idolverse/Tulingjiuge_robot_1/README.md

<h1>图灵九歌-机器人</h1>

基于inmoov人形机器人进行修改

<h2>stl文件</h2>

含有机人形器人不同部位的stl文件以及组装教程。

另外，合并文件中含有：头壳、胸前板、胸部装饰、腹部装饰、背部板、背部装饰、左右肩膀、腹部、盆骨的合并件。

示意图如下：



<h2>图灵九歌lab</h2>
