idolverse/Tulingjiuge_robot_1/myrobotlab/src/main/resources/resource/AdafruitMotorShield/DC_Motor_Ports.png

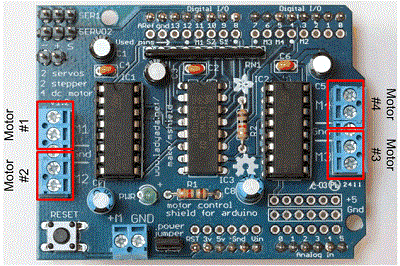
myrobotlab/src/main/resources/resource/AdafruitMotorShield/DC_Motor_Ports.png
