idolverse/Tulingjiuge_robot_1/myrobotlab/src/main/resources/resource/Arduino/esp8266.png

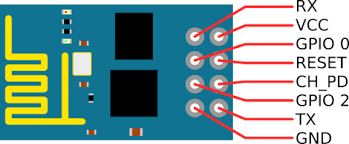
myrobotlab/src/main/resources/resource/Arduino/esp8266.png
