idolverse/Tulingjiuge_robot_1/myrobotlab/src/main/resources/resource/Arduino/mega.atmega2560.png

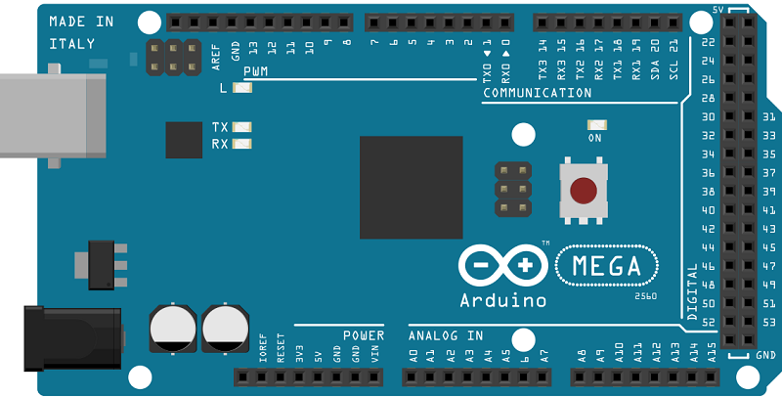
myrobotlab/src/main/resources/resource/Arduino/mega.atmega2560.png
