idolverse/Tulingjiuge_robot_1/myrobotlab/src/main/resources/resource/Arduino/micro.png

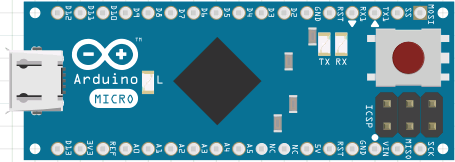
myrobotlab/src/main/resources/resource/Arduino/micro.png
