idolverse/Tulingjiuge_robot_1/myrobotlab/src/main/resources/resource/Arduino/nano.png

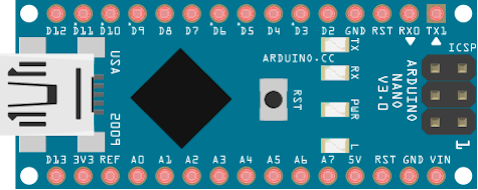
myrobotlab/src/main/resources/resource/Arduino/nano.png
