idolverse/Tulingjiuge_robot_1/myrobotlab/src/main/resources/resource/Emoji/240px-Noto_Emoji_Oreo_1f603.svg.png

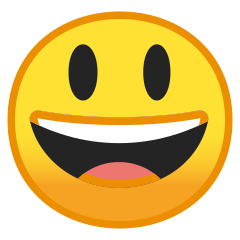
myrobotlab/src/main/resources/resource/Emoji/240px-Noto_Emoji_Oreo_1f603.svg.png
