idolverse/Tulingjiuge_robot_1/myrobotlab/src/main/resources/resource/Emoji/768px-Noto_Emoji_Oreo_1f602.svg.png

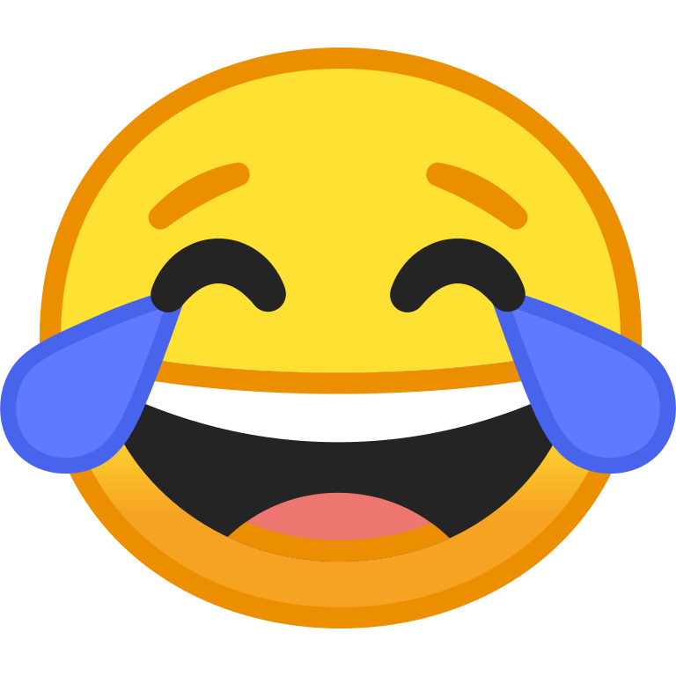
myrobotlab/src/main/resources/resource/Emoji/768px-Noto_Emoji_Oreo_1f602.svg.png
