idolverse/Tulingjiuge_robot_1/myrobotlab/src/main/resources/resource/Esp8266/esp8266-pinout.png

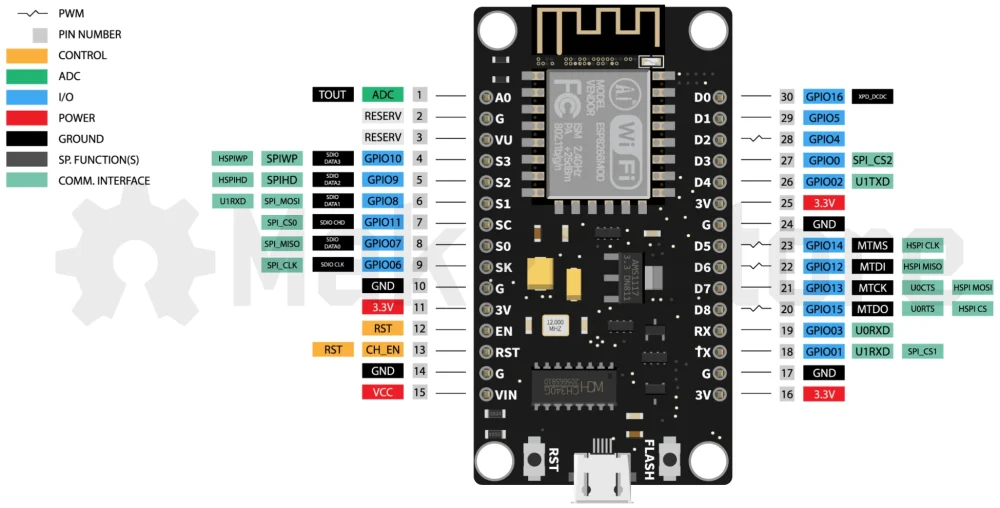
myrobotlab/src/main/resources/resource/Esp8266/esp8266-pinout.png
