idolverse/Tulingjiuge_robot_1/myrobotlab/src/main/resources/resource/facerec/Filter.png

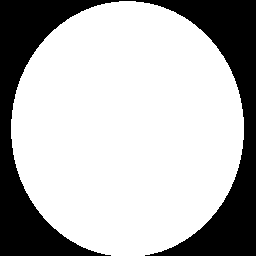
myrobotlab/src/main/resources/resource/facerec/Filter.png
