idolverse/Tulingjiuge_robot_1/myrobotlab/src/main/resources/resource/Intro/img/MRL_background.png

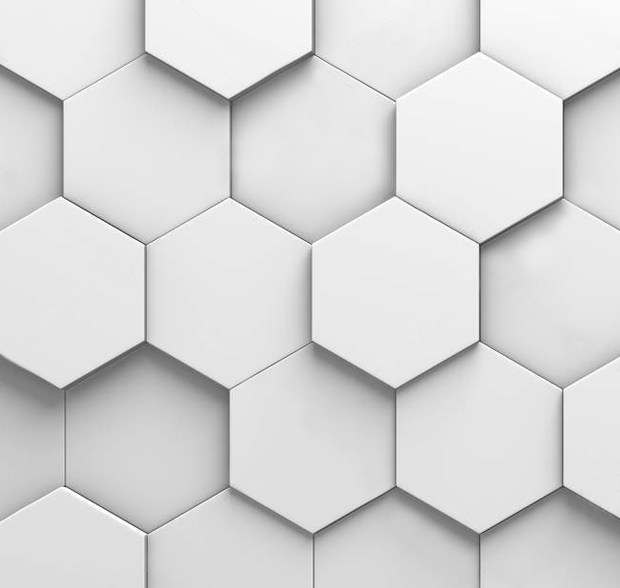
myrobotlab/src/main/resources/resource/Intro/img/MRL_background.png
