idolverse/Tulingjiuge_robot_1/myrobotlab/src/main/resources/resource/Intro/img/MRL_extension.png

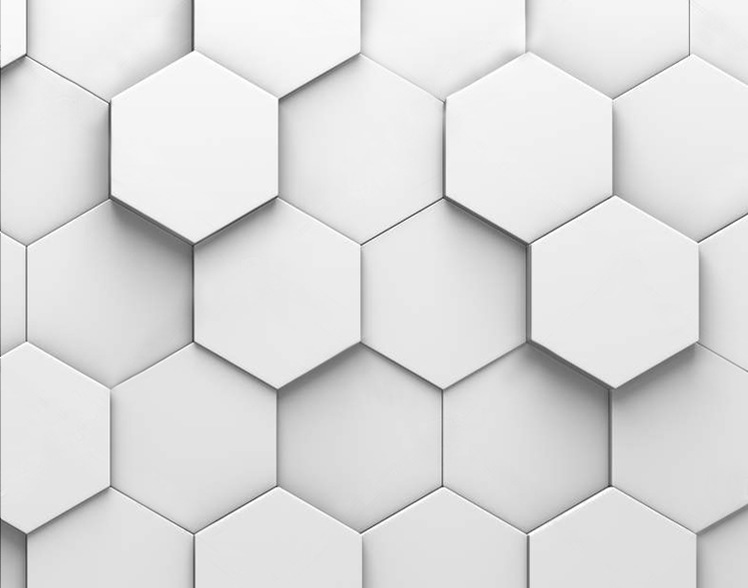
myrobotlab/src/main/resources/resource/Intro/img/MRL_extension.png
