idolverse/Tulingjiuge_robot_1/myrobotlab/src/main/resources/resource/Intro/img/python.png

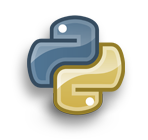
myrobotlab/src/main/resources/resource/Intro/img/python.png
