idolverse/Tulingjiuge_robot_1/myrobotlab/src/main/resources/resource/Intro/img/vision.png

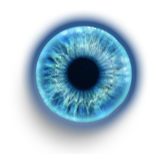
myrobotlab/src/main/resources/resource/Intro/img/vision.png
