idolverse/Tulingjiuge_robot_1/myrobotlab/src/main/resources/resource/OculusRift/images/xneg.png

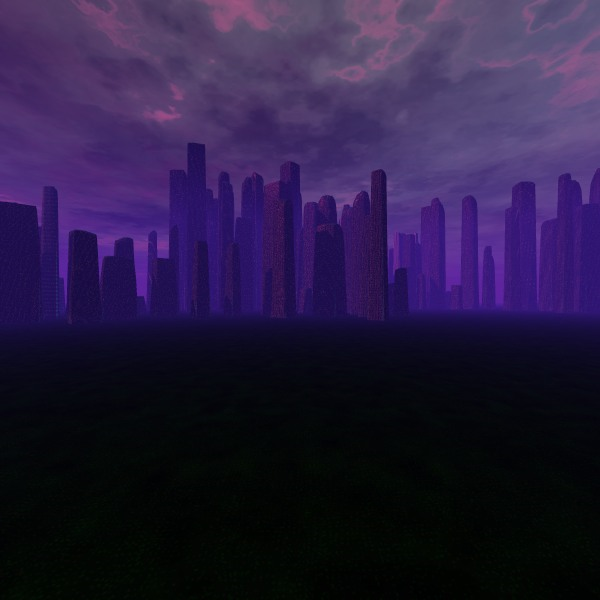
myrobotlab/src/main/resources/resource/OculusRift/images/xneg.png
