idolverse/Tulingjiuge_robot_1/myrobotlab/src/main/resources/resource/OculusRift/images/xpos.png

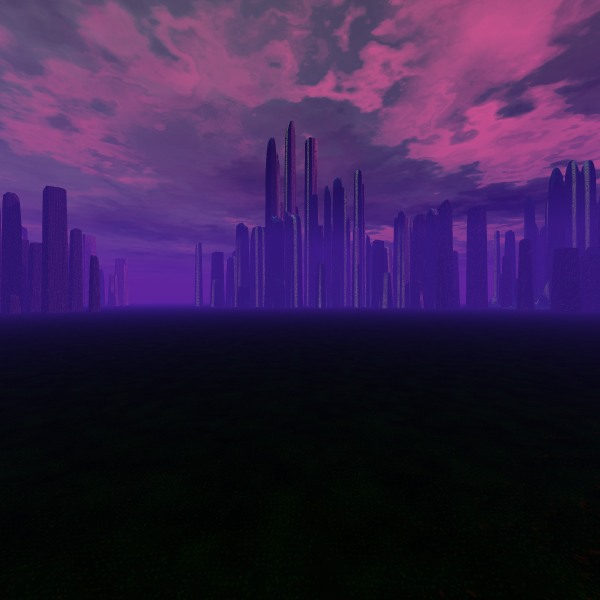
myrobotlab/src/main/resources/resource/OculusRift/images/xpos.png
