idolverse/Tulingjiuge_robot_1/myrobotlab/src/main/resources/resource/OculusRift/images/zneg.png

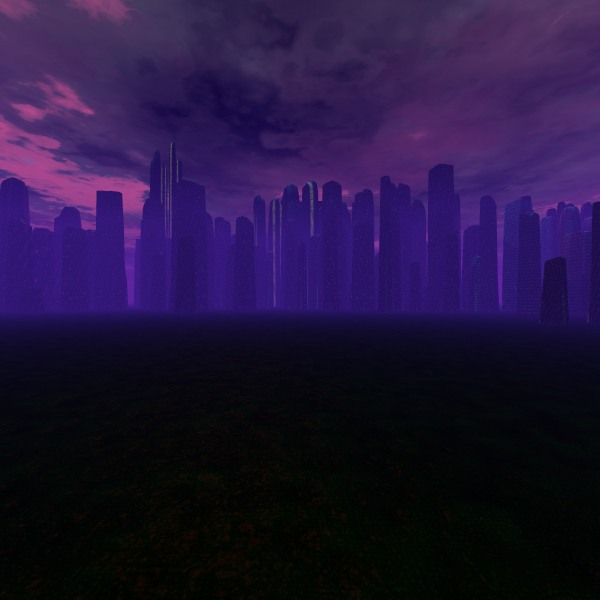
myrobotlab/src/main/resources/resource/OculusRift/images/zneg.png
