idolverse/Tulingjiuge_robot_1/myrobotlab/src/main/resources/resource/OculusRift/images/zpos.png

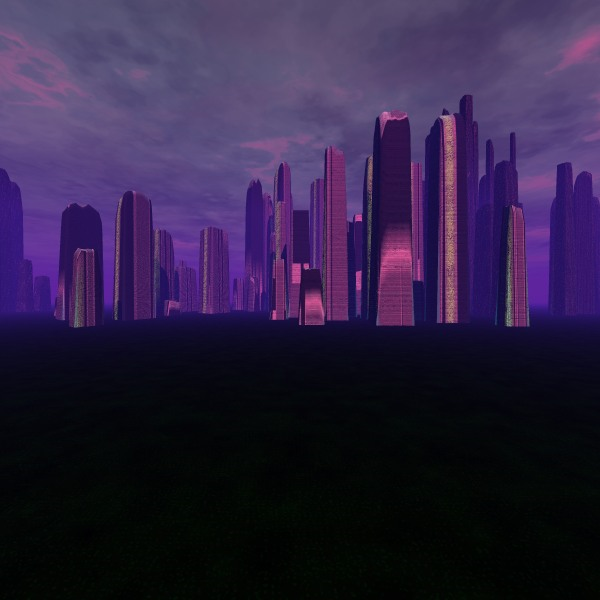
myrobotlab/src/main/resources/resource/OculusRift/images/zpos.png
