idolverse/Tulingjiuge_robot_1/myrobotlab/src/main/resources/resource/OpenCV/mask-640x480.png

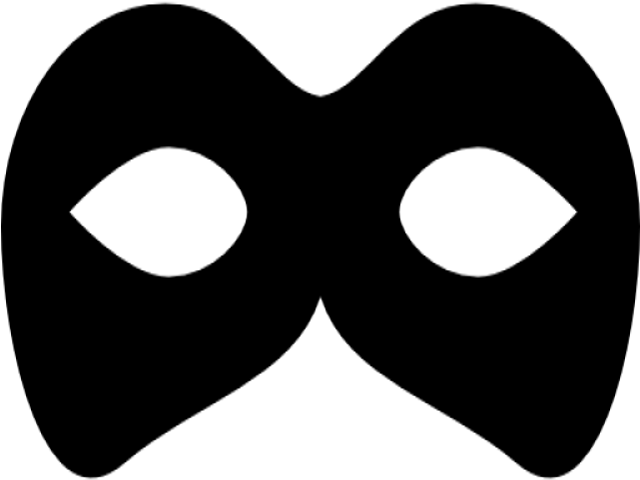
myrobotlab/src/main/resources/resource/OpenCV/mask-640x480.png
