idolverse/Tulingjiuge_robot_1/myrobotlab/src/main/resources/resource/OpenCV/multipleFaces.jpg

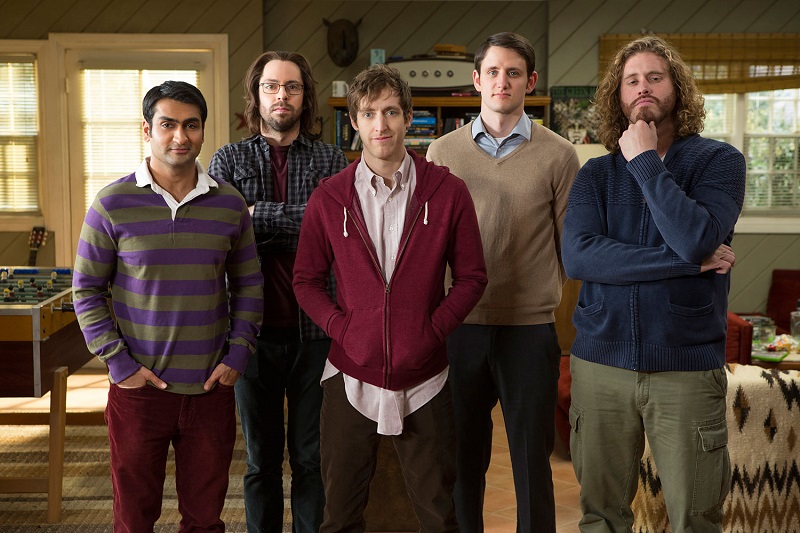
myrobotlab/src/main/resources/resource/OpenCV/multipleFaces.jpg
