idolverse/Tulingjiuge_robot_1/myrobotlab/src/main/resources/resource/OpenCV/transparent-bubble.png

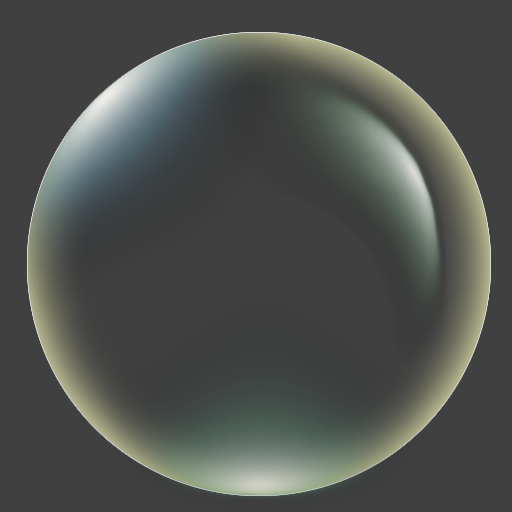
myrobotlab/src/main/resources/resource/OpenCV/transparent-bubble.png
