idolverse/Tulingjiuge_robot_1/myrobotlab/src/main/resources/resource/RasPi/diagram.png

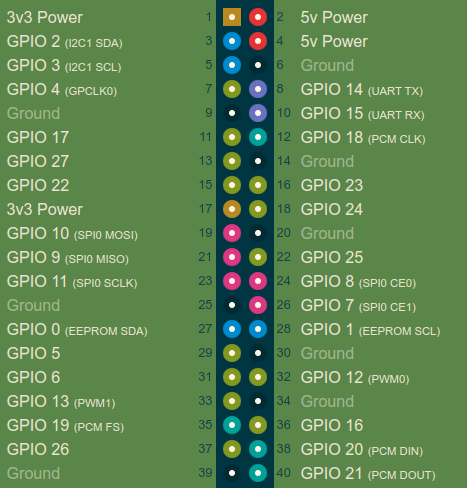
myrobotlab/src/main/resources/resource/RasPi/diagram.png
