idolverse/Tulingjiuge_robot_1/myrobotlab/src/main/resources/resource/RasPi/i2c-scan.png

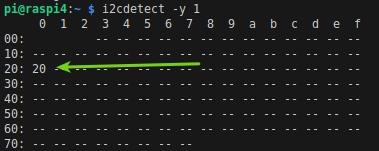
myrobotlab/src/main/resources/resource/RasPi/i2c-scan.png
