idolverse/Tulingjiuge_robot_1/myrobotlab/src/main/resources/resource/RasPi/raspi-2-rev-1.1.png

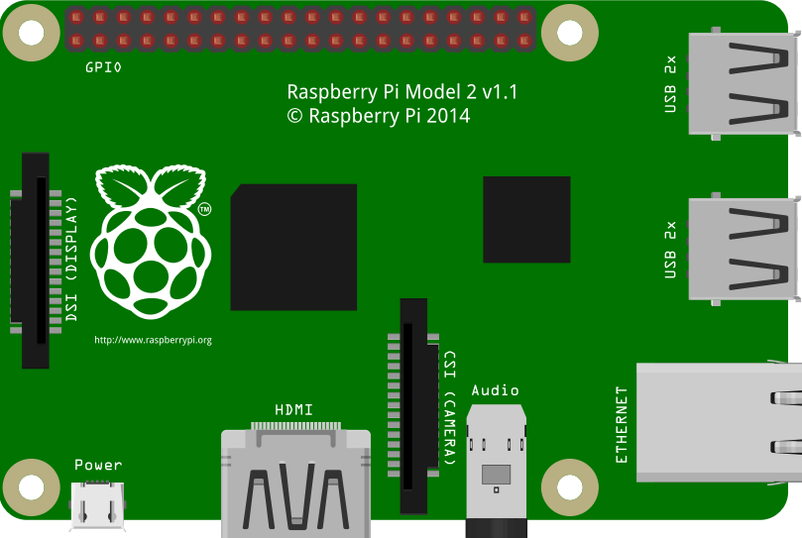
myrobotlab/src/main/resources/resource/RasPi/raspi-2-rev-1.1.png
