idolverse/Tulingjiuge_robot_1/myrobotlab/src/main/resources/resource/RasPi/raspi-3-model-b-rev-1.2.png

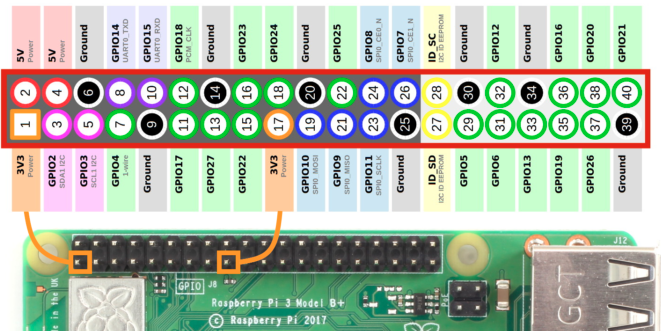
myrobotlab/src/main/resources/resource/RasPi/raspi-3-model-b-rev-1.2.png
