idolverse/Tulingjiuge_robot_1/myrobotlab/src/main/resources/resource/RasPi/raspi-3-pin-out.png

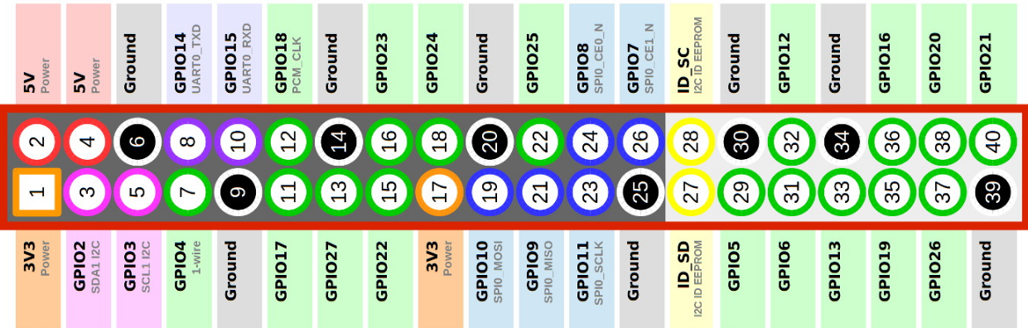
myrobotlab/src/main/resources/resource/RasPi/raspi-3-pin-out.png
