idolverse/Tulingjiuge_robot_1/myrobotlab/src/main/resources/resource/RasPi/raspi-model-a-rev-2.png

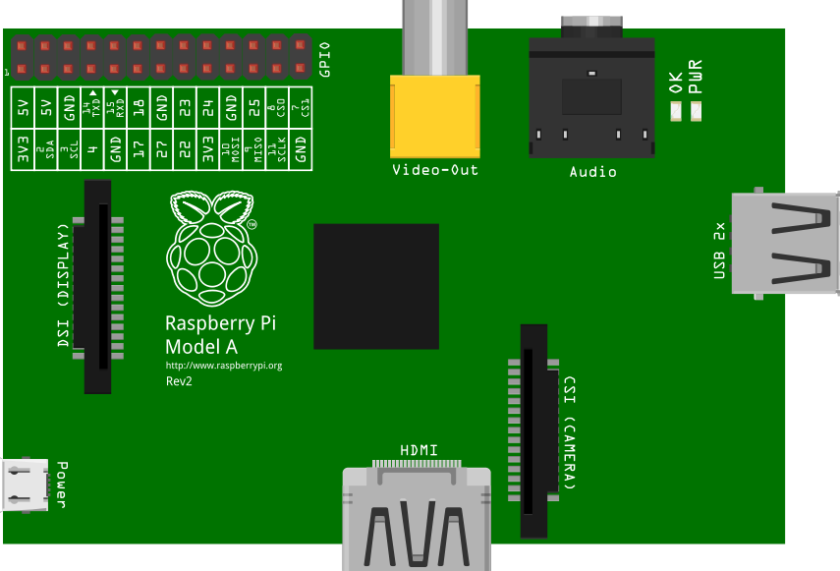
myrobotlab/src/main/resources/resource/RasPi/raspi-model-a-rev-2.png
