idolverse/Tulingjiuge_robot_1/myrobotlab/src/main/resources/resource/RasPi/raspi-model-b-rev-1.png

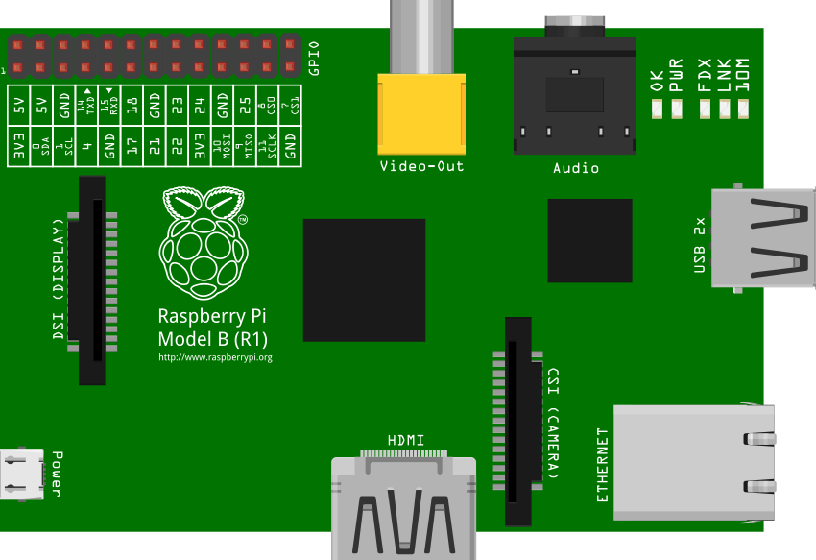
myrobotlab/src/main/resources/resource/RasPi/raspi-model-b-rev-1.png
