idolverse/Tulingjiuge_robot_1/myrobotlab/src/main/resources/resource/RasPi/raspi-zero.png

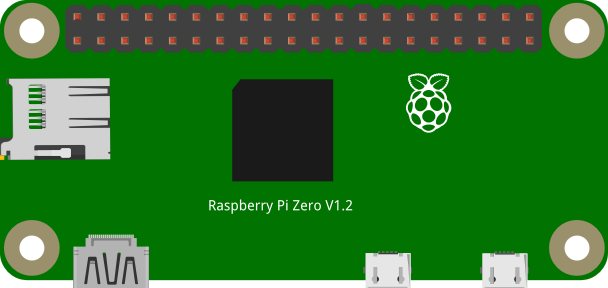
myrobotlab/src/main/resources/resource/RasPi/raspi-zero.png
