idolverse/Tulingjiuge_robot_1/零件组装教程+stl文件/Hardware_Map-BOM-main/default-hardware-map8.png

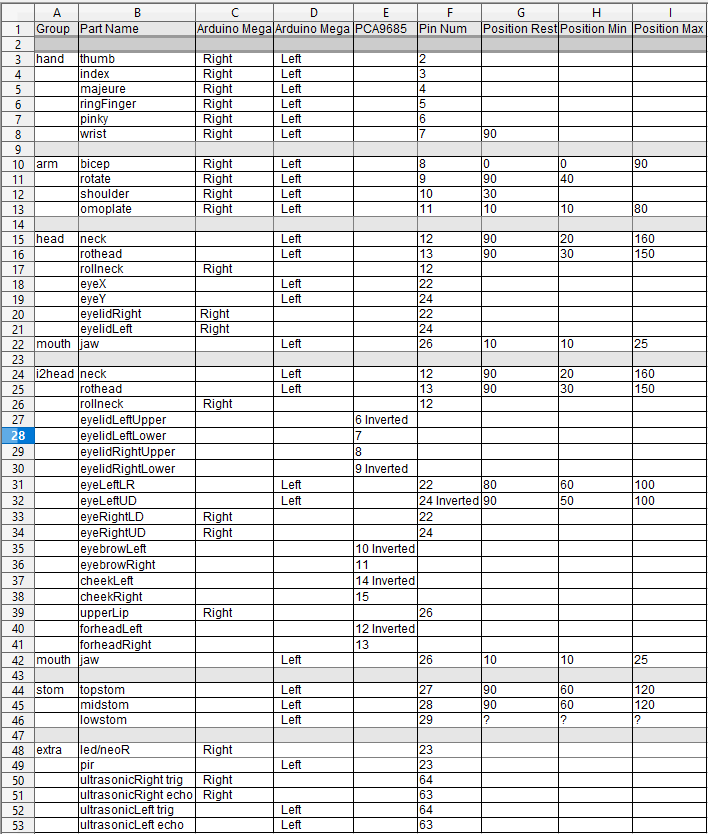
零件组装教程+stl文件/Hardware_Map-BOM-main/default-hardware-map8.png
