idolverse/Tulingjiuge_robot_1/零件组装教程+stl文件/Hardware_Map-BOM-main/README.md

## 默认硬件图+BOM

https://inmoov.fr/wp-content/uploads/2015/06/default-hardware-map8.png





https://inmoov.fr/wp-content/uploads/2013/12/Circuit2Arduinos.jpg



https://inmoov.fr/wp-content/uploads/2013/12/ArduinoPowerSupply1-1024x771.png



https://inmoov.fr/wp-content/uploads/2013/12/Map-ConnectionsV2-scaled.jpg



当然你需要有一台 3D 打印机。
2x arduino Mega=80 欧元 ebay。（默认是 1xUno 和 1x Mega，但腿和腰尚未到来）

CSK-Allen-Bolt

**内六角沉头螺钉：**

M3x20MM 约50个。
M4x20MM 约50个
M8x100MM 约15个

Phillips-Flat-Head-Wood-Screws-300x300

**十字槽平头木螺钉：**

M3x12MM，小型伺服器约100个。
M4x20MM，大型伺服器约 50 个。

还有一些小螺丝，用于固定眼部机构、下颌机构以及小型舵机上的活塞。不过我用的是舵机自带的螺丝。

<h2>手和前臂（左，右）：</h2>

10x 伺服器 HK15298B=180 欧元 Hobbyking
2x 伺服器 MG996r=22 欧元 ebay 用于旋转手腕
0.8 毫米编织线/钓鱼线。200 磅 = 10 欧元 ebay
Miscealenous Bolts= 10 欧元 五金店
1500 克天然 ABS= 70 欧元 orbi-tech 如果您开始打印，则可获得 4 公斤
10x 拉伸弹簧，直径 0.51 毫米，长度 1 厘米（13/64 英寸 x 13/16 英寸）

<h2>手臂和肩膀（左，右）：</h2>

8 Hitec HS805BB=240 欧元 ebay（扭矩更大，速度更快）
Miscealenous Bolts= 10 欧元 五金店
1500克黑色、黄色、天然ABS=56欧元orbi-tech

<h2>头部和躯干：</h2>

2x Hitec HS805BB 头（上/下、右/左）
1x 伺服器 HK15298B 爪形机构
2x 伺服器 HK15298B 颈部倾斜（1 个主伺服器，1 个从伺服器）
2x 伺服 DS929hvCorona 或类似眼部机制
1X 大力神高清相机（已拆卸）
或 1X LifeCam3000 Microsoft
1X OAK-D-Lite（固定焦距）
约4kg天然ABS
0.8mm 编织线/钓鱼线 200LB= 5 欧元 五金店或 eBay
Miscealenous Bolts= 10 欧元 五金店
1500克天然ABS=70欧元orbi-tech
1个6V12AH电池+6V1.5A充电器：35欧元（机器人只需一块电池即可工作，充电器在使用过程中应保持电池充满电。）或者，如果要全天运行，我目前使用6V 60Amps开关电源。这里有一个5V 50Amps的链接，你可以将电压升至6V：https://fr.aliexpress.com/item/4000663608614.html ?gatewayAdapt=glo2fra   https://fr.aliexpress.com/item/32713328144.html?gatewayAdapt=glo2fra   https://www.amazon.com/ALITOVE-Transformer-Converter-Security-Computer/dp/B06XK3X3PW?th=1
2x 迷你电脑扬声器 8Ohm 10W: https://www.aliexpress.com/item/32819139413.html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
迷你功放 6V: https://www.ebay.fr/itm/1161-TDA2030A-Module-Power-Supply-TDA2030-Audio-Amplifier-Board-Module-6-12V-/291993099912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
1xPIR 传感器重新触发
电缆和电线: https://www.ebay.co.uk/itm/Grey-Flat-Ribbon-Cable-1-27mm-10-14-16-20-26-34-40-Way-/263085715366

Speaker_size1

Speaker_size1

InMoov_TDA2030

如果您在互联网上找不到 6V50Amps，您可以购买带有可调开关的 5V50Amps 电源，以将伺服电机的电压增加到 6V。

在下面的例子中，我将 5V 调整为 7.5V 电压。

IMG_0801-rotated

IMG_0799-rotated

<h2>腹部</h2>

高位腹部训练器：2x Hitec HS805BB
中腹：2x Hitec HS805BB 或 HK15338

<h2>带状电缆长度：</h2>

Nervo 板到颈部————————————丝带长度 10cm
神经板到头部（眼睛/下巴）——————丝带长度55厘米
Nervo 板到手臂————————————– 丝带长度 75 厘米
Nervo 板到手————————————-丝带长度 90cm
神经板到手指传感器————————-色带长度120厘米
神经板到腹部——————————丝带长度30厘米

<h2>NUC 的最新配置：</h2>

CPU：第八代英特尔 i7 8550 四核 4,0ghz
SSD：256GB（操作系统 + Myrobotlab）
HDD：500GB（因为我有一个备用硬盘）
内存：32GB
显卡：英特尔 UHD Graphics 620
连接性：HDMI、Mini-DP、千兆 Lan、2*USB3.0、2*USB2.0、
WIFI 和蓝牙：2.4G/5G Wifi B/G/N/AC+蓝牙
尺寸：113mmx108mmx30mm
安装的操作系统：Windows 10 pro 和 Linux Ubuntu
联想平板电脑通过热点连接作为屏幕，以无线方式控制电脑（平板电脑型号 Thinkpad8 2GB RAM、128GB ssd、处理器 1,46Ghz）

<h2>由 MRL 控制的连接设备：</h2>

1个USB3.0集线器8端口
1x OAK D-Lite（固定焦距）尚未完全支持 MRL
2个Arduino Mega
2块Nervo板
1个Arduino Nano
3x NeoPixel
2个HC-SRC04传感器
1个PIR传感器
10个手指压力传感器
2个 Hercules 网络摄像头
1个USB声卡
1 个罗技 H600 无线耳机
2个10瓦扬声器
1 个 6V 60Amps 电源，可用 6V12AH 电池组替换

<h2>旧配置：</h2>

使用联想 Touchpad 8 英寸平板电脑，搭配 8 端口集线器，由10000mAh 5V 移动电源供电。这款平板电脑可在 Windows 8 或 Windows 10 系统上运行，并可配置为 Linux 系统。它是一款真正的迷你电脑。您需要一根适用于这款联想平板电脑的OTG+充电专用线。我费了好大劲才找到，这很奇怪。小心，其他类似品牌的平板电脑线可能不适用。

这是我购买的键盘：
https://www.amazon.com/Keyboard-TOUCHPAD-EXECUTIVE-Bluetooth-Detachable/dp/B017HLXESO
我本来以为这个保护套可以用来旅行，可惜尺寸问题严重。虽然卖家声称出售的是适合8英寸平板电脑的保护套，但实际上根本装不下这台平板电脑。

因此，针对此问题，我们向您提供以下建议……

除此之外，键盘工作正常，有时会失去连接，但它会自动重新连接。

PowerBank + 8 端口 HUB USB3.0通过USB供电：

联想平板电脑
Arduinos
摄像机
声音放大器
Kinect
我买了一个 8 端口 USB3.0 集线器，用来连接额外的端口，它能完美地连接 OTG 数据线和联想平板电脑。如果不使用移动电源，那么给集线器供电时，至少需要一个能够提供 5V4A 电流的电源，因为我们连接了很多 USB 设备，每个都需要 500mAh 的电量。

**可替代平板电脑但未经测试：**

Venue 8 Pro 5000 (5855)（应符合规格尺寸，部分用户反映找不到 OTG 线缆（充电+数据传输））
Jumper EZpad Mini3 Windows 10 8.0 英寸 2GB/32GB（由于有单独的充电和 USB3.0，因此不需要 otg+充电）应该适合机器人的背面。
Insignia™ – 8 英寸 – 平板电脑 – 32GB（一些制造商报告说这款平板电脑是垃圾）
KOCASO 8 英寸 Windows 10 HD 平板电脑（太小，需要打印适配器）
Chuwi Hi8 Pro 8″IPS Windows10（应符合规格尺寸）
NUVISION，全高清 1920X1200 IPS 签名版平板电脑。8 英寸（太小，需要打印适配器）

Kinect 360 电池由 10 节 1.2v 2500mAh AA 充电电池供电。

image_thumb-230

在对 OdroidU3 和 Raspi2 进行多次测试后，我得出结论，Arm 处理器太慢，无法从摄像头获取正确的 FPS 值，这促使我选择另一种选择。

**这已被废弃：**

1x 迷你触摸屏显示器：（显示器/7_17_78_cm_Display_ Set_mit_Touchscreen_LS_7T_ HDMI_DVI_VGA_CVBS）
1x Odroid U3：（ODROID_U3_Einplatinen_Computer_Cortex_A9_QuadCore_2_GB.html ）
在 SD 卡上为 Odroid 安装 Ubuntu： 刷写软件版本的步骤
1x Odroid U3 电池：（ODROID_U3_ ODROID_UPS_USV_LiIon_3_Ah.html）
1x迷你蓝牙键盘：（Mini_Bluetooth_Keyboard_mit_Touchpad_DAYCOM_BTK_260T）
1x emmc 或 mini SD 卡 class10
1x Odroid Batterie 3v Bios 保护程序。
1x 风扇 Odroid 处理器冷却器
1个无线适配器
1个蓝牙适配器
1 根 HDMI 转 mini HDMI 线缆

##############################################################################

<h2>按照我对手的偏好顺序排列的伺服器：</h2>

JX PDI-6221MG（20-36kg扭力，永不烧坏，180度）
JX PDI-6225MG-300（20-36kg扭矩，永不烧坏，300度）适用于i2 Hand
HK15298B（强扭力20kg，无噪音，c，90度）
HK15298（强扭矩15kg，噪音小，永不烧毁，90度）
MG996R（低扭矩10kg，有点吵，有时会烧坏，180度）
MG946R（中扭矩12kg，有点吵，有时会烧坏，180度）
MG995（低扭矩10kg，有点吵，很容易烧坏，180度）

这些是我试过的舵机。还有其他舵机可以满足所需的尺寸规格。所有这些舵机都需要在软件中设置最小值和最大值，因为它们的旋转角度会有所不同。InMoov 手的每个手指都有不同的伸展和收缩长度。

<h2>可能适合的替代伺服器：</h2>

**对于手：**

TGY-5521MDHV（24公斤扭矩，应该适合）
RS-550MGC-HV（扭矩11.2kg，应该适合）
HS-311（3.5kg扭矩，应该适合）
XQ-S4020D（21.5kg扭矩，应该适合）

**对于二头肌、肩部和躯干：**

JX伺服PDI-HV2060MG（60kg扭矩180°配合良好）
Savöx SV-0235MG（35公斤扭矩，适合）
TS-80 Tower Hobbies 巨型秤（24kg 扭矩，与 HS805BB 相同）
CYS 型号 S8218（40 公斤扭矩，不适合，需要调整，发出带有连接/拆卸功能的软件）
HK15338（25kg 扭矩，完美匹配，需要电阻，极性反转）
HS5805MG（27.5kg扭矩，应该适合）
FS6535M（33公斤扭矩，配合良好）
Ds5160 SSG（60 公斤扭矩，应该适合）

**对于眼睛：**

Towerpro SG91
TowerPro SG92R
JX PDI-1109MG

**对于腹部：**

JX伺服PDI-HV2060MG（60kg扭矩180°配合良好）
Savöx SV-0235MG（35 公斤扭矩，不适合需要修改）
TS-80 Tower Hobbies 巨型秤（24kg 扭矩，与 HS805BB 相同）
CYS 型号 S8218（40 公斤扭矩，不适合，需要调整，发出带有连接/拆卸功能的软件）
HK15338（25kg 扭矩，完美匹配，需要电阻，极性反转）
HS5805MG（27.5kg扭矩，应该适合）
Ds5160 SSG（60 公斤扭矩，应该适合）
