idolverse/Tulingjiuge_robot_1/零件组装教程+stl文件/Hardware_Map-BOM-main/Map-ConnectionsV2-scaled.jpg

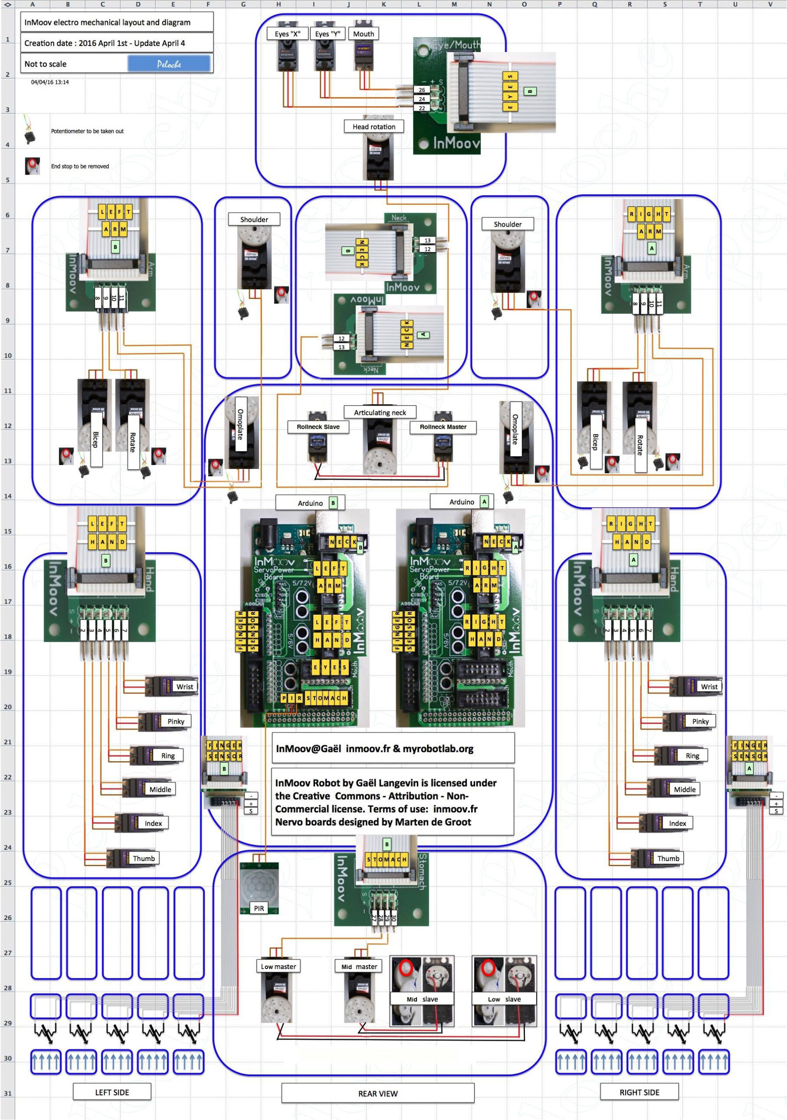
零件组装教程+stl文件/Hardware_Map-BOM-main/Map-ConnectionsV2-scaled.jpg
