idolverse/Tulingjiuge_robot_1/零件组装教程+stl文件/Hardware_Map-BOM-main/屏幕截图 2025-04-24 153914.png

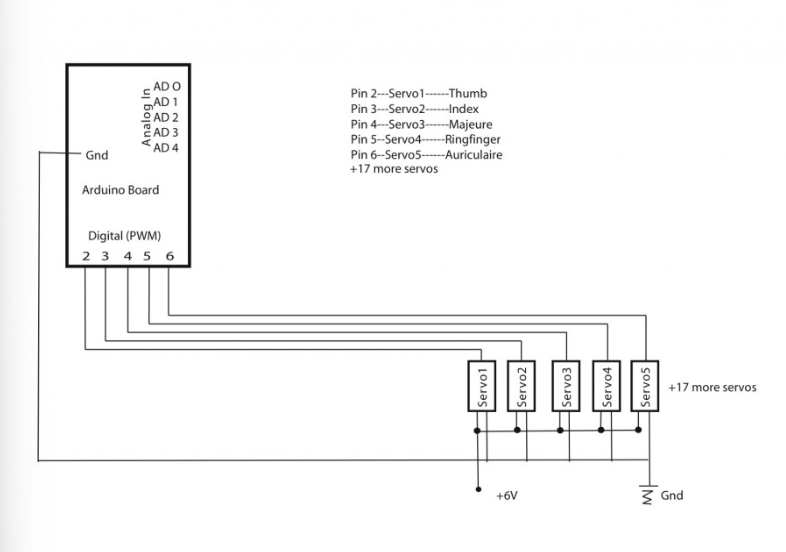
零件组装教程+stl文件/Hardware_Map-BOM-main/屏幕截图 2025-04-24 153914.png
