idolverse/Tulingjiuge_robot_1/零件组装教程+stl文件/Eyes-i2-main/眼罩制作/眼罩STL/2xEyeBallFullV2.stl

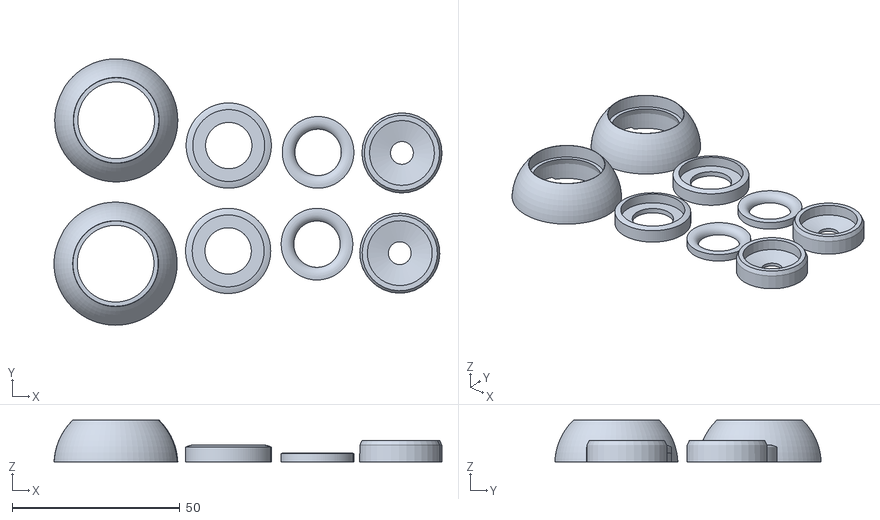
[picture p46: CAD file, 2025-05-29]
零件组装教程+stl文件/Eyes-i2-main/眼罩制作/眼罩STL/2xEyeBallFullV2.stl
115.5 x 79.4 x 12.5
