idolverse/Tulingjiuge_robot_1/零件组装教程+stl文件/Neck_and_jaw-main/颈部和下颌STL/颈部STL/MainGearV2.stl

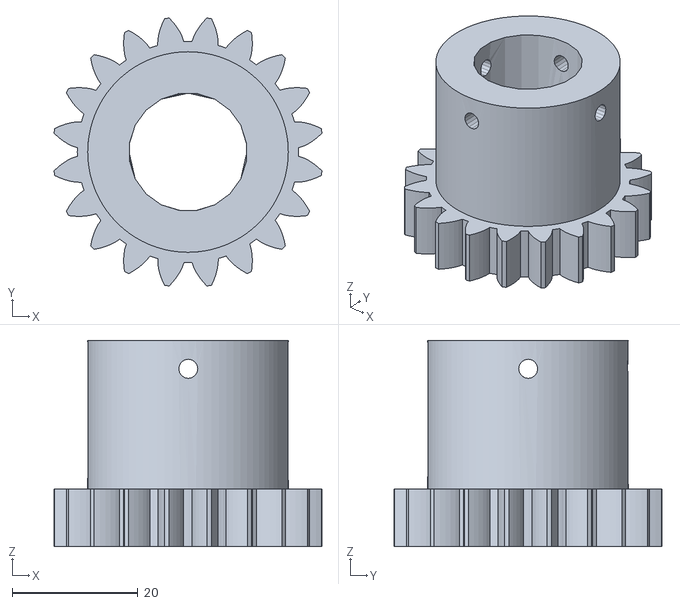
[picture p47: CAD file, 2025-05-29]
零件组装教程+stl文件/Neck_and_jaw-main/颈部和下颌STL/颈部STL/MainGearV2.stl
42.7 x 42.7 x 32.8
