idolverse/Tulingjiuge_robot_1/零件组装教程+stl文件/A合并打印文件/背部装饰2.STL

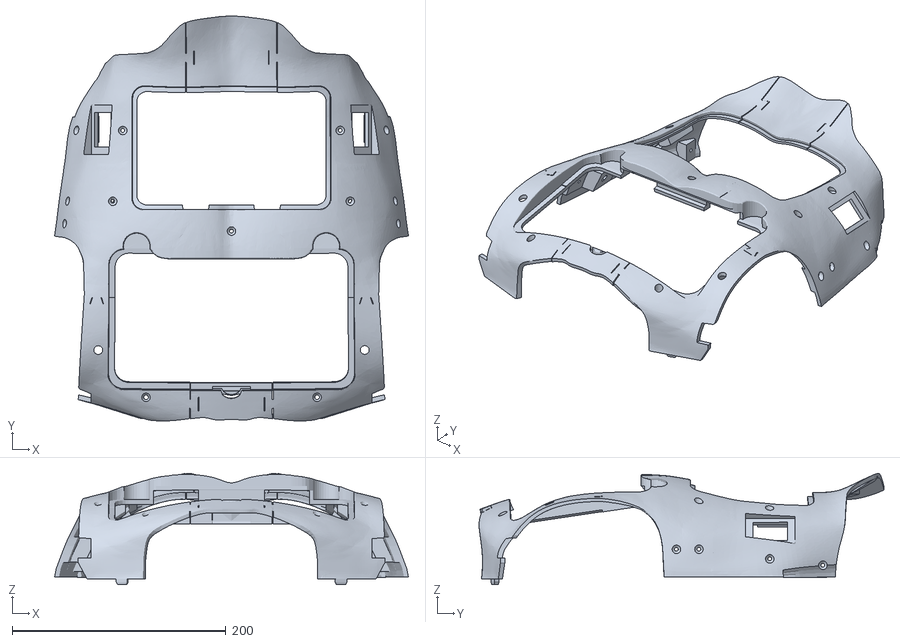
[picture p48: CAD file, 2025-06-15]
零件组装教程+stl文件/A合并打印文件/背部装饰2.STL
331.5 x 379.2 x 104.1
