idolverse/Tulingjiuge_robot_1/零件组装教程+stl文件/Back-main/背部STL/BatteryPusherV1.stl

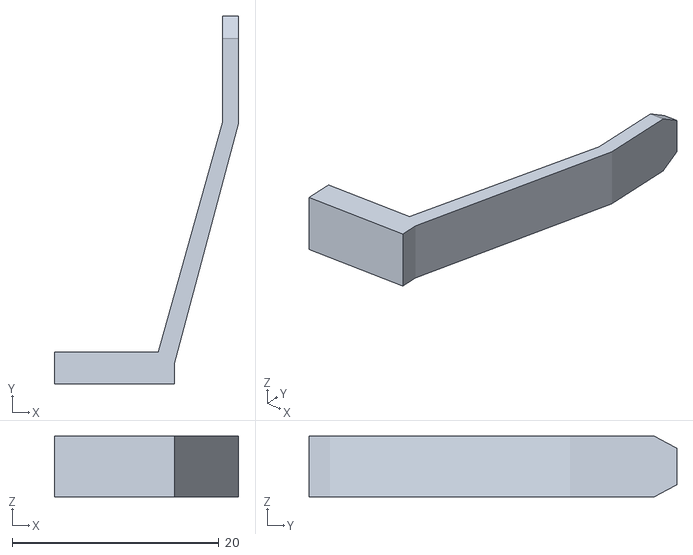
[picture p49: CAD file, 2025-05-29]
零件组装教程+stl文件/Back-main/背部STL/BatteryPusherV1.stl
17.8 x 35.6 x 5.87
