idolverse/Tulingjiuge_robot_1/零件组装教程+stl文件/Bicep-main/二头肌STL/spacerV1.stl

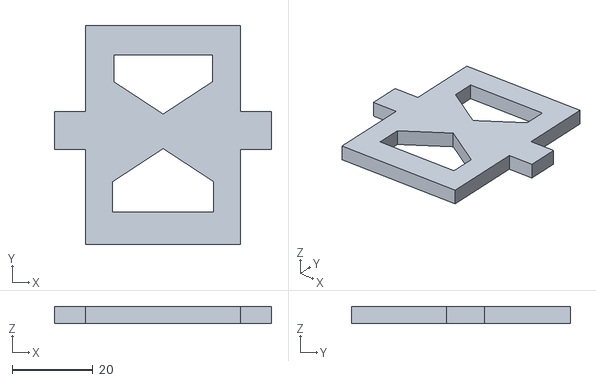
[picture p50: CAD file, 2025-05-29]
零件组装教程+stl文件/Bicep-main/二头肌STL/spacerV1.stl
53.8 x 54.3 x 4.23
