idolverse/Tulingjiuge_robot_1/零件组装教程+stl文件/Eyes-i2-main/眼睛STL/眼睛.3mf

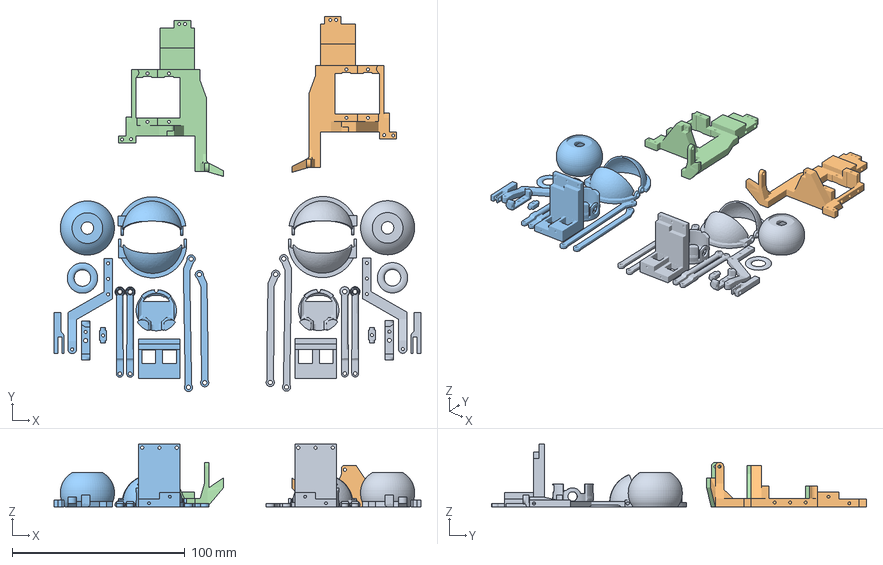
[picture p51: CAD file, 2025-05-29]
零件组装教程+stl文件/Eyes-i2-main/眼睛STL/眼睛.3mf
212.6 x 217.4 x 36.4 mm
Eye-L-AllPartsV2.stl
Eye-L-BaseV5.stl
Eye-R-AllPartsV2.stl
Eye-R-BaseV5.stl
