idolverse/Tulingjiuge_robot_1/零件组装教程+stl文件/Eyes-i2-main/眼罩制作/眼罩STL/EyePlateRightV1.stl

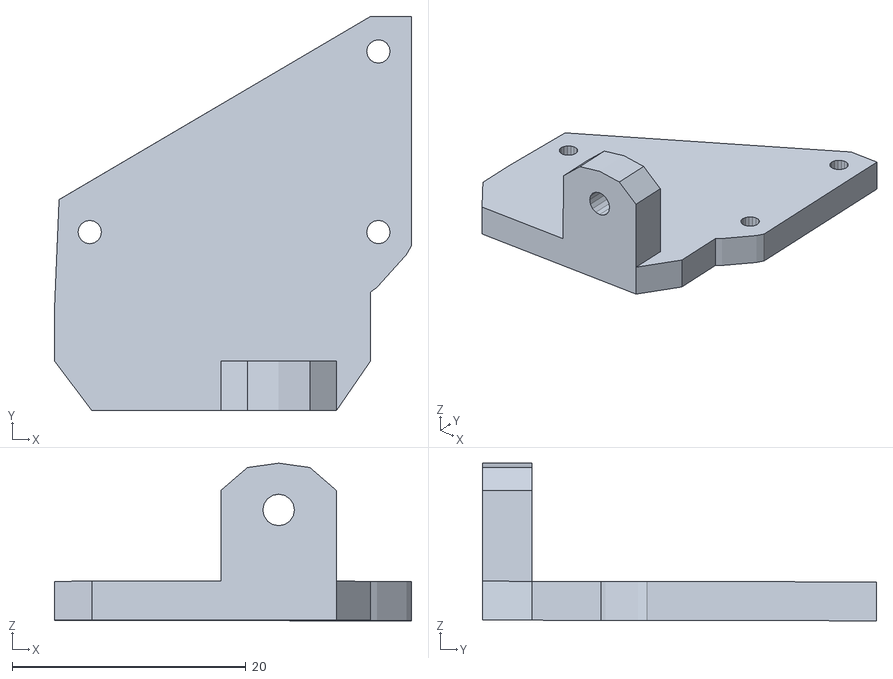
[picture p52: CAD file, 2025-05-29]
零件组装教程+stl文件/Eyes-i2-main/眼罩制作/眼罩STL/EyePlateRightV1.stl
30.5 x 33.7 x 13.5
