idolverse/Tulingjiuge_robot_1/零件组装教程+stl文件/Finger_starter-main/手指STL/FingerTesterV2.stl

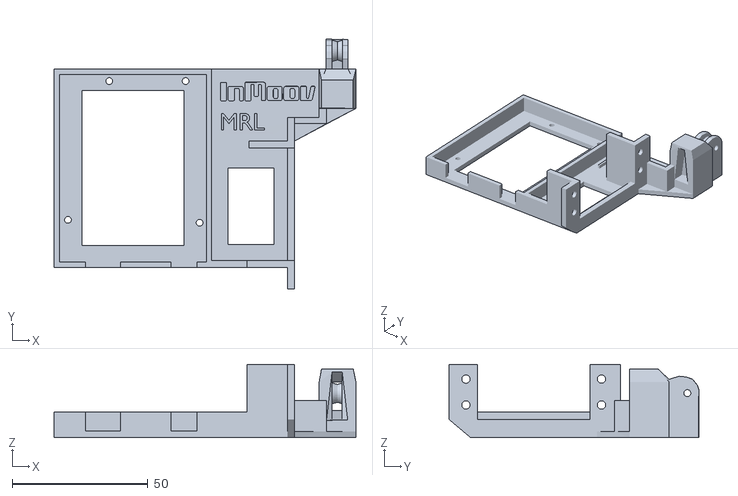
[picture p53: CAD file, 2025-05-29]
零件组装教程+stl文件/Finger_starter-main/手指STL/FingerTesterV2.stl
111.0 x 91.8 x 26.9
