idolverse/Tulingjiuge_robot_1/零件组装教程+stl文件/Hand_i2-main/手部STL/Calibrator.stl

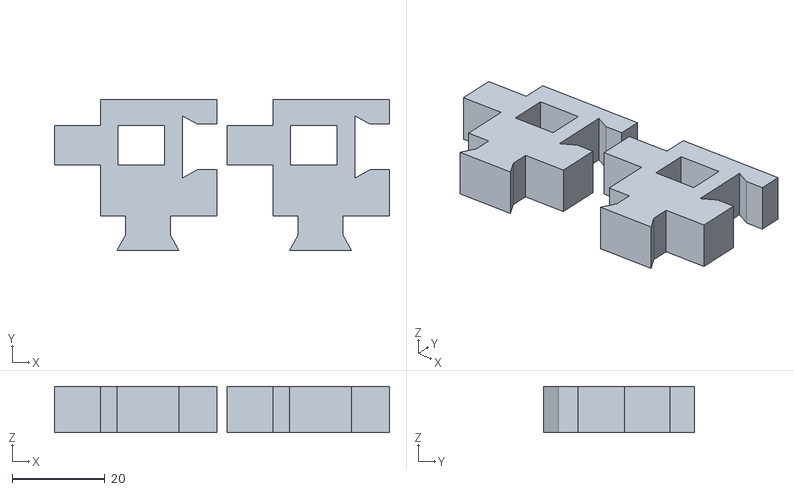
[picture p54: CAD file, 2025-05-29]
零件组装教程+stl文件/Hand_i2-main/手部STL/Calibrator.stl
72.2 x 32.5 x 9.99
