idolverse/Tulingjiuge_robot_1/零件组装教程+stl文件/Hand_i2-main/手部STL/右手/i2_PulleyX5V1.stl

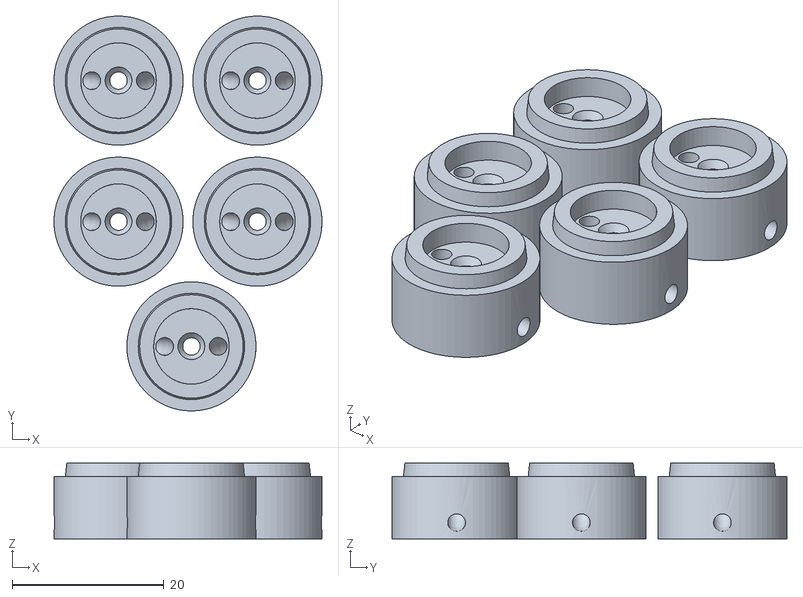
[picture p55: CAD file, 2025-05-29]
零件组装教程+stl文件/Hand_i2-main/手部STL/右手/i2_PulleyX5V1.stl
35.3 x 52.0 x 10.0
