idolverse/Tulingjiuge_robot_1/零件组装教程+stl文件/Hand_i2-main/手部STL/左手/i2_LeftCoverThumbV3.stl

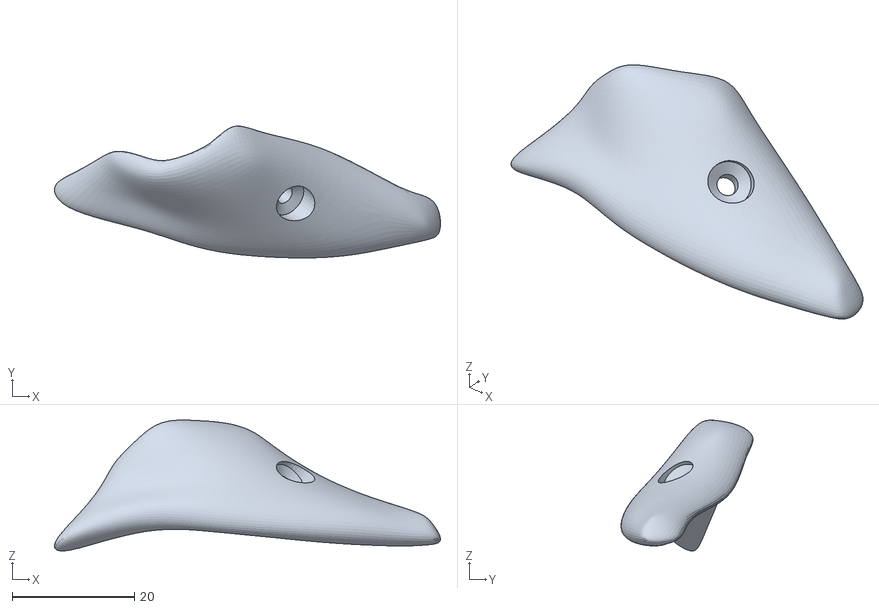
[picture p56: CAD file, 2025-05-29]
零件组装教程+stl文件/Hand_i2-main/手部STL/左手/i2_LeftCoverThumbV3.stl
63.1 x 21.6 x 21.4
