idolverse/Tulingjiuge_robot_1/零件组装教程+stl文件/Head_i2-main/头部STL/TopskullFrontV1.stl

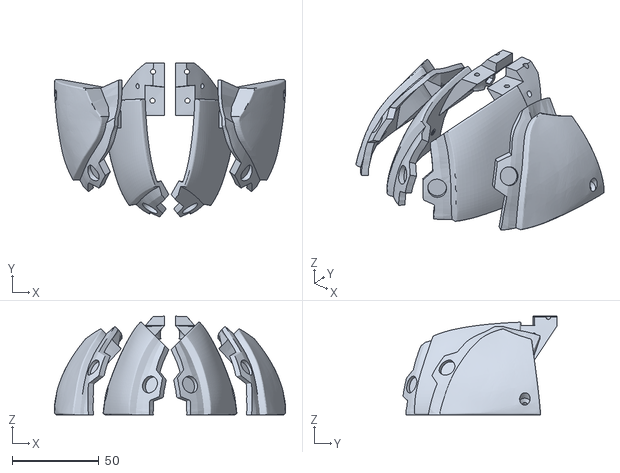
[picture p57: CAD file, 2025-05-29]
零件组装教程+stl文件/Head_i2-main/头部STL/TopskullFrontV1.stl
133.4 x 88.8 x 57.0
