idolverse/Tulingjiuge_robot_1/零件组装教程+stl文件/Leg-main/腿部STL/大腿STL/LegFixerV1.stl

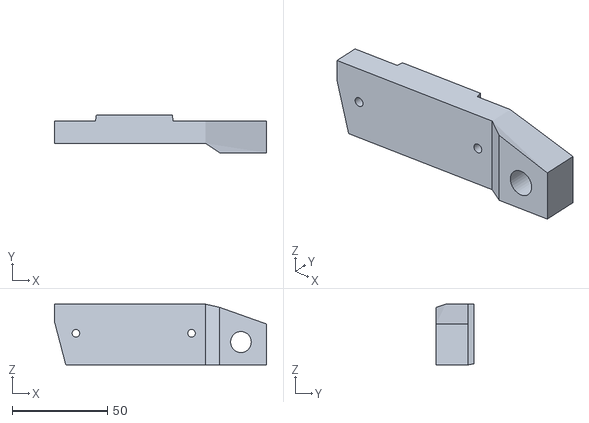
[picture p58: CAD file, 2025-05-29]
零件组装教程+stl文件/Leg-main/腿部STL/大腿STL/LegFixerV1.stl
111.3 x 19.8 x 31.9
