idolverse/Tulingjiuge_robot_1/零件组装教程+stl文件/Leg-main/腿部STL/胫骨STL/TibiaLowS2LeftV1.stl

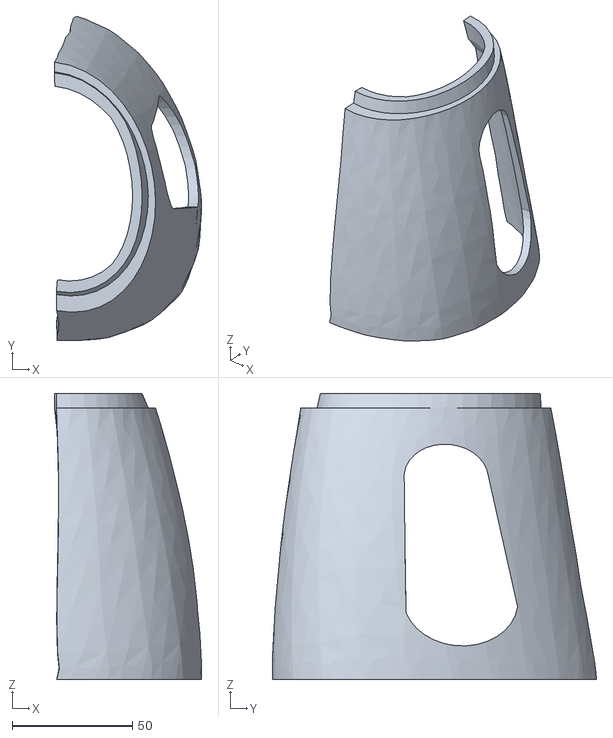
[picture p59: CAD file, 2025-05-29]
零件组装教程+stl文件/Leg-main/腿部STL/胫骨STL/TibiaLowS2LeftV1.stl
61.2 x 134.7 x 118.8
