idolverse/Tulingjiuge_robot_1/零件组装教程+stl文件/Leg-main/腿部STL/脚踝STL/AnkleDownV2.stl

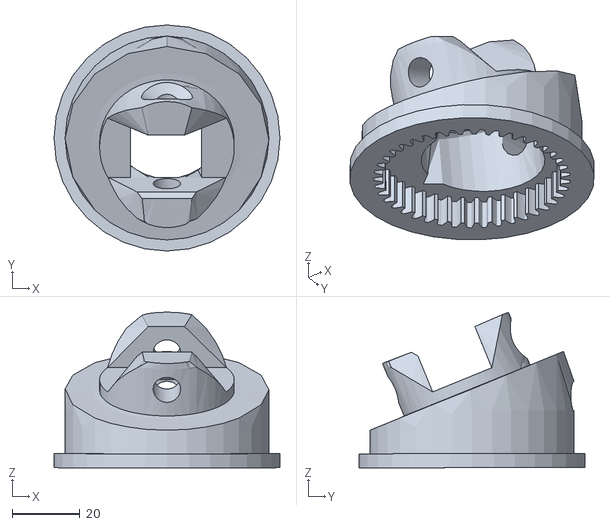
[picture p60: CAD file, 2025-05-29]
零件组装教程+stl文件/Leg-main/腿部STL/脚踝STL/AnkleDownV2.stl
66.7 x 66.7 x 46.0
