idolverse/Tulingjiuge_robot_1/零件组装教程+stl文件/Leg-main/腿部STL/膝盖STL/KneeLowRightV3.stl

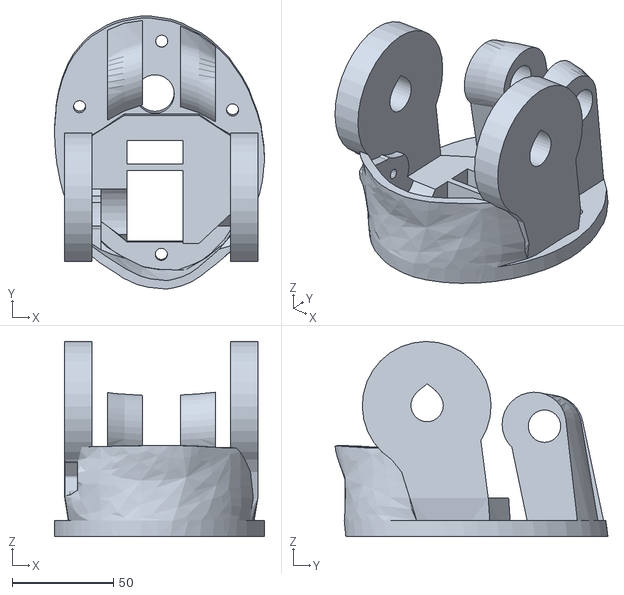
[picture p61: CAD file, 2025-05-29]
零件组装教程+stl文件/Leg-main/腿部STL/膝盖STL/KneeLowRightV3.stl
103.9 x 135.1 x 96.5
