idolverse/Tulingjiuge_robot_1/零件组装教程+stl文件/Low_stomach-main/下腹部STL/下腹部.3mf

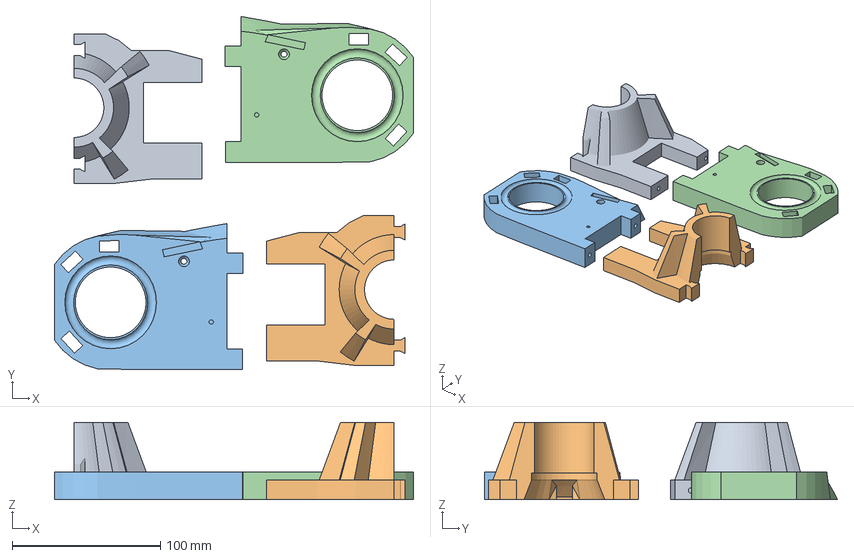
[picture p62: CAD file, 2025-05-29]
零件组装教程+stl文件/Low_stomach-main/下腹部STL/下腹部.3mf
242.4 x 238.0 x 52.2 mm
StomSupportLeftV1.stl
StomSupportRightV1.stl
TStoLowLeftV1.stl
TStoLowRightV1.stl
