idolverse/Tulingjiuge_robot_1/零件组装教程+stl文件/Mid_Stomach-main/中腹部STL/HipCoverRightV1.stl

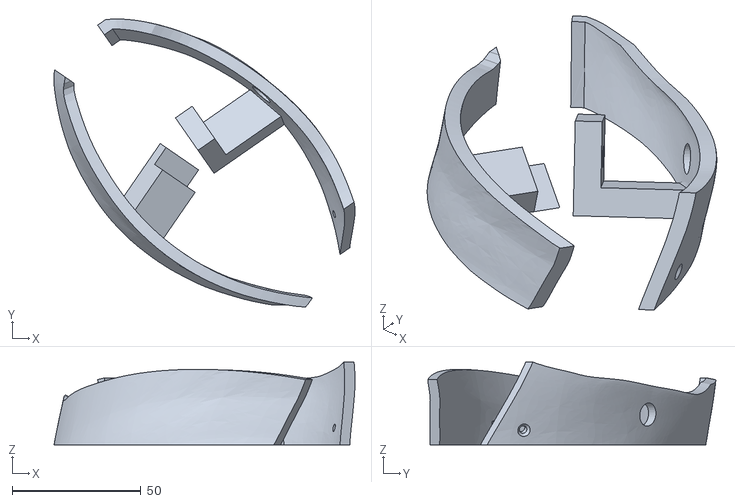
[picture p63: CAD file, 2025-05-29]
零件组装教程+stl文件/Mid_Stomach-main/中腹部STL/HipCoverRightV1.stl
116.8 x 111.7 x 32.1
