idolverse/Tulingjiuge_robot_1/零件组装教程+stl文件/Neck_and_jaw-main/颈部和下颌STL/脸部和下颌STL/EyeglassV4.stl

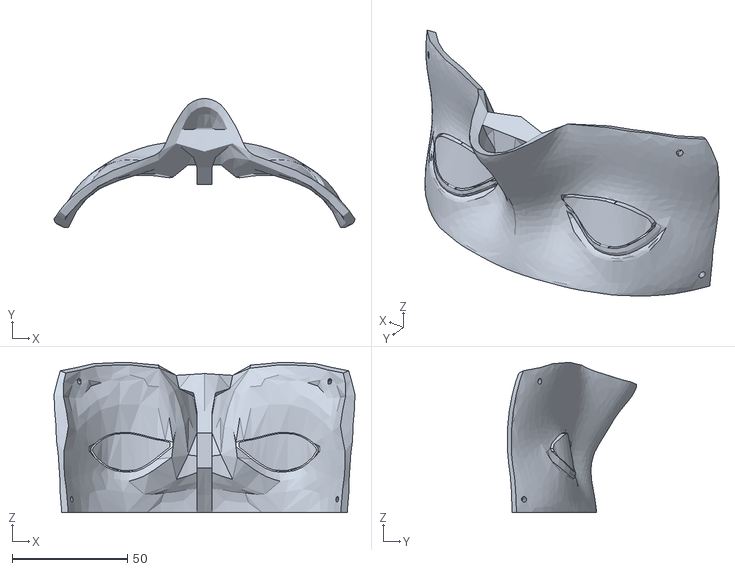
[picture p64: CAD file, 2025-05-29]
零件组装教程+stl文件/Neck_and_jaw-main/颈部和下颌STL/脸部和下颌STL/EyeglassV4.stl
130.6 x 56.1 x 65.2
