idolverse/Tulingjiuge_robot_1/零件组装教程+stl文件/Neck_and_jaw-main/颈部和下颌STL/颈部-.3mf

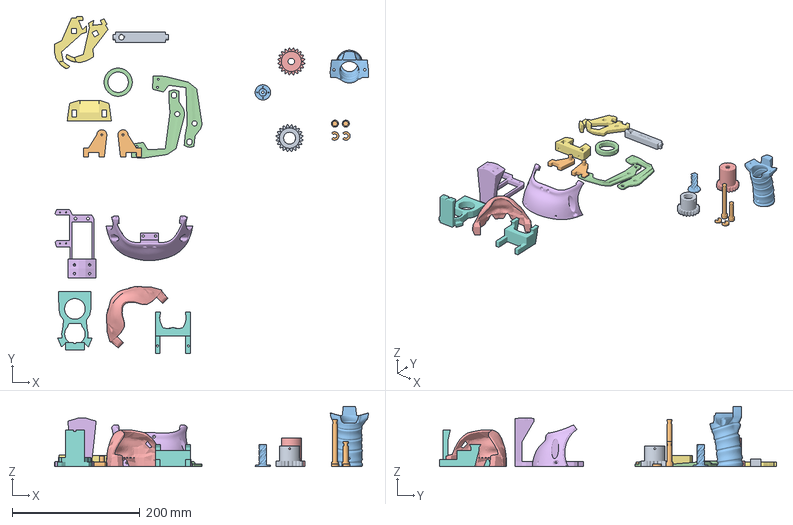
[picture p65: CAD file, 2025-05-29]
零件组装教程+stl文件/Neck_and_jaw-main/颈部和下颌STL/颈部-.3mf
492.9 x 528.6 x 94.9 mm
JawHingeV1.stl
JawHingeV3.stl
JawPistonV1.stl
JawSupportV1.stl
JawV4.stl
LowBackV5.stl
FaceHolderV4.stl
GearHolderV2.stl
MainGearV2.stl
NeckBoltsV2.stl
NeckV3.stl
RingV2.stl
ServoGearV2.stl
SkullServoFixV1.stl
ThroatHolderV2.stl
ThroatHoleV3.stl
