idolverse/Tulingjiuge_robot_1/零件组装教程+stl文件/Neck_and_jaw-main/颈部和下颌STL/颈部STL/NeckPistonV2.stl

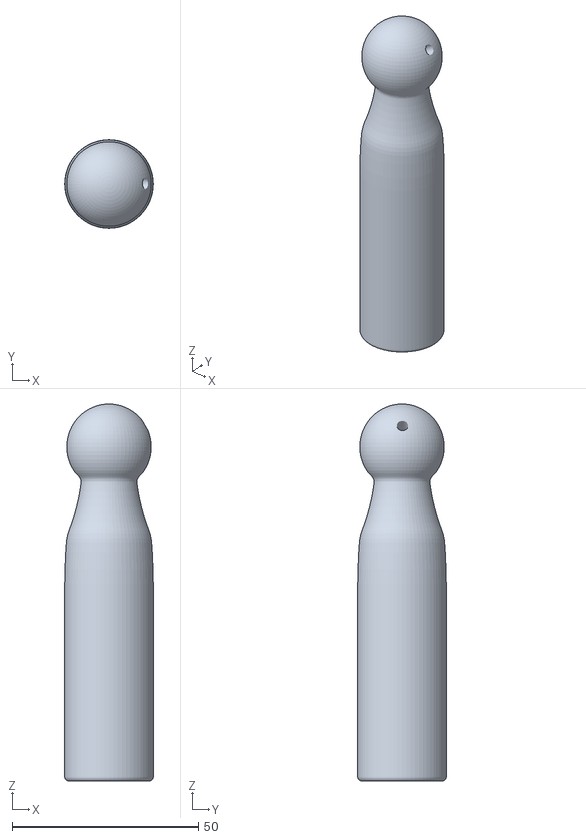
[picture p66: CAD file, 2025-05-29]
零件组装教程+stl文件/Neck_and_jaw-main/颈部和下颌STL/颈部STL/NeckPistonV2.stl
23.8 x 23.8 x 101.3
