idolverse/Tulingjiuge_robot_1/零件组装教程+stl文件/Shoulder_torso-main/肩部和躯干STL/肩部STL/LeftPivTitV3.stl

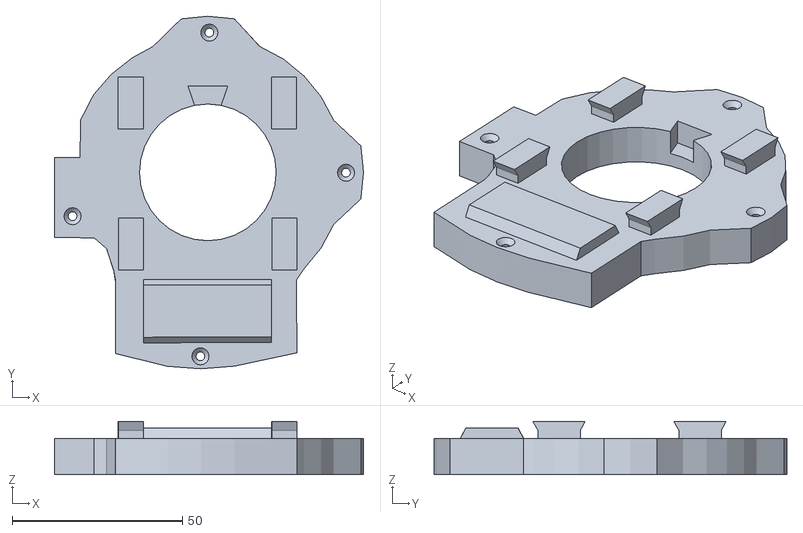
[picture p67: CAD file, 2025-05-29]
零件组装教程+stl文件/Shoulder_torso-main/肩部和躯干STL/肩部STL/LeftPivTitV3.stl
90.7 x 103.5 x 15.6
