idolverse/Tulingjiuge_robot_1/零件组装教程+stl文件/Shoulder_torso-main/肩部和躯干STL/躯干STL/homplatebacklow+V1.stl

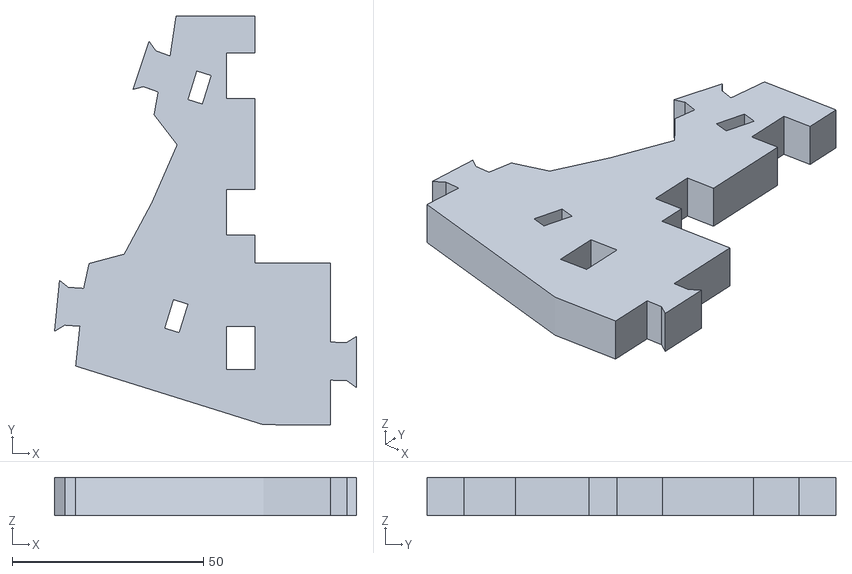
[picture p68: CAD file, 2025-05-29]
零件组装教程+stl文件/Shoulder_torso-main/肩部和躯干STL/躯干STL/homplatebacklow+V1.stl
79.1 x 107.0 x 10.0
