idolverse/Tulingjiuge_robot_1/零件组装教程+stl文件/A合并打印文件/头模.STL

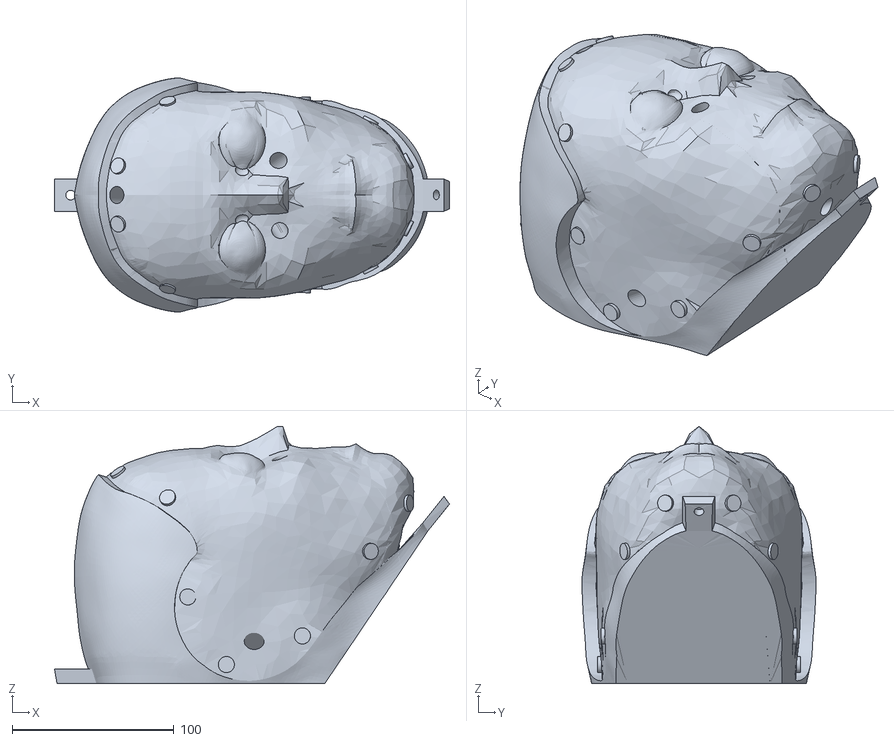
[picture p70: CAD file, 2025-06-13]
零件组装教程+stl文件/A合并打印文件/头模.STL
244.4 x 144.9 x 159.3
