idolverse/Tulingjiuge_robot_1/零件组装教程+stl文件/Back-main/背部STL/BackHolderLowRightV1.stl

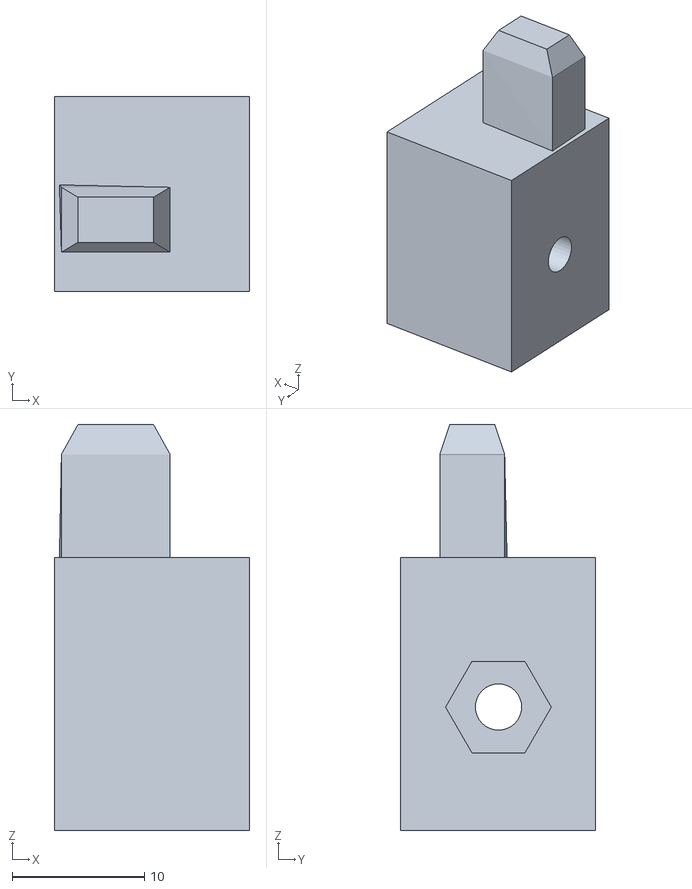
[picture p71: CAD file, 2025-05-29]
零件组装教程+stl文件/Back-main/背部STL/BackHolderLowRightV1.stl
14.7 x 14.8 x 30.7
