idolverse/Tulingjiuge_robot_1/零件组装教程+stl文件/Bicep-main/二头肌STL/servobaseV1.stl

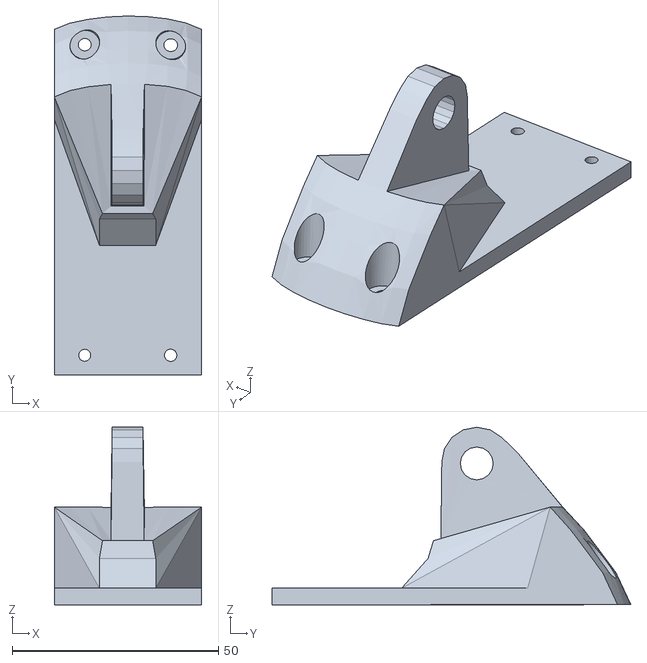
[picture p72: CAD file, 2025-05-29]
零件组装教程+stl文件/Bicep-main/二头肌STL/servobaseV1.stl
35.7 x 87.0 x 43.1
