idolverse/Tulingjiuge_robot_1/零件组装教程+stl文件/Eyes-i2-main/眼睛STL/Eye-R-BaseV5.stl

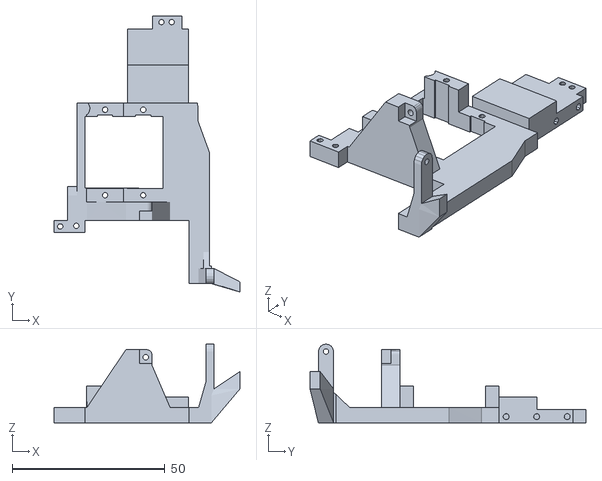
[picture p73: CAD file, 2025-05-29]
零件组装教程+stl文件/Eyes-i2-main/眼睛STL/Eye-R-BaseV5.stl
60.8 x 90.4 x 25.9
