idolverse/Tulingjiuge_robot_1/零件组装教程+stl文件/Finger_starter-main/手指STL/FingerIndexV4.stl

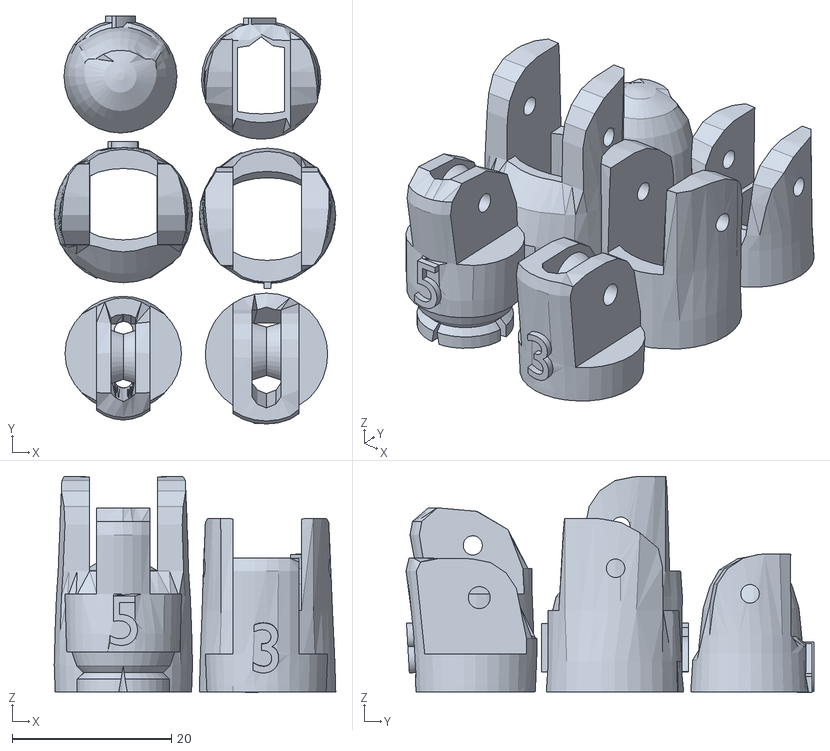
[picture p74: CAD file, 2025-05-29]
零件组装教程+stl文件/Finger_starter-main/手指STL/FingerIndexV4.stl
35.3 x 51.2 x 27.1
