idolverse/Tulingjiuge_robot_1/零件组装教程+stl文件/Hand_i2-main/手部STL/左手/i2_LeftHandCoverV1.stl

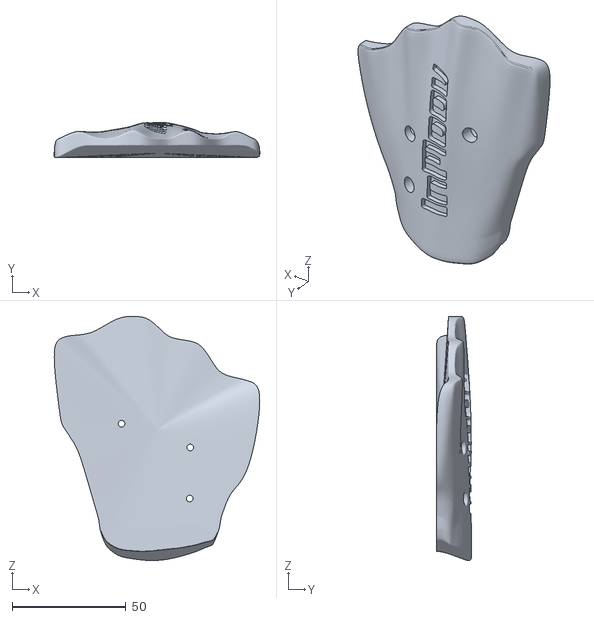
[picture p76: CAD file, 2025-05-29]
零件组装教程+stl文件/Hand_i2-main/手部STL/左手/i2_LeftHandCoverV1.stl
90.2 x 15.6 x 107.1
