idolverse/Tulingjiuge_robot_1/零件组装教程+stl文件/Head_i2-main/头部STL/JawHingeV4.stl

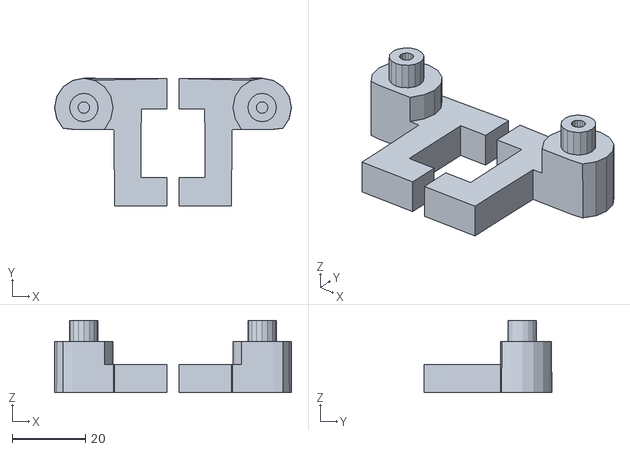
[picture p77: CAD file, 2025-05-29]
零件组装教程+stl文件/Head_i2-main/头部STL/JawHingeV4.stl
64.9 x 34.9 x 19.7
