idolverse/Tulingjiuge_robot_1/零件组装教程+stl文件/Leg-main/腿部STL/大腿STL/ThighHighTempLeftV1.stl

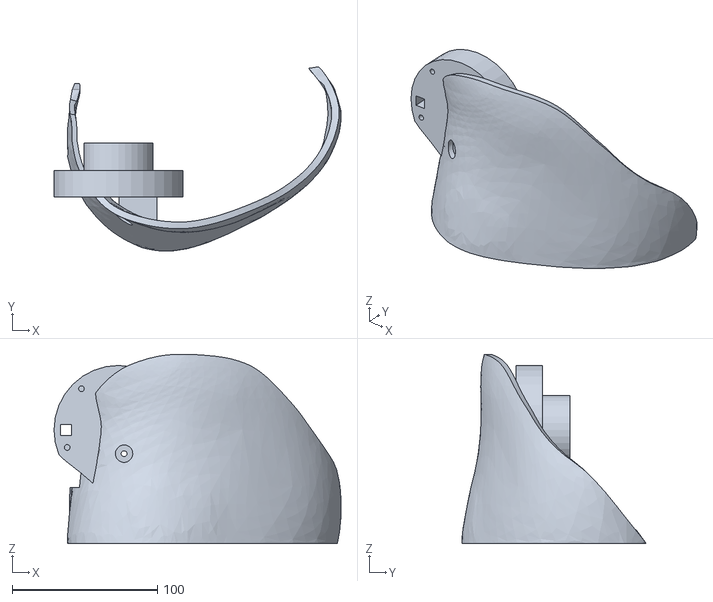
[picture p78: CAD file, 2025-05-29]
零件组装教程+stl文件/Leg-main/腿部STL/大腿STL/ThighHighTempLeftV1.stl
197.7 x 126.9 x 130.4
