idolverse/Tulingjiuge_robot_1/零件组装教程+stl文件/Leg-main/腿部STL/胫骨STL/TibiaLowS1RightV1.stl

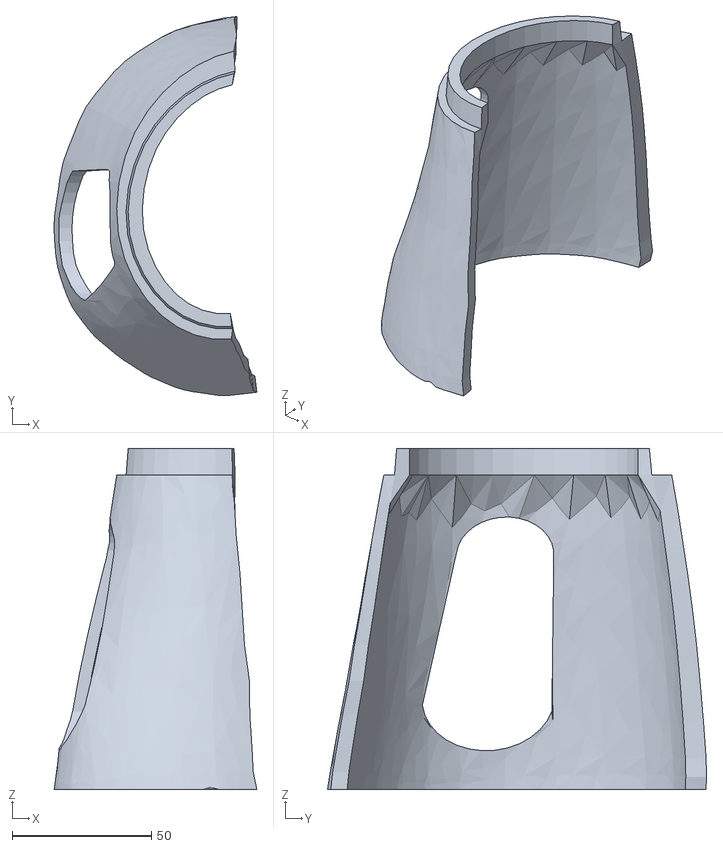
[picture p79: CAD file, 2025-05-29]
零件组装教程+stl文件/Leg-main/腿部STL/胫骨STL/TibiaLowS1RightV1.stl
72.7 x 135.9 x 122.3
