idolverse/Tulingjiuge_robot_1/零件组装教程+stl文件/Leg-main/腿部STL/脚踝STL/LeftAnkBackFootV1.stl

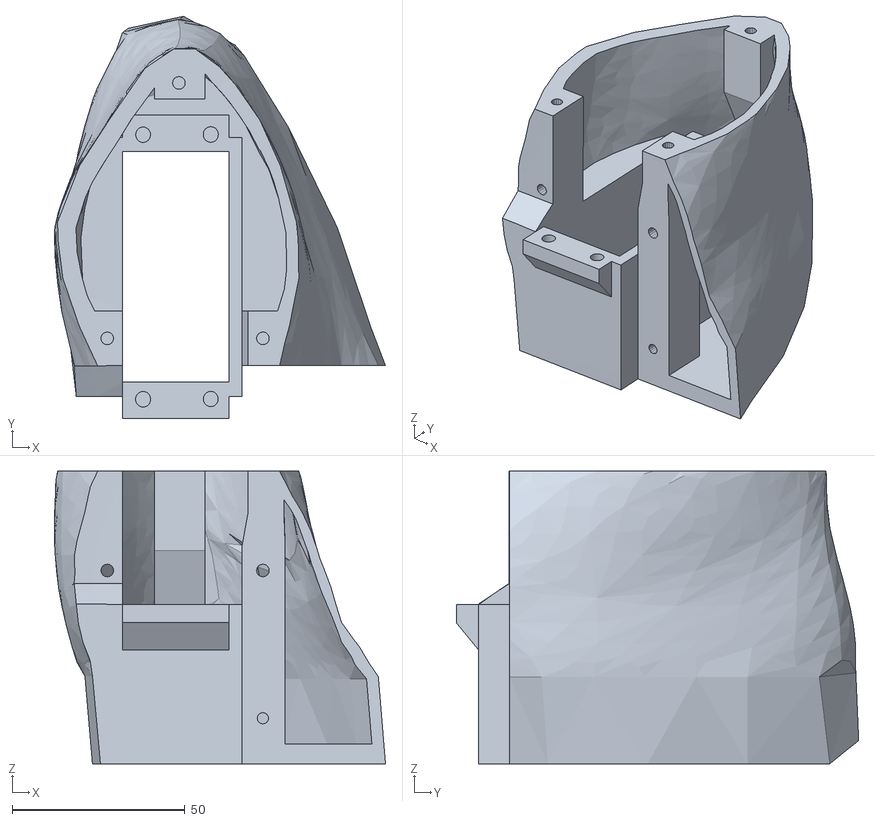
[picture p80: CAD file, 2025-05-29]
零件组装教程+stl文件/Leg-main/腿部STL/脚踝STL/LeftAnkBackFootV1.stl
95.8 x 116.5 x 84.7
