idolverse/Tulingjiuge_robot_1/零件组装教程+stl文件/Low_stomach-main/下腹部STL/TStoLowRightV1.stl

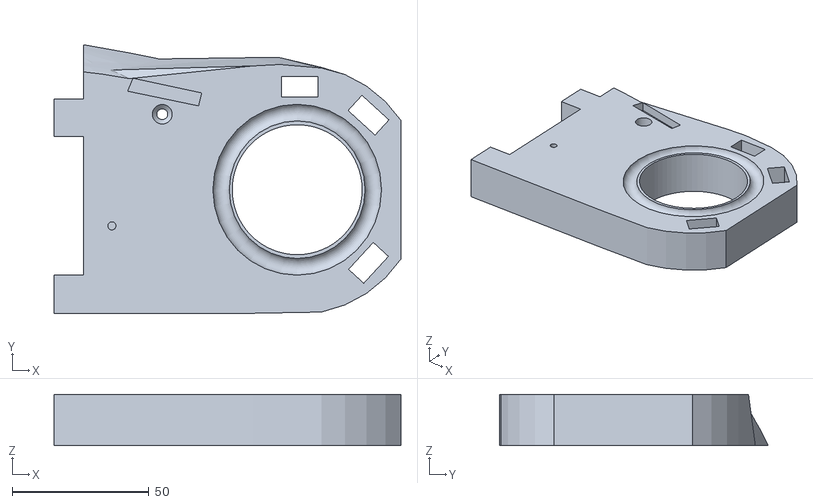
[picture p81: CAD file, 2025-05-29]
零件组装教程+stl文件/Low_stomach-main/下腹部STL/TStoLowRightV1.stl
127.1 x 98.4 x 18.9
