idolverse/Tulingjiuge_robot_1/零件组装教程+stl文件/Mid_Stomach-main/中腹部STL/BotFrontRigtV1.stl

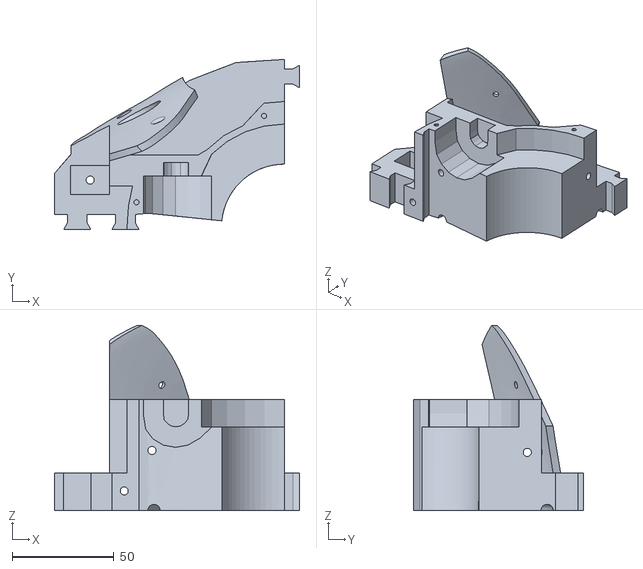
[picture p82: CAD file, 2025-05-29]
零件组装教程+stl文件/Mid_Stomach-main/中腹部STL/BotFrontRigtV1.stl
120.5 x 83.7 x 91.0
