idolverse/Tulingjiuge_robot_1/零件组装教程+stl文件/Neck_and_jaw-main/颈部和下颌STL/脸部和下颌STL/JawSupportV1.stl

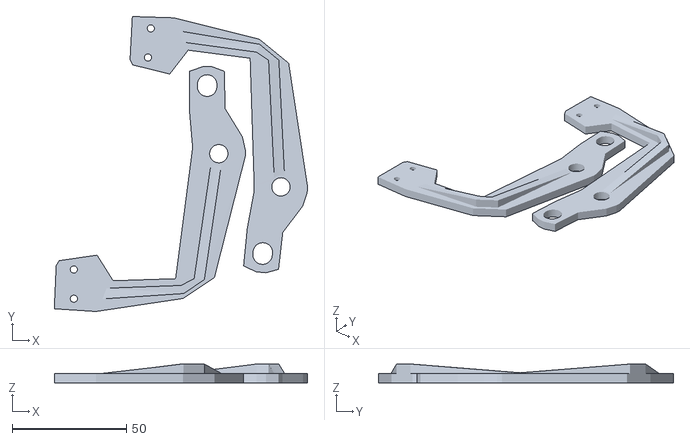
[picture p83: CAD file, 2025-05-29]
零件组装教程+stl文件/Neck_and_jaw-main/颈部和下颌STL/脸部和下颌STL/JawSupportV1.stl
110.8 x 128.9 x 8.26
