idolverse/Tulingjiuge_robot_1/零件组装教程+stl文件/Neck_and_jaw-main/颈部和下颌STL/颈部STL/GearHolderV2.stl

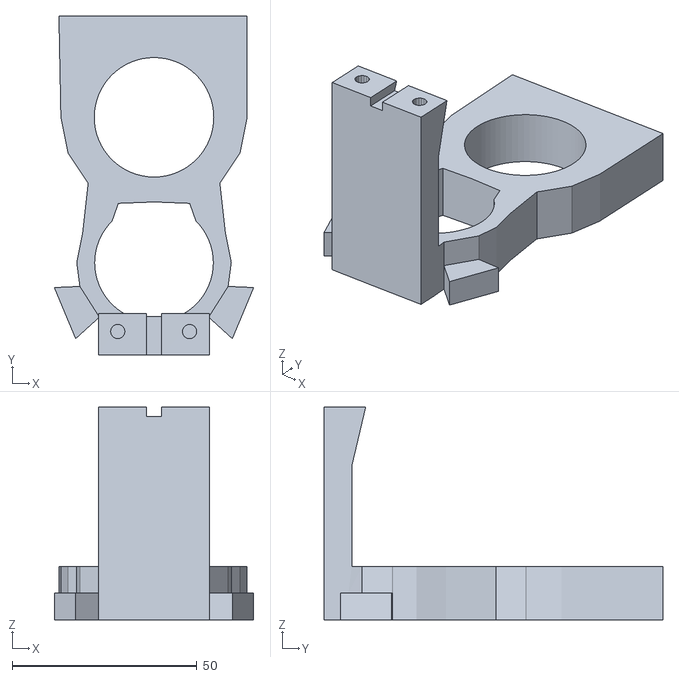
[picture p84: CAD file, 2025-05-29]
零件组装教程+stl文件/Neck_and_jaw-main/颈部和下颌STL/颈部STL/GearHolderV2.stl
53.9 x 91.6 x 57.5
