idolverse/Tulingjiuge_robot_1/零件组装教程+stl文件/Shoulder_torso-main/肩部和躯干STL/肩部STL/servoHolsterV1.stl

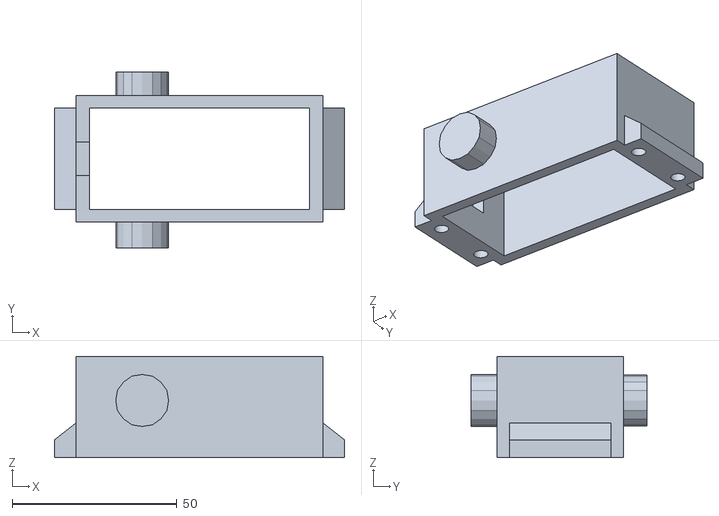
[picture p85: CAD file, 2025-05-29]
零件组装教程+stl文件/Shoulder_torso-main/肩部和躯干STL/肩部STL/servoHolsterV1.stl
87.9 x 53.5 x 30.7
