idolverse/Tulingjiuge_robot_1/零件组装教程+stl文件/Shoulder_torso-main/肩部和躯干STL/躯干STL/arduinosupportmega.stl

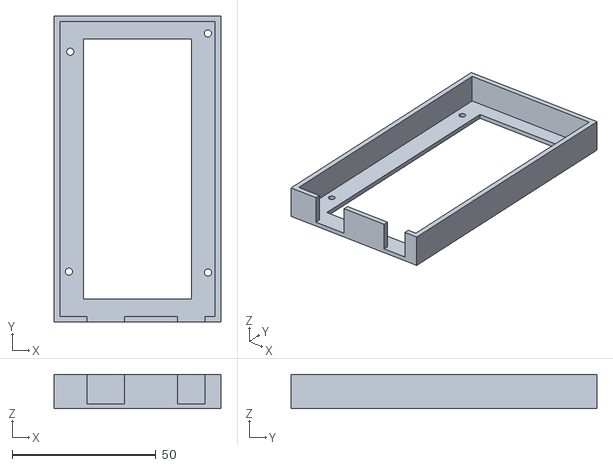
[picture p86: CAD file, 2025-05-29]
零件组装教程+stl文件/Shoulder_torso-main/肩部和躯干STL/躯干STL/arduinosupportmega.stl
58.0 x 106.4 x 11.9
