idolverse/Tulingjiuge_robot_1/零件组装教程+stl文件/Top_Stomach-main/上腹部STL/TStoFrontLeftV1.stl

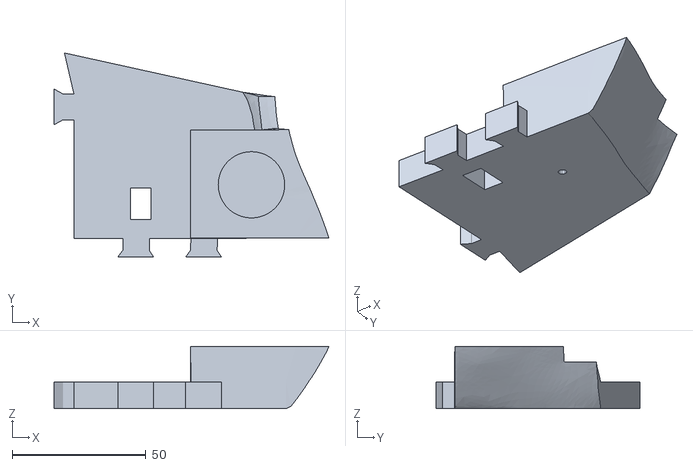
[picture p87: CAD file, 2025-05-29]
零件组装教程+stl文件/Top_Stomach-main/上腹部STL/TStoFrontLeftV1.stl
103.0 x 76.4 x 23.4
