idolverse/Tulingjiuge_robot_1/零件组装教程+stl文件/A合并打印文件/头-前额.STL

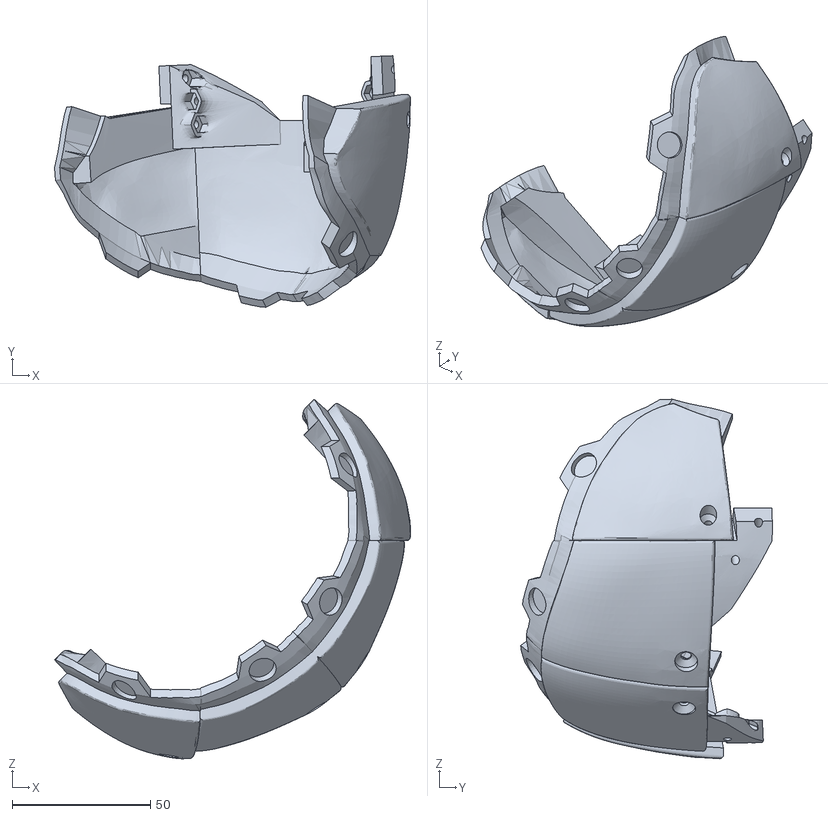
[picture p88: CAD file, 2025-06-13]
零件组装教程+stl文件/A合并打印文件/头-前额.STL
128.6 x 90.9 x 129.9
