idolverse/Tulingjiuge_robot_1/零件组装教程+stl文件/Back-main/背部STL/BackCoverBottomLeftV2.stl

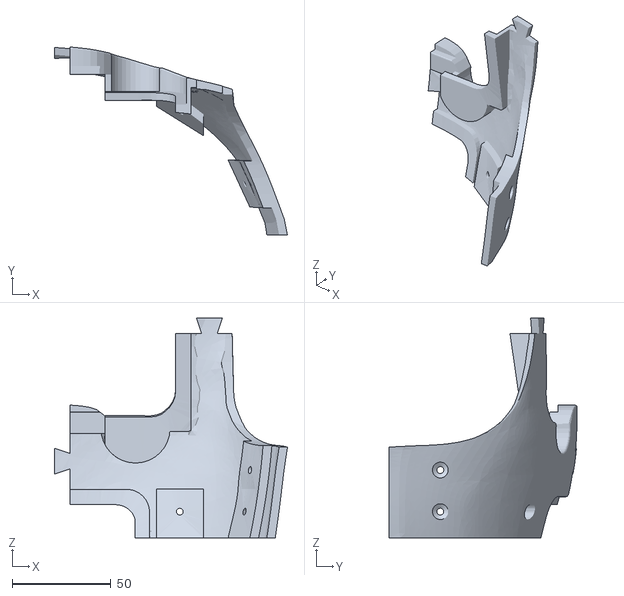
[picture p89: CAD file, 2025-05-29]
零件组装教程+stl文件/Back-main/背部STL/BackCoverBottomLeftV2.stl
118.1 x 95.3 x 111.5
