idolverse/Tulingjiuge_robot_1/零件组装教程+stl文件/Bicep-main/二头肌STL/右二头肌.3mf

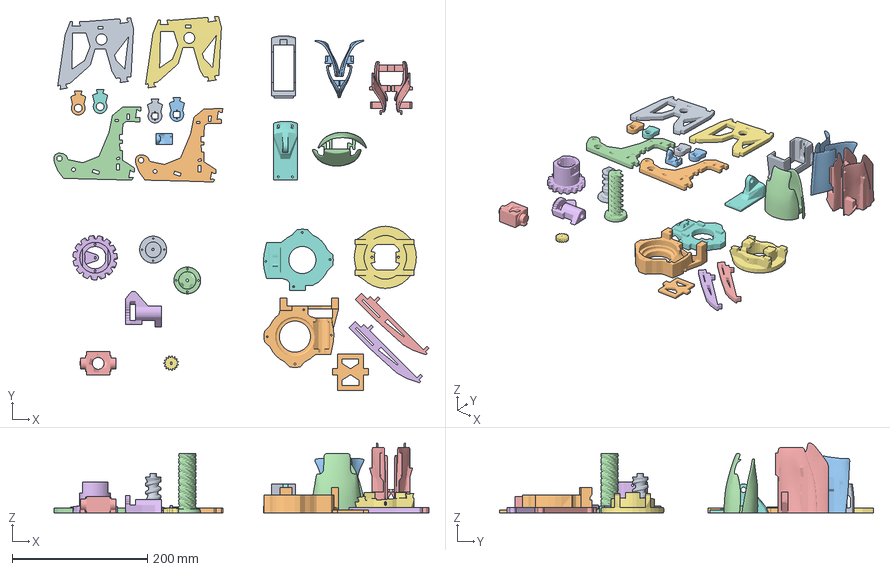
[picture p90: CAD file, 2025-05-29]
零件组装教程+stl文件/Bicep-main/二头肌STL/右二头肌.3mf
554.9 x 554.0 x 103.5 mm
HighArmSideV3.stl x 2
PivPotentioRoundV3.stl x 2
PivPotentioSquareV3.stl x 2
LowArmSideV3.stl x 2
ReinforcerV2.stl x 2
GearHolderV1.stl
PistonanticlockV2.stl
PistonbaseantiV2.stl
RotGearV6.stl
RotMitV3.stl
RotTitV4.stl
RotWormV5.stl
RotcenterV3.stl
armtopcover1.stl
armtopcover2.stl
armtopcover3.stl
elbowshaftgearV1.stl
gearpotentioV1.stl
servobaseV1.stl
servoholderV1.stl
spacerV1.stl
