idolverse/Tulingjiuge_robot_1/零件组装教程+stl文件/Eyes-i2-main/眼睛STL/Eye-L-AllPartsV2.stl

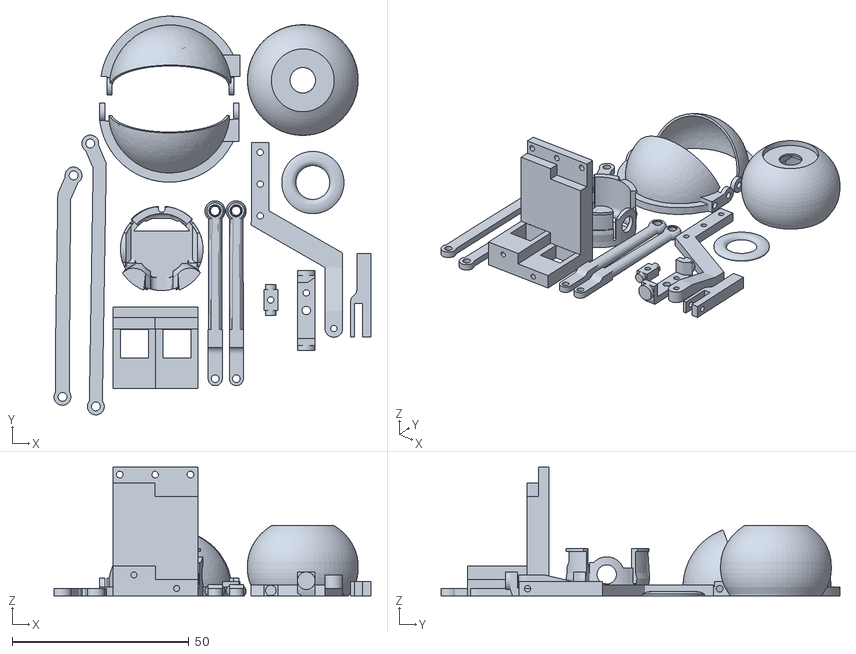
[picture p91: CAD file, 2025-05-29]
零件组装教程+stl文件/Eyes-i2-main/眼睛STL/Eye-L-AllPartsV2.stl
89.7 x 112.9 x 36.4
