idolverse/Tulingjiuge_robot_1/零件组装教程+stl文件/Eyes-i2-main/眼罩制作/眼罩STL/EyeBallSupportLifeCamHDLeftV1.stl

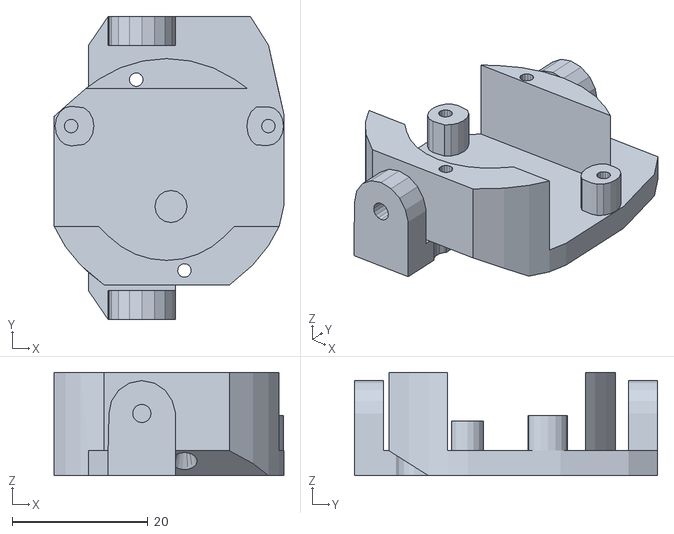
[picture p92: CAD file, 2025-05-29]
零件组装教程+stl文件/Eyes-i2-main/眼罩制作/眼罩STL/EyeBallSupportLifeCamHDLeftV1.stl
33.8 x 44.6 x 15.2
