idolverse/Tulingjiuge_robot_1/零件组装教程+stl文件/Finger_starter-main/手指STL/手指.3mf

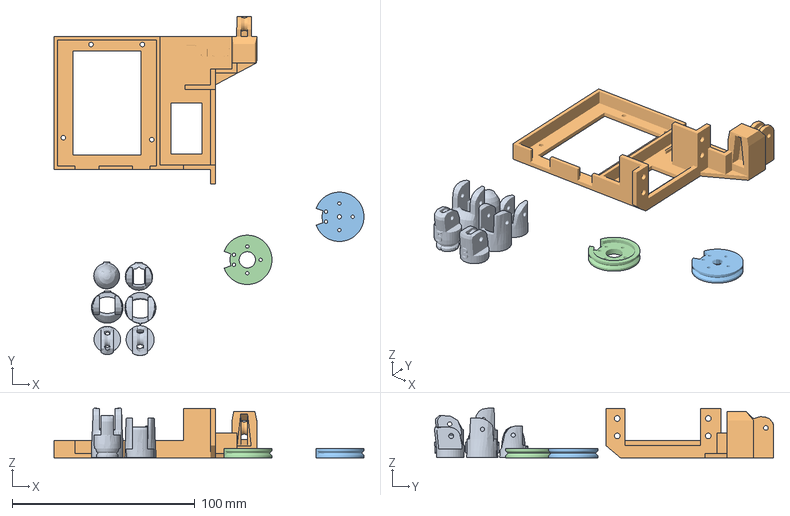
[picture p93: CAD file, 2025-05-29]
零件组装教程+stl文件/Finger_starter-main/手指STL/手指.3mf
169.7 x 185.7 x 27.1 mm
FingerIndexV4.stl
FingerTesterV2.stl
RobRingV2.stl
Servo-PulleyV2.stl
