idolverse/Tulingjiuge_robot_1/零件组装教程+stl文件/Hand_i2-main/手部STL/右手/i2_PalmCoverV2.stl

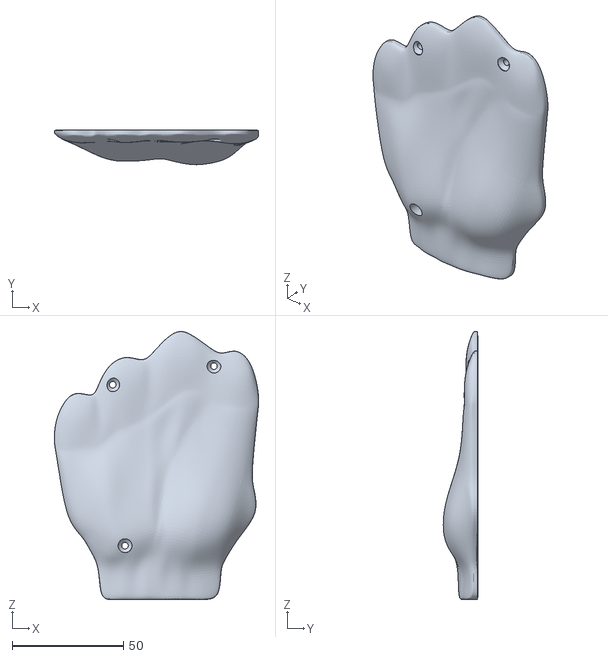
[picture p94: CAD file, 2025-05-29]
零件组装教程+stl文件/Hand_i2-main/手部STL/右手/i2_PalmCoverV2.stl
92.0 x 15.5 x 120.7
