idolverse/Tulingjiuge_robot_1/零件组装教程+stl文件/Hand_i2-main/手部STL/左手/i2_LeftWristGearV1.stl

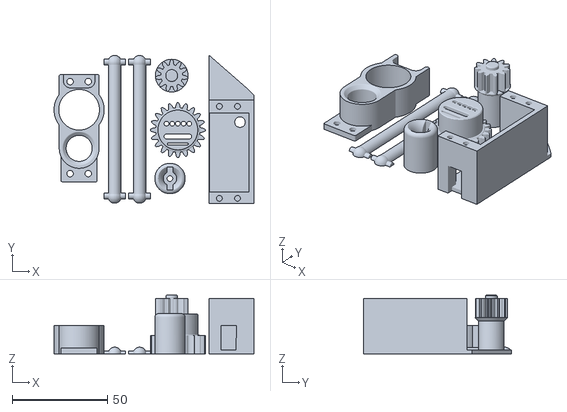
[picture p95: CAD file, 2025-05-29]
零件组装教程+stl文件/Hand_i2-main/手部STL/左手/i2_LeftWristGearV1.stl
105.2 x 78.1 x 30.8
