idolverse/Tulingjiuge_robot_1/零件组装教程+stl文件/Head_i2-main/头部STL/TopTeethV3.stl

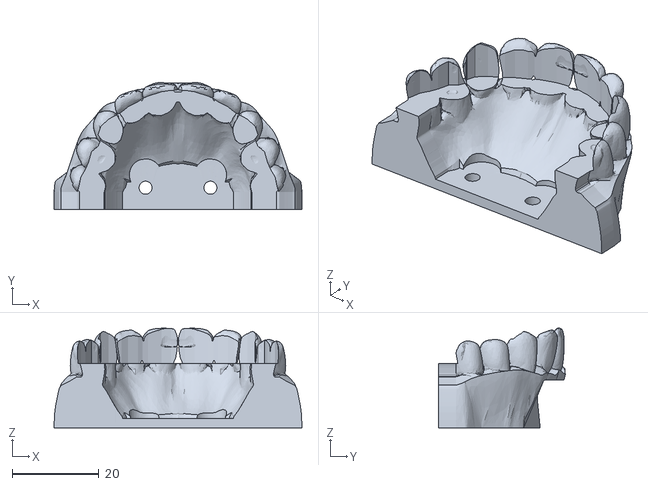
[picture p96: CAD file, 2025-05-29]
零件组装教程+stl文件/Head_i2-main/头部STL/TopTeethV3.stl
57.3 x 29.3 x 23.0
