idolverse/Tulingjiuge_robot_1/零件组装教程+stl文件/Leg-main/腿部STL/大腿STL/ThighHighBlokerRV1.stl

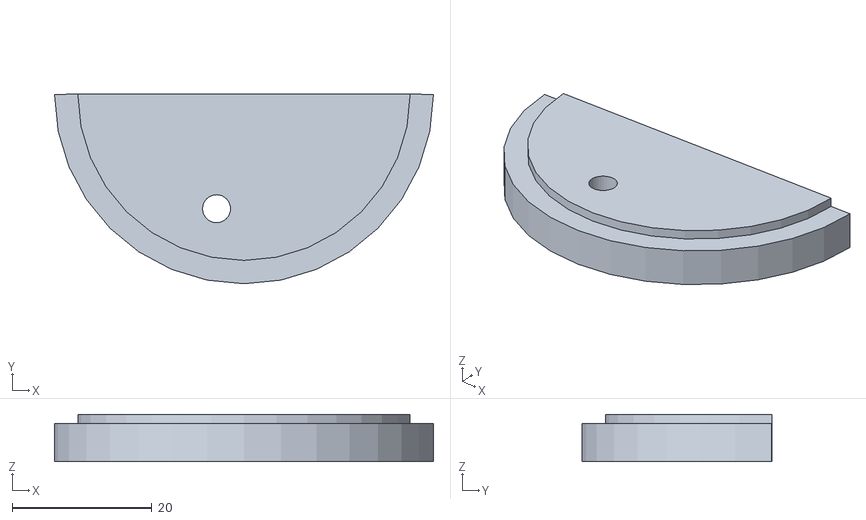
[picture p97: CAD file, 2025-05-29]
零件组装教程+stl文件/Leg-main/腿部STL/大腿STL/ThighHighBlokerRV1.stl
54.2 x 27.1 x 6.78
