idolverse/Tulingjiuge_robot_1/零件组装教程+stl文件/Leg-main/腿部STL/脚踝STL/LeftAnkToesFootV2.stl

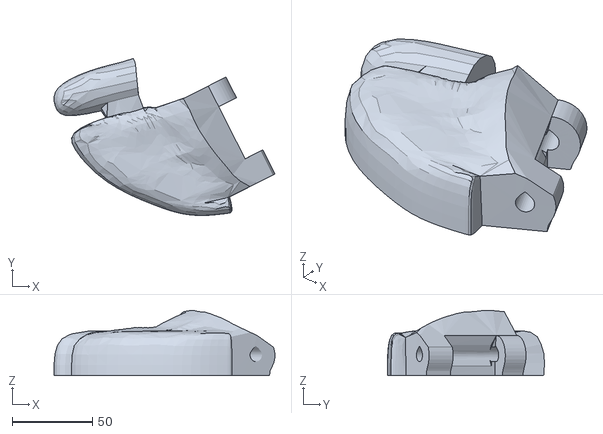
[picture p98: CAD file, 2025-05-29]
零件组装教程+stl文件/Leg-main/腿部STL/脚踝STL/LeftAnkToesFootV2.stl
137.8 x 97.9 x 40.6
