idolverse/Tulingjiuge_robot_1/零件组装教程+stl文件/Low_stomach-main/下腹部STL/StomSupportLeftV1.stl

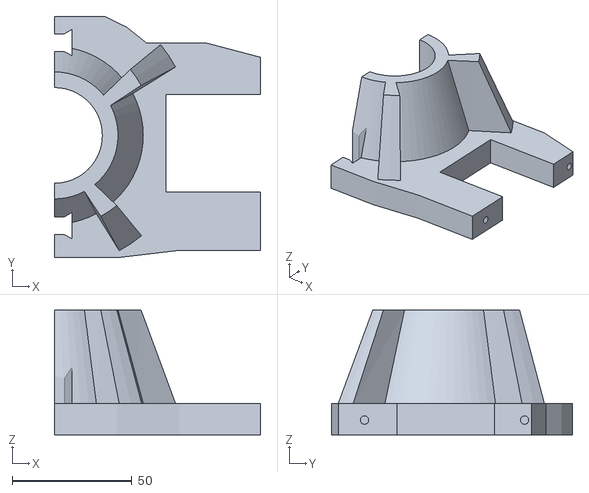
[picture p99: CAD file, 2025-05-29]
零件组装教程+stl文件/Low_stomach-main/下腹部STL/StomSupportLeftV1.stl
86.2 x 101.0 x 52.2
