idolverse/Tulingjiuge_robot_1/零件组装教程+stl文件/Neck_and_jaw-main/颈部和下颌STL/脸部和下颌STL/SideHearV5.stl

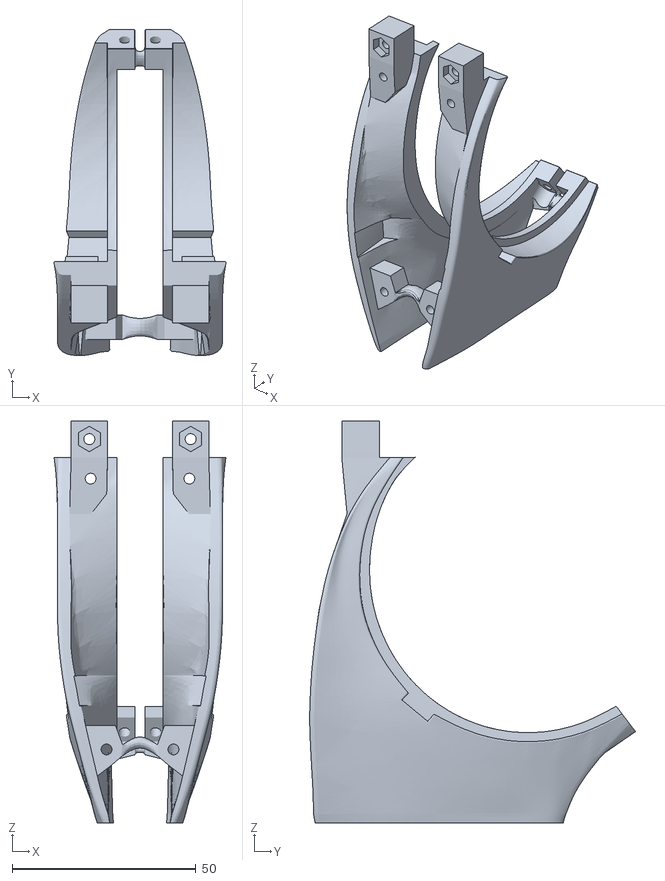
[picture p101: CAD file, 2025-05-29]
零件组装教程+stl文件/Neck_and_jaw-main/颈部和下颌STL/脸部和下颌STL/SideHearV5.stl
46.8 x 88.6 x 109.3
