idolverse/Tulingjiuge_robot_1/零件组装教程+stl文件/Neck_and_jaw-main/颈部和下颌STL/颈部STL/FaceHolderV4.stl

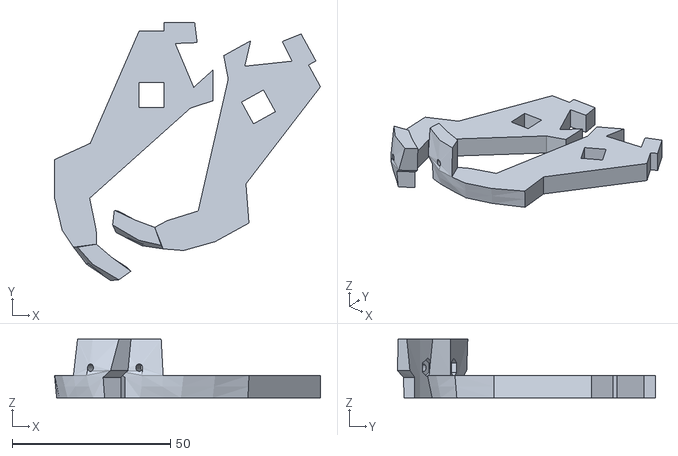
[picture p102: CAD file, 2025-05-29]
零件组装教程+stl文件/Neck_and_jaw-main/颈部和下颌STL/颈部STL/FaceHolderV4.stl
84.1 x 81.6 x 18.6
