idolverse/Tulingjiuge_robot_1/零件组装教程+stl文件/Shoulder_torso-main/肩部和躯干STL/躯干STL/ThroatLowerV1.stl

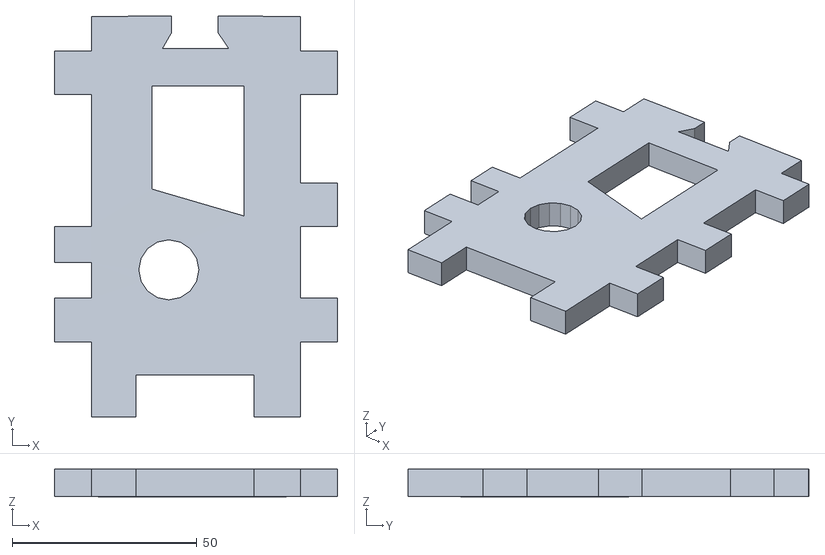
[picture p103: CAD file, 2025-05-29]
零件组装教程+stl文件/Shoulder_torso-main/肩部和躯干STL/躯干STL/ThroatLowerV1.stl
76.6 x 108.6 x 7.56
