idolverse/Tulingjiuge_robot_1/零件组装教程+stl文件/Top_Stomach-main/上腹部STL/TStomRotBackV1.stl

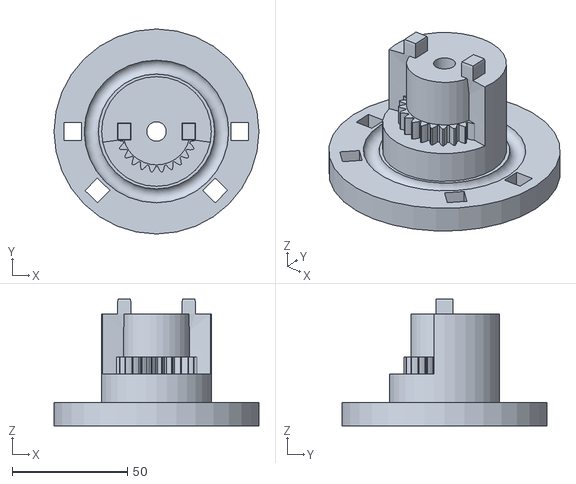
[picture p104: CAD file, 2025-05-29]
零件组装教程+stl文件/Top_Stomach-main/上腹部STL/TStomRotBackV1.stl
88.8 x 88.8 x 54.9
