idolverse/Tulingjiuge_robot_1/零件组装教程+stl文件/A合并打印文件/胸部+腹部.STL

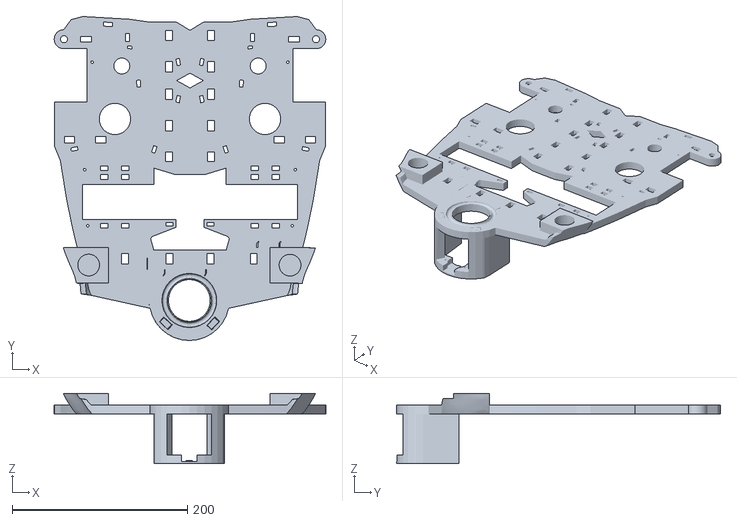
[picture p105: CAD file, 2025-06-10]
零件组装教程+stl文件/A合并打印文件/胸部+腹部.STL
310.0 x 369.8 x 80.1
