idolverse/Tulingjiuge_robot_1/零件组装教程+stl文件/Back-main/背部STL/BackDoorClipV1.stl

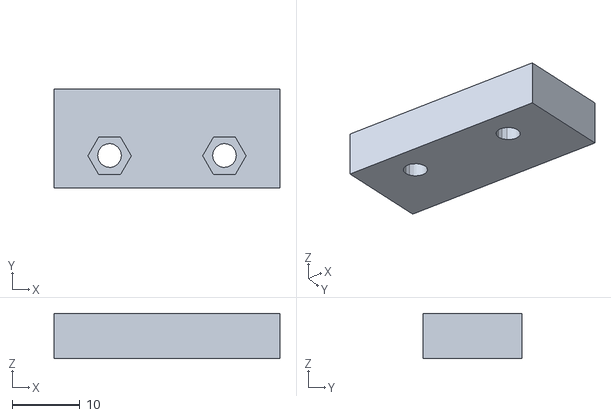
[picture p106: CAD file, 2025-05-29]
零件组装教程+stl文件/Back-main/背部STL/BackDoorClipV1.stl
33.3 x 14.6 x 6.63
