idolverse/Tulingjiuge_robot_1/零件组装教程+stl文件/Bicep-main/二头肌STL/armtopcover2.stl

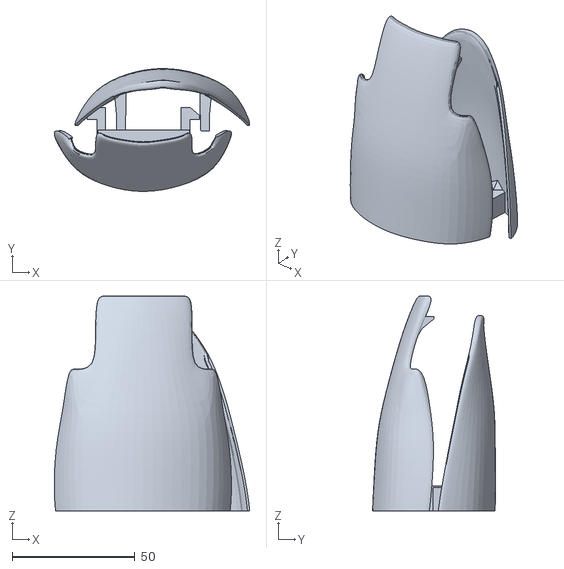
[picture p107: CAD file, 2025-05-29]
零件组装教程+stl文件/Bicep-main/二头肌STL/armtopcover2.stl
79.7 x 50.2 x 87.7
