idolverse/Tulingjiuge_robot_1/零件组装教程+stl文件/Eyes-i2-main/眼罩制作/眼罩STL/EyeBallSupportHerculeRightV2.stl

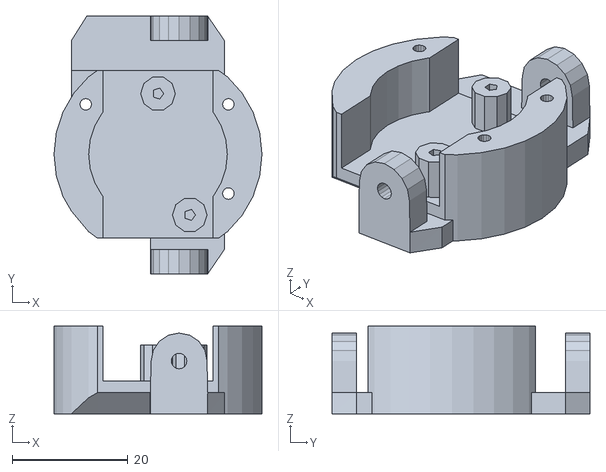
[picture p108: CAD file, 2025-05-29]
零件组装教程+stl文件/Eyes-i2-main/眼罩制作/眼罩STL/EyeBallSupportHerculeRightV2.stl
36.0 x 44.6 x 15.2
