idolverse/Tulingjiuge_robot_1/零件组装教程+stl文件/Hand_i2-main/手部STL/右手/i2_PalmPDI6225V3.stl

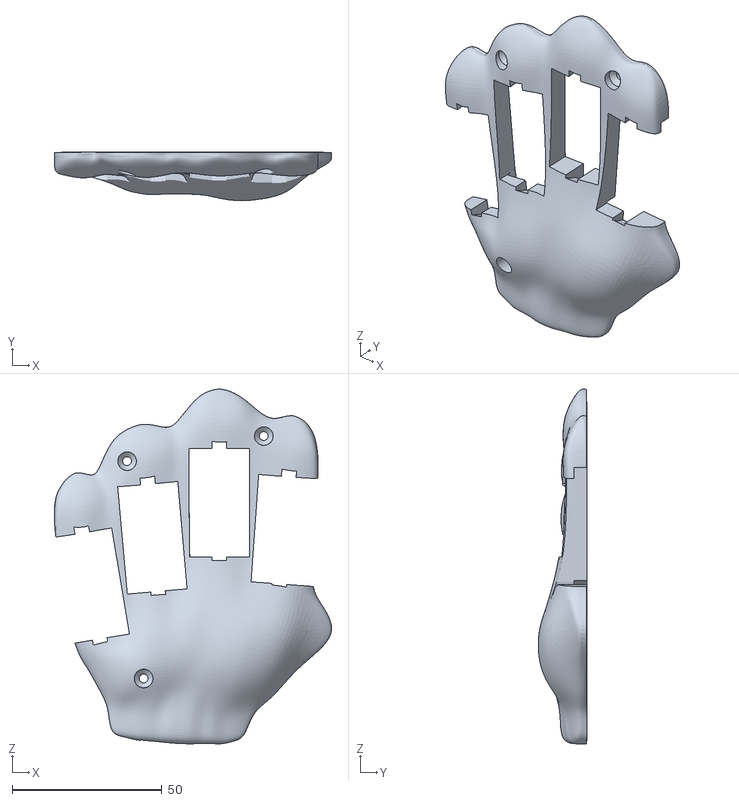
[picture p110: CAD file, 2025-05-29]
零件组装教程+stl文件/Hand_i2-main/手部STL/右手/i2_PalmPDI6225V3.stl
92.4 x 16.2 x 118.4
