idolverse/Tulingjiuge_robot_1/零件组装教程+stl文件/Head_i2-main/头部STL/UpperLipV2.stl

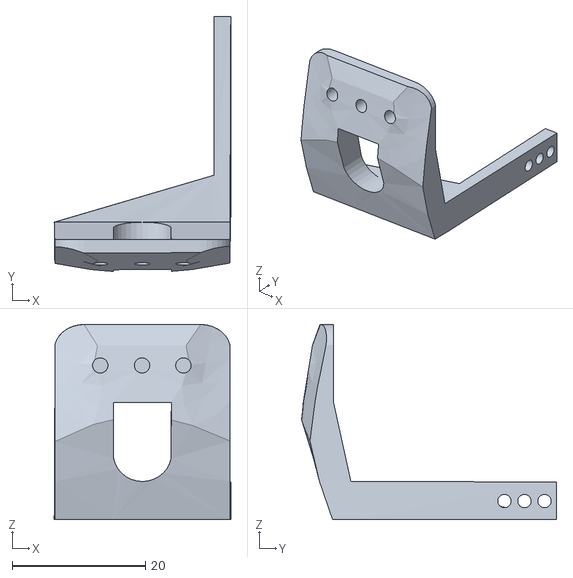
[picture p111: CAD file, 2025-05-29]
零件组装教程+stl文件/Head_i2-main/头部STL/UpperLipV2.stl
26.5 x 38.2 x 29.2
