idolverse/Tulingjiuge_robot_1/零件组装教程+stl文件/Leg-main/腿部STL/大腿STL/ThighSideAccessLeftV1.stl

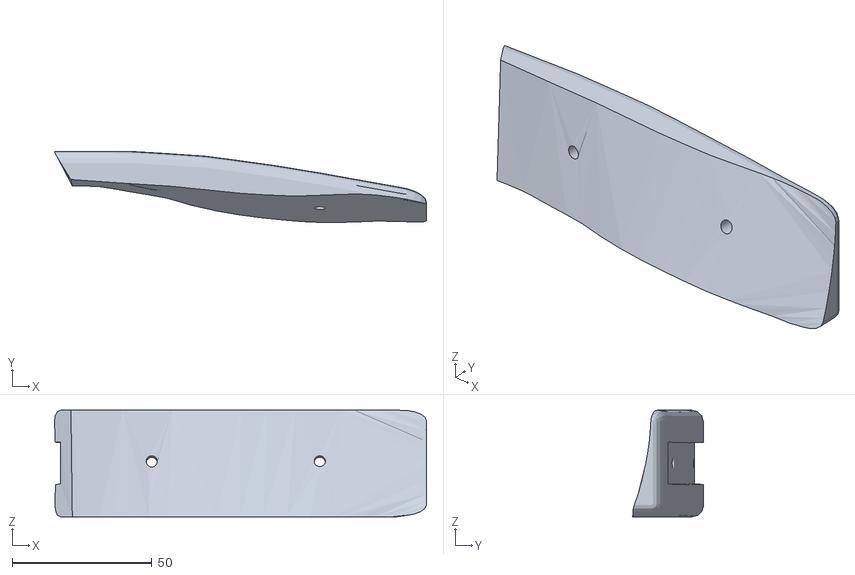
[picture p112: CAD file, 2025-05-29]
零件组装教程+stl文件/Leg-main/腿部STL/大腿STL/ThighSideAccessLeftV1.stl
133.1 x 25.4 x 38.1
