idolverse/Tulingjiuge_robot_1/零件组装教程+stl文件/Leg-main/腿部STL/胫骨STL/TibiaHighRightV1.stl

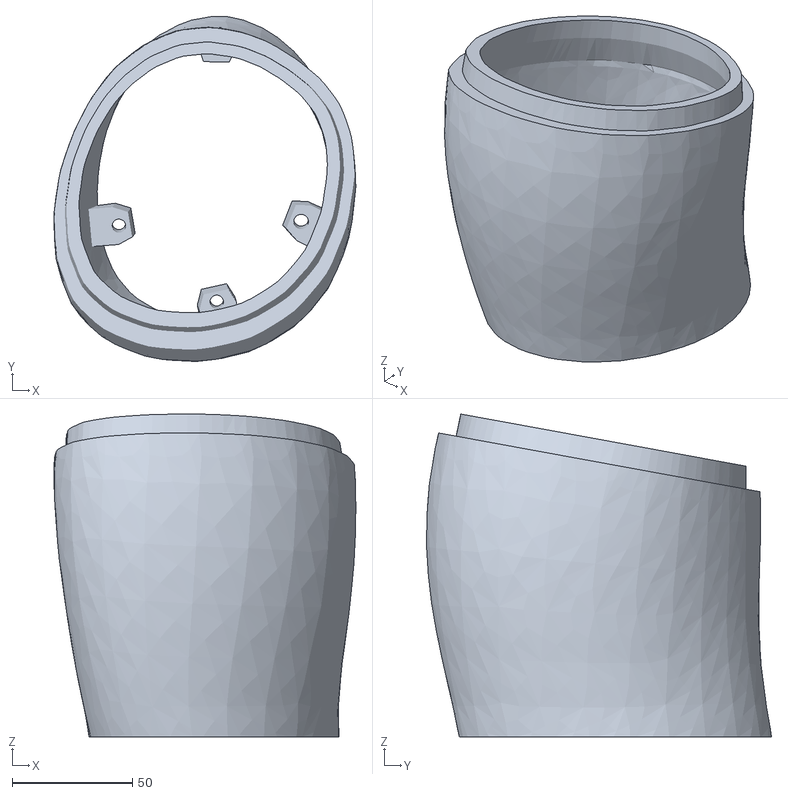
[picture p113: CAD file, 2025-05-29]
零件组装教程+stl文件/Leg-main/腿部STL/胫骨STL/TibiaHighRightV1.stl
125.4 x 143.4 x 134.2
