idolverse/Tulingjiuge_robot_1/零件组装教程+stl文件/Neck_and_jaw-main/颈部和下颌STL/颈部STL/ThroatHolderV2.stl

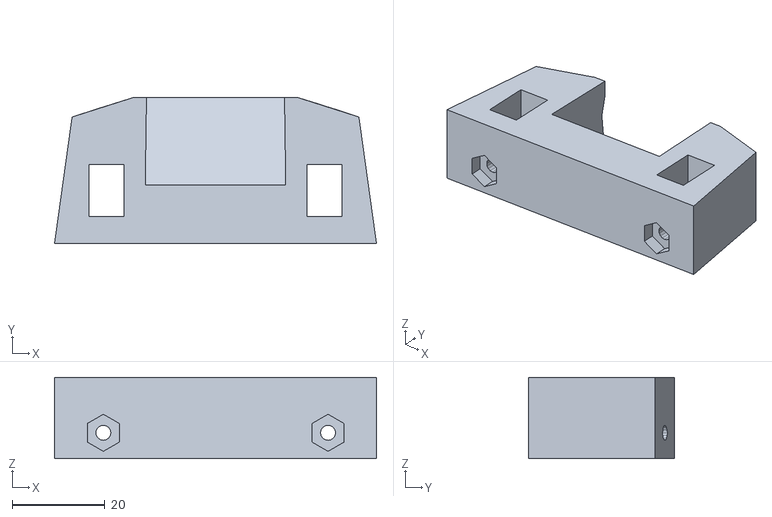
[picture p115: CAD file, 2025-05-29]
零件组装教程+stl文件/Neck_and_jaw-main/颈部和下颌STL/颈部STL/ThroatHolderV2.stl
69.4 x 31.5 x 17.5
