idolverse/Tulingjiuge_robot_1/零件组装教程+stl文件/Shoulder_torso-main/肩部和躯干STL/肩部STL/PivGearV6.stl

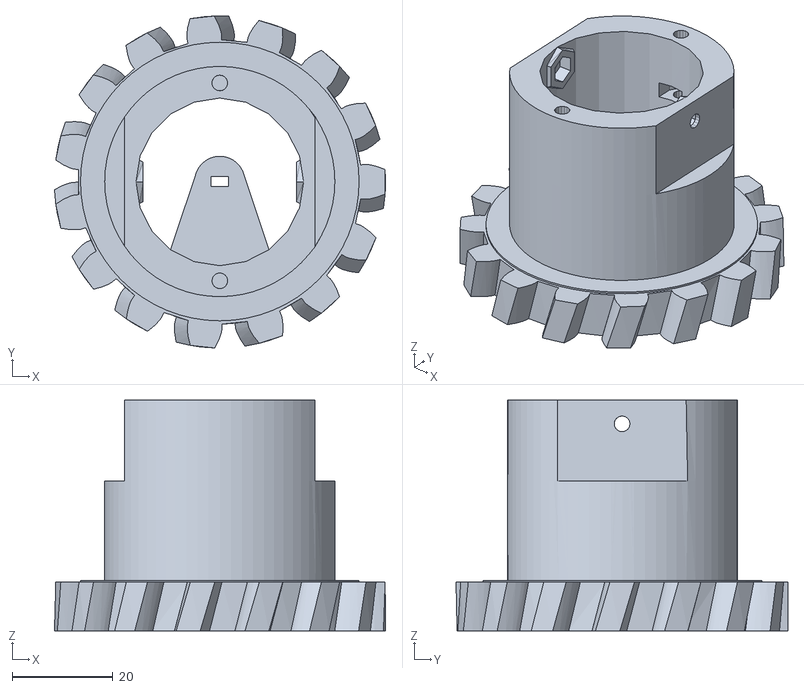
[picture p116: CAD file, 2025-05-29]
零件组装教程+stl文件/Shoulder_torso-main/肩部和躯干STL/肩部STL/PivGearV6.stl
65.6 x 65.7 x 45.7
