idolverse/Tulingjiuge_robot_1/零件组装教程+stl文件/Shoulder_torso-main/肩部和躯干STL/躯干STL/InterKinectSideV1.stl

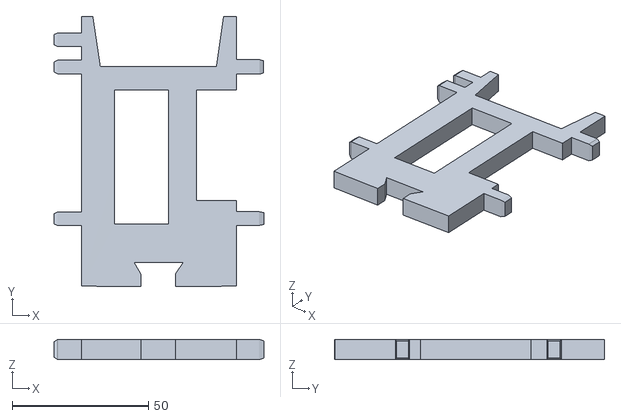
[picture p117: CAD file, 2025-05-29]
零件组装教程+stl文件/Shoulder_torso-main/肩部和躯干STL/躯干STL/InterKinectSideV1.stl
76.9 x 99.0 x 7.49
