idolverse/Tulingjiuge_robot_1/零件组装教程+stl文件/Top_Stomach-main/上腹部STL/TStoPistonRightV2.stl

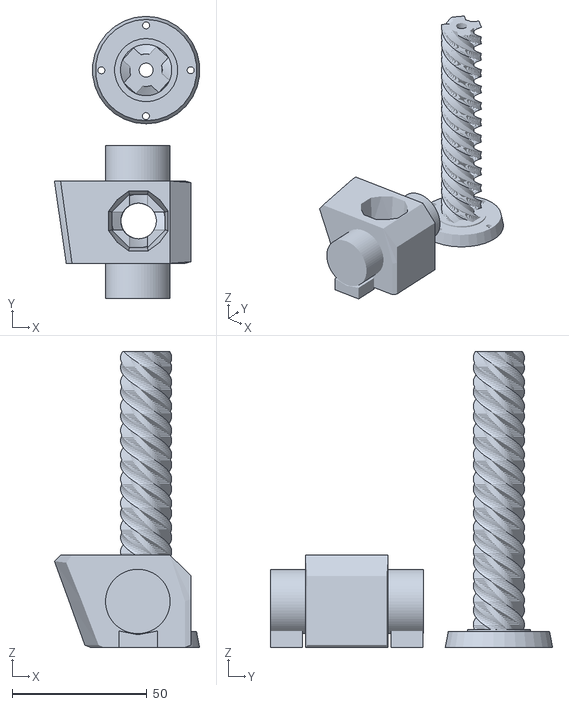
[picture p118: CAD file, 2025-05-29]
零件组装教程+stl文件/Top_Stomach-main/上腹部STL/TStoPistonRightV2.stl
53.8 x 104.6 x 109.7
