idolverse/Tulingjiuge_robot_1/零件组装教程+stl文件/A合并打印文件/头壳-头顶.STL

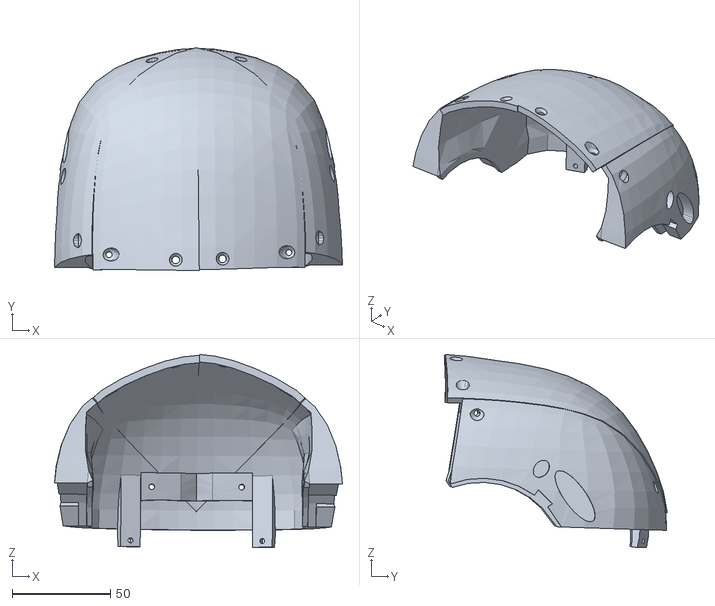
[picture p119: CAD file, 2025-06-10]
零件组装教程+stl文件/A合并打印文件/头壳-头顶.STL
146.4 x 113.2 x 98.2
