idolverse/Tulingjiuge_robot_1/零件组装教程+stl文件/Back-main/背部STL/BackSideHolderLeftV1.stl

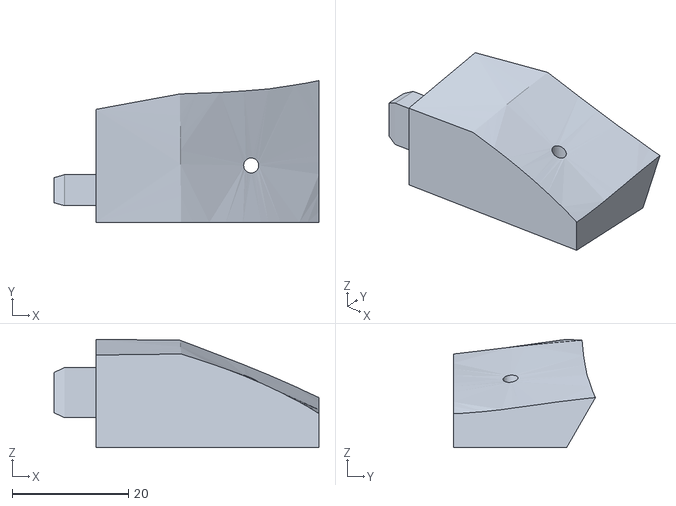
[picture p120: CAD file, 2025-05-29]
零件组装教程+stl文件/Back-main/背部STL/BackSideHolderLeftV1.stl
45.6 x 24.4 x 18.7
