idolverse/Tulingjiuge_robot_1/零件组装教程+stl文件/Bicep-main/二头肌STL/RotWormV5.stl

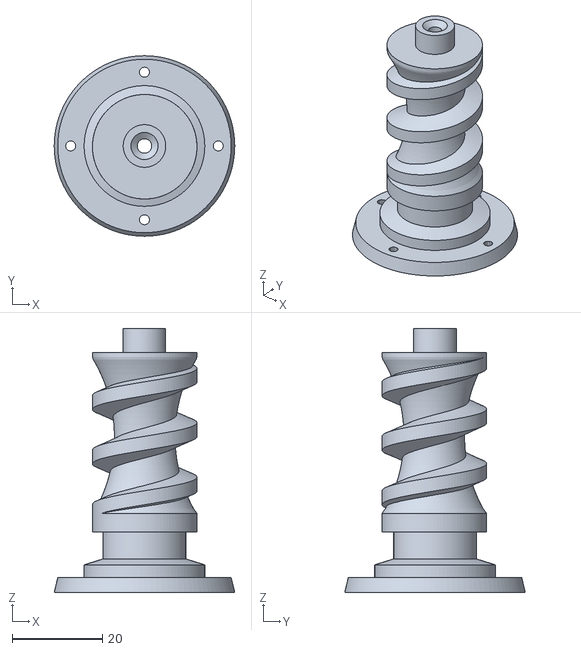
[picture p121: CAD file, 2025-05-29]
零件组装教程+stl文件/Bicep-main/二头肌STL/RotWormV5.stl
40.0 x 39.9 x 58.4
