idolverse/Tulingjiuge_robot_1/零件组装教程+stl文件/Finger_starter-main/手指STL/RobRingV2.stl

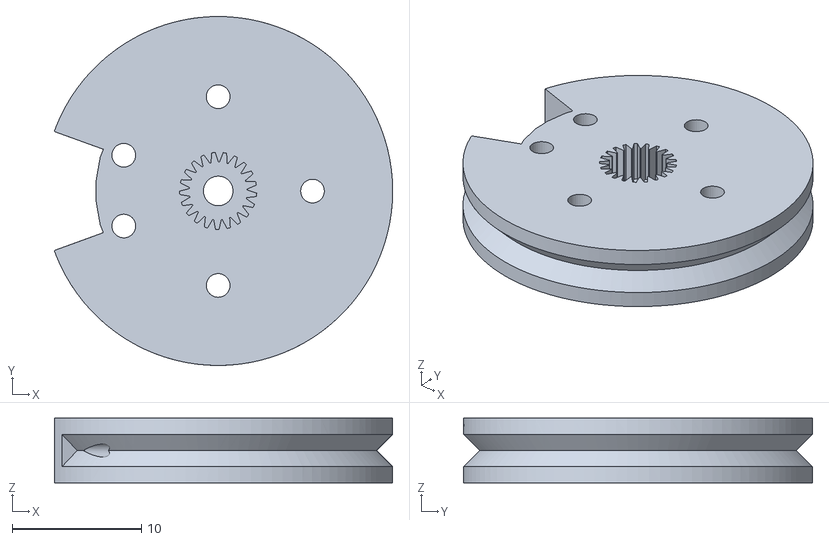
[picture p122: CAD file, 2025-05-29]
零件组装教程+stl文件/Finger_starter-main/手指STL/RobRingV2.stl
26.2 x 27.0 x 5.00
