idolverse/Tulingjiuge_robot_1/零件组装教程+stl文件/Hand_i2-main/手部STL/右手/i2_FingersMoldX5V3.stl

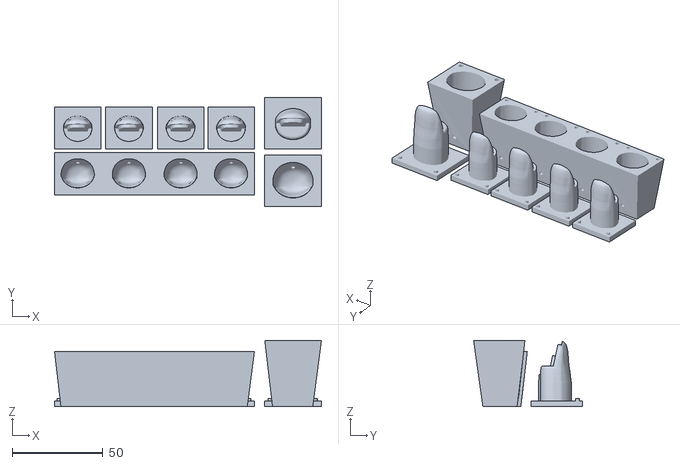
[picture p123: CAD file, 2025-05-29]
零件组装教程+stl文件/Hand_i2-main/手部STL/右手/i2_FingersMoldX5V3.stl
146.8 x 59.8 x 36.5
