idolverse/Tulingjiuge_robot_1/零件组装教程+stl文件/Head_i2-main/头部STL/JawV5.stl

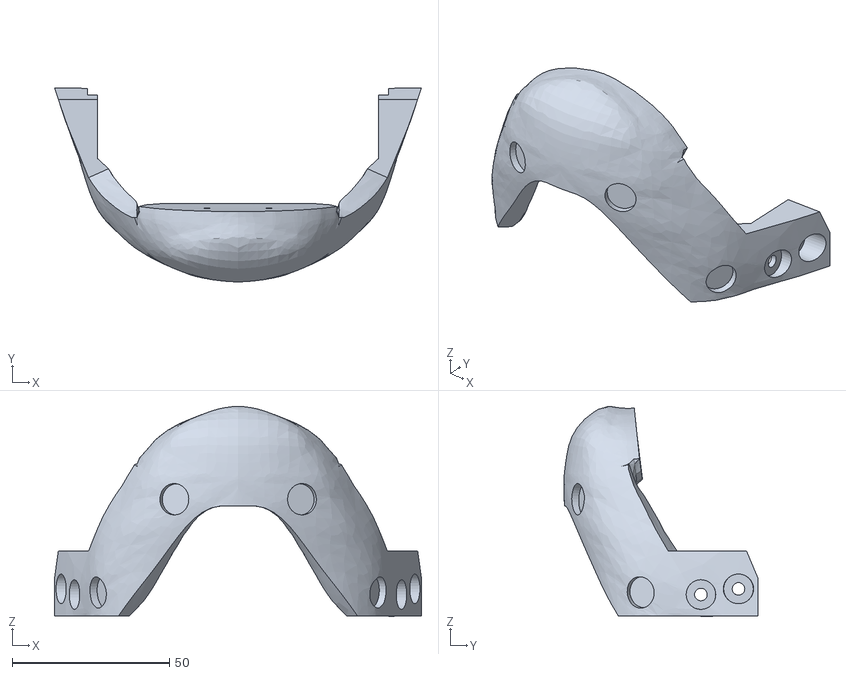
[picture p124: CAD file, 2025-05-29]
零件组装教程+stl文件/Head_i2-main/头部STL/JawV5.stl
116.8 x 61.8 x 66.9
