idolverse/Tulingjiuge_robot_1/零件组装教程+stl文件/Leg-main/腿部STL/胫骨STL/胫骨.3mf

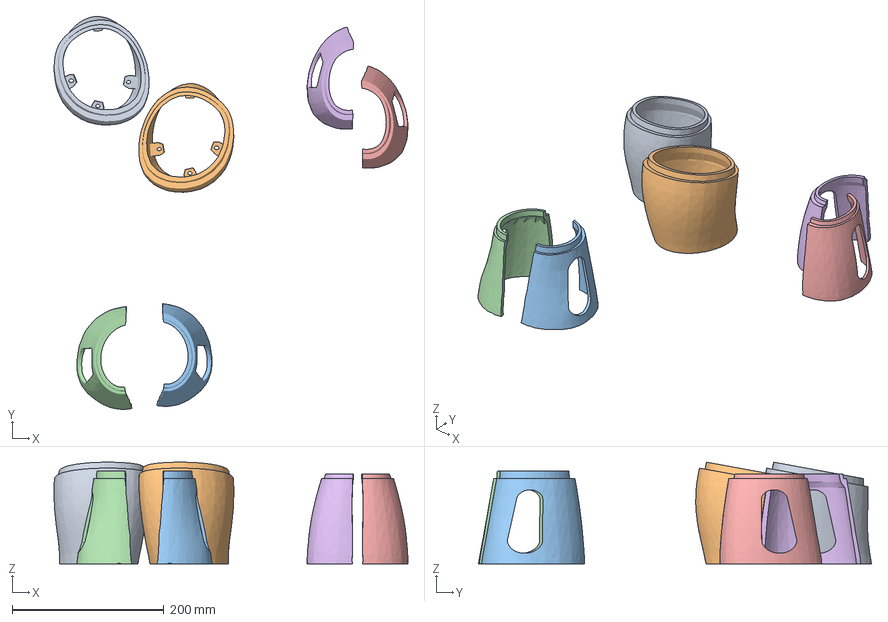
[picture p125: CAD file, 2025-05-29]
零件组装教程+stl文件/Leg-main/腿部STL/胫骨STL/胫骨.3mf
467.3 x 518.8 x 134.2 mm
TibiaHighLeftV1.stl
TibiaHighRightV1.stl
TibiaLowS1LeftV1.stl
TibiaLowS1RightV1.stl
TibiaLowS2LeftV1.stl
TibiaLowS2RightV1.stl
