idolverse/Tulingjiuge_robot_1/零件组装教程+stl文件/Leg-main/腿部STL/膝盖STL/KneeHighLeftV3.stl

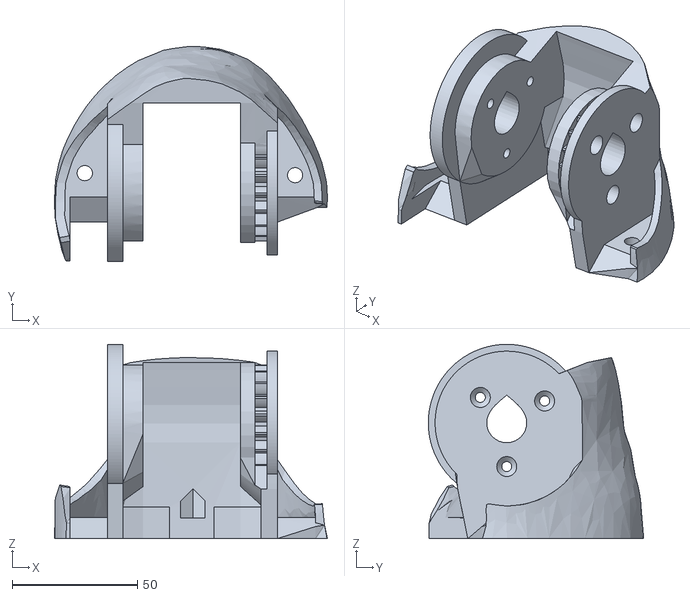
[picture p126: CAD file, 2025-05-29]
零件组装教程+stl文件/Leg-main/腿部STL/膝盖STL/KneeHighLeftV3.stl
109.0 x 86.0 x 77.6
