idolverse/Tulingjiuge_robot_1/零件组装教程+stl文件/Mid_Stomach-main/中腹部STL/MidWormRightV1.stl

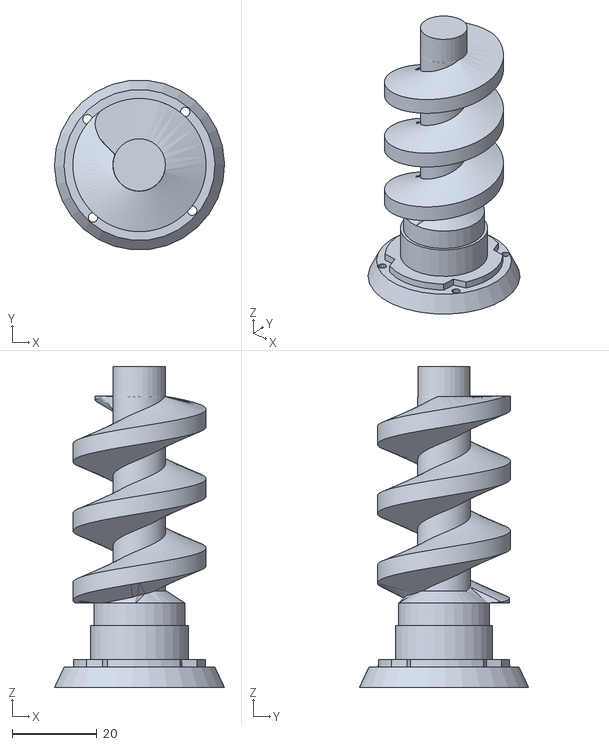
[picture p127: CAD file, 2025-05-29]
零件组装教程+stl文件/Mid_Stomach-main/中腹部STL/MidWormRightV1.stl
40.1 x 39.9 x 75.6
