idolverse/Tulingjiuge_robot_1/零件组装教程+stl文件/Neck_and_jaw-main/颈部和下颌STL/脸部和下颌STL/JawHingeV3.stl

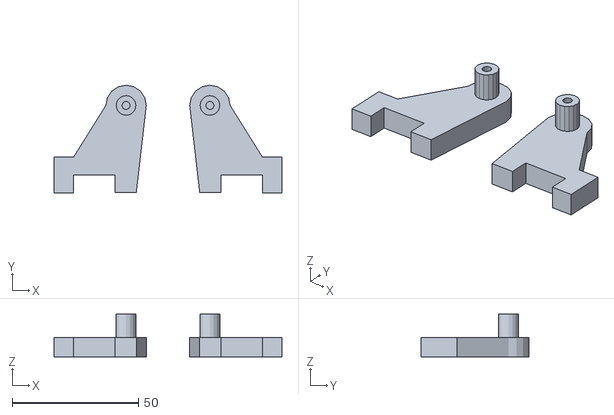
[picture p128: CAD file, 2025-05-29]
零件组装教程+stl文件/Neck_and_jaw-main/颈部和下颌STL/脸部和下颌STL/JawHingeV3.stl
90.5 x 42.7 x 17.0
