idolverse/Tulingjiuge_robot_1/零件组装教程+stl文件/Neck_and_jaw-main/颈部和下颌STL/颈部STL/SpeakerMouthHolderV2.stl

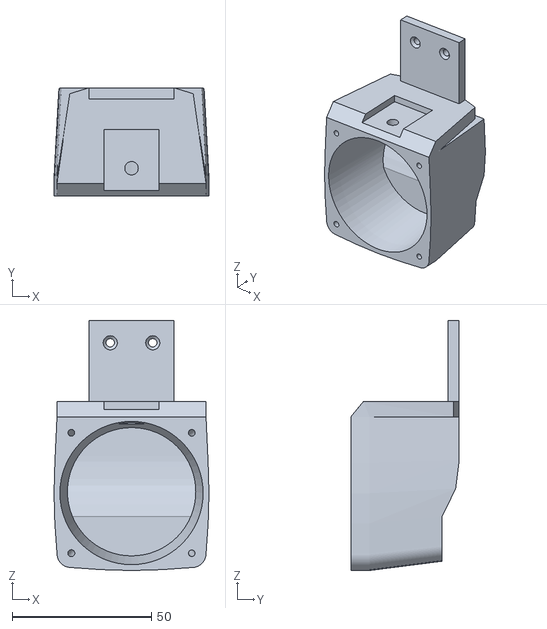
[picture p129: CAD file, 2025-05-29]
零件组装教程+stl文件/Neck_and_jaw-main/颈部和下颌STL/颈部STL/SpeakerMouthHolderV2.stl
55.7 x 38.9 x 89.8
