idolverse/Tulingjiuge_robot_1/零件组装教程+stl文件/Shoulder_torso-main/肩部和躯干STL/肩部STL/PivPotholderSquareV1.stl

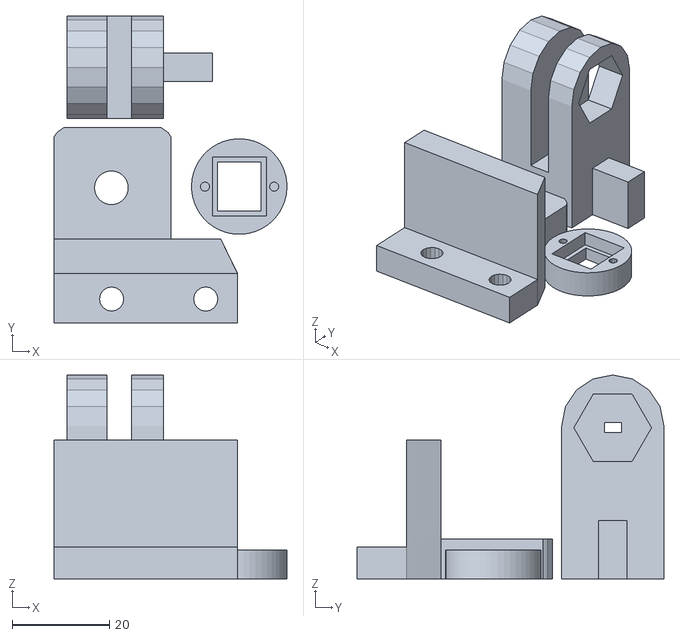
[picture p130: CAD file, 2025-05-29]
零件组装教程+stl文件/Shoulder_torso-main/肩部和躯干STL/肩部STL/PivPotholderSquareV1.stl
47.9 x 63.2 x 42.0
