idolverse/Tulingjiuge_robot_1/零件组装教程+stl文件/Shoulder_torso-main/肩部和躯干STL/躯干STL/躯干.3mf

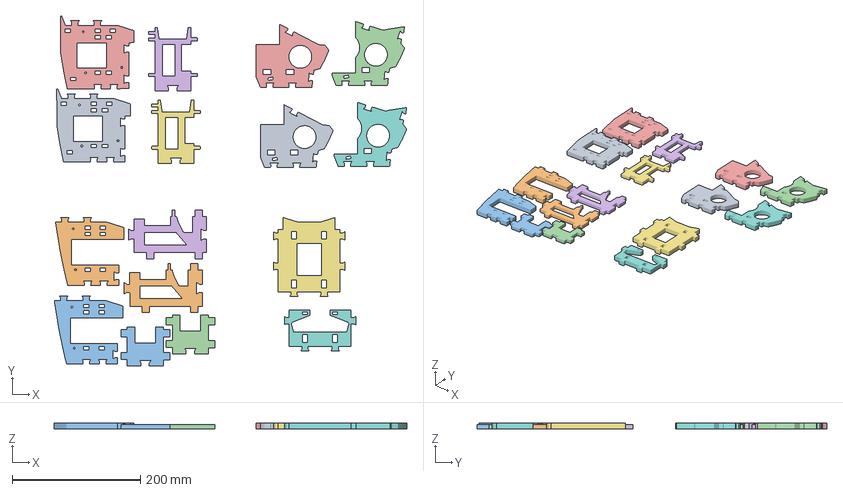
[picture p131: CAD file, 2025-05-29]
零件组装教程+stl文件/Shoulder_torso-main/肩部和躯干STL/躯干STL/躯干.3mf
549.6 x 545.6 x 10.1 mm
KinectSideBackV2.stl x 2
KinectSideHolderV1.stl x 2
ChestLowV1.stl x 2
HomLowBackV3.stl x 2
HomLowFront-V1.stl x 2
InterKinectMidV1.stl x 2
InterKinectSideV1.stl x 2
KinectMidBackV1.stl
KinectMidFrontV1.stl
