idolverse/Tulingjiuge_robot_1/零件组装教程+stl文件/A合并打印文件/头壳-额头.STL

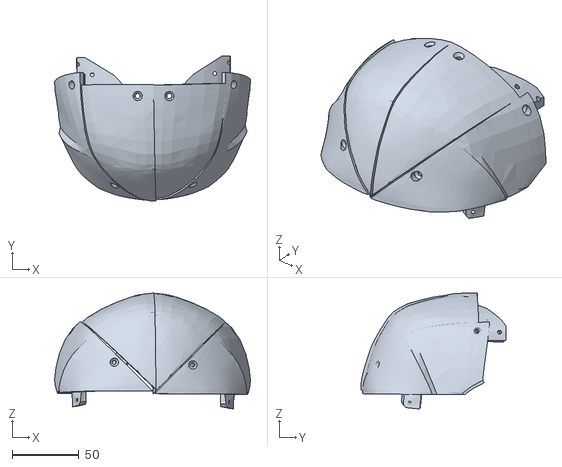
[picture p132: CAD file, 2025-06-10]
零件组装教程+stl文件/A合并打印文件/头壳-额头.STL
146.4 x 108.6 x 86.6
