idolverse/Tulingjiuge_robot_1/零件组装教程+stl文件/Back-main/背部STL/BackDoorLeftV3.stl

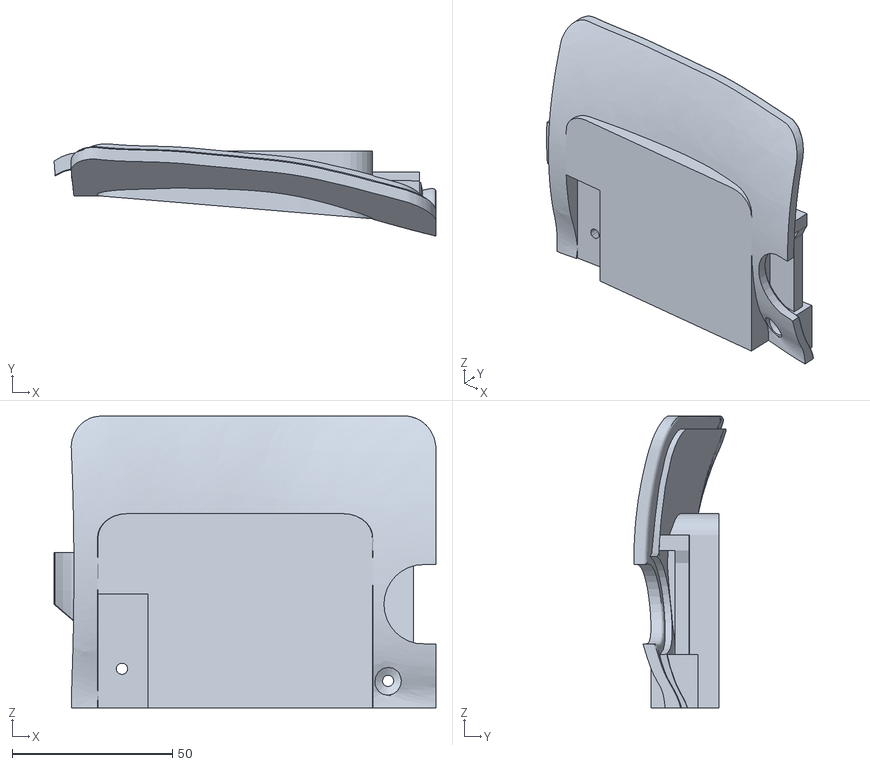
[picture p133: CAD file, 2025-05-29]
零件组装教程+stl文件/Back-main/背部STL/BackDoorLeftV3.stl
119.2 x 28.8 x 91.1
