idolverse/Tulingjiuge_robot_1/零件组装教程+stl文件/Bicep-main/二头肌STL/ReinforcerV2.stl

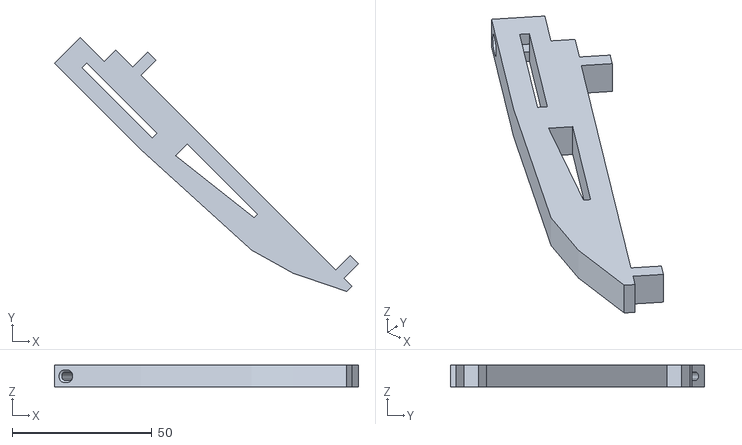
[picture p134: CAD file, 2025-05-29]
零件组装教程+stl文件/Bicep-main/二头肌STL/ReinforcerV2.stl
108.8 x 90.9 x 7.77
