idolverse/Tulingjiuge_robot_1/零件组装教程+stl文件/Eyes-i2-main/眼罩制作/眼罩STL/EyeHingeCurveV1.stl

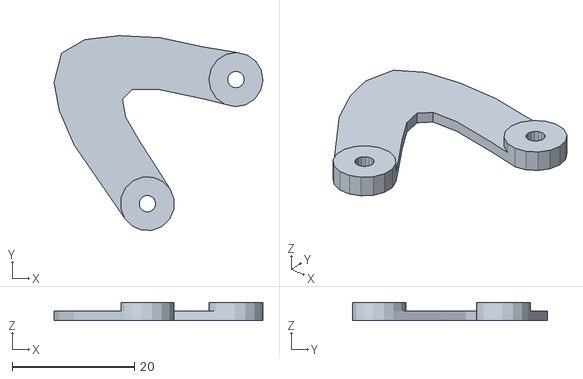
[picture p135: CAD file, 2025-05-29]
零件组装教程+stl文件/Eyes-i2-main/眼罩制作/眼罩STL/EyeHingeCurveV1.stl
34.1 x 31.8 x 2.99
