idolverse/Tulingjiuge_robot_1/零件组装教程+stl文件/Hand_i2-main/手部STL/右手/i2_CoverFingerV3.stl

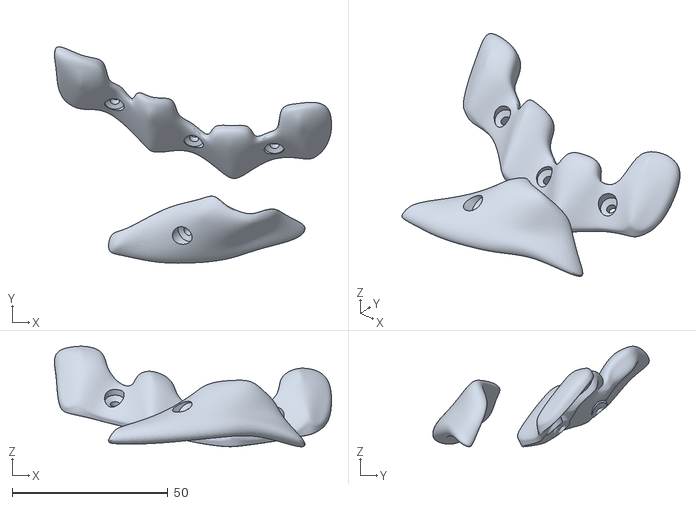
[picture p136: CAD file, 2025-05-29]
零件组装教程+stl文件/Hand_i2-main/手部STL/右手/i2_CoverFingerV3.stl
89.0 x 69.6 x 32.3
