idolverse/Tulingjiuge_robot_1/零件组装教程+stl文件/Head_i2-main/头部STL/FaceHolderLeftV5.stl

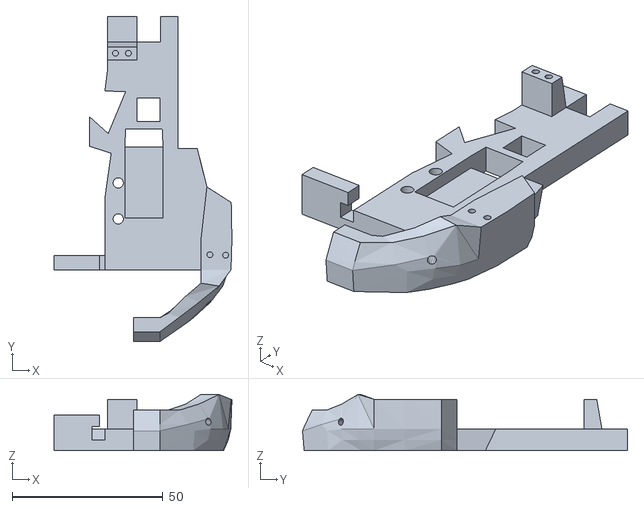
[picture p137: CAD file, 2025-05-29]
零件组装教程+stl文件/Head_i2-main/头部STL/FaceHolderLeftV5.stl
59.0 x 107.8 x 18.6
