idolverse/Tulingjiuge_robot_1/零件组装教程+stl文件/Leg-main/腿部STL/大腿STL/ThighMidLeftV1.stl

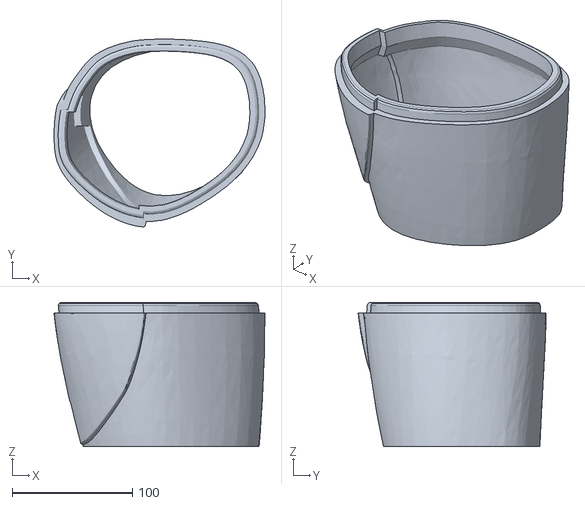
[picture p138: CAD file, 2025-05-29]
零件组装教程+stl文件/Leg-main/腿部STL/大腿STL/ThighMidLeftV1.stl
175.2 x 155.9 x 119.7
