idolverse/Tulingjiuge_robot_1/零件组装教程+stl文件/Leg-main/腿部STL/脚踝STL/LeftAnkHolderV1.stl

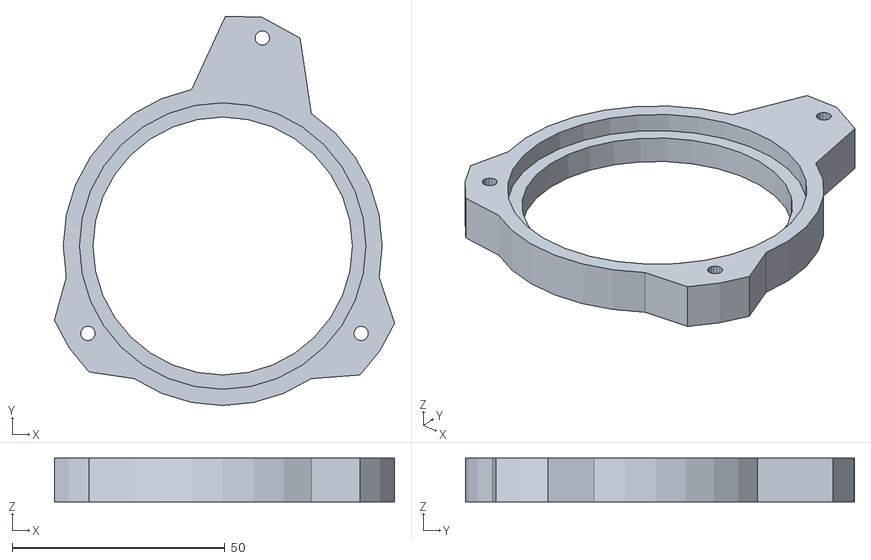
[picture p139: CAD file, 2025-05-29]
零件组装教程+stl文件/Leg-main/腿部STL/脚踝STL/LeftAnkHolderV1.stl
79.9 x 91.3 x 10.3
