idolverse/Tulingjiuge_robot_1/零件组装教程+stl文件/Leg-main/腿部STL/膝盖STL/KneeClampRightV1.stl

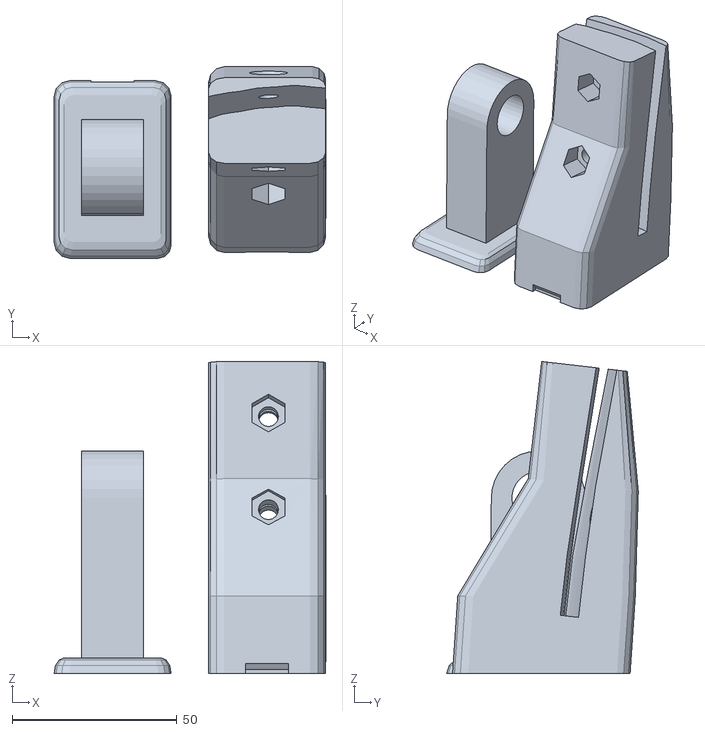
[picture p140: CAD file, 2025-05-29]
零件组装教程+stl文件/Leg-main/腿部STL/膝盖STL/KneeClampRightV1.stl
82.4 x 58.1 x 94.6
