idolverse/Tulingjiuge_robot_1/零件组装教程+stl文件/Mid_Stomach-main/中腹部STL/MidPotHolderV1.stl

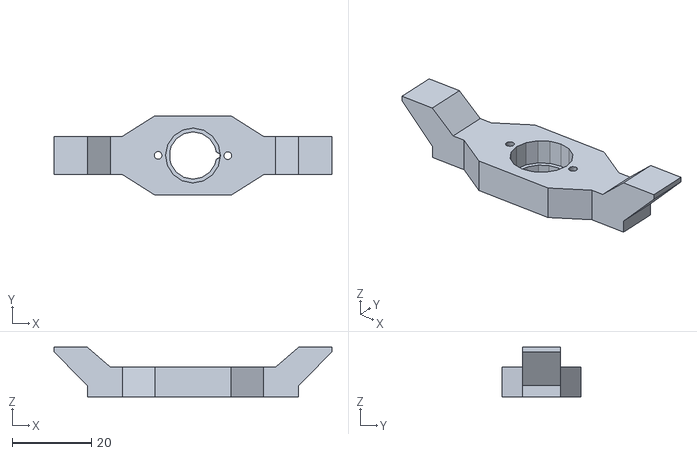
[picture p141: CAD file, 2025-05-29]
零件组装教程+stl文件/Mid_Stomach-main/中腹部STL/MidPotHolderV1.stl
70.3 x 20.1 x 12.5
