idolverse/Tulingjiuge_robot_1/零件组装教程+stl文件/Neck_and_jaw-main/颈部和下颌STL/脸部和下颌STL/JawPistonV1.stl

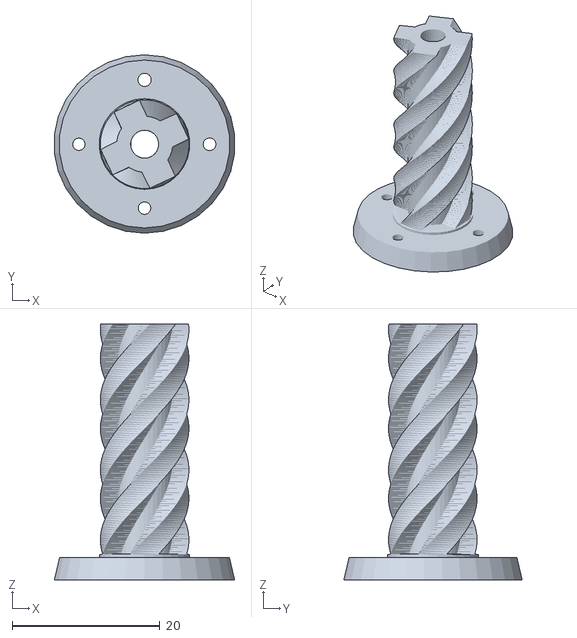
[picture p142: CAD file, 2025-05-29]
零件组装教程+stl文件/Neck_and_jaw-main/颈部和下颌STL/脸部和下颌STL/JawPistonV1.stl
24.4 x 24.1 x 34.6
