idolverse/Tulingjiuge_robot_1/零件组装教程+stl文件/Shoulder_torso-main/肩部和躯干STL/肩部STL/LogoLeftMyrobotlabV2.stl

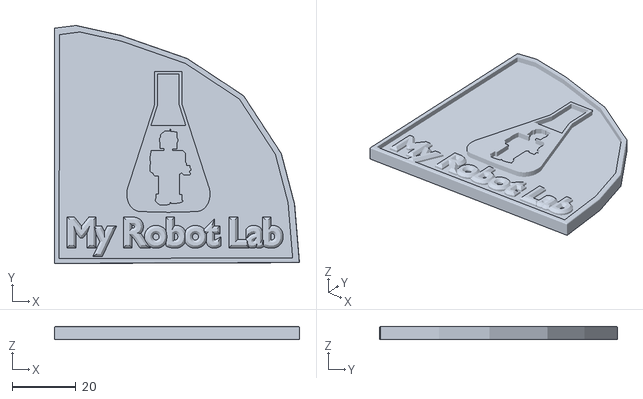
[picture p144: CAD file, 2025-05-29]
零件组装教程+stl文件/Shoulder_torso-main/肩部和躯干STL/肩部STL/LogoLeftMyrobotlabV2.stl
77.1 x 74.9 x 4.11
