idolverse/Tulingjiuge_robot_1/零件组装教程+stl文件/Top_Stomach-main/上腹部STL/DiskExternV2.stl

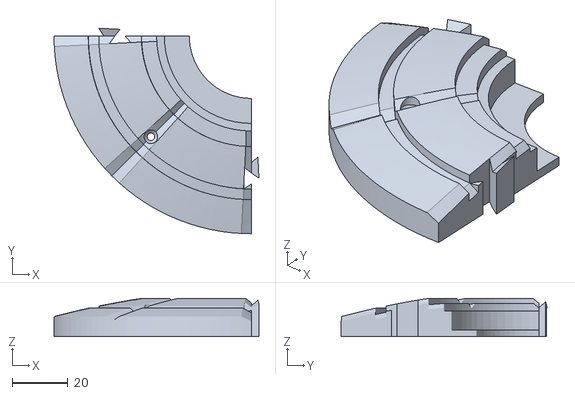
[picture p145: CAD file, 2025-05-29]
零件组装教程+stl文件/Top_Stomach-main/上腹部STL/DiskExternV2.stl
73.5 x 73.7 x 13.7
