idolverse/Tulingjiuge_robot_1/零件组装教程+stl文件/A合并打印文件/背部+腹部.STL

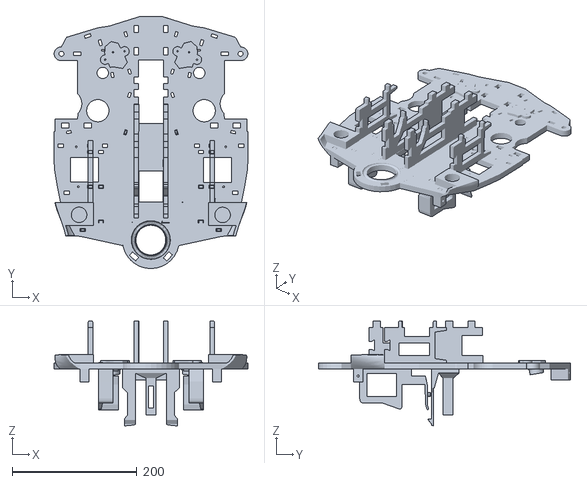
[picture p146: CAD file, 2025-06-10]
零件组装教程+stl文件/A合并打印文件/背部+腹部.STL
310.7 x 403.9 x 167.7
