idolverse/Tulingjiuge_robot_1/零件组装教程+stl文件/Back-main/背部STL/BackHolderCenterV1.stl

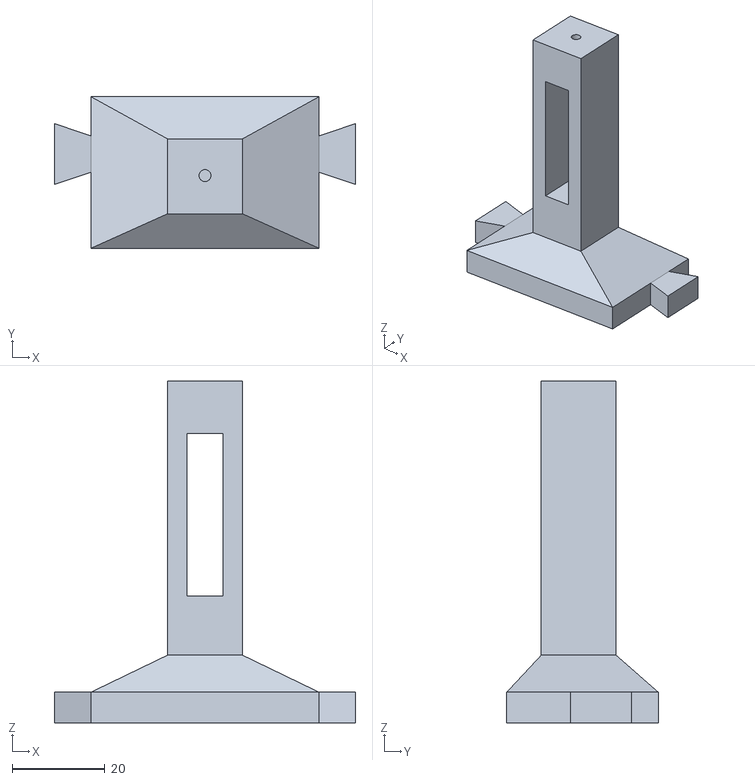
[picture p147: CAD file, 2025-05-29]
零件组装教程+stl文件/Back-main/背部STL/BackHolderCenterV1.stl
65.0 x 32.7 x 73.8
