idolverse/Tulingjiuge_robot_1/零件组装教程+stl文件/Bicep-main/二头肌STL/LeftRotcenterV3.stl

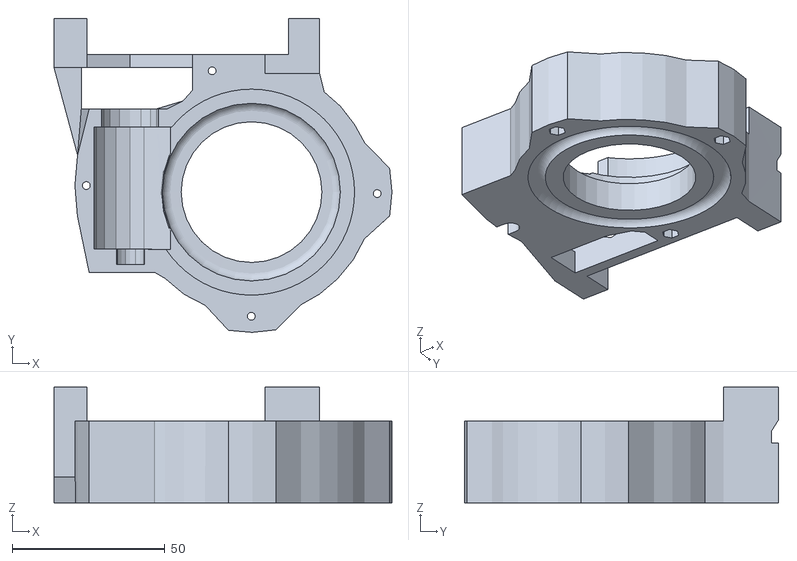
[picture p148: CAD file, 2025-05-29]
零件组装教程+stl文件/Bicep-main/二头肌STL/LeftRotcenterV3.stl
110.5 x 102.6 x 37.8
