idolverse/Tulingjiuge_robot_1/零件组装教程+stl文件/Hand_i2-main/手部STL/右手/i2_WristLargeV2.stl

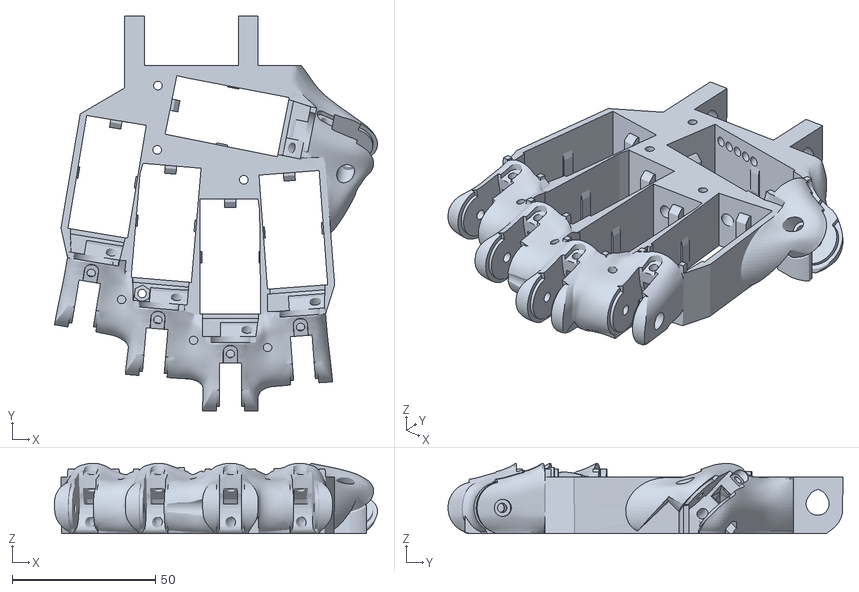
[picture p149: CAD file, 2025-05-29]
零件组装教程+stl文件/Hand_i2-main/手部STL/右手/i2_WristLargeV2.stl
112.6 x 137.7 x 24.5
