idolverse/Tulingjiuge_robot_1/零件组装教程+stl文件/Hand_i2-main/手部STL/左手/左手.3mf

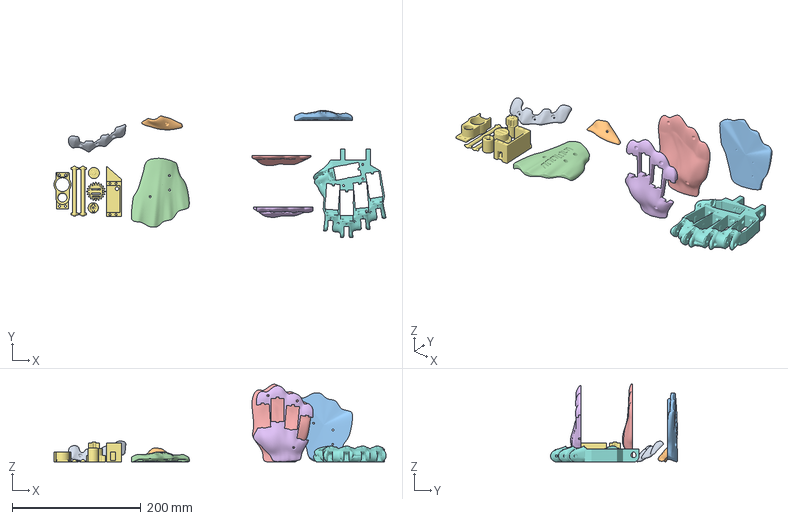
[picture p150: CAD file, 2025-05-29]
零件组装教程+stl文件/Hand_i2-main/手部STL/左手/左手.3mf
515.9 x 197.2 x 120.7 mm
i2_LeftCoverFingerV3.stl
i2_LeftCoverThumbV3.stl
i2_LeftHandCoverV1.stl
i2_LeftHandPDI6225V2.stl
i2_LeftPalmCoverV2.stl
i2_LeftPalmPDI6225V3.stl
i2_LeftWristGearV1.stl
i2_LeftWristLargeV2.stl
