idolverse/Tulingjiuge_robot_1/零件组装教程+stl文件/Head_i2-main/头部STL/EyebrowV3.stl

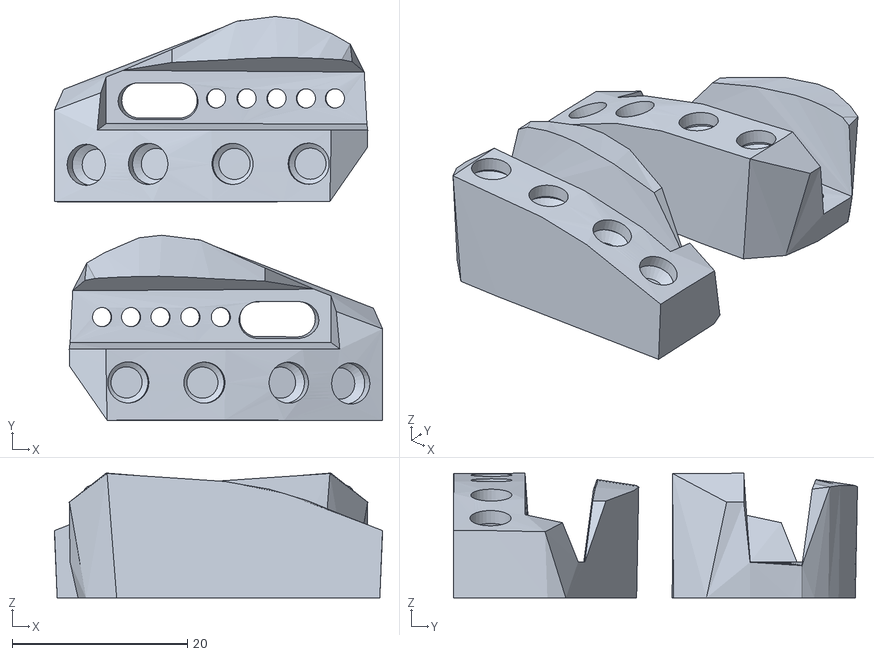
[picture p151: CAD file, 2025-05-29]
零件组装教程+stl文件/Head_i2-main/头部STL/EyebrowV3.stl
37.4 x 46.1 x 14.3
