idolverse/Tulingjiuge_robot_1/零件组装教程+stl文件/Leg-main/腿部STL/大腿STL/ThighHighLeftV1.stl

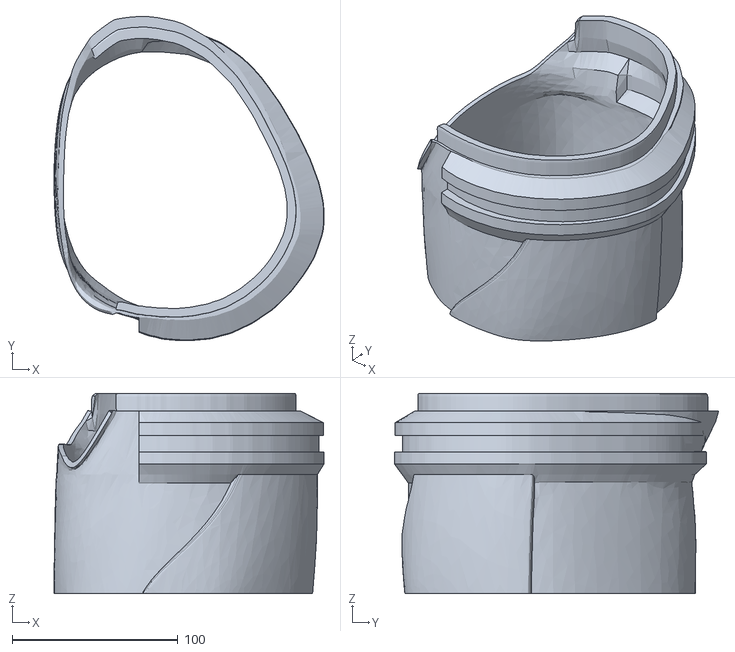
[picture p152: CAD file, 2025-05-29]
零件组装教程+stl文件/Leg-main/腿部STL/大腿STL/ThighHighLeftV1.stl
162.9 x 195.7 x 120.8
