idolverse/Tulingjiuge_robot_1/零件组装教程+stl文件/Leg-main/腿部STL/脚踝STL/AnkpartV1.stl

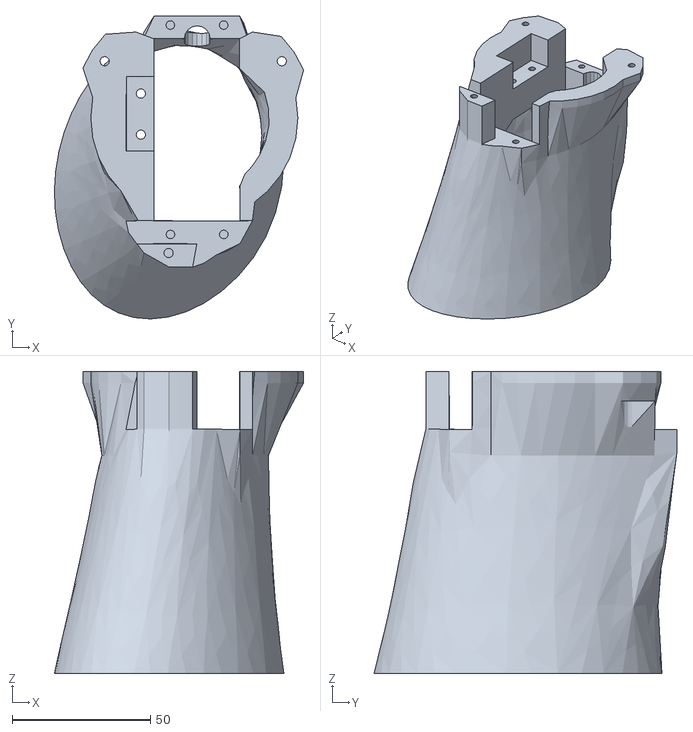
[picture p153: CAD file, 2025-05-29]
零件组装教程+stl文件/Leg-main/腿部STL/脚踝STL/AnkpartV1.stl
90.2 x 109.6 x 109.2
