idolverse/Tulingjiuge_robot_1/零件组装教程+stl文件/Mid_Stomach-main/中腹部STL/BotCapLeftV1.stl

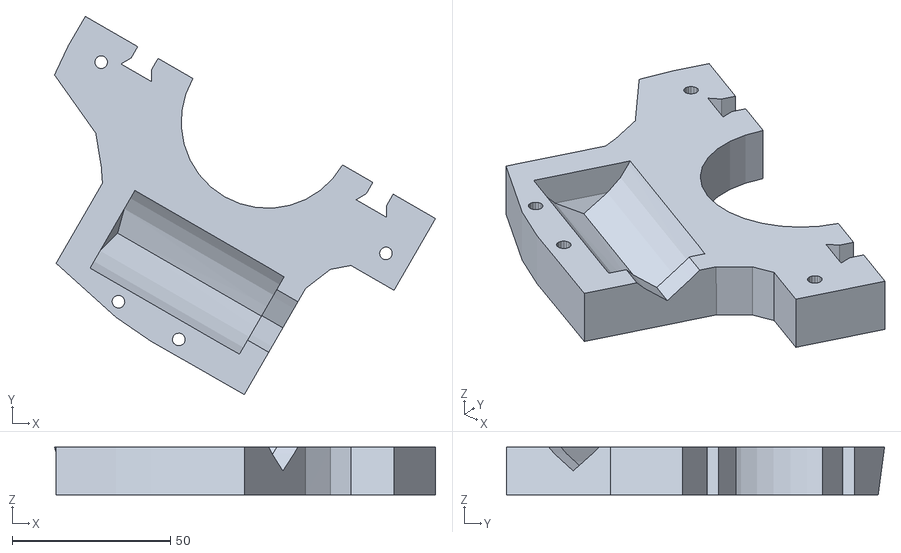
[picture p154: CAD file, 2025-05-29]
零件组装教程+stl文件/Mid_Stomach-main/中腹部STL/BotCapLeftV1.stl
120.3 x 119.4 x 15.1
