idolverse/Tulingjiuge_robot_1/零件组装教程+stl文件/Top_Stomach-main/上腹部STL/RollFrontLeftV1.stl

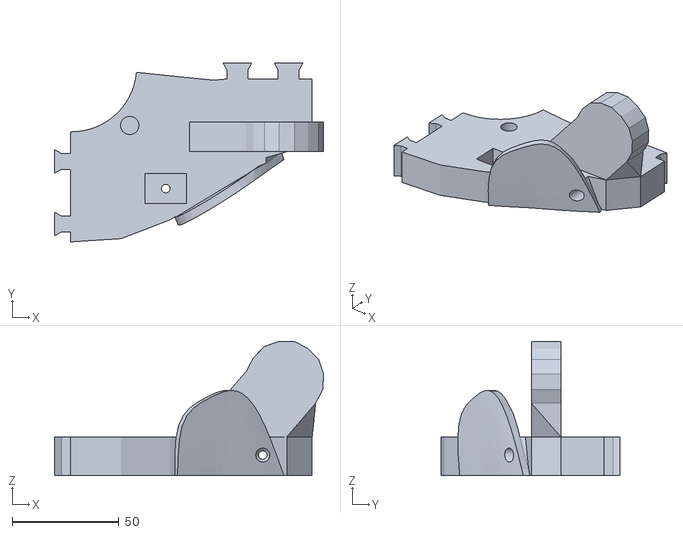
[picture p158: CAD file, 2025-05-29]
零件组装教程+stl文件/Top_Stomach-main/上腹部STL/RollFrontLeftV1.stl
125.9 x 83.7 x 62.9
