idolverse/Tulingjiuge_robot_1/零件组装教程+stl文件/A合并打印文件/背部.stl

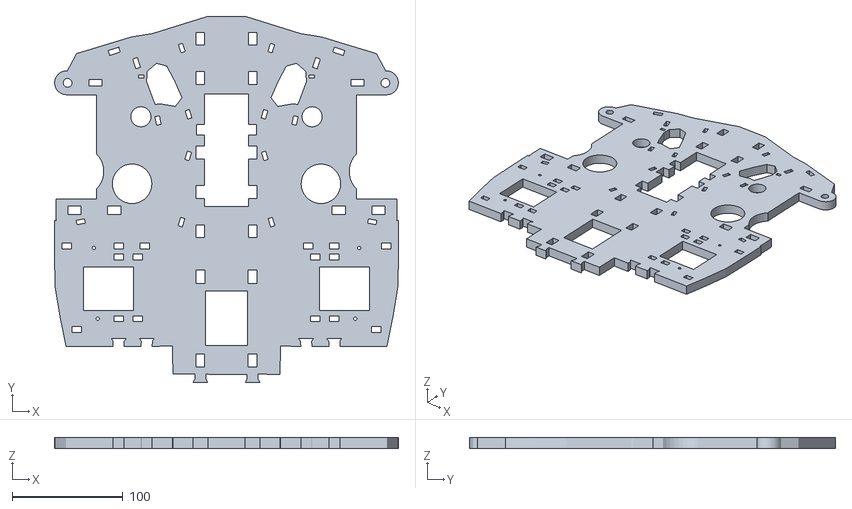
[picture p159: CAD file, 2025-06-08]
零件组装教程+stl文件/A合并打印文件/背部.stl
310.7 x 330.4 x 10.0
