idolverse/Tulingjiuge_robot_1/零件组装教程+stl文件/Back-main/背部STL/USBRotater.stl

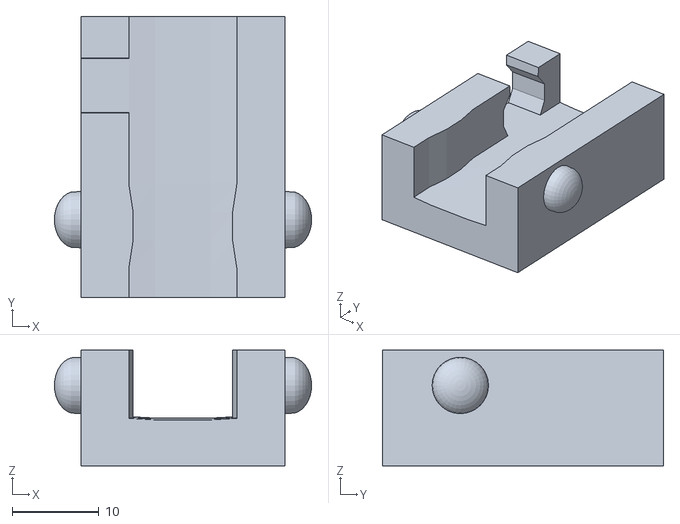
[picture p160: CAD file, 2025-05-29]
零件组装教程+stl文件/Back-main/背部STL/USBRotater.stl
29.7 x 32.4 x 13.4
