idolverse/Tulingjiuge_robot_1/零件组装教程+stl文件/Bicep-main/二头肌STL/RibonPusherV1.stl

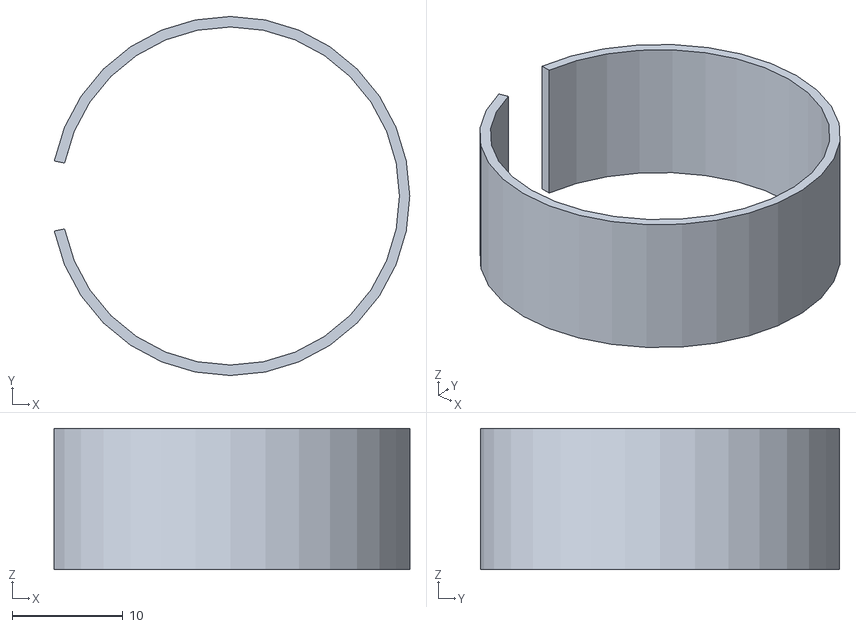
[picture p161: CAD file, 2025-05-29]
零件组装教程+stl文件/Bicep-main/二头肌STL/RibonPusherV1.stl
32.0 x 32.3 x 12.7
