idolverse/Tulingjiuge_robot_1/零件组装教程+stl文件/Eyes-i2-main/眼罩制作/眼罩STL/EyeSupportV5.stl

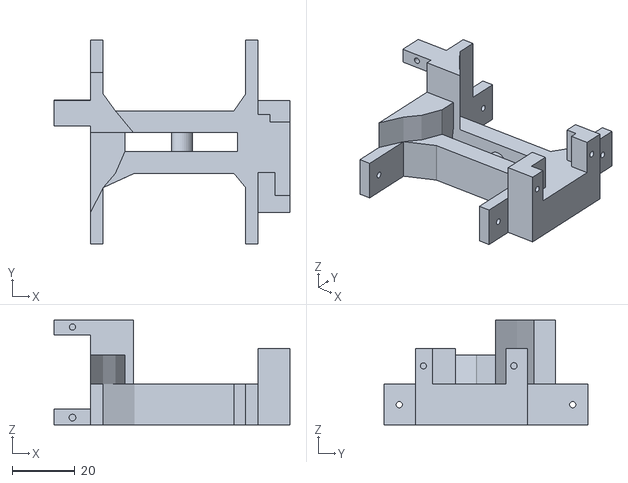
[picture p162: CAD file, 2025-05-29]
零件组装教程+stl文件/Eyes-i2-main/眼罩制作/眼罩STL/EyeSupportV5.stl
75.1 x 65.0 x 33.3
