idolverse/Tulingjiuge_robot_1/零件组装教程+stl文件/Hand_i2-main/手部STL/右手/i2_Adapter1109MG.stl

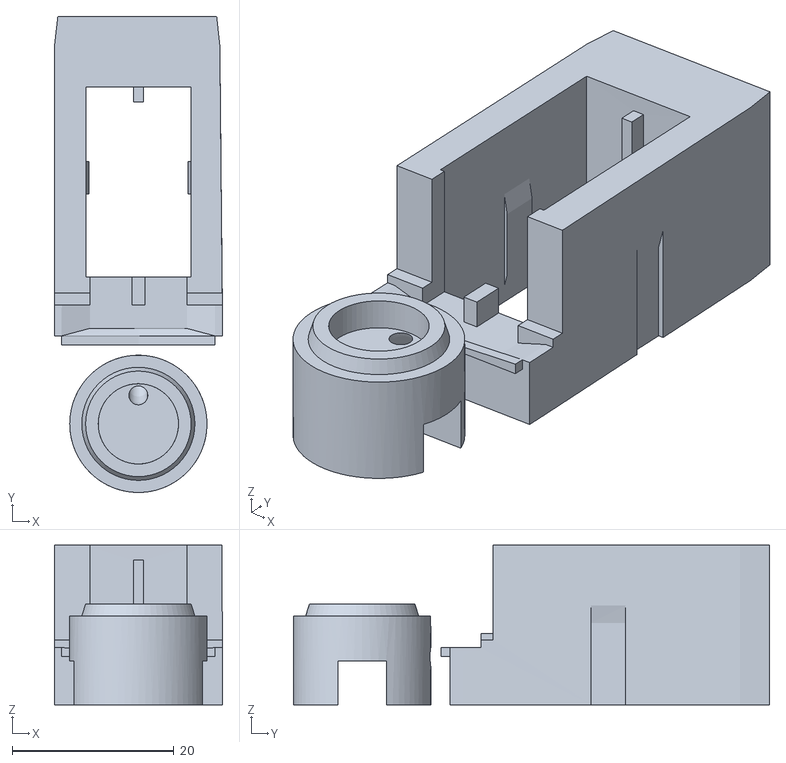
[picture p163: CAD file, 2025-05-29]
零件组装教程+stl文件/Hand_i2-main/手部STL/右手/i2_Adapter1109MG.stl
20.8 x 58.9 x 19.8
