idolverse/Tulingjiuge_robot_1/零件组装教程+stl文件/Head_i2-main/头部STL/EyebrowSupportV3.stl

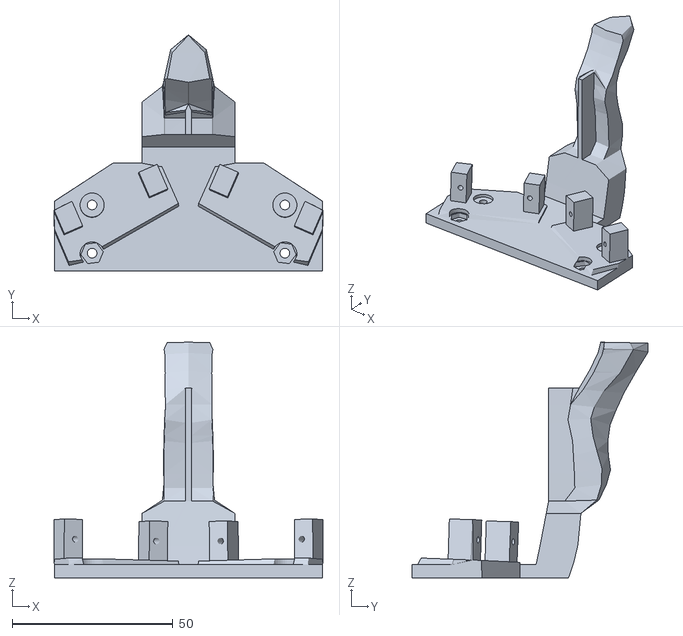
[picture p164: CAD file, 2025-05-29]
零件组装教程+stl文件/Head_i2-main/头部STL/EyebrowSupportV3.stl
83.7 x 73.6 x 73.4
