idolverse/Tulingjiuge_robot_1/零件组装教程+stl文件/Leg-main/腿部STL/大腿STL/LegHolderLeft.stl

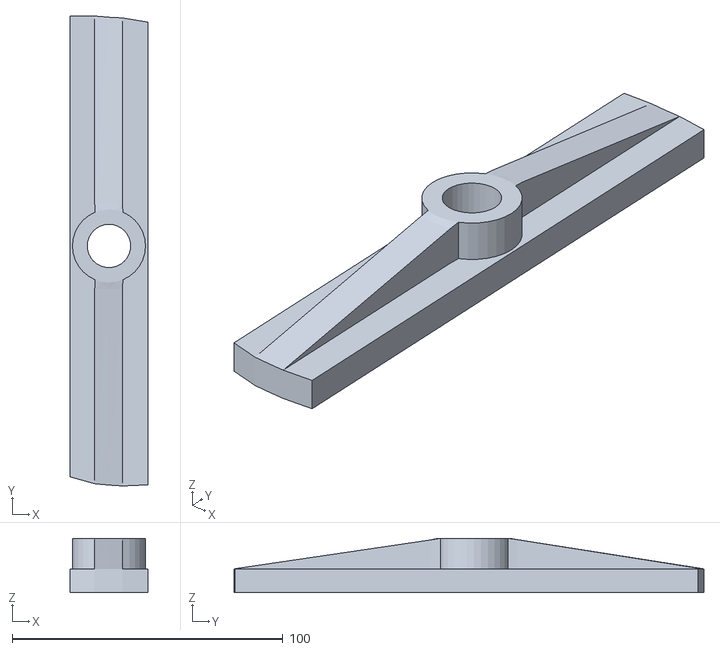
[picture p165: CAD file, 2025-05-29]
零件组装教程+stl文件/Leg-main/腿部STL/大腿STL/LegHolderLeft.stl
29.0 x 173.7 x 20.1
