idolverse/Tulingjiuge_robot_1/零件组装教程+stl文件/Leg-main/腿部STL/膝盖STL/膝盖.3mf

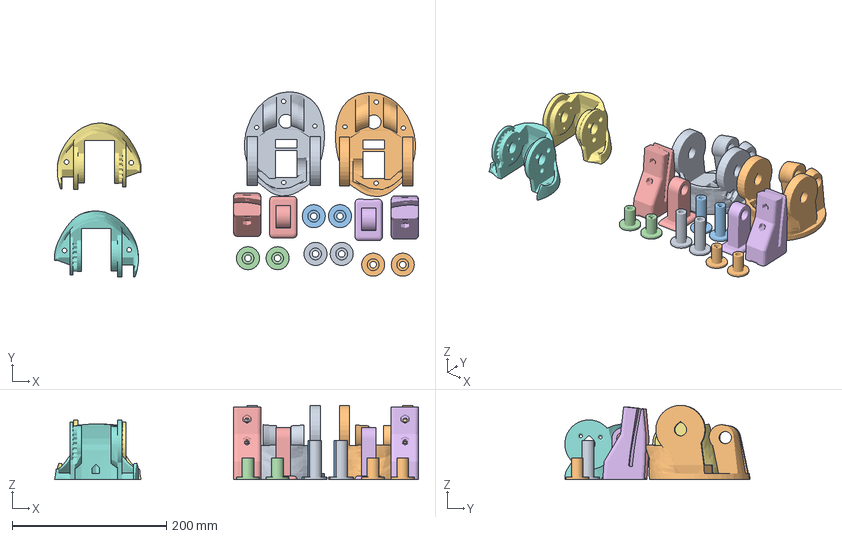
[picture p166: CAD file, 2025-05-29]
零件组装教程+stl文件/Leg-main/腿部STL/膝盖STL/膝盖.3mf
472.5 x 240.5 x 96.5 mm
KneeBoltsV1.stl x 2
KneeSmallBoltsV1.stl x 2
KneeClampLeftV1.stl
KneeClampRightV1.stl
KneeHighLeftV3.stl
KneeHighRightV3.stl
KneeLowLeftV3.stl
KneeLowRightV3.stl
