idolverse/Tulingjiuge_robot_1/零件组装教程+stl文件/Mid_Stomach-main/中腹部STL/BotBackLeftV1.stl

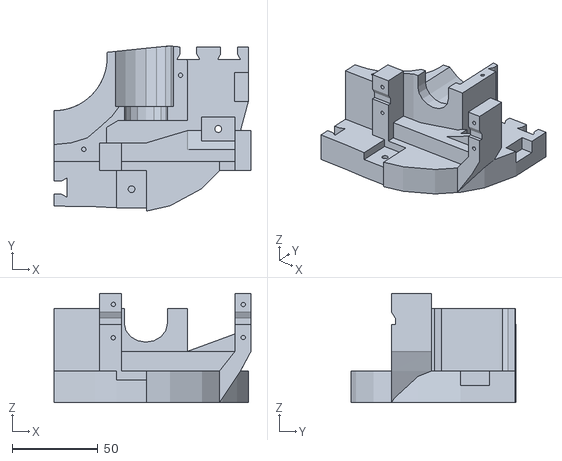
[picture p167: CAD file, 2025-05-29]
零件组装教程+stl文件/Mid_Stomach-main/中腹部STL/BotBackLeftV1.stl
114.6 x 96.1 x 63.5
