idolverse/Tulingjiuge_robot_1/零件组装教程+stl文件/Neck_and_jaw-main/颈部和下颌STL/颈部STL/NeckServoHolderV2.stl

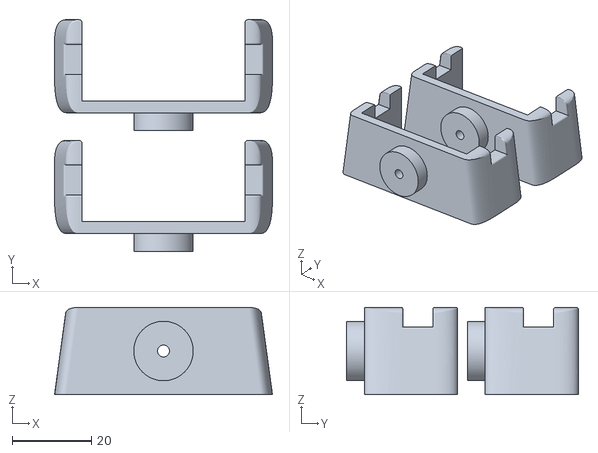
[picture p168: CAD file, 2025-05-29]
零件组装教程+stl文件/Neck_and_jaw-main/颈部和下颌STL/颈部STL/NeckServoHolderV2.stl
55.0 x 58.5 x 22.0
