idolverse/Tulingjiuge_robot_1/零件组装教程+stl文件/Shoulder_torso-main/肩部和躯干STL/躯干STL/KinectMidFrontV1.stl

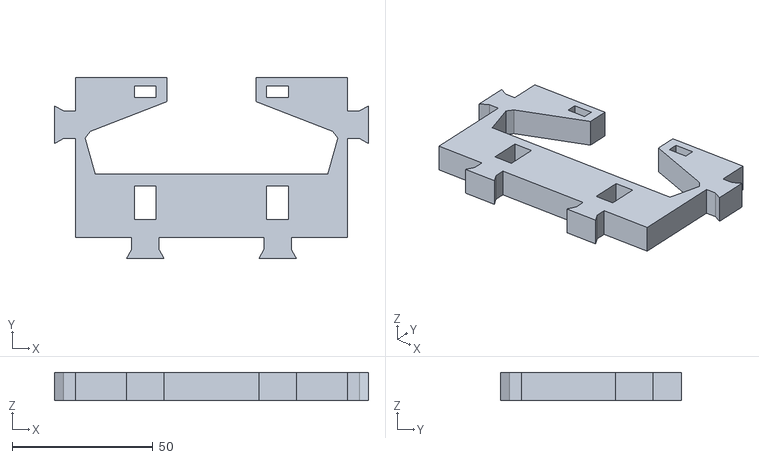
[picture p170: CAD file, 2025-05-29]
零件组装教程+stl文件/Shoulder_torso-main/肩部和躯干STL/躯干STL/KinectMidFrontV1.stl
111.7 x 64.5 x 10.0
