idolverse/Tulingjiuge_robot_1/零件组装教程+stl文件/Top_Stomach-main/上腹部STL/RollBackLeftV1.stl

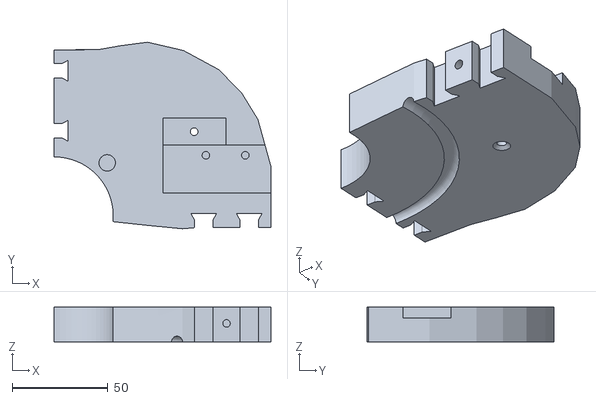
[picture p171: CAD file, 2025-05-29]
零件组装教程+stl文件/Top_Stomach-main/上腹部STL/RollBackLeftV1.stl
113.2 x 97.3 x 18.2
