idolverse/Tulingjiuge_robot_1/零件组装教程+stl文件/A合并打印文件/胸前板.STL

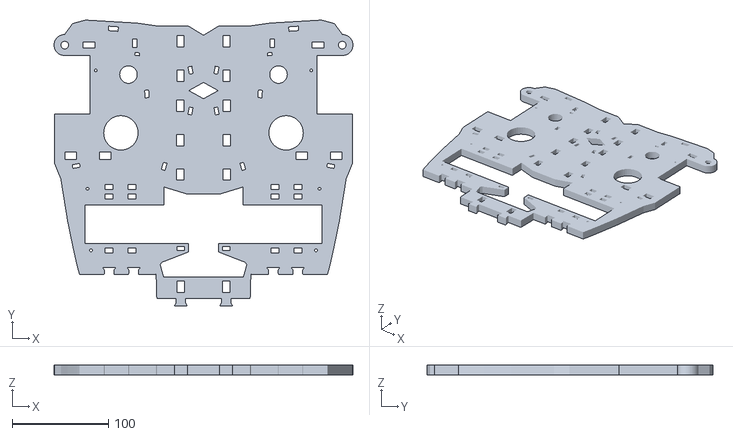
[picture p172: CAD file, 2025-06-05]
零件组装教程+stl文件/A合并打印文件/胸前板.STL
310.0 x 296.4 x 10.0
