idolverse/Tulingjiuge_robot_1/(list of files, cad)

Other CAD files:
零件组装教程+stl文件/Eyes-i2-main/眼罩制作/眼罩STL/EyePlateLeftV1.stl
零件组装教程+stl文件/Leg-main/腿部STL/膝盖STL/KneeLowLeftV3.stl
零件组装教程+stl文件/Leg-main/腿部STL/胫骨STL/TibiaLowS1LeftV1.stl
零件组装教程+stl文件/Shoulder_torso-main/肩部和躯干STL/肩部STL/PivTitV3.stl
零件组装教程+stl文件/Eyes-i2-main/眼睛STL/Eye-L-BaseV5.stl
零件组装教程+stl文件/Hand_i2-main/手部STL/左手/i2_LeftPalmCoverV2.stl
零件组装教程+stl文件/Leg-main/腿部STL/脚踝STL/AnkToesFootV2.stl
零件组装教程+stl文件/Mid_Stomach-main/中腹部STL/HipCoverLeftV1.stl
零件组装教程+stl文件/Eyes-i2-main/眼睛STL/Eye-R-AllPartsV2.stl
零件组装教程+stl文件/Hand_i2-main/手部STL/左手/i2_LeftPalmPDI6225V3.stl
零件组装教程+stl文件/Leg-main/腿部STL/大腿STL/ThighHighBlokerLV1.stl
零件组装教程+stl文件/Low_stomach-main/下腹部STL/TStoLowLeftV1.stl
零件组装教程+stl文件/Top_Stomach-main/上腹部STL/TStoFrontRightV1.stl
零件组装教程+stl文件/Hand_i2-main/手部STL/左手/i2_LeftHandPDI6225V2.stl
零件组装教程+stl文件/Leg-main/腿部STL/胫骨STL/TibiaLowS2RightV1.stl
零件组装教程+stl文件/Eyes-i2-main/眼罩制作/眼罩STL/EyeBallSupportLifeCamHDRightV1.stl
零件组装教程+stl文件/Leg-main/腿部STL/胫骨STL/TibiaHighLeftV1.stl
零件组装教程+stl文件/Leg-main/腿部STL/膝盖STL/KneeHighRightV3.stl
零件组装教程+stl文件/Leg-main/腿部STL/脚踝STL/AnkHolderV1.stl
零件组装教程+stl文件/A合并打印文件/上上腹部1.STL
零件组装教程+stl文件/A合并打印文件/上上腹部2.STL
零件组装教程+stl文件/A合并打印文件/下腹部.STL
零件组装教程+stl文件/A合并打印文件/中腹部.STL
零件组装教程+stl文件/A合并打印文件/右肩膀-修改后.STL
零件组装教程+stl文件/A合并打印文件/头壳.STL
零件组装教程+stl文件/A合并打印文件/左肩膀-修改后.STL
零件组装教程+stl文件/A合并打印文件/胸部装饰.STL
零件组装教程+stl文件/A合并打印文件/腹部装饰.STL
零件组装教程+stl文件/Back-main/背部STL/BackClaviHolderV2.stl
零件组装教程+stl文件/Back-main/背部STL/BackCoverBottomMidV2.stl
零件组装教程+stl文件/Back-main/背部STL/BackCoverBottomRightV2.stl
零件组装教程+stl文件/Back-main/背部STL/BackCoverLowLeftV1.stl
零件组装教程+stl文件/Back-main/背部STL/BackCoverLowRightV1.stl
零件组装教程+stl文件/Back-main/背部STL/BackCoverTopLeftV3.stl
零件组装教程+stl文件/Back-main/背部STL/BackCoverTopMid.V2.stl
零件组装教程+stl文件/Back-main/背部STL/BackCoverTopRightV3.stl
零件组装教程+stl文件/Back-main/背部STL/BackDoorRightV3.stl
零件组装教程+stl文件/Back-main/背部STL/BackHipsLeftV2.stl
零件组装教程+stl文件/Back-main/背部STL/BackHipsMidV2.stl
零件组装教程+stl文件/Back-main/背部STL/BackHipsRightV2.stl
零件组装教程+stl文件/Back-main/背部STL/BackHolderCenterLeftV1.stl
零件组装教程+stl文件/Back-main/背部STL/BackHolderCenterRightV1.stl
零件组装教程+stl文件/Back-main/背部STL/BackHolderLowLeftV1.stl
零件组装教程+stl文件/Back-main/背部STL/BackPowerV1.stl
零件组装教程+stl文件/Back-main/背部STL/BackSideHolderRightV1.stl
零件组装教程+stl文件/Back-main/背部STL/BatteryHolderLeftV5.stl
零件组装教程+stl文件/Back-main/背部STL/BatteryHolderRightV5.stl
零件组装教程+stl文件/Back-main/背部STL/USBCliker.stl
零件组装教程+stl文件/Back-main/背部STL/背部.3mf
零件组装教程+stl文件/Bicep-main/二头肌STL/GearHolderV1.stl
零件组装教程+stl文件/Bicep-main/二头肌STL/HighArmSideV3.stl
零件组装教程+stl文件/Bicep-main/二头肌STL/LeftRotTitV4.stl
零件组装教程+stl文件/Bicep-main/二头肌STL/LowArmSideV3.stl
零件组装教程+stl文件/Bicep-main/二头肌STL/PistonanticlockV2.stl
零件组装教程+stl文件/Bicep-main/二头肌STL/PistonbaseantiV2.stl
零件组装教程+stl文件/Bicep-main/二头肌STL/PivPotentioRoundV3.stl
零件组装教程+stl文件/Bicep-main/二头肌STL/PivPotentioSquareV3.stl
零件组装教程+stl文件/Bicep-main/二头肌STL/RotGearV6.stl
零件组装教程+stl文件/Bicep-main/二头肌STL/RotMitV3.stl
零件组装教程+stl文件/Bicep-main/二头肌STL/RotTitV4.stl
零件组装教程+stl文件/Bicep-main/二头肌STL/RotcenterV3.stl
零件组装教程+stl文件/Bicep-main/二头肌STL/armtopcover1.stl
零件组装教程+stl文件/Bicep-main/二头肌STL/armtopcover3.stl
零件组装教程+stl文件/Bicep-main/二头肌STL/elbowshaftgearV1.stl
零件组装教程+stl文件/Bicep-main/二头肌STL/gearpotentioV1.stl
零件组装教程+stl文件/Bicep-main/二头肌STL/servoholderV1.stl
零件组装教程+stl文件/Bicep-main/二头肌STL/左二头肌.3mf
零件组装教程+stl文件/Eyes-i2-main/眼罩制作/眼罩STL/EyeHingeV2.stl
零件组装教程+stl文件/Eyes-i2-main/眼罩制作/眼罩STL/EyeHolderV1.stl
零件组装教程+stl文件/Eyes-i2-main/眼罩制作/眼罩STL/EyeTo NoseV5.stl
零件组装教程+stl文件/Hand_i2-main/手部STL/右手/i2_FingersTipX5V2.stl
零件组装教程+stl文件/Hand_i2-main/手部STL/右手/i2_FingersX5V2.stl
零件组装教程+stl文件/Hand_i2-main/手部STL/右手/i2_HandCoverV1.stl
零件组装教程+stl文件/Hand_i2-main/手部STL/右手/i2_WristGearV1.stl
零件组装教程+stl文件/Hand_i2-main/手部STL/左手/i2_LeftCoverFingerV3.stl
零件组装教程+stl文件/Hand_i2-main/手部STL/左手/i2_LeftWristLargeV2.stl
零件组装教程+stl文件/Head_i2-main/头部STL/CheekPullerV3.stl
零件组装教程+stl文件/Head_i2-main/头部STL/EarLockV1.stl
零件组装教程+stl文件/Head_i2-main/头部STL/FaceHolderRightV5.stl
零件组装教程+stl文件/Head_i2-main/头部STL/ForHeadSupportV2.stl
零件组装教程+stl文件/Head_i2-main/头部STL/ForHeadsV4.stl
零件组装教程+stl文件/Head_i2-main/头部STL/GearHolderV3.stl
零件组装教程+stl文件/Head_i2-main/头部STL/InnerMiddleMoldV1.stl
零件组装教程+stl文件/Head_i2-main/头部STL/InnerSidesMoldV1.stl
零件组装教程+stl文件/Head_i2-main/头部STL/JawPistonV1NoSupport.stl
零件组装教程+stl文件/Head_i2-main/头部STL/JawSupportV2.stl
零件组装教程+stl文件/Head_i2-main/头部STL/OuterTopMoldFemaleV1.stl
零件组装教程+stl文件/Head_i2-main/头部STL/OuterTopMoldMaleV1.stl
零件组装教程+stl文件/Head_i2-main/头部STL/PCA9685ConnectV2.stl
零件组装教程+stl文件/Head_i2-main/头部STL/PCA9685supportV1.stl
零件组装教程+stl文件/Head_i2-main/头部STL/RingV2.stl
零件组装教程+stl文件/Head_i2-main/头部STL/ServoGearV2.stl
零件组装教程+stl文件/Head_i2-main/头部STL/SkullServoFixV5.stl
零件组装教程+stl文件/Head_i2-main/头部STL/TeethTopHolderV3.stl
零件组装教程+stl文件/Head_i2-main/头部STL/TopskullV5.stl
零件组装教程+stl文件/Head_i2-main/头部STL/servoAdapterV1.stl
零件组装教程+stl文件/Head_i2-main/头部STL/servoHornAdapterV1.stl
零件组装教程+stl文件/Leg-main/腿部STL/大腿STL/LegFixerLeftV1.stl
零件组装教程+stl文件/Leg-main/腿部STL/大腿STL/LegHolderRight.stl
零件组装教程+stl文件/Leg-main/腿部STL/大腿STL/ThighBoltBlokerLV1.stl
零件组装教程+stl文件/Leg-main/腿部STL/大腿STL/ThighBoltBlokerRV1.stl
零件组装教程+stl文件/Leg-main/腿部STL/大腿STL/ThighHighRightV1.stl
零件组装教程+stl文件/Leg-main/腿部STL/大腿STL/ThighHighTempV1.stl
零件组装教程+stl文件/Leg-main/腿部STL/大腿STL/ThighLowLeftV3.stl
零件组装教程+stl文件/Leg-main/腿部STL/大腿STL/ThighLowRightV3.stl
零件组装教程+stl文件/Leg-main/腿部STL/大腿STL/ThighMidRightV1.stl
零件组装教程+stl文件/Leg-main/腿部STL/大腿STL/ThighSideAccessRightV1.stl
零件组装教程+stl文件/Leg-main/腿部STL/大腿STL/大腿.3mf
零件组装教程+stl文件/Leg-main/腿部STL/脚踝STL/AnkBackFootV1.stl
零件组装教程+stl文件/Leg-main/腿部STL/脚踝STL/AnkMidleFootV1.stl
零件组装教程+stl文件/Leg-main/腿部STL/脚踝STL/AnkToesBoltV1.stl
零件组装教程+stl文件/Leg-main/腿部STL/脚踝STL/AnkleBaseV1.stl
零件组装教程+stl文件/Leg-main/腿部STL/脚踝STL/FootBoltHolder.stl
零件组装教程+stl文件/Leg-main/腿部STL/脚踝STL/LeftAnkMidleFootV1.stl
零件组装教程+stl文件/Leg-main/腿部STL/脚踝STL/LeftAnkpartV1.stl
零件组装教程+stl文件/Leg-main/腿部STL/脚踝STL/leftAnkleBaseV1.stl
零件组装教程+stl文件/Leg-main/腿部STL/脚踝STL/脚踝.3mf
零件组装教程+stl文件/Leg-main/腿部STL/膝盖STL/KneeBoltsV1.stl
零件组装教程+stl文件/Leg-main/腿部STL/膝盖STL/KneeClampLeftV1.stl
零件组装教程+stl文件/Leg-main/腿部STL/膝盖STL/KneeSmallBoltsV1.stl
零件组装教程+stl文件/Mid_Stomach-main/中腹部STL/BotBackRigtV1.stl
零件组装教程+stl文件/Mid_Stomach-main/中腹部STL/BotFrontLeftV1.stl
零件组装教程+stl文件/Mid_Stomach-main/中腹部STL/HipCoverFrontV1.stl
零件组装教程+stl文件/Mid_Stomach-main/中腹部STL/MidPotHolderSquareV1.stl
零件组装教程+stl文件/Mid_Stomach-main/中腹部STL/中腹部.3mf
零件组装教程+stl文件/Neck_and_jaw-main/颈部和下颌STL/脸部和下颌STL/JawHingeV1.stl
零件组装教程+stl文件/Neck_and_jaw-main/颈部和下颌STL/颈部STL/NeckBoltsV2.stl
零件组装教程+stl文件/Neck_and_jaw-main/颈部和下颌STL/颈部STL/NeckJointLowerV5.stl
零件组装教程+stl文件/Neck_and_jaw-main/颈部和下颌STL/颈部STL/NeckPistonBaseFrontV1.stl
零件组装教程+stl文件/Neck_and_jaw-main/颈部和下颌STL/颈部STL/NeckPistonFrontV2.stl
零件组装教程+stl文件/Neck_and_jaw-main/颈部和下颌STL/颈部STL/NeckPistonSideV1.stl
零件组装教程+stl文件/Neck_and_jaw-main/颈部和下颌STL/颈部STL/NeckPlateHighV2.stl
零件组装教程+stl文件/Neck_and_jaw-main/颈部和下颌STL/颈部STL/NeckServoPivotV2.stl
零件组装教程+stl文件/Neck_and_jaw-main/颈部和下颌STL/颈部STL/PistonBaseSideV2.stl
零件组装教程+stl文件/Neck_and_jaw-main/颈部和下颌STL/颈部STL/RingV2.stl
零件组装教程+stl文件/Neck_and_jaw-main/颈部和下颌STL/颈部STL/ServoGearV2.stl
零件组装教程+stl文件/Neck_and_jaw-main/颈部和下颌STL/颈部STL/SkullServoFixV1.stl
零件组装教程+stl文件/Neck_and_jaw-main/颈部和下颌STL/颈部STL/ThroatHoleV3.stl
零件组装教程+stl文件/Shoulder_torso-main/肩部和躯干STL/肩部STL/ClaviBackV2.stl
零件组装教程+stl文件/Shoulder_torso-main/肩部和躯干STL/肩部STL/ClaviFrontV2.stl
零件组装教程+stl文件/Shoulder_torso-main/肩部和躯干STL/肩部STL/LeftPivMitV2.stl
零件组装教程+stl文件/Shoulder_torso-main/肩部和躯干STL/肩部STL/LeftPivPotholderSquareV1.stl
零件组装教程+stl文件/Shoulder_torso-main/肩部和躯干STL/肩部STL/LeftPivPotholderV3.stl
零件组装教程+stl文件/Shoulder_torso-main/肩部和躯干STL/肩部STL/LeftPivcenterV3.stl
零件组装教程+stl文件/Shoulder_torso-main/肩部和躯干STL/肩部STL/LogoRightMyrobotlabV2.stl
零件组装教程+stl文件/Shoulder_torso-main/肩部和躯干STL/肩部STL/PistonClaviV3.stl
零件组装教程+stl文件/Shoulder_torso-main/肩部和躯干STL/肩部STL/PistonbaseV6.stl
零件组装教程+stl文件/Shoulder_torso-main/肩部和躯干STL/肩部STL/PivConnectorV1.stl
零件组装教程+stl文件/Shoulder_torso-main/肩部和躯干STL/肩部STL/PivMitV2.stl
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
