idolverse/Tulingjiuge_robot_1/零件组装教程+stl文件/Leg-main/Readme.md

<h1>腿部组装教程</h1>

在本教程中，我将向您展示如何组装非电动版本的腿部部件。如果您的打印件打印正确且没有翘曲，组装起来会相当容易。否则，您将很难将所有部件组装在一起。

请注意，其中一些部件非常大，超过了标准 12x12x12 厘米。

非电动腿包含两个非常大的部件，尺寸如下：

-ThighHighRightV1：长16.5 X 宽19.6 X 高12cm

-ThighHighTempV1：长19.7 X 宽12.7 X 高13cm

其中一些部件在 3D 打印期间需要支撑，因此请查看下面的列表。

从图库下载 STL

在打印所有部件之前，您应该打印一份校准器 (CALIBRATOR)，以检查部件是否能够拼合。如果您在拼合这些部件时遇到困难，可以调整切片软件的水平扩展设置来解决这个问题。此设置可能因切片机和打印机而异，但用户报告称，将其设置为 -0.15 是一个不错的起点。

填充率为 30%，壁厚为 2.5 毫米，最好无筏，无支撑（除非另有说明），使用边缘以避免翘曲。

以下是腿部所需的零件清单和打印数量：

**脚踝**

1x AnkBackFoot

1x AnkHolder

1x AnkMidleFoot (添加支撑)

2x AnkToesBolt

1x AnkToesFoot

1x AnkleBase

1x AnkleDown (添加支撑)

1x AnkpartV1

2x FootBoltHolder

1x LeftAnkBackFoot

1x LeftAnkHolder

1x LeftAnkMidleFoot (添加支撑)

1x LeftAnkToesFoot

1x LeftAnkleDown (添加支撑)

1x LeftAnkpart

1x leftAnkleBase

**胫骨：**

1x TibiaHighLeft

1x TibiaHighRight

1x TibiaLowS1Left

1x TibiaLowS1Right

1x TibiaLowS2Left

1x TibiaLowS2Right

**膝盖：**

2x KneeBolts

2x KneeSmallBolts

1x KneeClampLeft

1x KneeClampRight

1x KneeHighLeft

1x KneeHighRight

1x KneeLowLeft

1x KneeLowRight

**大腿：**

1x LegFixerLeft

1x LegFixer

1x LegHolderLeft

1x LegHolderRight

1x ThighBoltBlokerL

1x ThighBoltBlokerR

1x ThighHighBlokerL

1x ThighHighBlokerR

1x ThighHighLeft

1x ThighHighRight

1x ThighHighTempLeft

1x ThighHighTemp

1x ThighLowLeft

1x ThighLowRight

1x ThighMidLeft

1x ThighMidRight

1x ThighSideAccessLeft

1x ThighSideAccessRight

<h2>步骤：</h2>

非电动腿主要用于展示。它们可以让机器人依靠自己的腿站立。机器人将用螺栓固定在一个60x60厘米的大板上，以确保其稳定性。

一根 10 毫米的杆将从底板延伸到腿的顶部。

IMG_2331-1024x768

Leg_3

Leg_2

Leg_1

Leg_4

Leg3-e1611248496918

Leg2-e1611248912844
