idolverse/Tulingjiuge_robot_1/零件组装教程+stl文件/Neck_and_jaw-main/README.md

<h1>颈部和下颌的组装</h1>

好的，我想你的躯干应该已经组装好了，或者差不多了。颈部的组装应该不会太难。用到的伺服器都不需要改装，可以直接设置。太棒了。

从图库下载 STL(已下载)

在打印所有部件之前，您应该打印一份校准器 (CALIBRATOR)，以检查部件是否能够拼合。如果您在拼合这些部件时遇到困难，可以调整切片软件的水平扩展设置来解决这个问题。此设置可能因切片机和打印机而异，但用户报告称，将其设置为 -0.15 是一个不错的起点。

填充率为 30%，壁厚为 2.5 毫米，最好无筏，无支撑（除非另有说明），大部件使用边缘以避免翘曲。

注意：我设计了一种新的颈部机制，可以在图库中下载，但未在下面的教程中显示。（见newNeck.mp4）

以下是颈部和下颌所需的零件清单和打印数量：

1x JawHinge

1x JawHinge

1x JawPiston

1x JawSupport

1x Jaw

1x LowBack

1x FaceHolder

1x GearHolder

1x MainGear

1x NeckBolts

1x NeckHinge

1x Neck

1x Ring

1x ServoGear

1x SkullServoFix

1x ThroatHolder

1x ThroatHole

1x ThroatPistonBase

1x ThroatPiston



将“MainGear”用胶水或螺丝固定到“NeckHinge”上



使用“GearHolder”并将“ServoGear”安装到其中。将随 HS-805BB 舵机一起提供的执行器轮拧到“ServoGear”上。



使用您的 Arduino 板并将您的 HS-805BB 伺服设置为 90°。
将其推入转盘。



这有点棘手，但可以用螺丝刀上的磁铁来实现。使用舵机附带的螺丝，将转盘拧到“ServoGear”内的舵机上。保持舵机呈90°。



将此组件安装到“MainGear”和“NeckHinge”组件上，并使用一些润滑脂以减轻旋转。“GearHolder”应与“NeckHinge”对齐，并且伺服器应保持90°。



将“LowBackRight”和“LowBackLeft”或“Temporary”固定到“GearHolder”。这将是头骨的后部。



将“Ring”拧到“MainGear”上。尽量避免零件之间松弛。



使用您最喜欢的钳子来安装“FaceHolder”。
您可以安装它们两个。



现在我们来制作下巴。取“JawPiston”并将其旋转到“JawHinge”内部，直到它们之间偏移1cm。



将此螺丝安装到 HK15298 或类似舵机的转盘上。使用 Arduino 开发板将舵机设置为 0°。保持 1cm 的偏移，“JawHinge” 应与舵机成 90° 角安装。



将螺丝“SkullServoFix”安装在 HS-805BB 伺服器上。



把4个螺丝全部拧上。别介意我照片上的电线，它们来自相机。



用丙酮将两个“JawHolders”粘在整个组件的两侧。它与“FaceHolders”贴合。



现在取出您的 HK15298 组件并将其滑过。



拧上所有 4 颗螺丝，固定您的 HK15298 伺服器。



移除“Jaw”的预支撑。图片上显示的“Jaw”只是一半。这是我之前做的测试打印。你的“Jaw”是一体式打印。



将“Jawsupport”拧到“Jaw”上。确保“Jawsupport”的平面朝内。



修复“ThroatHole”的问题。我的看起来和你的不一样。抱歉，图片显示“ThroatPiston”和“ThroatPistonBase”应该还没有安装，后续步骤会安装。



将“Neck”拧到“ThroatHole”上。



用 8 毫米螺栓将“NeckHinge”固定到“Neck”上（或从手上打印一个）
假设您已将 HS-805BB 舵机固定在躯干组件中。使用 Arduino 开发板将舵机旋转 90°。稍微旋转“ThroatPiston”和“ThroatPistonBase”，使“NeckHinge”平直。



将“ThroatPiston”拧到转盘上，使伺服器保持 90°。



用 8 毫米螺栓将“ThroatPistonBase”固定到“NeckHinge”（或从手上打印一个）
现在，当伺服电机从 0 度旋转到 180 度时，整个头部应该能够上下移动。用 arduino 进行测试。请仔细运行此测试。



将头部抬起，将下颌组件滑入头部。



将“JawSupports”穿过并安装到“JawHinges”和“JawHolders”上



使用垫圈，固定螺丝。

使用 Arduino 对钳口机构进行测试。

注意：钳口伺服器只能旋转 0 到 20°（我估计），如果旋转超过 20° 可能会损坏零件。请自行测试。（目前我记不清我的伺服器具体能旋转到多少度了。等我重新插上电源后再解决这个问题。）

您可以在“Neck”中运行伺服器的电缆。

现在您应该可以通过 Arduino 移动头部和下巴了。

将 MyRobotLab 与InMoov.minimalHead.py结合使用：https://github.com/MyRobotLab/pyrobotlab/blob/develop/service/InMoovHead.py

检查InMoov 服务 Myrobotlab的引脚连接以将其添加到您的机器人。
