idolverse/Tulingjiuge_robot_1/零件组装教程+stl文件/Shoulder_torso-main/README.md

## 塑造肩部和躯干

好吧，让我们看看接下来怎么做。在这个教程里，我们将同时制作肩部和躯干。我本来想分开做，但我的照片已经是用这种方式拍的，而且我不会为了拍新照片而把机器人拆开。

从图库、肩部和躯干下载 STL 文件（已下载保存）

在打印所有部件之前，您应该打印一份校准器 (CALIBRATOR)，以检查部件是否能够拼合。如果您在拼合这些部件时遇到困难，可以调整切片软件的水平扩展设置来解决这个问题。此设置可能因切片机和打印机而异，但用户报告称，将其设置为 -0.15 是一个不错的起点。

填充率为 30%，壁厚为 2.5 毫米，最好无筏，无支撑（除非另有说明），大部件使用边缘以避免翘曲。

以下是躯干所需的零件清单和打印数量：

2x: KinectSideHolder

2x: KinectSideBack

1x: KinectMidFront

1x: KinectMidBack

2x: InterKinectSide

2x: InterKinectMid

2x: HomLowFront

2x: HomLowBack

2x: ChestLow

以下是1 个右肩所需的零件清单和打印数量：

1x ClaviBack

1x ClaviFront

1x PistonClavi (如果您在将此部件与活塞底座配合时遇到问题，您可以在打印前将 X 和 Y 尺寸减小 0.1 或 0.2 毫米)

1x Pistonbase

2x PivConnector

1x PivGear

1x PivMit (添加支撑)

2x PivPotentioRound or PivPotentioSquare

1x PivPotholder

1x PivTit (添加支撑)

1x PivWorm

1x Pivcenter

1x servoHolster (添加支撑)

1x servoholder

1x shoulderconnect

<h2>步骤1：</h2>

按照“构建 InMoov 的二头肌”中的步骤 1来提取伺服器的电位器。

如果您无法按照我的方式打开伺服器，这里有一个由 InMoov 建造者 (Wayne Kinne) 发布的另一个解决方案，当然，如果您有一个焊锡泵，那就更容易了：

https://youtu.be/4ia6zoRKujI

或者您也可以观看 InMoov 建造者 (Kaibab) 发布的这些视频：

http://youtu.be/EwebQTuTAcw

http://youtu.be/5usFR3W61SA

http://youtu.be/5-nxuoqT8Ho

http://youtu.be/J8Q-bUT-IJ0

http://youtu.be/t1LBbmfRvOQ

这是另一组视频（由 Yann Huguenin 制作），其中涉及的技术是去除三个电机连接上的焊料，将电机留在原位而不是将其移除：

视频教程-Pot-Servo.rar(已下载保存)

或者这个视频：

https://youtu.be/BM4oDbYcKwo

用于提取 JX-PDI2060MG 伺服器上的电位器的 PDF：

HowTo-JX-Servo.pdf（已下载保存）

重要提示：在将电缆重新焊接到电位器的最后一部分会有所不同，这取决于您构建的是右肩还是左肩。



如果你要制作右肩，请按照这种方式焊接电缆。图中蓝色线替换了绿色或黑色线，具体取决于你的舵机。



如果您要制作左肩，请按此方式焊接电缆。图中蓝色线替换了绿色或黑色线，具体取决于您的舵机。

这将使你的舵机反向旋转，使初始的0度位置变成180度位置。而初始的180度位置又变成0度位置。希望你明白我的意思。这将在每个肩部使用的两个舵机上进行。现在开始组装。

<h2>步骤2：</h2>

如果您计划锻炼双肩，则应针对身体的另一侧重复下面解释的大部分步骤。



删除“PistonBase”下的预建支撑

确保“PistonClavi”在里面能自由转动。如果打印件太紧，可以用润滑脂来缓解。为了找到合适的设置，我不得不对打印机的这些部件进行微调。



与您最喜欢的钳子“PistoBase”、“ClaviBack”和“HomPlatback+”一起组装。

如果您使用 PLA 进行建造，则可以使用热风枪对零件进行加热，以使它们更容易安装，从而避免损坏零件。
确保“PistoBase”可以顺利旋转。



将“HomPlatback-”添加到“HomPlatback+”
在这里您可以看到我最喜欢的钳子的实际使用情况。



将“ThroatHole”添加到“HomPlatback-”或“HomPlatback+”
自此图片以来，“ThroatHole”已被修改。



是时候组装前部了。将“Sternum”和“ClaviFront”安装在一起。
抱歉，这张图片显示的是我制作的第一个版本，但它非常接近，请查看下一张图片。



这是您使用最后一个版本和后面的最后一个“ThroatHole”将获得的形状。



将“ThroatLower”和“ServoHolster”两个安装在一起。
该伺服器位于躯干中部，用于上下移动头部，如果您愿意，可以稍后添加，但皮套应已安装到位。



将此组件安装到后部组件上。查看图片上的示意图和伺服器的位置。前夹和后夹是不同的。



将前部组件添加到其余部分。



你可以自己用夹子夹住。应该可以很好地固定。你可以用丙酮把各个部件粘在一起，但我还没用过，而且经过几周的测试，它已经粘好了。

<h2>步骤3：</h2>



在本教程的这一部分，您将看到 6 毫米的黄色 BBgun 球。
谨慎选择使用的润滑脂类型。有些润滑脂会弄脏打印件，甚至会溶解BBG枪弹珠。你在这张图片上看到的白色润滑脂对塑料BBG枪弹珠的腐蚀性很差，我不得不把所有弹珠都换成钢珠。
当然，这些也可以用钢球代替。另外，在本教程的这一部分，我使用的是 HS805bb 以外的其他舵机。这些舵机看起来很不错，而且价格也很合理。（参考 PDI-HV2060MG）



将 3 毫米螺母插入每个螺母壳中，然后用钳子将其推入。



用熔化的 ABS 或环氧胶固定螺母。



重新钻孔并确保 3 毫米螺钉正确啮合到螺母中。



确保电位器轴完全嵌入孔内。如有必要，可使用小锉刀。



还要确保电位器的主体与 PivPotentioRound 完美契合（您可能需要根据您的电位器使用方形版本）



将 PivTit 和 ServoHolder 组装并粘合在一起。ServoHolster 需要插入，但无需粘合，以便自由旋转。



将 PivPotentioRound 压入 PivTit 中。通常无需粘合。



在 PivCenter 背面打上 4 个孔或插入 4 个 3 毫米的螺母。



在 PivMit 上用 3.5 毫米孔重新钻孔。



将 PivWorm 拧到伺服喇叭轮上（伺服器自带的部件）。确保 PivWorm 牢固地固定在 PivCenter 上，并且可以手动旋转。另外，螺丝不要碰到我用左手食指指向的边缘。



添加油脂。小心选择油脂类型。有些油脂会弄脏打印部件，甚至会溶解BBG枪弹珠。你在这张图片上看到的白色油脂对塑料BBG枪弹珠非常有害，我不得不把所有弹珠都换成钢珠。



添加球。这里你总共需要27个球。



插入 PivGear。



在齿上各处涂抹更多油脂。查看我图片上 PivGear 的位置，确保稍后添加电位器时将其转向这个方向。



装上PivTit。



用 3 毫米螺丝将 PivTit 固定到 PivCenter 上。我使用 35 毫米长的六角螺丝来固定 PivCenter 另一侧的螺母。



为了让 8 毫米轴自由旋转，此螺钉需要更短（最多 20 毫米）。（此图中的镀铬轴）



将伺服器连接到伺服喇叭轮上。确保它完全啮合，有些喇叭比较难安装，手动压入比较困难。所以不要损坏任何东西。正如你在本教程中看到的，我使用的是 HS805BB 以外的其他型号的伺服器，压入起来非常困难。



准备一个塑料拉链，套在伺服电机上，注意拉链连接器的位置和方式，这对于后续组装至关重要。不要完全拉紧拉链，我们稍后会穿过丝带和电缆。



现在你可以安装 4 颗螺丝来固定伺服电机了。我使用的是 3.5 x 16 毫米的标准飞利浦木螺丝，但你也可以安装其他尺寸的螺丝。



如图所示插入另一个塑料拉链。



穿过电位器出来的两根电缆。（伺服和电位器延长线）
你可以拉紧塑料拉链，注意其位置，如图所示。剪掉多余的拉链长度。



现在我们来准备并剪断手臂和手部的带状线缆。线缆上标注了所需的长度。先不要固定接头！



将两条丝带折叠约 30 厘米，然后穿过黑色塑料拉链。请注意图片中丝带红色内衬 (Vcc+) 的设置方式。



再次折叠丝带，并将其穿过第二个白色拉链。再次折叠丝带，然后按照图示将其拉下。



现在将两个色带和伺服电缆穿过 PivGear，如图所示。



你可以看到，我手里拿着的是电位器的线，它不需要穿过 PivGear。（提示：准备取出电位器时，我加了一条 35 厘米长的延长线，正如你所见，这已经足够了。）



从另一侧看应该是这样的。



获取 PivMit 部分。



在球窝接头处的 PivMit 上添加油脂。



加31個球。



按照图示将 PivGear 插入 PivMit。注意不要将其倒置。



无需拧紧，只需添加一个直径 3 毫米、长度 30 毫米的螺丝即可到达螺母。该螺丝用于调节滚珠轴承上的压力。



现在我们可以安装并焊接电缆到电位器上了。注意我的电位器位置略微旋转了一下，你的电位器位置应该大致相同。稍后你可能需要重新调整它的位置。DSC07338我们准备好 RotCenter 和润滑脂，以及 27 个滚珠。我们也准备好 RotWorm，用螺丝固定在伺服喇叭轮上。



让我们添加 RotGear 和油脂。注意 RotGear 在我的图片上的位置。



按照图示将 RotTit 安装到 PivMit 上。请勿将调节螺丝拧得太紧，它仅用于调节滚珠轴承的压力。将 PivPotentioRound 压入 RotTit 中。



安装 PivConnector，用钳子压入。如果安装起来很困难，可以用热风枪轻轻地软化部件。（使用校准良好的打印机，部件可以完美贴合）



安装第二个 PivConnector。用丙酮将四个部分粘合在一起，并做好粘合，这需要很大的压力。



按照图示将 RotCenter 安装到整个组件上。确保 RotGear 仍处于图示的正确位置。



通过 RotCenter 的底部添加一个 3 毫米、长度 30 毫米的螺丝，以到达另一侧的螺母。



如图所示，在顶部添加另外三个直径 3 毫米、长度 30 毫米的螺丝。



是时候安装第二个伺服电机了。



添加并拧紧四个 3.5 毫米 x 16 毫米的标准木螺钉。



用黑色拉链将伺服电机的两根线缆拉紧，如图所示。剪掉多余的部分。



再套上一个白色拉链，固定住线缆，然后按照图示穿过 PivConnector。剪掉多余的拉链长度。



添加并焊接电位器。确保它像我的一样安装。稍后你可能需要调整它的旋转。



用 ServoHolster 上的刀片修剪边缘，这将有助于插入伺服电机。根据伺服电机的型号，将其推入可能会有点困难。



添加并拧紧四个 3.5 毫米 x 16 毫米的标准木螺钉。



将舵机喇叭轮安装到舵机电机上，并用舵机自带的3毫米螺丝固定。一定要拧紧，因为这个螺丝会随着时间的推移而松动。



将 PistonClavi 安装到伺服喇叭轮上。我使用了四个 3 毫米、长度 12 毫米的六角螺钉，但您也可以使用一些小木螺钉。



将伺服电缆插入 PivGear。



如果一切正常，现在三个伺服电缆连接器应该位于同一位置。



将第三根电位器电缆穿过拉链（白色），如图所示。



继续将第三根电位器电缆穿过第二根拉链（黑色），如图所示。



按照图示放置 PotHolder，然后以与图片类似的角度安装并焊接第三个电位器。（稍后，为了固定 PotHolder，我们需要卸下固定伺服电机的两颗螺丝。）



另外，当所有电位器都校准好后，最好用热胶枪（热胶枪）保护电位器焊点。但只有在确保一切正常的情况下才能这样做。
供参考：如果您想去除热胶，最好的技巧就是在上面刷一些酒精，这样就很容易去除了。



将 Arm 分线板用螺丝固定到 ShoulderConnect 上。并将三根伺服线缆的连接器分别连接到相应的引脚上（参见硬件页面和 BOM.pdf(待搬运)）。

-Omoplate 引脚 11
-肩销 10
-旋转销钉 9
-二头肌引脚 8（如果你已经拥有二头肌）



按照图示组装接头（NervoBoard 组件：https://inmoov.fr/product/nervo-board-components/），顶部带有红色标记的带子。



小心地将色带牢固地固定在接口中，否则可能会引起短路。（图中接口短路，烧坏了色带。）



将接头插入 Arm 分线板。



如果一切顺利的话，你现在应该得到类似这样的东西。



加上两颗3毫米、20毫米长的侧螺丝。不要拧得太紧，否则可能会损坏部件。



让我们准备好 RotMit 部分。



注意 RotMit 上写着“FRONT”（正面）。这告诉你如何将它组装到 RotGear 上。



添加油脂和 31 个球。



集合至 RotGear。



添加两个3毫米直径、30毫米长度的调节螺钉。不要拧得太紧。这些螺钉仅用于调节滚珠轴承的压力。



添加并拧紧两个3毫米、长度20毫米的侧螺钉。确保它们不要太长。这一点很重要，否则可能会损坏二头肌的活塞。



插入 RibbonPusher。



如您所见，这只是为了固定带状电缆，以避免与二头肌的活塞发生摩擦。



用一颗直径 8 毫米、长度 90 毫米的螺丝将肩部组装到 Clavi 部件上。（别介意带状电缆，这是一张旧版本的图片）



如果已准备好，请将二头肌部件连接到肩部部件上。



在肩膀后面将“PivPotHolder”的第一部分夹到“ClaviBack”上。



您的 PivPotHolder 有一个 8 毫米螺母壳。（上图是老款）



卸下固定伺服器的两个螺丝，并将“PivPotHolder”的第二部分放到位。



使用更长的螺丝穿过伺服孔。

 

将两条带子分别连接到手臂和手上的 NervoBoards。
现在，您可以开始进行首次测试了。需要注意的是，伺服驱动“PistonClavi”应保持在0到80的位置之间，如果超过这个位置，它肯定会损坏。如果您使用Myrobotlab的InMoov服务，则已实施此措施以避免损坏。请记住，请在较大的空间内进行测试，并检查电线，以免它们被扯断。
测试技巧：我个人会在启动整个肩部之前逐个测试伺服器的每个位置。为此，我只需拔掉那些我不想给 Arm 迷你分线板供电的伺服器线缆即可。

<h2>步骤4：</h2>

将肩部设置到默认位置。

脚本用于了解如何将 MyRobotLab 与手臂和肩膀一起使用：InMoovArm.py

将“omoplate”伺服器和电位器设置为默认“静止”位置 10，范围从 0 到 180

为了达到这个值，您可能需要稍微旋转支架中的电位器。



当肩胛骨板处于默认 10 位置时，这两个部分之间没有间隙



观看肩胛骨运动的视频：

https://inmoov.fr/wp-content/uploads/2015/10/MOV05330.mpg：已保存至MOV05330.mpg

################################################################################

将“肩部”伺服器和电位器设置为 0 到 180 范围内的第 33 号位置。这不是“休息”的默认位置，但这样，我们可以对齐从 InMoov 背面看到的两个伺服器。

为了达到这个值，您可能需要稍微旋转支架中的电位器。



观看视频了解肩部运动：

https://inmoov.fr/wp-content/uploads/2015/10/MOV05329.mpg：已保存至MOV05329.mpg

################################################################################

将“旋转”伺服器和电位器设置为默认“静止”位置 90，范围为 0 到 180。

按照图片所示对齐各部分。

为了达到这个值，您可能需要稍微旋转支架中的电位器。



观看“旋转”伺服运动的视频：

https://inmoov.fr/wp-content/uploads/2015/10/MOV05328.mpg：已保存至MOV05328.mpg
