idolverse/Tulingjiuge_robot_1/零件组装教程+stl文件/Finger_starter-main/README.md

<h1>手指启动器</h1>



“Finger Starter” 的组装视频：https://youtu.be/0t2uhAyf2-c

从 Gallery 下载 STL 文件。

在打印所有部件之前，您应该打印 CALIBRATOR，以检查您的部件是否适合在一起。如果您很难将这些部分放在一起，调整切片器软件的水平扩展设置可以解决这个问题，此设置可能会因您的切片器和打印机而异，但用户报告将其设置为 -0.15 是一个很好的起点。

以下是 1 个 Finger Starter 所需的部件列表和打印件数量：

1x FingerIndex

1x FingerTester

1x RobRing

1x Servo-Pulley

这将会很有趣！！
我们将把一根手指组装到一个小型伺服器上，以便用 Arduino 开发板对其进行测试。我在图片上使用的伺服器是数字 HK15298，但您也可以使用便宜的模拟 MG995，如果您能找到更便宜的伺服器并且尺寸规格相同，甚至可以使用更便宜的伺服器。
这里使用的 Arduino 开发板是 Arduino Uno。最好添加外部电源，因为即使这些伺服器很小，它们也会消耗太多电流，这可能会导致开发板重启。
在本教程的最后，还有一张图片，说明如何简单地将伺服器连接到开发板。
请记住：此连接设置只能为低安培的单个伺服器供电，如果您的开发板自行重置，或者伺服器抖动，则意味着您的伺服器的功耗对于电源引脚来说太高。您将需要一个外部电源。

有关连接和电源，请参见此处：https://inmoov.blogspot.com/2012/12/power-supply-robot-head-printed.html
这些连接图主要针对整个手，但对于一个伺服器/手指或五个伺服器/手指来说都是相同的。

我在这个教程中使用的拉竿是尼龙钓鱼竿，但效果不太好，因为它容易随着时间的推移而拉伸。我推荐使用 InMoov 的 200 磅钓鱼线。不过，在这个测试中，你可以使用任何手边现有的线，只要它能拉动，并且足够细，可以让手指弯曲。

现在让我们看看我们打印了什么以及我们将如何做。





使用 3 毫米钻头重新钻侧面的铰链孔。



应使用 3.5 毫米钻头重新钻内部铰链孔。



因此，手指的内部铰链也应该用 3.5 毫米的钻头来完成。



请注意，手指各部分都印有数字，以便于组装。



根据您用于打印的材料，有不同的方法将各个部分粘合在一起。

如果您有 PLA 打印件，双组分环氧胶非常适合，但您也可以使用 Zap-A-Gap 胶。

如果您使用 ABS 进行打印，那么效果最好的是丙酮，但您也可以使用环氧树脂、Zap-A-Gap 胶水。



滴几滴丙酮就能把各个部件溶解粘合在一起，就像打印成一体一样。所以，把第1部分和第2部分取出，然后把它们粘在一起。



将第 3 部分和第 4 部分粘合在一起。



先不要粘合第 5 和第 6 部分



取一段 3 毫米的灯丝，如果没有，则需要从五金店买一些 3 毫米的螺丝。



用切刀将其修剪。



将其推入孔中，将 1/2 至 3/4 部分组装在一起。



一旦到达另一边，



用钳子剪断灯丝。



对第 3/4 至 5 部分使用同样的技巧



现在我们的手指可以自由移动了。



用同样的技术将手指组装到主体部分。



你应该有类似这样的东西。它应该可以自由折叠到这个角度。



现在让我们看看伺服器。我们要在伺服器上找到一个任意零点。用手将执行器旋转到最左侧，并记录它到达的位置。向左旋转执行器，并记录它到达的位置。这两个点是伺服器的极限位置，任意零点位于这两个点的中间。如果你知道如何操作，你可以用你的Arduino开发板找到它，但目前这是一个简单的解决方案，尽管它并不精确。



安装，将“RobRing”拧到伺服器上，两个小孔应该位于极端点上。



取一根约50厘米长的鱼竿，将其穿过一个孔。



像这样，在距离鱼竿约 25 厘米处打两个结，并将它们打紧。



在距离第一组结约 1 厘米处添加另一组结。



我的照片上只打了两个这样的结，但它们可能会穿过“RobRing”的孔，这是不应该发生的。多打几个结可以避免这种情况。



现在将杆的另一端穿过第二个孔。



你应该有类似的东西，甚至比我的结还多。



是时候将伺服器固定到基座上了。



将底部杆穿过如下图所示的部件。



只要确保不要倒置你的钓竿，它应该始终位于手指背面。



现在将第二根杆放在手指内侧。



你应该以这样的结局结束。



检查你的伺服器是否处于其零任意点。



将手指稍微卷曲，并在两根电线之间打几个结。



用手转动“RobRing”时，手指应该能够处于这个位置。手指完全伸展。



现在切割杆。



将第 6 部分粘到第 5 部分。如果仔细观察第 6 部分，就会发现它有一个钉子侧面，出于美观原因，我没有在钉子上写上数字。



尝试通过旋转“RobRing”来移动手指，它应该可以自由移动而不会锁定。



插入 Arduino 开发板并进行如下接线。橙色或黄色线连接 PWM 的 3 号引脚。红色线连接 +5V。黑色或棕色线连接 Gnd（地线）。

请记住：此连接设置只能为单个低安培的舵机供电。如果您的开发板自动复位，或者舵机抖动，则意味着舵机的功耗对于电源引脚来说过高。您需要外部电源。（请参阅本教程开头）

现在，您可以将FingerStarter 代码（已保存至FingerStarter 代码.txt）上传到您的 Arduino 来查看它的运行情况。如果您以前从未使用过 Arduino，请点击此链接：https://www.arduino.cc/en/Guide/。或使用 Arduino简介 PDF 文件。

您还可以访问 MyRobotLab，学习如何使用滑块驱动手指。按照教程（如何启动 MyRobotLab）开始使用 Myrobotlab。自从我撰写本文以来，情况发生了一些变化，但它有助于理解基础知识。

以下是使用 MyRobotLab 对 FingerStarter 进行语音控制的脚本：

对于 Manticore–>带语音控制的 InMoovFingerStarter：https://github.com/MyRobotLab/myrobotlab/blob/master/src/resource/InMoov/InMoov.minimalFingerStarter.py

对于 Nixie–>带语音控制的 InMoovFingerStarter（已保存至InMoov.minimalFingerStarter.py）：https://inmoov.fr/fingerstarter-with-voice-control/

如果您有一些肌肉传感器或超声波传感器，您可以尝试用它们控制手指启动器。

– inmoov_fingerstarter_muscle_sensor
– inmoov_fingerstarter_ultrasound
