idolverse/Tulingjiuge_robot_1/零件组装教程+stl文件/Bicep-main/README.md

<h1>打造 InMoov 的二头肌</h1>

我已尽量简化，希望您能在这里找到问题的答案。打印完零件后，就可以开始制作了。图中我组装的是**左臂**，如果您要组装右臂，请考虑到这一点。

从图库下载 STL

在打印所有部件之前，您应该打印一份校准器 (CALIBRATOR)，以检查部件是否能够拼合。如果您在拼合这些部件时遇到困难，可以调整切片软件的水平扩展设置来解决这个问题。此设置可能因切片机和打印机而异，但用户报告称，将其设置为 -0.15 是一个不错的起点。

填充率为 30%，壁厚为 2.5 毫米，最好没有筏，没有支撑，大部件使用边缘以避免翘曲。

以下是制作一个 右二头肌所需的零件清单和打印数量：

  1x GearHolder
  
  2x HighArmSide
  
  1x Pistonanticlock
  
  1x Pistonbaseanti
  
  1x RotGear
  
  1x RotMit
  
  2x PivPotentio (圆形或方形)
  
  1x RotTit
  
  1x RotWorm
  
  1x Rotcenter
  
  1x armtopcover1
  
  1x armtopcover2
  
  1x armtopcover3
  
  1x elbowshaftgear
  
  1x gearpotentio
  
  2x lowarmside
  
  2x reinforcer
  
  1x servobase
  
  1x servoholder
  
  1x spacer

以下是制作左二头肌所需的零件清单和打印数量：

  1x GearHolder
  
  2x HighArmSide
  
  1x Pistonanticlock
  
  1x Pistonbaseanti
  
  1x RotGear
  
  1x RotMit
  
  2x PivPotentio (圆形或方形)
  
  1x LeftRotTit
  
  1x RotWorm
  
  1x LeftRotcenter
  
  1x armtopcover1
  
  1x armtopcover2
  
  1x armtopcover3
  
  1x elbowshaftgear
  
  1x gearpotentio
  
  2x lowarmside
  
  2x reinforcer
  
  1x servobase
  
  1x servoholder
  
  1x spacer

二头肌教程视频：https://youtu.be/aHVBU02EtxY

<h2>步骤1：</h2>

在第一个教程中，我们要做的是提取两个伺服器的电位器，并通过焊接增加额外的电缆长度：



我们首先要打开 Hitec HS-805BB 伺服器，拧下底部所有螺丝。它分为三个部分。务必在干净的地方进行操作，以免丢失任何东西，损坏里面的润滑脂。拆下顶部后，请记录或拍下每个齿轮的位置，仔细检查一下，有两个齿轮看起来几乎一样（如图所示）。



拆下轴承及其环（注意顺序）。拆下来可能有点困难，我用了一把放在轴承下面的小螺丝刀。



现在我们要移除 PCB 卡和它的电机，在某些伺服器上这很容易，但是电机周围有一点胶水，所以你可以通过按下螺丝刀尖端的小金属齿轮来将电机向下推。

这是 InMoov 构建者发布的另一个解决方案，如果您无法按照我的方式打开伺服器，当然如果您有一个焊料泵，那就更容易了：

https://youtu.be/4ia6zoRKujI

或者这个视频：

https://youtu.be/BM4oDbYcKwo

或者您也可以观看 InMoov 建造者发布的这些视频：

http://youtu.be/EwebQTuTAcw

http://youtu.be/5usFR3W61SA

http://youtu.be/5-nxuoqT8Ho

http://youtu.be/J8Q-bUT-IJ0

http://youtu.be/t1LBbmfRvOQ

这是另一组视频，其中涉及的技术是去除三个电机连接上的焊料，将电机留在原位而不是将其移除：

视频教程-Pot-Servo.rar

用于提取 JX-PDI2060MG 伺服器上的电位器的 PDF：

HowTo-JX-Servo.pdf



它出来了，拧开电位器，要将其释放出来，请参见下一张图片。



再次使用放在大齿轮下方的小螺丝刀来帮助自己。



取出塑料垫圈（我们不再需要它了，但保留它你永远不知道......）



这有点困难，用刀或钳子切开“塞子”，但不要损坏齿轮。



将所有齿轮重新安装回原位。用小刀切出一个更大的开口，以便穿过额外的电缆。从电路板和电位器上拆下电缆时，注意颜色。（我的第一个伺服电机没有焊好，接了十分钟电话，回去焊接时却记不住颜色了……这导致伺服电机永久损坏，30欧元被扔进了垃圾桶，啊啊啊）



在焊接二头肌下部的电位器之前，请将电缆放入“servoholderV1”的间隙中。

重要提示：请勿将电位器导线从伺服电机的PCB上拆焊，只需剪断并焊接所需长度即可。一些安装人员报告称，将电位器导线直接焊接到PCB控制器上后，伺服电机无法正常工作。某些组件可能对温度非常敏感。

对于二头肌下部舵机，线缆的焊接顺序应与打开舵机时的颜色顺序一致。线缆长度约为 25/30 厘米。现在我们开始组装零件。

如果您无法按照我的方式打开伺服器，这里还有另一个解决方案（由 Wayne Kinne 提供），当然，如果您有焊锡泵，那就更容易了：

https://youtu.be/4ia6zoRKujI
您还可以观看由 InMoov 构建者 (byKaibab) 发布的这些视频：

http://youtu.be/EwebQTuTAcw
http://youtu.be/5usFR3W61SA
http://youtu.be/5-nxuoqT8Ho
http://youtu.be/J8Q-bUT-IJ0
http://youtu.be/t1LBbmfRvOQ

这是另一组视频（由 Yann Huguenin 制作），其中涉及的技术是去除三个电机连接上的焊料，将电机留在原位而不是将其移除：

视频教程-Pot-Servo.rar

<h2>步骤2：</h2>



这张图片是为了展示“rotgearV1”和“rotmitV1”的角度位置。检查那个小矩形孔。



保持相同的旋转角度，将“rotmitV1”安装到“rotgearV1”上。（不要参考这张图片来判断角度，你下载的零件已经不一样了）



我使用了夹子，以确保三个部件在拧紧过程中不会相互卡住。确保螺丝不会脱出来，否则需要重新切割。（不要参考这张图片的角度，你下载的部件已经不一样了）



将一个伺服器连接到“rotcenterV1”。操作方法：安装白色执行器轮，但不要太紧。



一旦伺服器连接好，就可以拧紧螺丝。



用 4 颗小螺丝将“rotwormV4”安装到执行器上，确保它们不会从执行器后面脱落，否则就得把它们剪掉。将“rotgearV2”安装到“rotcenterV2”上，它应该可以轻松转动，不会出现间隙。我把伺服器插到 Arduino 上，让它转动了几圈。然后，我清理了零件产生的灰尘。在用“rotTitV1”盖上盒子之前，在齿轮的每个地方都涂上足量的润滑脂。



如果您正在构建左旋转臂，则电缆的焊接顺序应与打开伺服器时的颜色顺序相同。



如果您正在构建正确的旋转臂，则电缆应按照与打开伺服器时相反的颜色顺序进行焊接。



将电位器安装到“rotpotentioV2”上，但务必将电位器上的小金属片放入“rotpotentioV2”设计的间隙中。可以使用小型舵机上的一些备用螺丝。



附言：“rotmitV2 不应该站在上面三张图片的左侧，因为你已经骑上它了……



将“pistonanticlockV1”缓入“pistonbaseV1”。我用一根金属棒加固了“pistonanticlockV1”的内部。不过你可以像这样使用它，它应该能撑住。我在测试过程中弄坏了几个，很高兴它们坏了而不是别的。



将“higharmV1”和“rotmitV1”组装起来，用钳子，ABS材质的它完美契合，感觉就像在玩乐高积木一样。确保它们的位置与图片上的位置一致。



添加“pistonbaseV1”和“spacerV1”。连接电位器，再次确保将电位器上的小金属板放置在设计的间隙中。



组装“higharmV1”和“lowarmV1”的剩余部分。测试完成后，你需要将这些部件粘合起来。



将伺服器安装在“servoholderV1”中。



按图示铺设电缆。



按照图中所示，将电缆沿着框架向下折叠，我用了铝箔胶带，这样可以避免在操作过程中夹住电缆。对电位器导线的另一侧也进行同样的操作。

DSC05166bis-1024x776

将“servobaseV1”和“pistonanticlockV1”连接到执行器。



将“pistonanticlockV1”归还给“pistonbaseV1”。加点润滑油是个好主意。

所以我假设你已经把“ elbowshaftgearV1 ”粘贴到“robcap3V1”上了。这样你也把前臂和二头肌连接起来了。很好。



接下来是我最难解释的部分。现在把“伺服底座”向下倾斜，并将其安装到前臂上。



你应该在它的底部留出一个空隙，这将是你的0°位置。把整条手臂固定或标记在这个位置，在接下来的步骤中不要弄丢它。

servogun-600x450

卸下舵机枪。将舵机插入Arduino开发板，运行程序获取舵机的0°位置，舵机将持续旋转。现在用手转动电位器，直到舵机停止转动。这就是0°位置。



将“potentiogearV1”安装在电位器上，确保臂和电位器不会移动。



将“gearholderV1”卡入。两个齿轮之间不应有间隙。保持伺服枪未安装，并像之前一样使用Arduino进行0°测试。您可以用手缓慢地将手臂移动到关闭位置和打开位置，以检查一切正常。重新安装伺服枪。



关键时刻到了。重新运行测试，直到0°。机械臂应该打开，并保持之前在底部看到的间隙。否则，“pistonanticlockV1”会断裂。



再进行一次从0°到60°的测试。检查“pistonanticlockV1”和“pistonbaseV1”之间剩余的空间。我的手臂可以旋转到90°，但要注意，这取决于你设置的间隙。所以，尝试10°乘以10°。记住，在绘制草图时，不要超出你得到的最佳结果。
现在，你可以将连接到“rotcenterV1”的舵机旋转到90°进行测试，这将是手臂在连接到下一个肩部时的“静止”位置。

在二头肌上添加盖子以加强结构。

这些部件上没有支撑结构需要移除。但你需要切割部件之间的微小连接点才能将它们分开。切割刀片适用于 ABS 材料，如果使用 PLA 材料打印，则可能需要使用带齿的刀。

Bicep3

将盖子粘在一起以匹配二头肌，如下图所示：

Bicep2

通常情况下你应该已经设置好了。
