idolverse/Tulingjiuge_robot_1/零件组装教程+stl文件/Back-main/README.md

## 后背教程和上传更新日期

<h1>后背</h1>

在本教程中，我将向您展示如何组装后盖。如果您的打印件打印正确且没有翘曲，组装起来会相当容易；否则，您将很难将所有部件组装在一起。

其中一些部件在 3D 打印期间需要支撑，因此请查看下面的列表。

从图库下载 STL

在打印所有部件之前，您应该打印一份校准器 (CALIBRATOR)，以检查部件是否能够拼合。如果您在拼合这些部件时遇到困难，可以调整切片软件的水平扩展设置来解决这个问题。此设置可能因切片机和打印机而异，但用户报告称，将其设置为 -0.15 是一个不错的起点。

填充率为 30%，壁厚为 2.5 毫米，最好无筏，无支撑（除非另有说明），大部件使用边缘以避免翘曲。

以下是背面所需的零件清单和打印数量：

1x BackClaviHolder (添加支撑)

1x BackCoverBottomLeft (添加支撑)

1x BackCoverBottomRight (添加支撑)

1x BackCoverBottomMid (添加支撑)

1x BackCoverTopLeft (添加支撑)

1x BackCoverTopRight (添加支撑)

1x BackCoverTopMid (添加支撑)

1x BackCoverLowLeft (添加支撑)

1x BackCoverLowRight (添加支撑)

1x BackHipsLeft (添加支撑)

1x BackHipsRight (添加支撑)

1x BackHipsMid (添加支撑)

1x BackHolderCenterLeft

1x BackHolderCenterRight

1x BackHolderCenter

1x BackHolderLowLeft

1x BackHolderLowRight

1x BackSideHolderLeft

1x BackSideHolderRight

1x BatteryHolderLeft

1x BatteryHolderRight

2xBatteryPusher

1x BackDoorRight

1x BackDoorLeft

1x BackDoorClip

1x BackPower

<h2>步骤1：</h2>

修剪掉印刷品上的所有支撑物，并使其全部干净！

如果您计划为颈部使用额外的伺服器（Bob Houston 升级：https://www.thingiverse.com/thing:2605676），您将需要将您的 Arduino 和 Nervo 板倒置旋转，主要是因为 USB 电缆的位置不太好。



如果您不打算使用伺服升级，您可以先将所有支架添加并粘合到躯干板上。

您可能想检查3D 草图（见背部3D草图）来查看哪个部分放在哪里！

 IMG_1990-600x450

InMoov，后支架顶部

这些小部件应该用胶水粘好。注意：你打印出来的文件看起来会有所不同，因为我更新了它们，以便安装额外的颈部伺服器。

IMG_1992-600x800

InMoov 后支架 Mid

中间部分也需要粘合。如果你的部件是用ABS打印的，可以使用丙酮。

photo10-600x450

InMoov 低支架

对于低支架也一样，使用胶水或丙酮

IMG_1986-600x450

InMoov 后支架中心

你需要用螺丝固定中心支架。但也可以用胶水粘住。

<h2>步骤2</h2>



最好在现场直接组装零件，以免干燥后变形。使用夹具将零件粘合固定，这将有助于确保安装到位。



添加螺钉和螺栓以将所有部件固定在一起。



继续添加更多部件，这些部件不应该被粘合，因为如果您想修改开关后面的东西，它可以让您保持访问权限。

image12-600x450

您可以选择在机器人两侧各安装两个开关，用于各种用途。我使用一个开关作为主电源关闭，另一个开关用于启动迷你放大器，第三个开关用于启动轮式移动底座，第四个开关目前处于闲置状态。这些开关在大多数电器商店和互联网上都可以买到。



如果您已经打印了之前版本的电池座，您可以锯开它们，或者重新打印我的新版本。新版电池座允许您在电池滑动的顶部添加一块铜片。因此，当您将电池推入后部时，它可以自动供电，而无需每次更换电池时都连接电线。





我把 USB 集线器固定在了 InMoov 的背面底部。你可以看到它是一个8 端口 USB3.0 集线器。有人巧妙地将 USB 集线器固定在了 InMoov 的背面。

右侧（蓝色）是我的 USB 声卡。左上角（红色）悬挂着一个音频插孔，连接迷你功放和 USB 声卡。

 

现在你可以添加椅背的底部了。同样，我建议现场粘合这些部件，以免变形。



将电池推杆粘在后门内。

IMG_1997-600x800

将迷你 USB OTG 电缆连接到您的 Thinkpad Lenovo 8 英寸平板电脑（请参阅 BOM 了解零件清单），然后将其放置在 InMoov 背面并按压安装。

你可能会注意到音频输出接口没有空隙，这是因为我用的是 3.0 版 USB 声卡，它能把音频发送到迷你功放。USB 声卡还带麦克风输入，这在某些环境下很方便。所以所有声音都通过 USB 处理。

检查图库中的上传和更新页面。

玩得开心并善待你的 InMoov！！



<h1>STL上传和更新列表</h1>

此列表旨在让建筑商知道我最近是否修改了某些部件。

由于此列表于 2016 年 5 月 16 日开始，因此我五年来所做的许多更新均未显示在这里。

<h2>2016年：</h2>

2016 年 5 月 16 日在 STL 画廊中添加了一个文件夹，其中包含我对 InMoov 的各种 STL 支持。

2016年5月16日 修改了RobServoBedV5至V6，扩大了直通电缆。LeftRobServoBedV5至V6也进行了同样的修改。

2016 年 5 月 25 日修改了所有前臂盖 V3 至 V4，使其具有光滑的表面，包括腕盖。

2016 年 5 月 25 日将 Rotawrist3V2 修改为 3V3，内部圆圈平滑。

2016 年 5 月 27 日将 PivTitV1 和 RotTit 修改为 V2，以允许在肩部内穿过电缆带。

2016 年 5 月 27 日将 PivGearV3 修改为 V5，以允许在肩部内穿过电缆带。

2016 年 5 月 27 日将 RotGearV4 修改为 V5，以允许电缆带穿过肩部。

2016 年 5 月 27 日创建了新的Potentiometer holder(电位器支架) V2 至 V3，以允许电缆带穿过肩部并使用方形电位器。
 
2016 年 5 月 6 日上传了后背盖的所有部分。

2016 年 5 月 6 日修改了眼球，使其具有各种环以创造更多的人眼，还允许使用鱼眼镜头。

2016 年 5 月 6 日修改了眼球支撑，使眼睛更靠近脸部孔洞，我还创建并添加了使用水平网络摄像头（例如 Microsoft 的 HD LifeCam 3000 或 5000）的支持。

2016 年 5 月 6 日修改 EyeSupportV4 至 V5 以允许使用 SG90 和 HXT900 伺服器。

2016 年 5 月 6 日修改了Eye Glasses的后部以适合新的眼球。

2016 年 5 月 6 日制作了一个扬声器外壳和支架，以适合安装在 Jaw 后面。
 
2016年6月21日，将Wristmall和LeftWristmall V3升级至V4。其中一个零件偏离了Z轴高度。

2016 年 6 月 28 日将 RotaWrist1V3 修改为 V4，以获得光滑的表面。

2016 年 6 月 28 日将 RotaWrist2V2 修改为 V3，以获得光滑的表面。

2016 年 6 月 28 日将 WristGears3V4 修改为 V5，以获得光滑的表面。
 
2016年4月8日，在“如何启动 MyRobotLab”中上传了两个 zip 文件，其中包含 MyRobotLab 1.0.1412 版本，包含 ProgramAB 的所有手势和音频文件。此外，还包含一个批处理文件，用于启动 MRL，自动抓取您指定的脚本并清除所有 Java 僵尸程序。
 
2016年4月9日 将NeckHingeV1修改为V2。这样可以避免旋转时撞到头骨部件的螺栓。

2016年9月17日 添加了BackDoor的相关文件。我还制作了一个PowerBank支架，可用于其他各种用途。

2016 年 9 月 22 日在 Mid Stomack 库中添加了用于方形电位器的 MidPotHolderSquareV1。

2016年10月17日，在“如何启动MyRobotLab”中上传了两个zip文件，其中包含MyRobotLab的1.0.1723 KRAKEN工作版本，包含ProgramAB的所有手势和音频文件。此外，还包含一个批处理文件，用于启动MRL，自动抓取您指定的脚本并清除所有Java僵尸程序。此外，还添加了电池电量检查、人脸识别和多语言翻译功能（翻译需要身份证件和密钥）。

<h2>2017年：</h2>

2017年1月18日 将BatteryHolders升级至V5版本，方便连接电池。并添加了一个BatteryPusher。

2017年5月31日，将 GearHolderV1 修改为 V2，使表面旋转更平滑。同时将 ServoGearV1 和 MainGearV1 修改为 V2，使表面旋转更平滑。

2017年5月31日，在Back库中添加了USBCliker和USBRotater。这两个部件用于为联想8英寸平板电脑创建一个旋转底座。需要粘贴。

2017 年 10 月 20 日添加了所有不带机动装置的腿部文件，包括脚。

2017年10月25日，修改了ThighHighRight和Left，使其在零点处保持平坦。修改了LegHolderRight和Left，使其在零点处保持平坦。修改了KneeClampLeft，使其与KneeClampRight镜像。
 
2017 年 6 月 11 日修改了肩部和二头肌的许多部分，以 3D 打印滚珠轴承和调节螺丝，我还完全重新做了与这些部分相关的教程，新部件与旧部件反向兼容（而不是相反）：

<h3>二头肌：</h3>

HighArmSideV2 到 HighArmSideV3

LeftRotTitV3 至 LeftRotTitV4

RotGearV5 到 RotGearV6

RotMitV2 到 RotMitV3

RotTitV3 到 RotTitV4

RotWormV4 到 RotWormV5

RotcenterV2 到 RotcenterV3

leftRotcenterV2 到 leftRotcenterV3

reinforcerV1到reinforcerV2

<h3>肩膀：</h3>

LeftPivPotholderV2 至 LeftPivPotholderV3

PivGearV5 到 PivGearV6

PivMitV1 到 PivMitV2

PivPotholderV2 至 PivPotholderV3

PivWormV2 到 PivWormV5

PivcenterV1 到 PivcenterV3

leftPivMitV1 到 leftPivMitV2

leftPivcenterV1 到 leftPivcenterV3

2017 年 6 月 11 日添加了 RibonPusherV1 以避免与二头肌活塞产生摩擦。
 
2017年12月11日 将ThighLowRightV1修改为ThighLowRightV3，将ThighLowLeftV1修改为ThighLowLeftV3。修复了与KneeHigh部件不对齐的孔位置。并添加了KneeHigh部件的附件。

<h2>2018年：</h2>

17/02/18 将 Manticore 1.0.2693 更新至 1.0.2693.1 修复说话时下巴延迟的错误。

2018 年 7 月 3 日在 Galery/STL/Other-usefull-parts 中添加了 4 个部件，用于将 LowStomach 挂在战车上以运载机器人（图片）

Leg2-e1510780138725

HookLV1

HookRV1

LowStoHookLV1

LowStoHookRV1

2018年5月15日，基于鲍勃·休斯顿颈部的三轴原理，创建了一种新的颈部机械装置。它更加坚固，动作也更加流畅。它还能轻松拆卸头部。在画廊STL文件中创建了与新版本不完全兼容的旧版本文件夹。

NeckPistonBaseFrontV1

NeckPistonFrontV1

NeckPistonSideV1

NeckPistonV2

NeckPlateHighV2

NeckPlateV2

PistonBaseSideV2

NeckJointLowerV4

NeckServo HolderV2

NeckServoPivotV2

NeckV2

2018年5月16日，更新了几乎所有头部部件，使其表面更加光滑，并添加了更多螺丝固定器，以便更好地组装头骨。在图库STL中创建了与新版本不完全兼容的旧版本文件夹。

LowBackV4 到 LowBackV5

SideHearV3 到 SideHearV4

TopMouthV3 到 TopMouthV4

TopBackSkullV3 至 TopBackSullV4

TopSkullLeftV3 至 TopSkullLeftV4

TopSkullRightV3 至 TopSkullRightV4

为肩部添加了一些方形电位器支架。

2018年9月18日 修复了 Manticore 2693.5 中的 captureGesture 函数。修改了有关 captureGesture 的教程。

2018年7月10日 新增 BottomChestSonicV1。这使得机器人胸部两侧各可以安装一个 UltraSonic sr5。

<h2>2019年：</h2>

2019年12月2日 修复了德语 AIML 错误，并将 inmoov_Chatbot.aiml 和 inmoov_Gestures.aiml 翻译为德语。目前版本为 Manticore 2693.8。

2019 年 5 月 29 日将 lowarmsideV1 修改为 LowArmSideV2，以便同时提供圆形和方形电位器的选项。

2019年8月31日 修改了start_inmoov.sh，现在应该已经修复了Mac版本，现在是Manticore 2693.11。我还在custom.py和gesture.aiml中添加了一些示例脚本，用于通过语音控制点亮一些LED灯。

2019年2月9日 将新版本的 HomLowBack-V1 上传至 HomLowBackV2

2019 年 2 月 9 日 Manticore 2693.12 新版本，包括手指传感器的配置文件和 sensor.py 文件

05/09/19 Manticore 2693.13 的新版本，修复了我创建jukebox aiml 时的一个错误。

2019/07/09 Manticore 2693.14 新版本，

修复了法语 AIML 中的一些答案，并添加了法语版中缺少的 learnf.aiml，以便机器人学习新事物。

2019 年 9 月 16 日 Manticore 2693.15 的新版本，

修复了 start-inmoov.sh 以在安装期间使用 InMoov.patch 文件夹。

2019年10月11日 Manticore 2693.16 新版本发布，对手指传感器的配置文件和 sensor.py 文件进行了大量修改。添加了手指传感器的计时器。修改了手势 shakehand()、takeball() 和 studyball() 函数，使其能够使用手指传感器。添加了第二个超声波传感器的选项。更新了手指传感器的教程，并制作了超声波传感器的教程。
