idolverse/Tulingjiuge_robot_1/零件组装教程+stl文件/Eyes-i2-main/README.md

<h1>Eyes-i2</h1>

从图库下载 STL 文件。（已保存至眼睛STL文件）

在打印所有部件之前，您应该打印一份校准器 (CALIBRATOR)，以检查部件是否能够拼合。如果您在拼合这些部件时遇到困难，可以调整切片软件的水平扩展设置来解决这个问题。此设置可能因切片机和打印机而异，但用户报告称，将其设置为 -0.15 是一个不错的起点。

4 个伺服器 JX PDI 1109MG（避免使用廉价的 SG90，它们不会持续很长时间）
一只透明眼罩/保护套。请参阅旧眼罩教程，了解如何制作自己的眼罩。
1 张虹膜纸打印下载文件
微型相机（选择带自动对焦的type2）https://fr.aliexpress.com/item/1005004200917640.html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
3 x 十字槽头螺钉 2 x 6mm 自攻沉头螺钉
11 x 十字槽头螺钉 2 x 6mm 自攻螺钉
8 x 十字槽头螺钉 3 x 10mm 自攻螺钉
4 x 十字槽 1.5 x 7mm 自攻螺钉

i2Eyes为 1 个右眼打印的部件：

以下是头部所需的零件清单和打印数量：

1x Eye-R-AllPartsV2.stl
1x Eye-R-BaseV5.stl

打印填充率为 30%，壁厚为 2 毫米，如果您的打印机校准良好，则无需支撑。

i2Eyes教程





将主轴与底座组装在一起。



用胶水或2 x 6mm 自攻螺钉将主轴固定到底座上。



按下底座，两个伺服器并确保它们在软件中预设为 90°。（静止位置）。



使用 4 个3 x 10mm自攻 螺钉将伺服器固定到底座上。



安装第一个号角。



使用伺服器附带的 3 毫米螺丝固定喇叭。



安装第二个号角。



使用伺服器附带的 3 毫米螺丝固定第二个喇叭。



将侧臂添加到底座。



用胶水或 3 个2 x 6mm自攻螺钉将侧臂固定到底座上。



在侧基座上安装两个舵机。确保它们在软件中预设为 90°（静止位置）。然后安装两个舵角。



将侧底座组装到主底座上。



使用 3 个2 x 6mm自攻沉头螺钉 将侧底座与主底座固定在一起。确保它们完全位于沉头孔中，否则一旦安装在头部，它们可能会给您带来麻烦。



使用伺服器附带的 3 毫米螺丝固定两个喇叭。



使用4 个 3 x 10mm 自攻螺钉将伺服器固定到侧基座上。



将铰链安装到轴上。注意孔的设置，如图所示。



使用2 x 6mm 自攻 螺钉将部件固定在一起。铰链应能够自由旋转。



得到一个伺服轴。



使用2 x 6mm 自攻螺钉。不要将螺钉拧得太紧，轴的移动应该能够带动铰链旋转。



取出第二个伺服轴，用2 x 6mm 自攻螺钉组装小铰链。不要拧得太紧！



这就是我们要设置带有微型铰链的轴的位置。



这有点精细。你要把眼窝夹上去。眼窝很脆弱，所以要小心。组装完成后，它应该可以自由移动，左右上下。



现在用2 个 6 毫米自攻螺钉固定两个轴。



现在该添加摄像头了。摄像头的黑色丝带必须穿过眼窝底部的孔。



如果这样更方便的话，您可以在将眼球夹在眼窝上之前将相机压入眼球。


剪切并添加打印的虹膜到眼球间隙中。



如果您已经制作了透明护目镜，请小心地添加并粘贴。您可以在旧眼睛教程中看到如何创建自己的护目镜。



添加下眼睑。



使用1.5 x 7mm自攻螺丝。确保螺丝不要太长或太紧，以免眼球自由旋转。



添加上眼睑。



使用1.5 x 7mm 自攻螺钉。



添加两个伺服侧轴。



使用2个6毫米自攻螺钉。不要拧得太紧。



使用1.5 x 7mm 自攻螺钉将轴固定到眼睑上，不要拧得太紧。



连接摄像头驱动板，右眼就制作完成了！现在，您可以按照相同的顺序继续构建左眼。



i2Eyes 与 Myrobotlab 中的原有眼睛同步。这确保了当机器人向上看时，两只眼睛都会向上看；当机器人向下看、向右看或向左看时，两只眼睛也会向上看。

为此，您需要编辑位于 data/config/yourConfig/i01.head.eyeX.yml 中的配置，并添加如下所示的同步部分：



对 data/config/yourConfig/i01.head.eyeY.yml 执行相同操作：



<h1>眼罩制作教程</h1>

眼睛机制
眼部机构组装
这个新机制的灵感来自Mats Onnerby和Bob Houston。它取代了我之前的眼睛机制，你仍然可以在完成以下教程后找到它。

从图库下载 STL

在打印所有部件之前，您应该打印一份校准器 (CALIBRATOR)，以检查部件是否能够拼合。如果您在拼合这些部件时遇到困难，可以调整切片软件的水平扩展设置来解决这个问题。此设置可能因切片机和打印机而异，但用户报告称，将其设置为 -0.15 是一个不错的起点。

填充率为 30%，壁厚为 2 毫米，最好无筏，无支撑（除非另有说明），大部件使用边缘以避免翘曲。

您需要以良好的分辨率打印所有这些部分：

1x2xEyeBallFullV2
1xEyeHingeCurve
2xEyeHinge
1xEyeHolder
1xEyePlateLeft
1xEyePlateRight
1x EyeSupport (print with support)
1xEyeTo Nose

根据您选择的相机，打印：

EyeBallSupportHerculeLeft
EyeBallSupportHerculeRight
EyeBallSupportLifeCamHDLeft
EyeBallSupportLifeCamHDRight

我使用了 2 个 Hobbyking 的 DS929HV 伺服器，因为它们更强大，但您也可以使用一些 DS928HV 甚至一些便宜的 SG92R 或 HXT900。

您可以使用两种网络摄像头：

Hercules Twist 高清网络摄像头
LifeCam 3000 HD Microsoft（如果 PCB 相同，也可能是 5000）
拆解LifeCam 3000 HD：https ://astrophotovideo.wordpress.com/adapting-a-webcam-to-a-telescope/



提供法语视频教程，您可以通过 YouTube 设置获取英语字幕：
https://youtu.be/ibZgKFSIYjg

步骤1：



使用 2.5 毫米钻头重新钻 EyeToNose 上的所有孔。




用直径为 3 毫米的凸片盖住所有孔。





胶水，如果您有 ABS 打印件，则使用丙酮；如果您有 PLA，则使用环氧树脂，将 EyeToNose 和 EyeGlass 粘合在一起。



用 3 毫米突出部重新钻好 EyeSupport 的 4 个大孔之后的突出部。



用 3 毫米钻头重新钻 EyeHolder 的两个孔。



插入并安装四颗3毫米螺丝。您可以按照图示添加螺栓来固定它们。



用 3 毫米钻头重新钻好两个 EyeBallSupport 的孔后，按图示安装它们。此时，您还可以将 Hercules 摄像头添加到 EyeBallSupport 上。我的照片没有显示 HerculesHD 摄像头的安装，因为我当时正在尝试另一种摄像头。



这里我用的是微软的 LifeCamHD 3000。画质似乎不如 Hercules Twist HD。需要注意的是，由于摄像头的 PCB 是水平放置的，所以 EyeBallSupport 有所不同。

步骤2：


使用螺丝安装 Hobbyking 的一个 DS929HV 伺服器。





将伺服器设置为 0 度，并将喇叭设置如图所示。



安装第二个伺服器 DS929HV。



将伺服器设置为 0 度，并将喇叭安装在类似于 45 度角的位置。



添加带有两个直径为 3 毫米的螺丝的 EyeHolder。



并将该机构固定到 EyetoNose 上。安装完成后，它应该能够绕轴自由旋转。



将 EyeHingeCurve 安装并拧紧在伺服喇叭和 EyeToNose 之间。这样，该机构应该能够在其轴上自由旋转。





在 EyeBallSupport 的背面添加 EyePlates。你可以用胶水粘住它们，也可以用螺丝拧紧。





安装并拧紧顶部伺服器和眼板之间的两个眼铰链。

步骤3：
现在我们将通过几个简单的步骤创建一些逼真的眼睛。



拧下 EyeToNose 的两个螺丝，卸下机械装置，以便接触眼睛的前部。



这是一套完整的 EyeBall 套装。

以下是戒指订单安排：



现在让您的创造力尽情发挥吧！！



喷漆或用你喜欢的彩色马克笔在瞳孔环上画一个底色。我用的是哑光蓝色喷漆。你也可以打印IrisEye 文件并剪下来。



用另一支细细的黑色马克笔，从中心向外画几条细线。正如我图片所示，画得并不完美。但如果你足够优秀，并且富有创意，你真的可以画出非常逼真的作品。



在这个外圈上也用细记号笔添加一些小线条。



用黑色喷漆完成虹膜环。



现在将所有环组装在一起。



你也可以用智能手机的鱼眼镜头替换外圈、瞳孔和虹膜。但看起来不太真实。



为了让眼睛更加逼真，让我们发挥创意吧！现在我们要制作眼睛的透明盖。



您将需要一把热风枪，一个直径约 3 厘米的玻璃球（我用了我妻子的“Dior, J'adore”香水瓶盖，太漂亮了！！您还需要一块热成型塑料（水晶透明更好，否则会改变相机视觉效果）我个人使用了一块灯泡泡罩。但是任何水晶泡罩都可以完成这项工作。



清洁所有表面，以确保在热成型过程中不会因灰尘或划痕而改变透明塑料。



将热风吹在塑料上，当它开始变软时，将其涂抹并拉伸到玻璃球上。等待冷却。



使用瞳孔环标记圆圈，然后用剪刀剪出扁针。



在周边添加一点胶水，小心清洁并避免在内表面留下手指痕迹。



将扁豆粘在瞳孔环上。让它干燥。

对第二只眼睛做同样的事情。



将机械装置重新安装到 EyeGlass 上。好了，你有一个令人印象深刻的 InMoov！



现在您可以将整个面部和眼部机械装置安装到头部了。请参阅硬件图来检查默认的伺服位置。确保没有线缆阻碍眼部机械装置在 X 和 Y 方向上旋转。
