idolverse/Tulingjiuge_robot_1/零件组装教程+stl文件/Hand_i2-main/README.md

## 手i2

从图库下载 STL 文件：i2RightHand i2LeftHand。

在打印所有部件之前，您应该打印一份校准器 (CALIBRATOR)，以检查部件是否能够拼合。如果您在拼合这些部件时遇到困难，可以调整切片软件的水平扩展设置来解决这个问题。此设置可能因切片机和打印机而异，但用户报告称，将其设置为 -0.15 是一个不错的起点。

以下是一只右手所需的零件清单和打印数量：

1个i2_CoverFingerV3

1x i2_FingersMoldX5V3

1个 i2_FingersTipX5V2

1个i2_FingersX5V1

1x i2_HandCoverV1

1个i2_PalmCoverV2

1x i2_PulleyX5V1

1x i2_WristGearV1

1个 i2_WristLargeV2

打印腕部大件、手指模具、手指、腕带、滑轮，最大分辨率 0.25，填充率为 30%，壁厚为 2 毫米，无支撑，无筏。

打印 CoverFinger、FingersTip、HandCover、PalmCover，最大分辨率 0.25，填充率为 30%，壁厚为 2 毫米，需要支撑，如果打印机需要，则需要筏。

物料清单：

25个沉头螺钉M3 x 16mm

5 个 M3 x 4mm 沉头螺钉

1 个 M3 x 12mm 沉头螺钉

5 个平头螺钉 M1.5 x 4mm

5个膨胀弹簧3/16英寸x1-3/4或4.8毫米x44.5毫米

6x舵机 JX-6225MG 300度

1x 带状线 16 根 3 米

1 条编织鱼线 0.8 毫米 200 磅，3 米

5个霍尔传感器AH3503

5x 圆盘磁铁直径 2.5mmx1mm

1x 特氟龙管 ID1.5MM X OD2.5MM，3米

<h2>步骤1</h2>



将腕部伺服支架粘到 RobCableFront 上



用 4 个螺钉安装伺服电机



如果需要，用 M3 钻头重新钻孔



重新钻孔，以便 M3 PTFE 管穿过它们



使用 M3 钻头重新钻孔



将两个轴打印部件粘合在一起



检查以确保轴正确安装在两个印刷齿轮中



将 RobCableFront 和伺服支架安装到伺服床上



此视图向您展示了 WristGear 的组装以及各个部件如何组合在一起



将舵机角度设置为大约 90 度（HK15298B）或 150 度（JX-6225MG）。（即舵机总角度的中间值）。您可以使用此脚本(见脚本.txt)进行设置。用 3 毫米螺钉将组件末端安装到舵机轴上。



用 4 颗螺丝将组件拧到手腕上



按图示组装主齿轮



注意小齿轮的头部必须适合 RotaWrist2 的预留孔



使用 M3 螺丝刀将主齿轮与 RotaWrist3 对齐，然后添加 M3 x 12 毫米螺钉将它们固定在一起



删除那块打印的预支撑，你不再需要它了



用锋利的刀片，必要时清理边缘





使用 M8 钻头重新钻孔 WristLarge



使用 M3 丝锥，在将要固定手盖的地方准备一些 M3 x 16 毫米螺丝孔



使用 M3 丝锥，为安装弹簧的 M3 x 16 毫米螺钉准备孔



使用 M3 钻头，清理连接每个手指的所有孔



用M3钻头，将所有手指每3节的孔全部清理干净



用锋利的刀片清理霍尔传感器的出口



使用 M1.5 钻头，清理弹簧末端连接的孔



用填充物时，确保每个手指的三个部分都贴合，并且移动起来非常顺畅。这对于手指的良好功能至关重要。





使用 M5.5 钻头清理手指部分，让弹簧正常穿过



使用 M5.5 钻头清理手指部分，让弹簧正常穿过



这是为了向您展示如何将弹簧和三根传感器线安装在每个手指部分



确保针头可以穿过每个手指部分，如图所示，否则清理孔



使用 M3 x 16 毫米螺钉和螺栓将手指部分添加并安装在一起



确保编织鱼线的入口也清理干净



准备 5 条长度为 50 厘米的编织鱼线（0.8 毫米 200 磅）如果您在谷歌搜索中输入这些关键词，就可以找到该产品：编织鱼线 0.8 毫米 200 磅



准备一条40厘米长的带状电缆。你可以在谷歌搜索关键词：带状电缆 16 针（尽量选择最柔软、最细的）。



将丝带分成两部分，一部分长 40 厘米，有 6 根电线，另一部分长 10 根电线



从10根电线中完全移除1根电线。将9根电线分成三段，每段3根电线，长度均为15厘米。



用红色记号笔，给每个部分的一根电线涂上颜色。我们假设这些是正极 (+) 线



在丝带的两端都涂上这些颜色，这对于避免在进行最后的焊接时混合电线非常有用。



穿过腕部大号每 5 个丝带部分



将丝带穿过每个手指，注意不要倒着穿。另外要注意，每个手指的形状都差不多，只有拇指的形状不同。



现在把编织好的鱼线穿过每个手指。为了让鱼线末端更硬，可以加一些强力胶。



在 1 厘米长的编织钓鱼线上涂上强力胶。



等到它完全干燥后，从中间切开粘合部分，这样可以确保尖端坚固而纤薄。



通过将钓鱼线拉入指尖的 V 形凹槽，即可将其固定



现在将鱼线的另一端插入手腕大孔中



这是给你展示一下它应该是什么样子。我的照片上还没做拇指，不过你可以做。五个手指可以同时做。



如果你还没有这样做，请清理 3 毫米螺栓外壳，以便进行下一步



现在是时候添加 M3 x 16 毫米螺钉及其相应的螺栓，将手指组装到大腕上。从大拇指开始，然后是食指、无名指、小指，最后是拇指。



使用合适的 M8 印刷螺栓将 WristLarge 安装到 RotaWrist3



将微型夹具设置在打印螺栓的凹槽上



穿过主齿轮的最大丝带



然后穿过主齿轮第二条丝带



放置掌上盖并用 3 颗 M3 x 16 毫米螺钉固定



拧紧掌上盖时，确保将丝带整齐地放入凹槽中，并真正避免夹住它们



现在将 M2.5 PTFE 管穿过主齿轮特氟隆管 ID1.5MM X OD2.5MM PTFE 管的长度如下：拇指 335mm 食指 300mm 中间 300mm 无名指 300mm 小指 360mm

特氟隆管 ID1.5MM X OD2.5MM：https://fr.aliexpress.com/item/32730855848.html?spm=a2g0s.9042311.0.0.3b966c37jungcW



将管子穿过伺服底座孔。管子距离伺服轴约 1.5 厘米。



将鱼线穿过管子





并将管子的末端放入预留的孔中，直到无法再插入为止



对每根手指重复操作



现在获得 5 个弹簧弹簧 3/16″x1-3/4

弹簧 3/16″x1-3/4：https://www.ebay.com/p/19011685359



将一根鱼线穿过弹簧的一侧。鱼线总长度约为30厘米



将鱼线穿过主指部分的弹簧孔



将弹簧穿过第二个手指部分



取 5 个小螺丝，我用了一些安装在眼部机构中的伺服器上的螺丝，这些螺丝的直径约为 2 毫米





用钳子将螺丝剪至最大总长度为 4 毫米



将弹簧固定到位



装上那个小螺丝，把弹簧固定到位。确保螺丝没有刺穿三根带状电线



获取或切割五颗 3 毫米、最大长度为 4 毫米的螺钉



拉动鱼线，将弹簧头固定到位，然后安装螺丝。注意，我在螺丝刀上放了一块黑色磁铁，这样可以方便安装螺丝。



拧紧螺丝之前，先将鱼线拉出来



完成拧紧。确保没有刺穿三根带状电线



拿两根针



将手指的最后一部分最大限度地折叠起来，并将第一根针穿过手指和弹簧，直到它从另一侧出来。



折叠手指的第二节，并将第二根针穿过手指和弹簧，直至完全穿过。这样可以为每个手指节设置合适的张力。



用小钳子剪断针头



滴一滴强力胶，确保针头不会再出来



是时候用拇指做同样的事情了，只有两个手指部分，所以弹簧的张力较小，不需要针



拇指的另一个不同之处在于，我们将螺丝拧入盖子中，从而将弹簧固定到位。确保不要刺穿电线。虽然我的图片显示已经装好了拇指盖，但先不要装上，你仍然需要接触到内部。



让我们把霍尔传感器焊接到电线上。开始焊接中间的电线。注意传感器在图片上的位置，因为一侧是正极，另一侧是负极。霍尔传感器 AH3503

霍尔传感器 AH3503：https://fr.aliexpress.com/item/32899671134.html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





用一小块胶带保护焊锡。我用的是Kapton胶带。这部分操作比较精细。



焊接第二根和第三根电线并用胶带包裹起来



缠绕胶带时，胶带的厚度不应超过丝带本身的厚度，否则下一步将其推下去会很困难。



小心地将其推回指尖



这是指尖应该伸出的长度



你可以拉动手掌中的电线，帮助自己将霍尔传感器推回到尖端



将钓鱼线缠绕在凹槽周围，然后小心地将手指末端拧到传感器上。



注意，手指末端印有小螺纹，可以顺时针旋转至指尖。请勿用力过猛，否则螺纹会损坏。



完成每个手指的操作。



你可以用一些 16x3mm 的螺丝安装手指盖。虽然我的图片显示手指盖已经装好了，但先不要装，你仍然需要打开内部。



是时候把每根线焊接到 NervoBoard 的传感器板上了。拇指放在“0”上，食指放在“1”上，大拇指放在“2”上，无名指放在“3”上，小指放在“4”上。



您可以在此页面上查看有关传感器连接的更多信息：https://inmoov.fr/test-your-finger-sensor/



这里你可以看到我放置迷你模拟板的位置。你还可以在滑轮上看到，带小垫圈的螺丝是如何将鱼线用一个结固定住的。要做到这一点，你需要在你想要剪断鱼线的地方涂上一些胶水。



要做到这一点，你需要在你想要剪断的编织线上涂点胶水，让接触胶固化。胶水可以让剪断更容易。



然后，用锋利的剪刀剪掉涂有胶水的地方。



按照我在图中的方式拉动你的钓鱼线，它应该会形成一个大结。



拧紧结，将螺钉和垫圈放在结上，并在拧紧螺钉时保持结被拉住。



模具中有一个孔，用于插入直径为2毫米的部件，以便在模制硅胶中形成一个复位，以便磁铁复位。圆盘磁铁直径为2.5毫米x1毫米。

圆盘磁铁直径为2.5毫米x1毫米：https://www.supermagnete.fr/eng/disc-magnets-neodymium/disc-magnet-2.5mm-1mm_S-2.5-01-N52N



让它穿过2毫米。我使用了双组分透明RTV硅胶Ecoflex™ 00-10



用硅胶套件将每个指尖上的模制部件粘合起来



用指南针确定磁铁的南极。



将磁铁的南极朝向霍尔传感器，插入硅胶模制尖端的复位孔中。请使用木质牙签，因为任何金属工具都会粘在磁铁上。这项工作很精细，必须操作到位才能获得正确的结果。用一滴硅胶套装固定磁铁位置，并等待其干燥。使用此页面https://inmoov.fr/test-your-finger-sensor/测试您的传感器。

## 如何使用手指传感器

手指传感器可以用于各种功能。抓取鸡蛋或瓶子需要不同的压力。握手也需要检测施加的压力。触摸传感器有很多种实现方法，我做过两个版本，成本都非常低。带霍尔传感器的版本比原来的泡沫版本精确得多。

概括：

电子版（2 个版本）
设置
利用率

**带霍尔传感器的电子装置**

-此版本采用霍尔传感器和磁铁完成。

-当磁铁靠近霍尔传感器时，传感器会测量该值。

-该值被发送到模拟 Arduino 引脚。

-手部教程中解释了手指上传感器的组装。







**电子泡沫传感器**

- 手指传感器的原始版本是用 2 块铜板连接到一块防静电泡沫制成的。

-当泡沫被压缩时，两块铜板之间的电流流动更强。

-模拟 Arduino 引脚检测变化。

-手部教程中解释了手指上传感器的组装。





**设置**

打开 InMoov/config/ service_J_SensorFinger.config并进行如下设置。

[MAIN]

rightHandSensorActivated=True
rightHandSensorArduino=right

right_thumb_Psi_min=544当传感器未按下时，请在此处输入最大值。
right_thumb_Psi_low=545一般情况下，取最小值，如果使用 AH3503 霍尔传感器，则加 1。
right_thumb_Psi_mid=547一般情况下，取最小值，加 4。
right_thumb_Psi_max=550一般情况下，取最小值，加 7。

right_index_Psi_min=538
right_index_Psi_low=539
right_index_Psi_mid=542
right_index_Psi_max=545

添加每个手指传感器的值……

要检查手指传感器是否工作正常并查看其值，您可以在 Python 窗口中输入并执行：

sensorTimerStart()

并在 python 选项卡中查看结果。

您可以使用以下方法关闭传感器定时器：

sensorTimerStop()

**利用率**

<h2>我们有三个选择：</h2>

1-如果您已经设置了传感器配置文件，某些手势将自动使用传感器。

2-直接在 Arduino 上使用代码进行测试。

3-使用 MyRobotLab 中的 Python 代码进行测试。（如果您没有运行 START_INMOOV）

<h3>第一个选项：</h3>

shakehands()当手闭合时，手势将自动使用传感器。

您可以将手势所需的压力调整为 0 到 3 之间的值。当传感器达到所需压力时，手指伺服器将停止其位置并禁用。

if rightHandSensorActivated:
    rightHandSensorON()
    sleep(1.5)
    rightThumbPressure=1 # Pressure range between 0-3
    rightIndexPressure=1
    rightMajeurePressure=1
    rightRingFingerPressure=1
    rightPinkyPressure=1
    i01.rightHand.moveTo(79,170,180,180,180,180)
    sleep(2)
    rightHandSensorOFF()
else:
  i01.rightHand.moveTo(79,90,140,130,122,180)

<h3>第二种选择：</h3>

-将此代码上传到您的 Arduino 板：

// A small script to test one servo and one sensor.

// Connect one sensor cable to the PIN A0, and the other cable
// to the 5V of your Arduino.
// The servo will be connected to your power supply (Gnd,Vcc)
// and to the PIN 2 of your Arduino.
// Set the serial of your Arduino at 57600 in device manager
// More detail on connection here https://inmoov.fr/test-your-finger-sensor
    
#include <Servo.h>

const int servoPin = 2;
const int sensorPin = A0;
int sensorReading;

int position;

Servo myservo;

void setup(){
  Serial.begin(57600);
  myservo.write(30);  // Closed claw.
  position = 30;
  myservo.attach(servoPin );
}

void loop(){
  sensorReading = analogRead(sensorPin);
    Serial.print("Analog reading = ");
    Serial.print(sensorReading); // the raw analog reading
    // We'll have a few threshholds, qualitatively determined
    if (sensorReading < 25) {
    Serial.println(" - No pressure");
    } else if (sensorReading < 30) {
    Serial.println(" - Light touch");
    } else if (sensorReading < 50) {
    Serial.println(" - Light squeeze");
    } else if (sensorReading < 110) {
    Serial.println(" - Medium squeeze");
    } else if (sensorReading < 200) {
    Serial.println(" - Big squeeze");
    }
    delay(1000);
  openClaw();
  delay(3000);
  closeClaw();
  delay(3000);
}

void openClaw() {
  for (; position < 130;  position++) {
    myservo.write(position);
    if(analogRead(sensorPin) > 30)
      break;
  }
}

void closeClaw() {
  myservo.write(30);  // Go to open position
  position = 30;
}

- 连接传感器（以 FSR 传感器为例）和伺服电机。有些伺服电机需要的电流过大，无法直接由 Arduino 供电。如果您的伺服电机抖动或运动不稳定，请为伺服电机连接一个额外的电源，并确保将 Arduino 连接到该额外的电源，如下所示：



-当通电时，手指会自动缓慢闭合，如果传感器检测到压力，则会在 Arduino.exe 监视器中显示信息。

-您可能需要更改代码中的传感器值以达到更好的调整。

为此，请检查监视器上的结果并根据需要直接在代码中更改这些值：

(sensorReading < 25)
(sensorReading < 30)
(sensorReading < 50)
(sensorReading < 110)
(sensorReading < 200)

<h3>第三种选择：</h3>

这里我们假设您已经安装了 MyRobotLab 并且知道如何使用它，如果没有，请先转到此页面。

-双击 MRL 目录中的“myrobotlab.jar”启动 MyRobotLab。

-按照第一个选项教程中的图像，在 Arduino 和伺服电机之间建立相同的连接。

-将此 python 脚本复制并粘贴到 MyRobotLab 中的 python 选项卡。

#这个简单的传感器 InMoov 脚本在 MyRobotLab 版本 1.0.2693 上进行了测试
#可以通过 Oscope 和手指动作看到结果。
#将一根传感器电缆连接到 PIN A0，将另一根电缆连接到 Arduino 的 5V。
#Servo 将连接到 Arduino 的引脚 2。
#根据您的Arduino板更改代码中的COM端口。

leftPort = "COM10"

Voice="US-English_Matthew"
mouth = Runtime.createAndStart("i01.mouth", "NaturalReaderSpeech")
#mouth.installComponentsAcceptLicense(Voice)
mouth.setVoice(Voice)
mouth.setRate(-10)

i01 = Runtime.createAndStart("i01", "InMoov")
i01.startMouth()
leftHand = Runtime.create("i01.leftHand","InMoovHand")
i01.startLeftHand(leftPort)
i01.leftHand.index.map(0,180,25,165)

left=Runtime.create("i01.left", "Arduino")
left.setBoard("atmega2560")
left = Runtime.start("i01.left", "Arduino")
left.connect("COM10")

def publishPin(pins): 
    for pin in range(0, len(pins)):
        print pins[pin].address, pins[pin].value
        if pins[pin].value<=540:
          print "No pressure"
        if pins[pin].value>=541 and pins[pin].value<=542:
          print "Low pressure"
        if pins[pin].value>=543 and pins[pin].value<=544:
          print "Soft pressure"
          FingerGoesBack()
        if pins[pin].value>=545:
          print "High pressure"
          FingerGoesBack()
          i01.mouth.speak(u"OUCH, that hurts") 
 
left.addListener("publishPinArray","python","publishPin")
sleep(5)
left.enablePin(54,1) # 54 is pin A0, Number 1 is how many polls/second

i01.leftHand.setAutoDisable(True)

def moveFingerSlowly():
    i01.leftHand.index.enable()
    i01.leftHand.index.setVelocity(25)
    sleep(2)
    i01.leftHand.index.moveTo(180)

def FingerGoesBack():
    i01.leftHand.index.enable()
    i01.leftHand.index.setVelocity(-1)
    i01.leftHand.index.moveTo(0)
 
#此简单的 InMoov 传感器脚本已在 MyRobotLab 1.1.812 版本上测试。
#结果可在 Oscope 中通过手指动作查看。
#将一根传感器线缆连接到 Arduino 的 A0 引脚，另一根线缆连接到 Arduino 的 5V 接口。
#伺服器将连接到 Arduino 的 2 引脚。
#根据您的 Arduino 开发板更改代码中的 COM 端口。

Voice="Mark" 
i01_mouth = Runtime.start("i01.mouth", "MarySpeech") 
#i01_mouth.installComponentsAcceptLicense(Voice) 
i01_mouth.setVoice(Voice) 

i01_left=Runtime.create("i01.left", "Arduino") 
i01_left.setBoard("atmega2560") 
i01_left = Runtime.start("i01.left", "Arduino") 
i01_left.connect("COM3") 

i01 = Runtime.start("i01", "InMoov2") 
i01.startMouth() 
i01_leftHand = Runtime.start("i01.leftHand","InMoov2Hand") 
i01_leftHand_index.map(0.0,180.0,0.0,180.0) 
i01_left.attach("i01.leftHand") 

def publishPin(pins):
    对于范围内的引脚（0，len（pins））：
        打印 pins[pin].address，pins[pin].value
        如果 pins[pin].value<=540：
          打印“无压力”
        如果 pins[pin].value>=541 且 pins[pin].value<=542：
          打印“低压”
        如果 pins[pin].value>=543 且 pins[pin].value<=544：
          打印“轻压” 
          FingerGoesBack()
        如果 pins[pin].value>=545：
          打印“高压” 
          FingerGoesBack() 
          i01.mouth.speak(u“哎哟，好疼”）
 
i01_left.addListener("publishPinArray","python","publishPin") 
sleep(5) 
i01_left.enablePin(54,1) # 54 是引脚 A0，数字 1 是每秒轮询次数

i01_leftHand.setAutoDisable(True) 

def moveFingerSlowly（）：
    i01_leftHand_index.enable（）
    i01_leftHand_index.setSpeed（25）
    睡眠（2）
    i01_leftHand_index.moveTo（180）

def FingerGoesBack（）：
    i01_leftHand_index.enable（）
    i01_leftHand_index.setSpeedy（250）
    i01_leftHand_index.moveTo（0）

-当通电时，手指会自动缓慢闭合，如果传感器检测到压力，它会在 Python 监视器中显示信息，并停止闭合并说出与他感受到的压力相关的内容。

-您可能需要更改代码中的传感器值以达到更好的调整。

为此，请检查监视器上的结果并根据需要直接在代码中更改这些值：

value<=540
value>=541
value<=542
value>=543
value<=544
value>=545
