idolverse/Tulingjiuge_robot_1/零件组装教程+stl文件/Back-main/后背3D打印草图/Back assembly 3D views - InMoov.html

# Back assembly 3D views

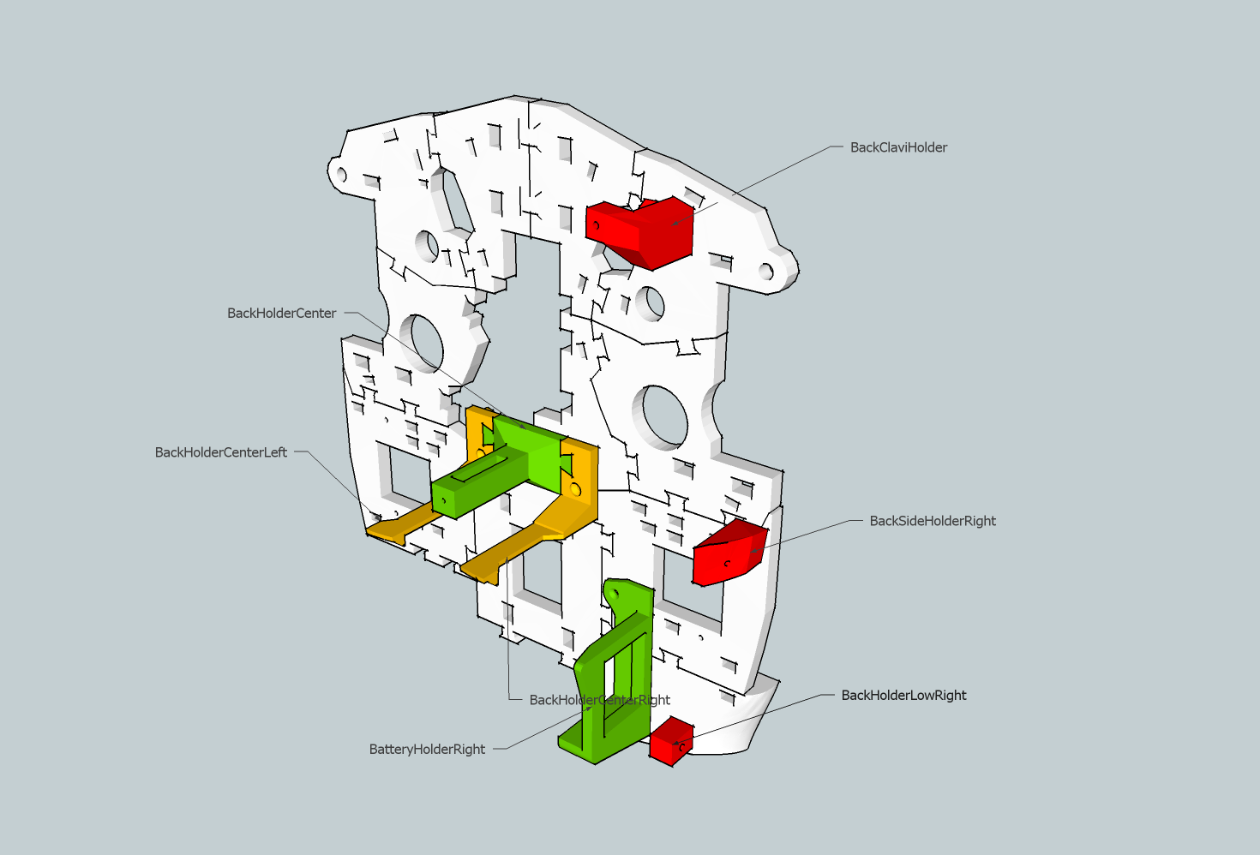
[picture p173: 零件组装教程+stl文件/Back-main/后背3D打印草图/Back assembly 3D views - InMoov_files/BackView1.png]
BackView1
 (https://inmoov.fr/back-assembly-3d-views/backview1/#main)Back side assembly view (1) by Gael

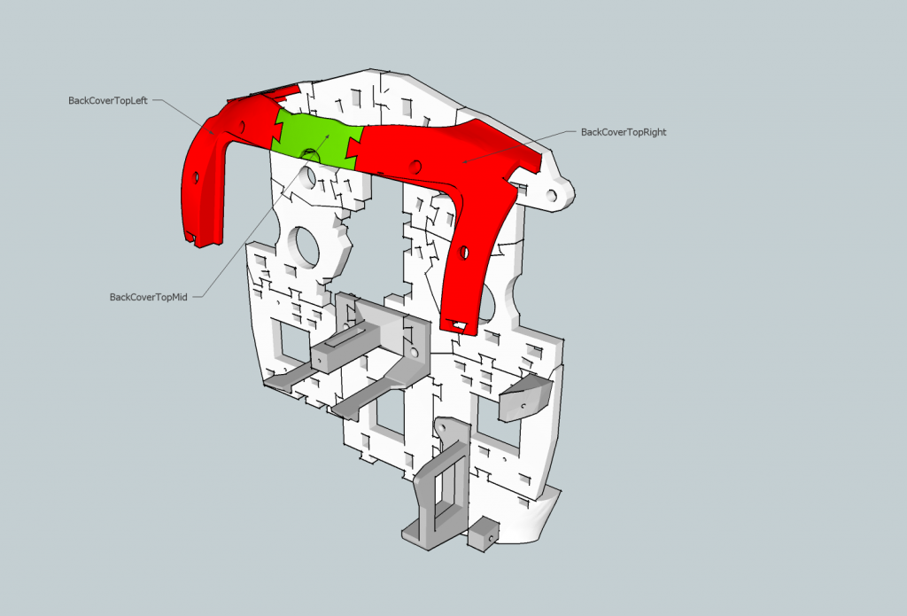
[picture p174: 零件组装教程+stl文件/Back-main/后背3D打印草图/Back assembly 3D views - InMoov_files/BackView2-1024x695.png]
BackView2
 (https://inmoov.fr/back-assembly-3d-views/backview2/#main)Back side assembly view (2) by Gael

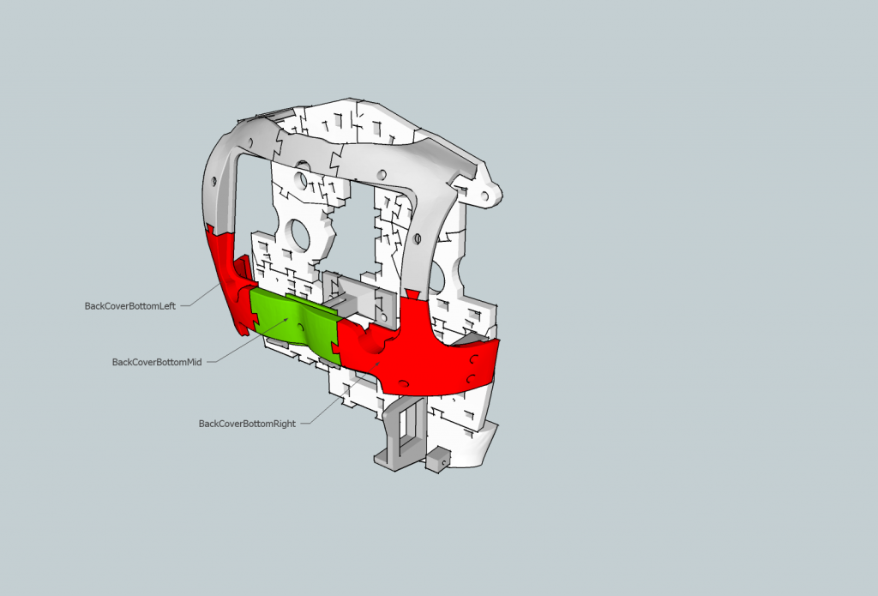
[picture p175: 零件组装教程+stl文件/Back-main/后背3D打印草图/Back assembly 3D views - InMoov_files/BackView3-1024x695.png]
BackView3
 (https://inmoov.fr/back-assembly-3d-views/backview3/#main)Back side assembly view (3) by Gael

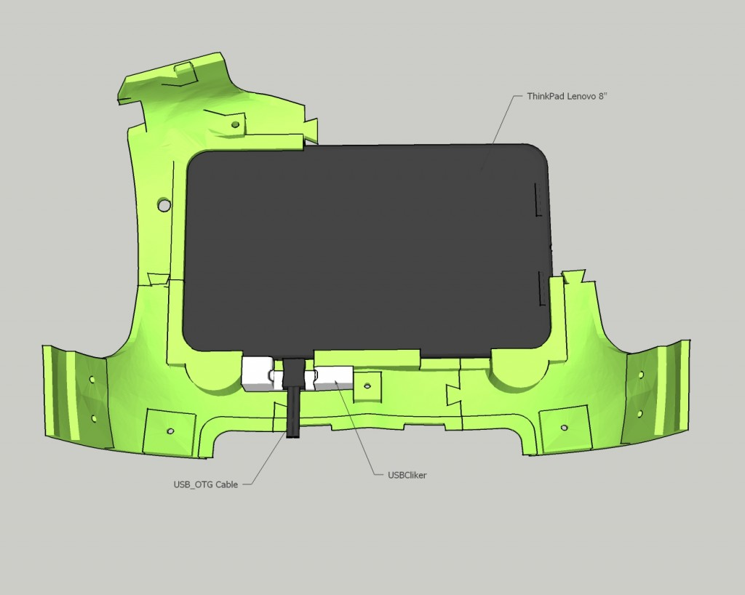
[picture p176: 零件组装教程+stl文件/Back-main/后背3D打印草图/Back assembly 3D views - InMoov_files/USBClikerView1-1024x818.jpg]
USBClikerView1
 (https://inmoov.fr/back-assembly-3d-views/usbclikerview1/#main)

Docking for USB OTG Cable Cliker to be glued

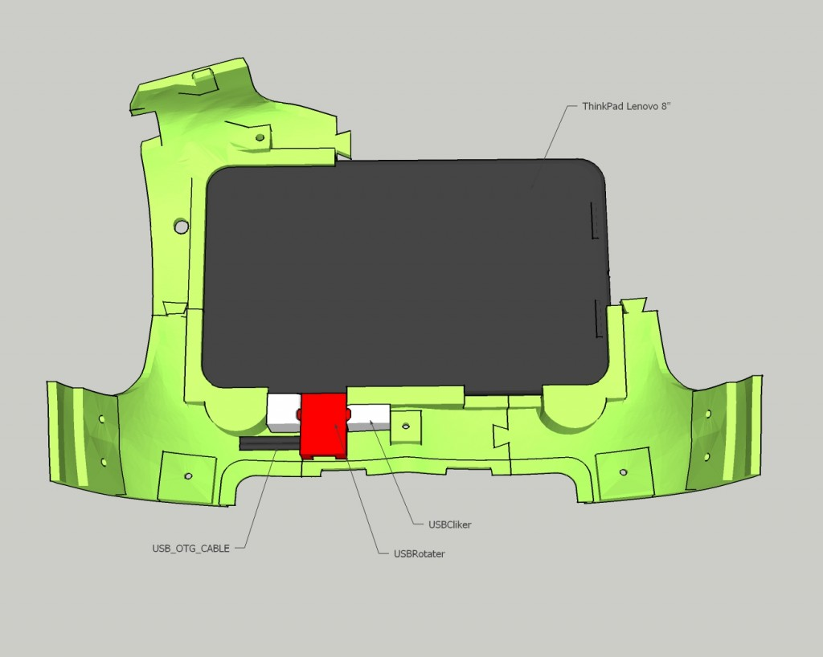
[picture p177: 零件组装教程+stl文件/Back-main/后背3D打印草图/Back assembly 3D views - InMoov_files/USBRotaterView1-1024x818.jpg]
USBRotaterView1
 (https://inmoov.fr/back-assembly-3d-views/usbrotaterview1/#main)Docking for USB OTG Cable Rotater to be clipped

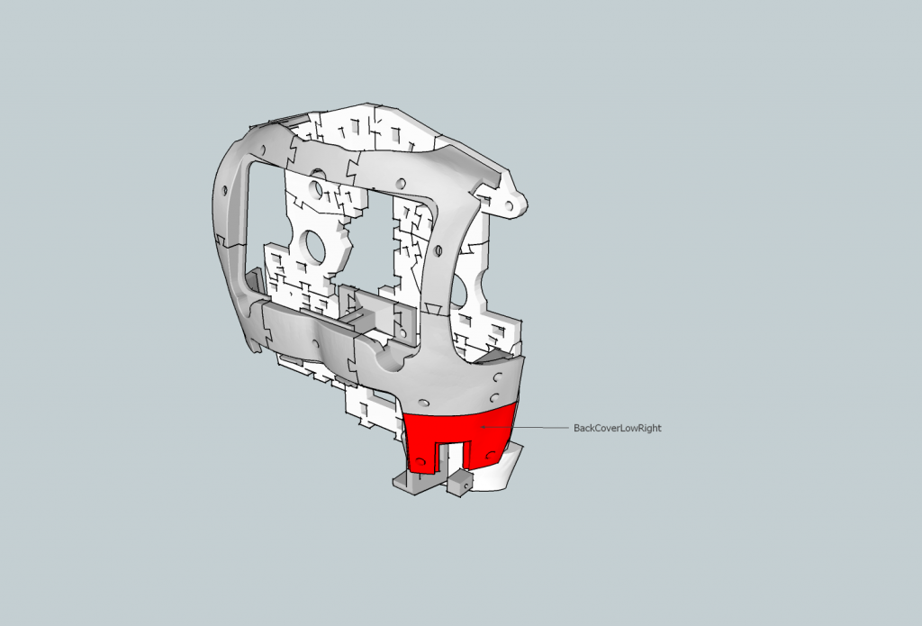
[picture p178: 零件组装教程+stl文件/Back-main/后背3D打印草图/Back assembly 3D views - InMoov_files/BackView4-1024x695.png]
BackView4
 (https://inmoov.fr/back-assembly-3d-views/backview4/#main)Back side assembly view (4) by Gael

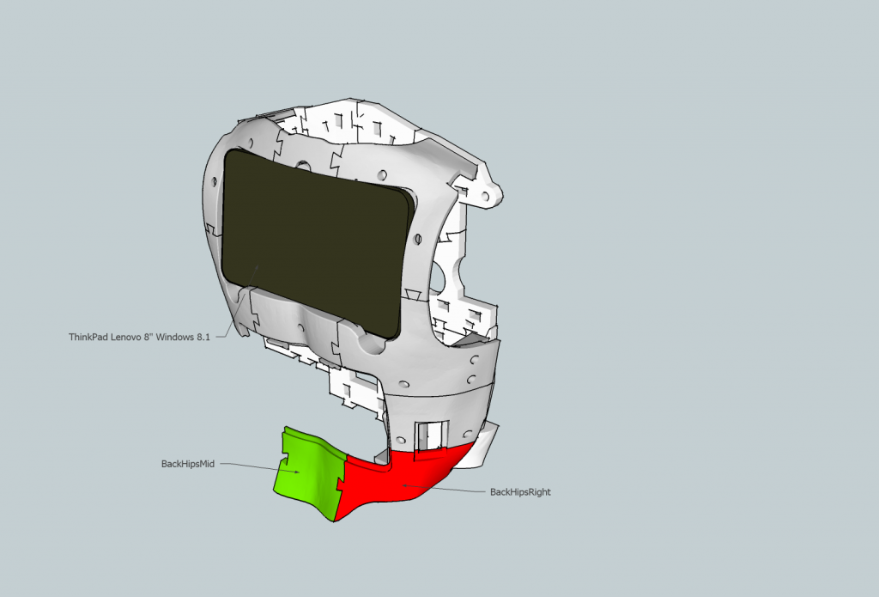
[picture p179: 零件组装教程+stl文件/Back-main/后背3D打印草图/Back assembly 3D views - InMoov_files/BackView5-1024x695.png]
BackView5
 (https://inmoov.fr/back-assembly-3d-views/backview5/#main)Back side assembly view (5) by Gael

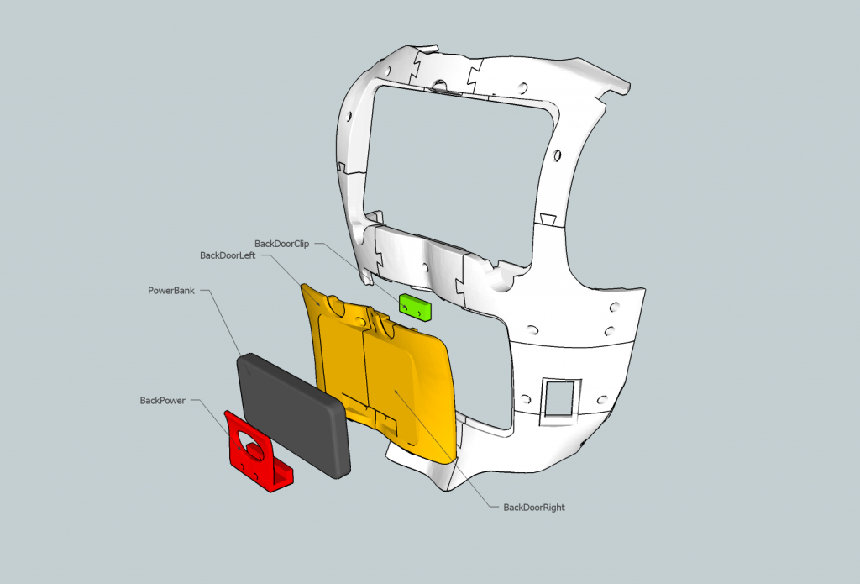
[picture p180: 零件组装教程+stl文件/Back-main/后背3D打印草图/Back assembly 3D views - InMoov_files/BackView7-1024x695.png]
backview7
 (https://inmoov.fr/back-assembly-3d-views/backview7/#main)Back side assembly view (6) by Gael

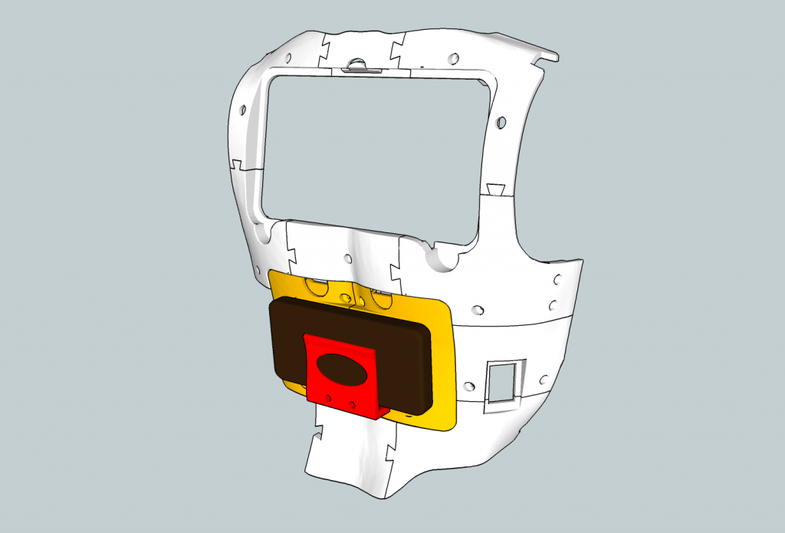
[picture p181: 零件组装教程+stl文件/Back-main/后背3D打印草图/Back assembly 3D views - InMoov_files/BackView6-1024x695.png]
backview6
 (https://inmoov.fr/back-assembly-3d-views/backview6/#main)Back side assembly view (6) by Gael

### Comments 1

1. 
  mario (https://inmoov.fr/members/m-abajo/) July 30, 2019 at 10:05 am (https://inmoov.fr/back-assembly-3d-views/#comment-11632)
  muy utiles los 3D .Gracias
  Log in to Reply (https://inmoov.fr/wp-login.php?redirect_to=https%3A%2F%2Finmoov.fr%2Fback-assembly-3d-views%2F)

### Leave a Reply

You must be logged in (https://inmoov.fr/wp-login.php?redirect_to=https%3A%2F%2Finmoov.fr%2Fback-assembly-3d-views%2F) to post a comment.

## Help Me Experiment

PayPal - The safer, easier way to pay online! (https://www.paypal.com/donate/?hosted_button_id=RDAQJGR788RHC)

BACK to BUILD YOURS tutorial Index (https://inmoov.fr/build-yours/)

# BACK COVER

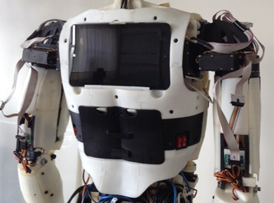
[picture p182: 零件组装教程+stl文件/Back-main/后背3D打印草图/Back assembly 3D views - InMoov_files/inmoov-back.jpg]


## Assembly Help

- Back assembly (https://inmoov.fr/back/)
- 3D view assembly (https://inmoov.fr/back-assembly-3d-views/)

## Download 3D parts (.stl)

- Back cover (https://inmoov.fr/inmoov-stl-parts-viewer/?bodyparts=Back) | view STL (https://inmoov.fr/inmoov-stl-parts-viewer/?bodyparts=Back)

 (https://creativecommons.org/licenses/by-nc/3.0/)

Tweets by InMoov (https://twitter.com/InMoov?ref_src=twsrc%5Etfw)

(https://inmoov.fr/back-assembly-3d-views/#)

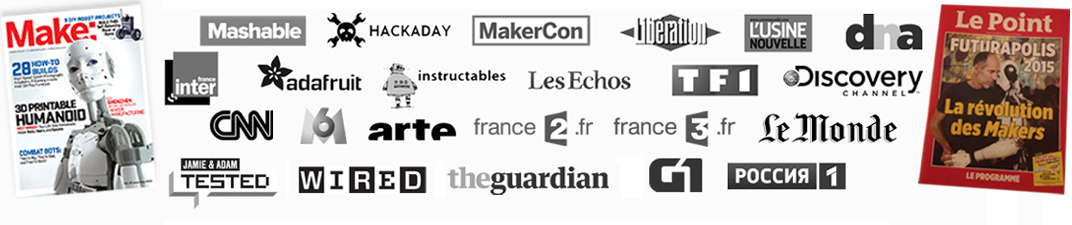
[picture p183: 零件组装教程+stl文件/Back-main/后背3D打印草图/Back assembly 3D views - InMoov_files/referencesv2.jpg]
Discover InMoov Press Release all other the World
### Press Release  (https://www.inmoov.fr/on-the-net/)

CleanTalk Pixel
