idolverse/Tulingjiuge_robot_1/零件组装教程+stl文件/A合并文件示意表.docx

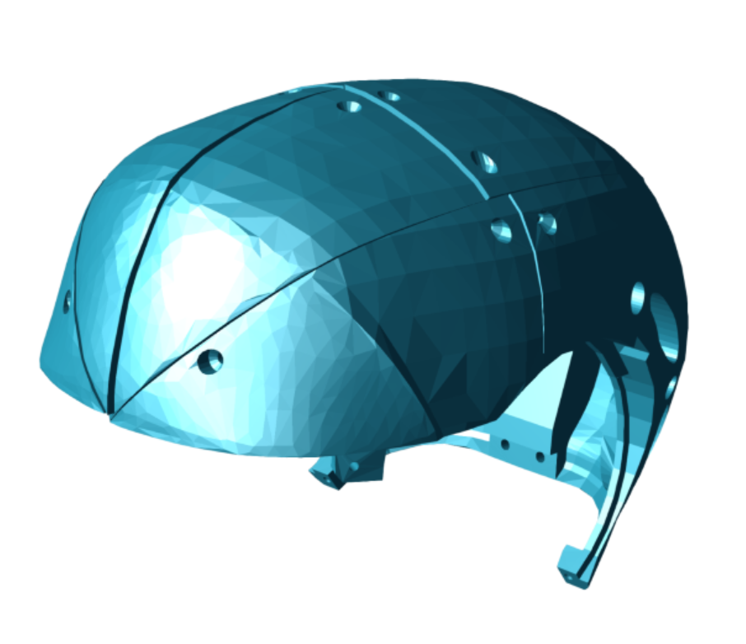
[picture p187: figure]
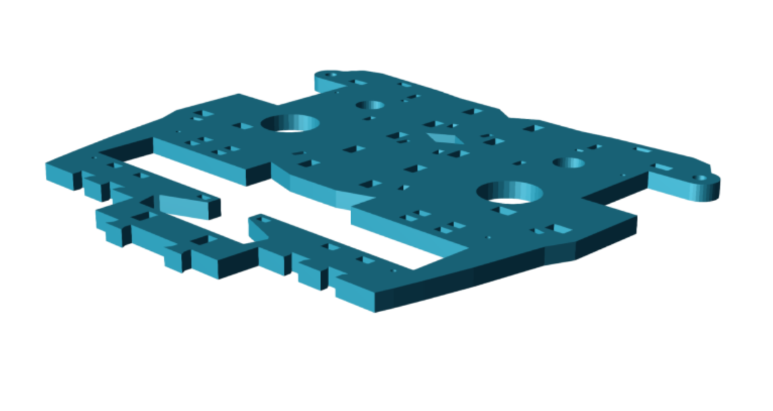
[picture p188: figure]
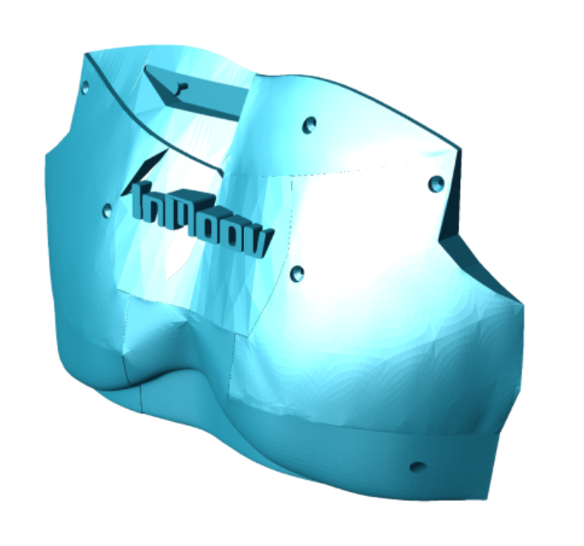
[picture p189: figure]
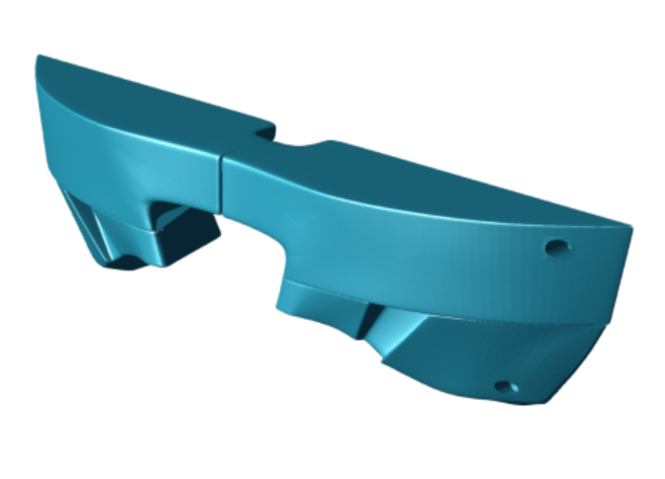
[picture p190: figure]
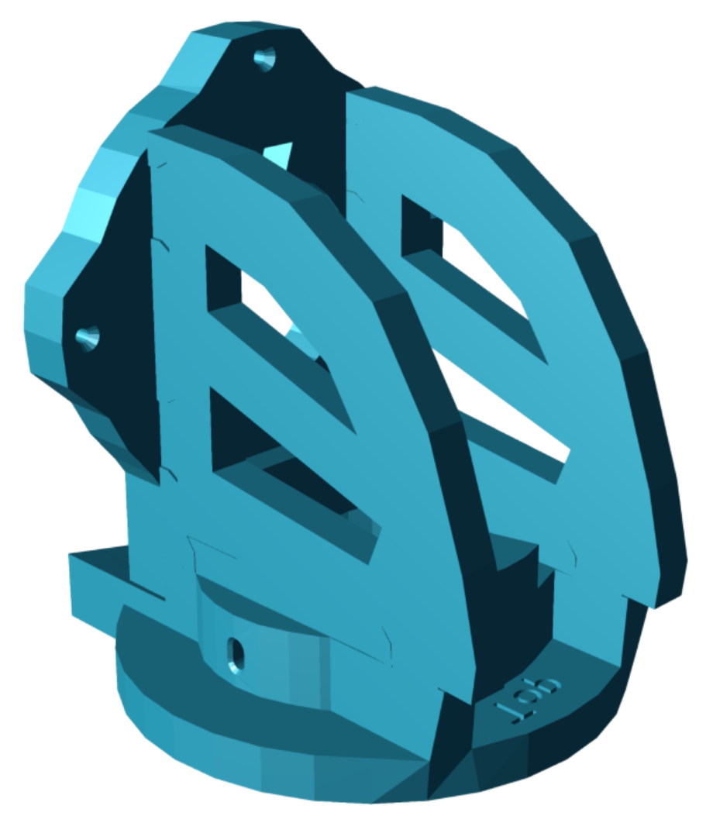
[picture p191: figure]
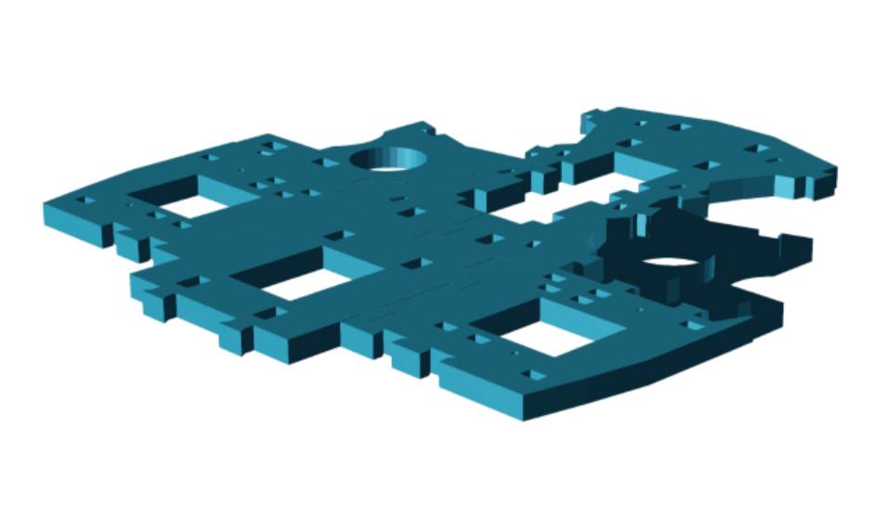
[picture p192: figure]
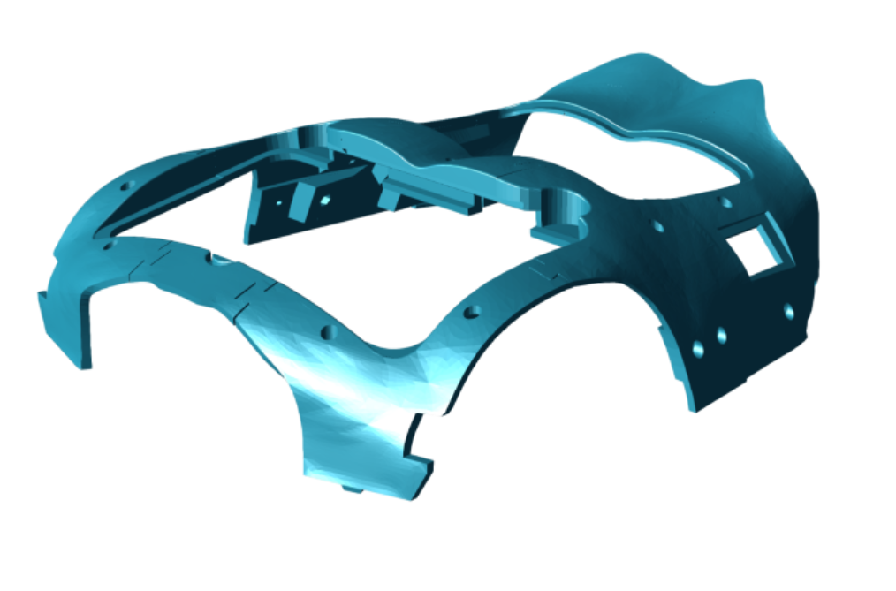
[picture p193: figure]
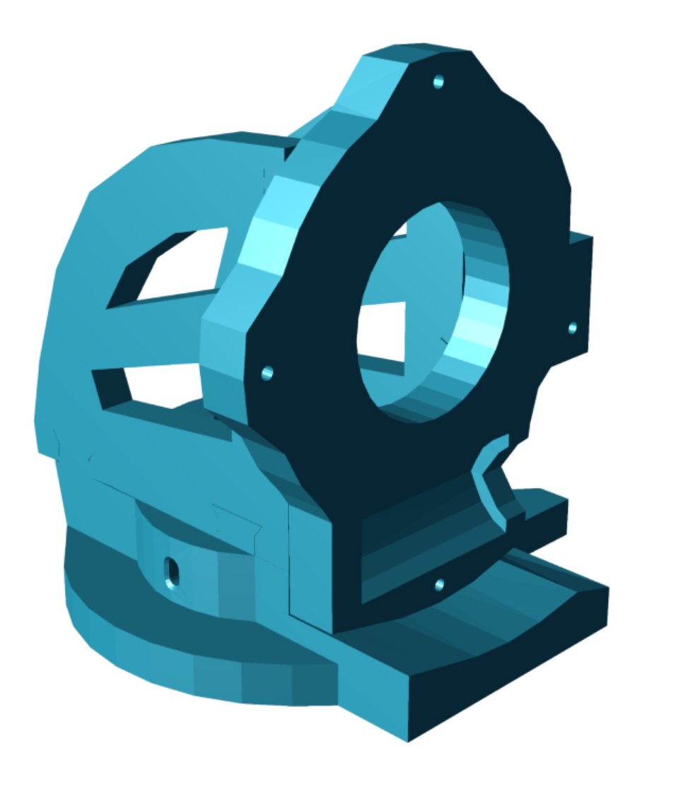
[picture p194: figure]
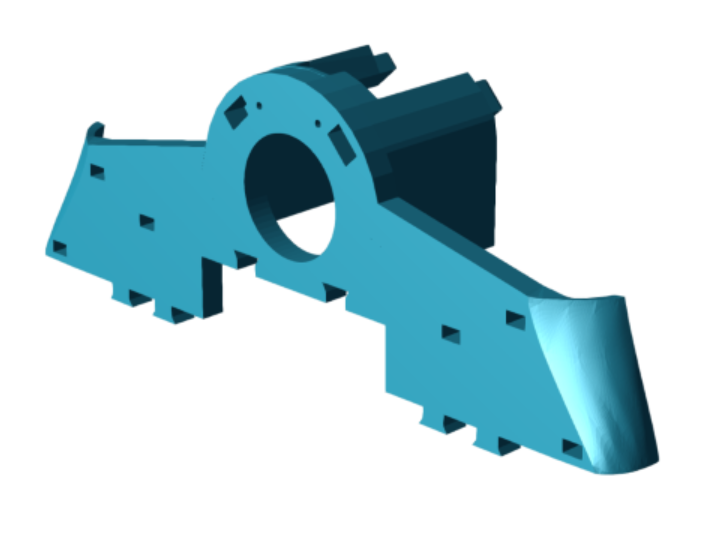
[picture p195: figure]
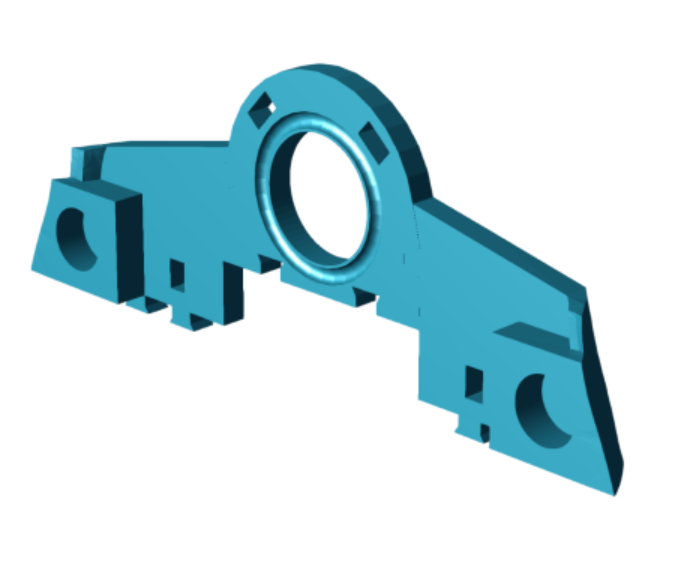
[picture p196: figure]
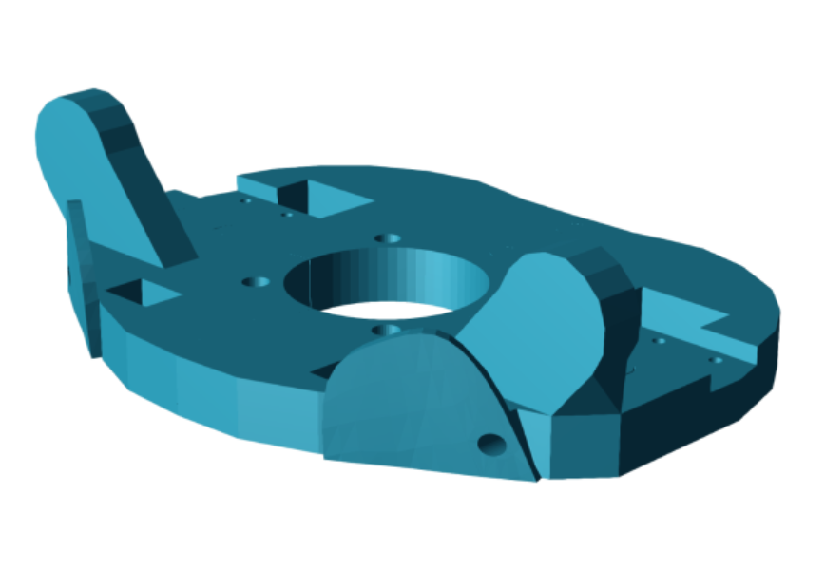
[picture p197: figure]
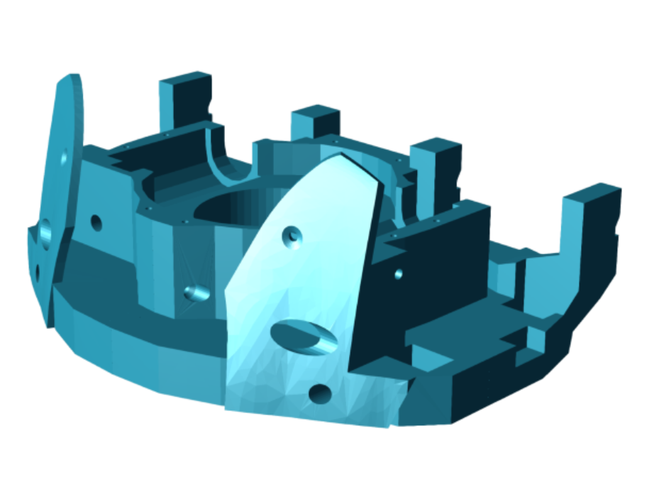
[picture p198: figure]
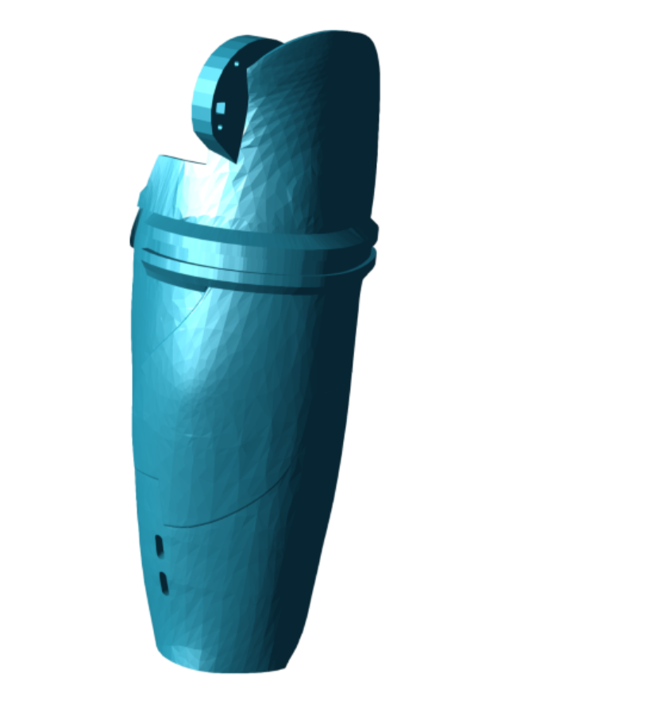
[picture p199: figure]
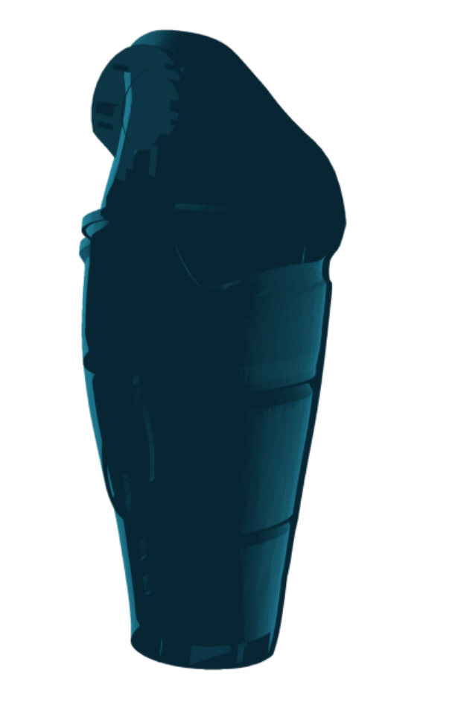
[picture p200: figure]
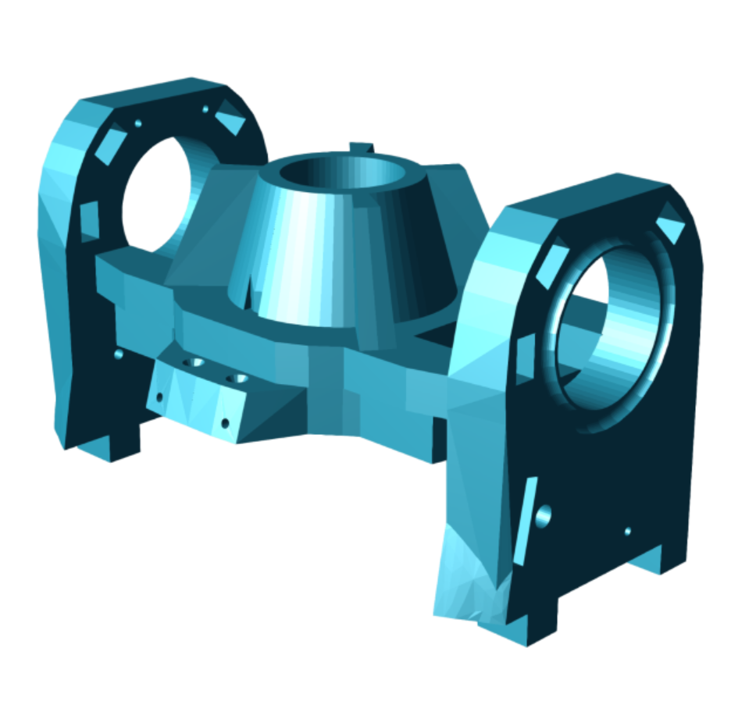
[picture p201: figure]
