idolverse/Tulingjiuge_robot_1/myrobotlab/src/main/resources/resource/Intro/servoTutorial/arduino_servo.png

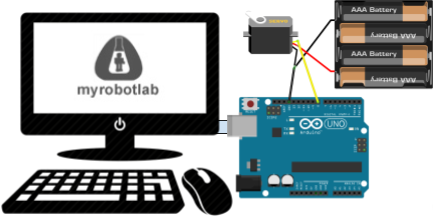
myrobotlab/src/main/resources/resource/Intro/servoTutorial/arduino_servo.png
