idolverse/Tulingjiuge_robot_1/myrobotlab/src/main/resources/resource/Intro/servoTutorial/arduino_servo_virtual.png

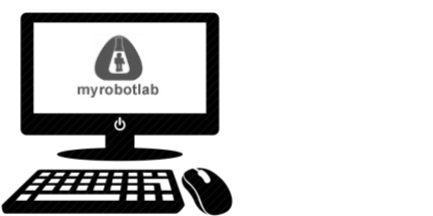
myrobotlab/src/main/resources/resource/Intro/servoTutorial/arduino_servo_virtual.png
