idolverse/Tulingjiuge_robot_1/myrobotlab/src/main/resources/resource/RasPi/setup-1.png

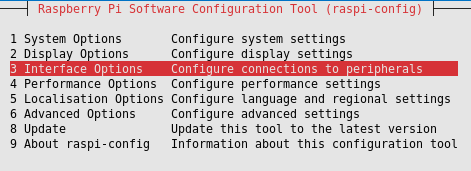
myrobotlab/src/main/resources/resource/RasPi/setup-1.png
