idolverse/Tulingjiuge_robot_1/myrobotlab/src/main/resources/resource/RasPi/setup-2.png

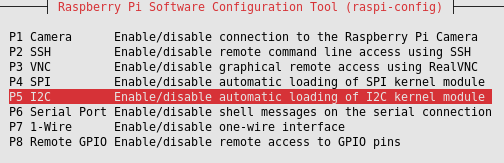
myrobotlab/src/main/resources/resource/RasPi/setup-2.png
