idolverse/Tulingjiuge_robot_1/零件组装教程+stl文件/A组装示意图/头+眼睛3D/Skull_03.jpg

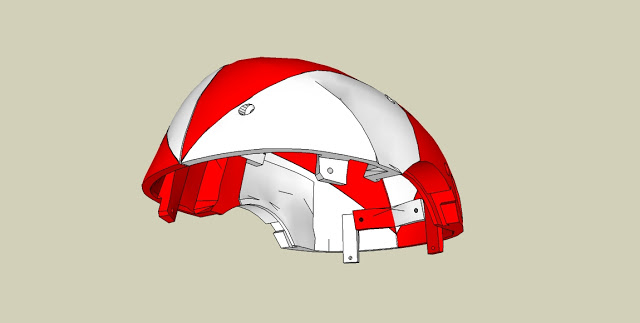
零件组装教程+stl文件/A组装示意图/头+眼睛3D/Skull_03.jpg
