idolverse/Tulingjiuge_robot_1/零件组装教程+stl文件/A组装示意图/手+小臂3D/fingerassembly.png

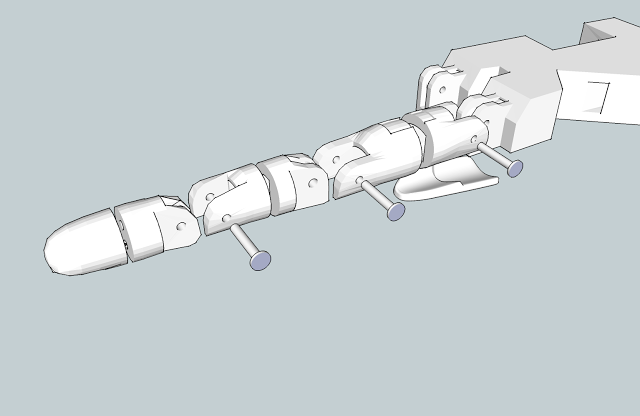
零件组装教程+stl文件/A组装示意图/手+小臂3D/fingerassembly.png
