idolverse/Tulingjiuge_robot_1/零件组装教程+stl文件/A组装示意图/肩膀3D/ShoulderBicep.png

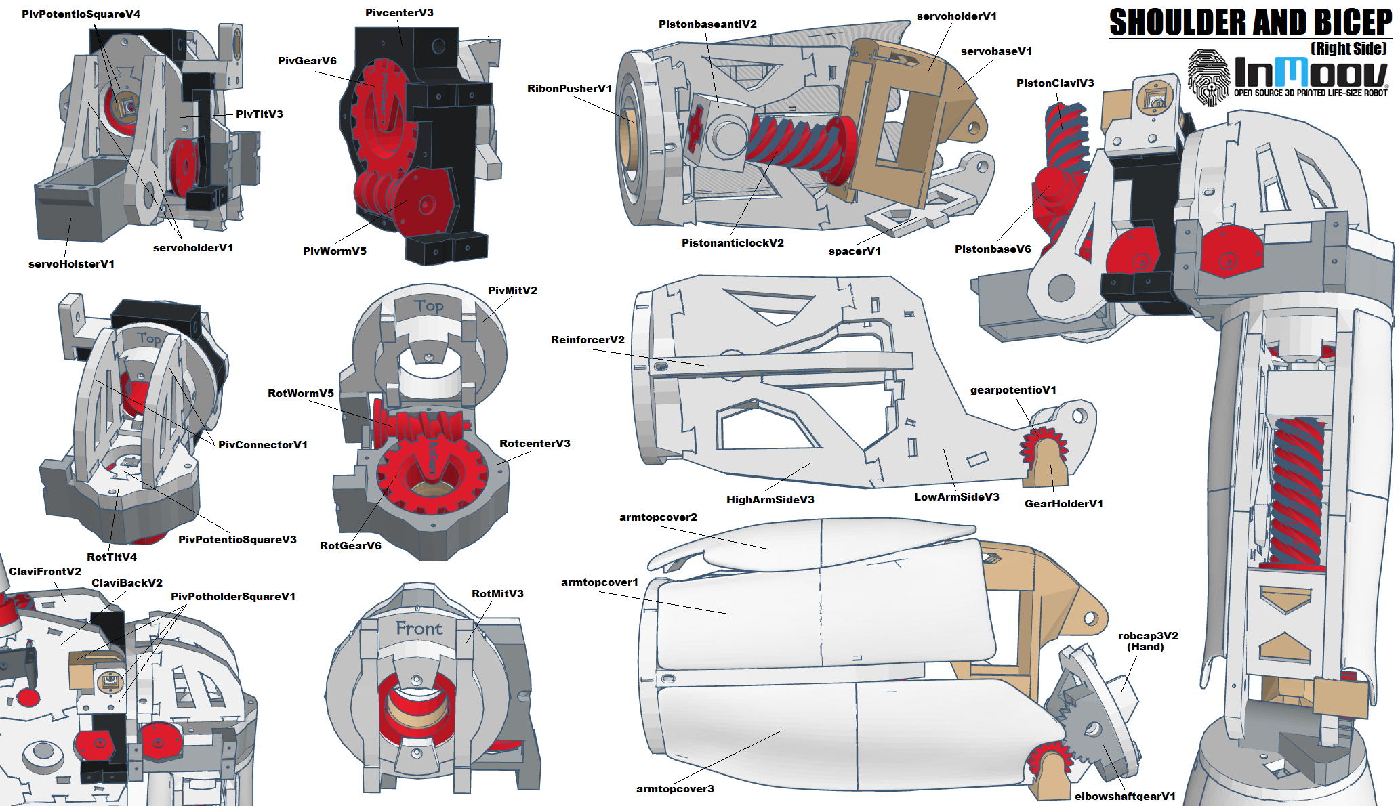
零件组装教程+stl文件/A组装示意图/肩膀3D/ShoulderBicep.png
