idolverse/Tulingjiuge_robot_1/零件组装教程+stl文件/A组装示意图/肩膀+二头肌/Biceps_exploded (left).jpg

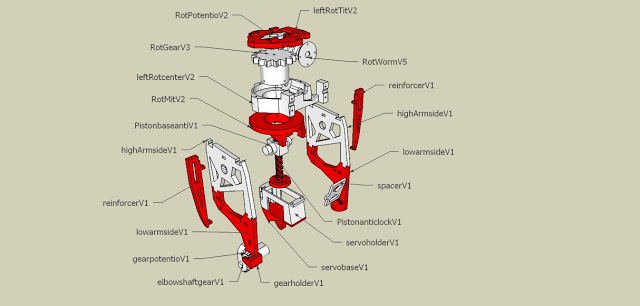
零件组装教程+stl文件/A组装示意图/肩膀+二头肌/Biceps_exploded (left).jpg
