idolverse/Tulingjiuge_robot_1/零件组装教程+stl文件/A组装示意图/腿3D/LegAssembly2-1024x677.png

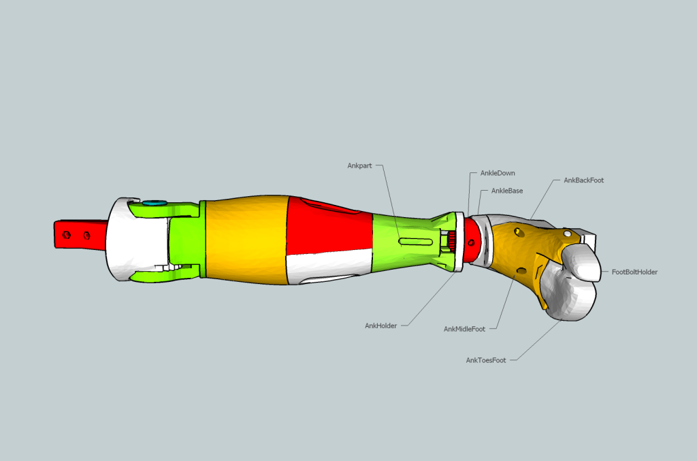
零件组装教程+stl文件/A组装示意图/腿3D/LegAssembly2-1024x677.png
