idolverse/Tulingjiuge_robot_1/零件组装教程+stl文件/A组装示意图/躯干3D（两块板子+胸部）/Torso+Chest+Kinect.png

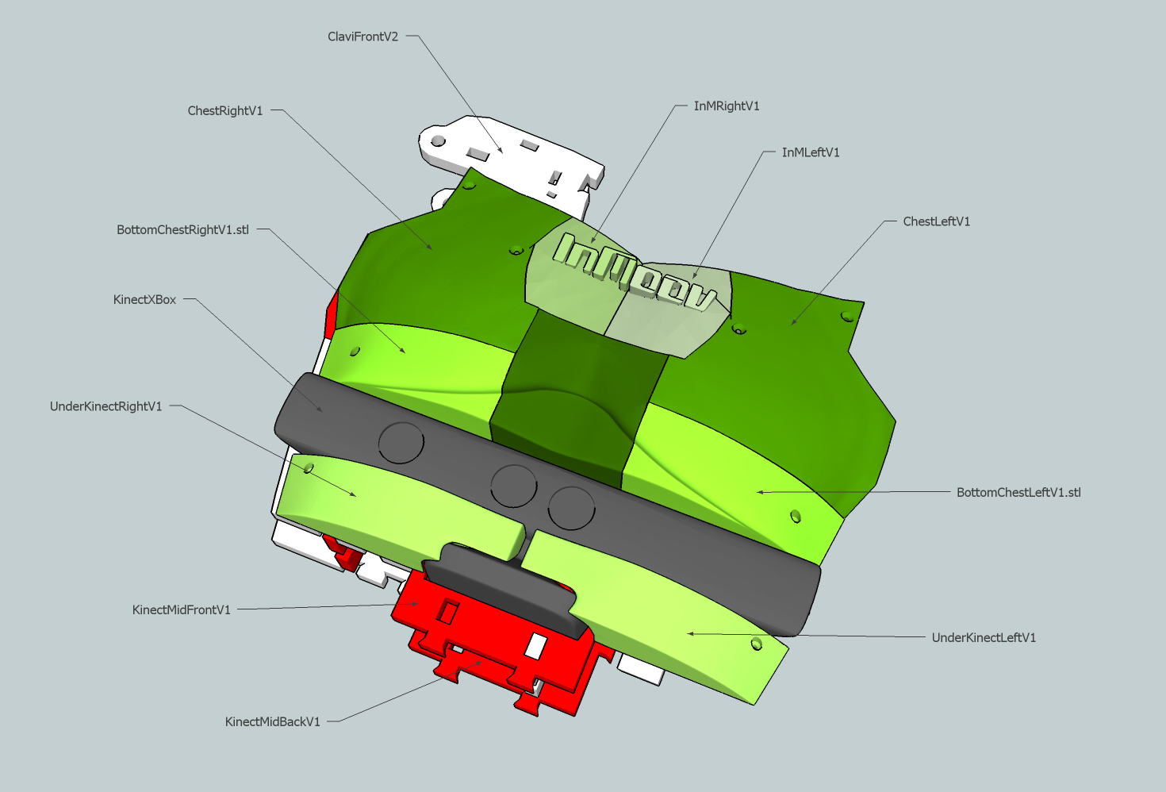
零件组装教程+stl文件/A组装示意图/躯干3D（两块板子+胸部）/Torso+Chest+Kinect.png
