idolverse/Tulingjiuge_robot_1/零件组装教程+stl文件/Eyes-i2-main/Eye-i2教程-Eng.pdf

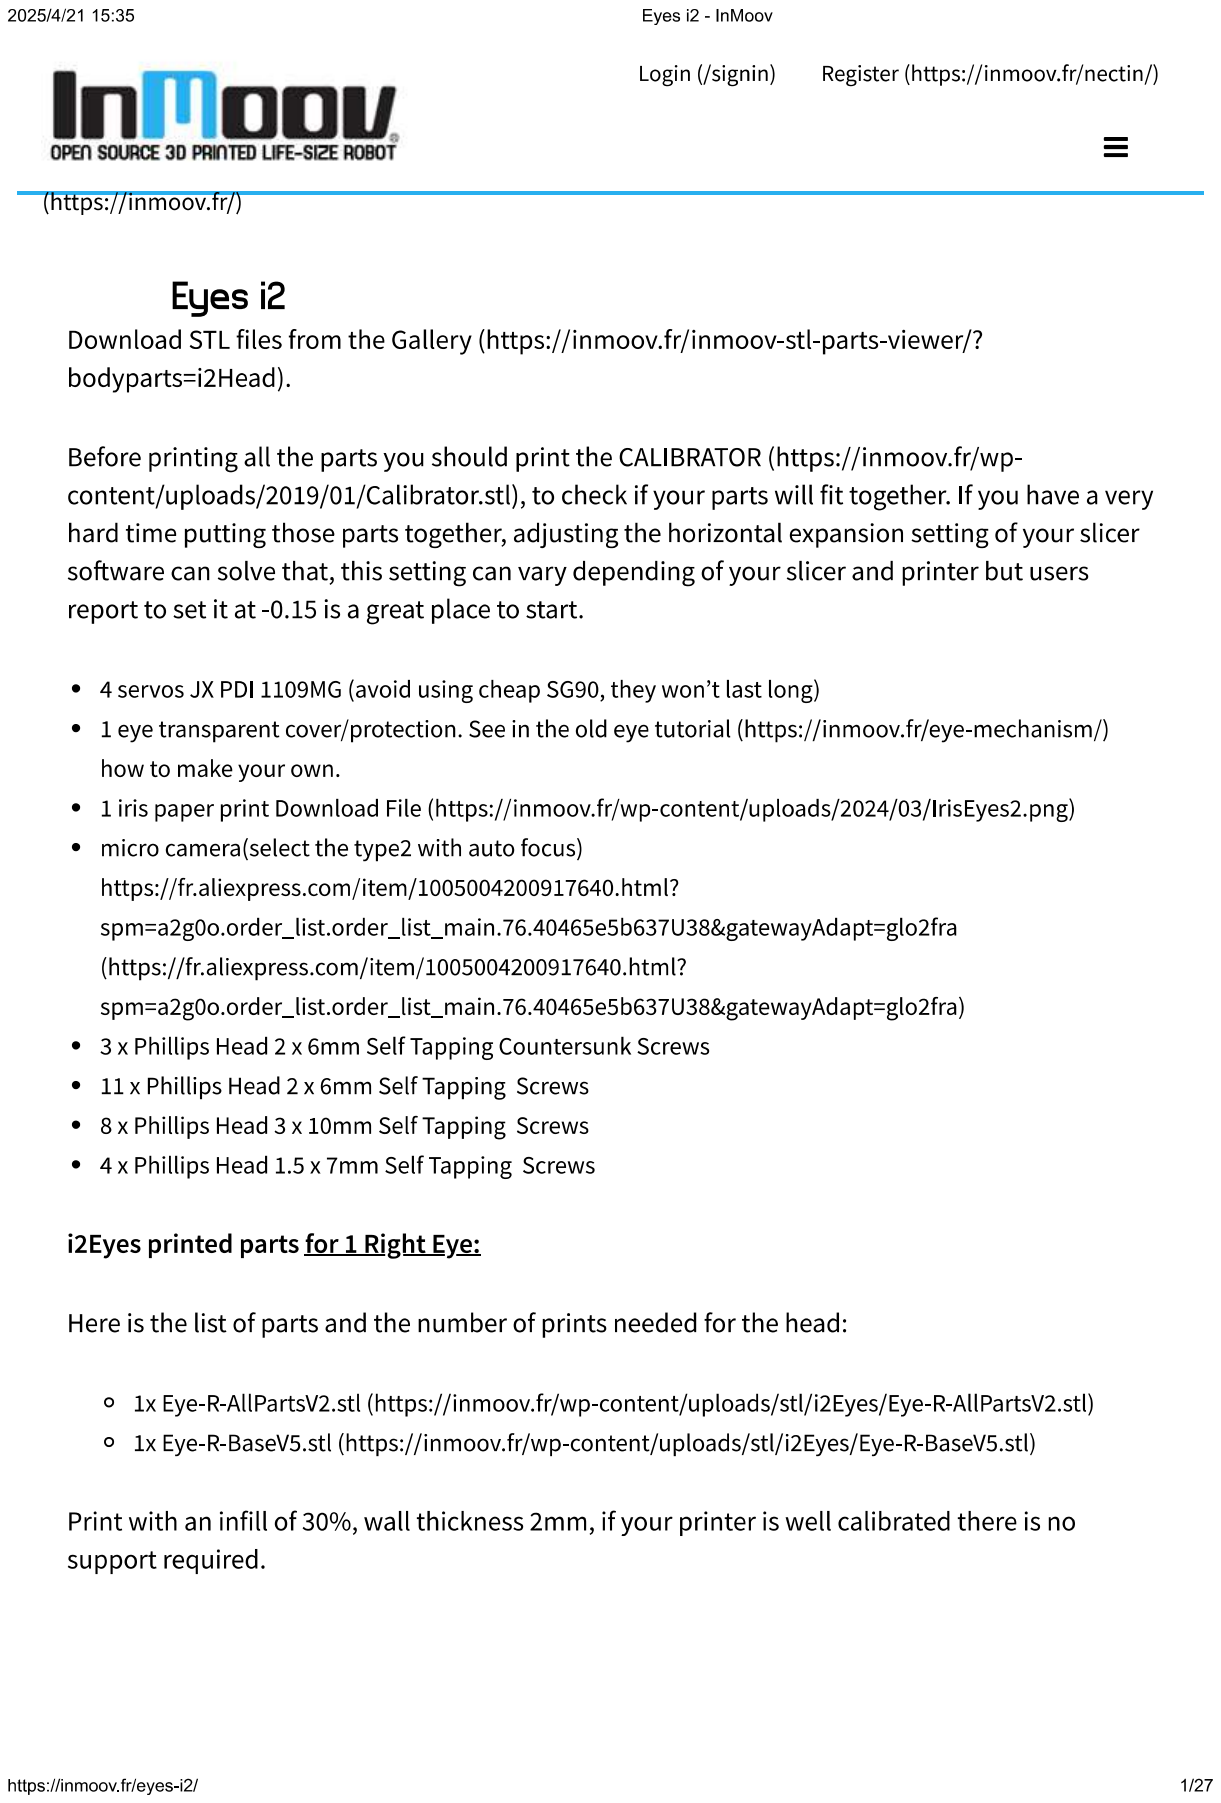
[picture p284: page 1]
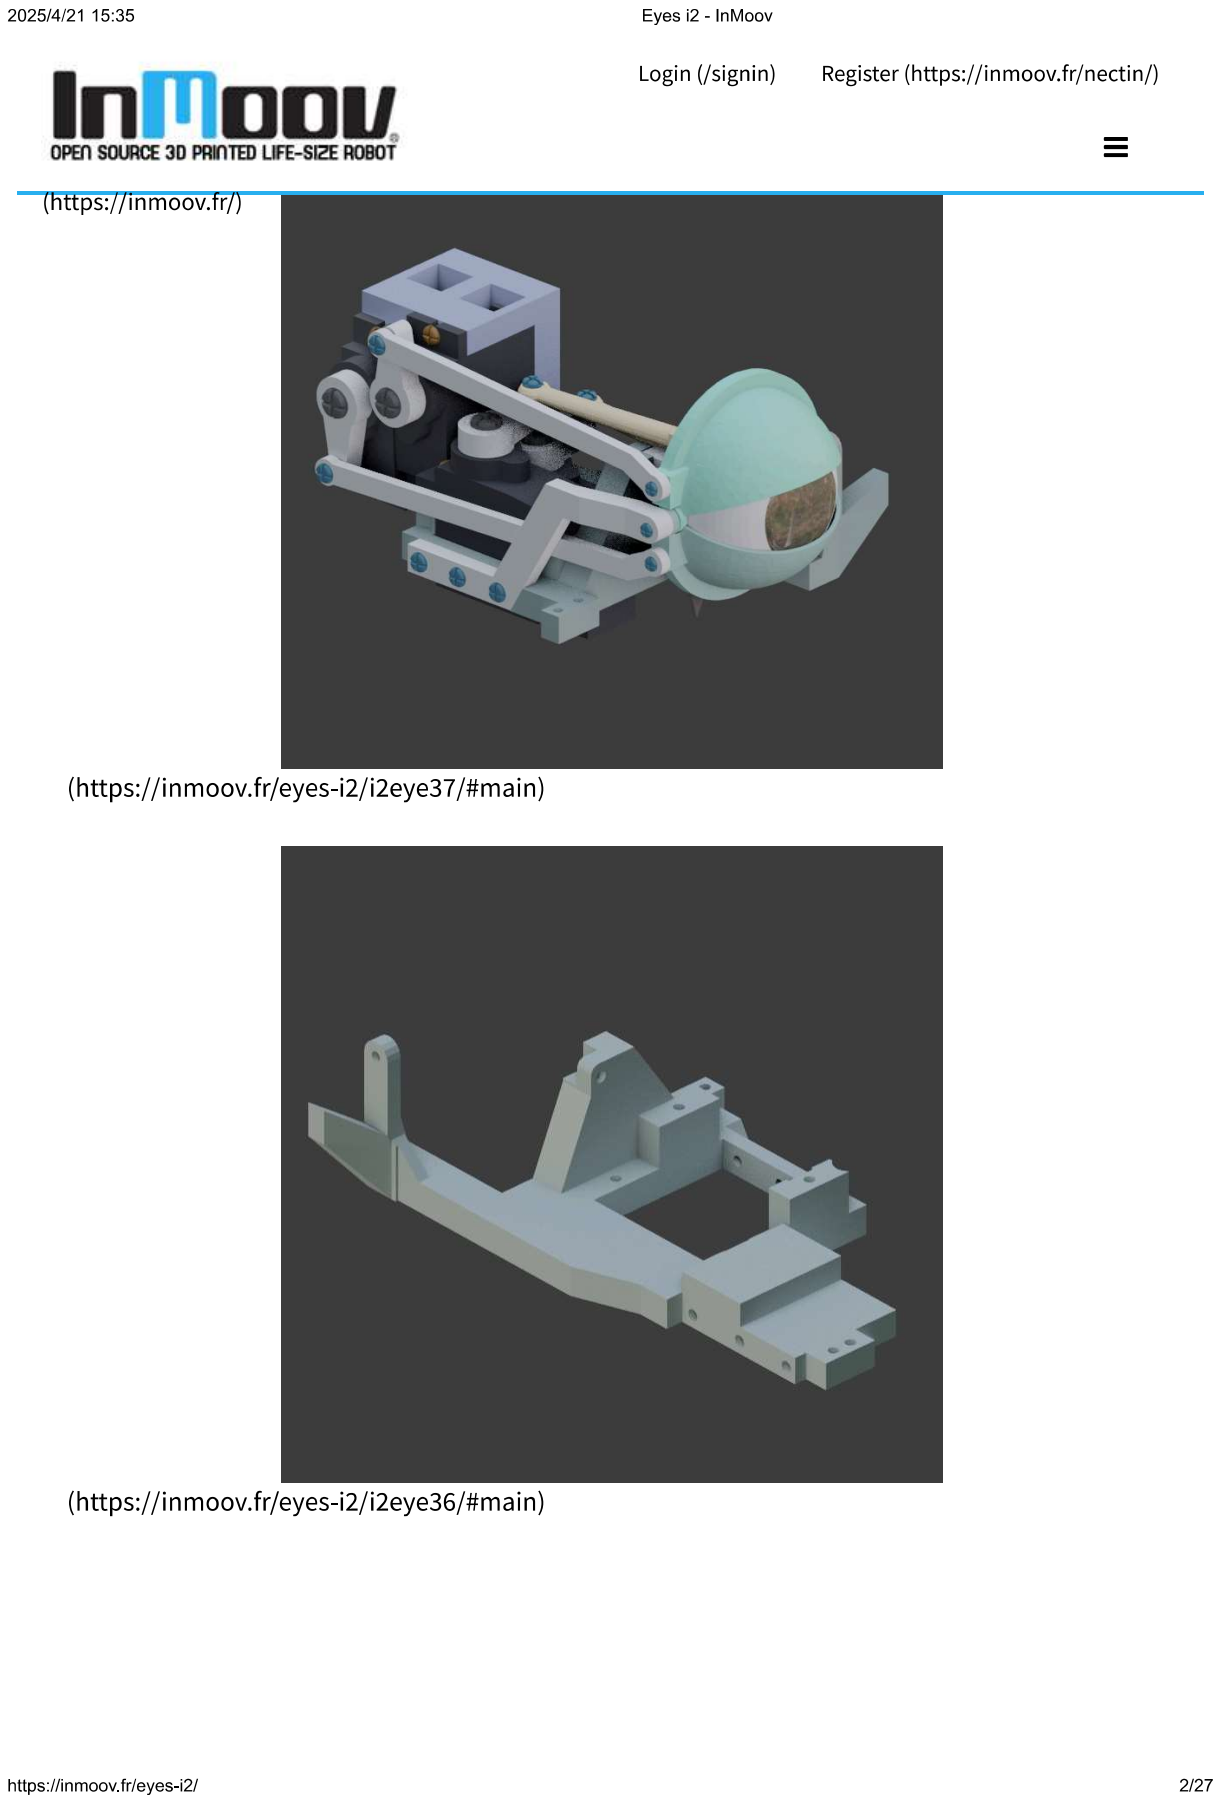
[picture p285: page 2]
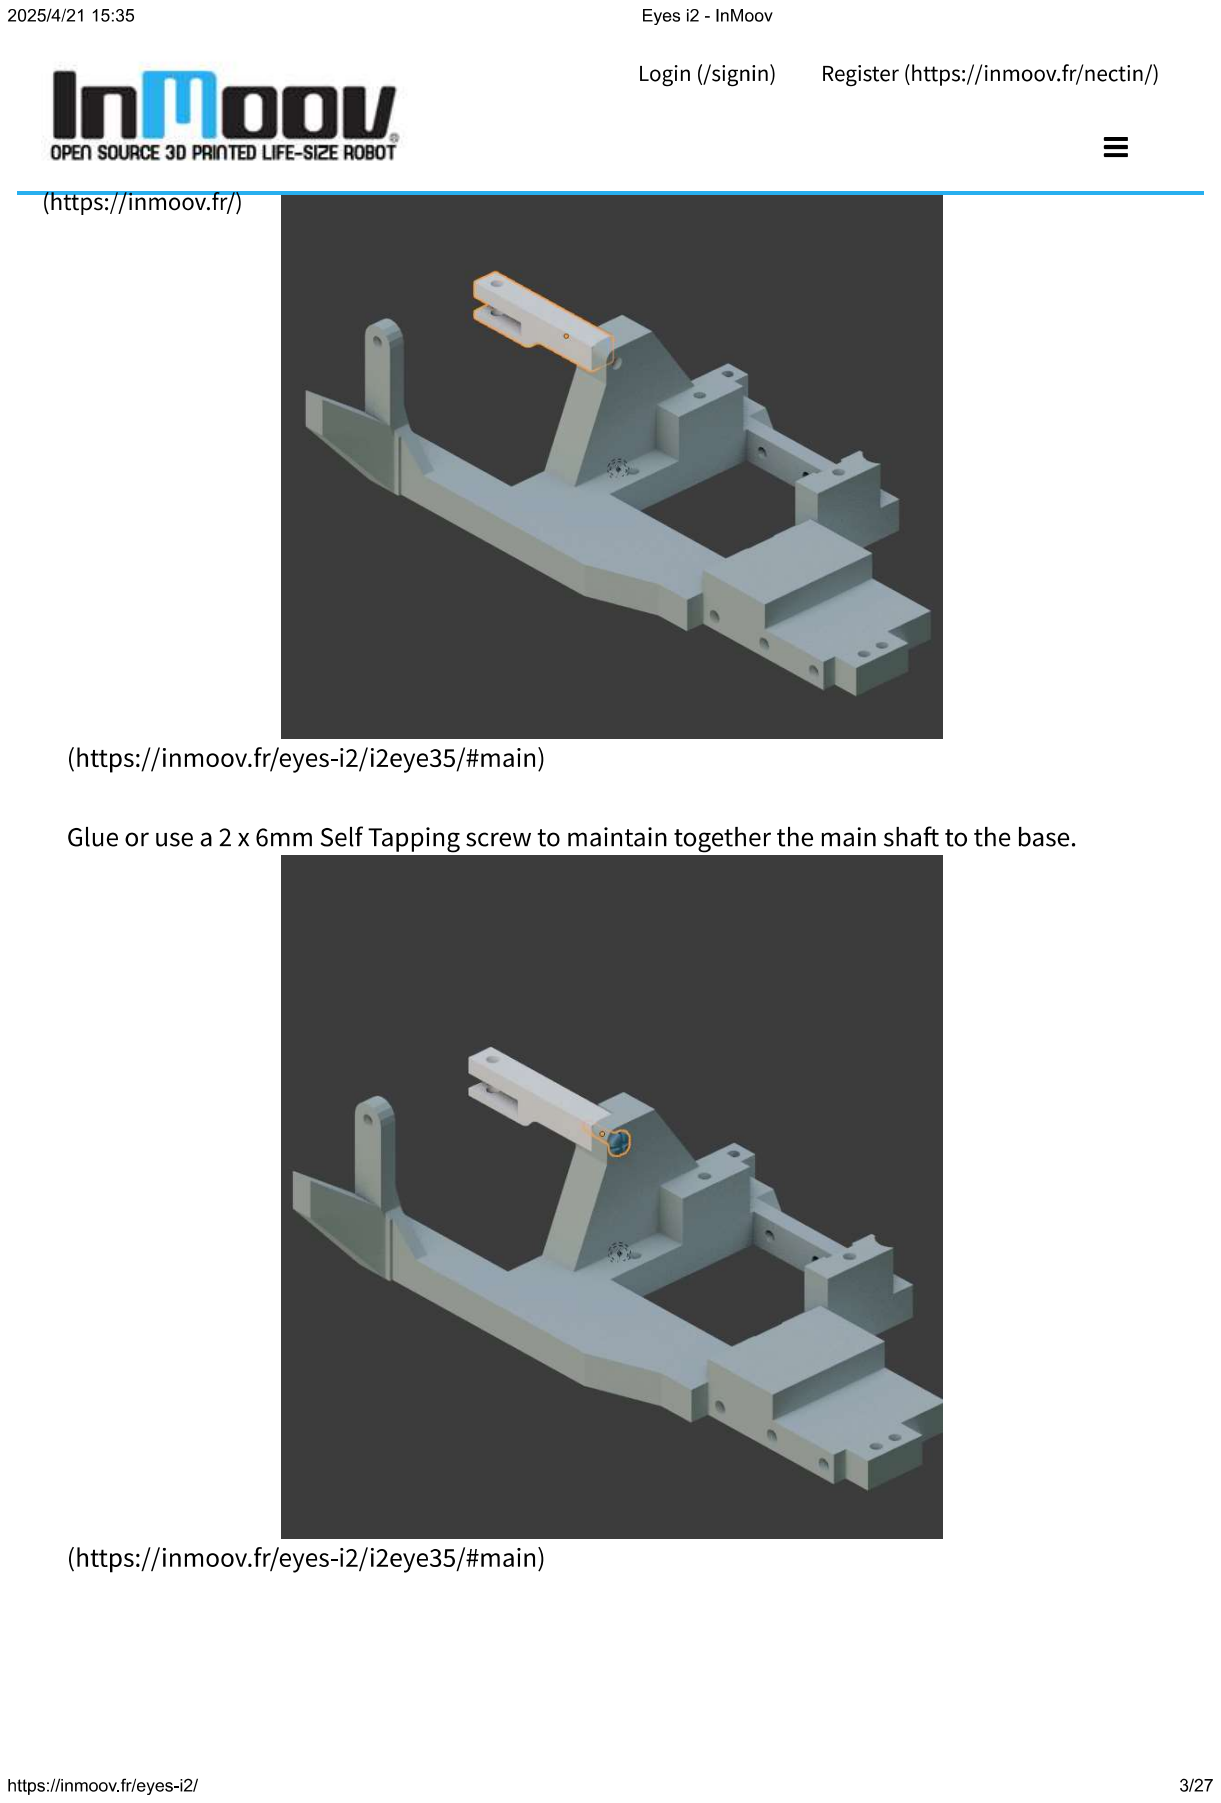
[picture p286: page 3]
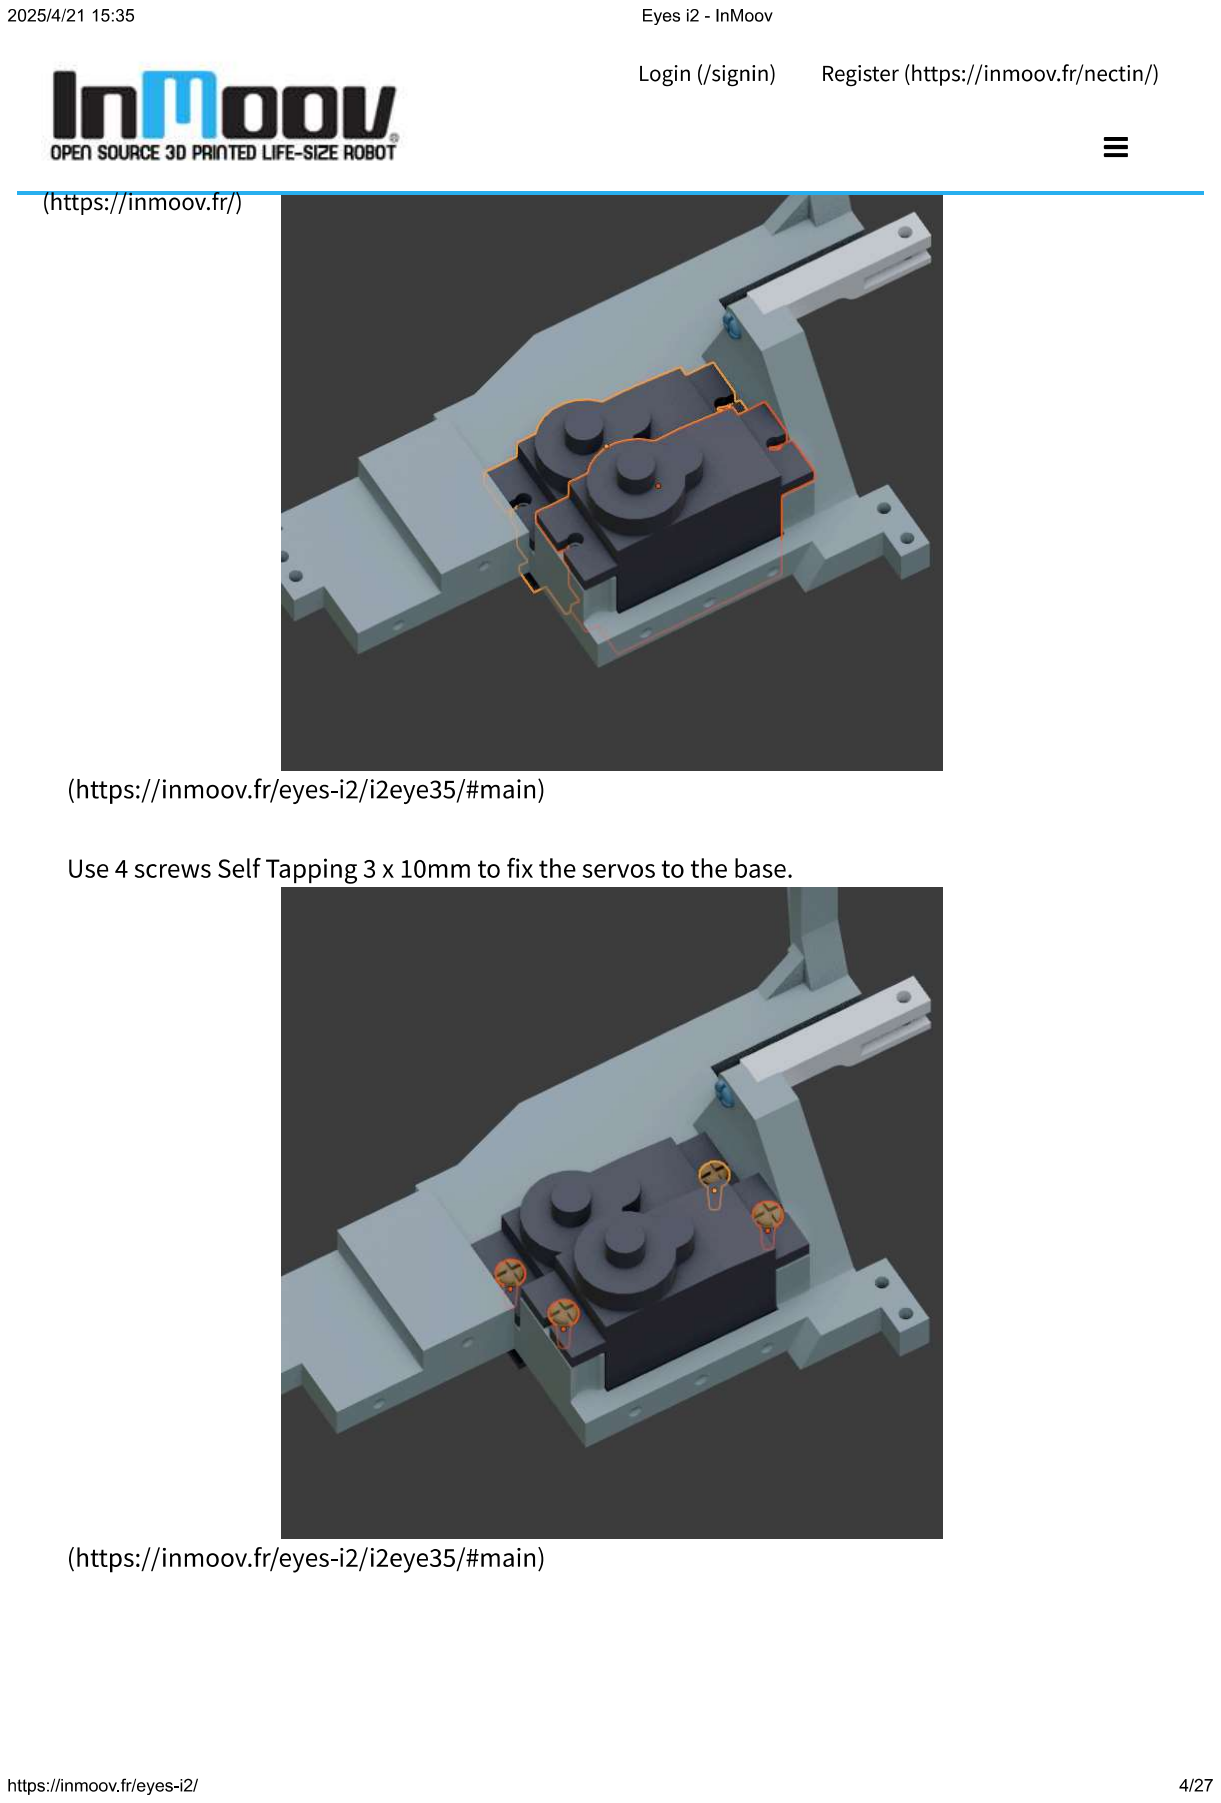
[picture p287: page 4]
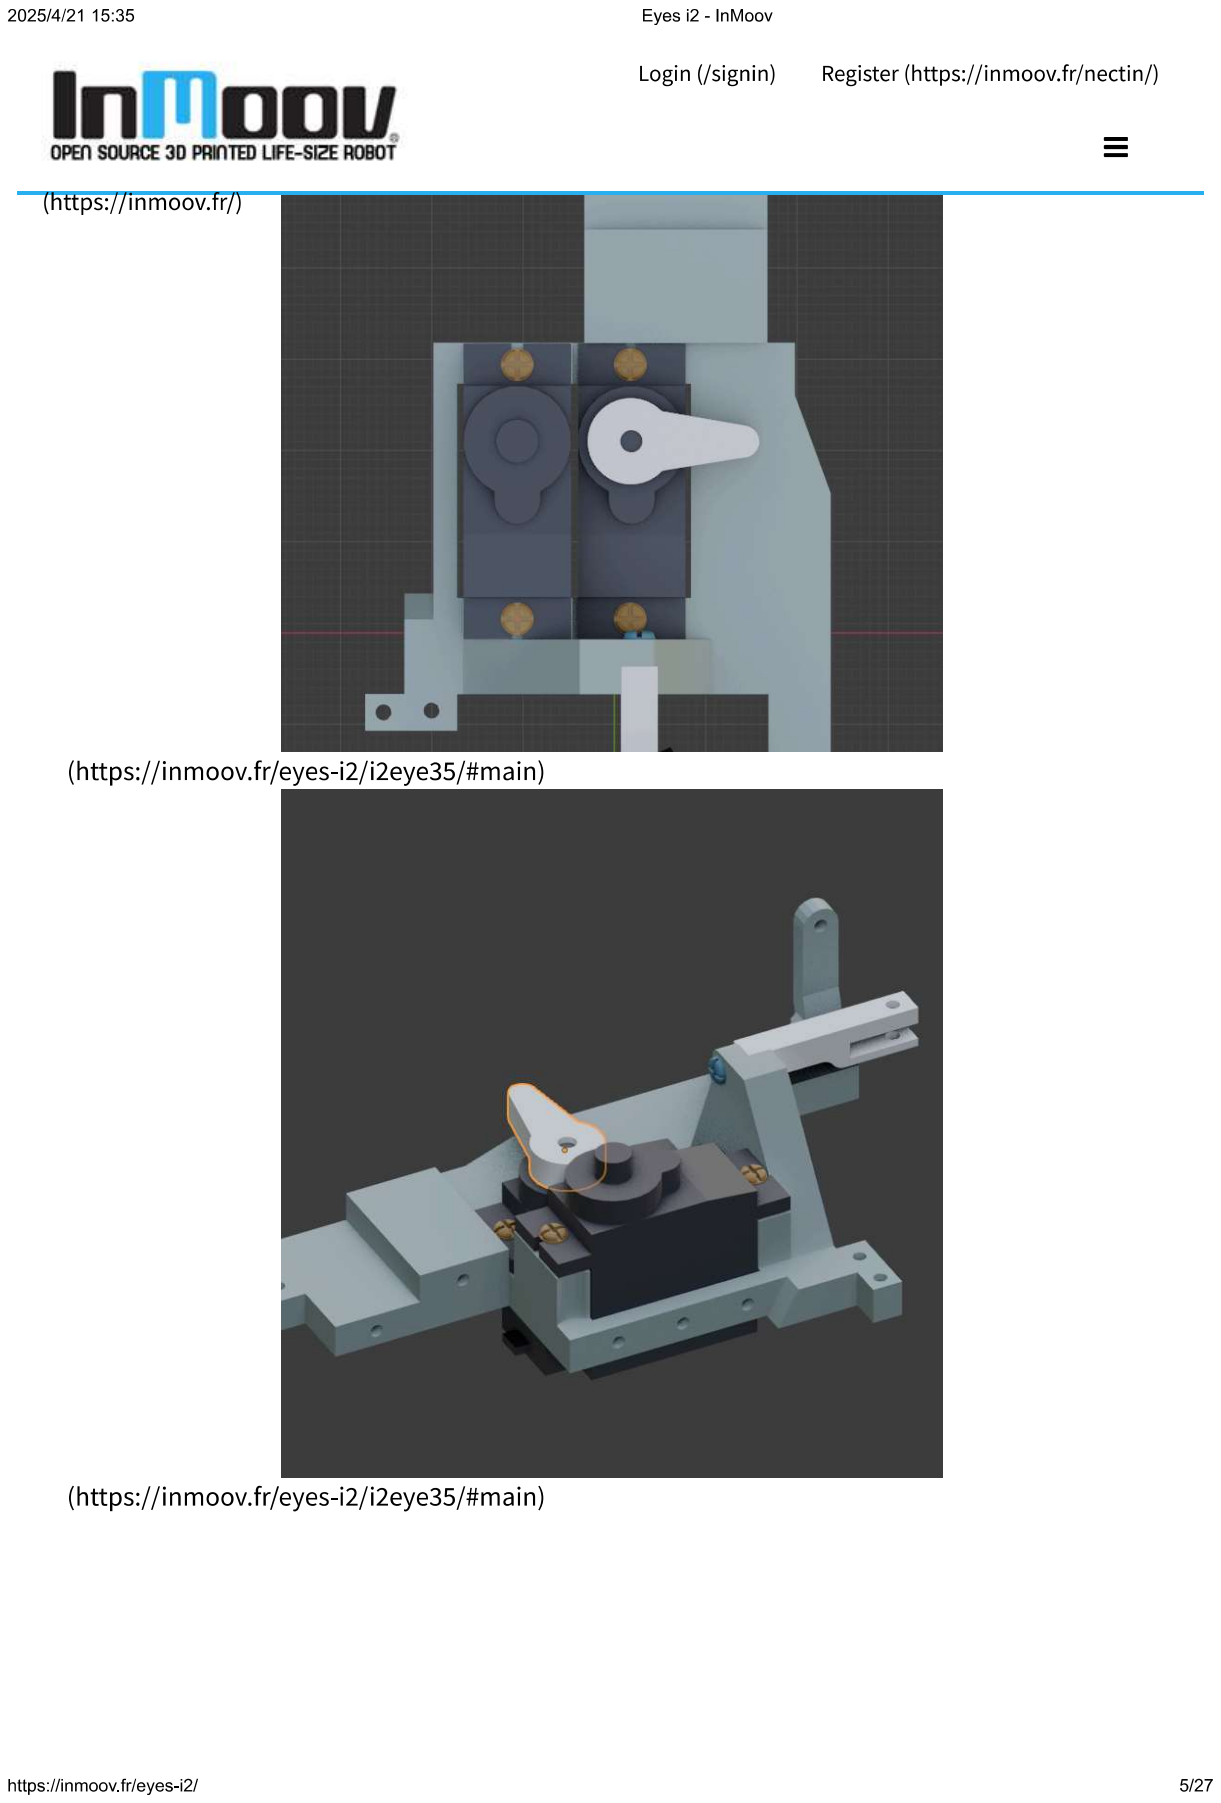
[picture p288: page 5]
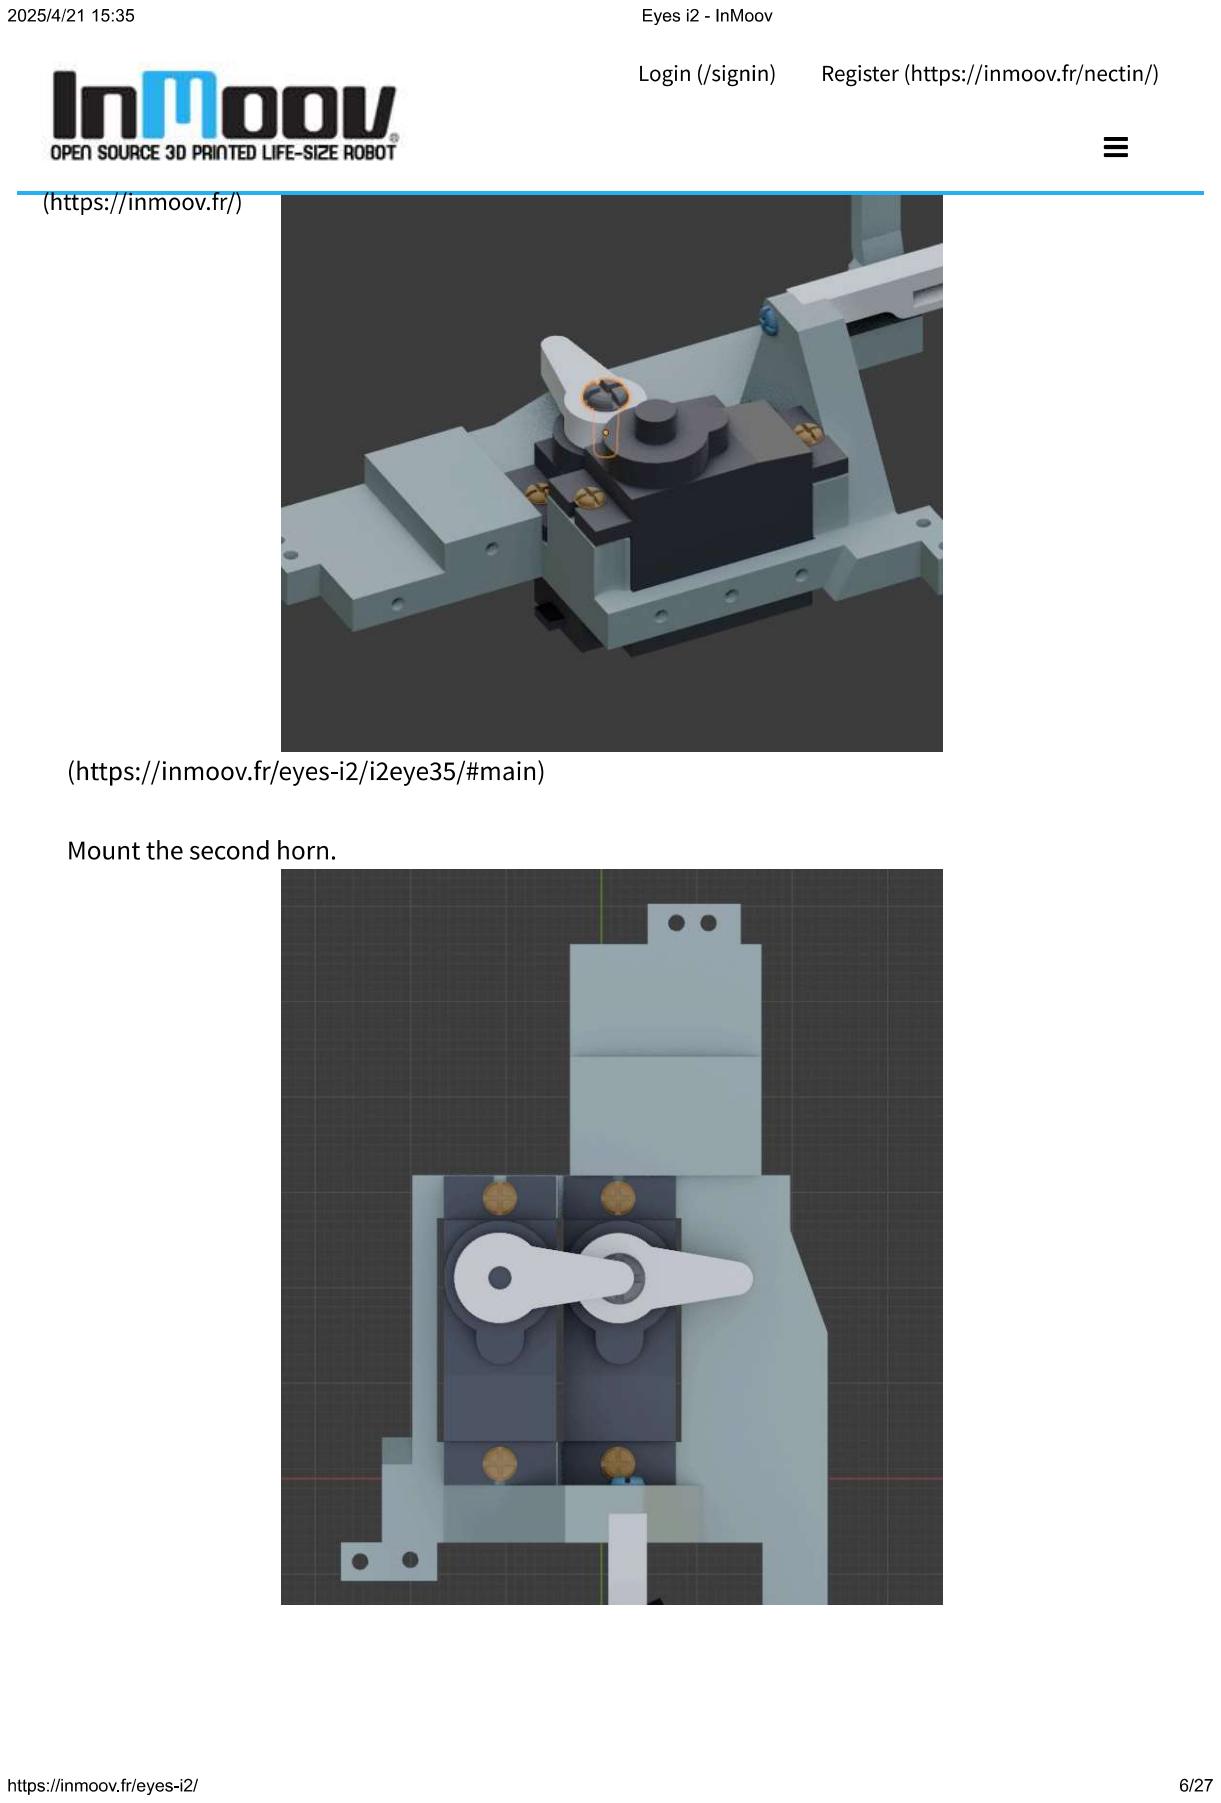
[picture p289: page 6]
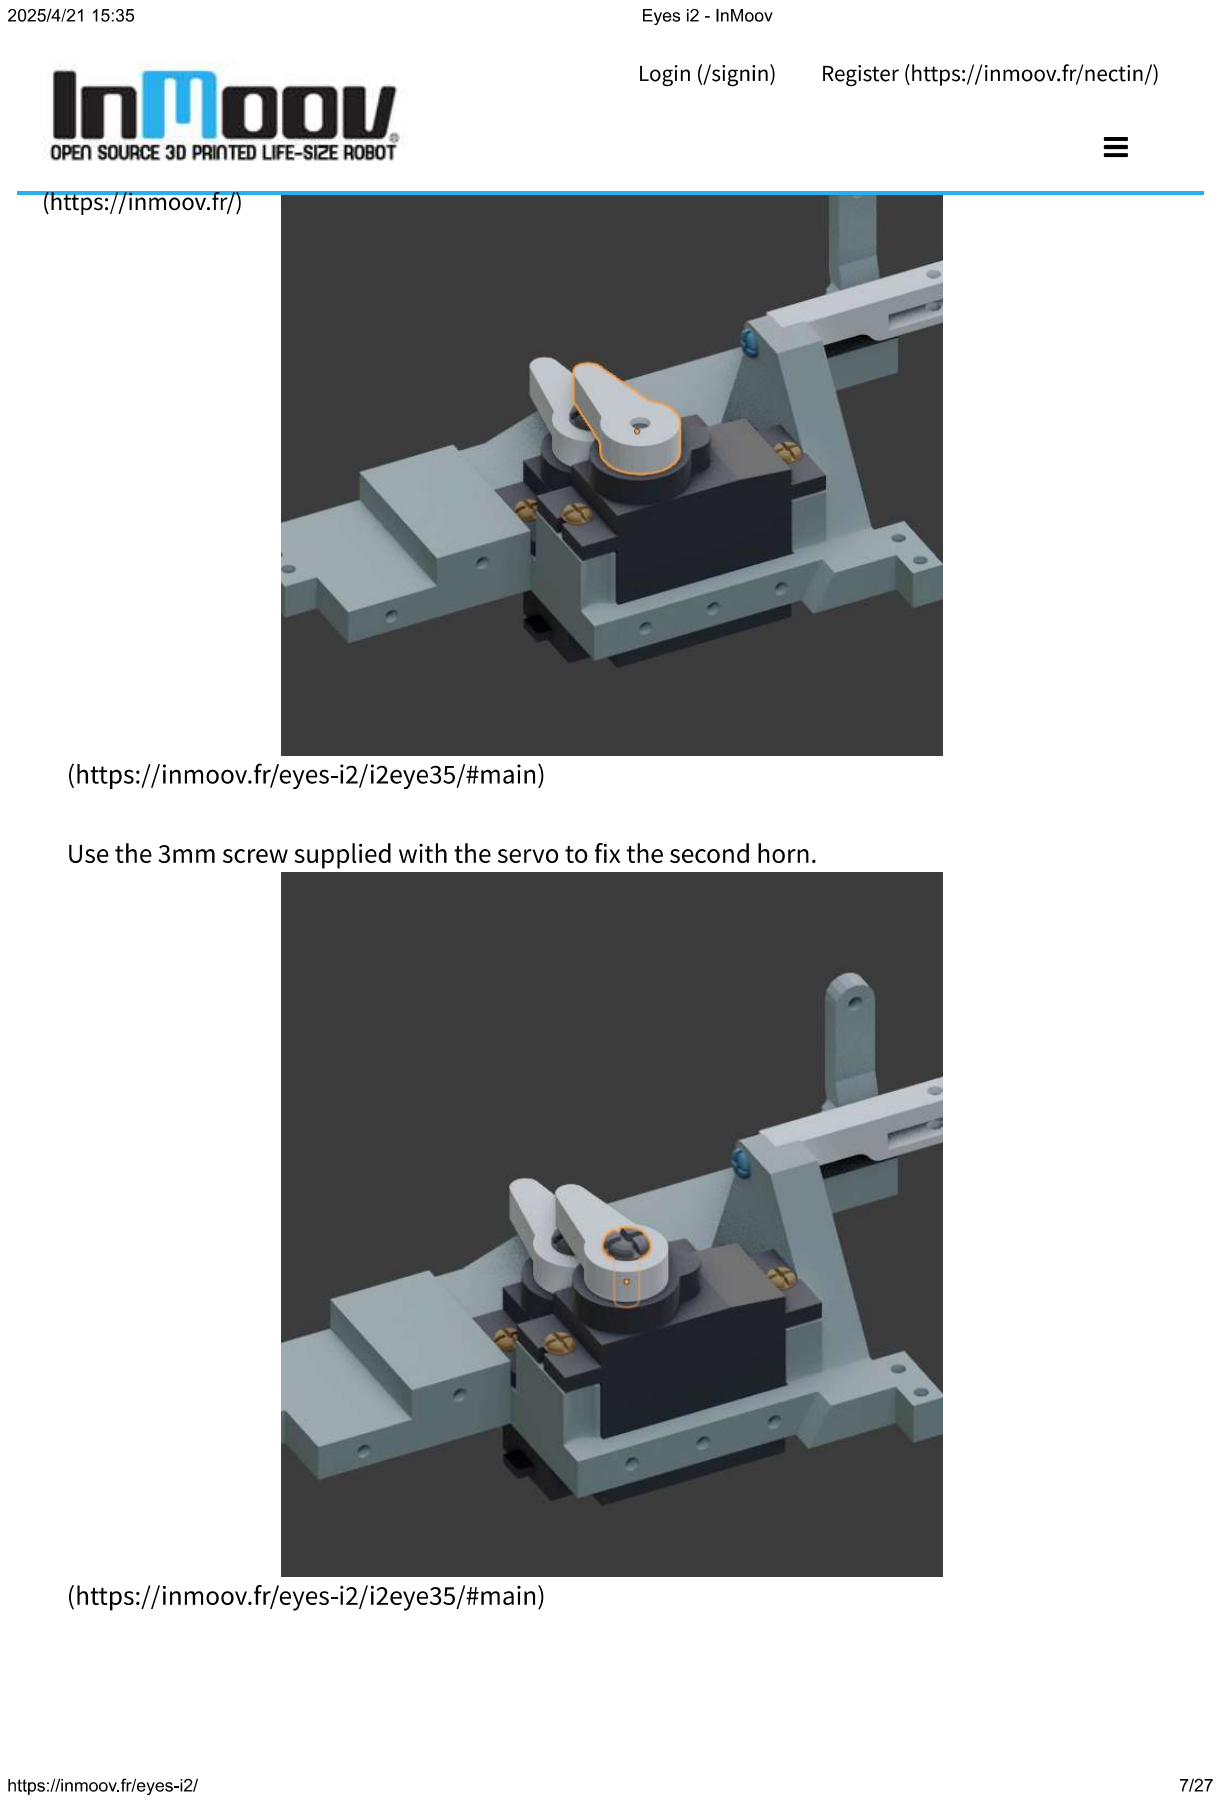
[picture p290: page 7]
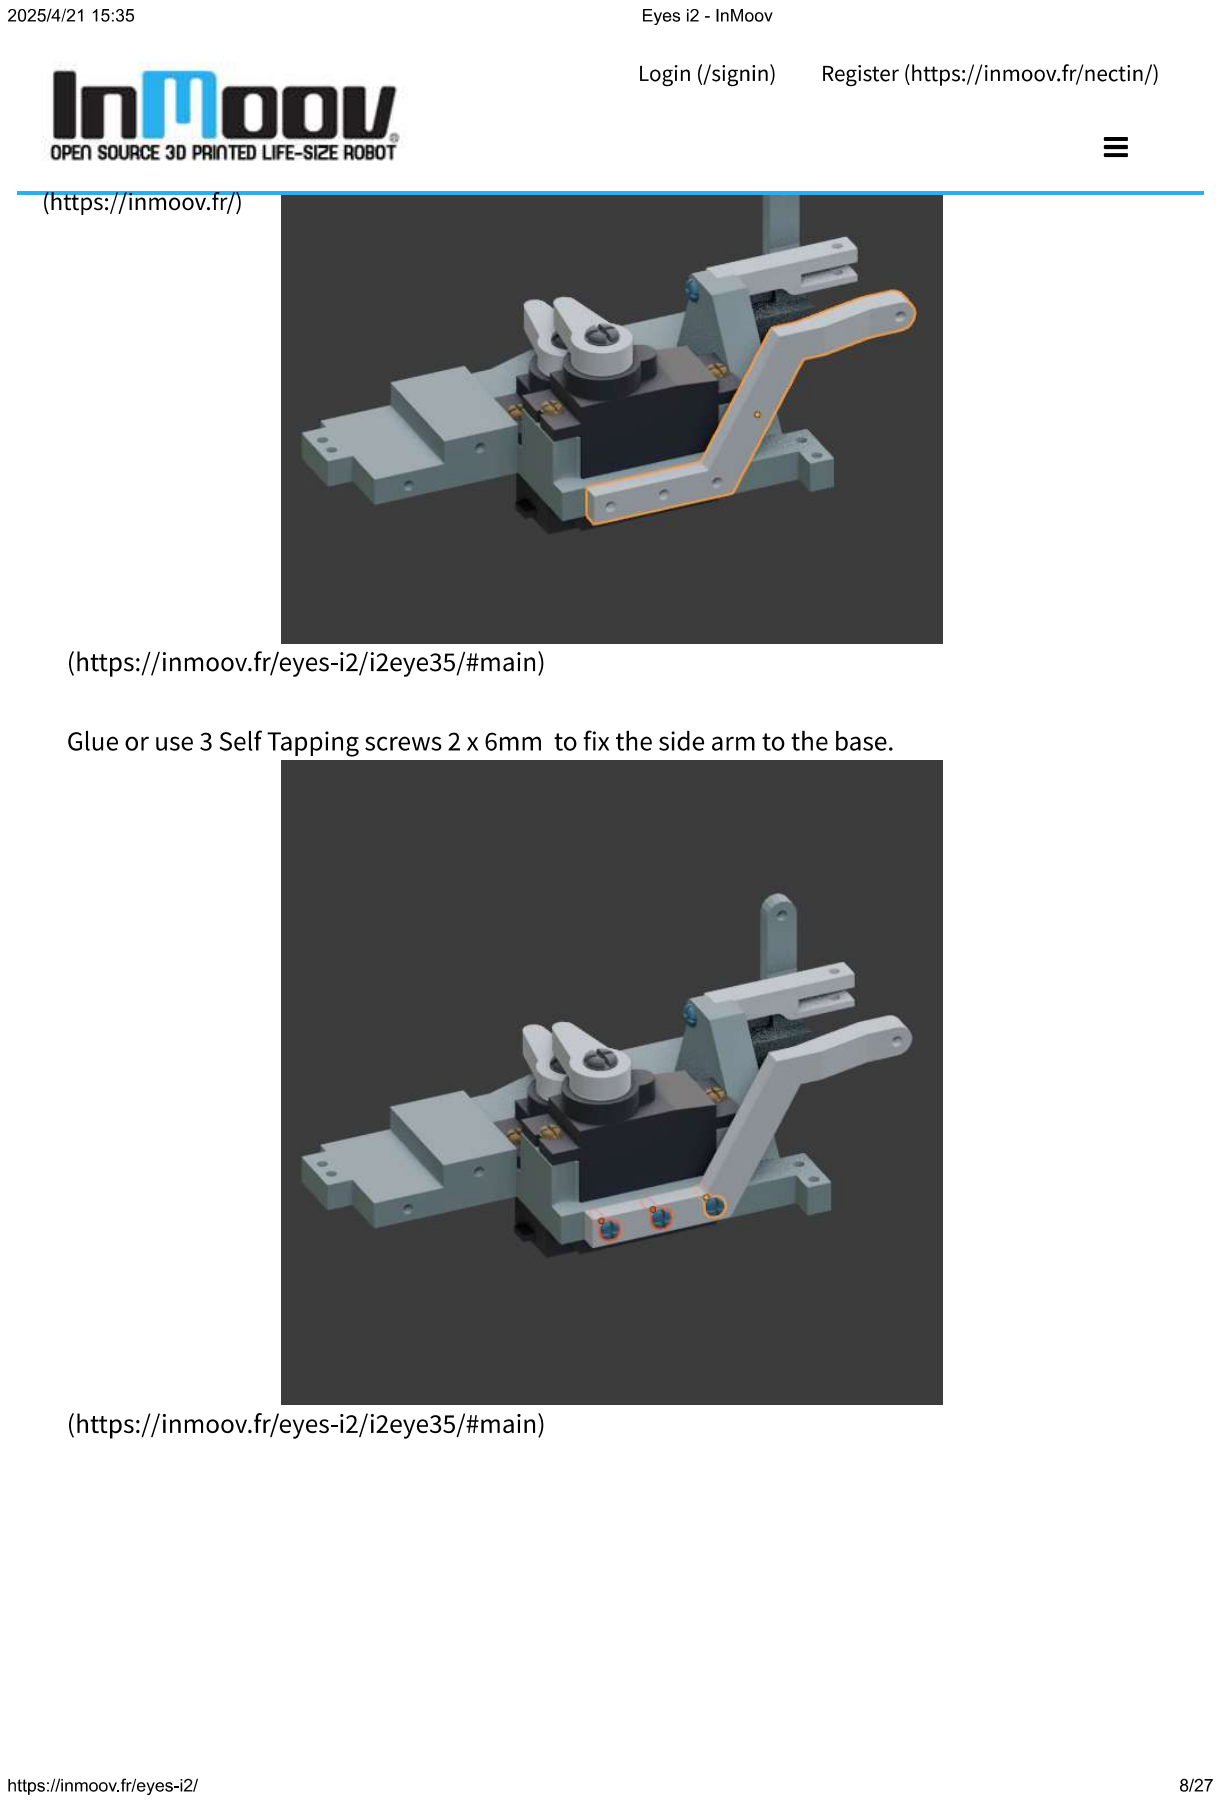
[picture p291: page 8]
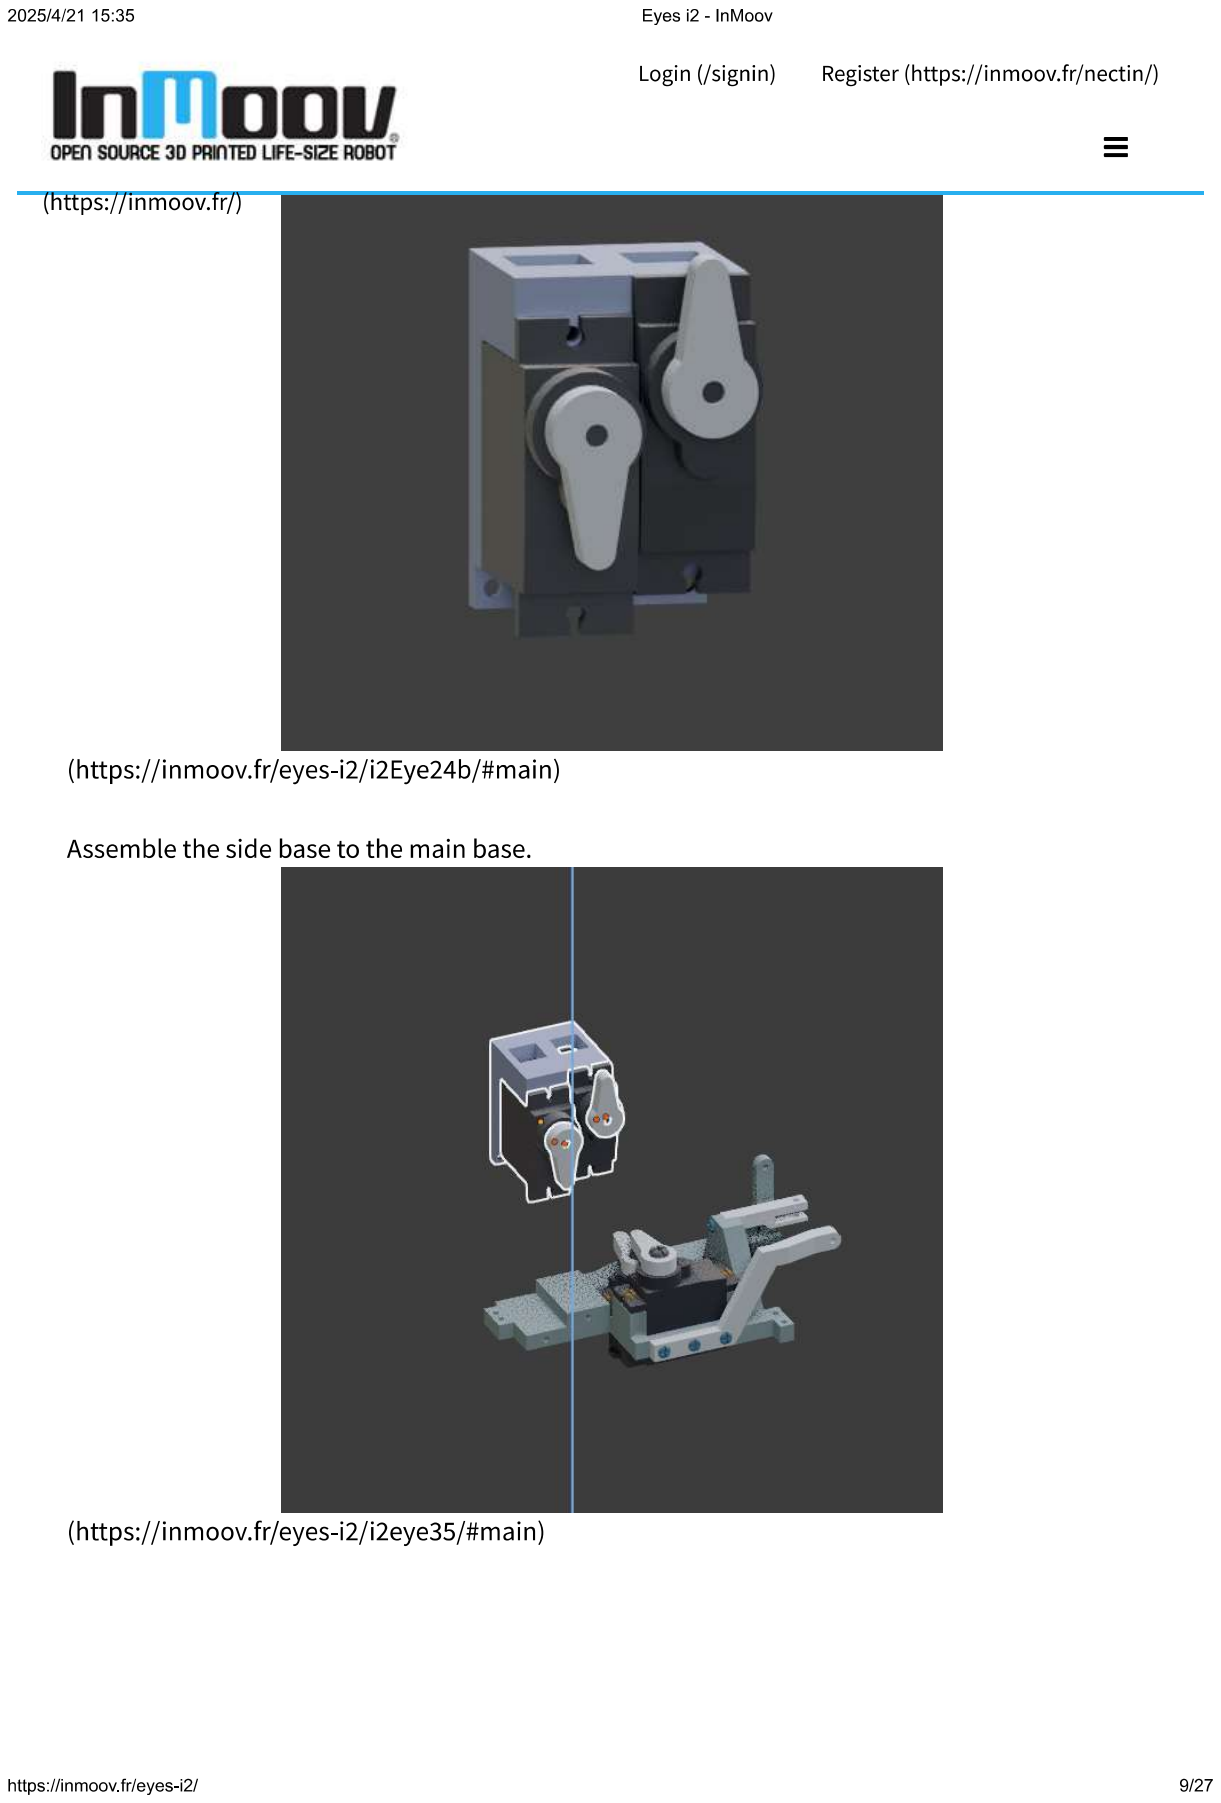
[picture p292: page 9]
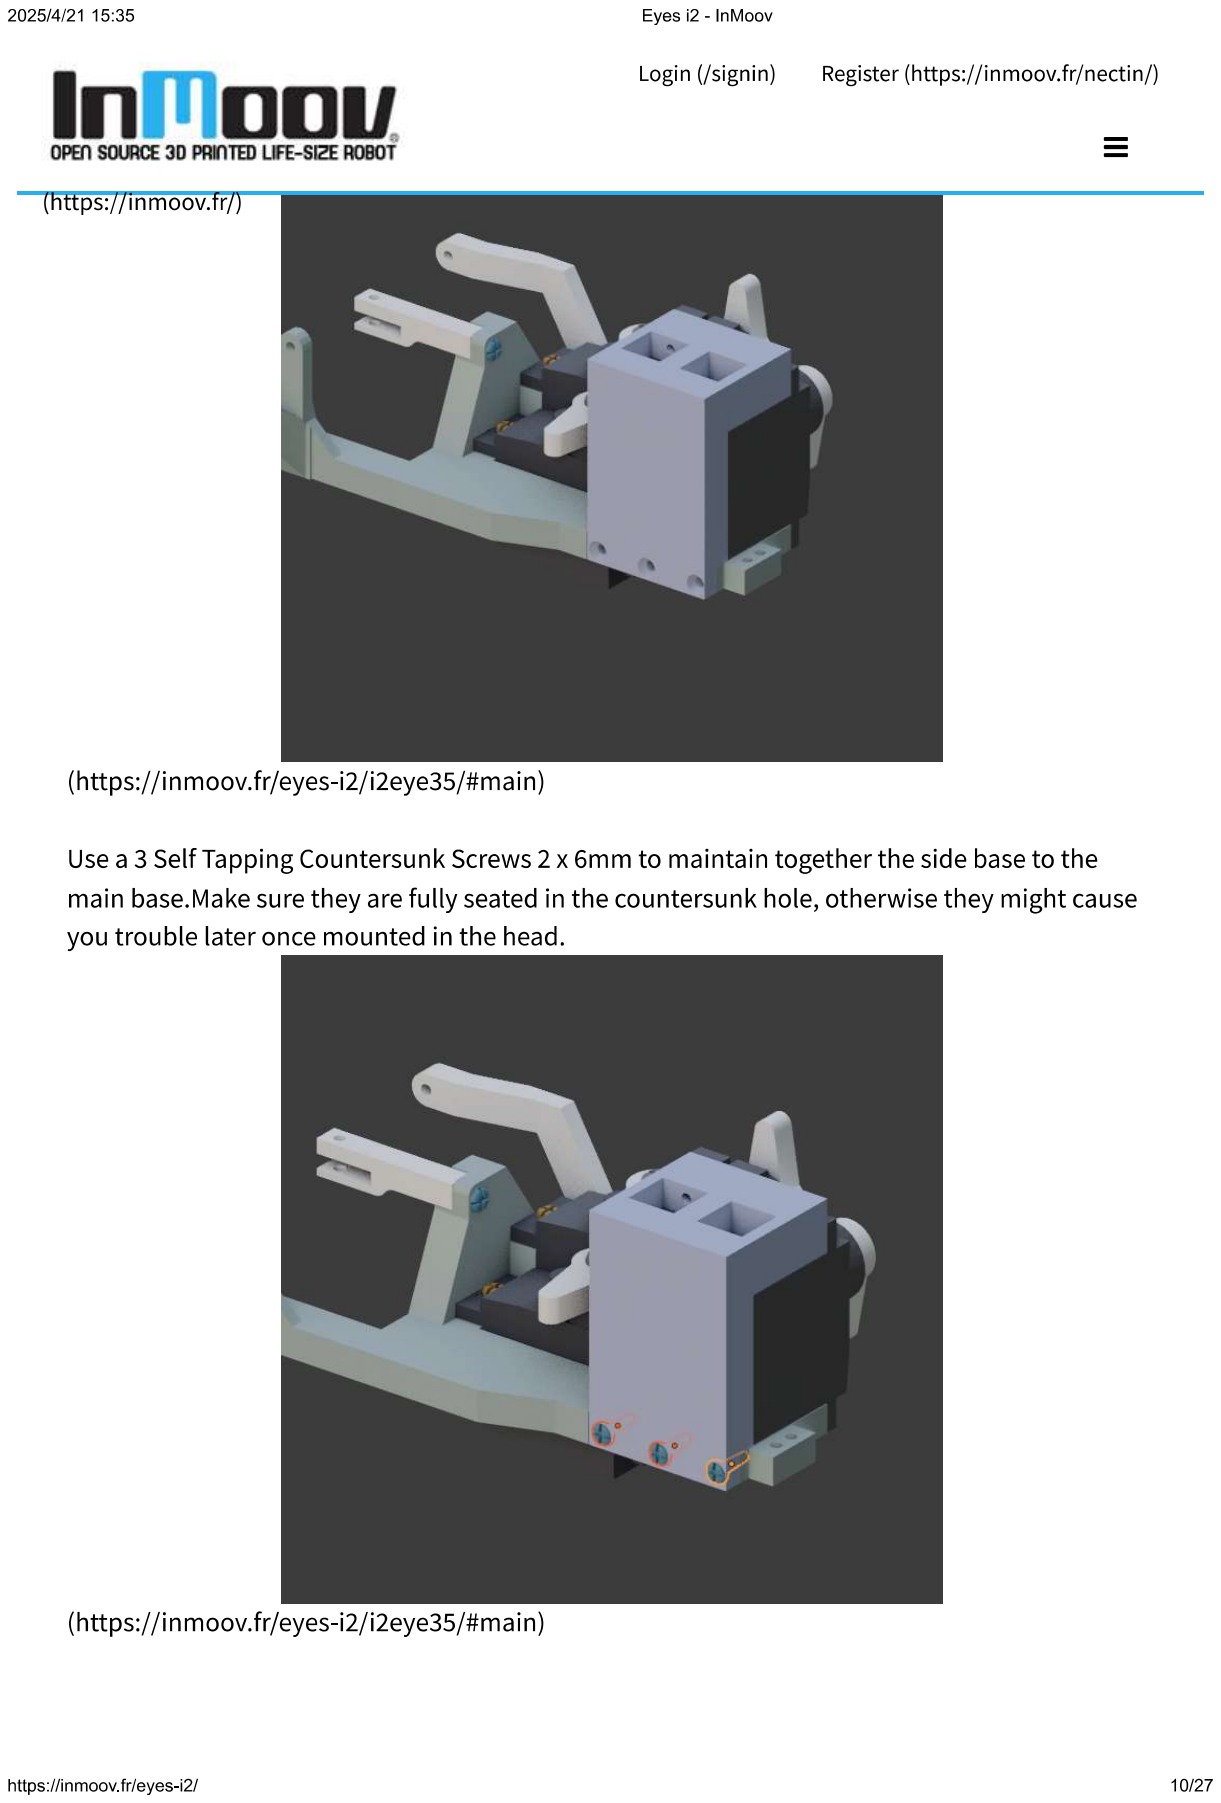
[picture p293: page 10]
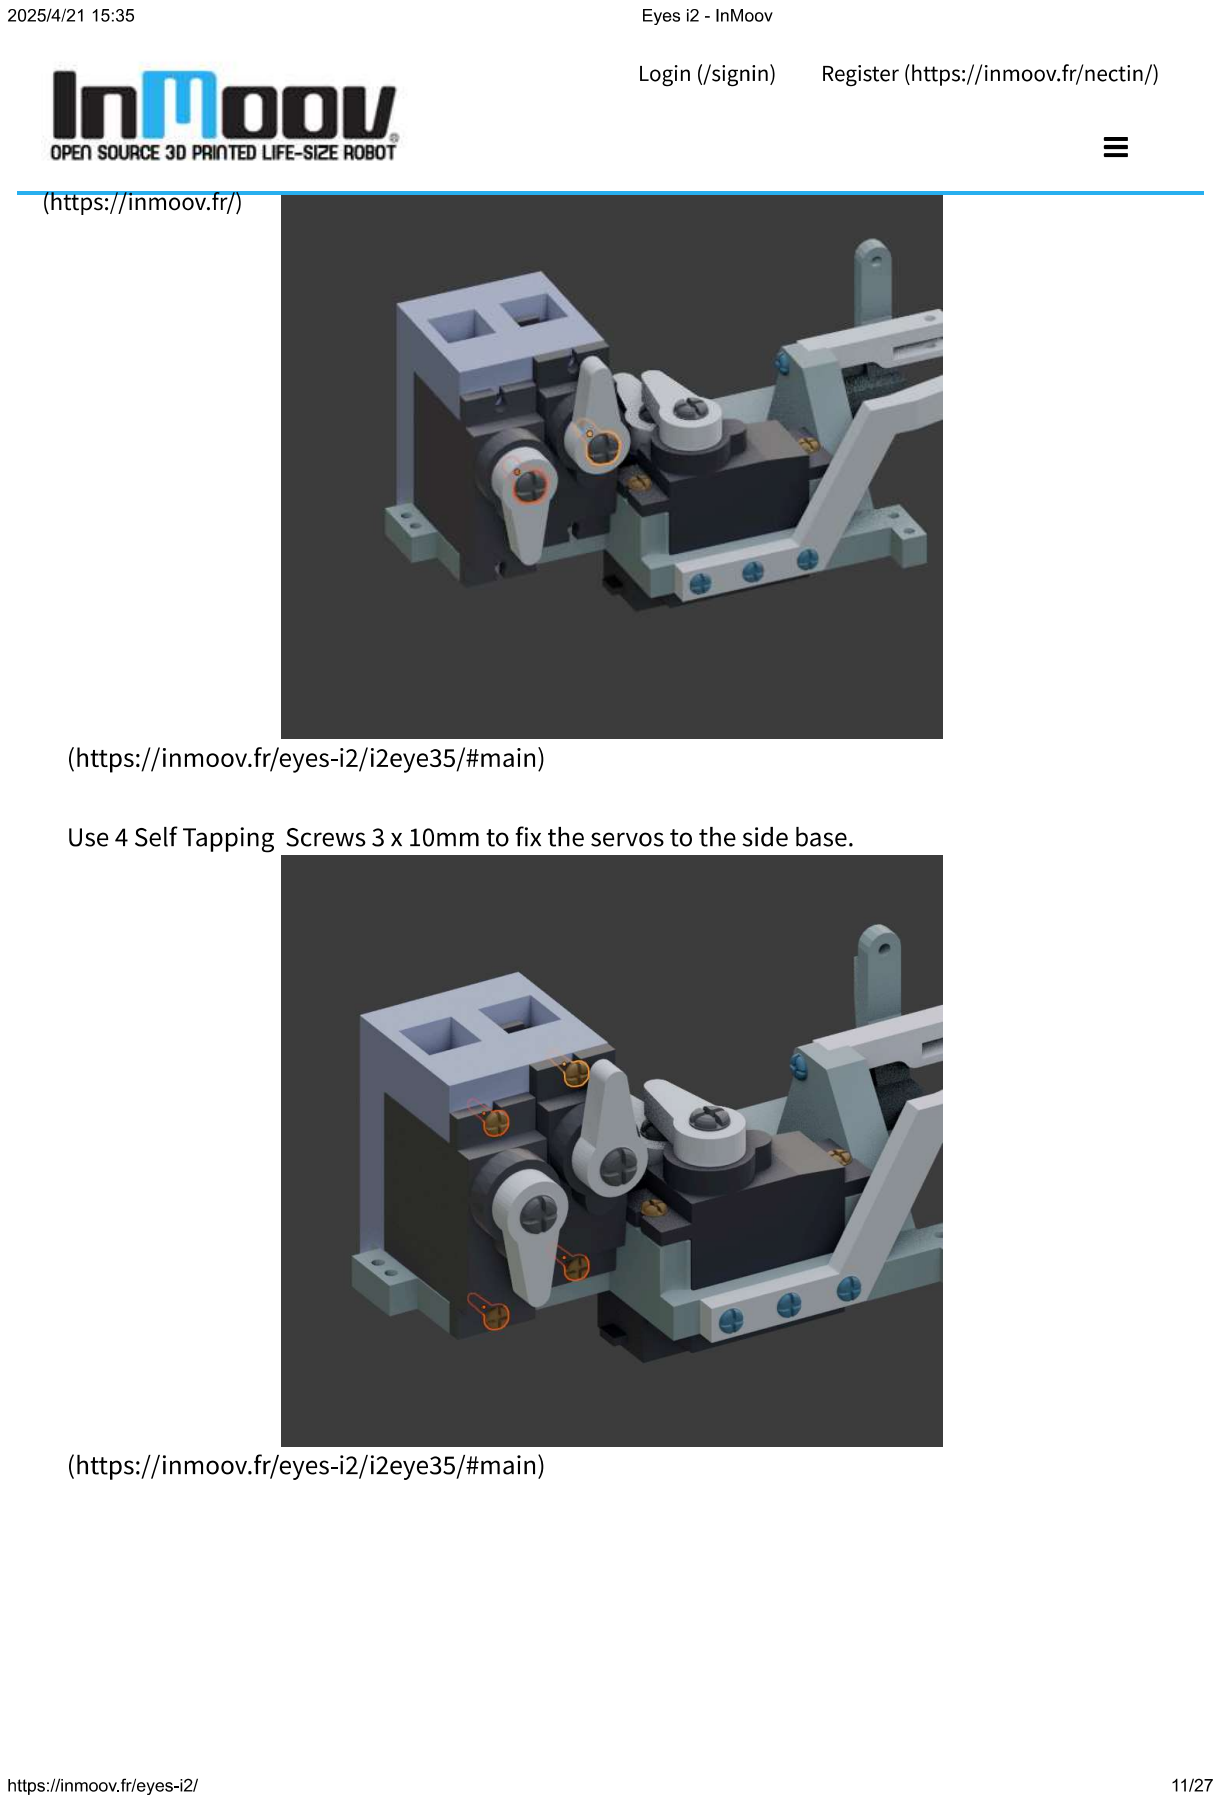
[picture p294: page 11]
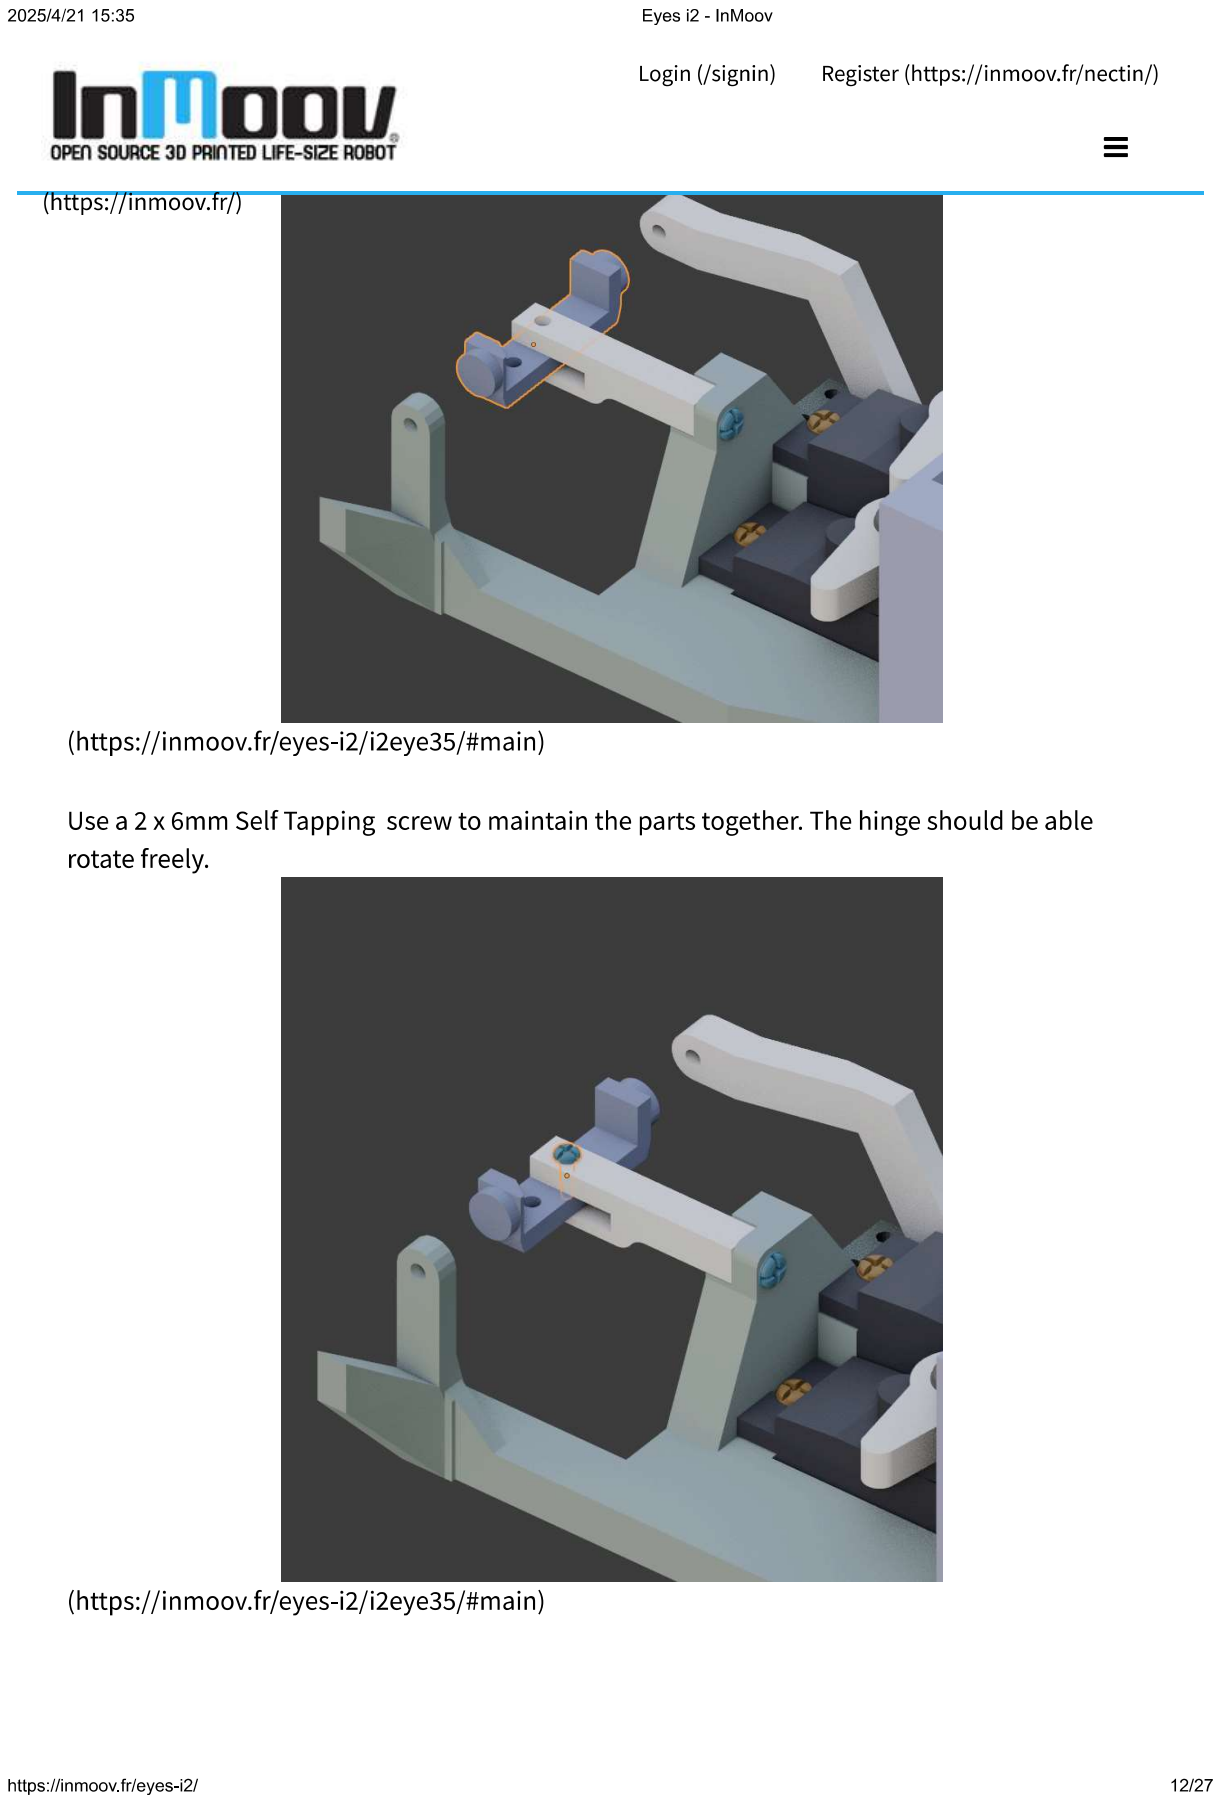
[picture p295: page 12]
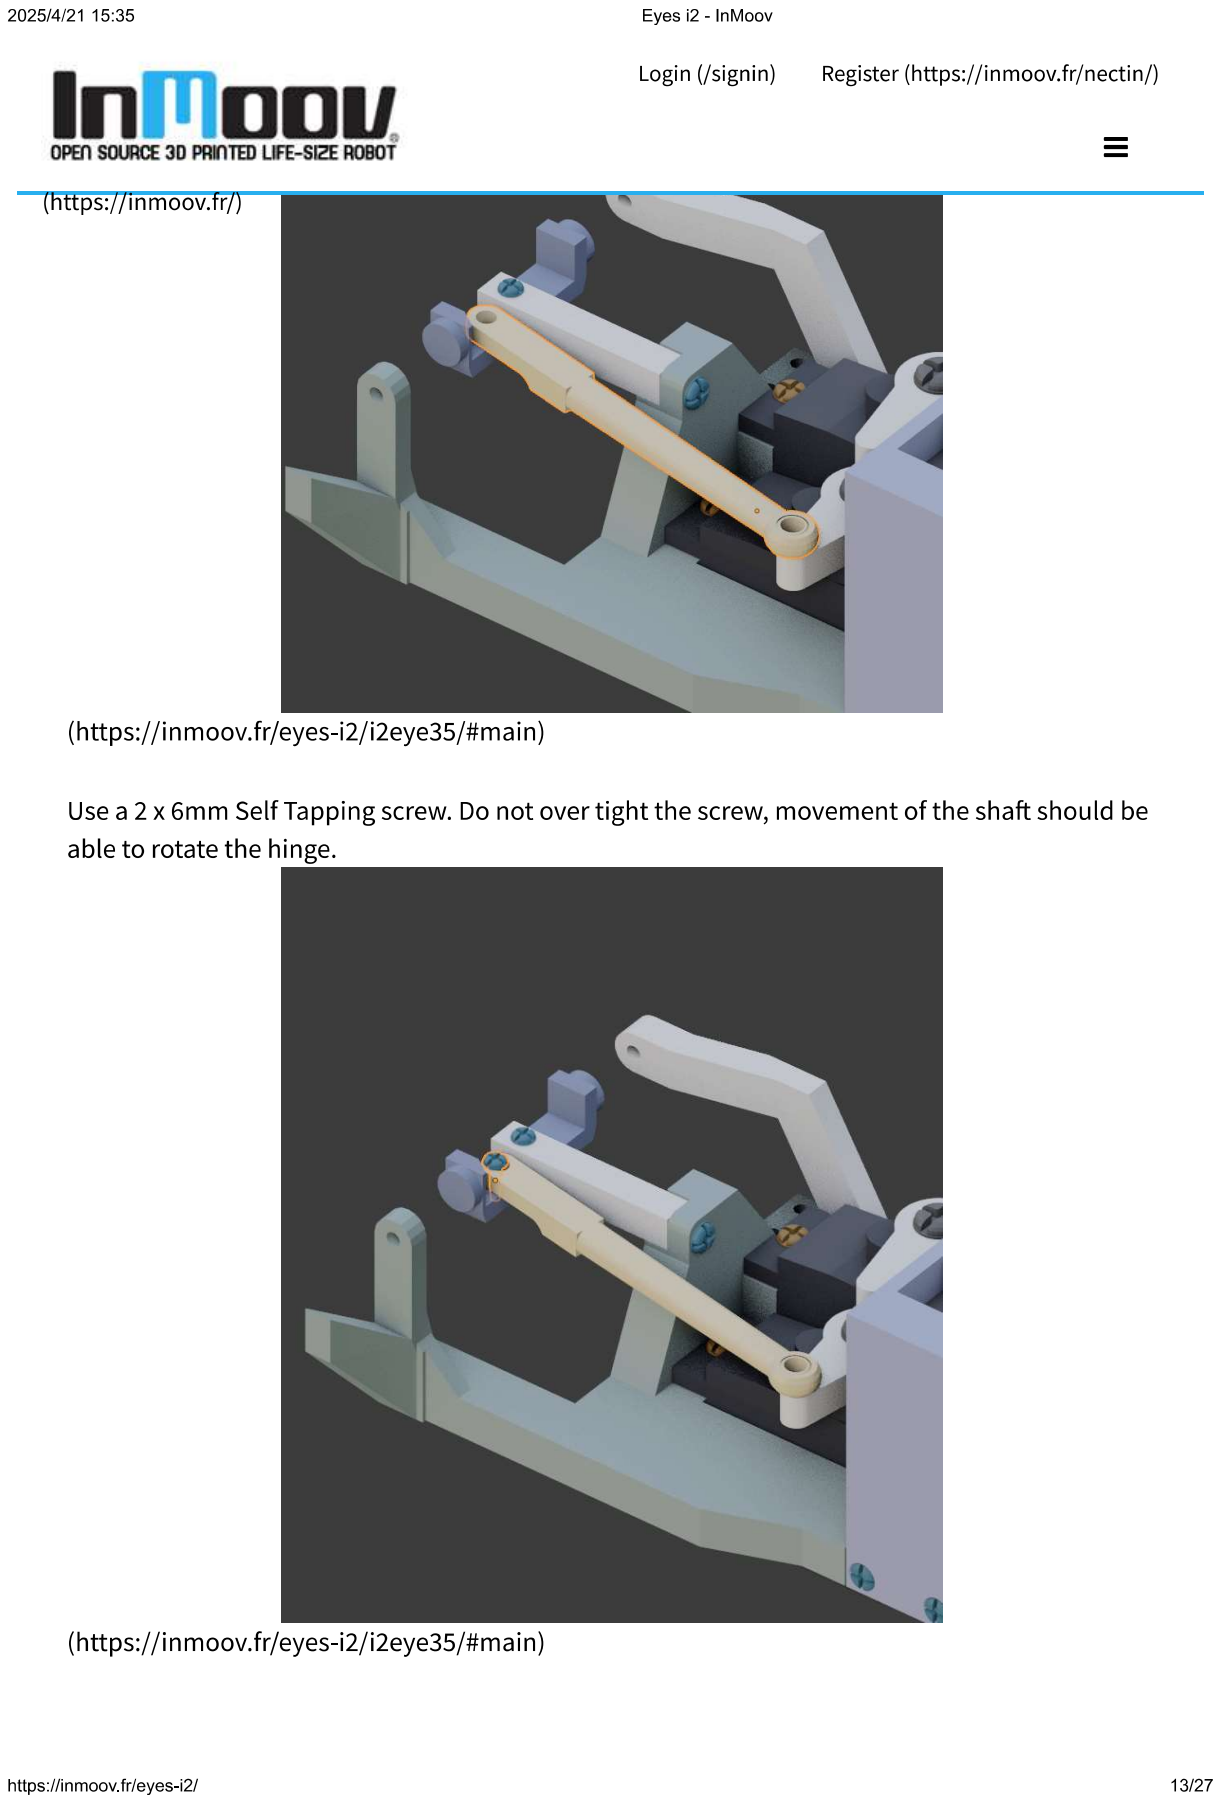
[picture p296: page 13]
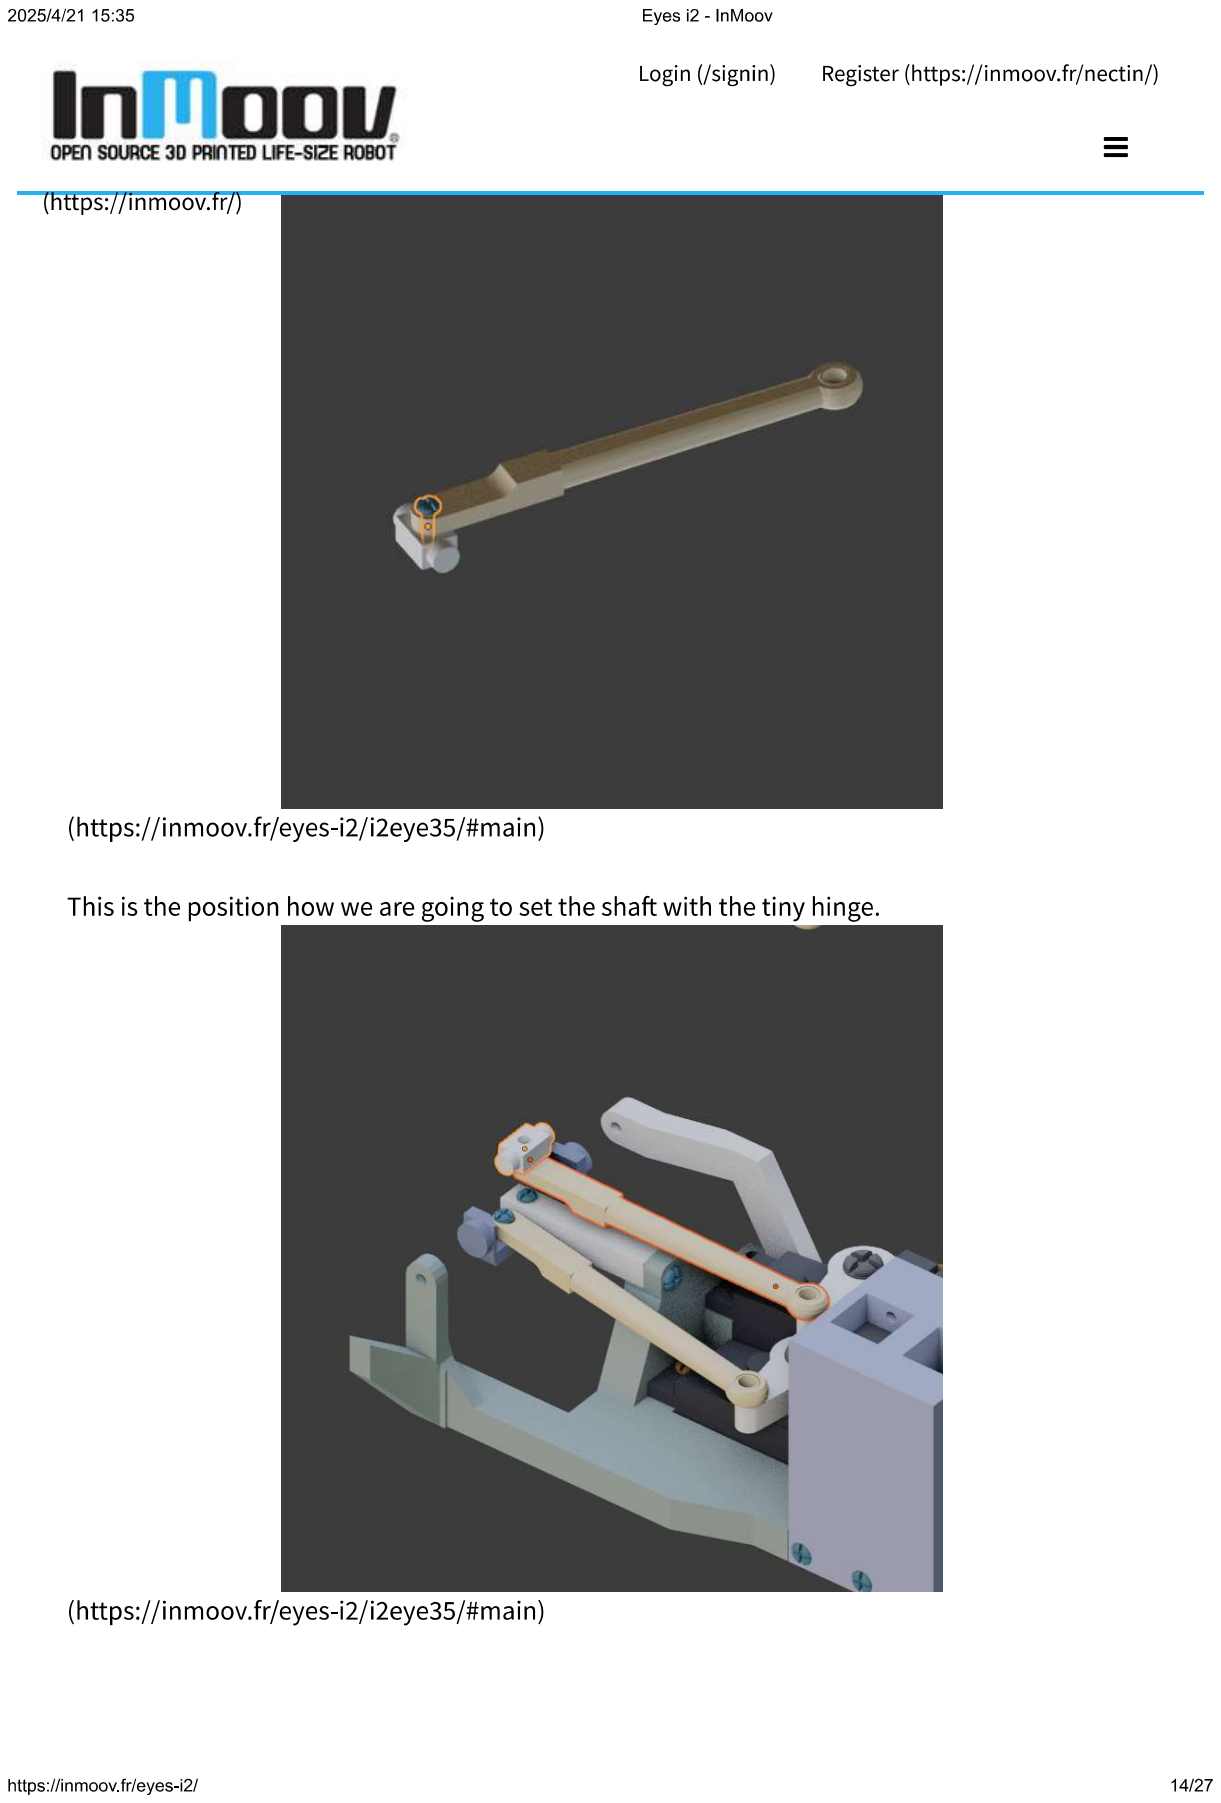
[picture p297: page 14]
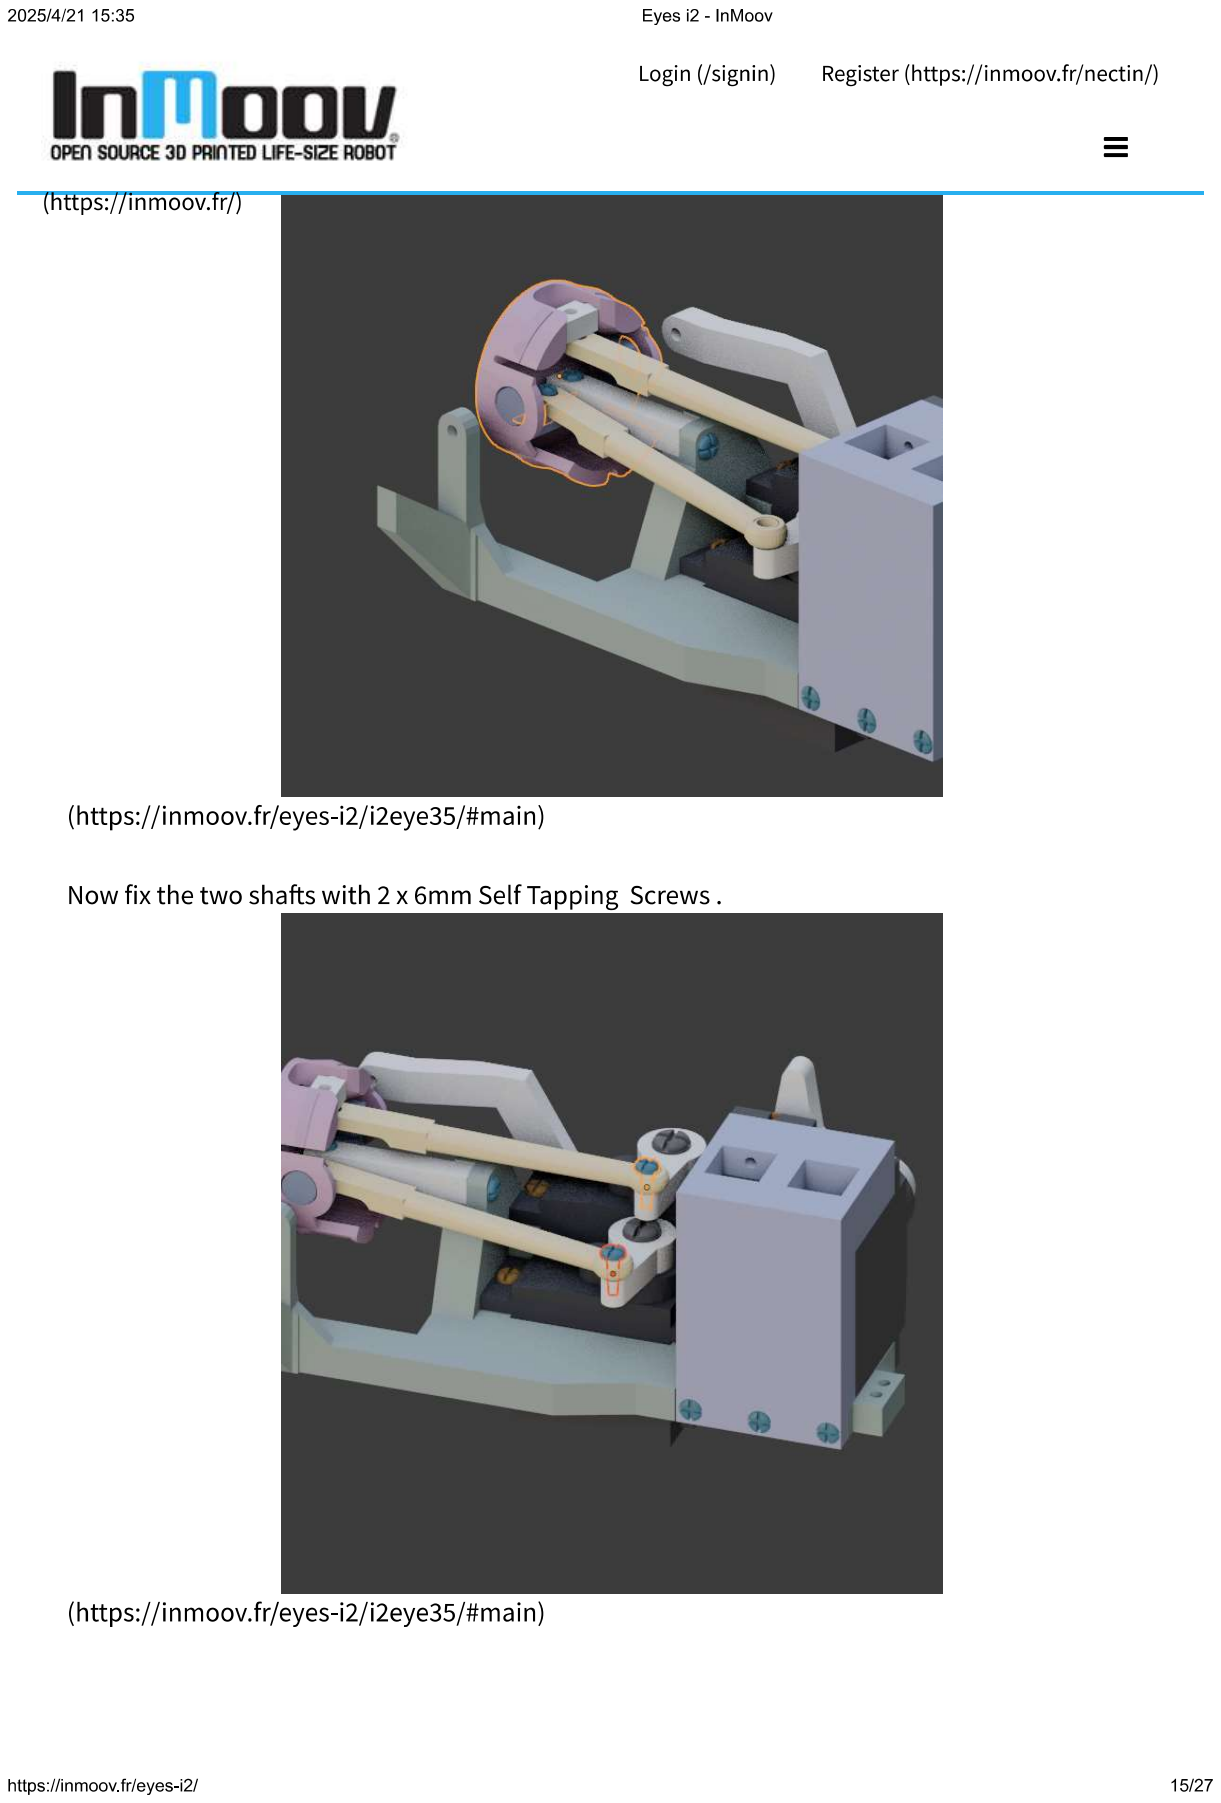
[picture p298: page 15]
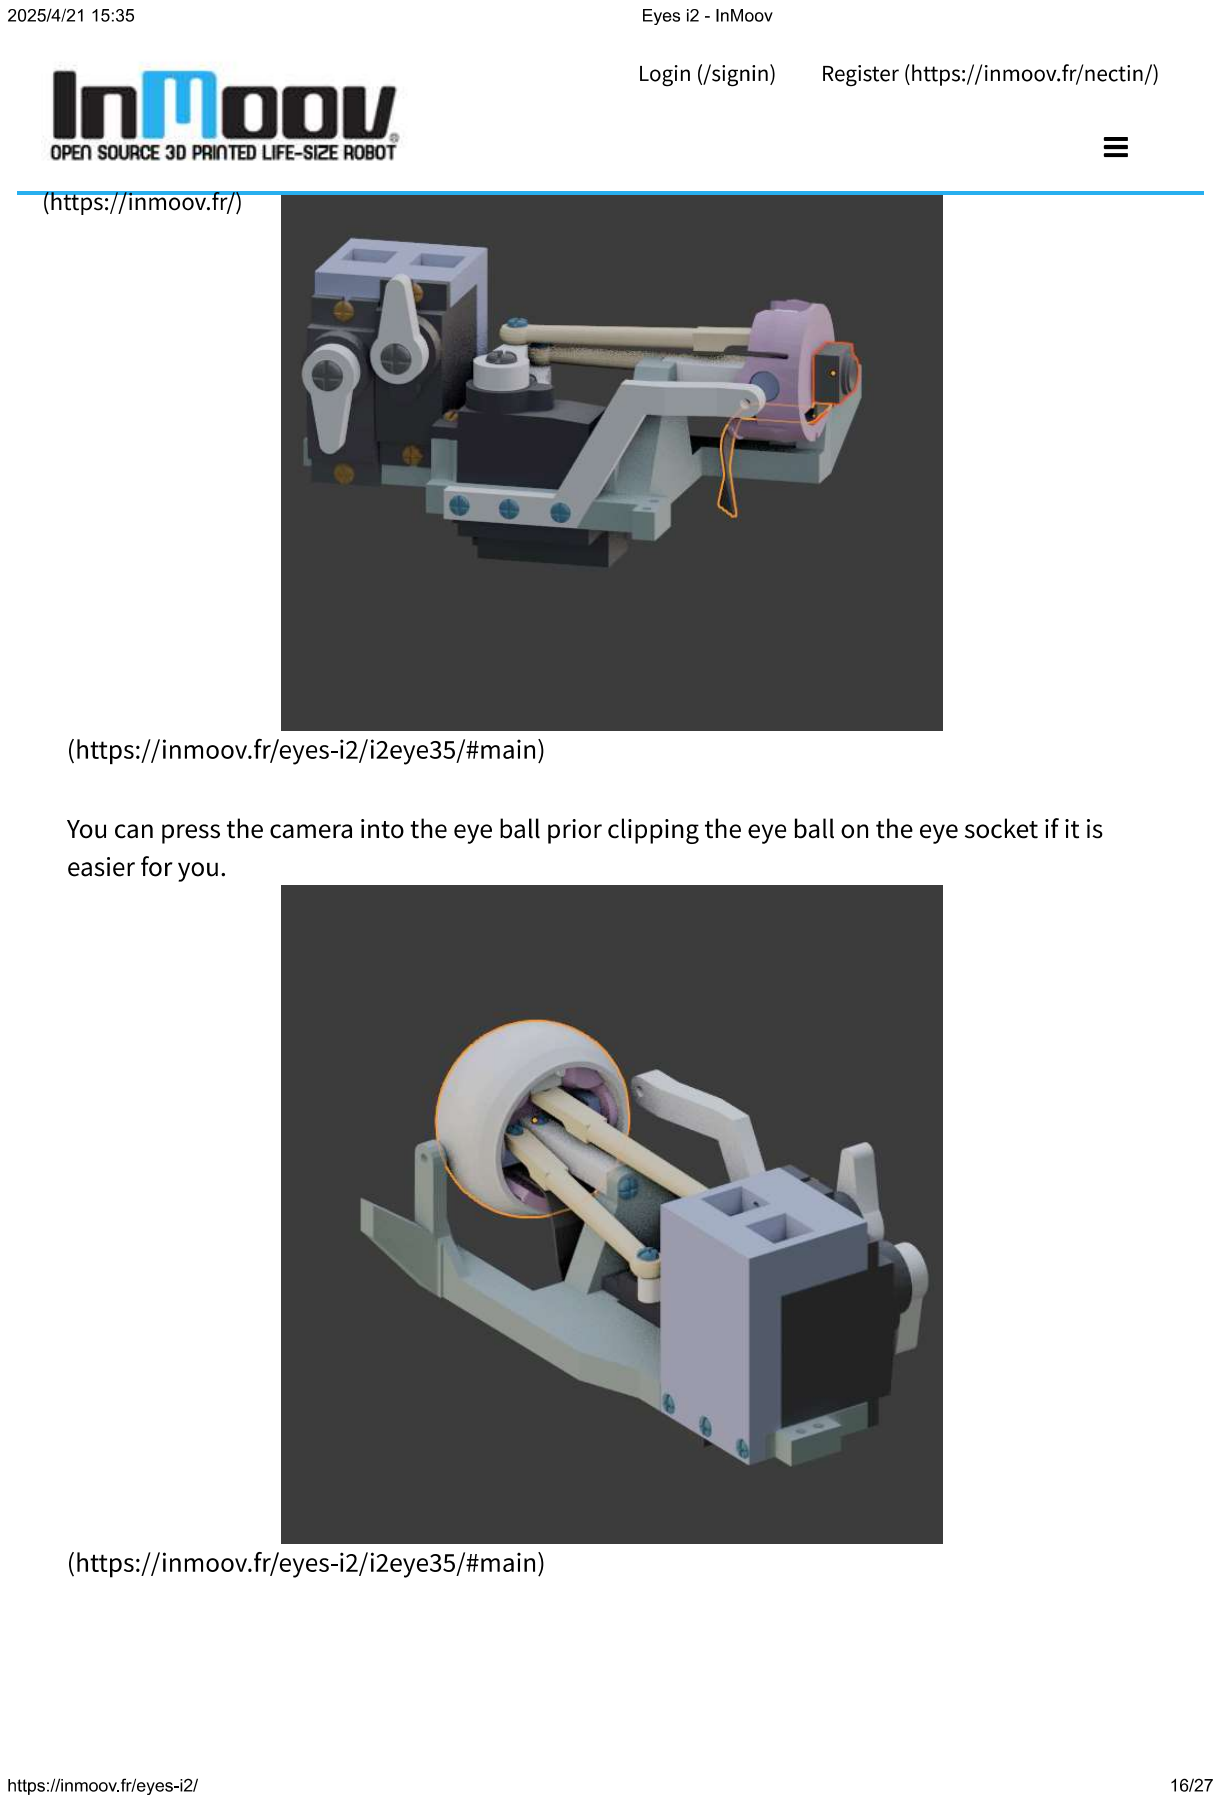
[picture p299: page 16]
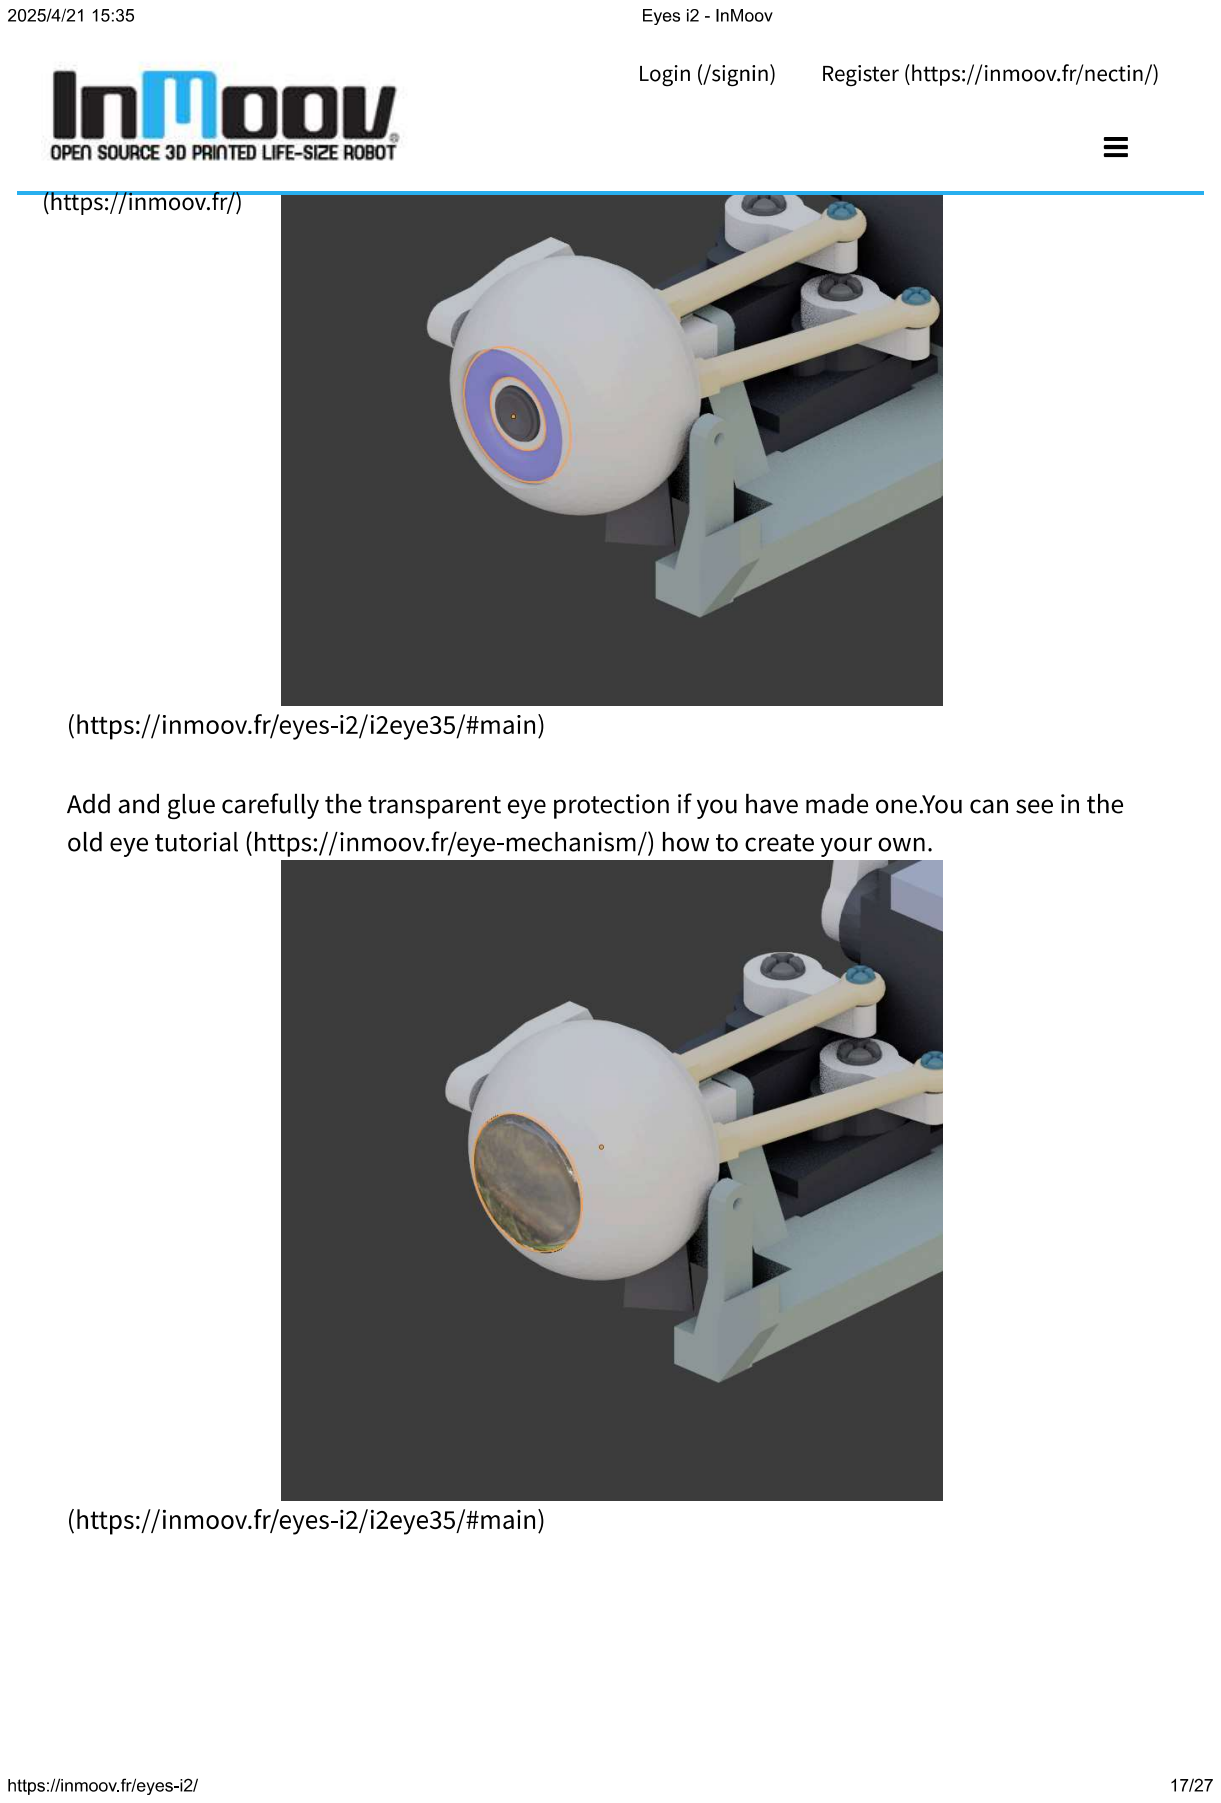
[picture p300: page 17]
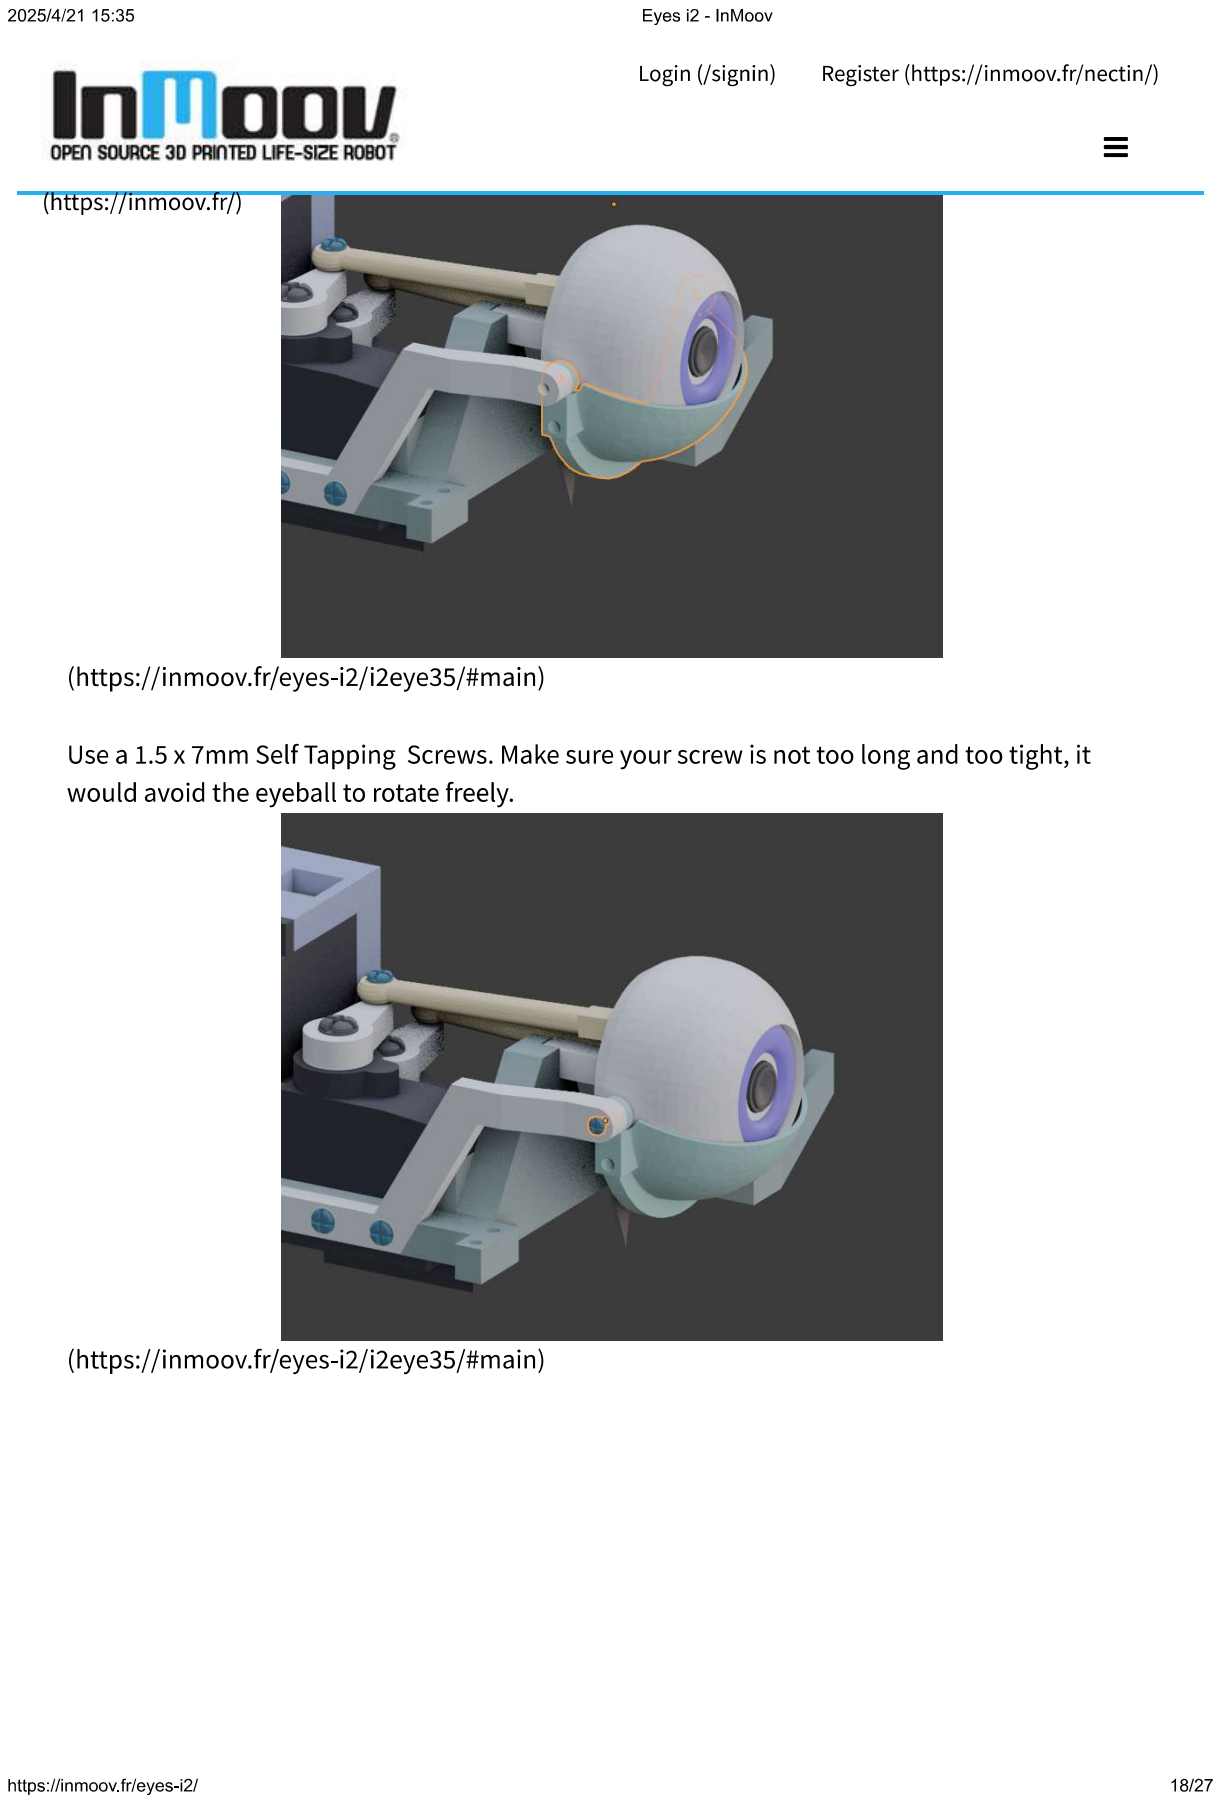
[picture p301: page 18]
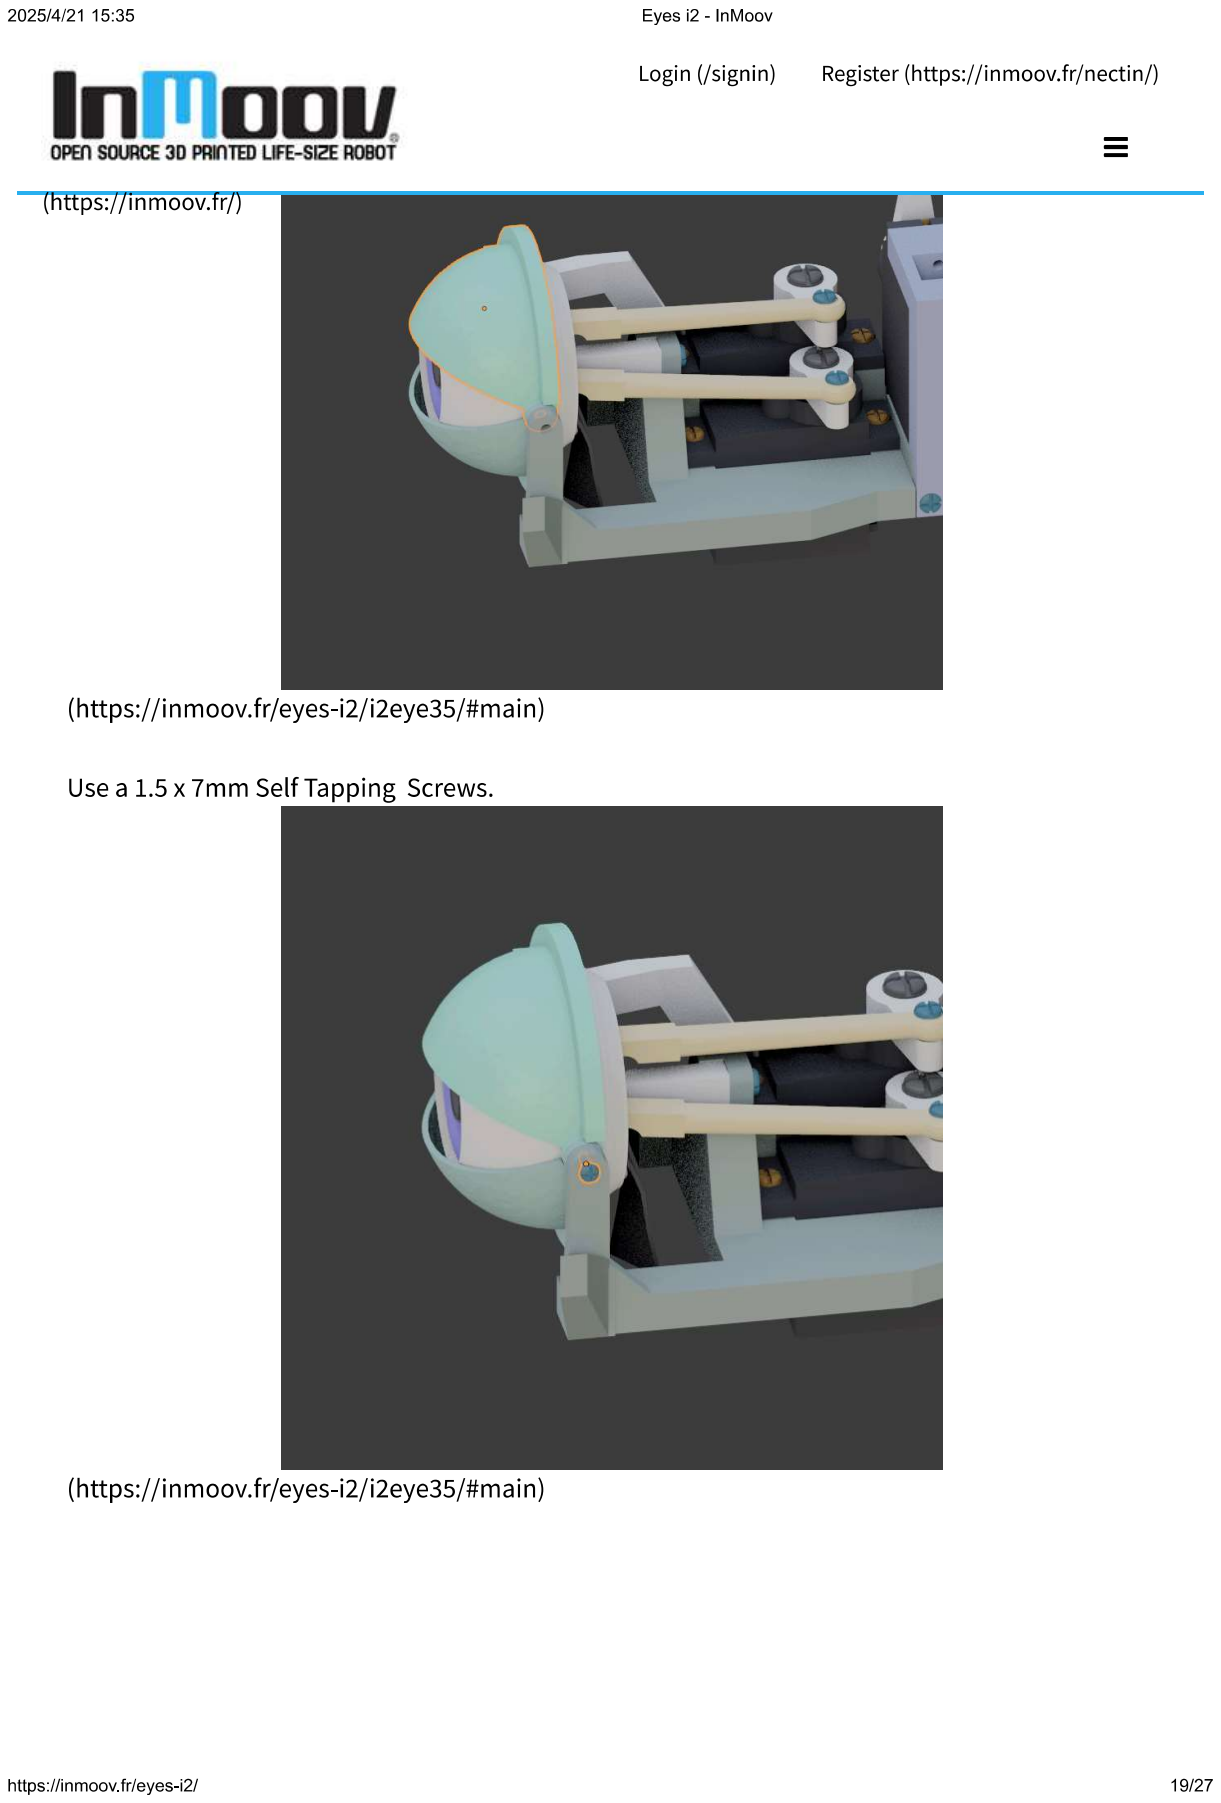
[picture p302: page 19]
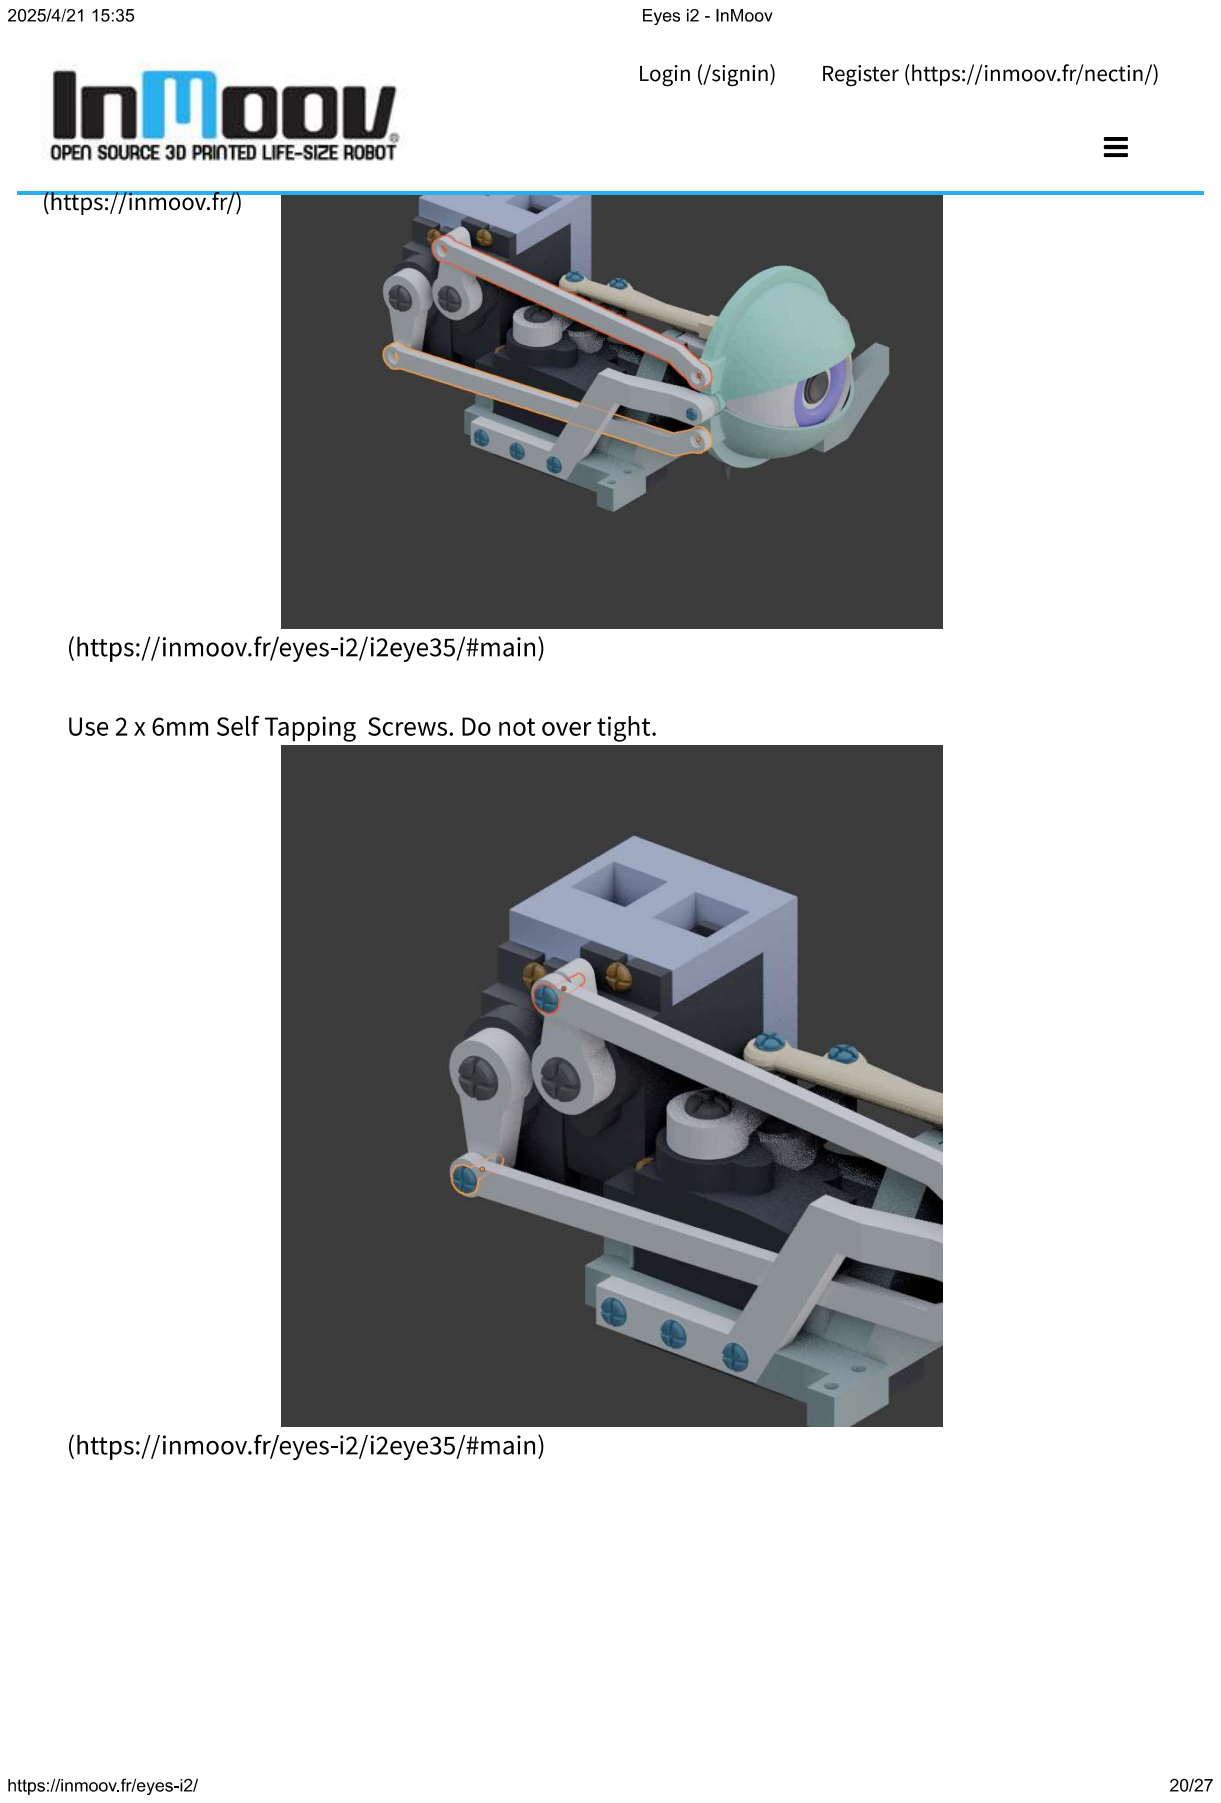
[picture p303: page 20]
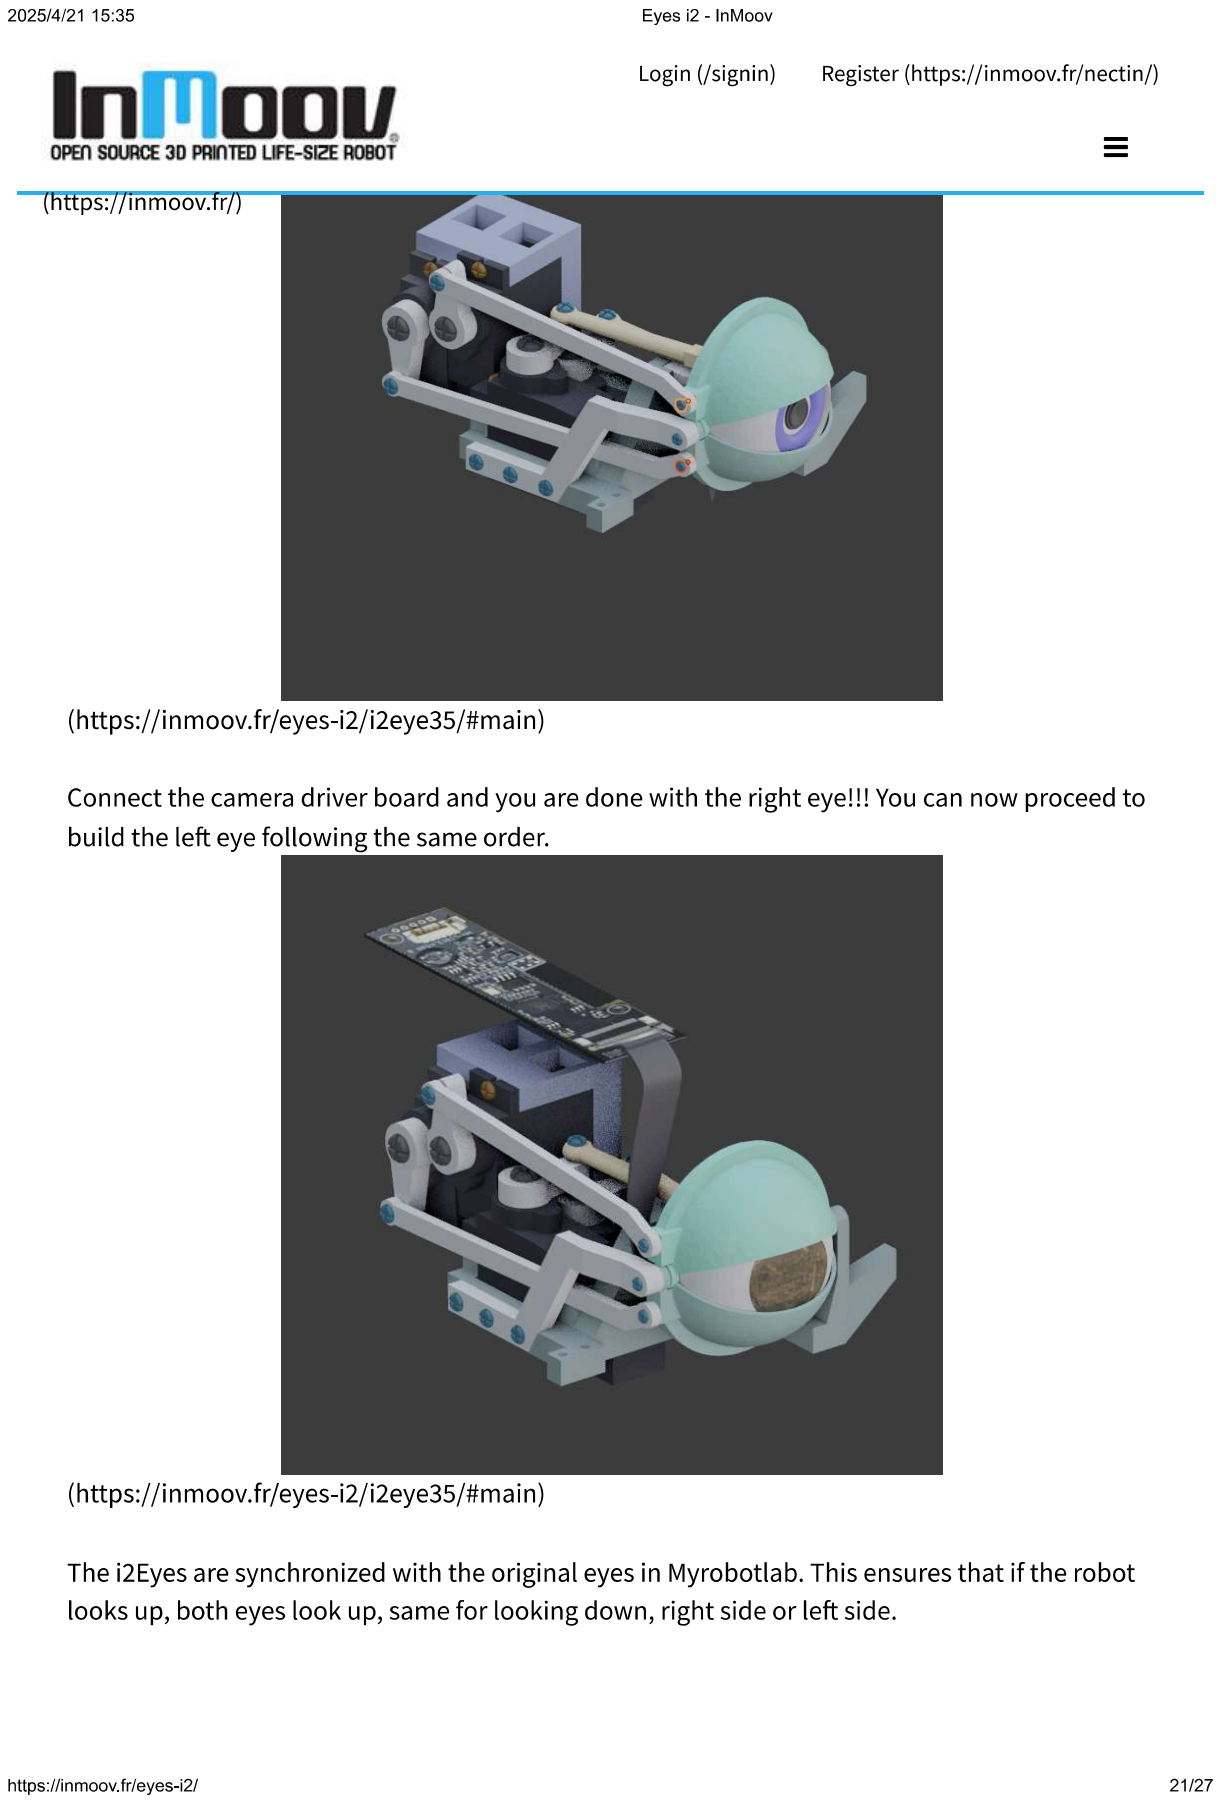
[picture p304: page 21]
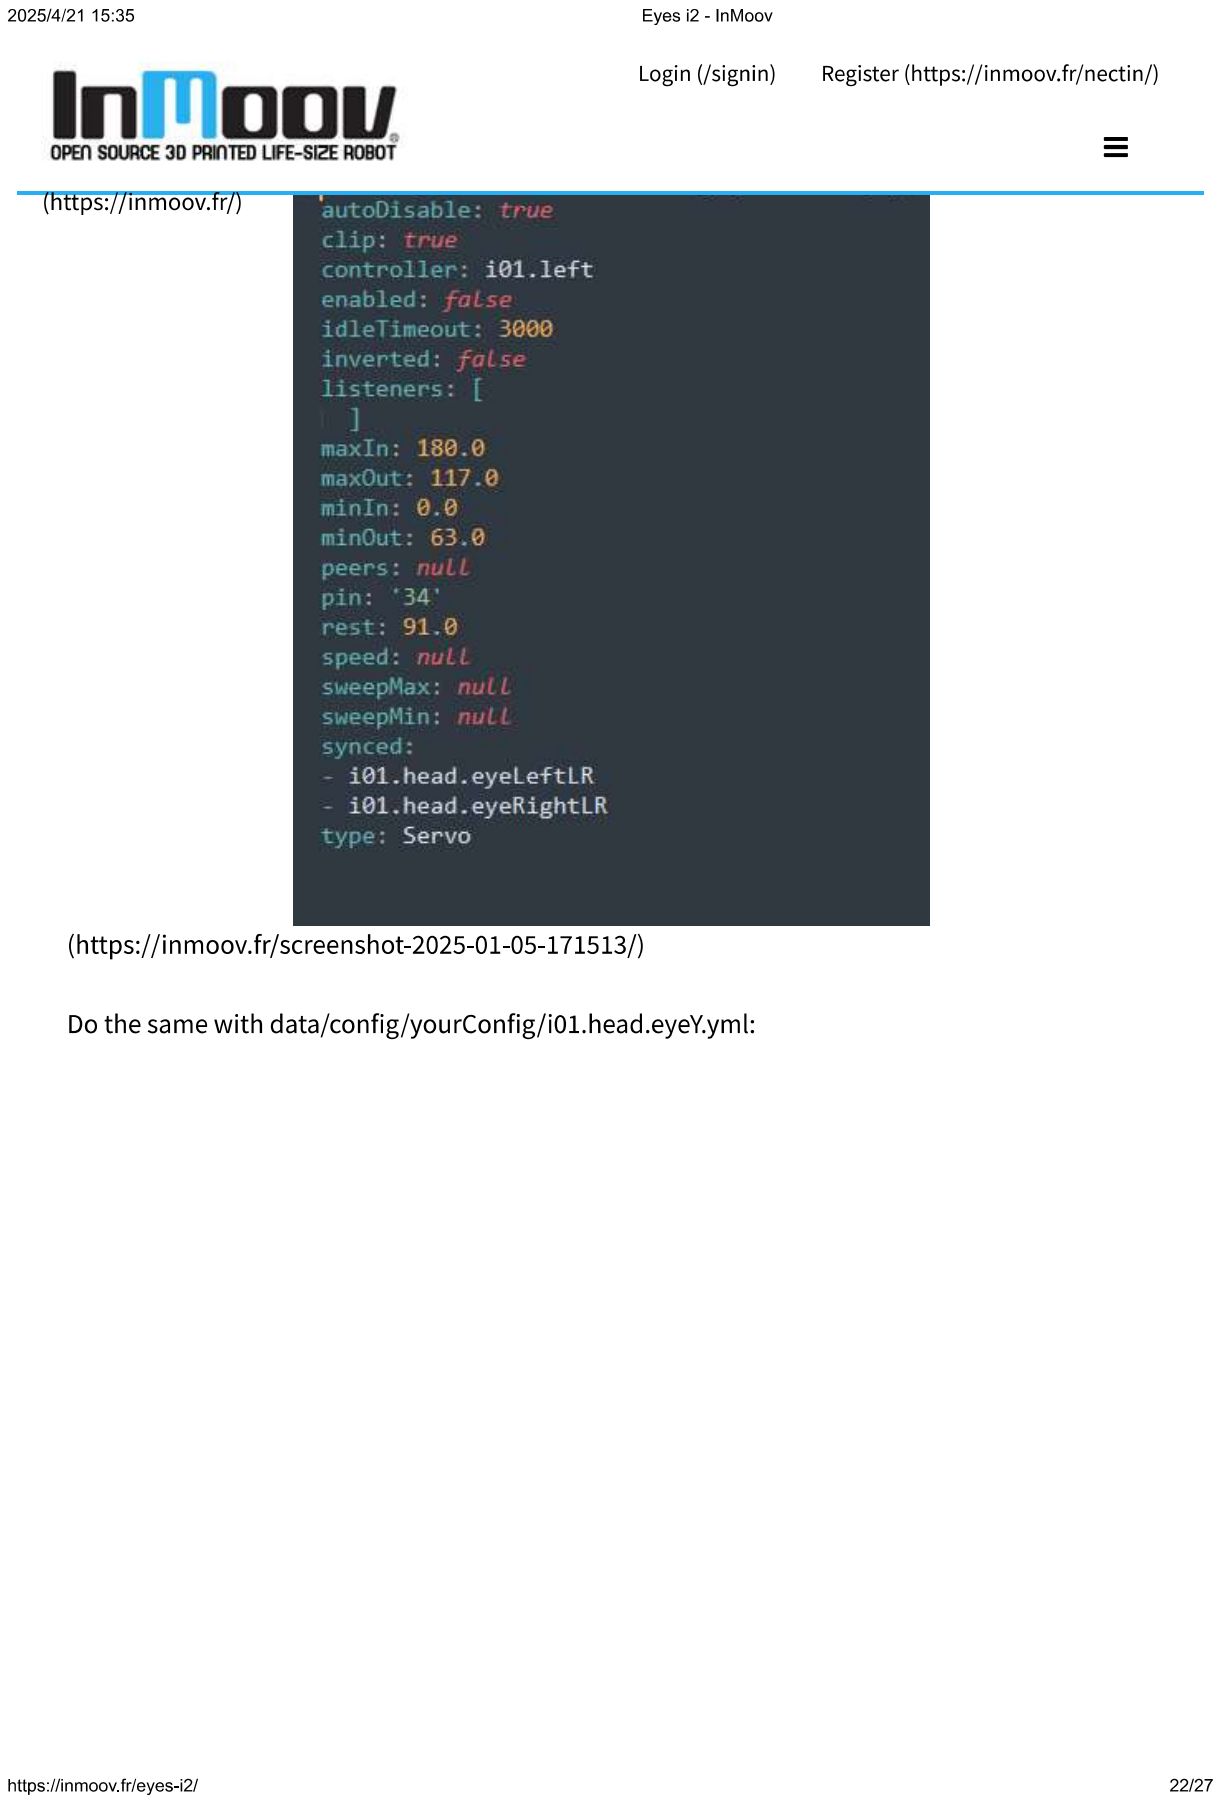
[picture p305: page 22]
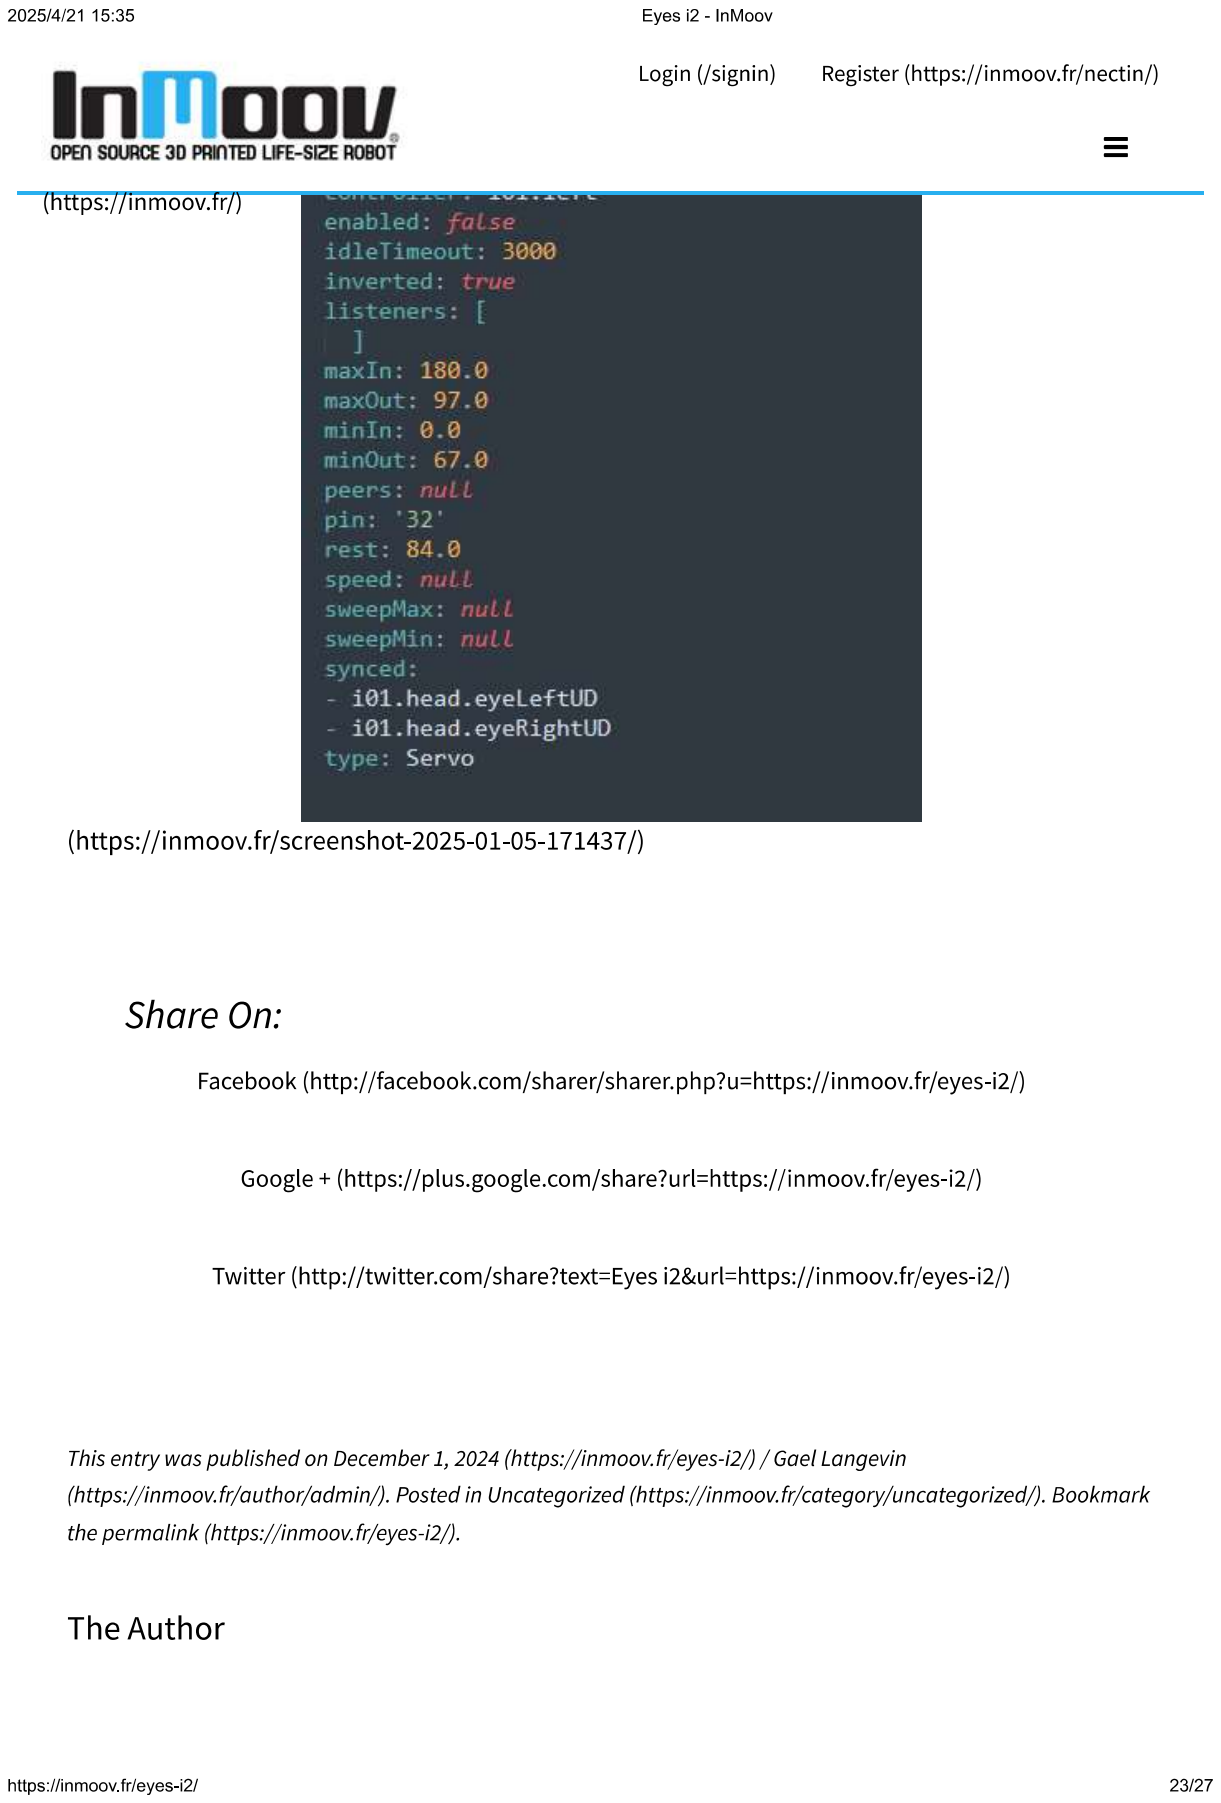
[picture p306: page 23]
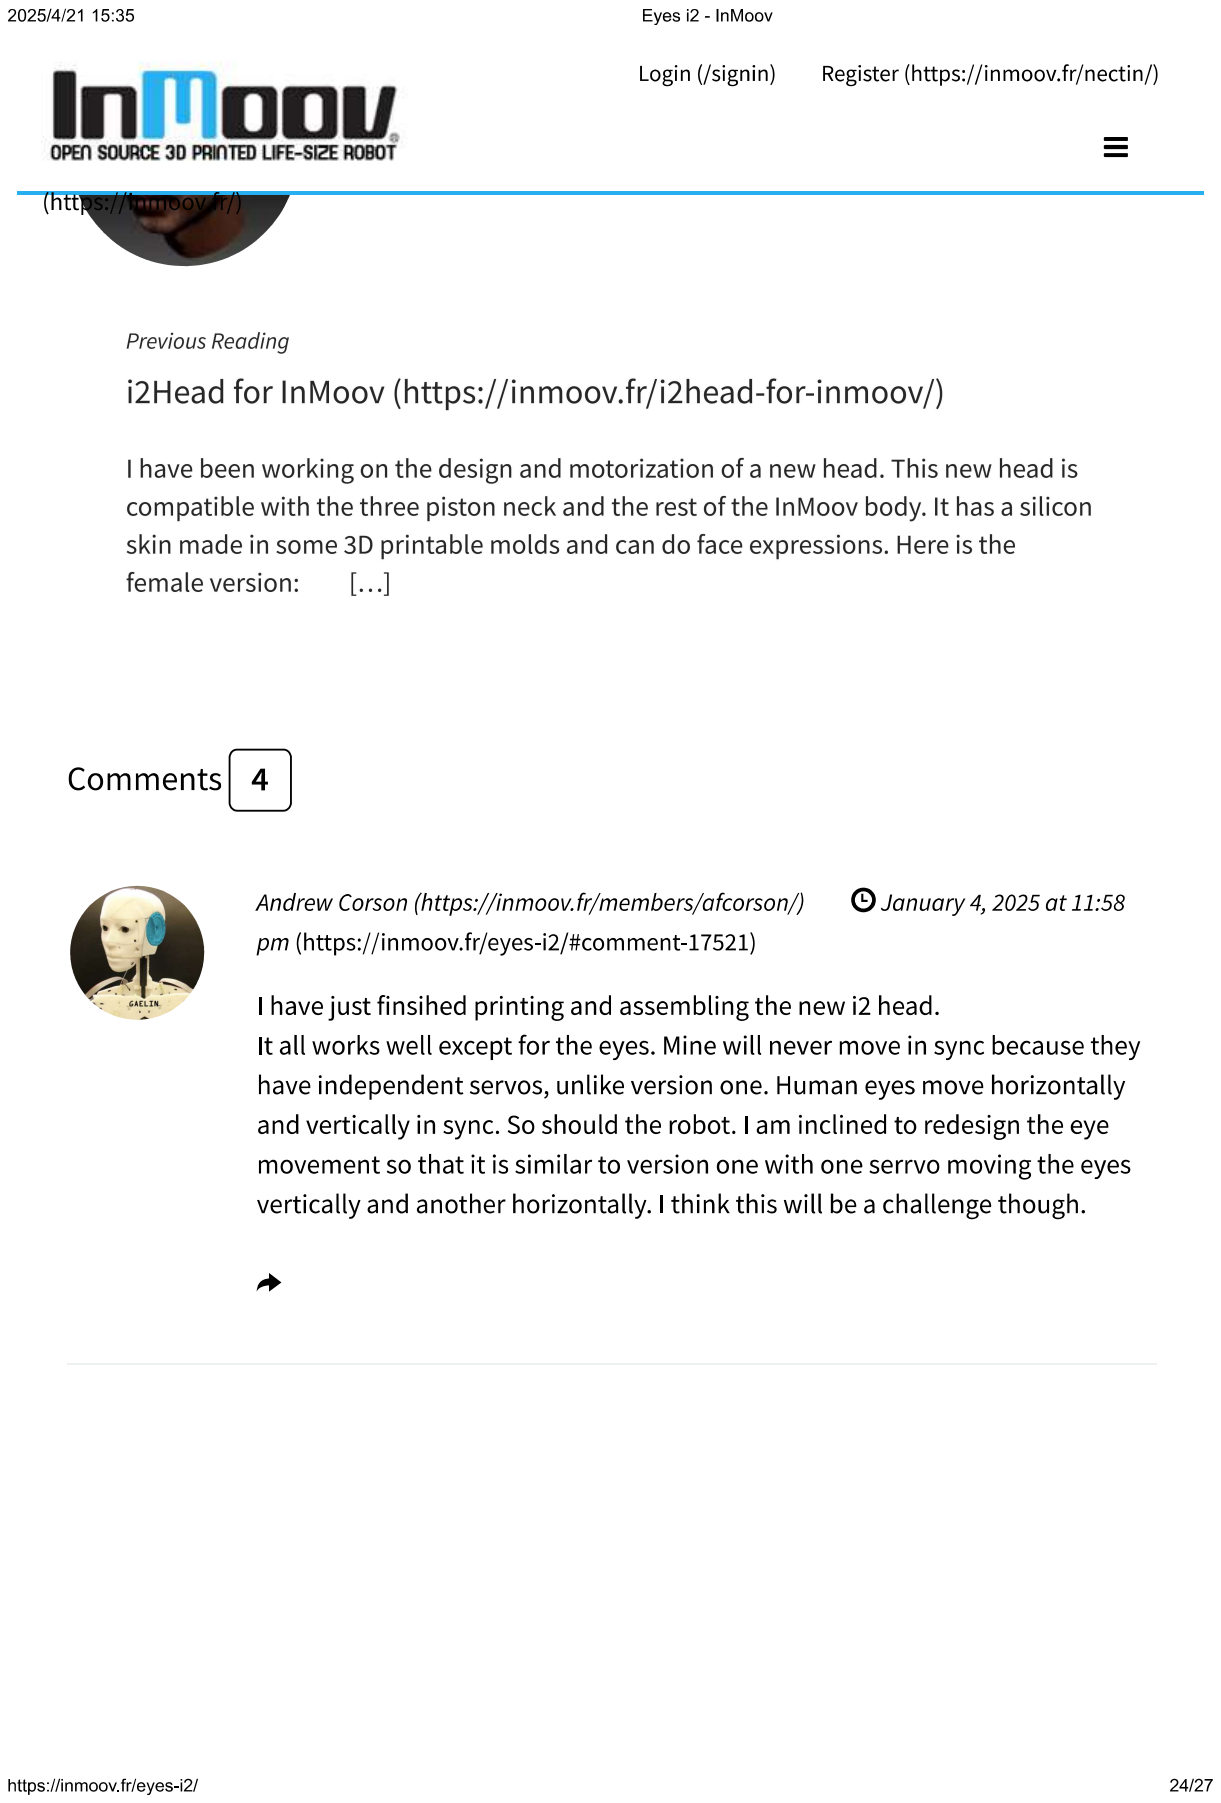
[picture p307: page 24]
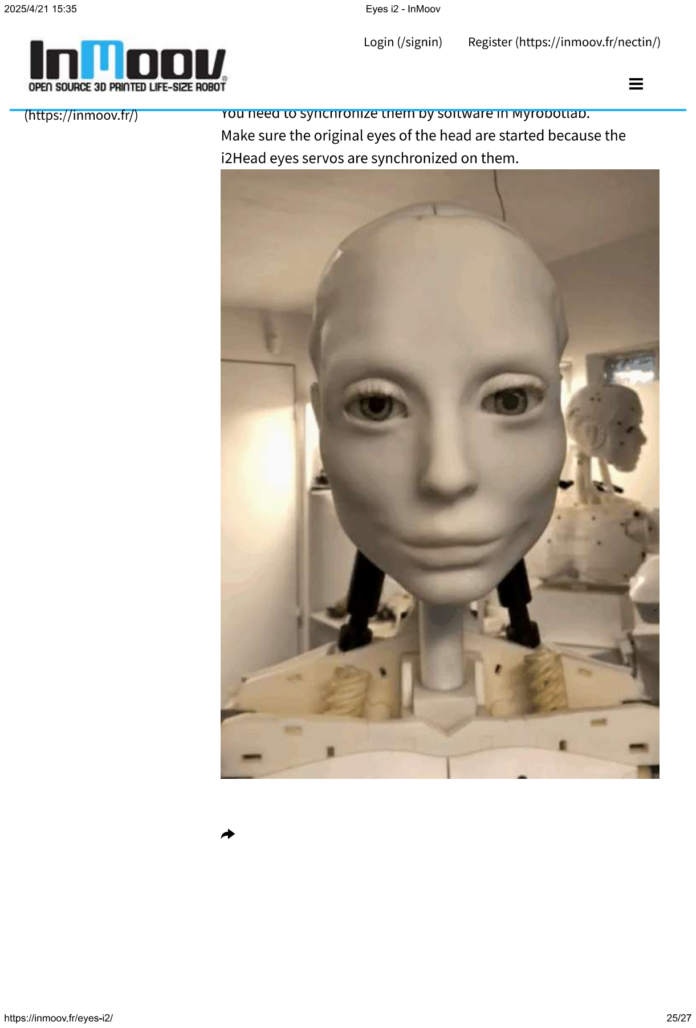
[picture p308: page 25]
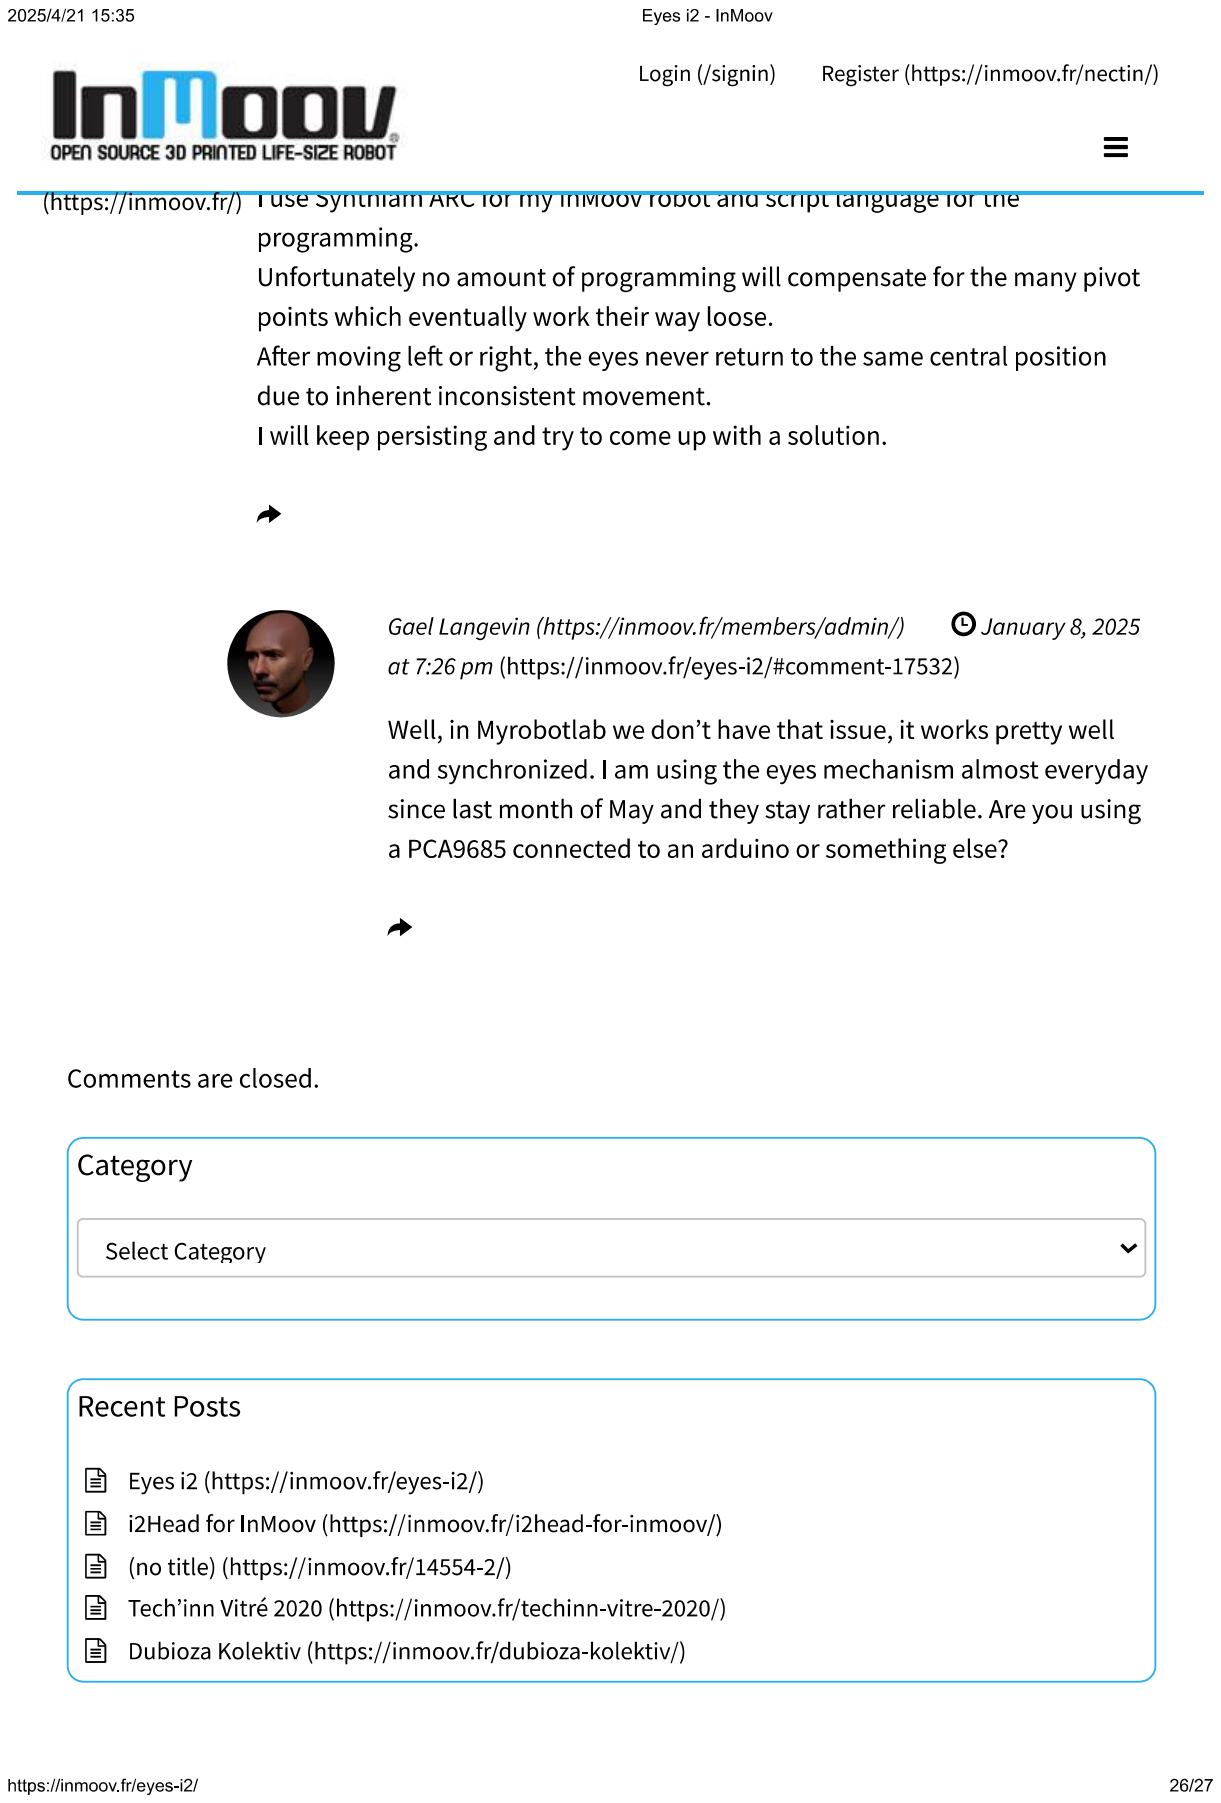
[picture p309: page 26]
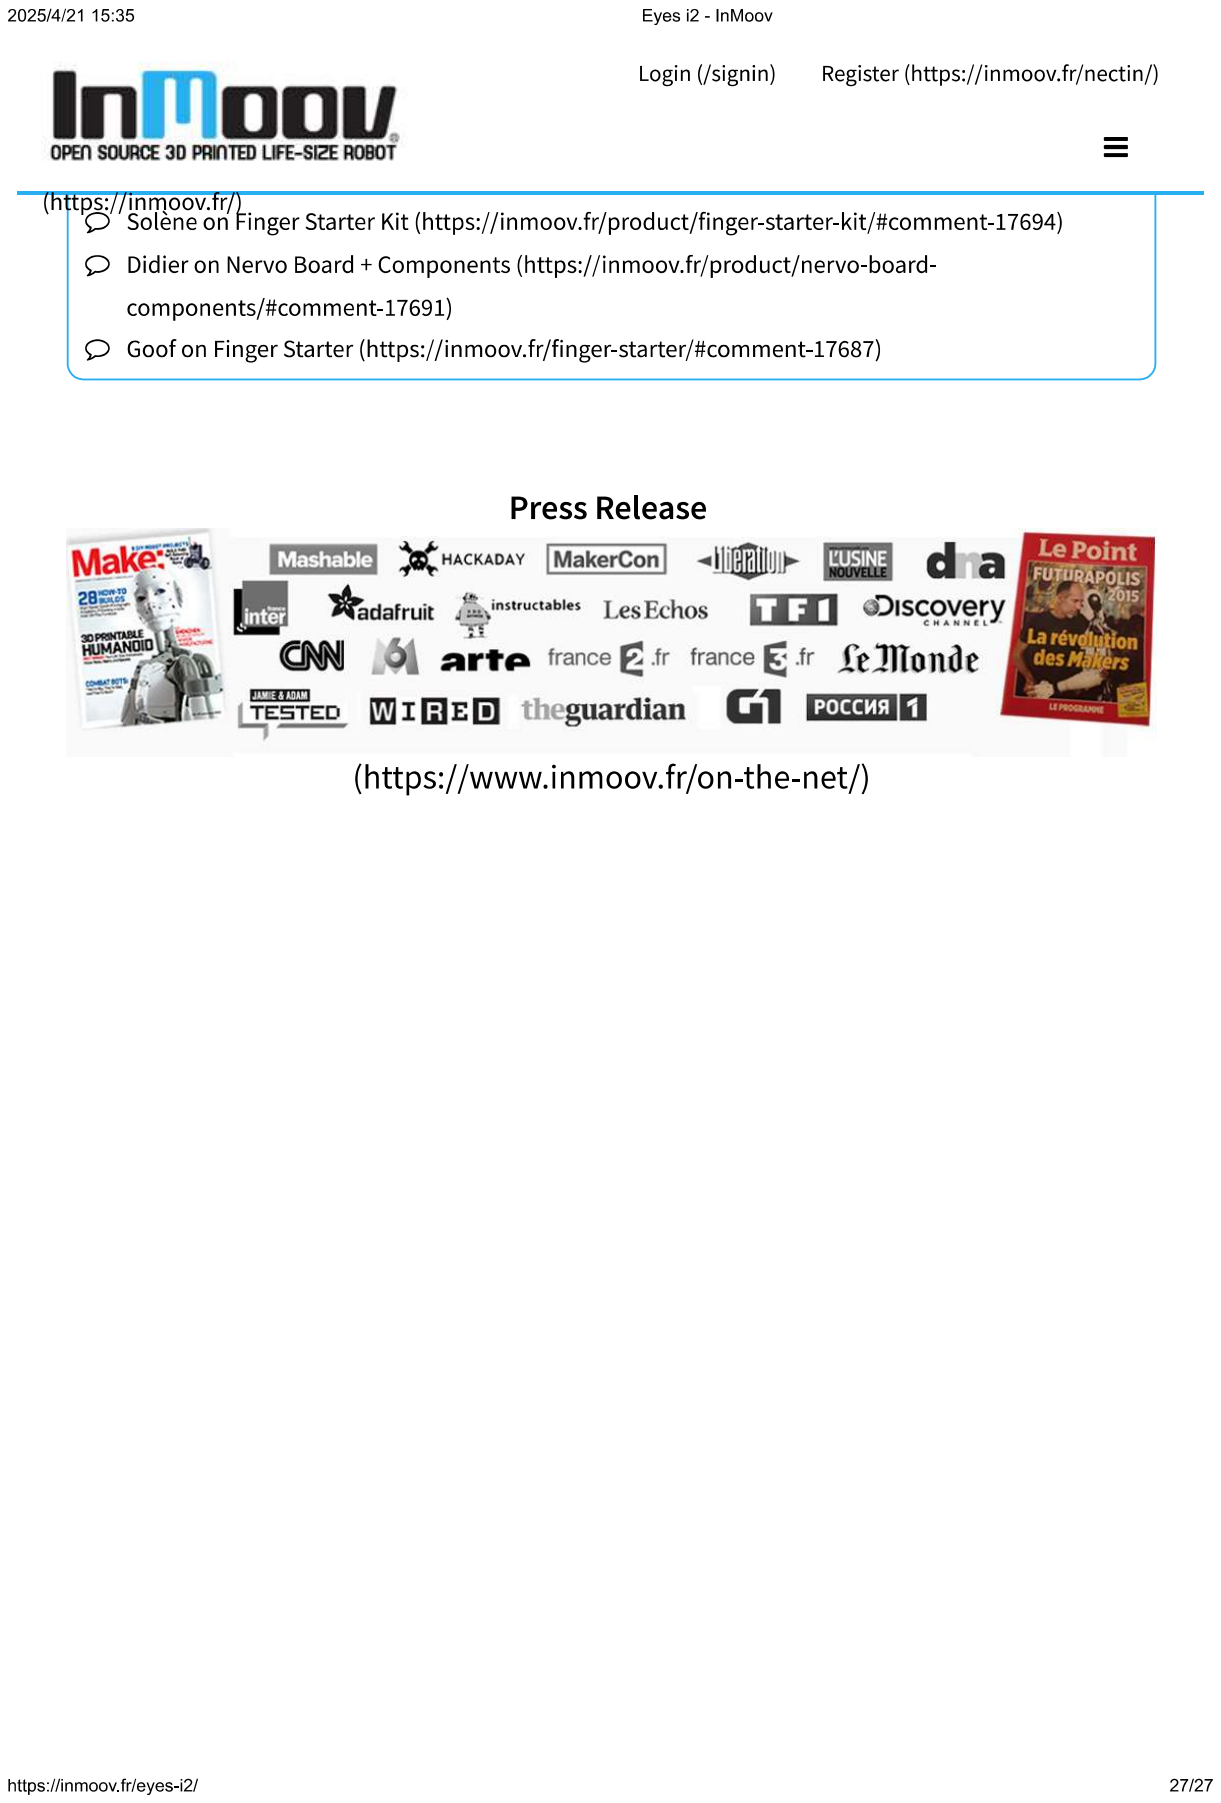
[picture p310: page 27]
