idolverse/Tulingjiuge_robot_1/零件组装教程+stl文件/Eyes-i2-main/Eye-i2教程.pdf

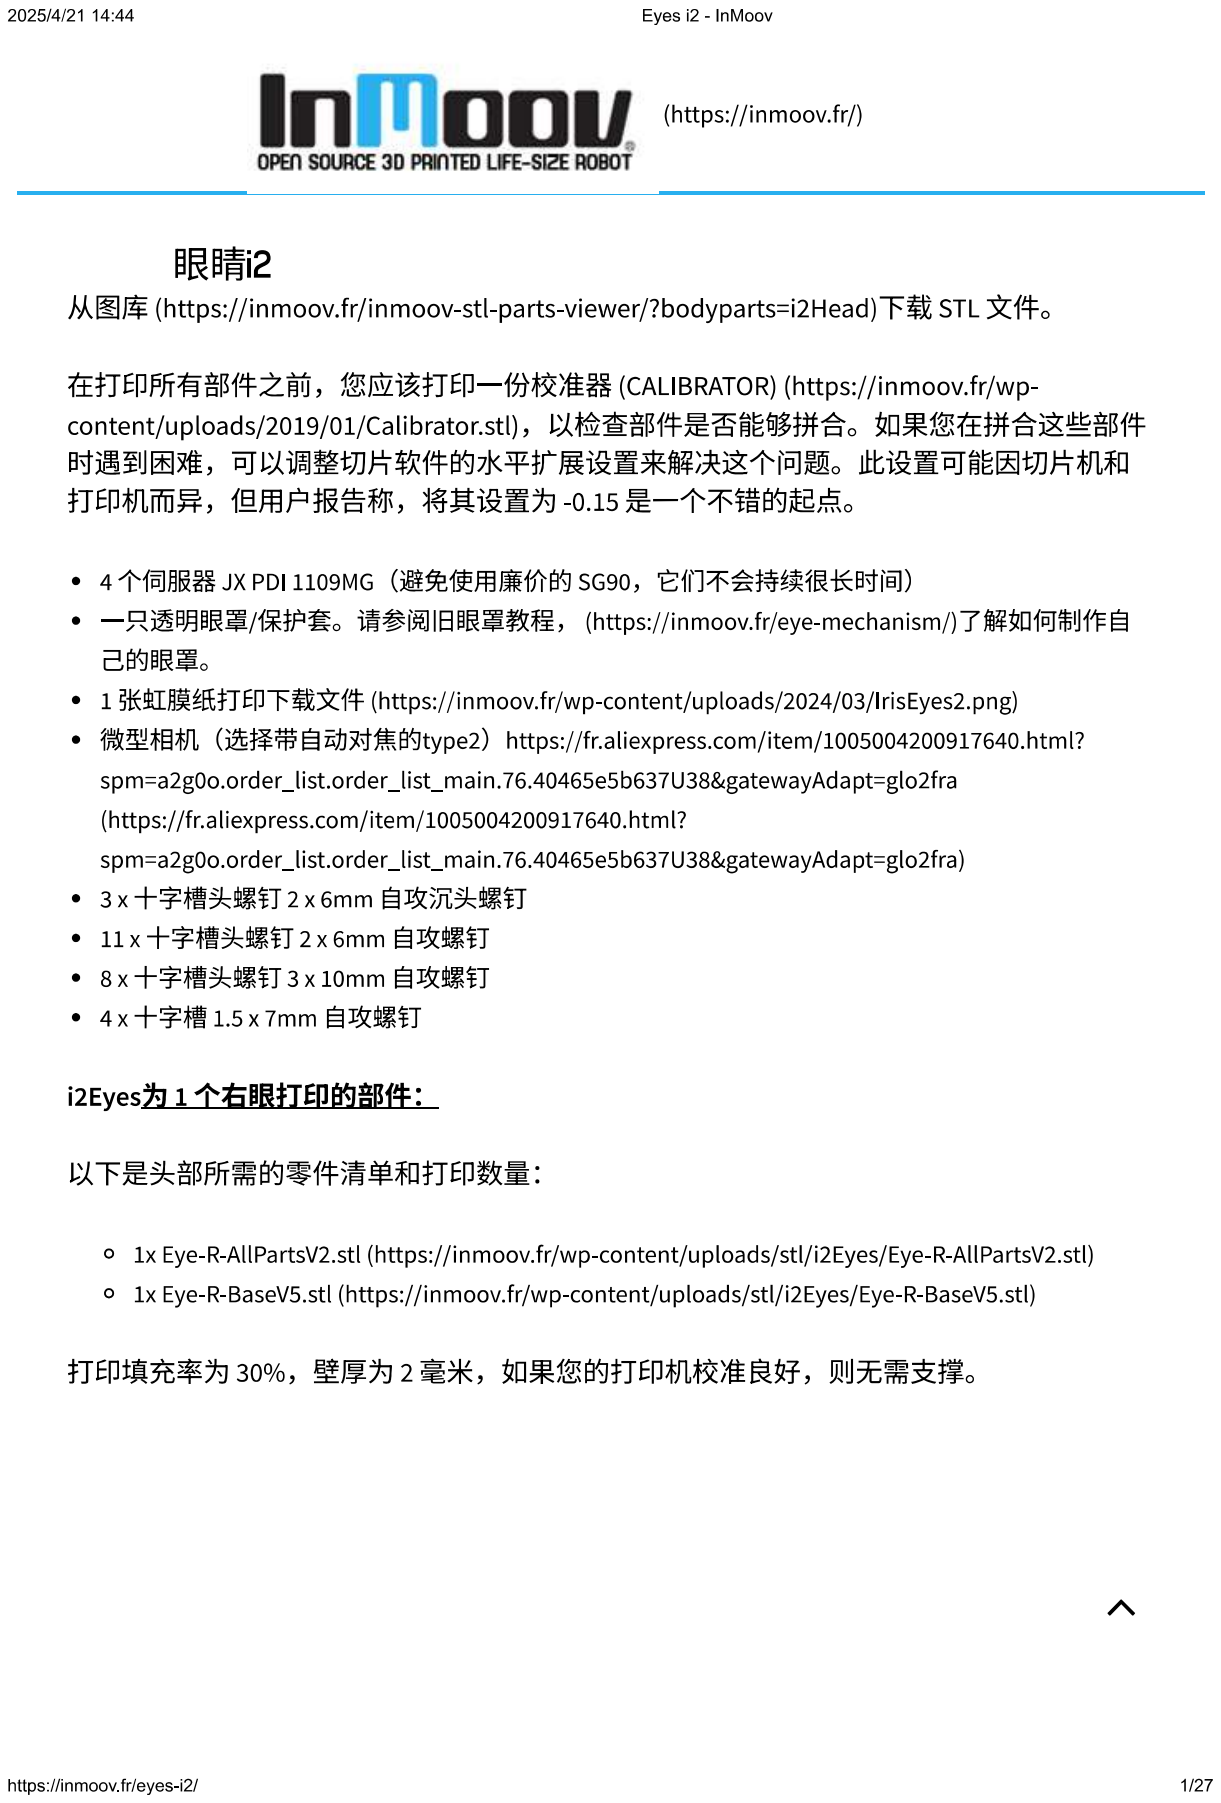
[picture p311: page 1]
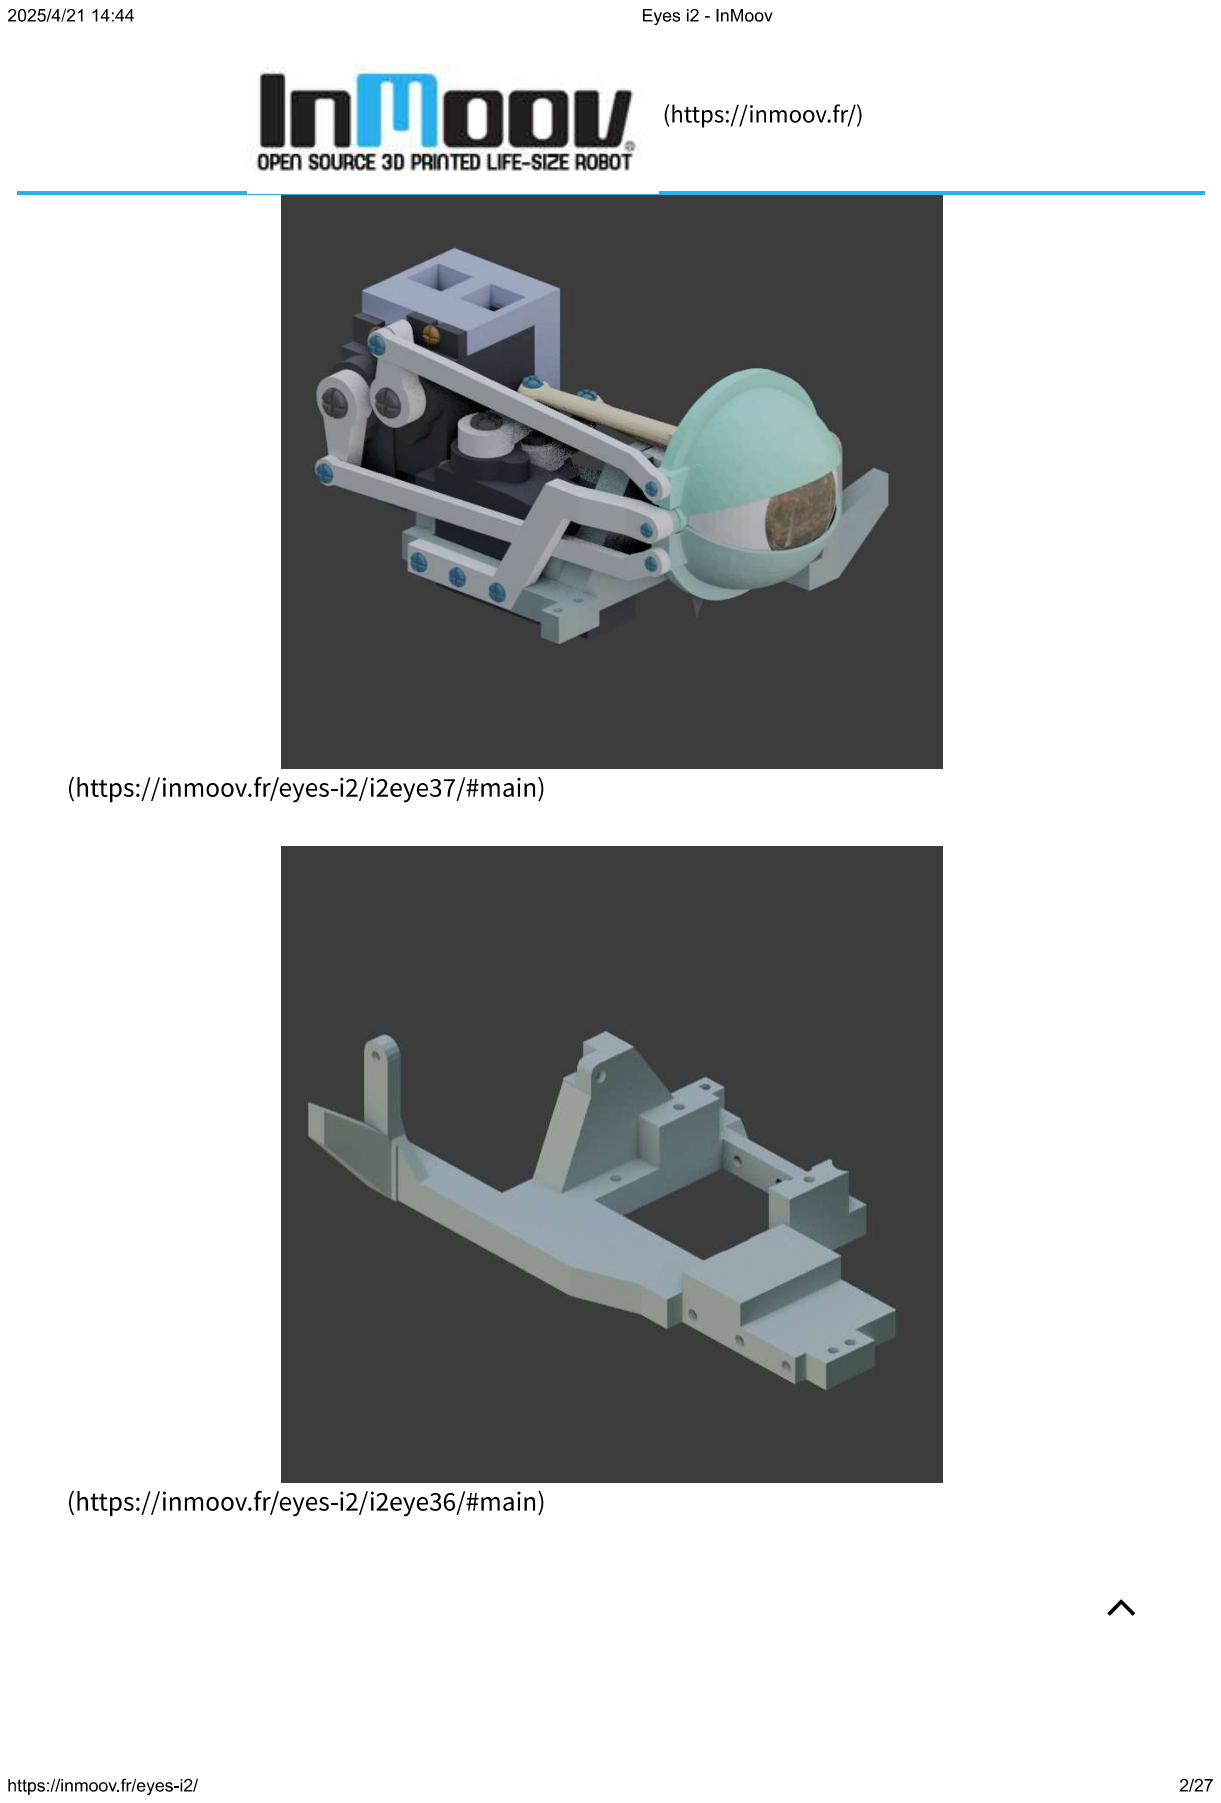
[picture p312: page 2]
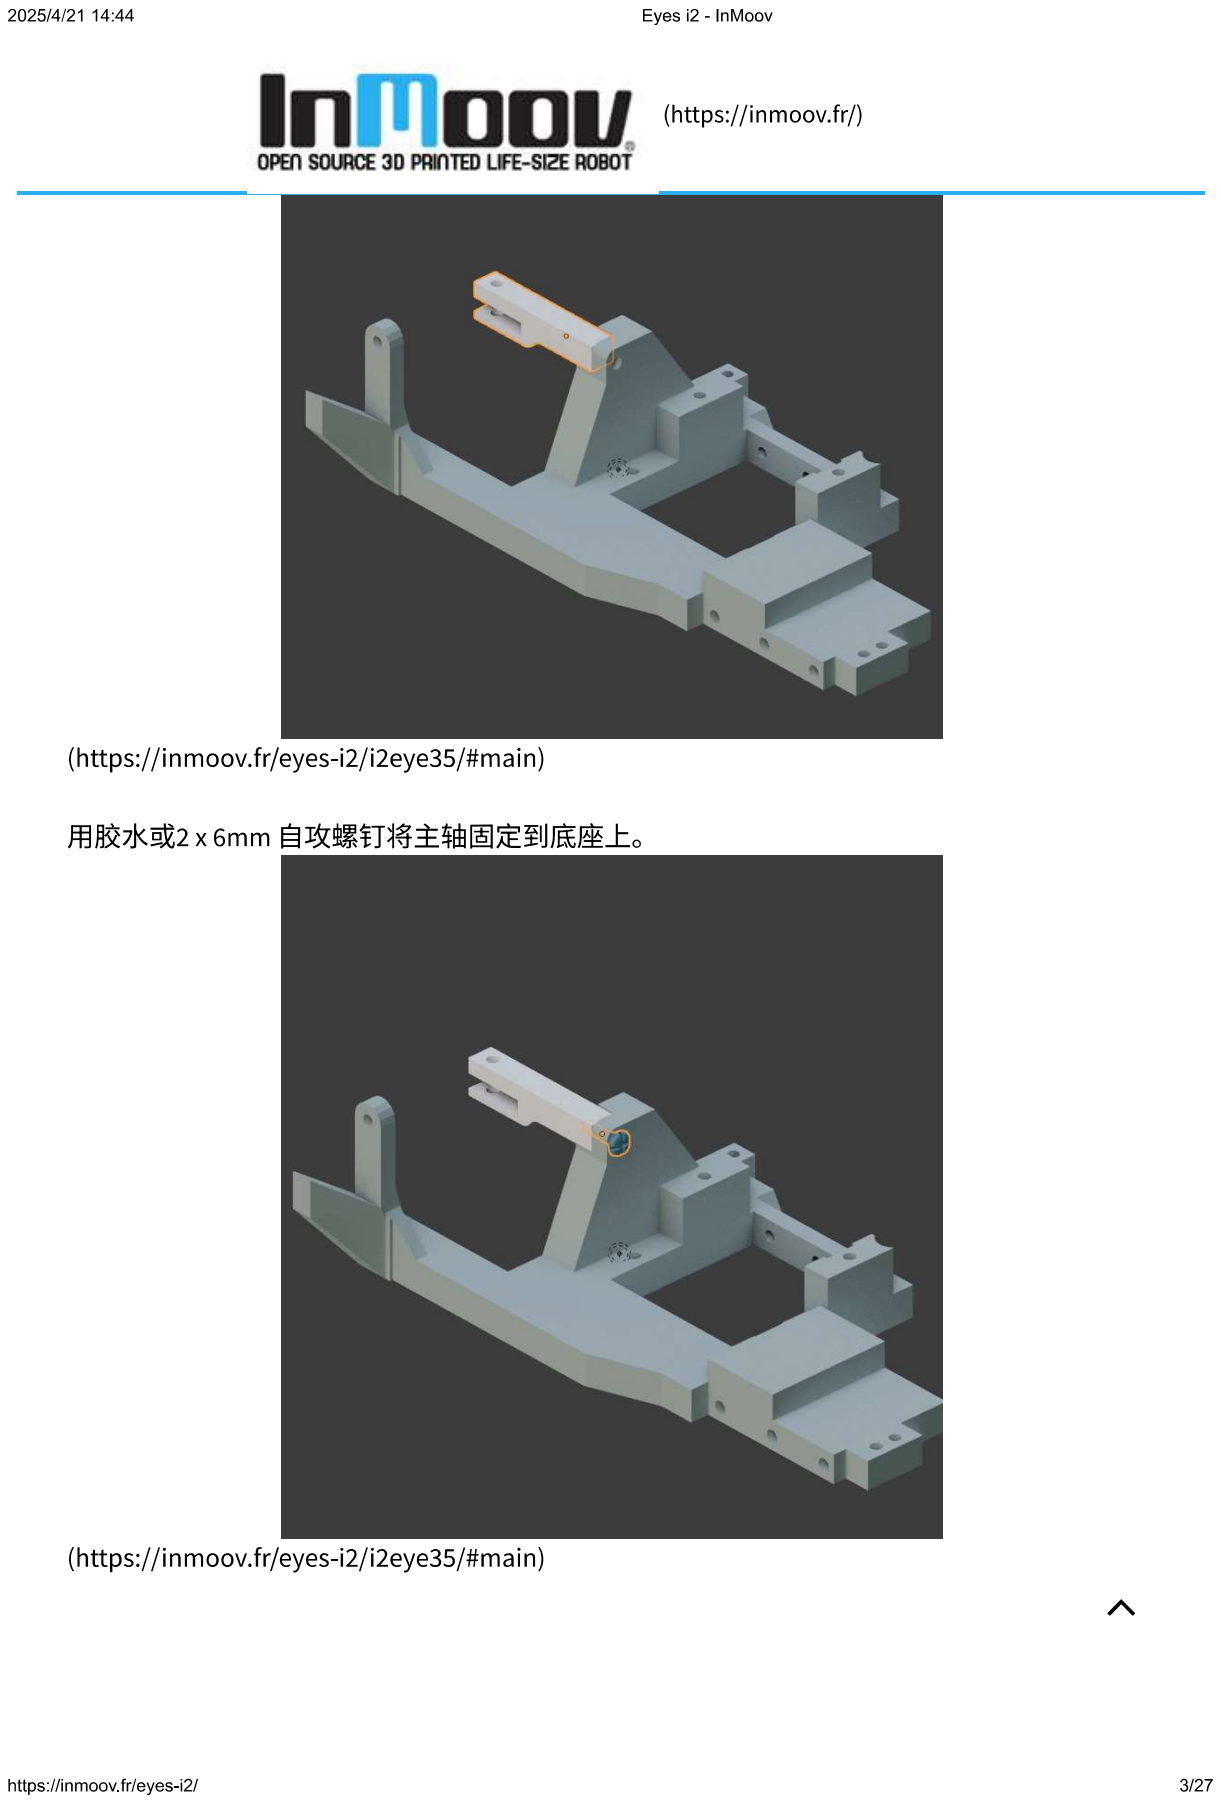
[picture p313: page 3]
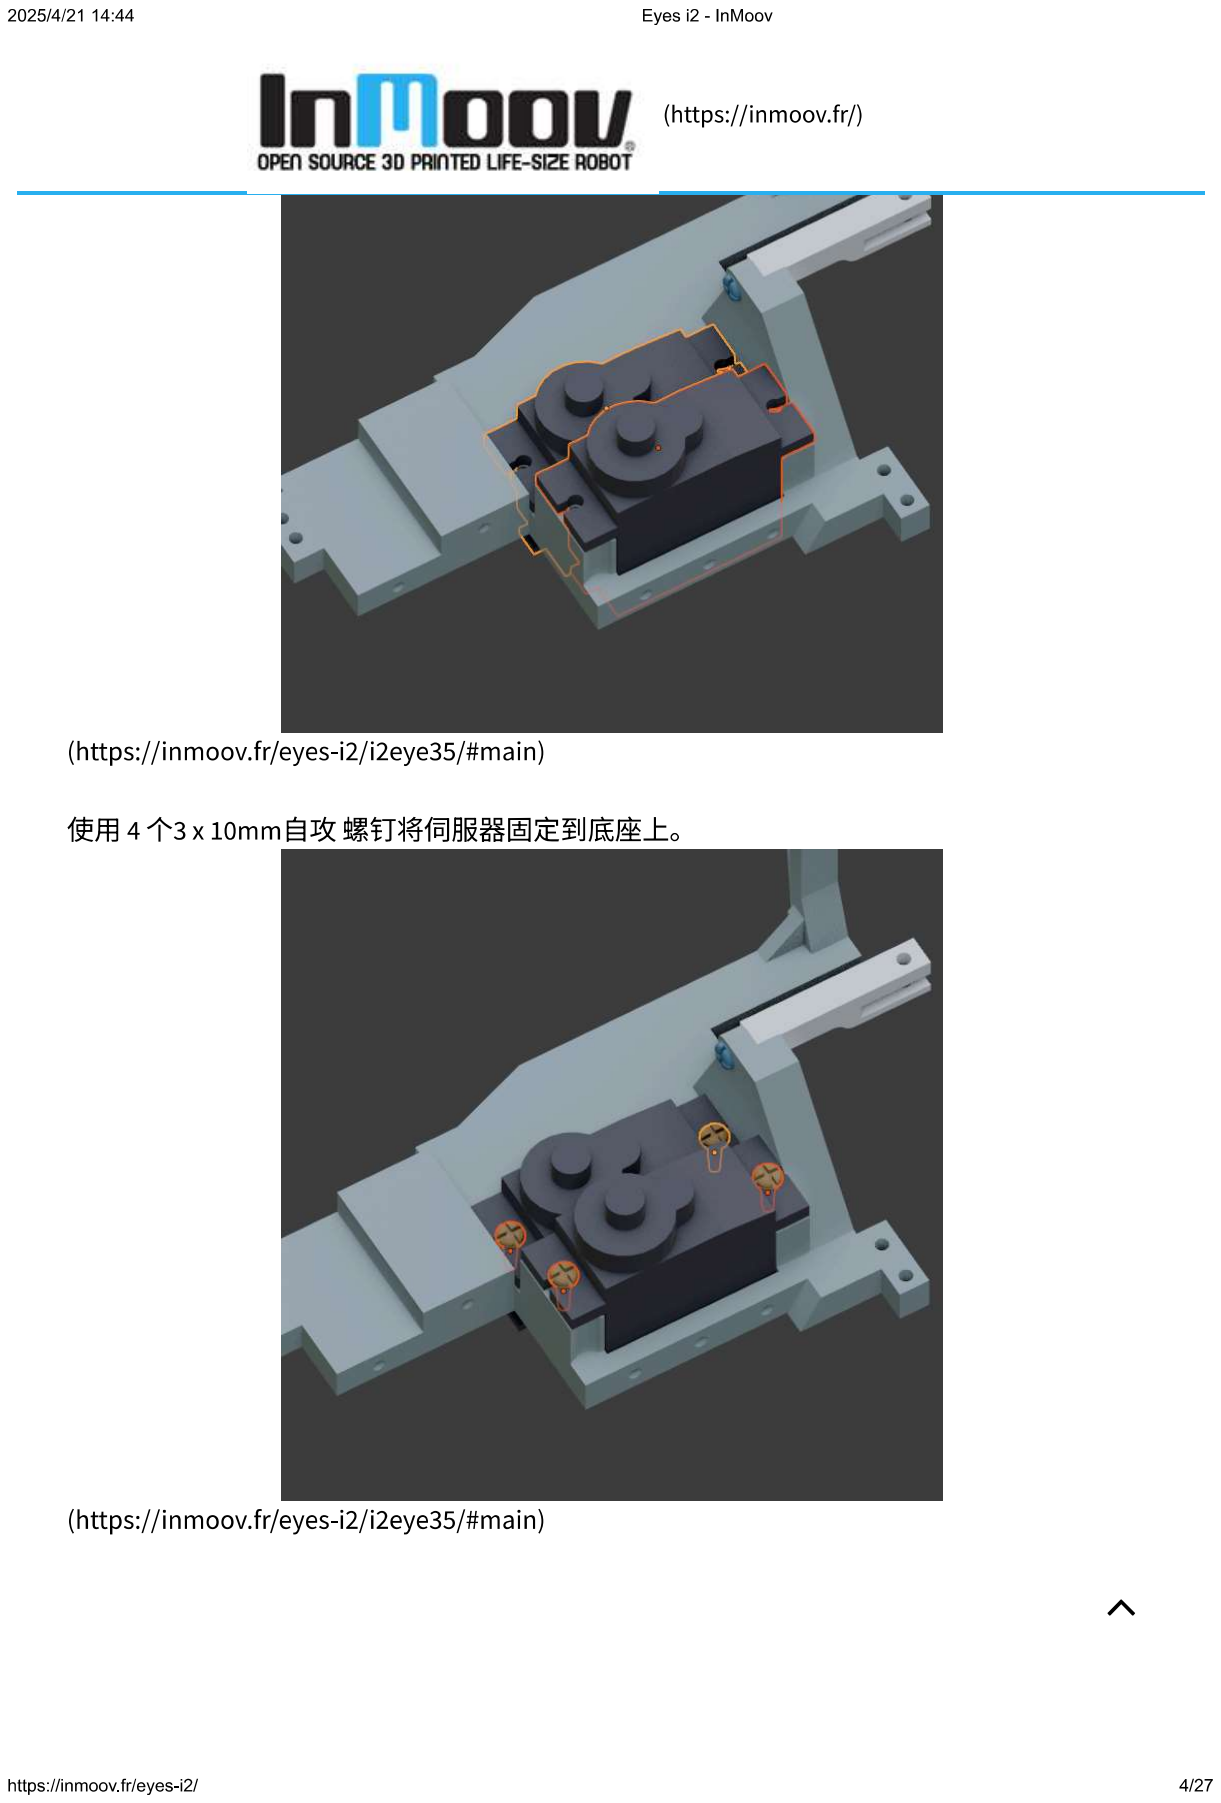
[picture p314: page 4]
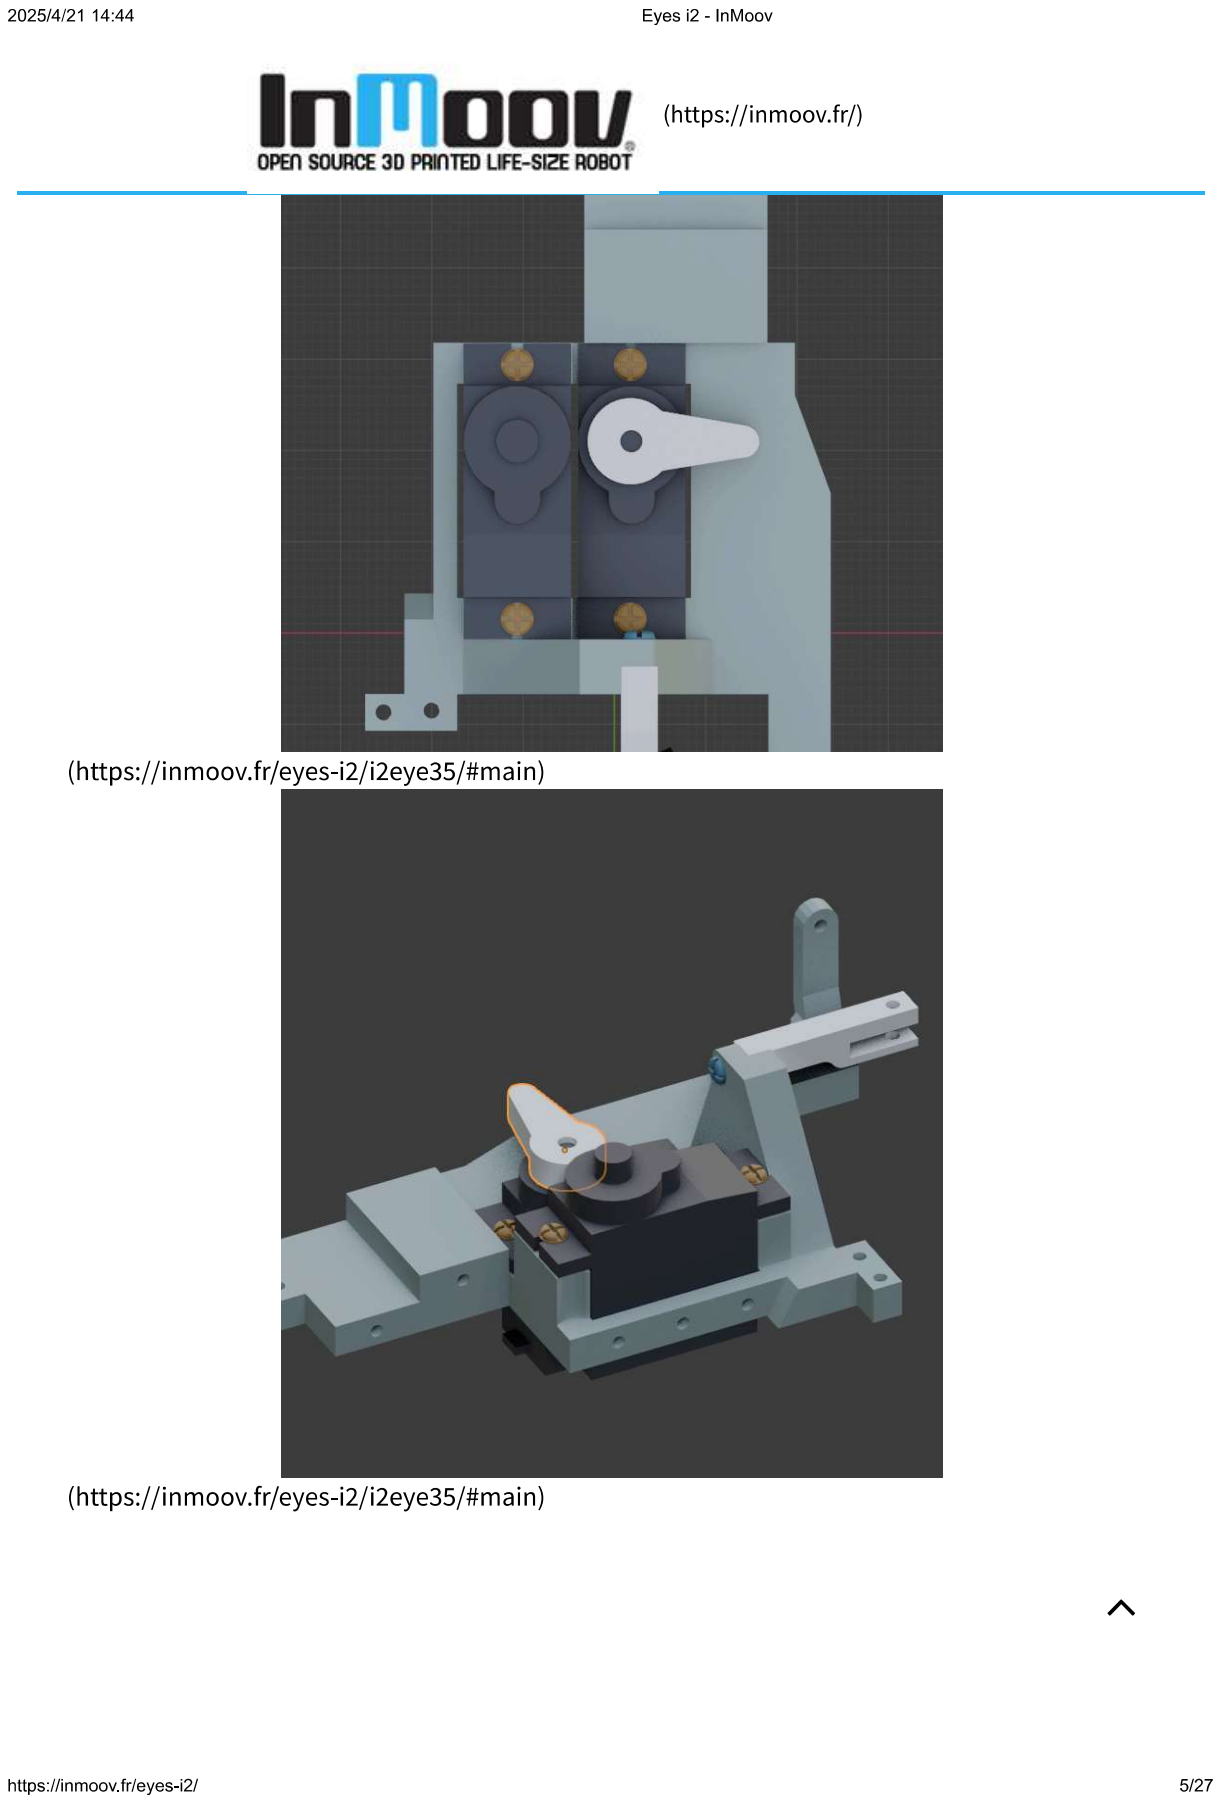
[picture p315: page 5]
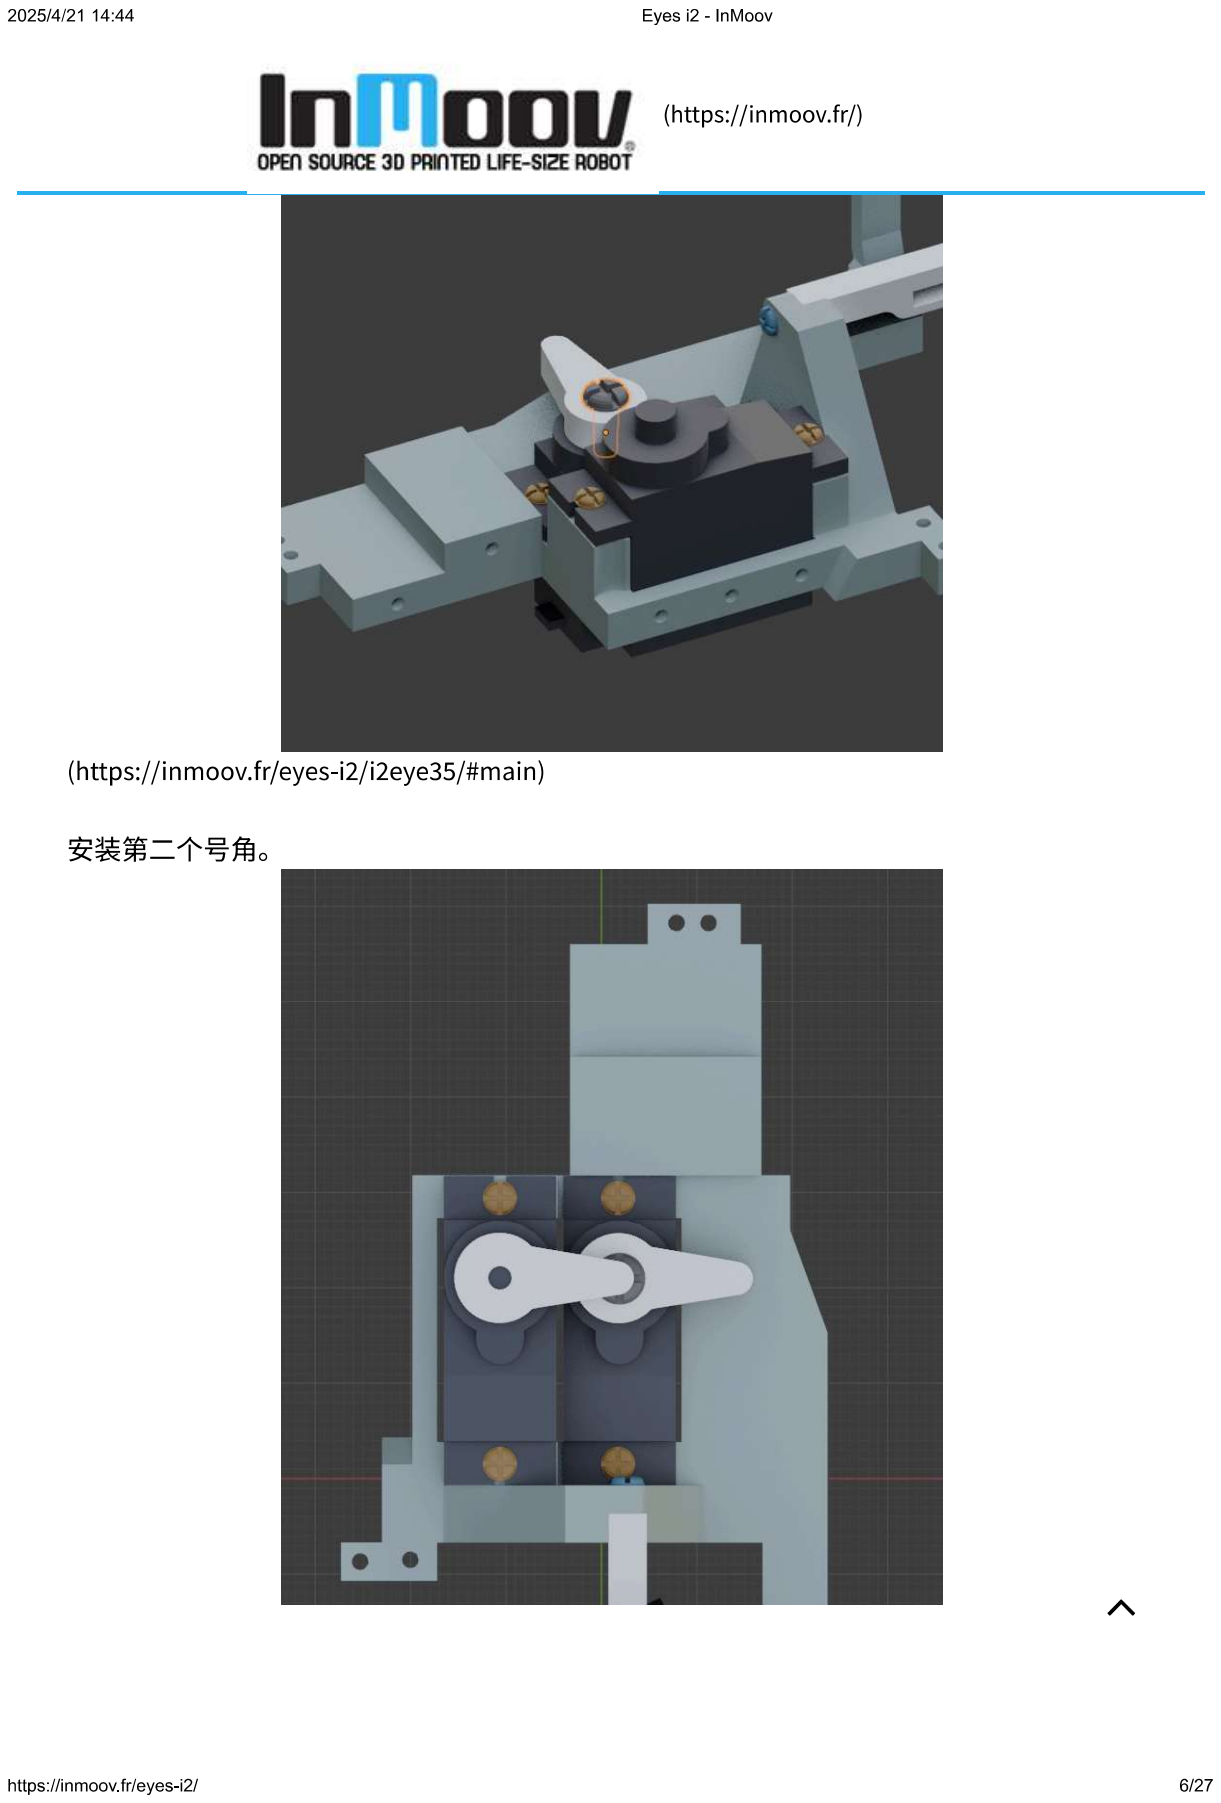
[picture p316: page 6]
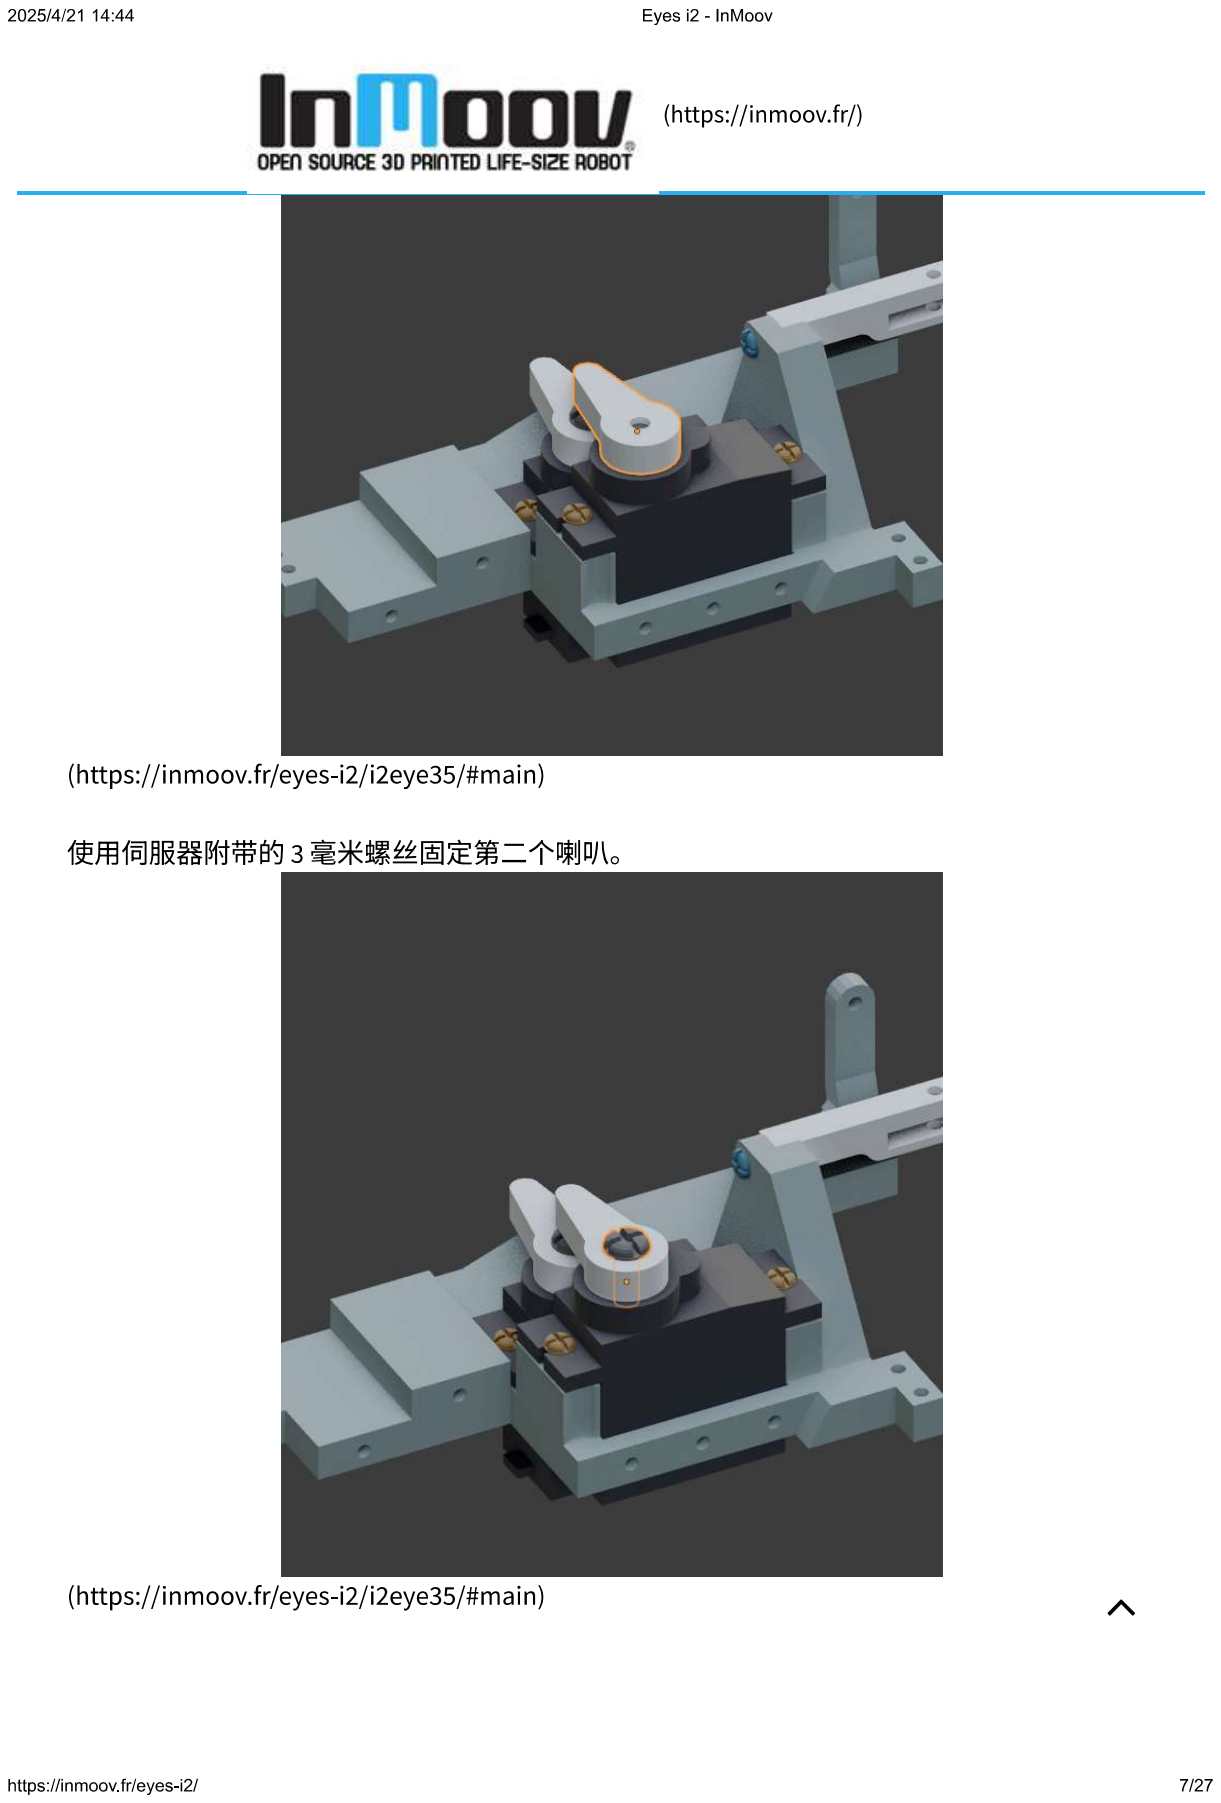
[picture p317: page 7]
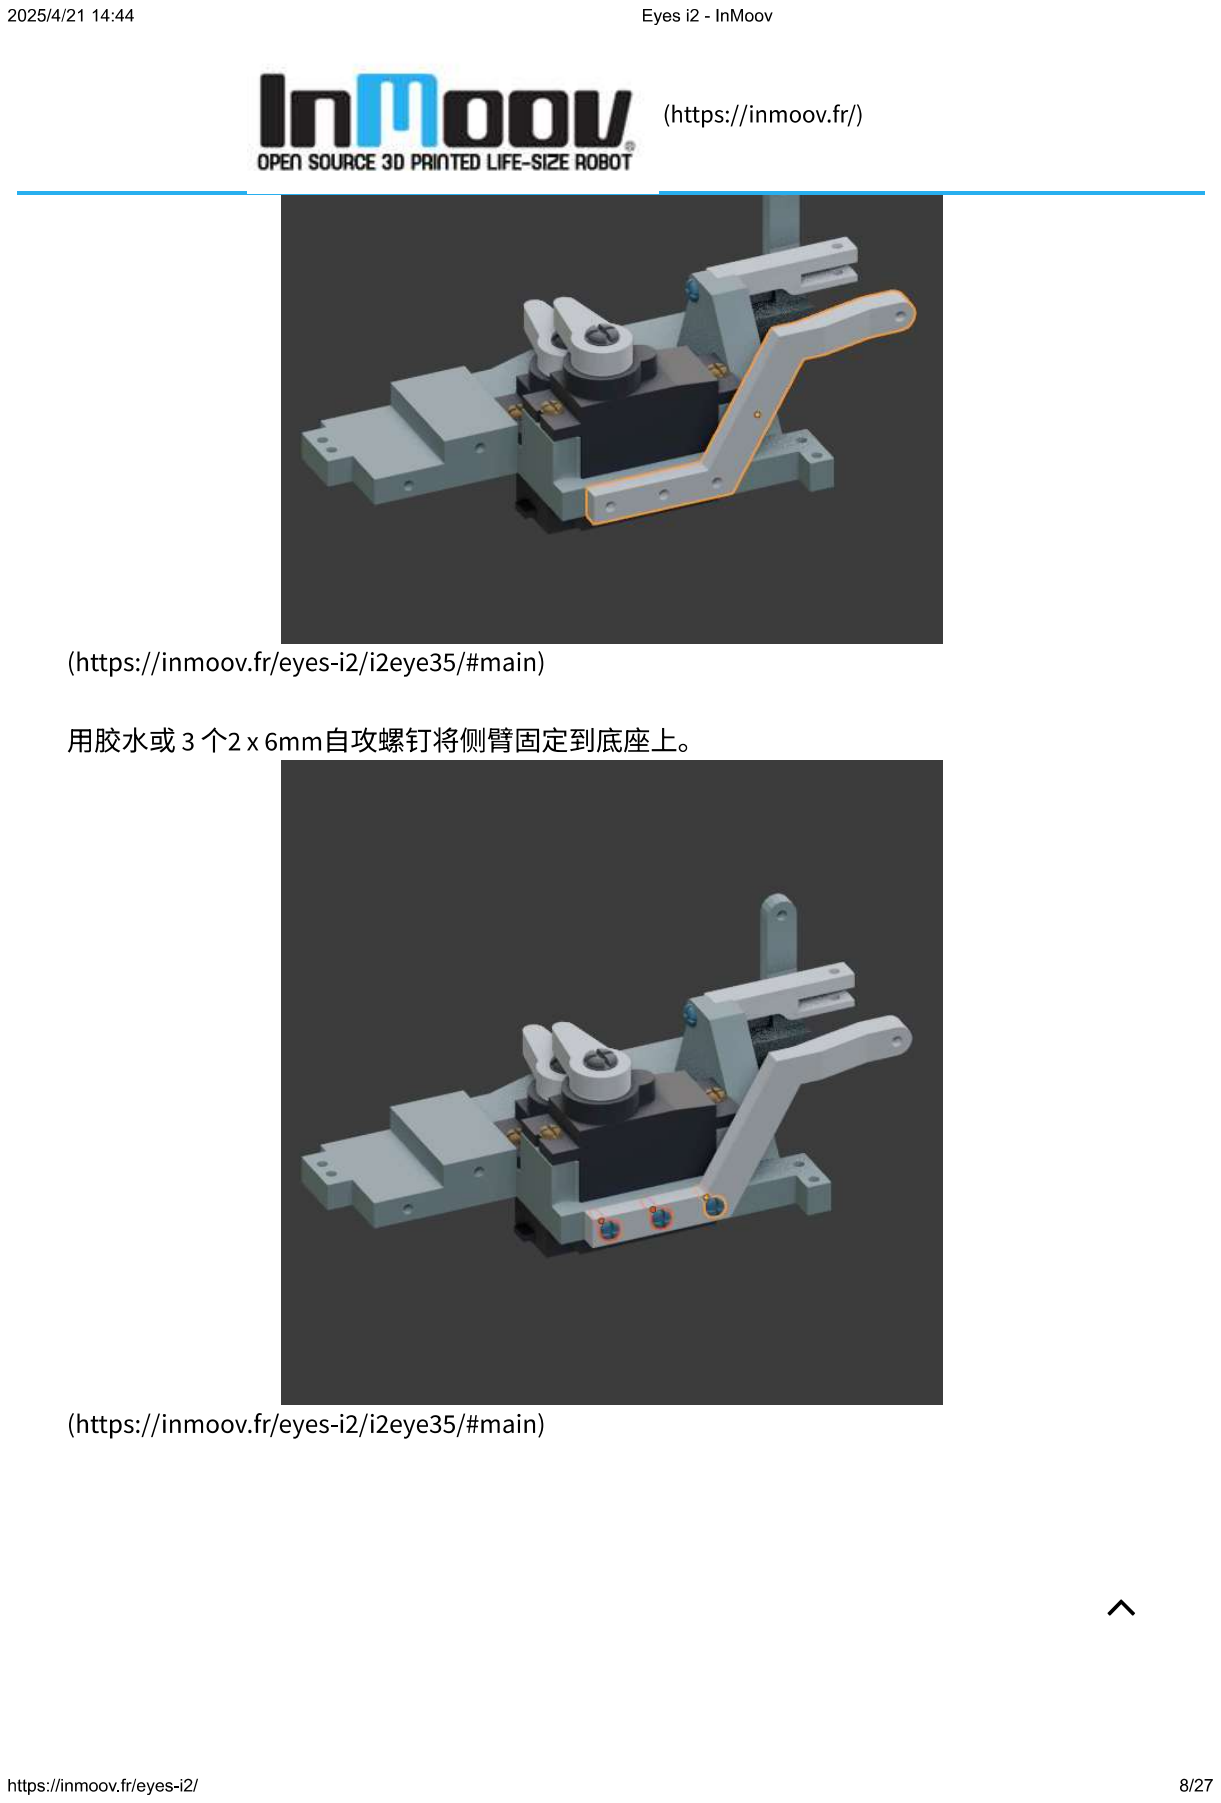
[picture p318: page 8]
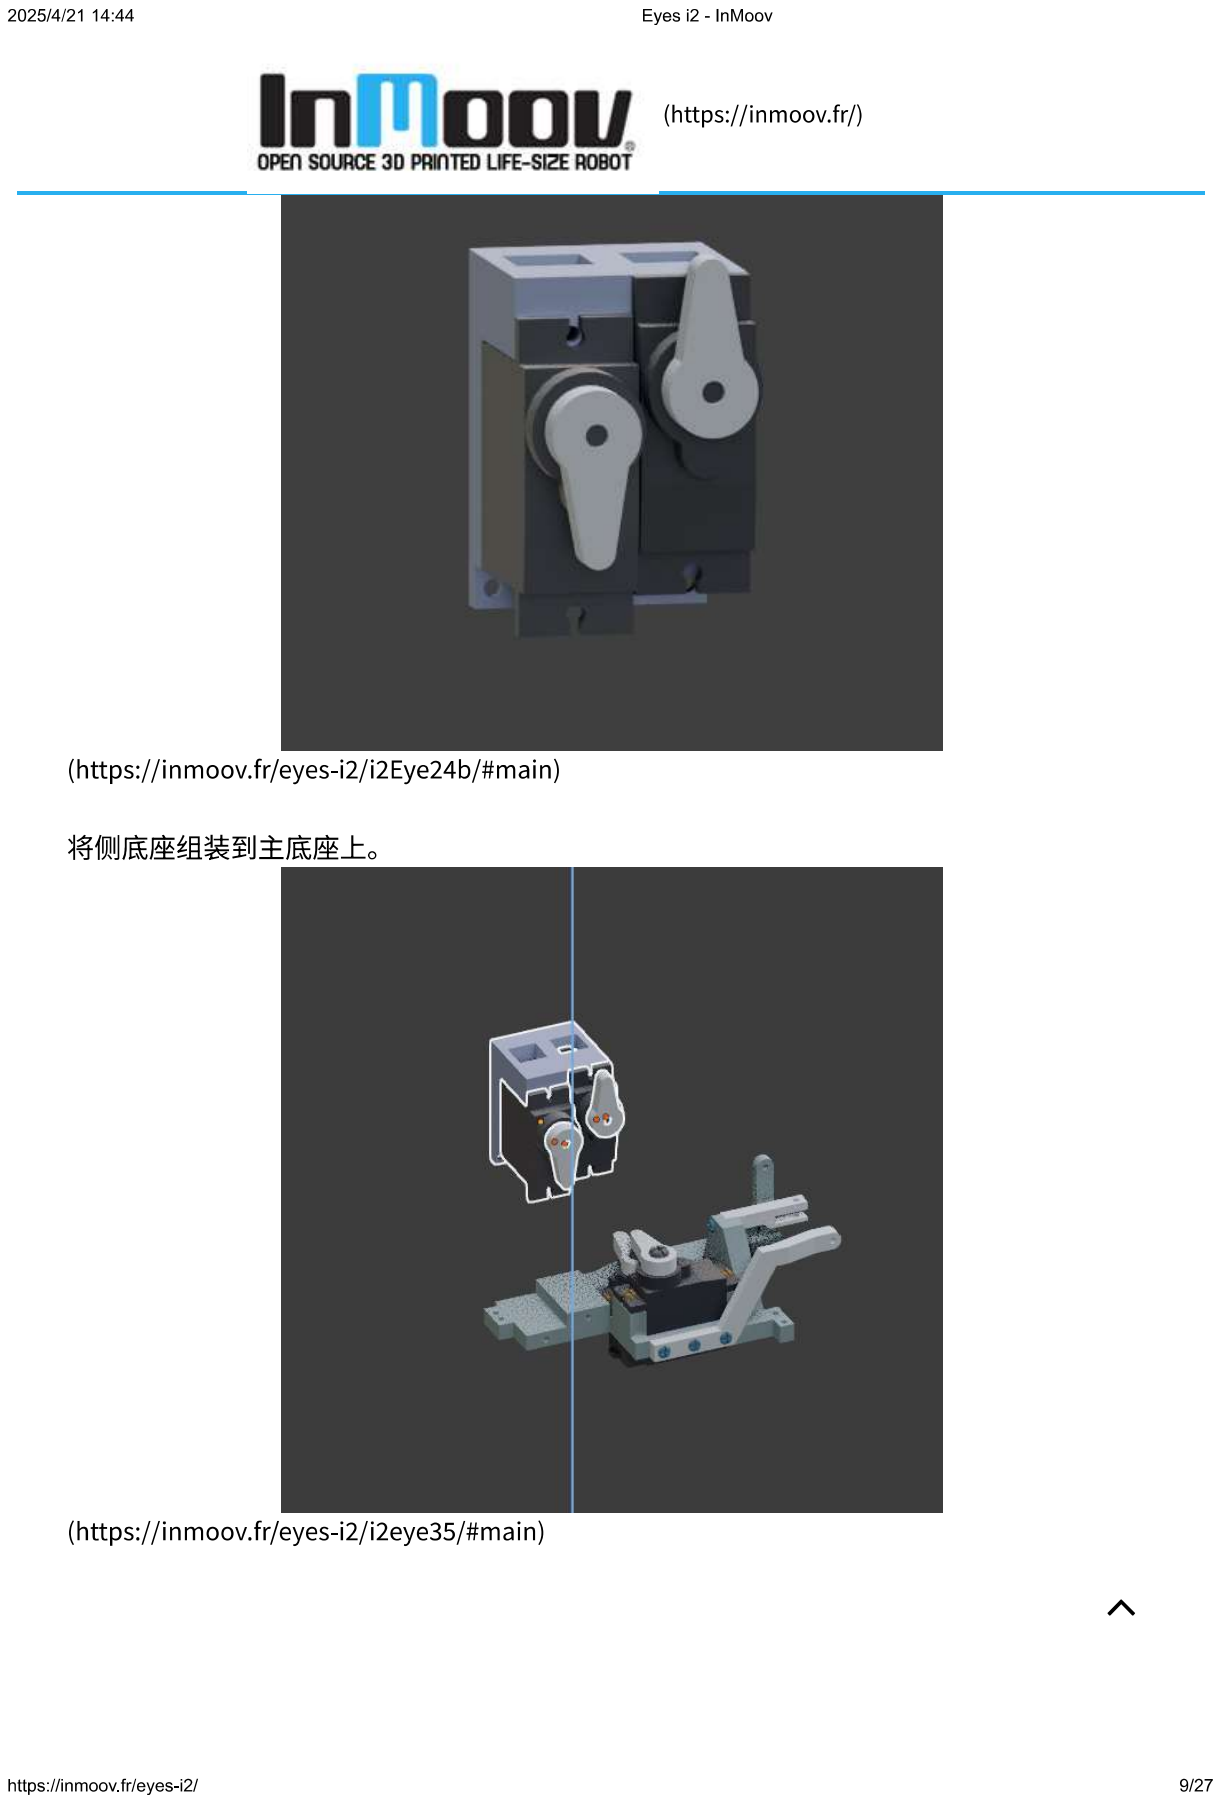
[picture p319: page 9]
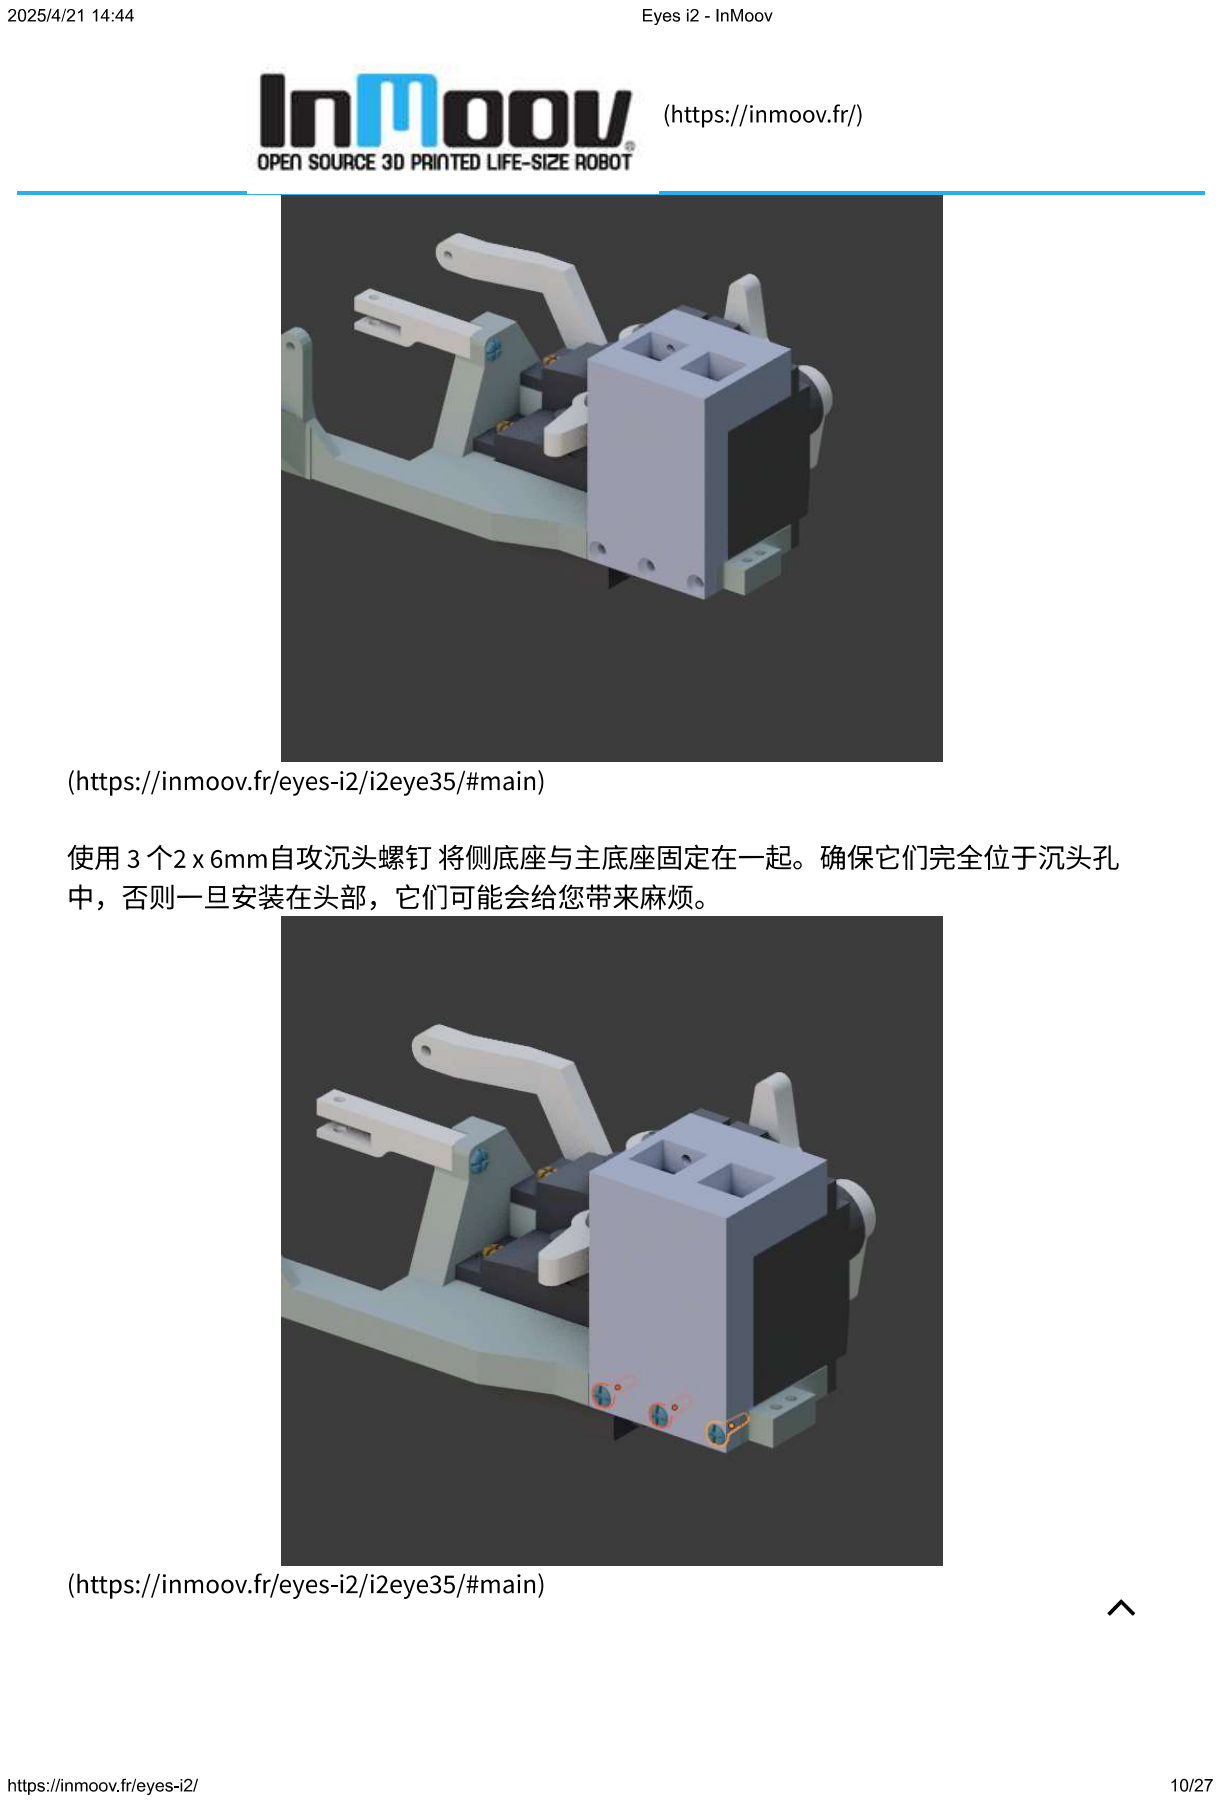
[picture p320: page 10]
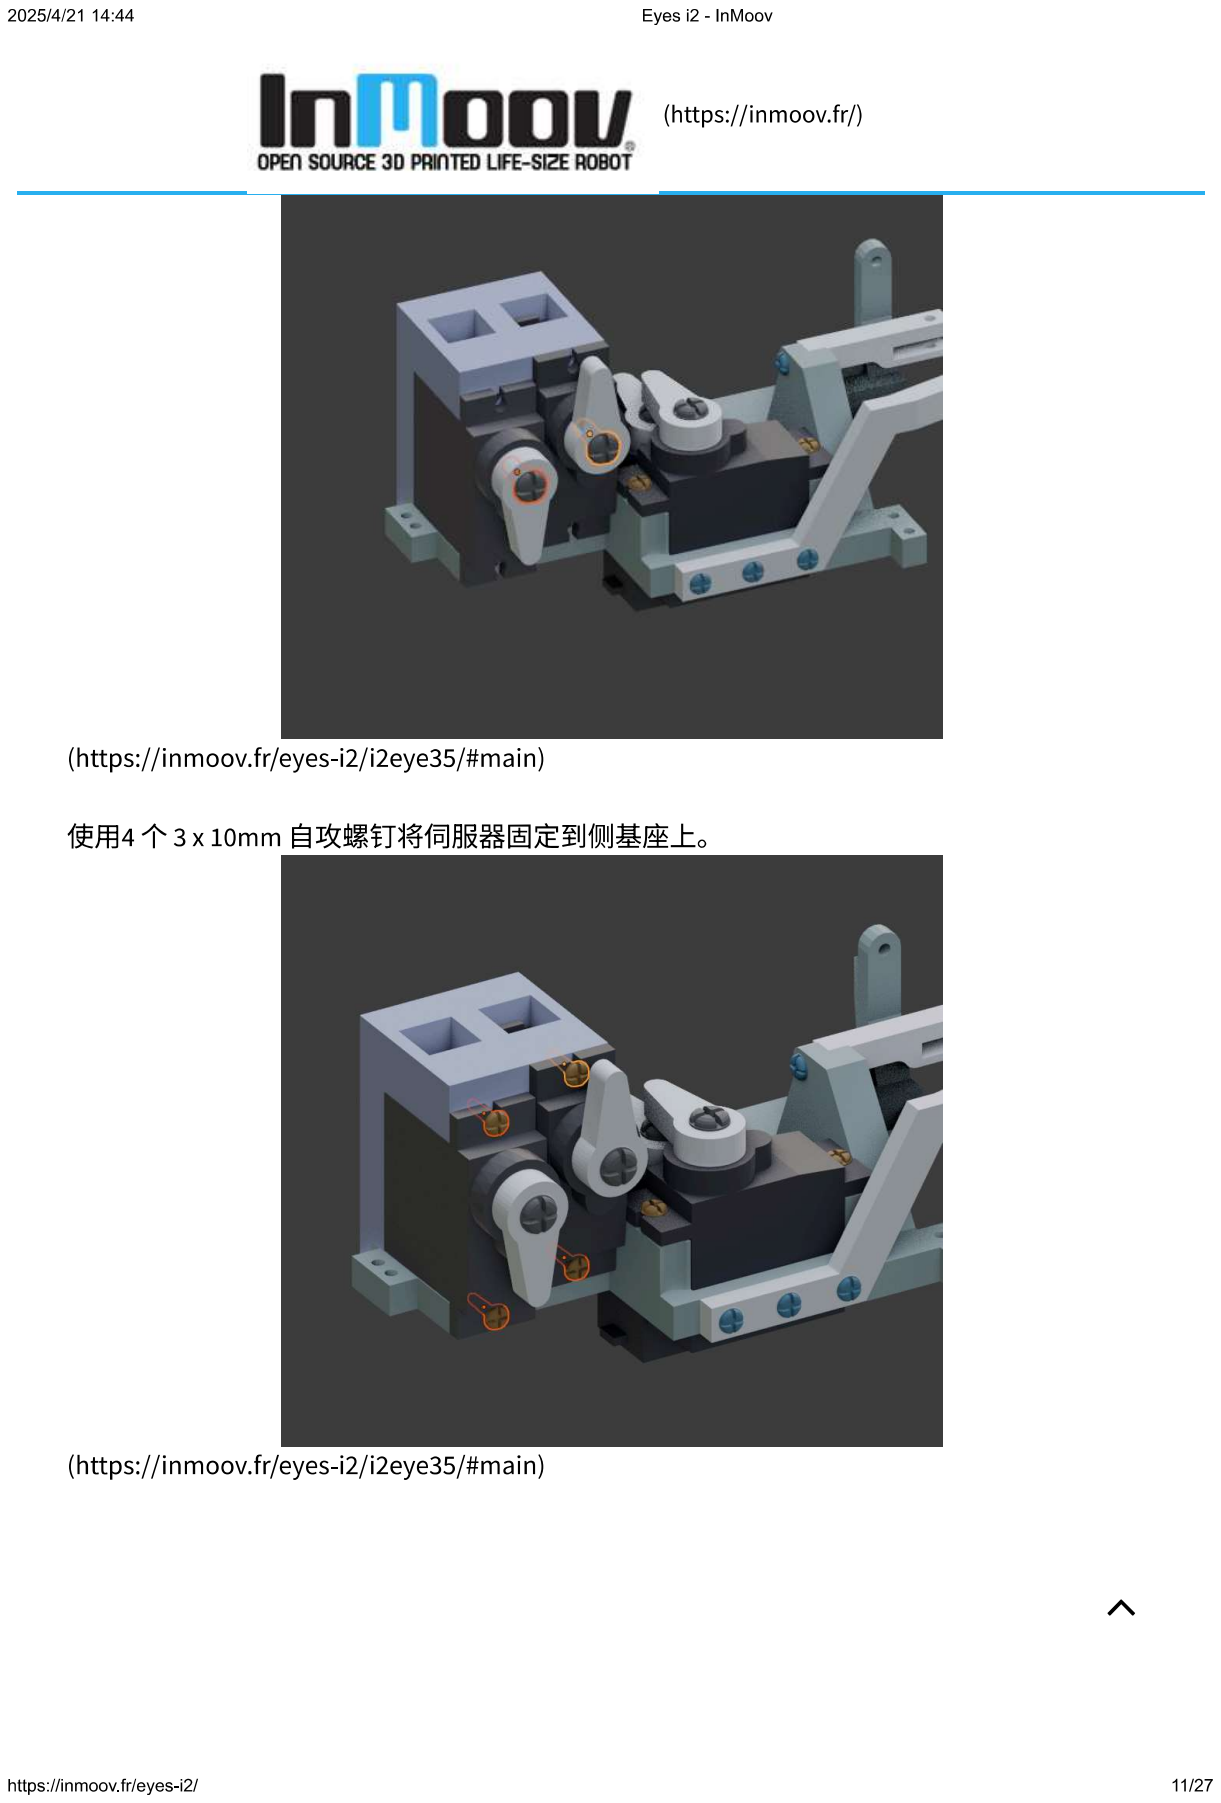
[picture p321: page 11]
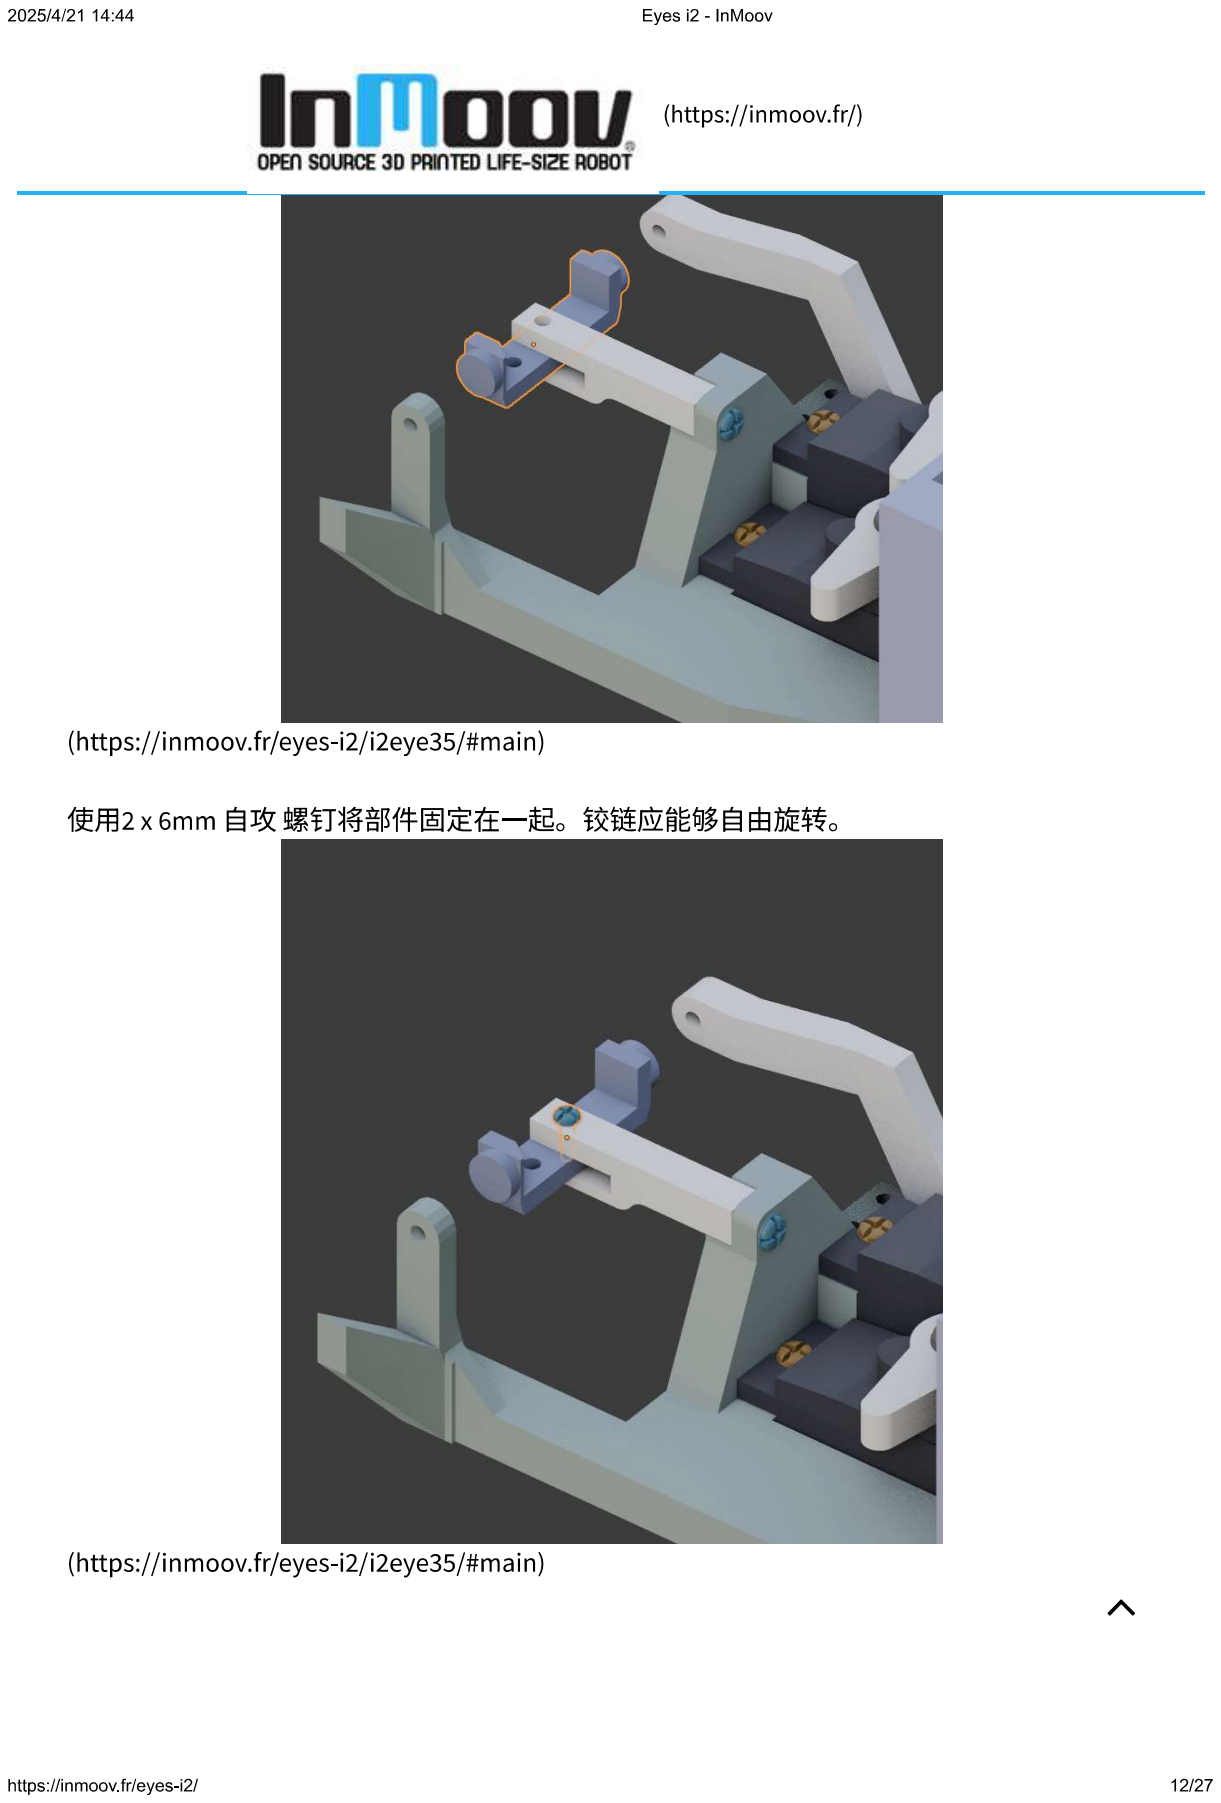
[picture p322: page 12]
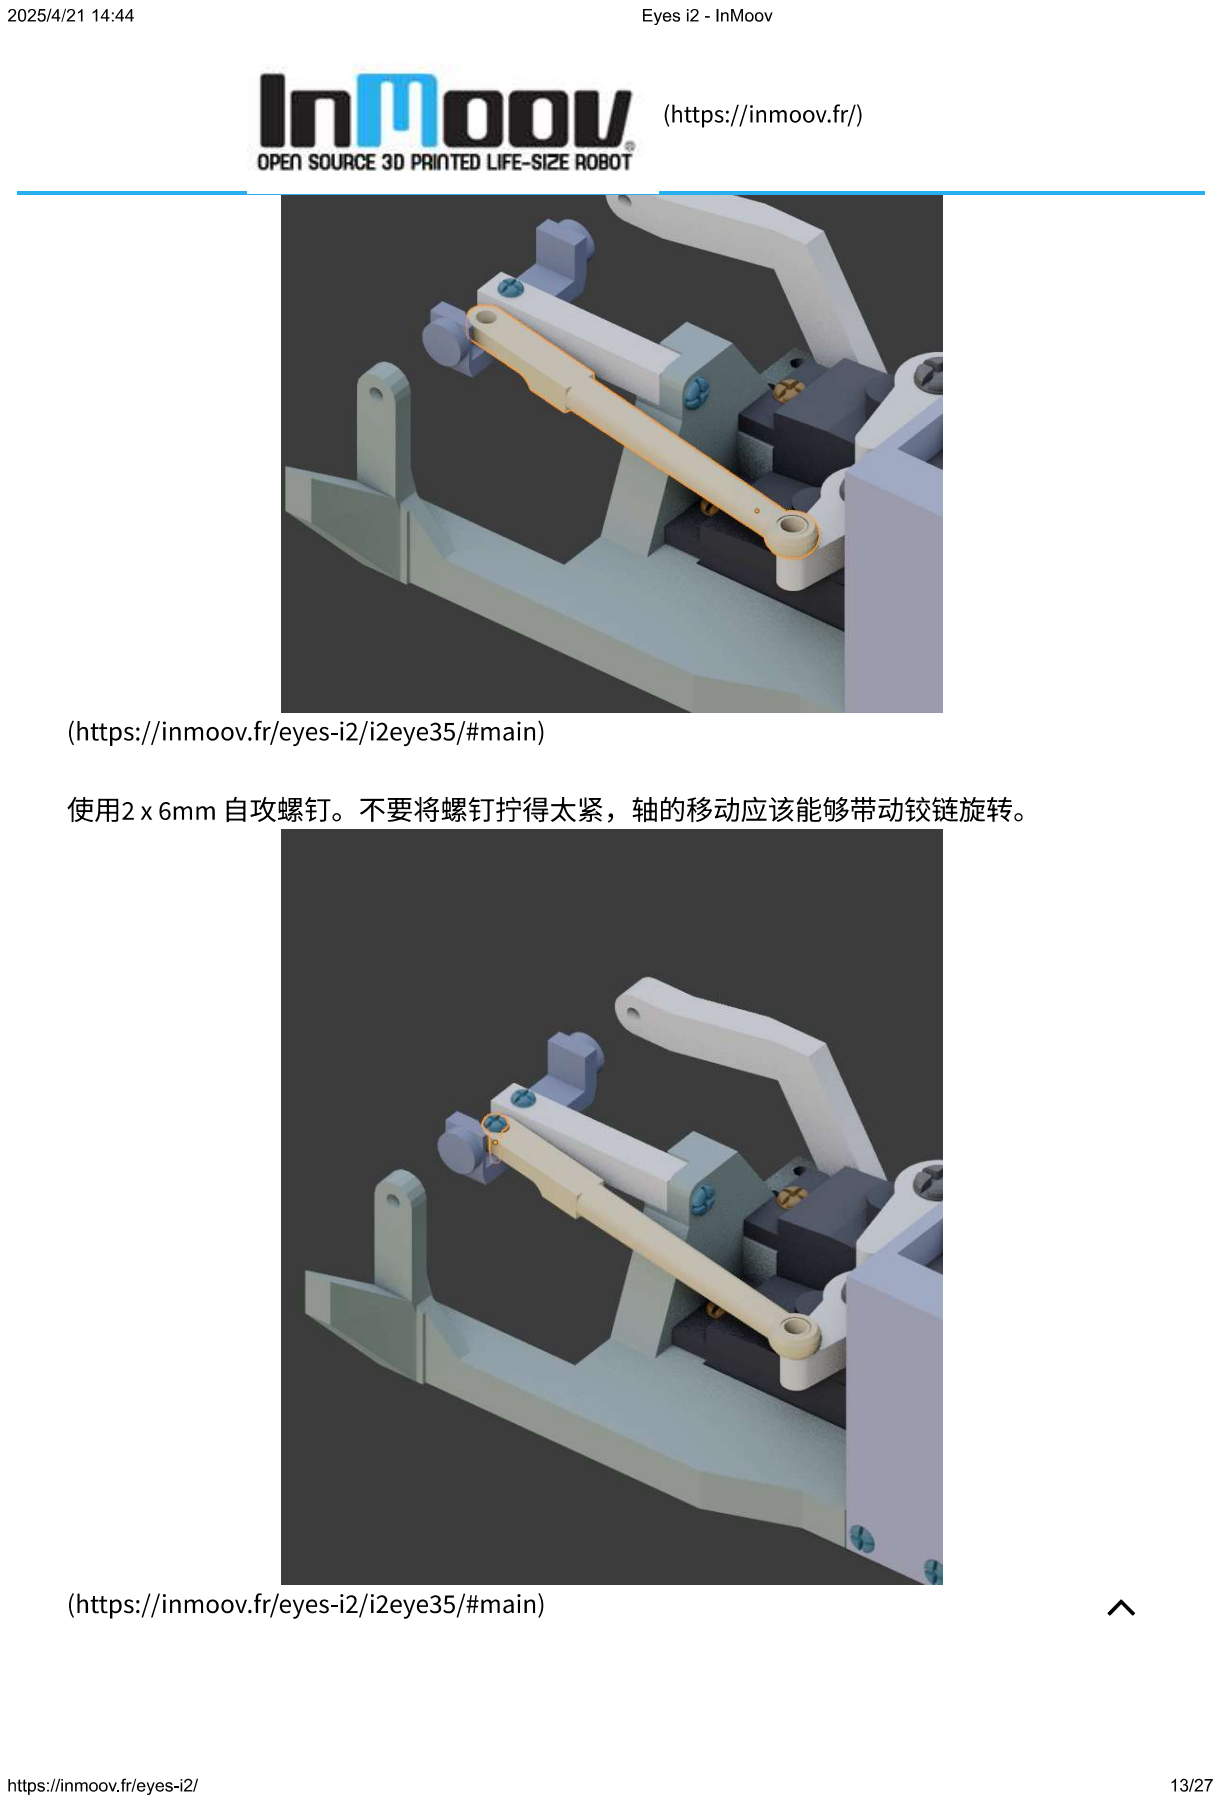
[picture p323: page 13]
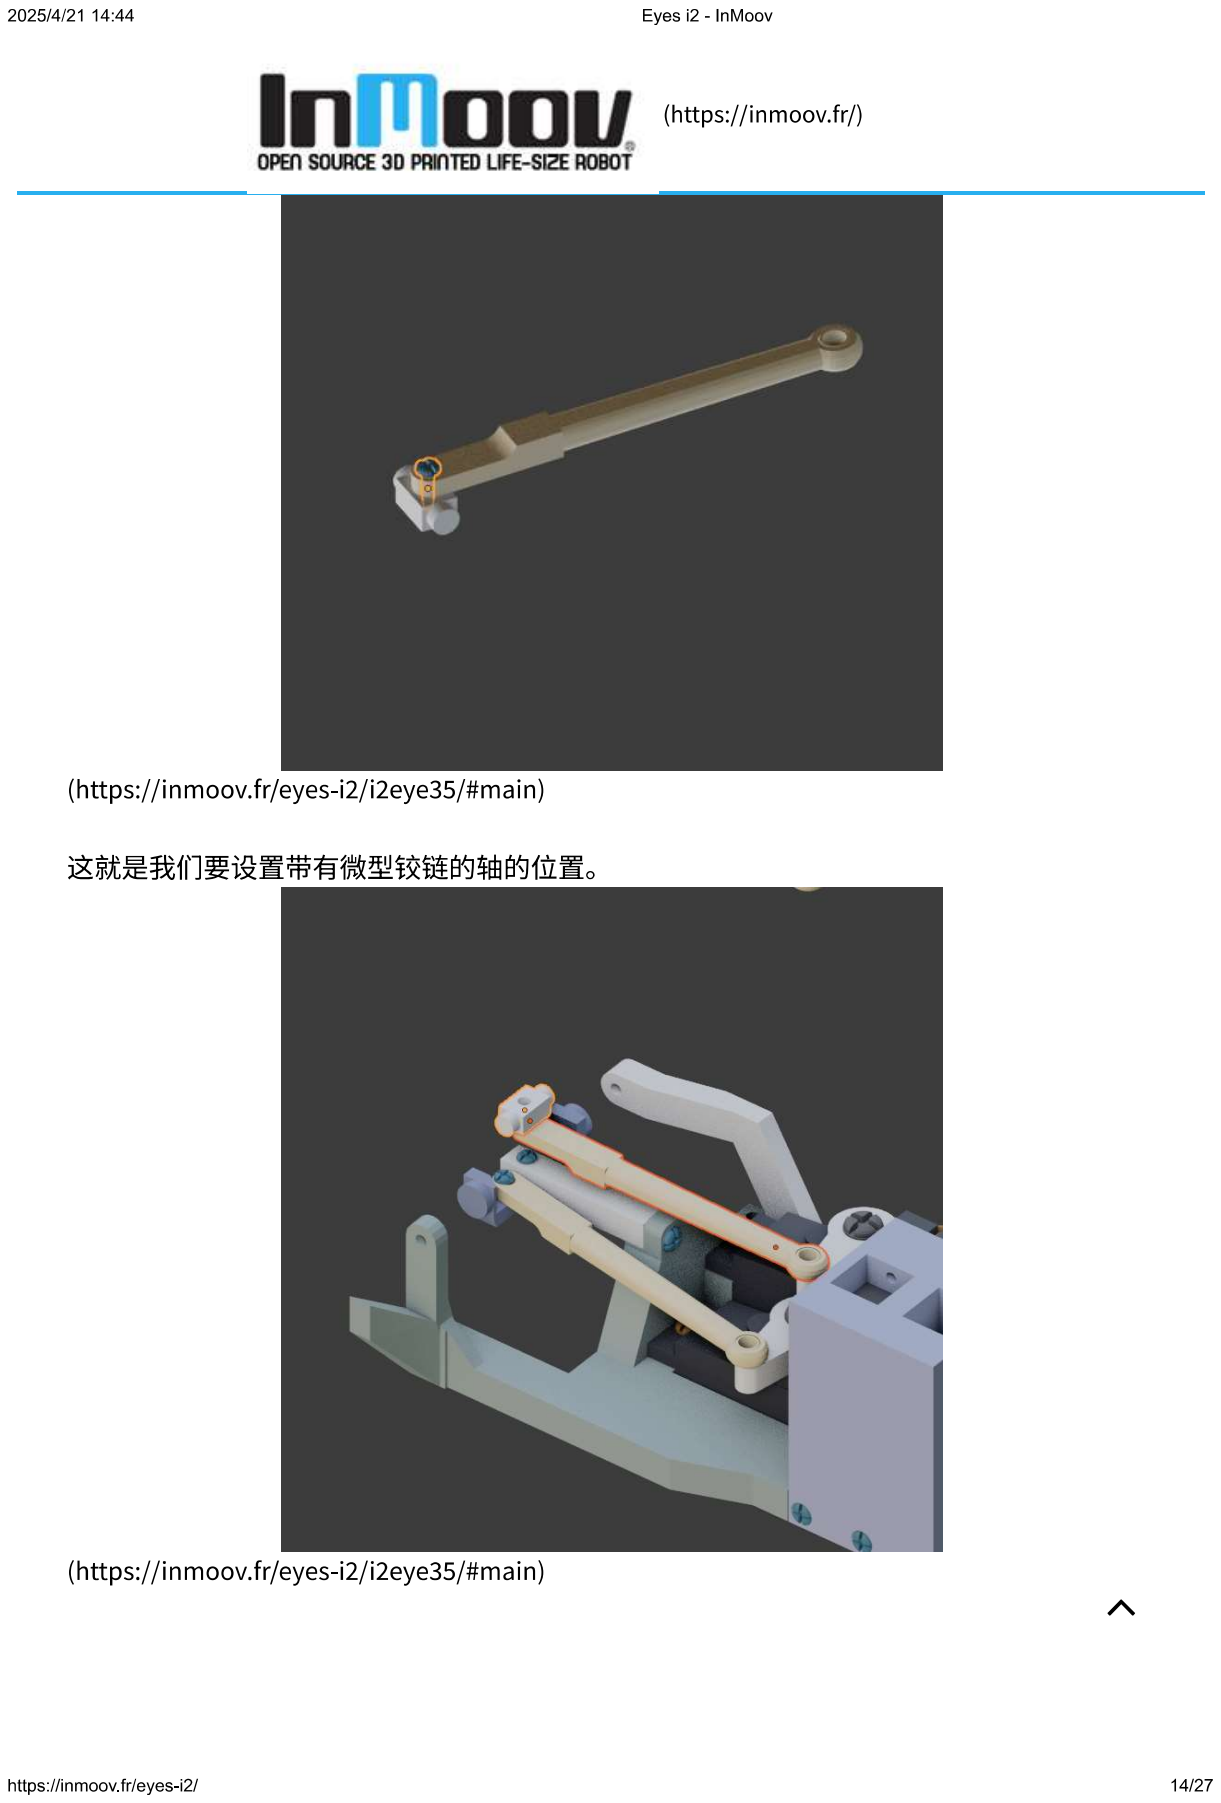
[picture p324: page 14]
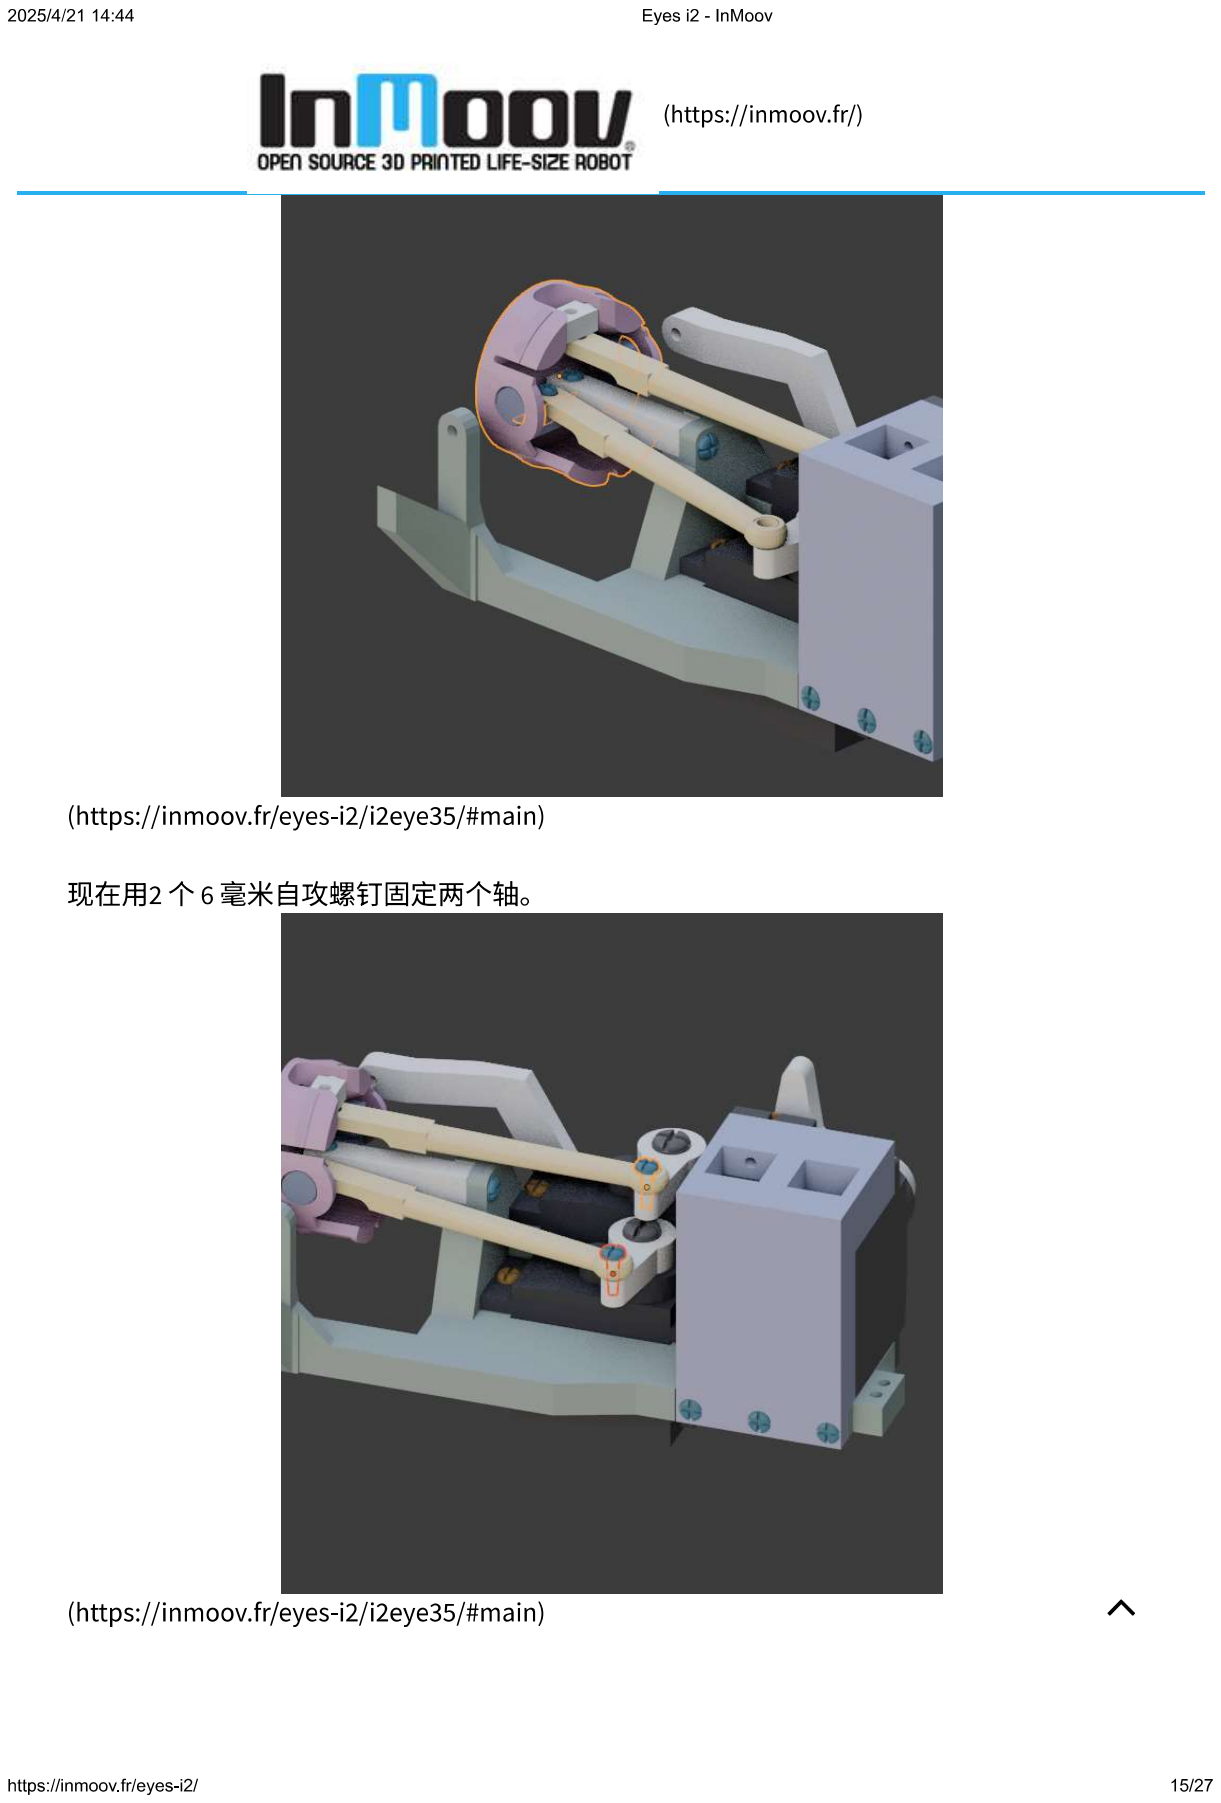
[picture p325: page 15]
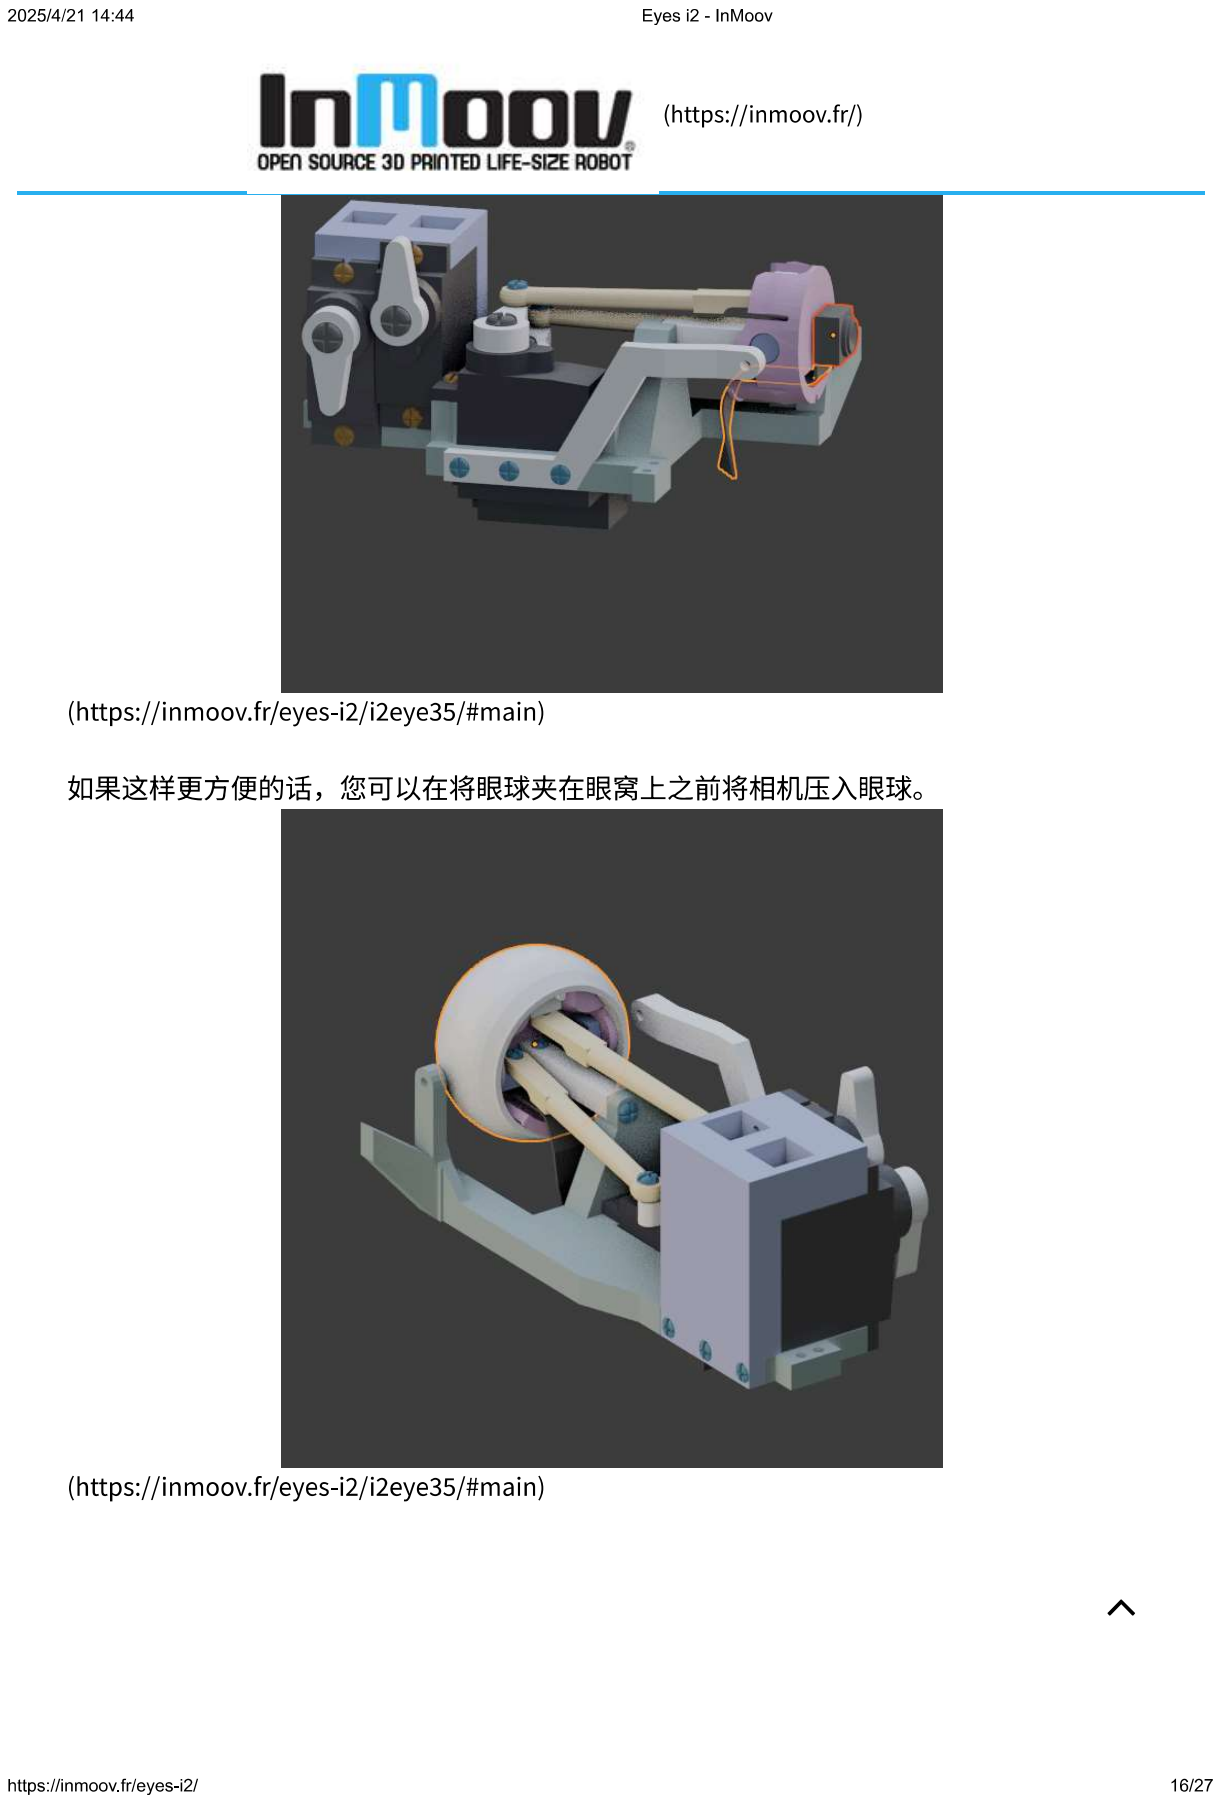
[picture p326: page 16]
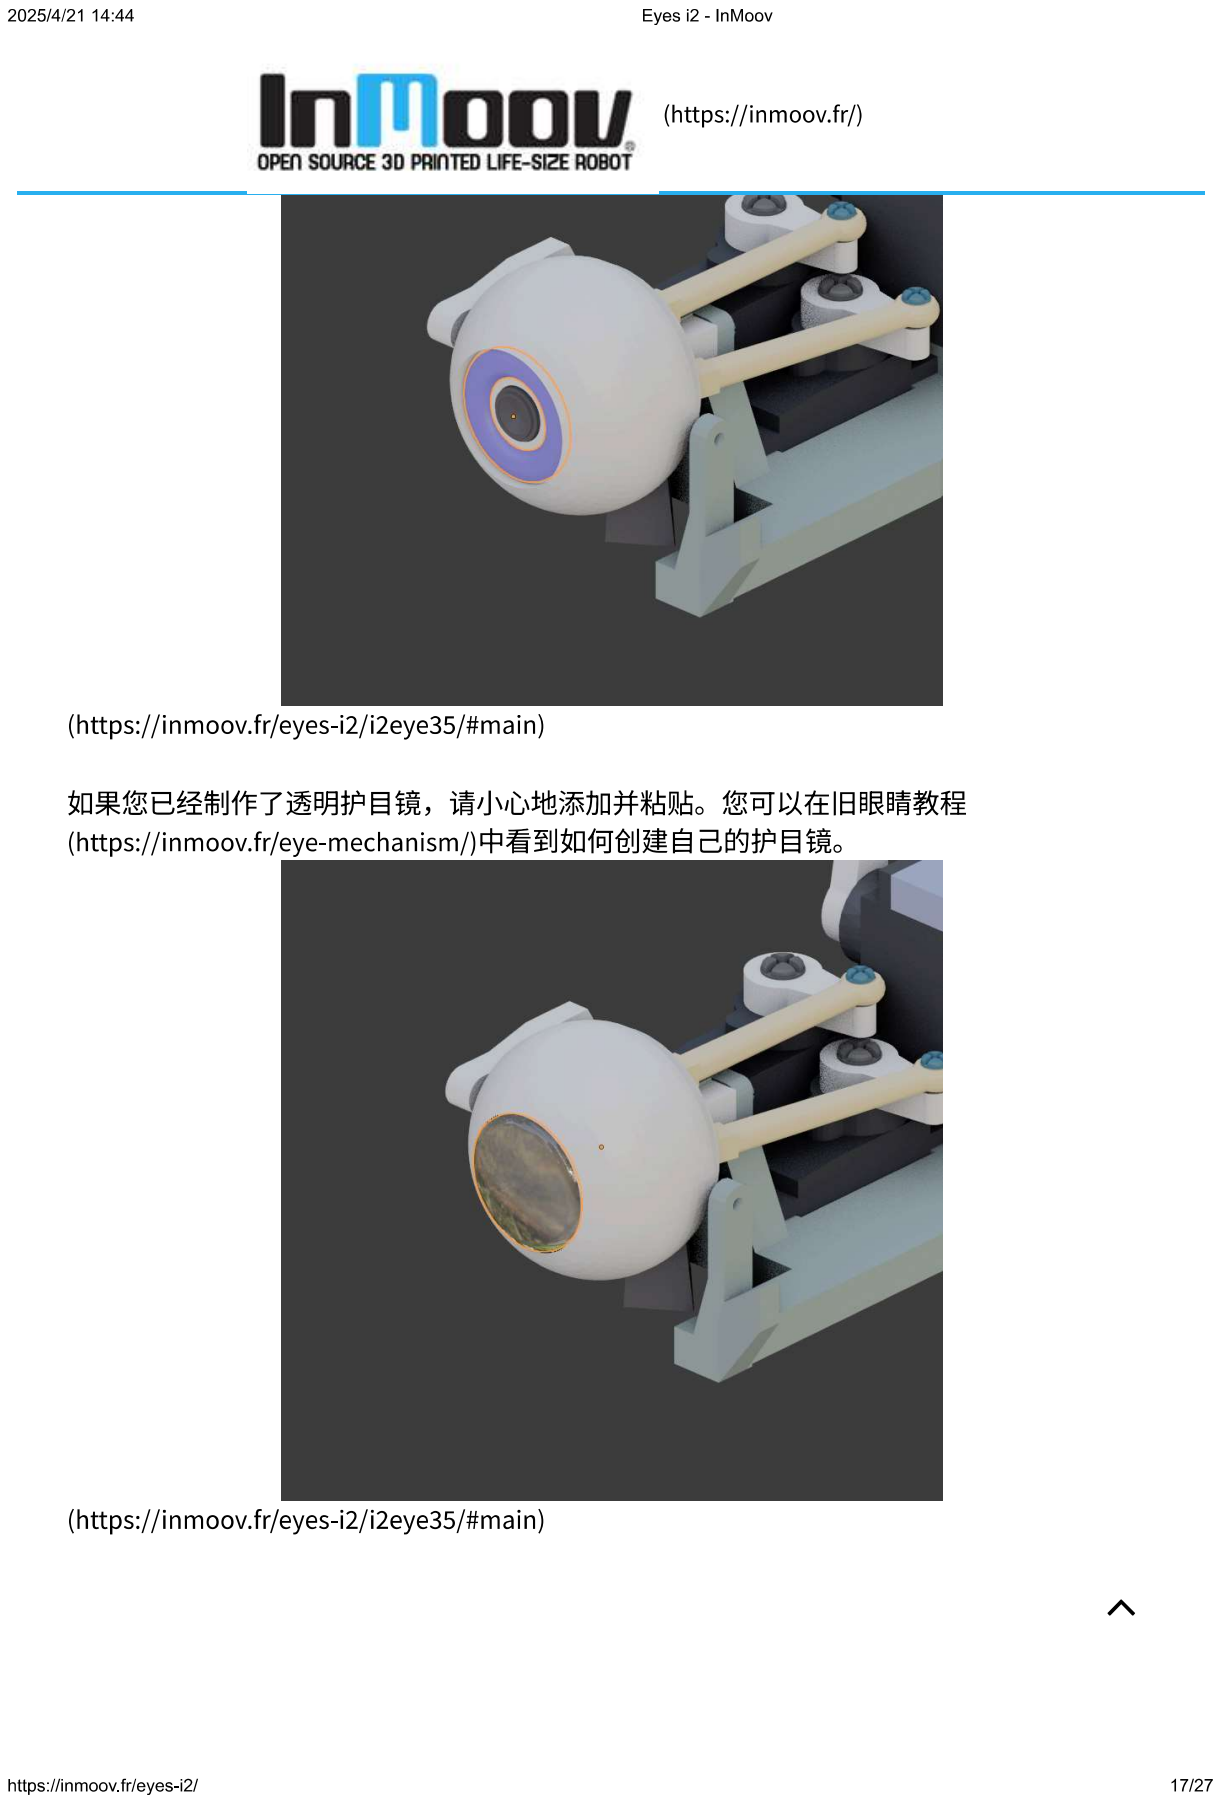
[picture p327: page 17]
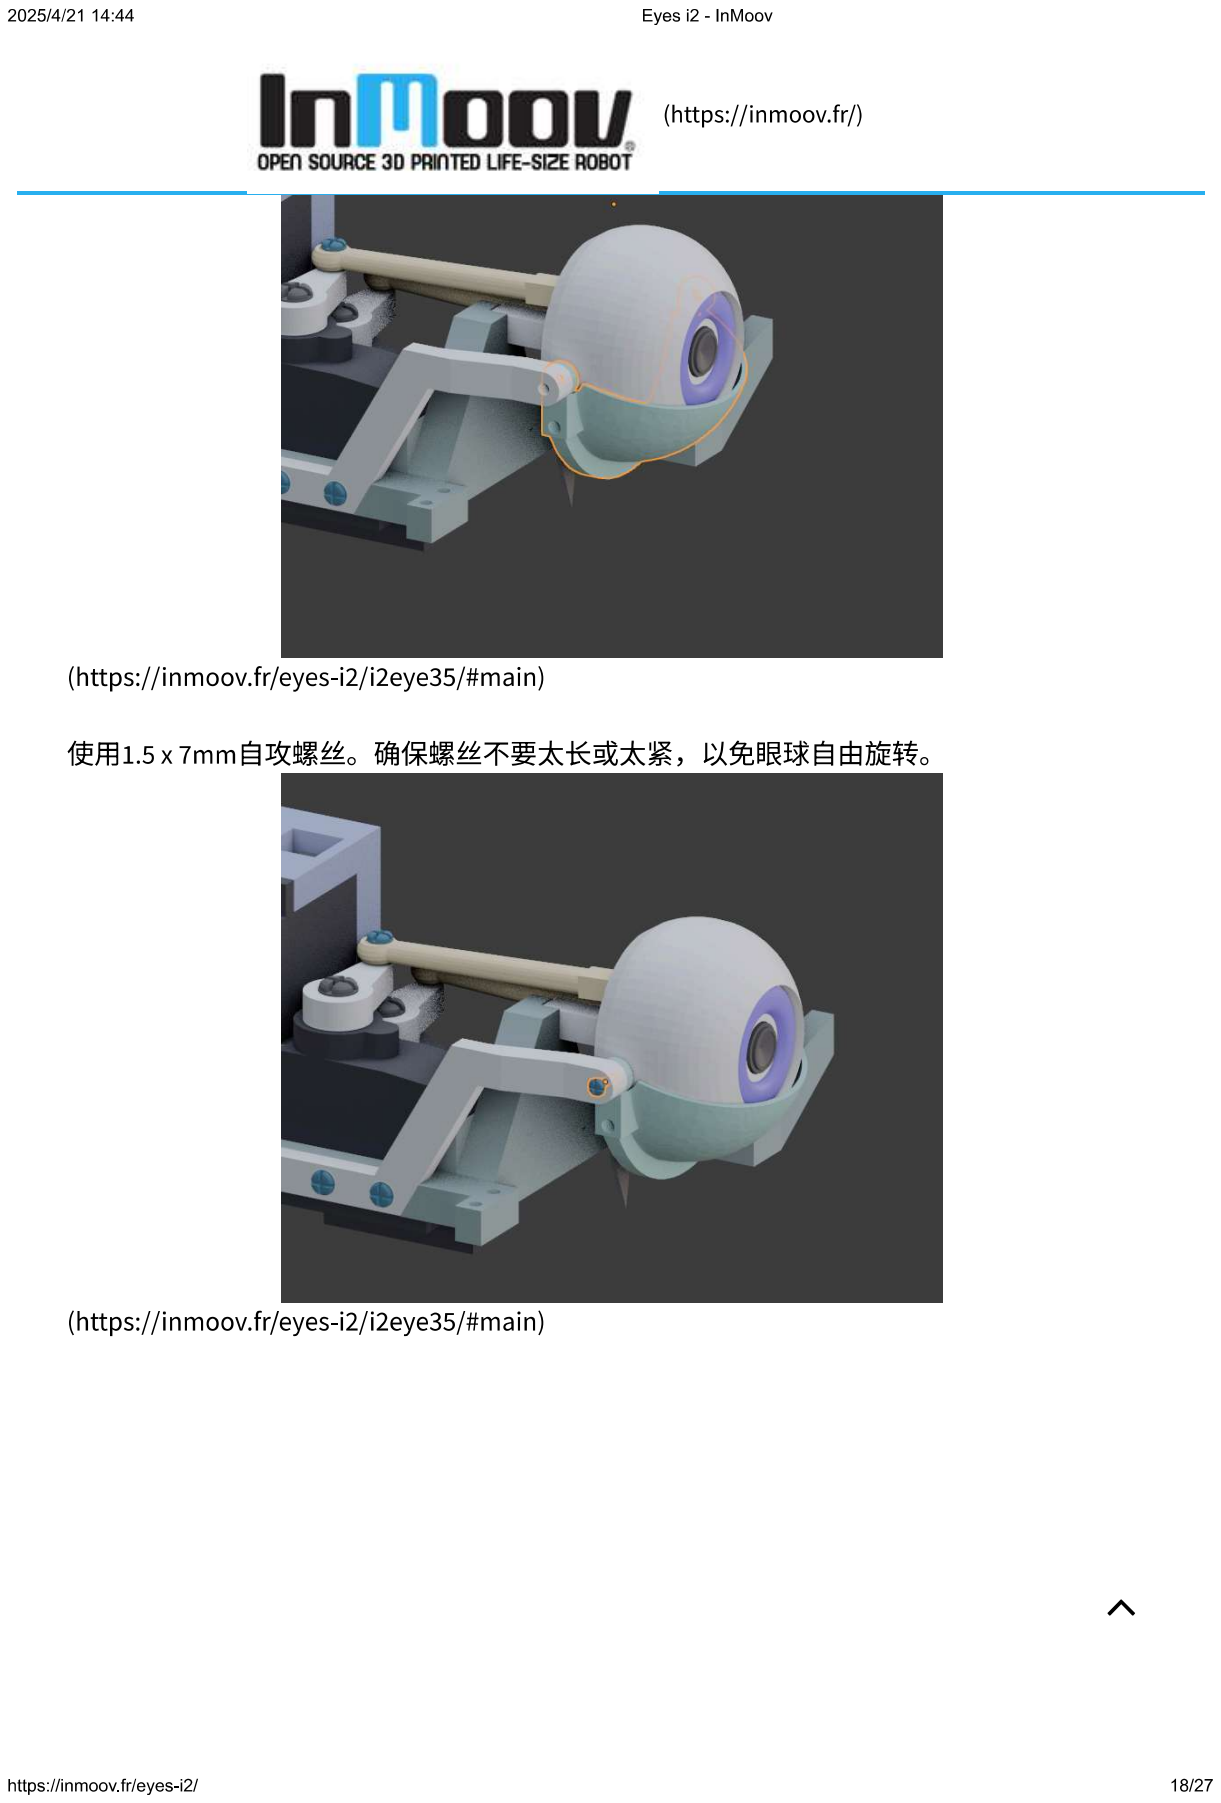
[picture p328: page 18]
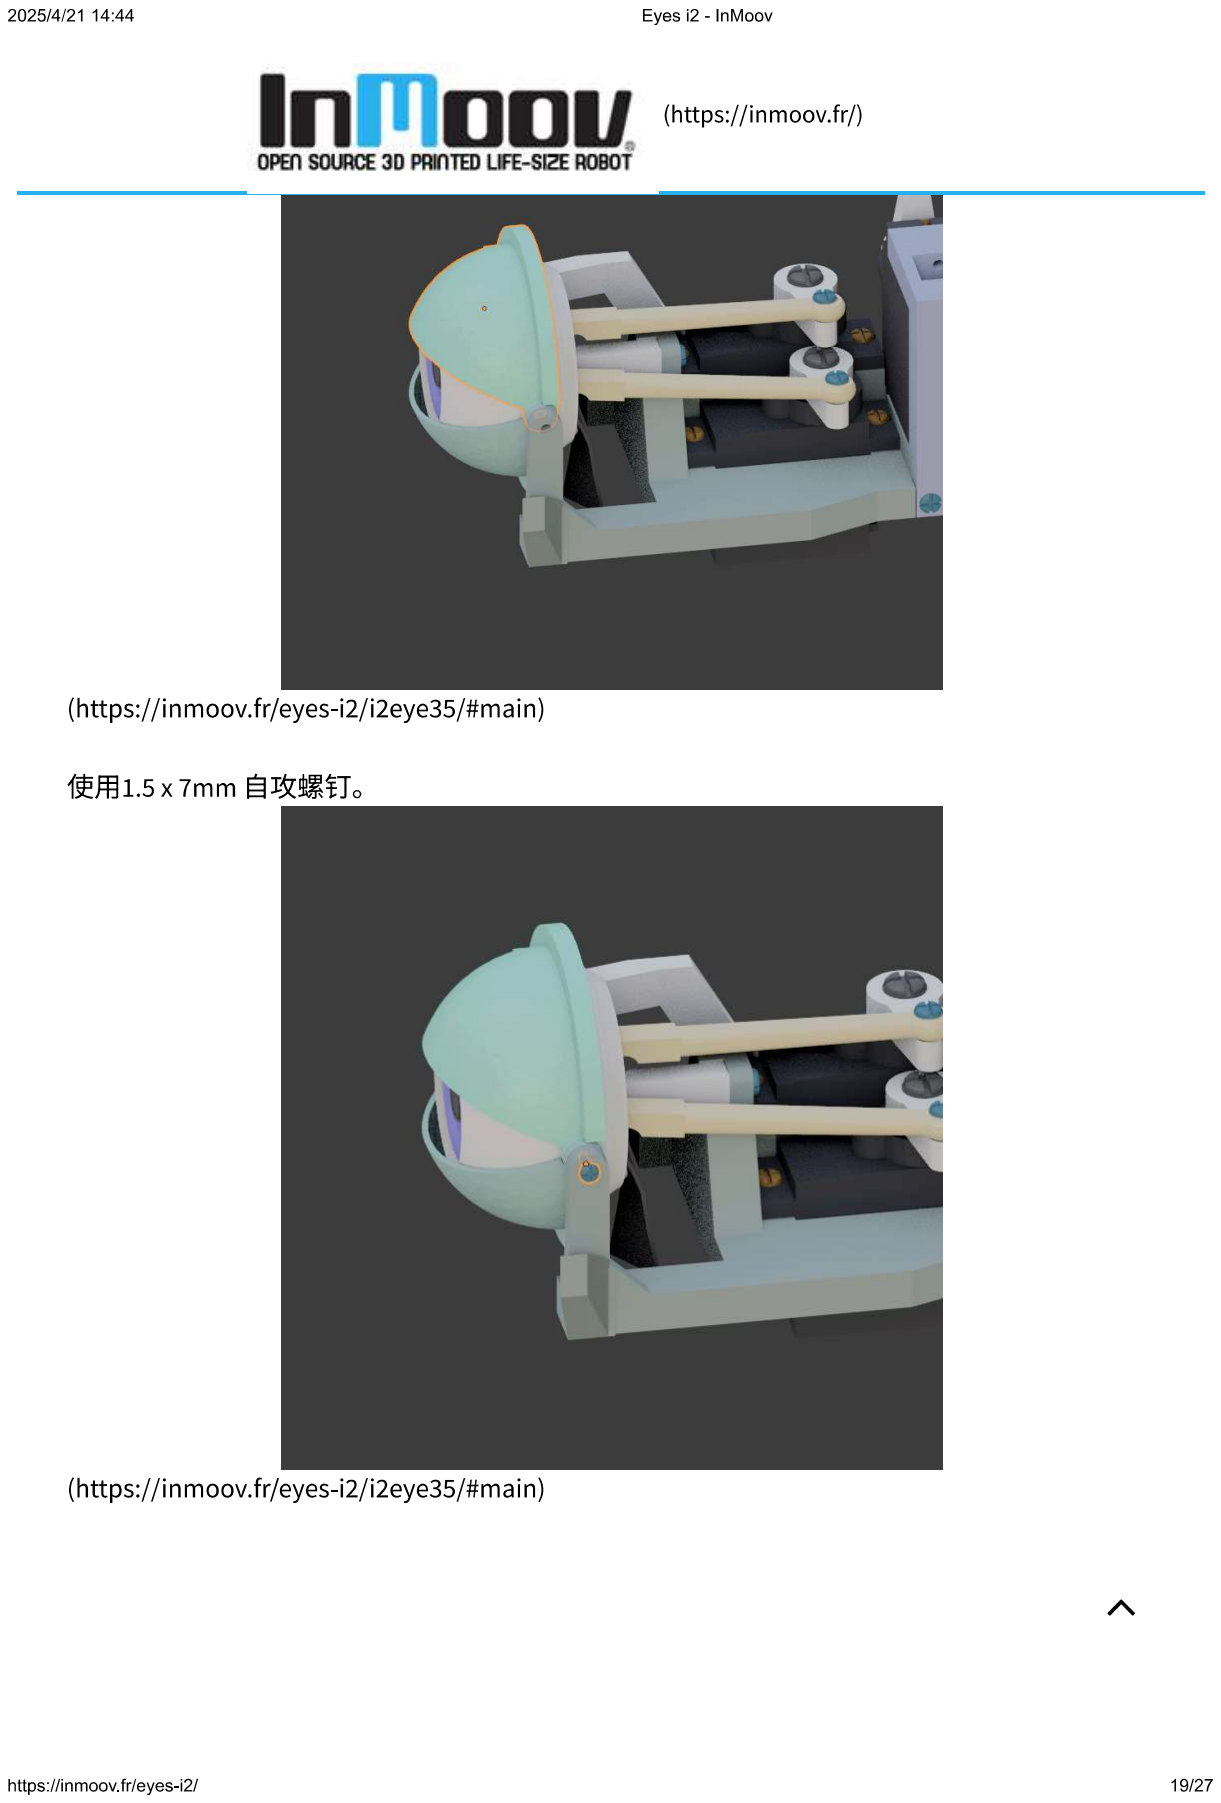
[picture p329: page 19]
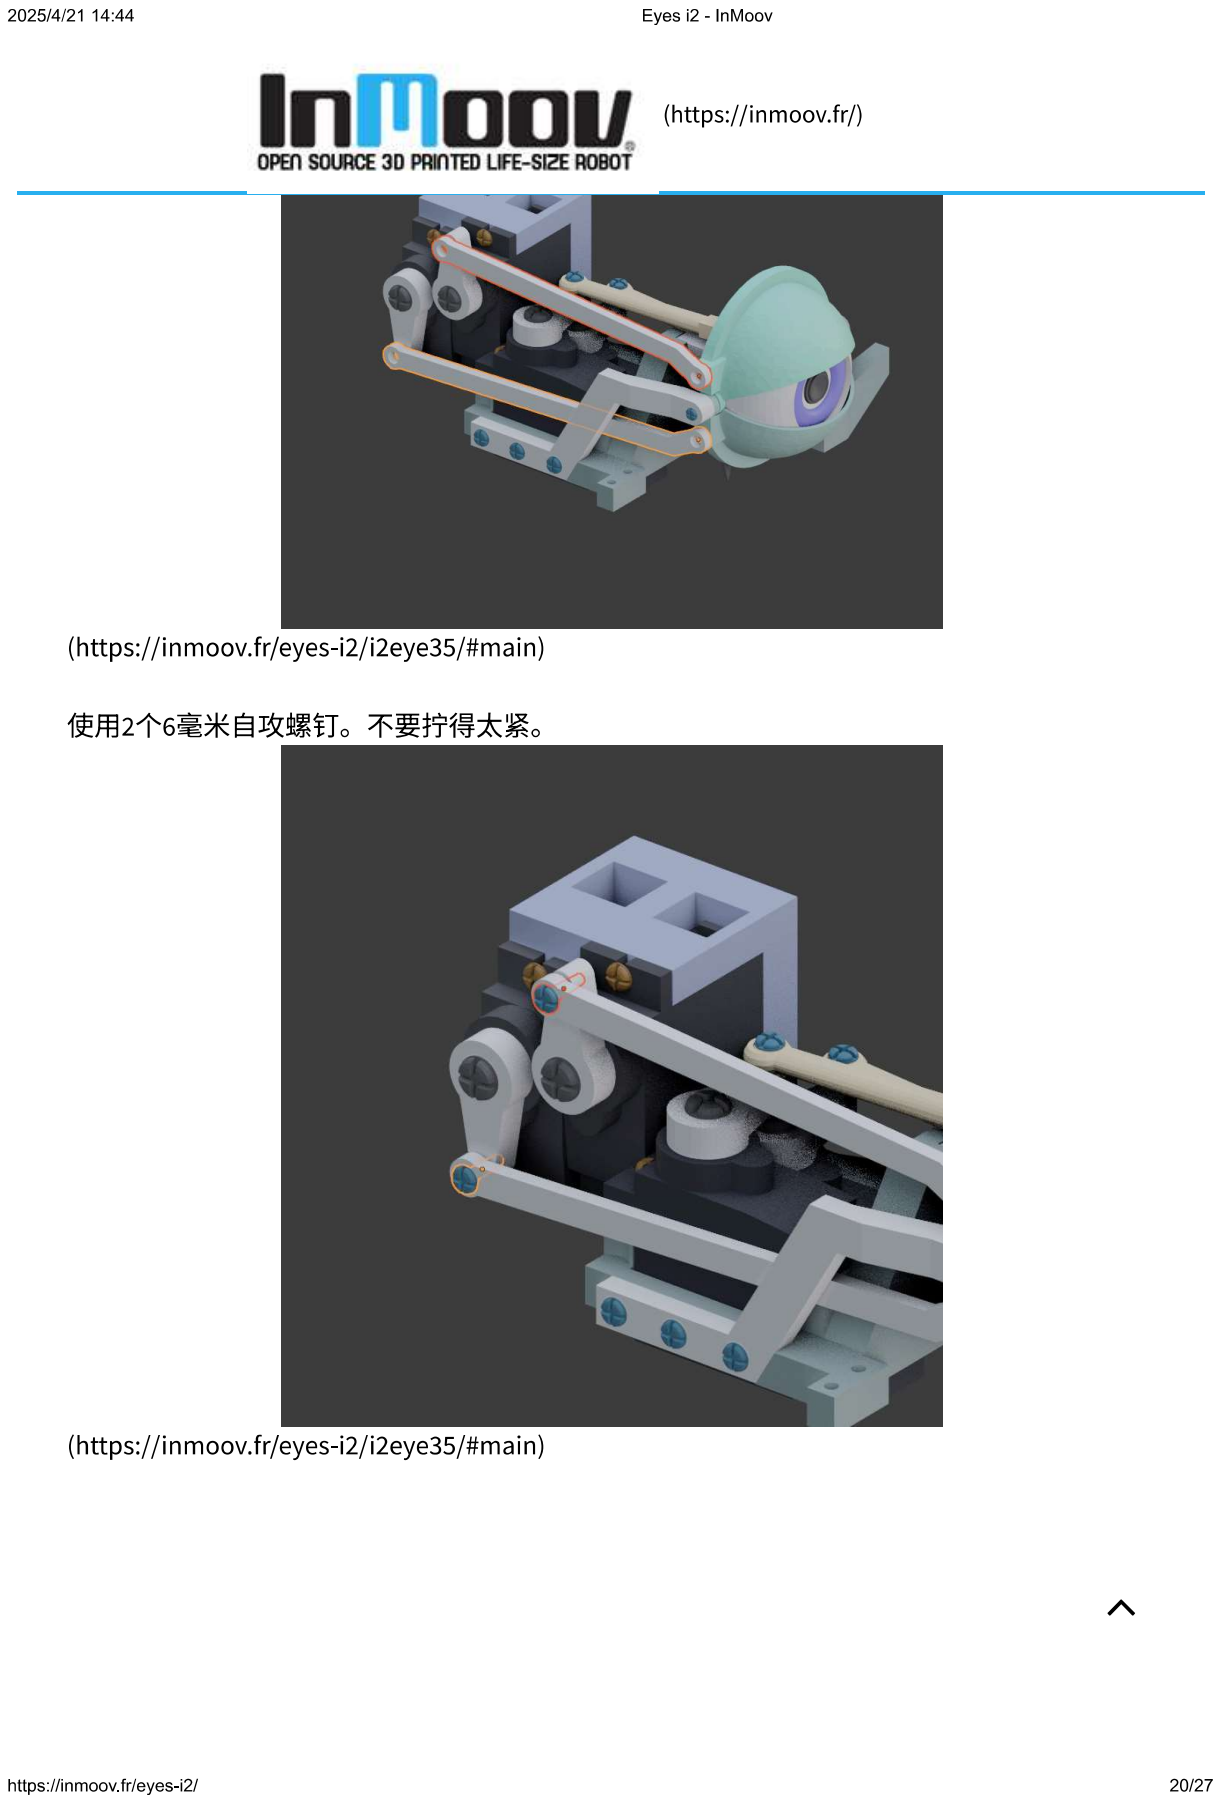
[picture p330: page 20]
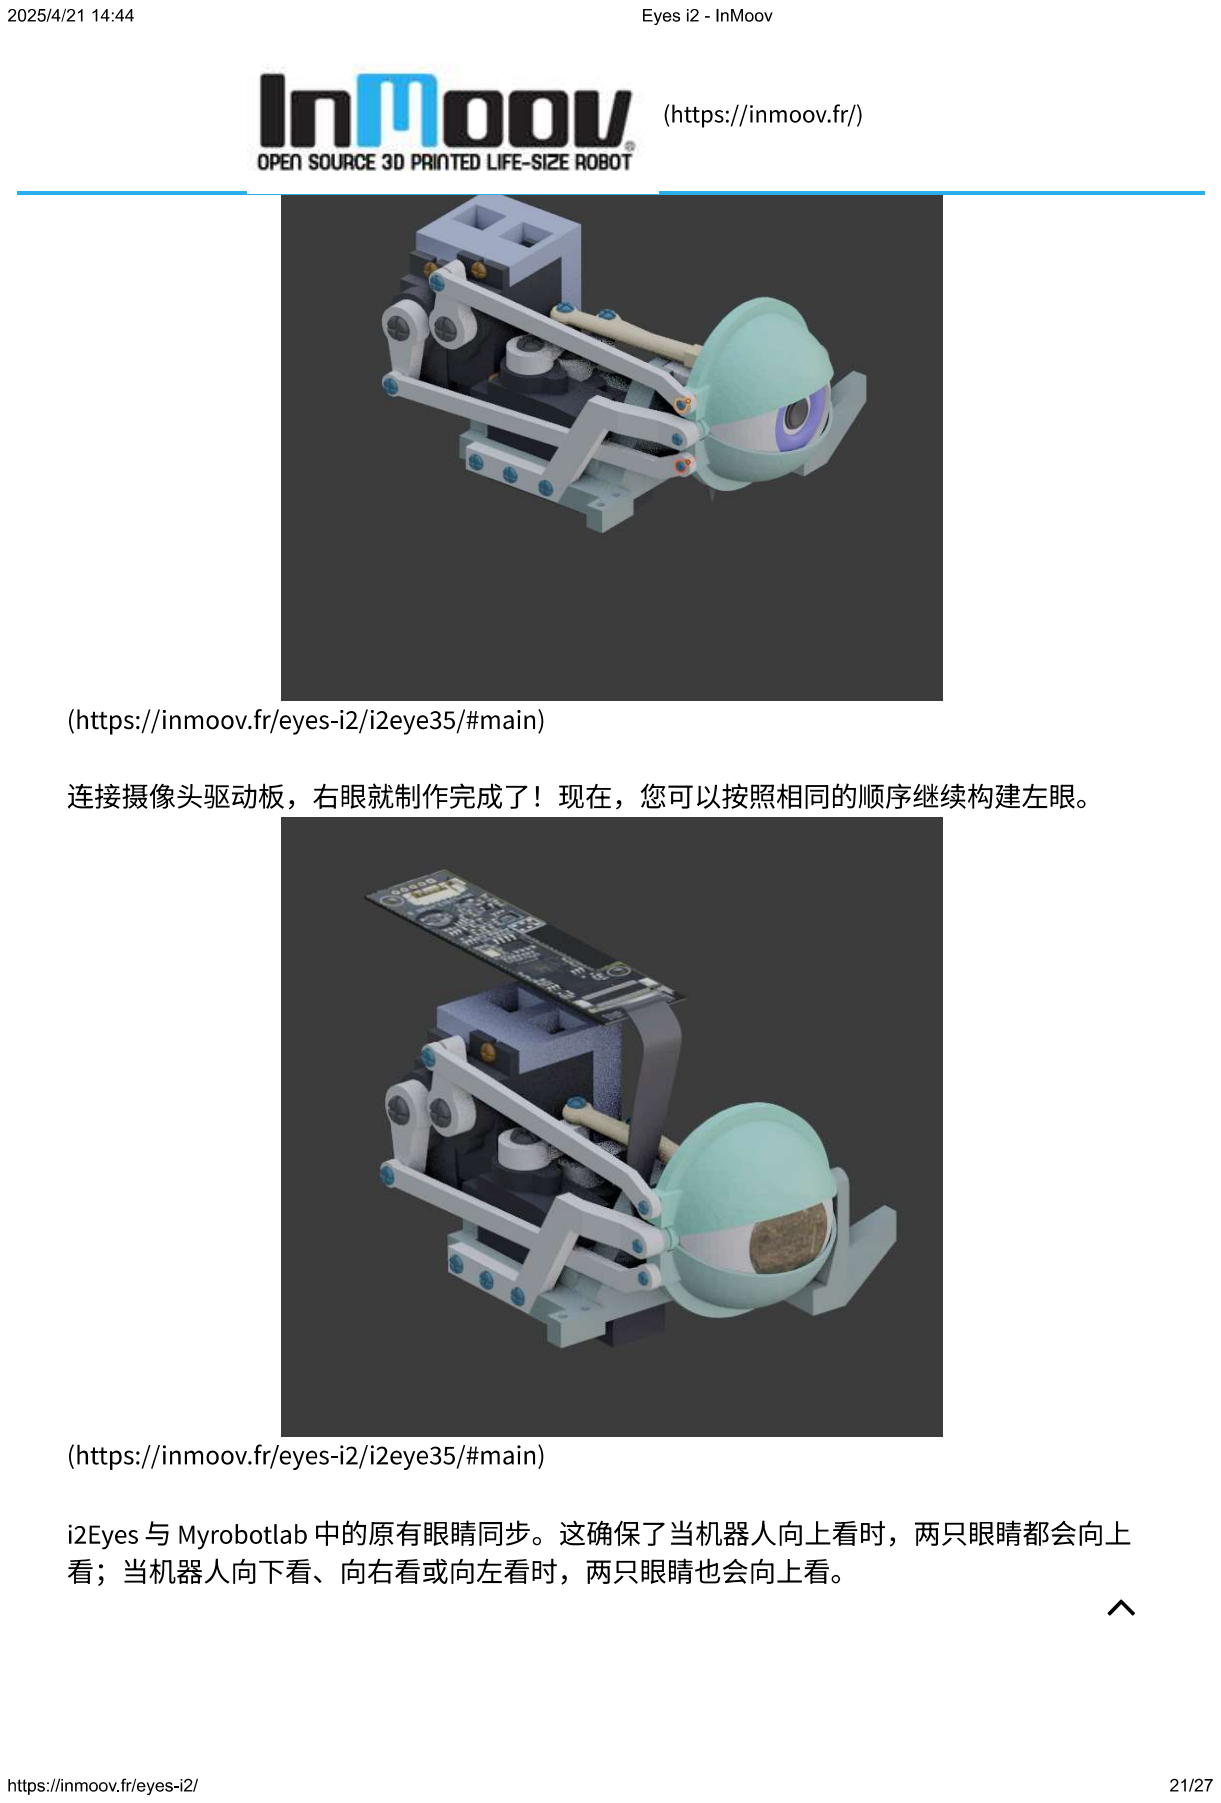
[picture p331: page 21]
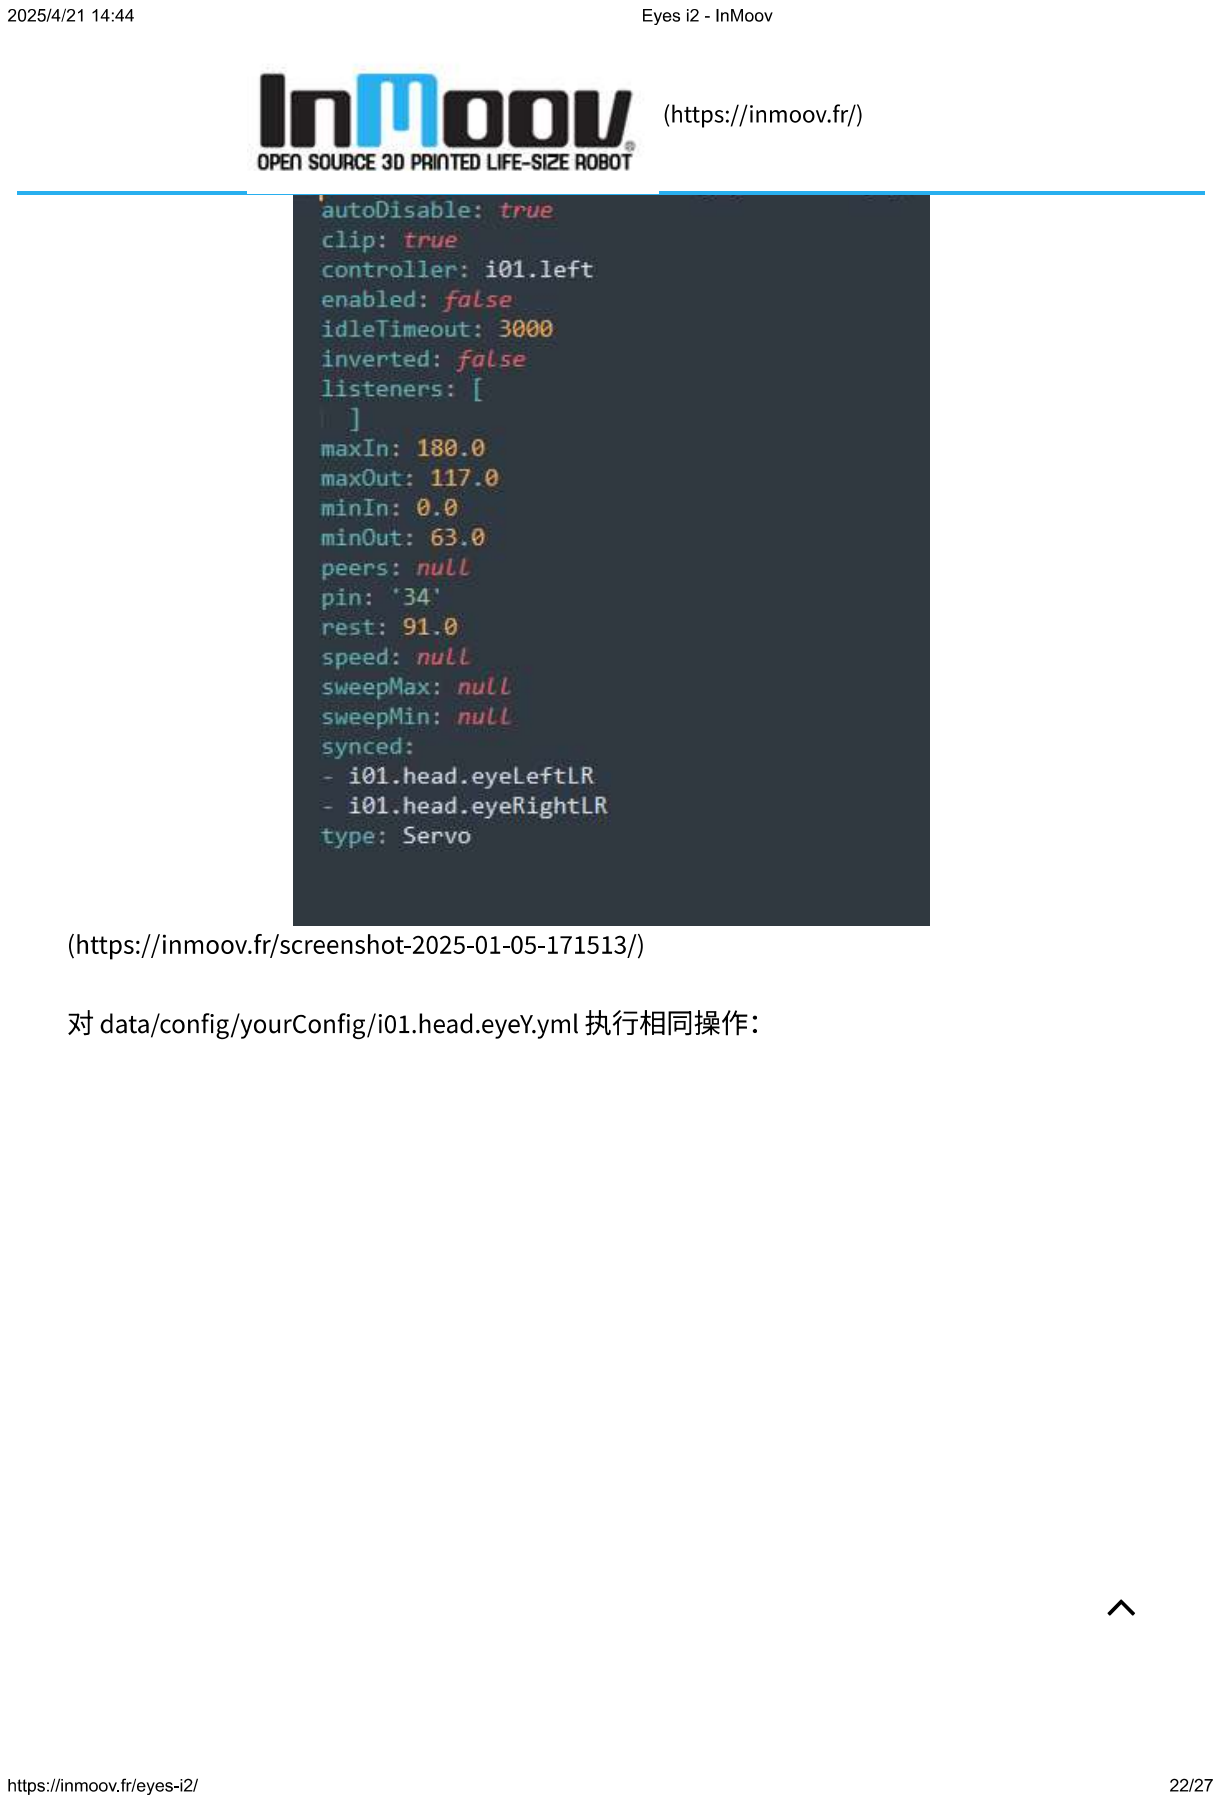
[picture p332: page 22]
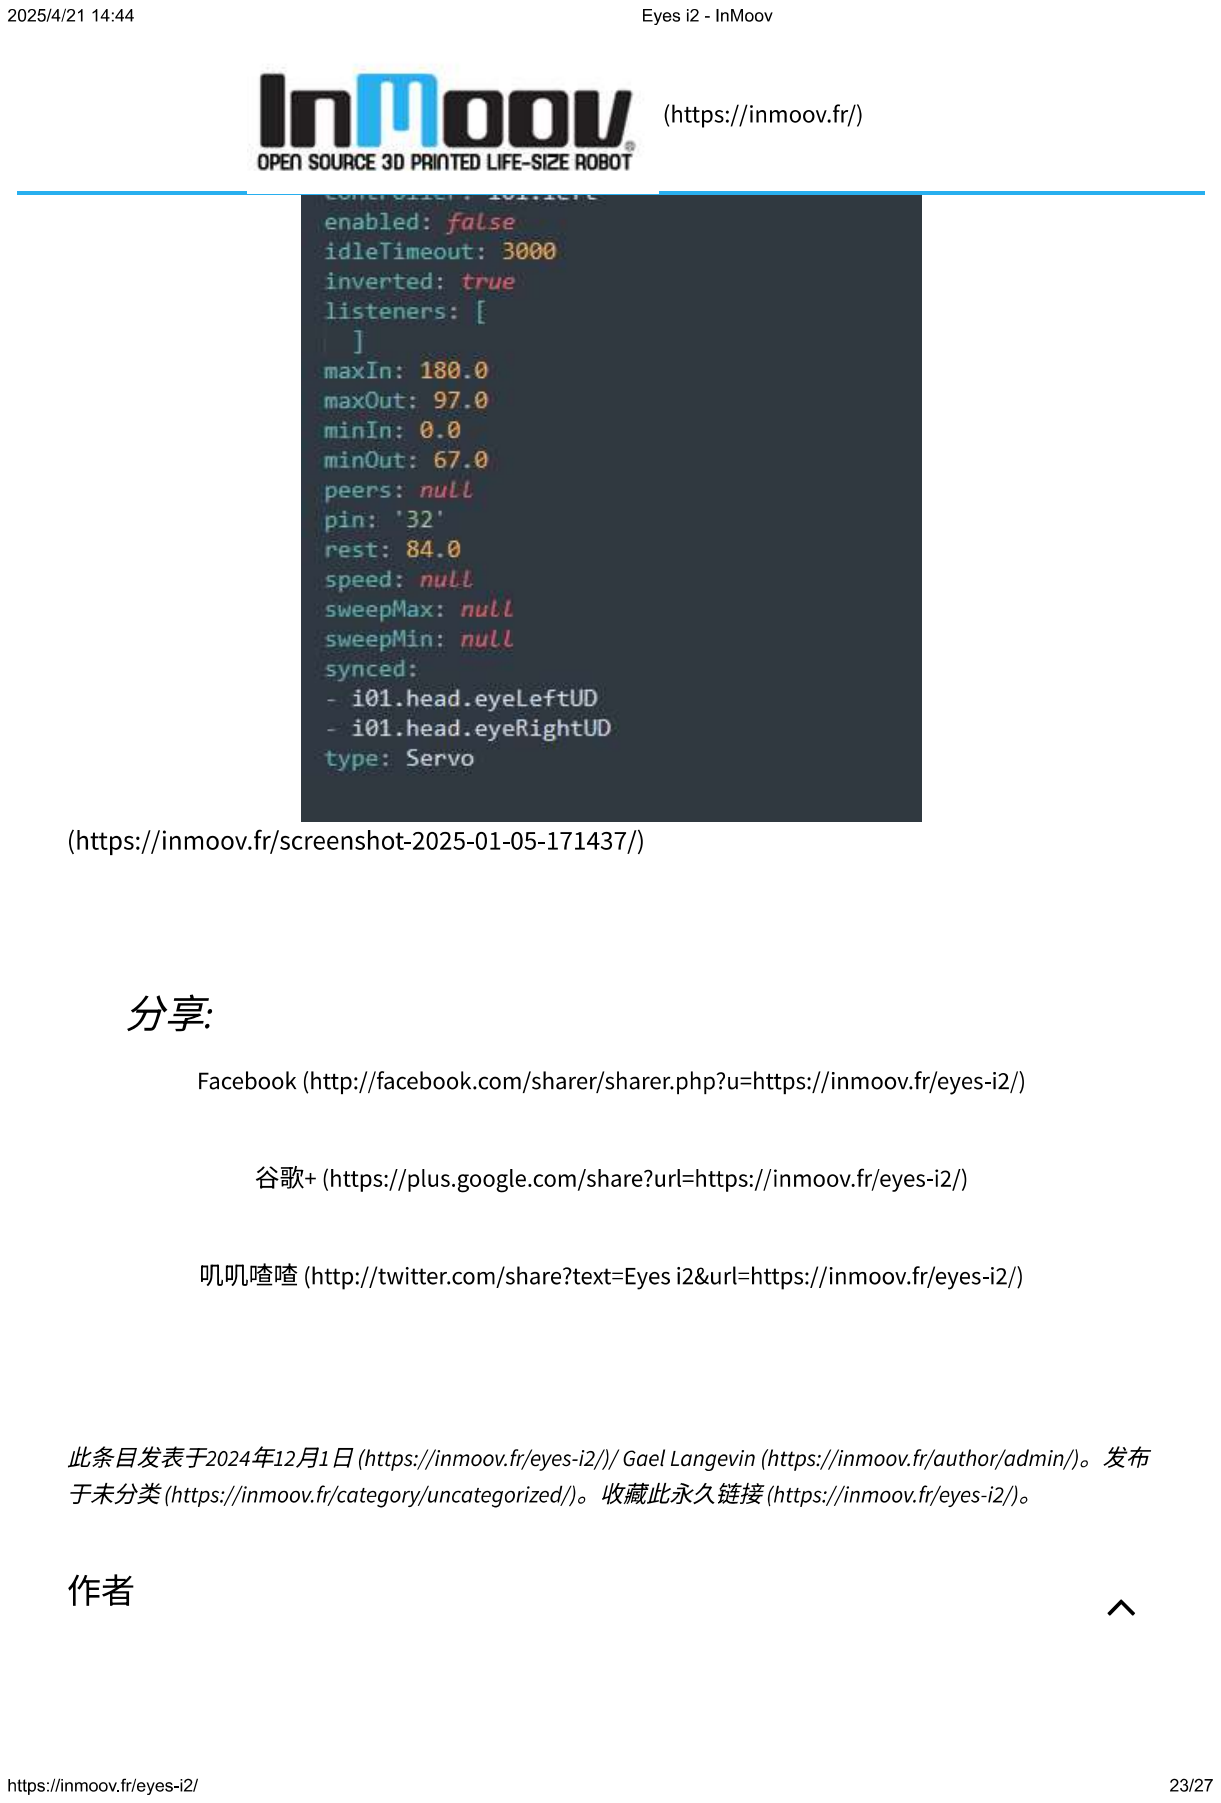
[picture p333: page 23]
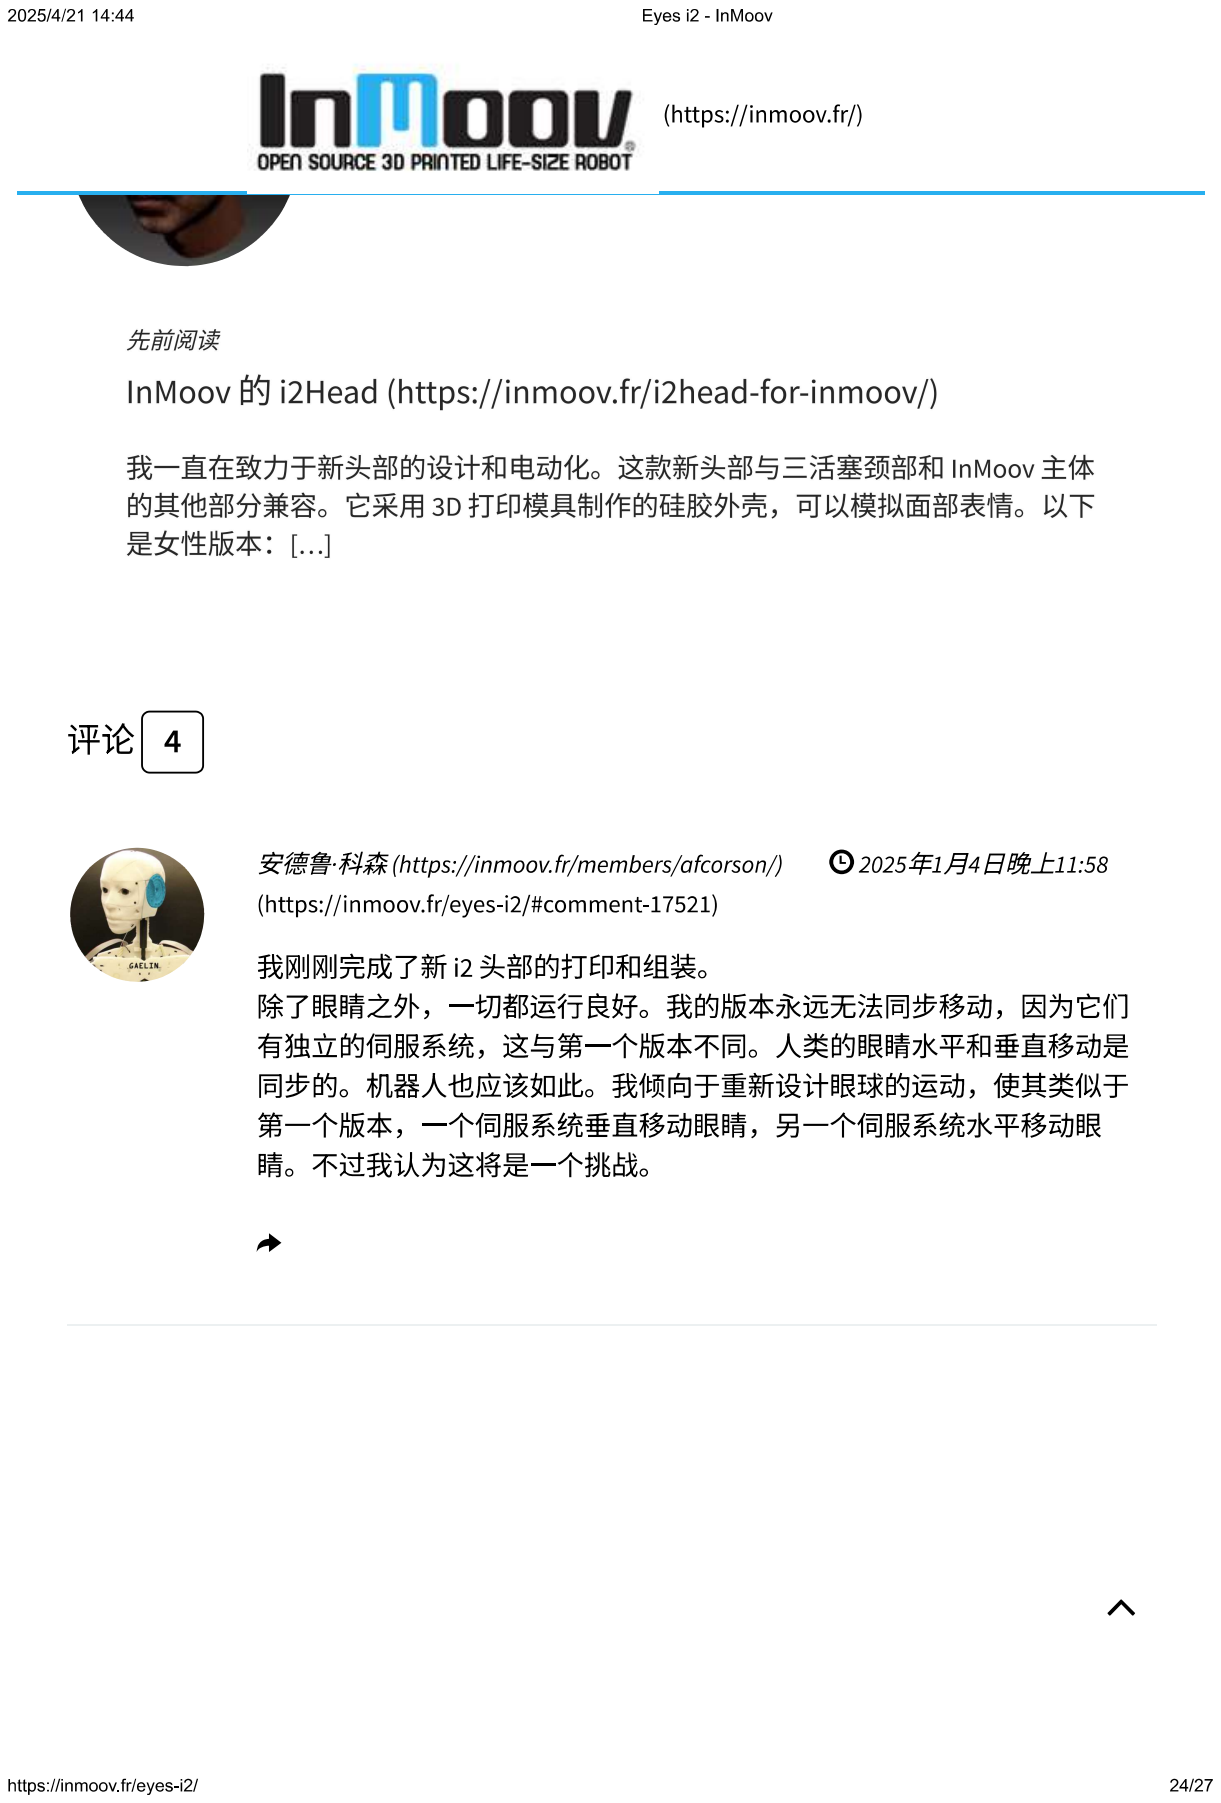
[picture p334: page 24]
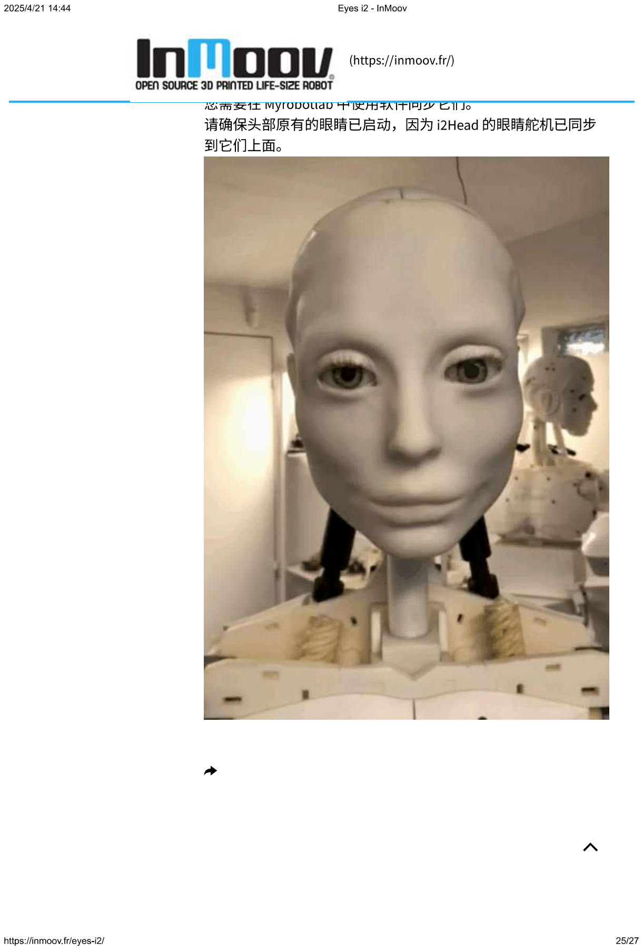
[picture p335: page 25]
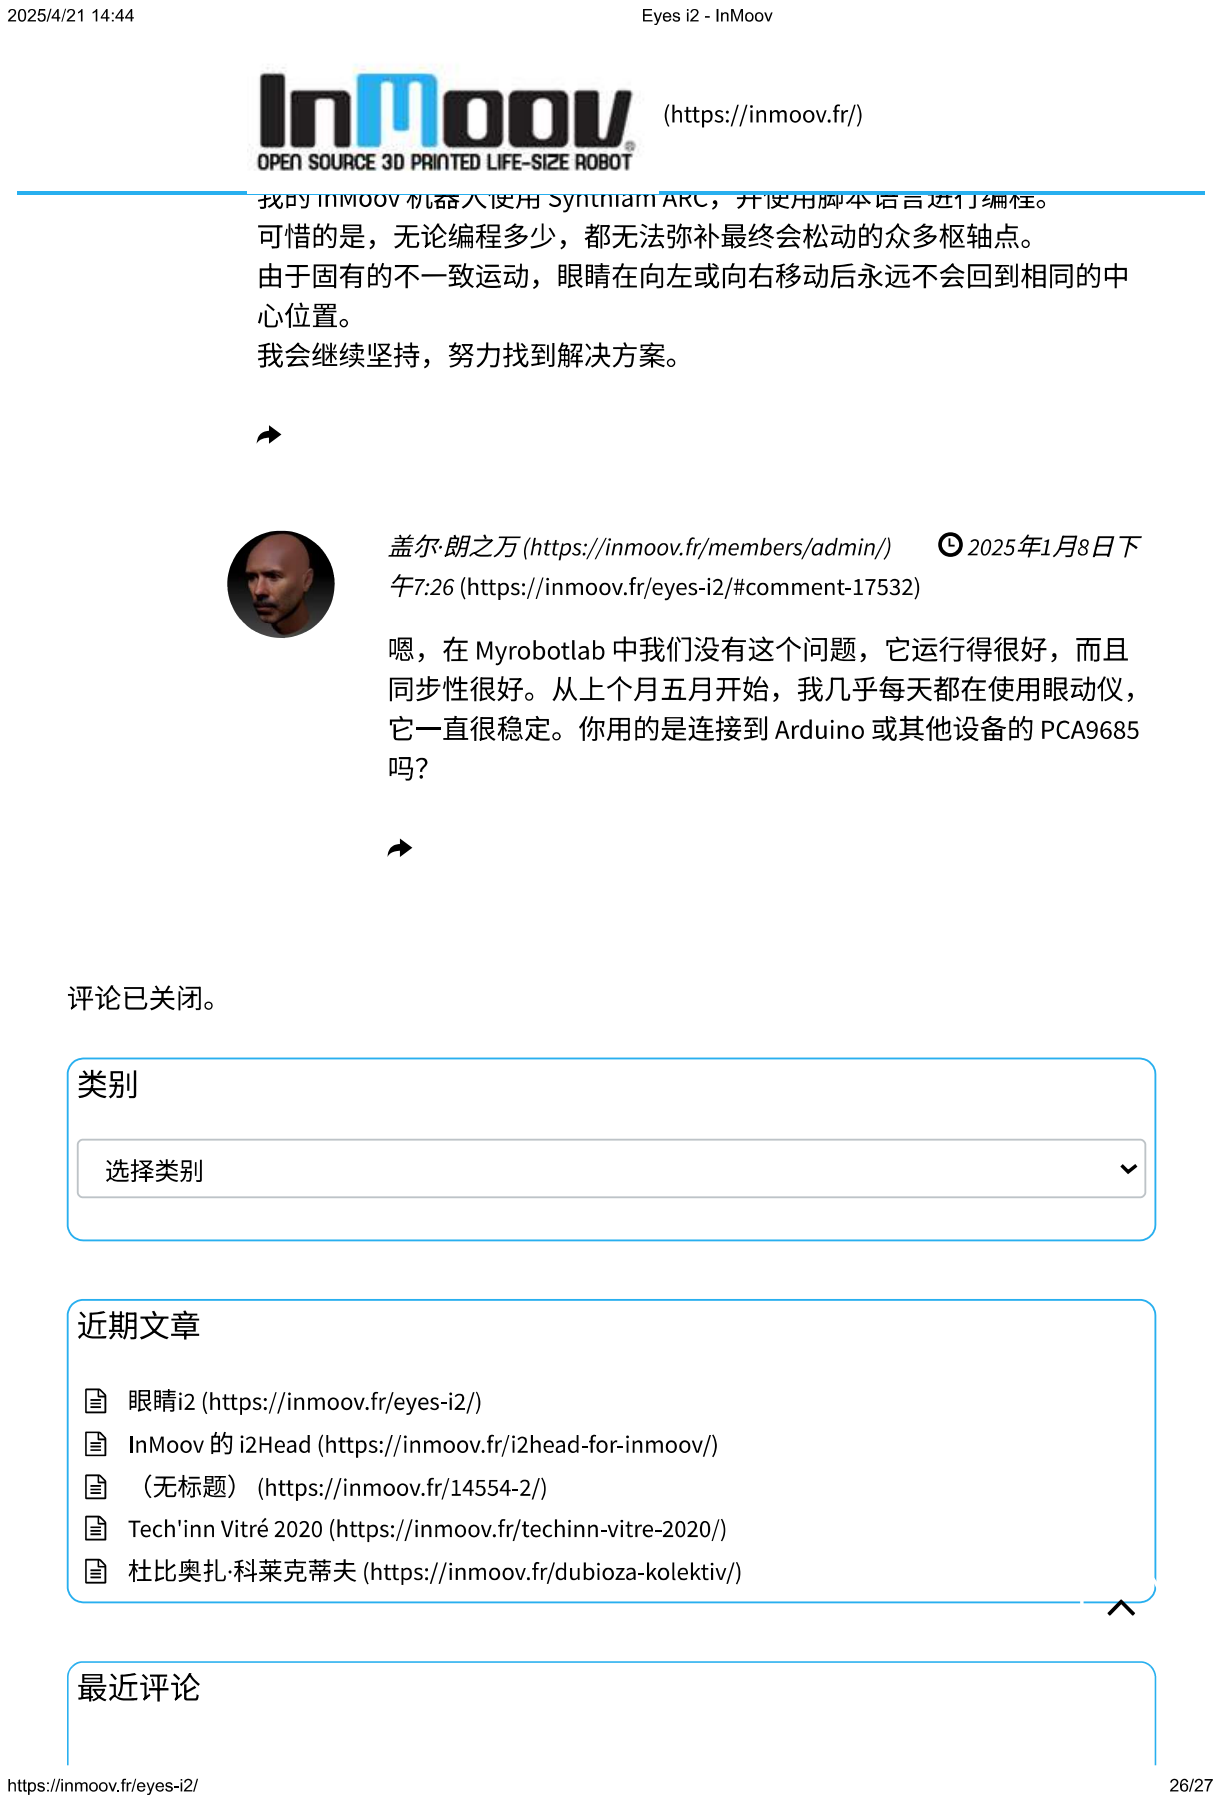
[picture p336: page 26]
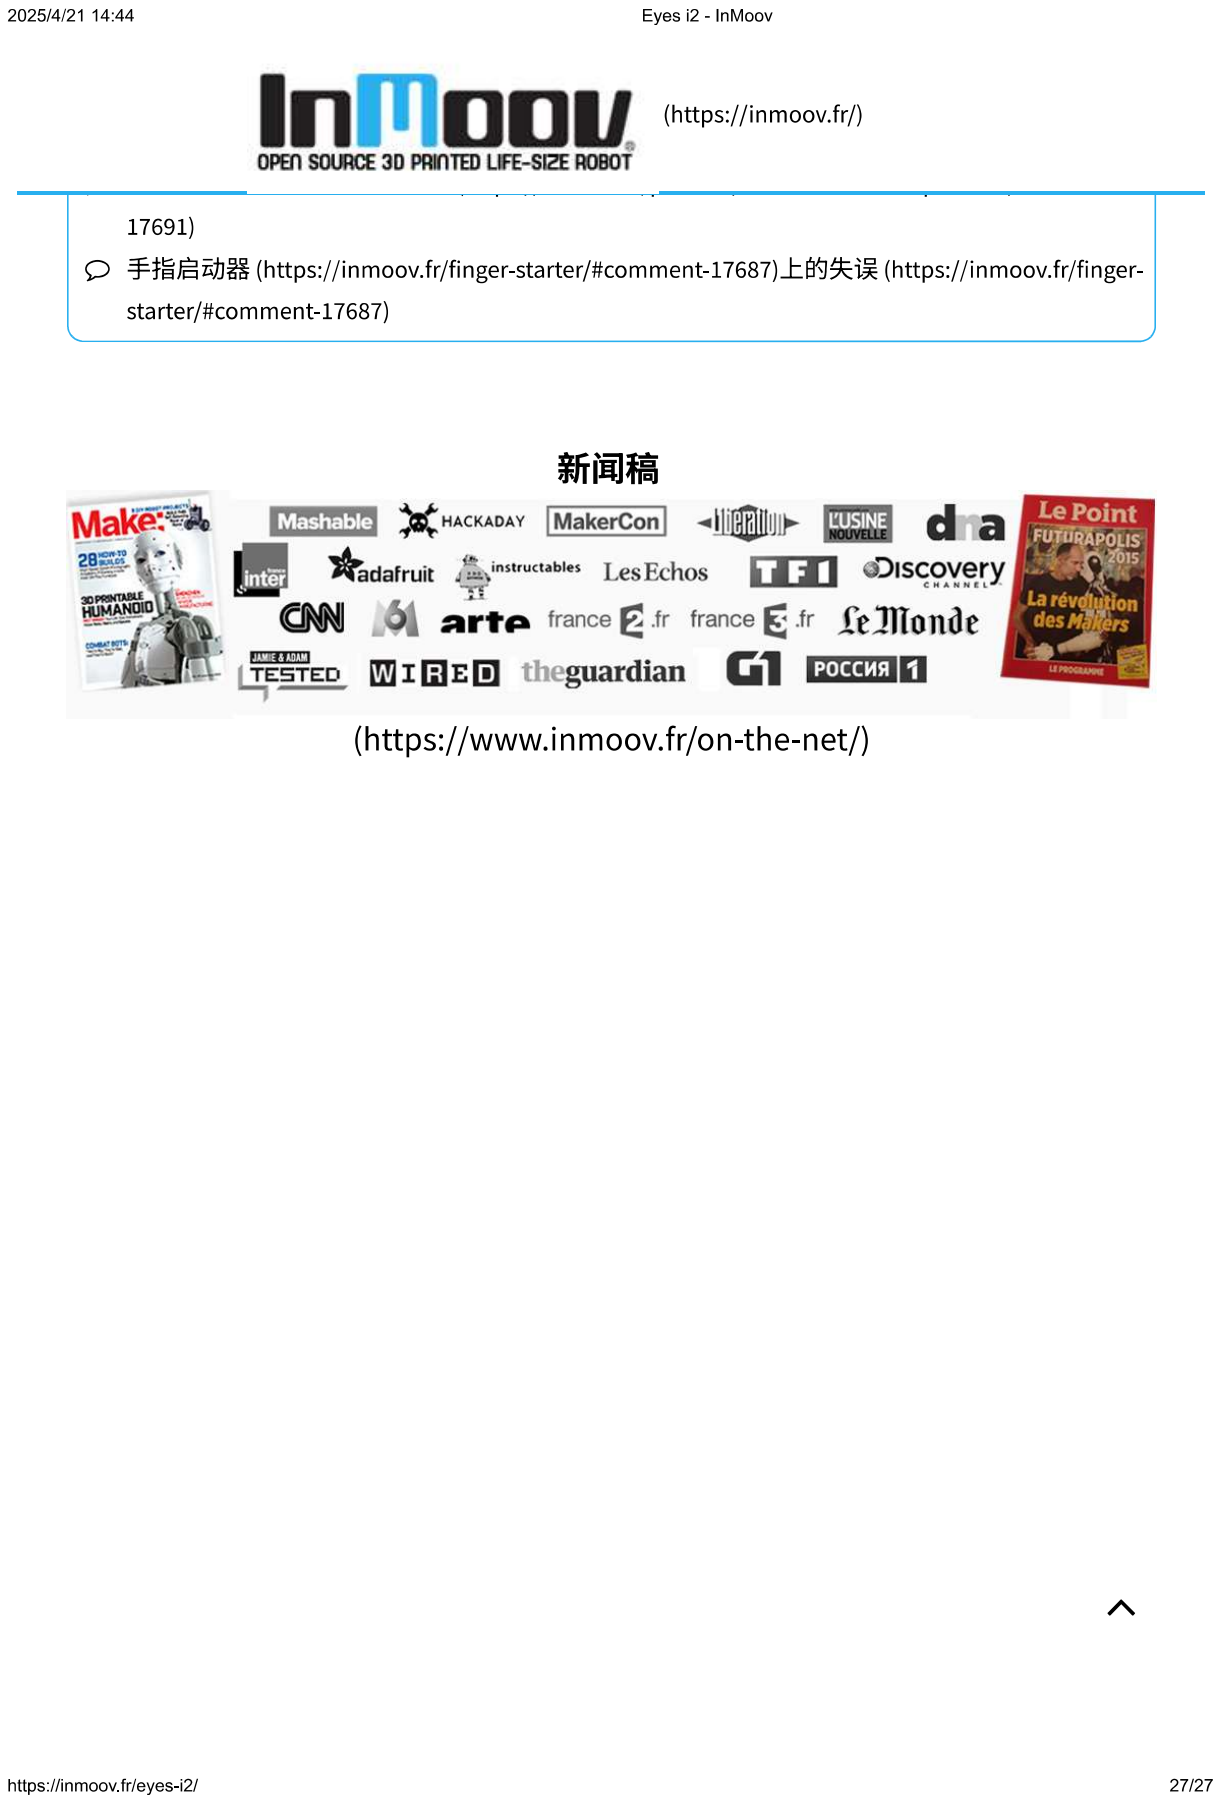
[picture p337: page 27]
