idolverse/Tulingjiuge_robot_1/零件组装教程+stl文件/Hand_i2-main/Hand_i2教程.pdf

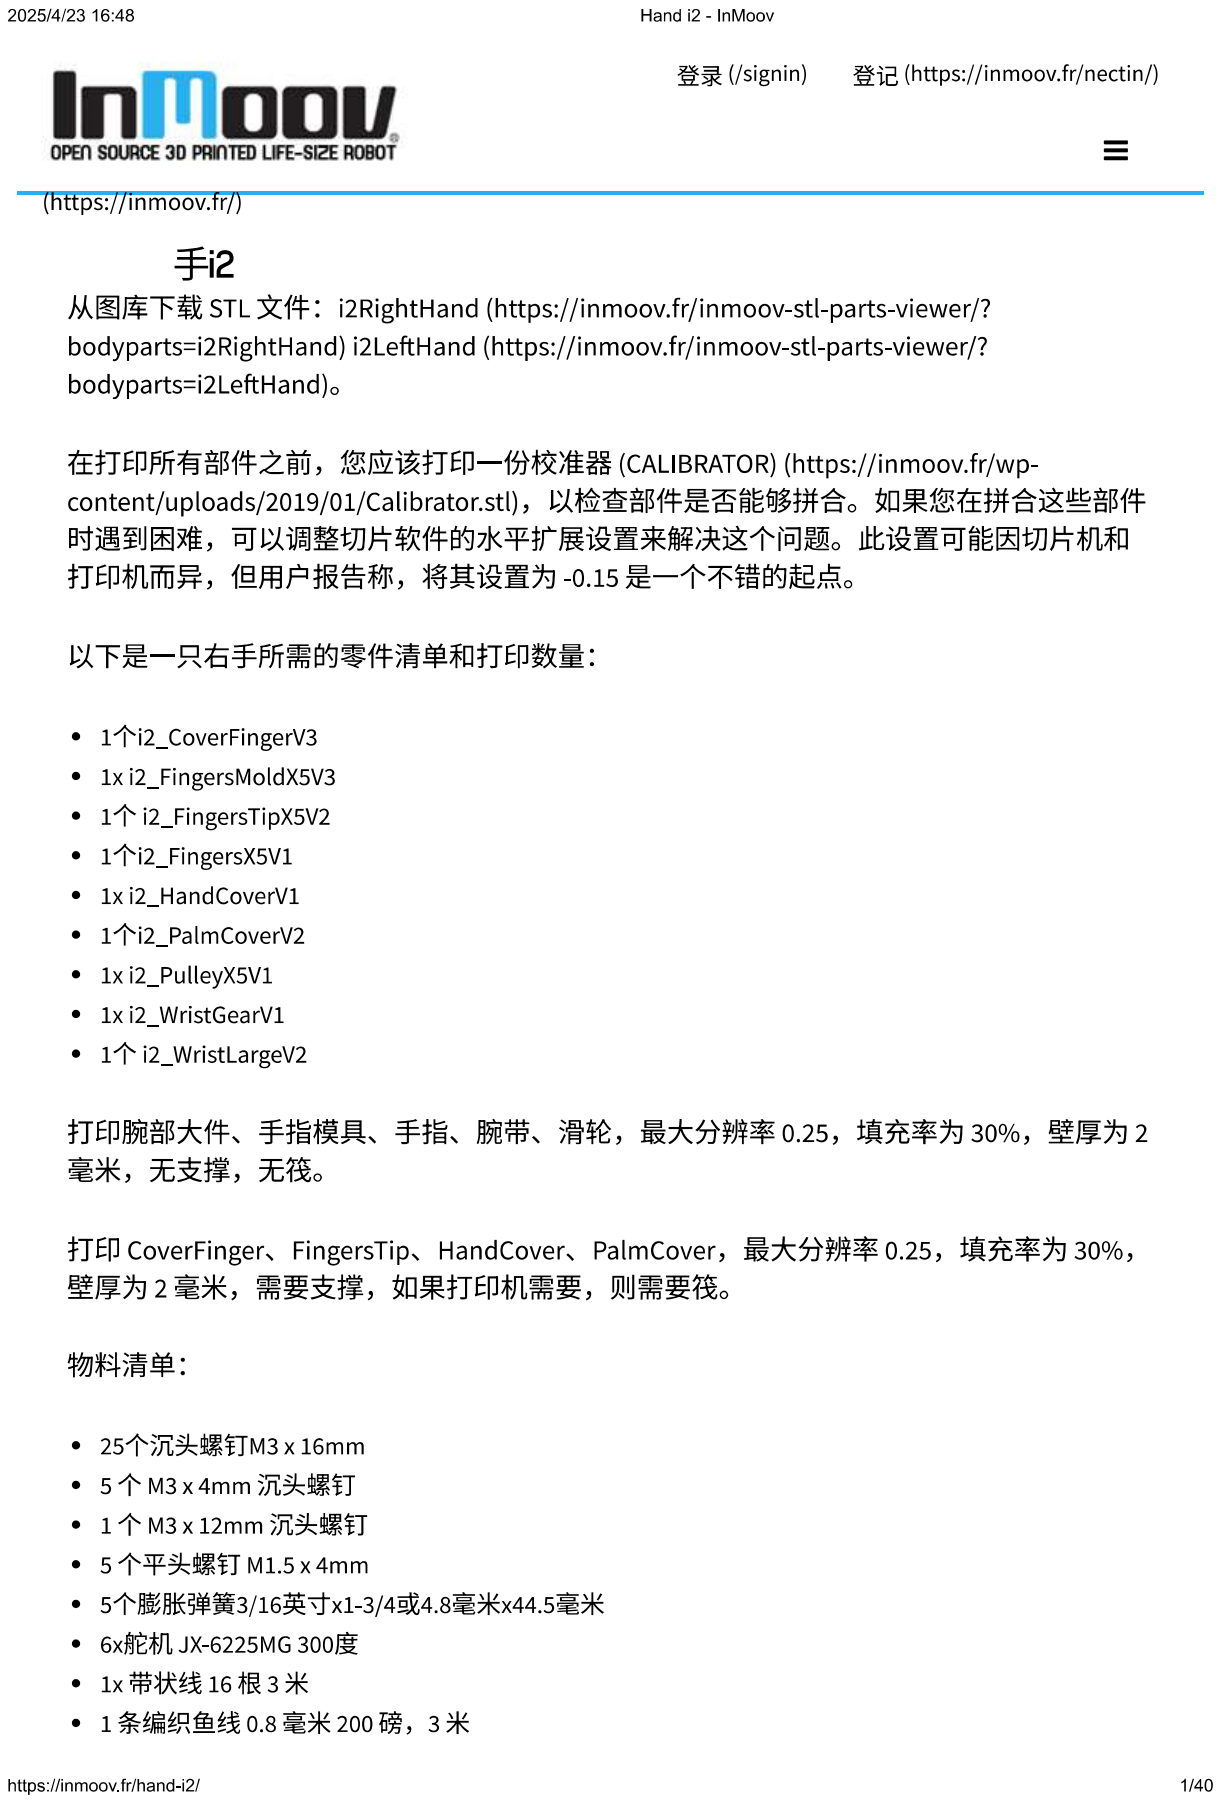
[picture p338: page 1]
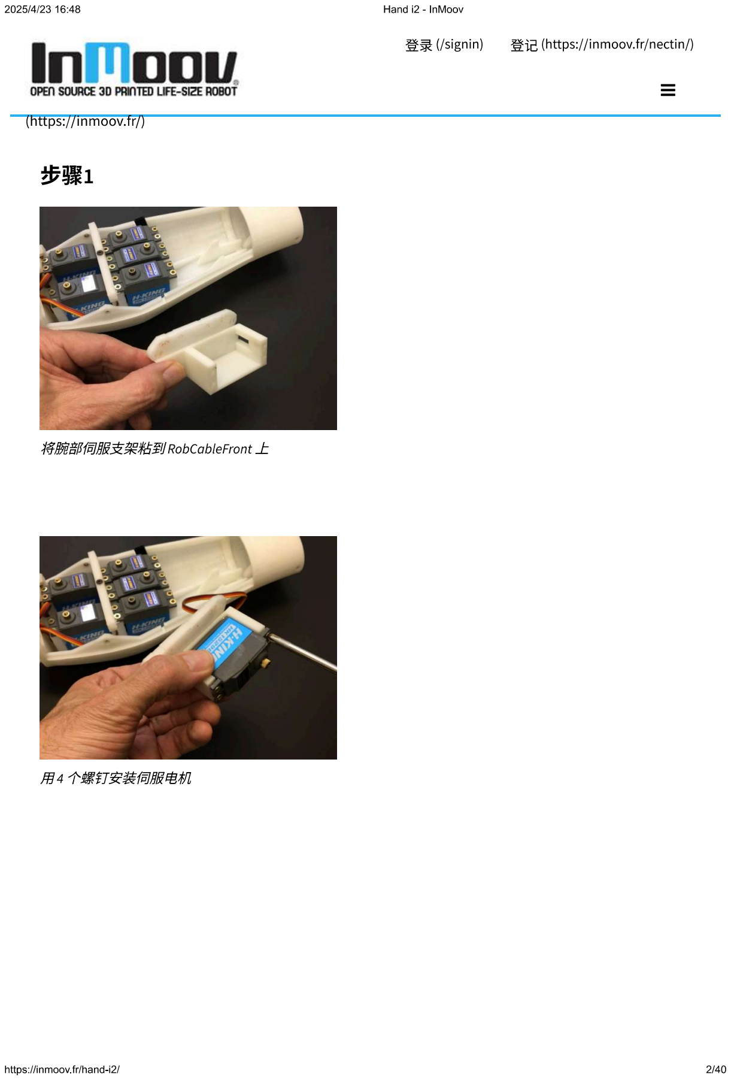
[picture p339: page 2]
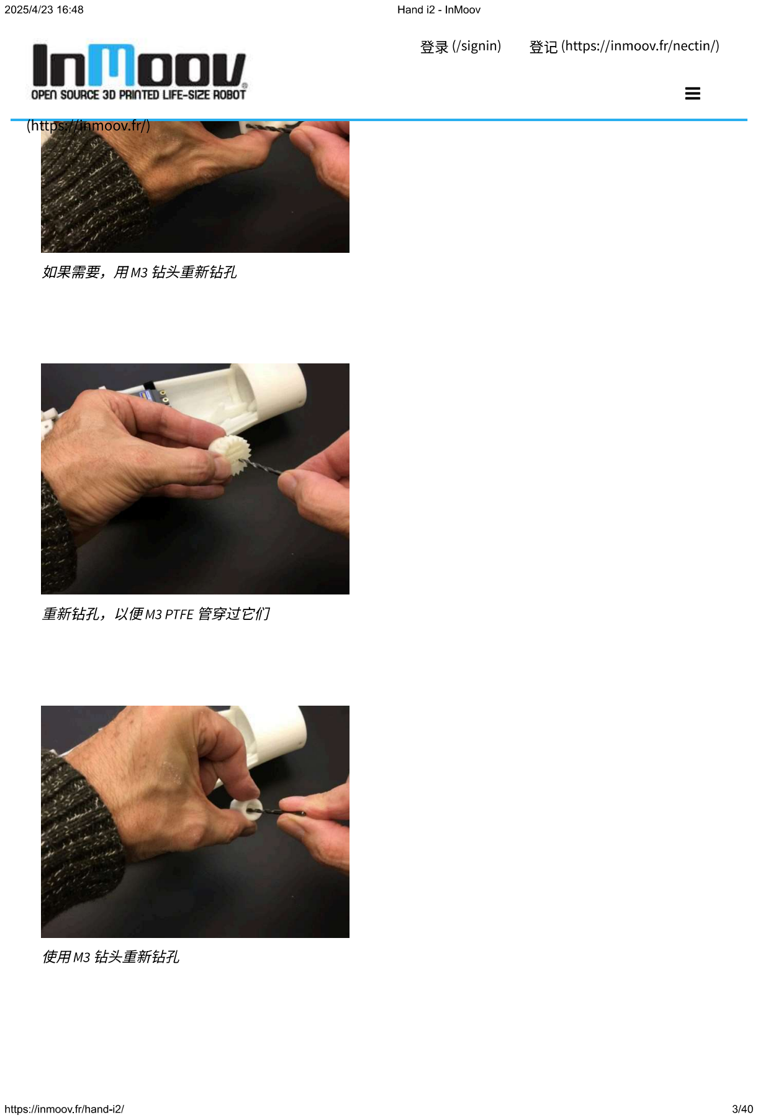
[picture p340: page 3]
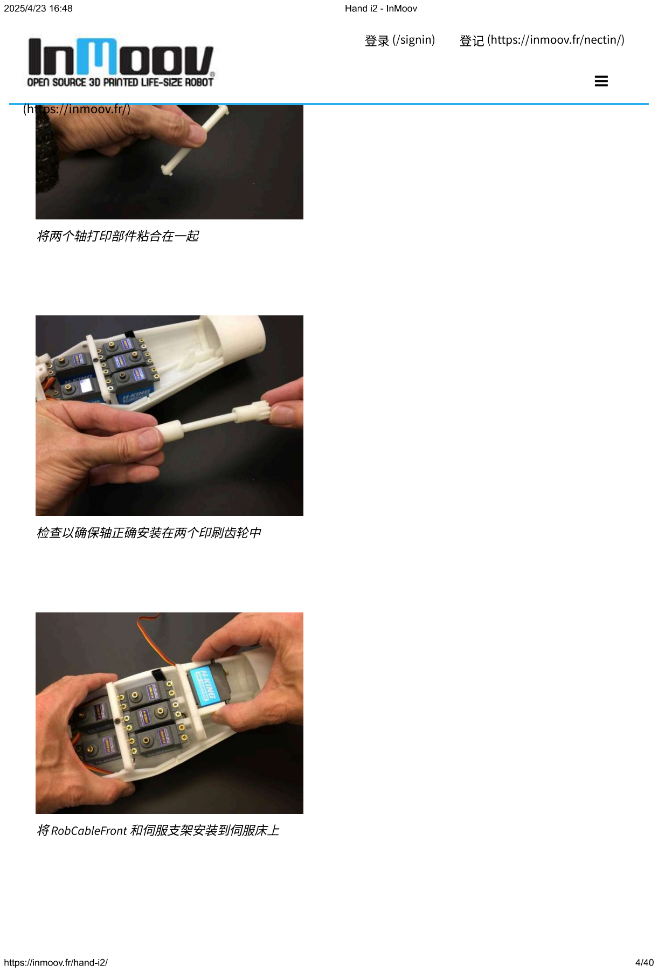
[picture p341: page 4]
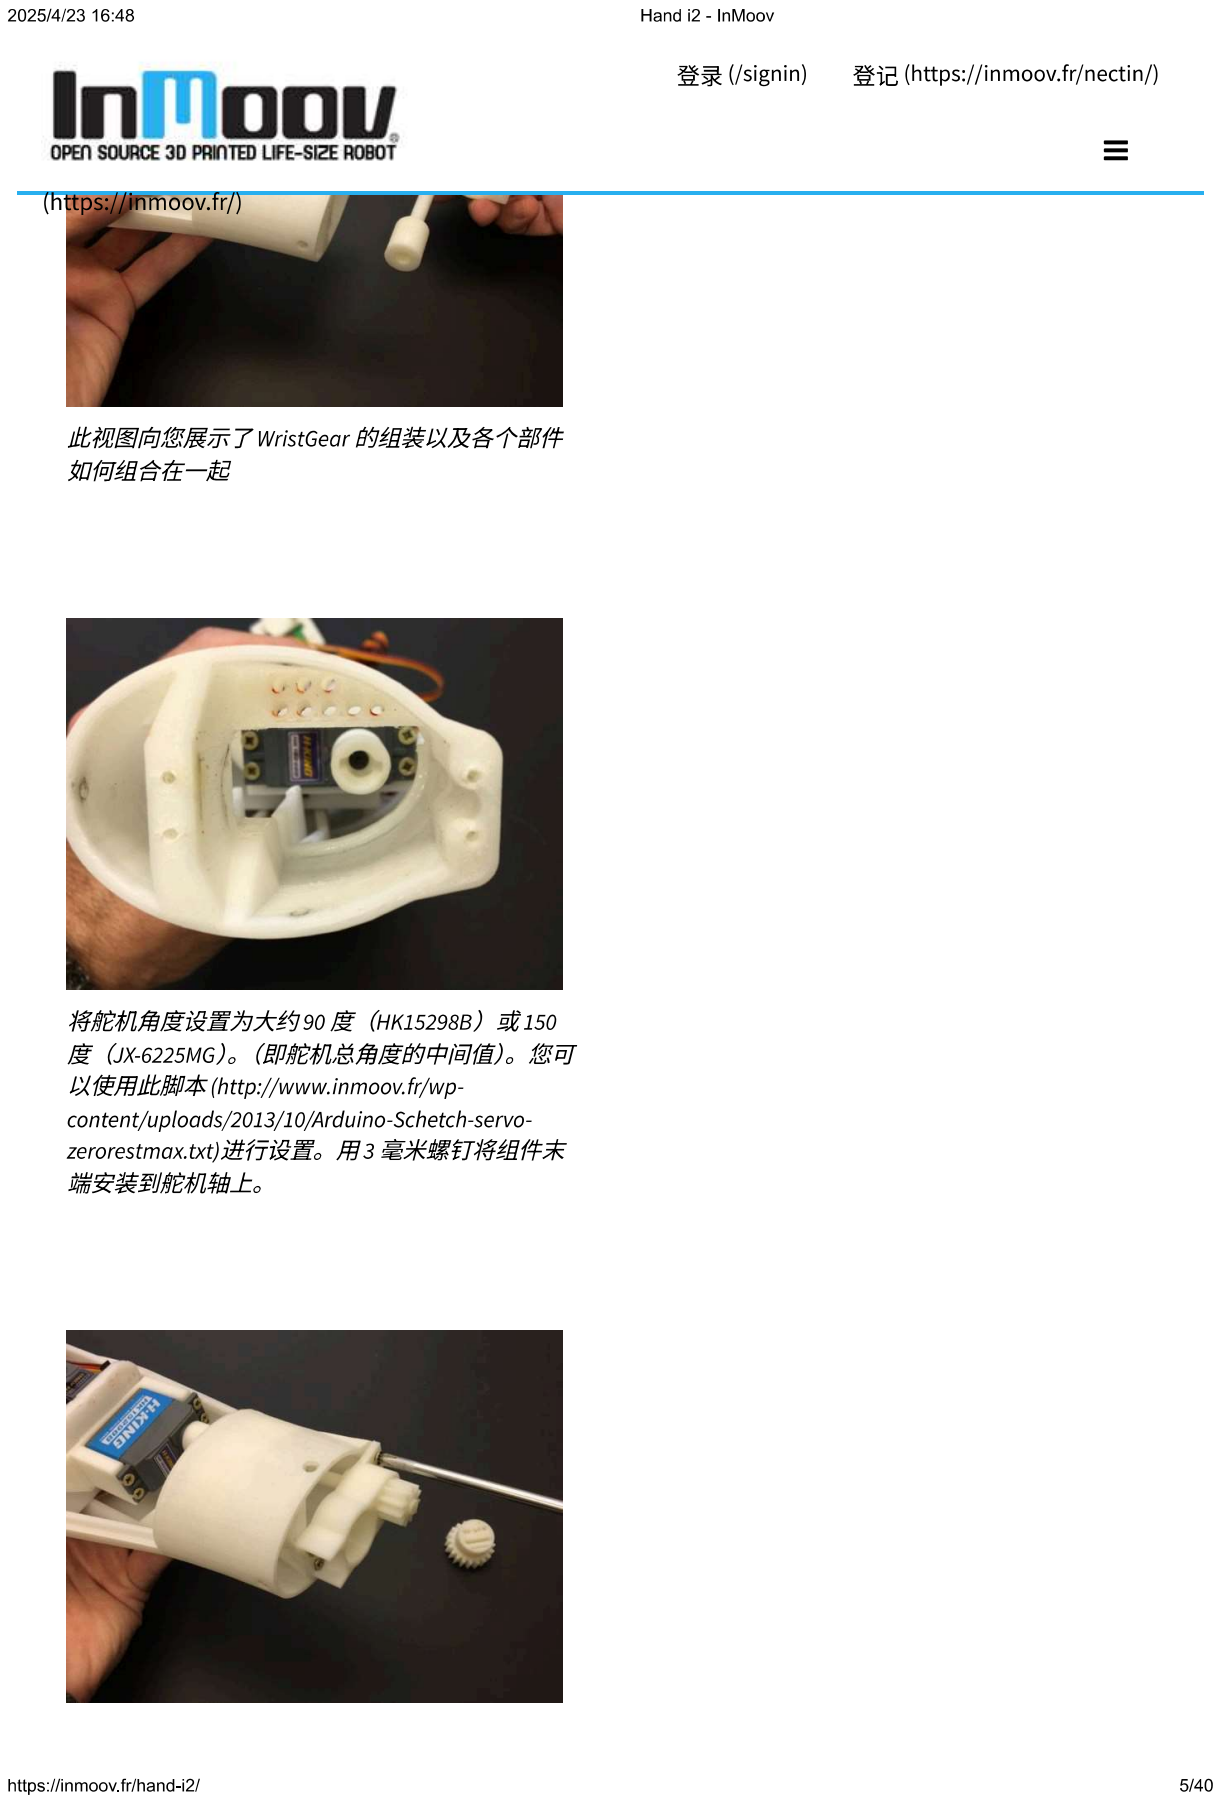
[picture p342: page 5]
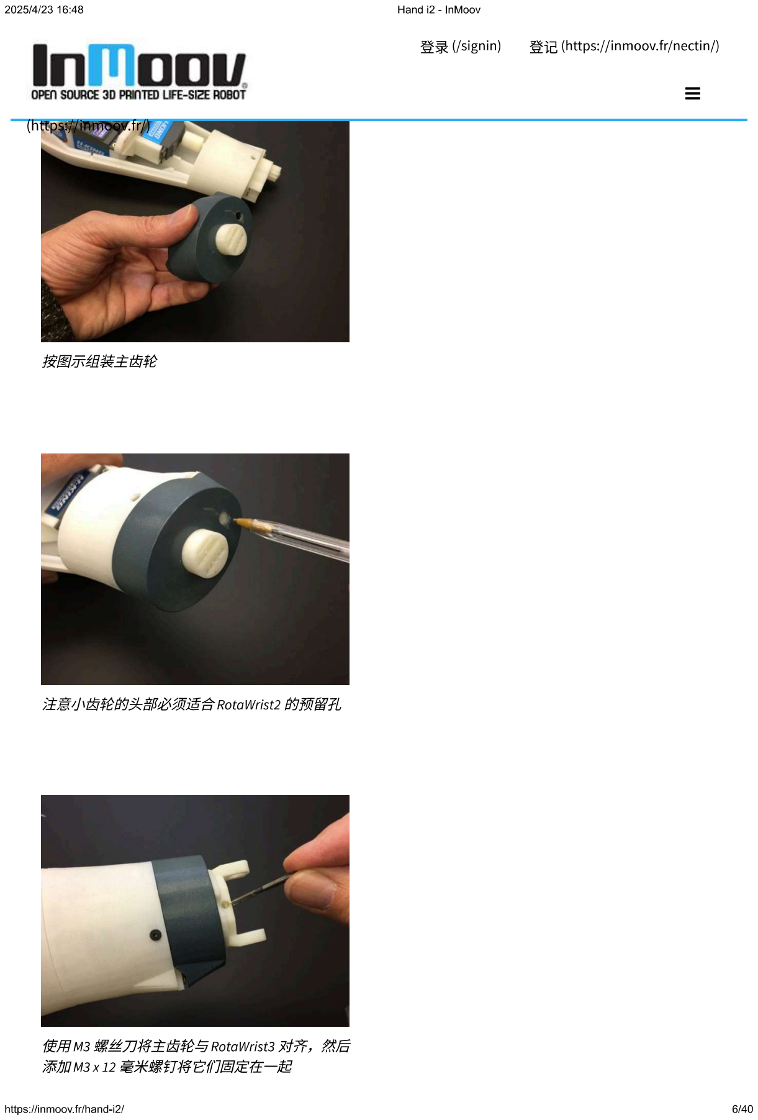
[picture p343: page 6]
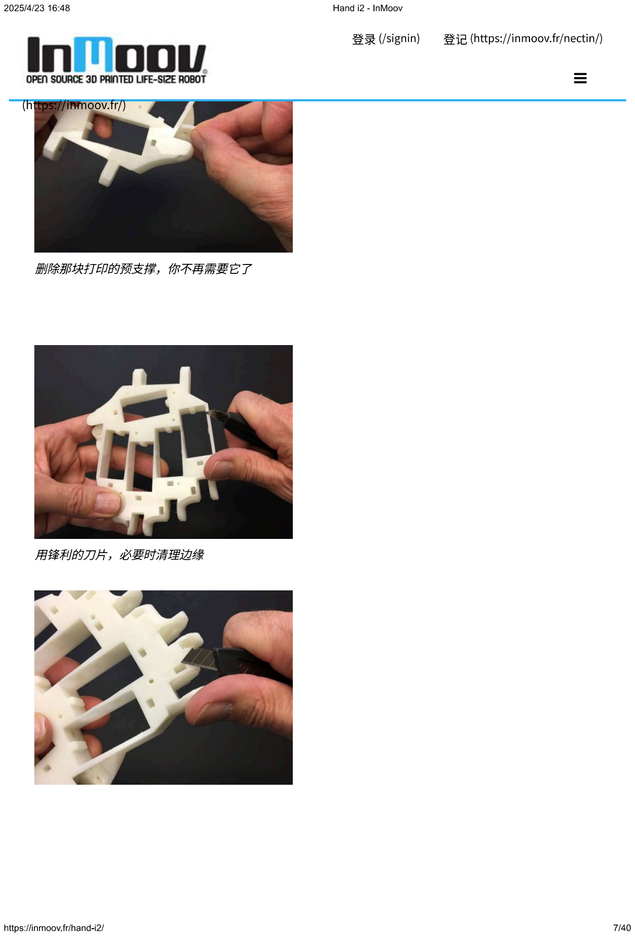
[picture p344: page 7]
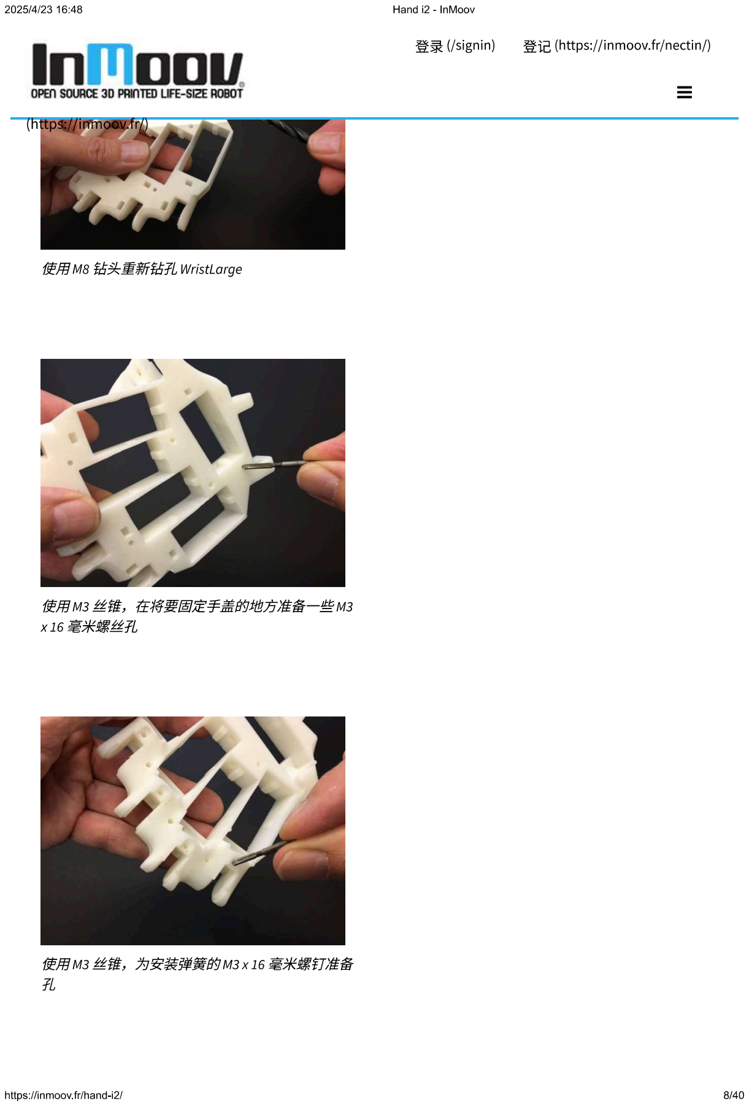
[picture p345: page 8]
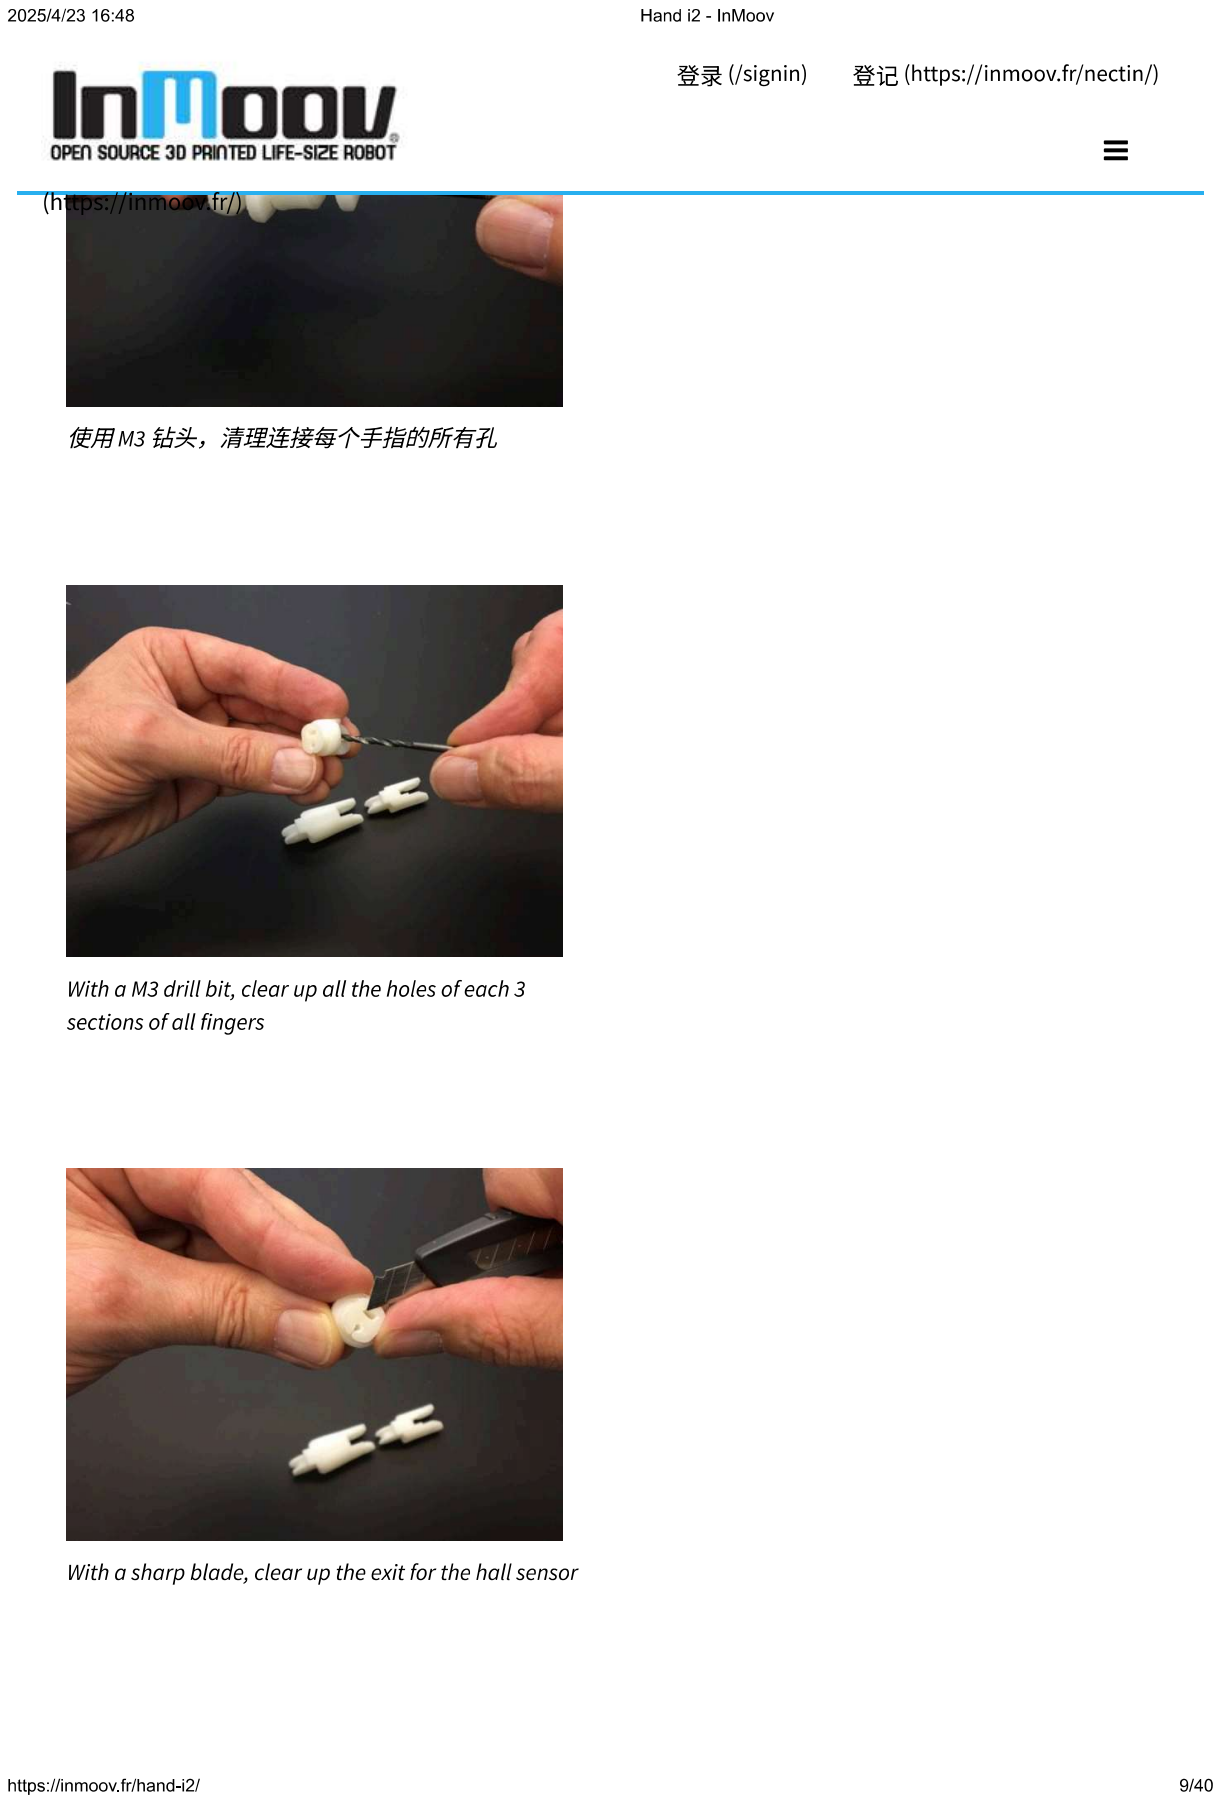
[picture p346: page 9]
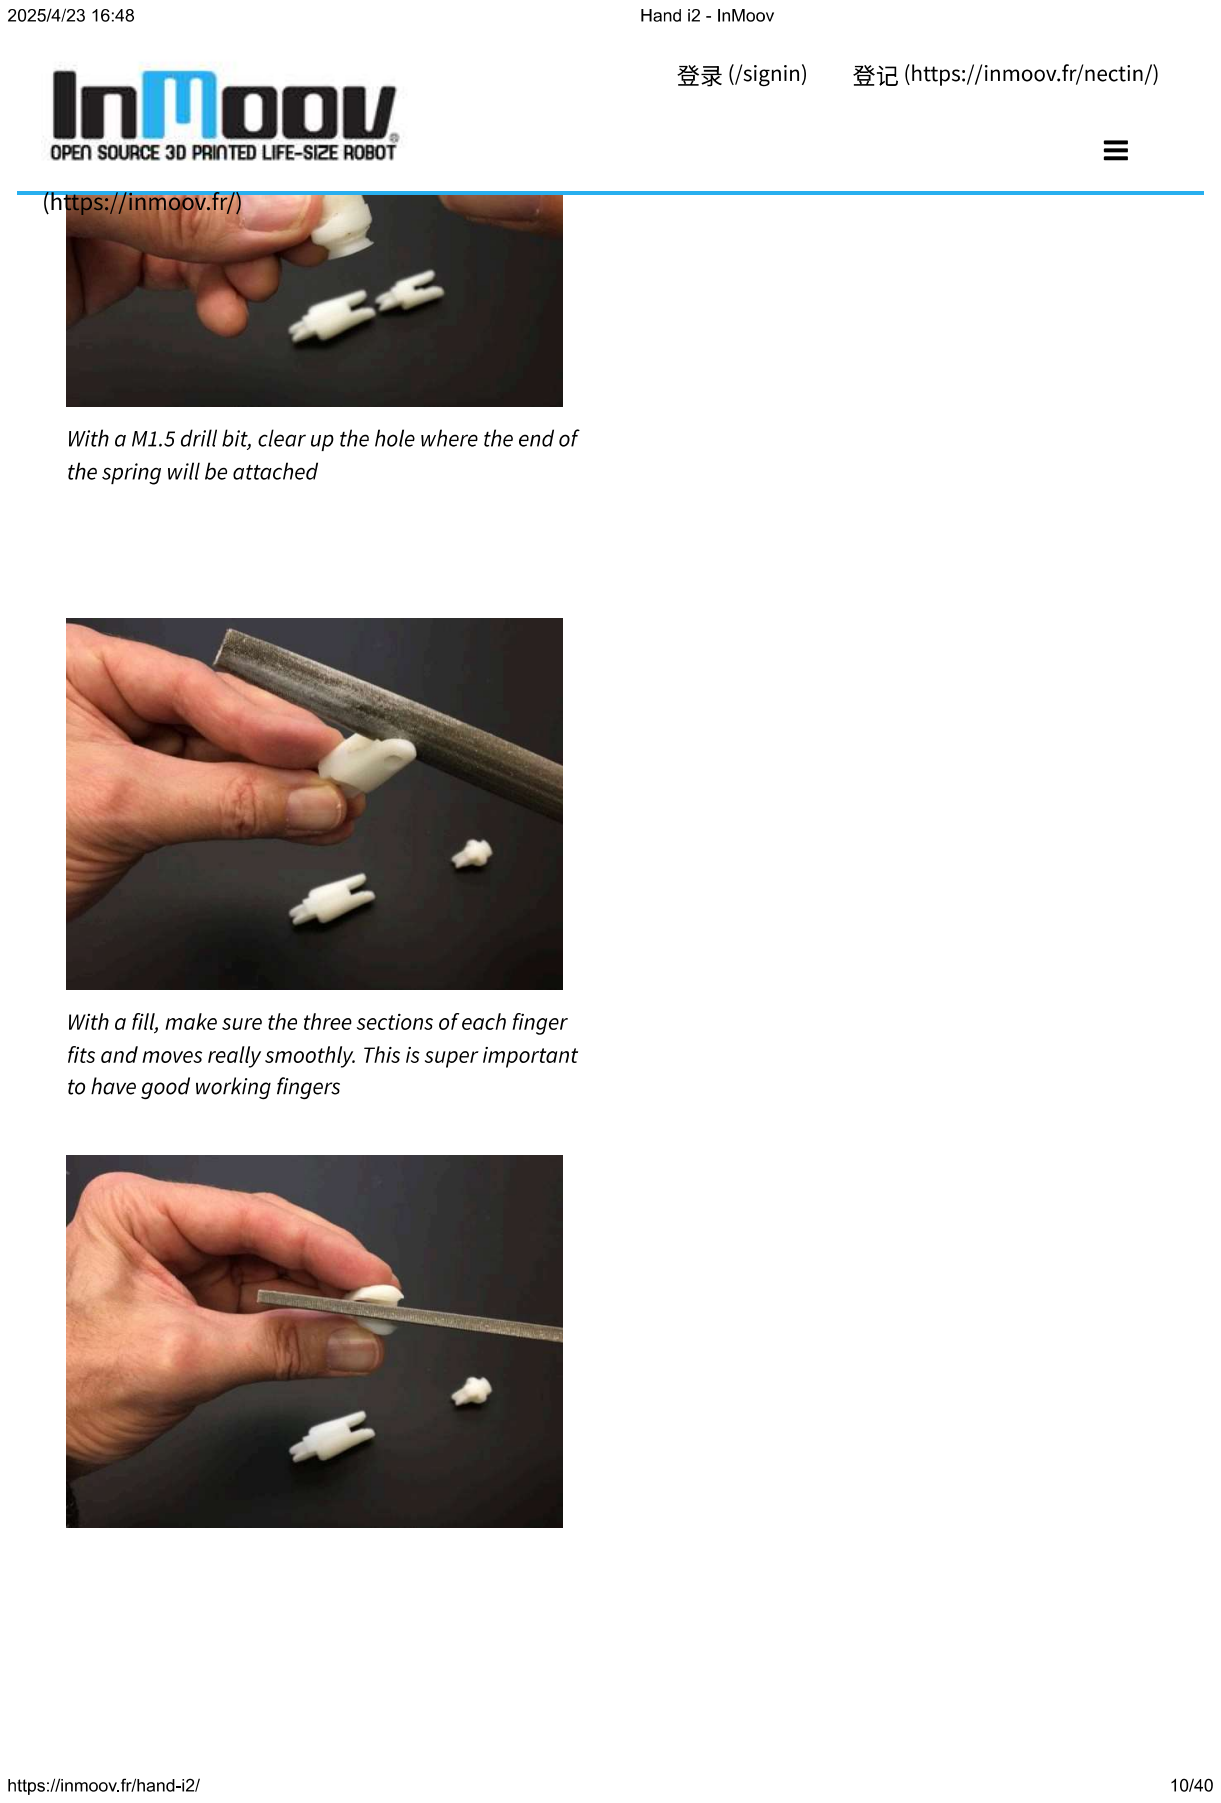
[picture p347: page 10]
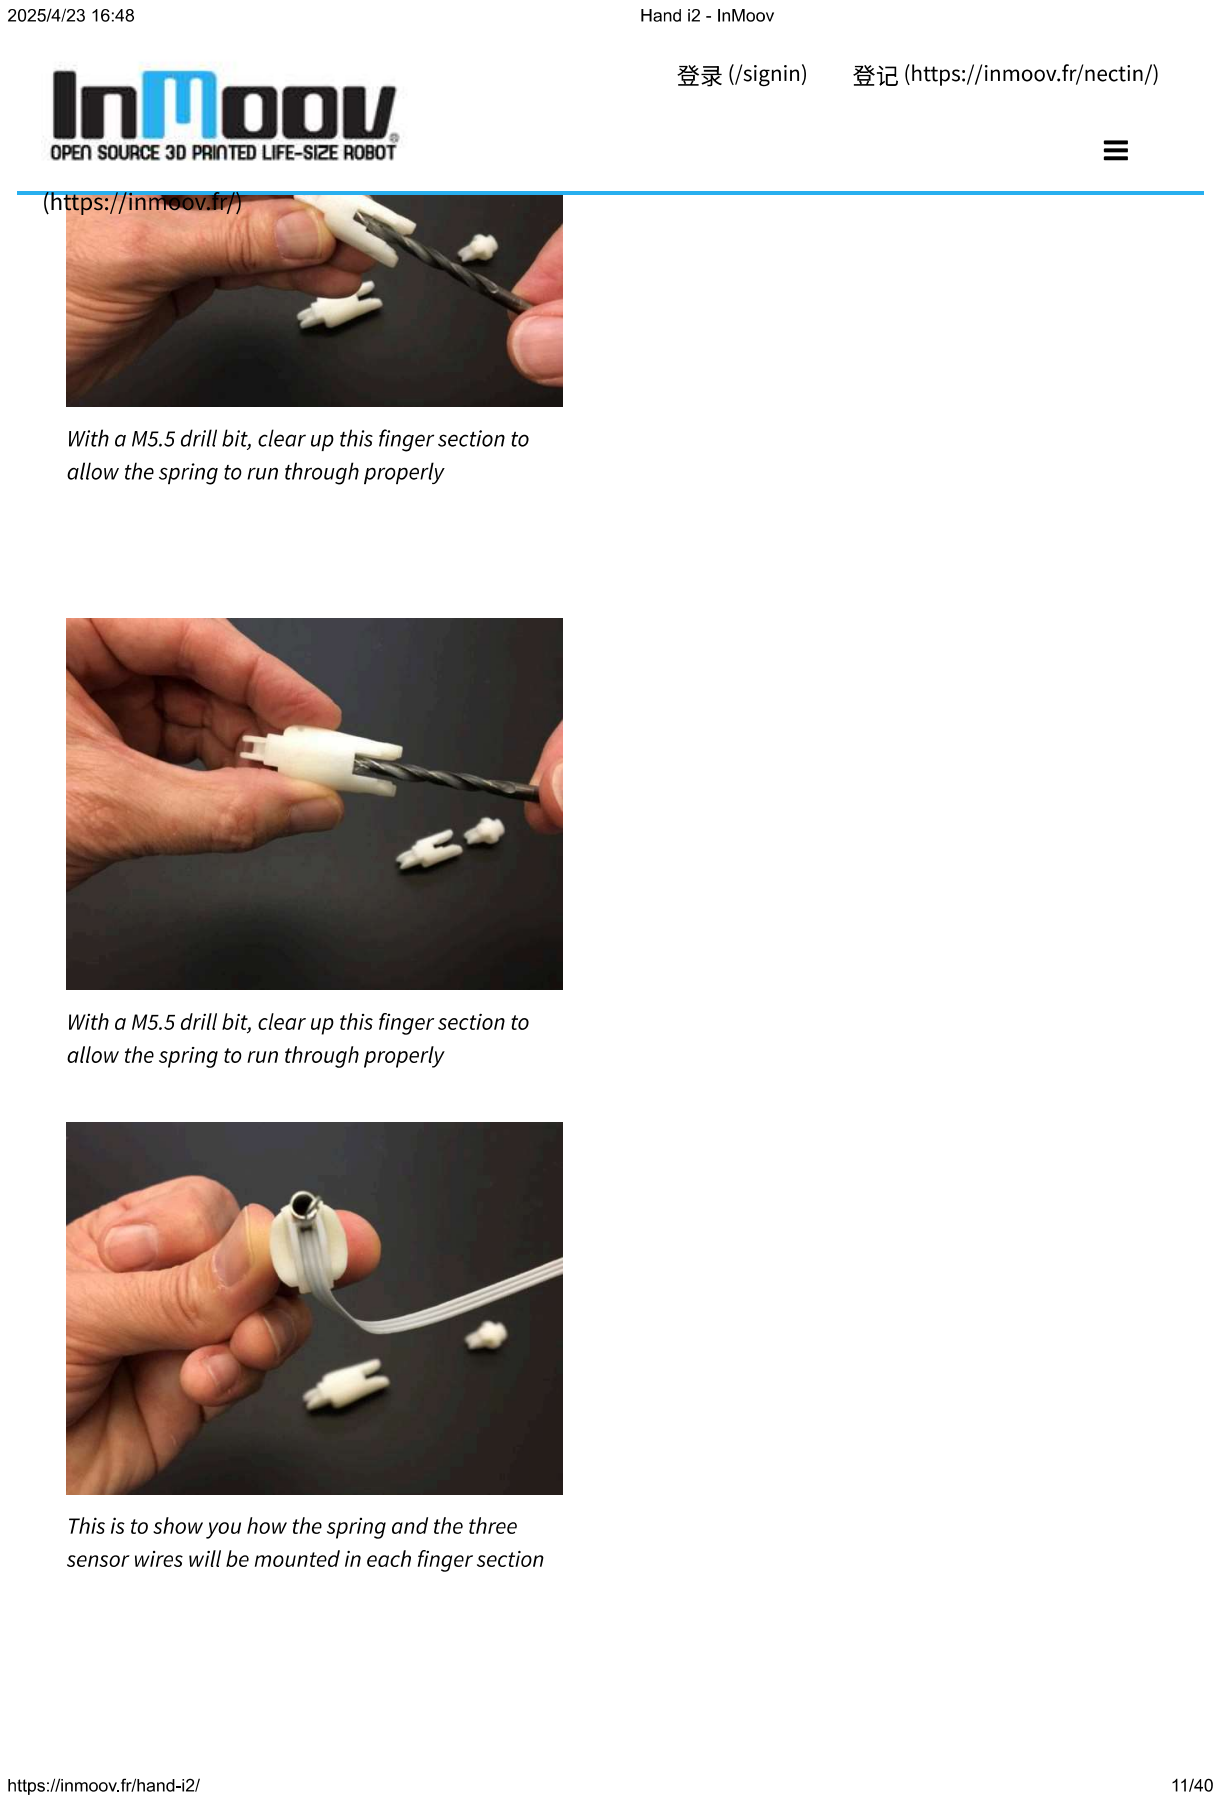
[picture p348: page 11]
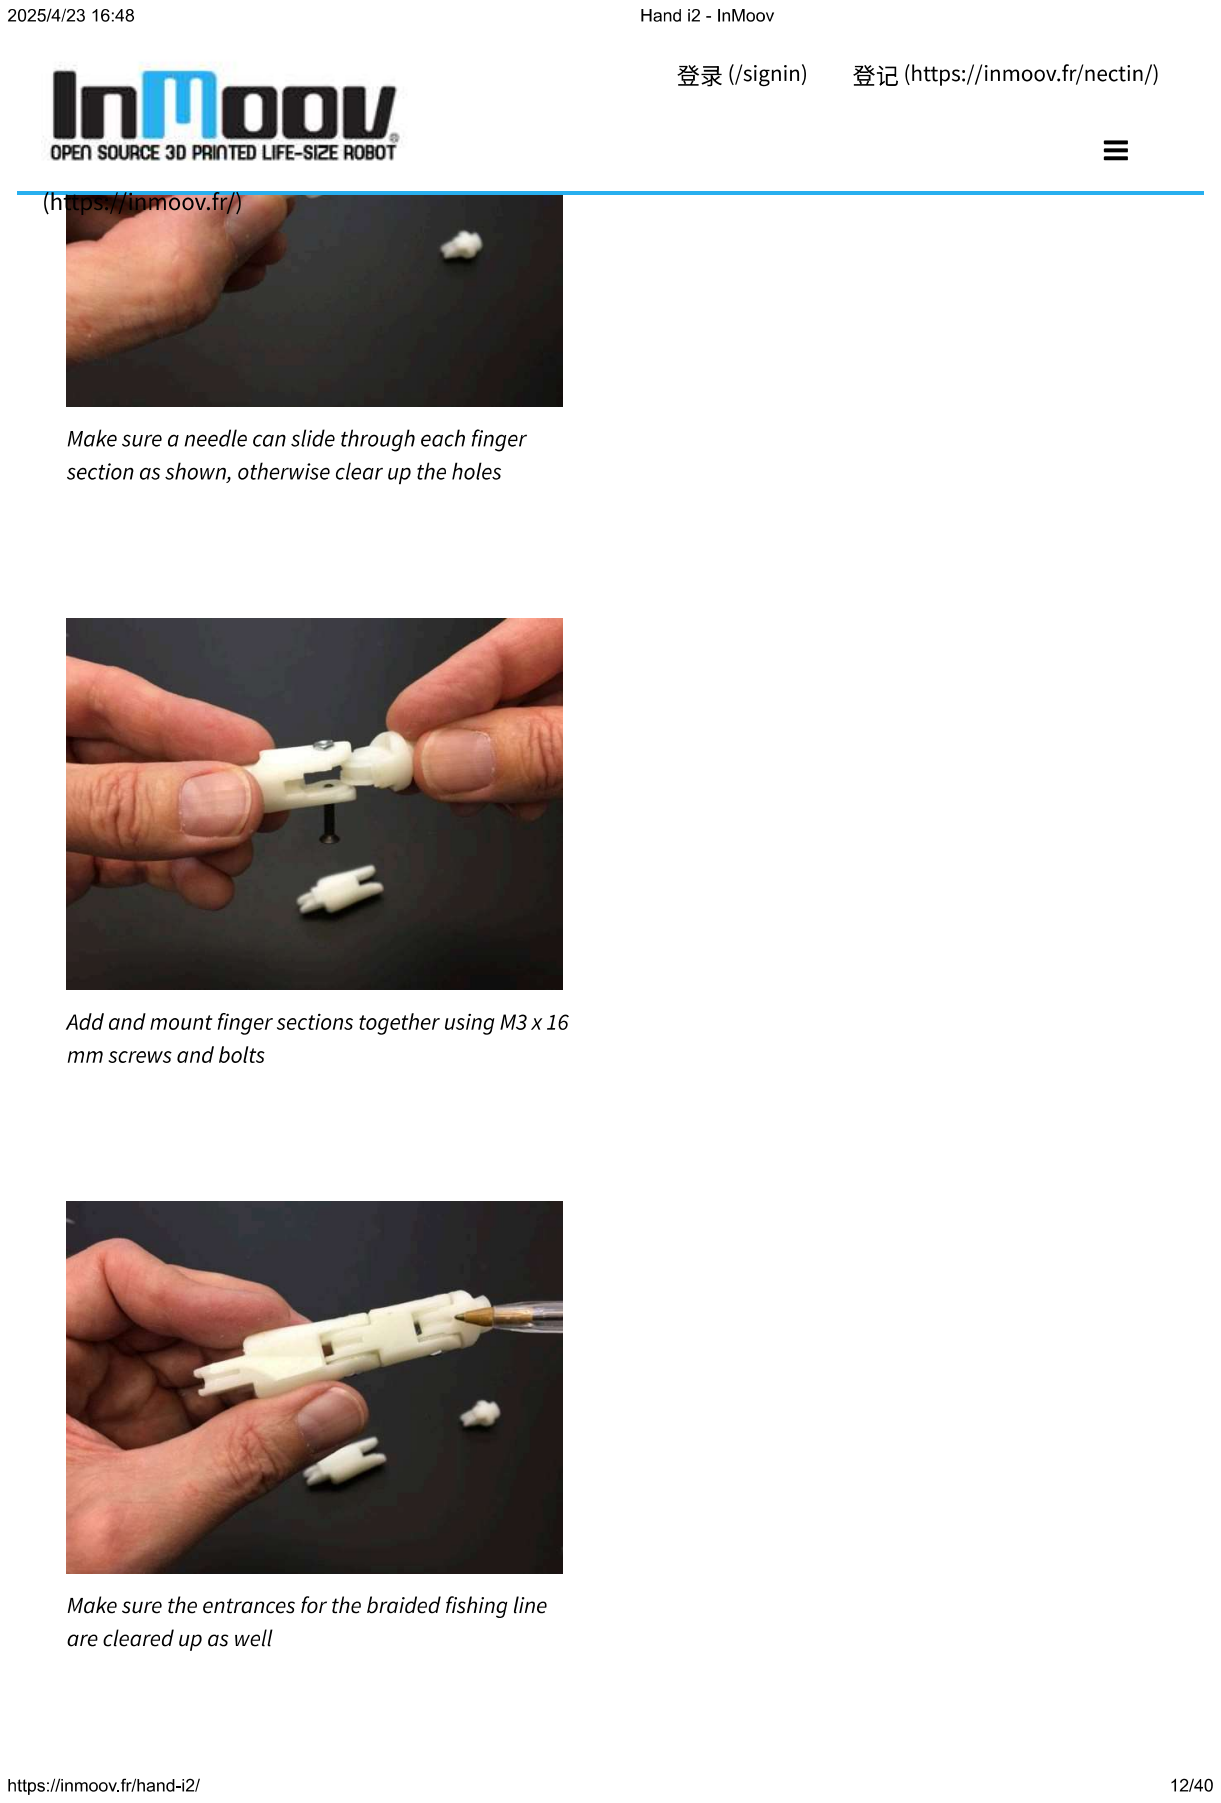
[picture p349: page 12]
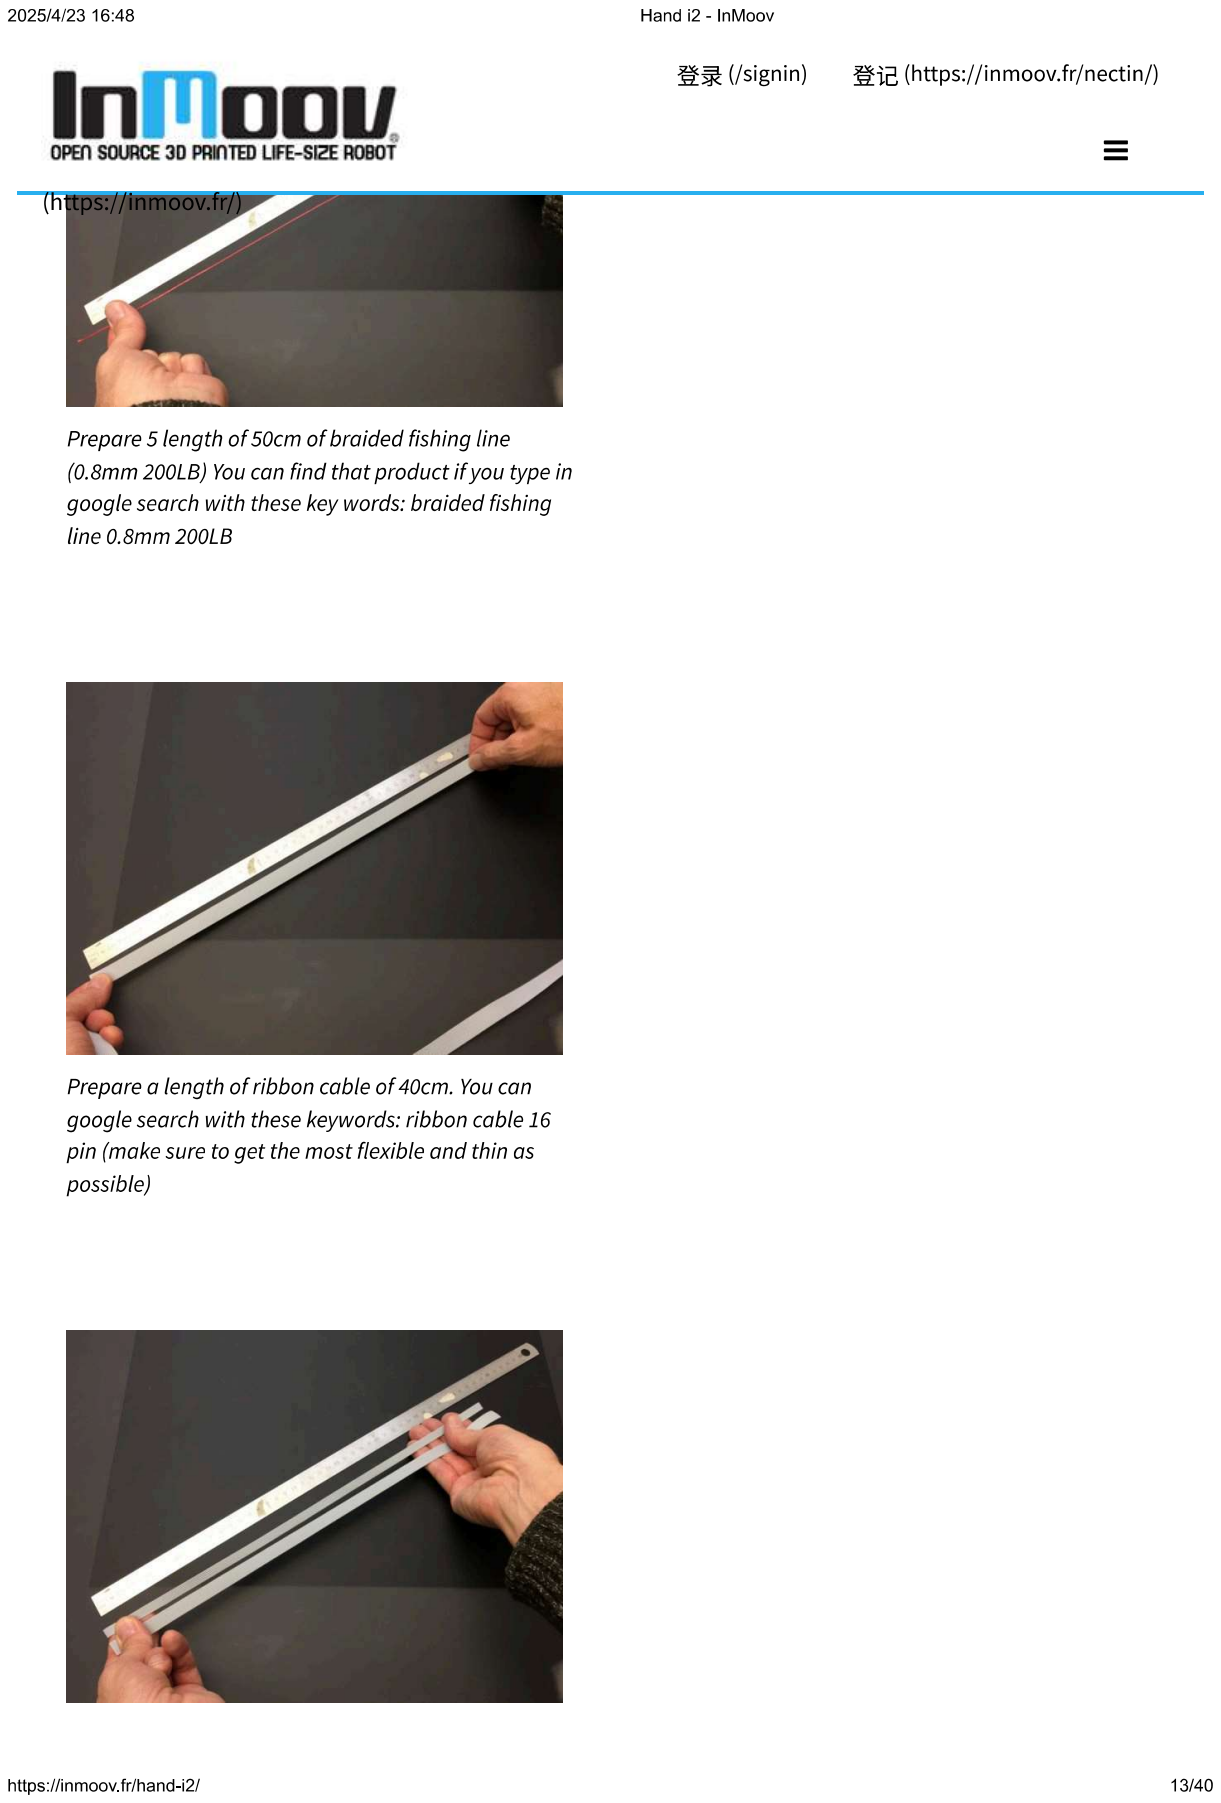
[picture p350: page 13]
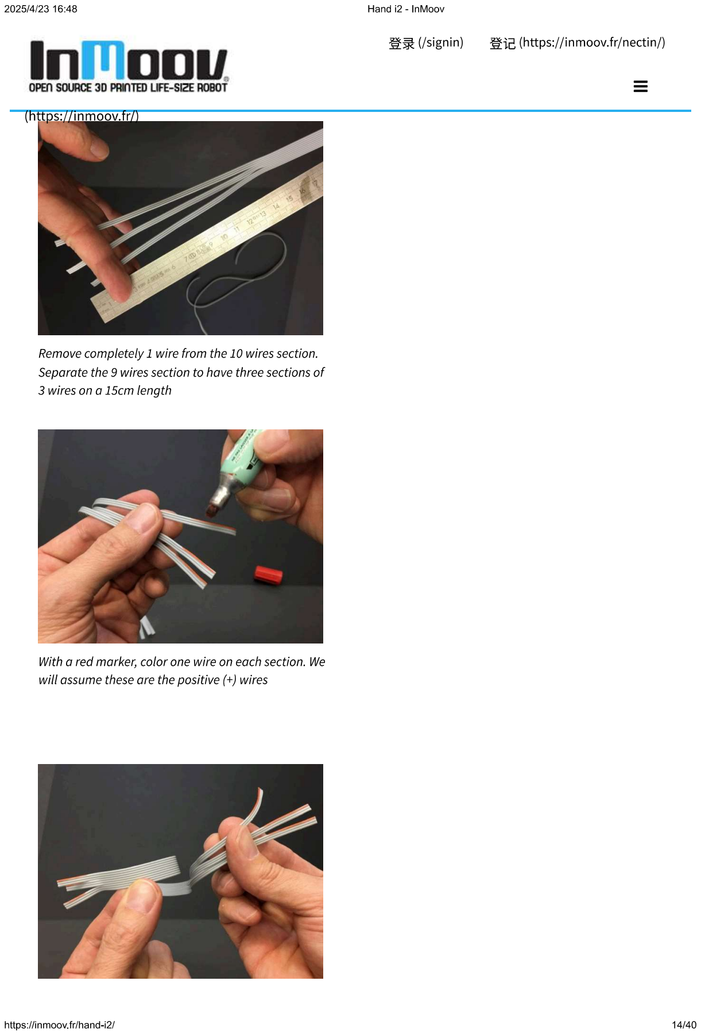
[picture p351: page 14]
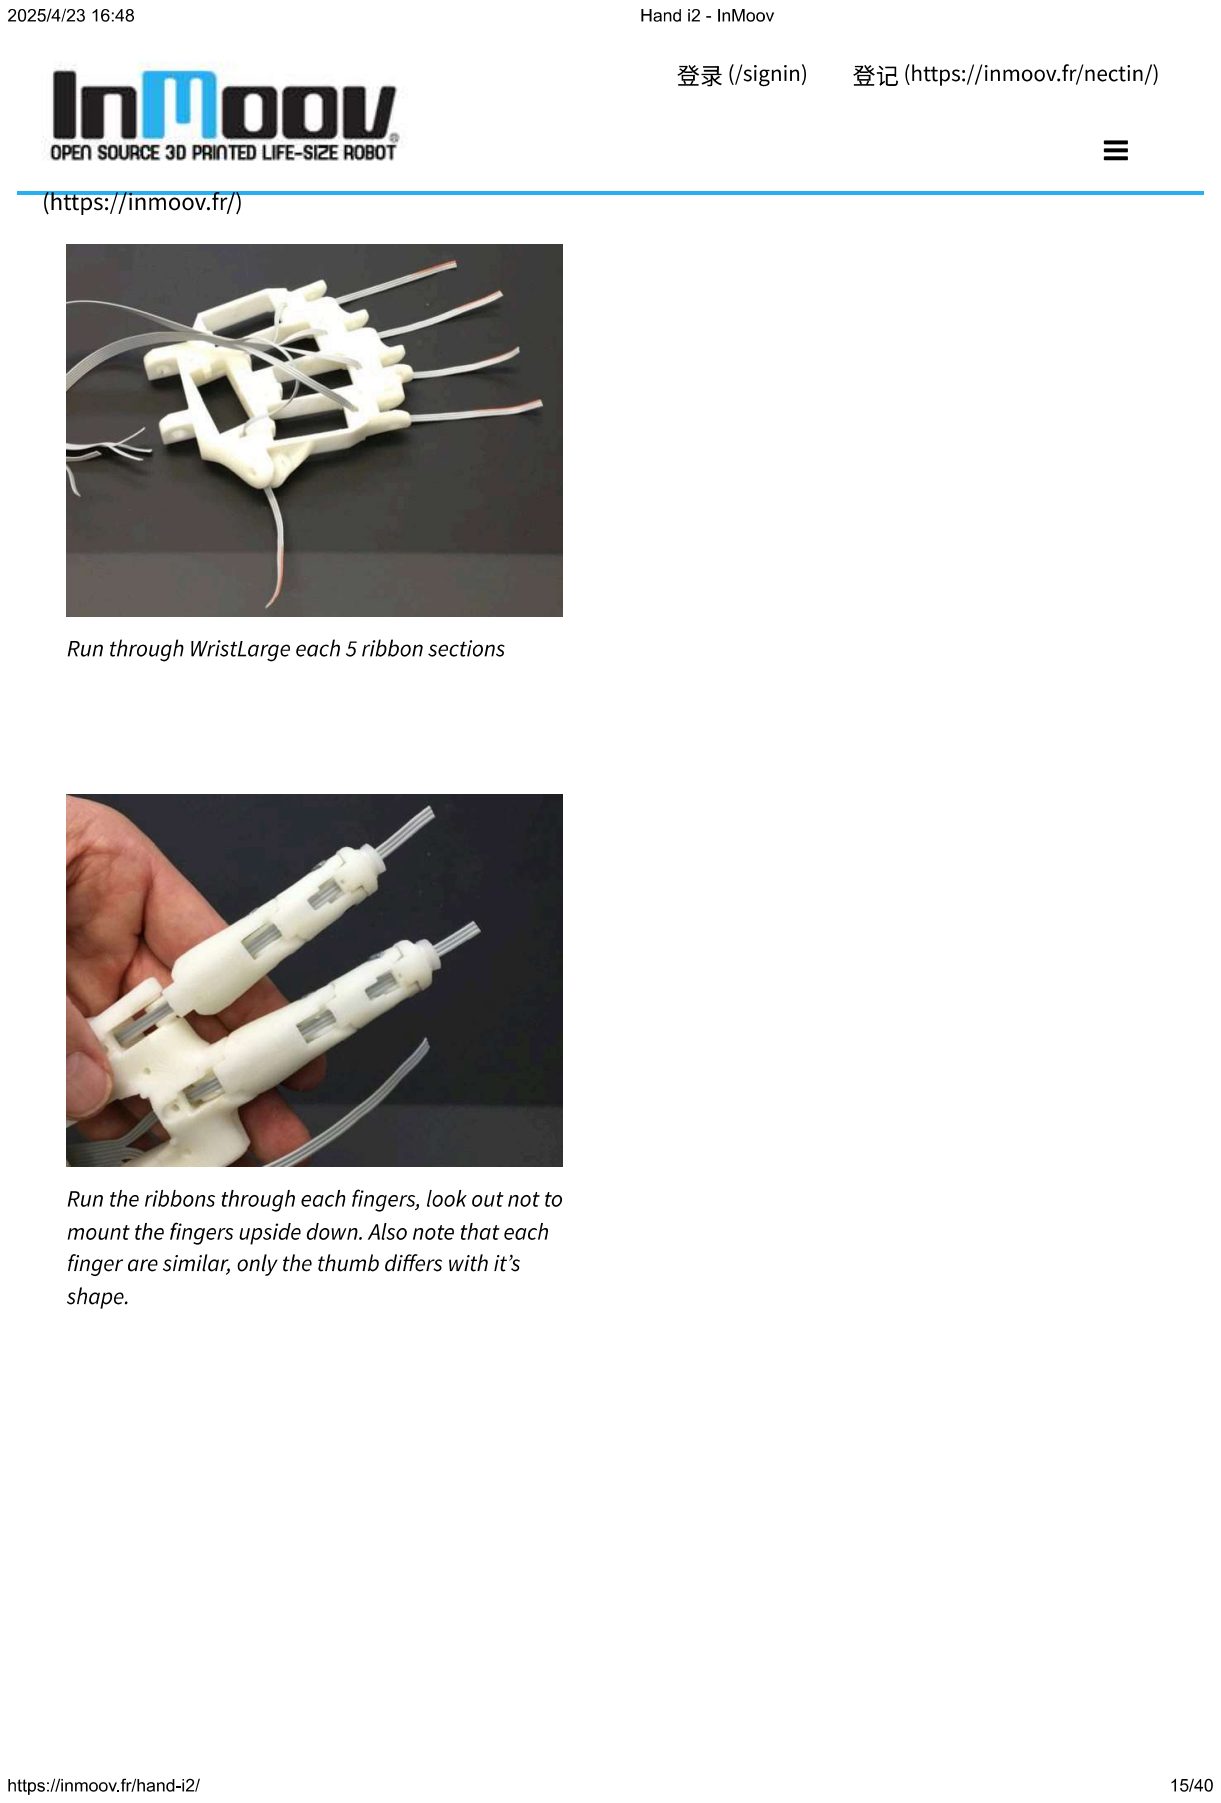
[picture p352: page 15]
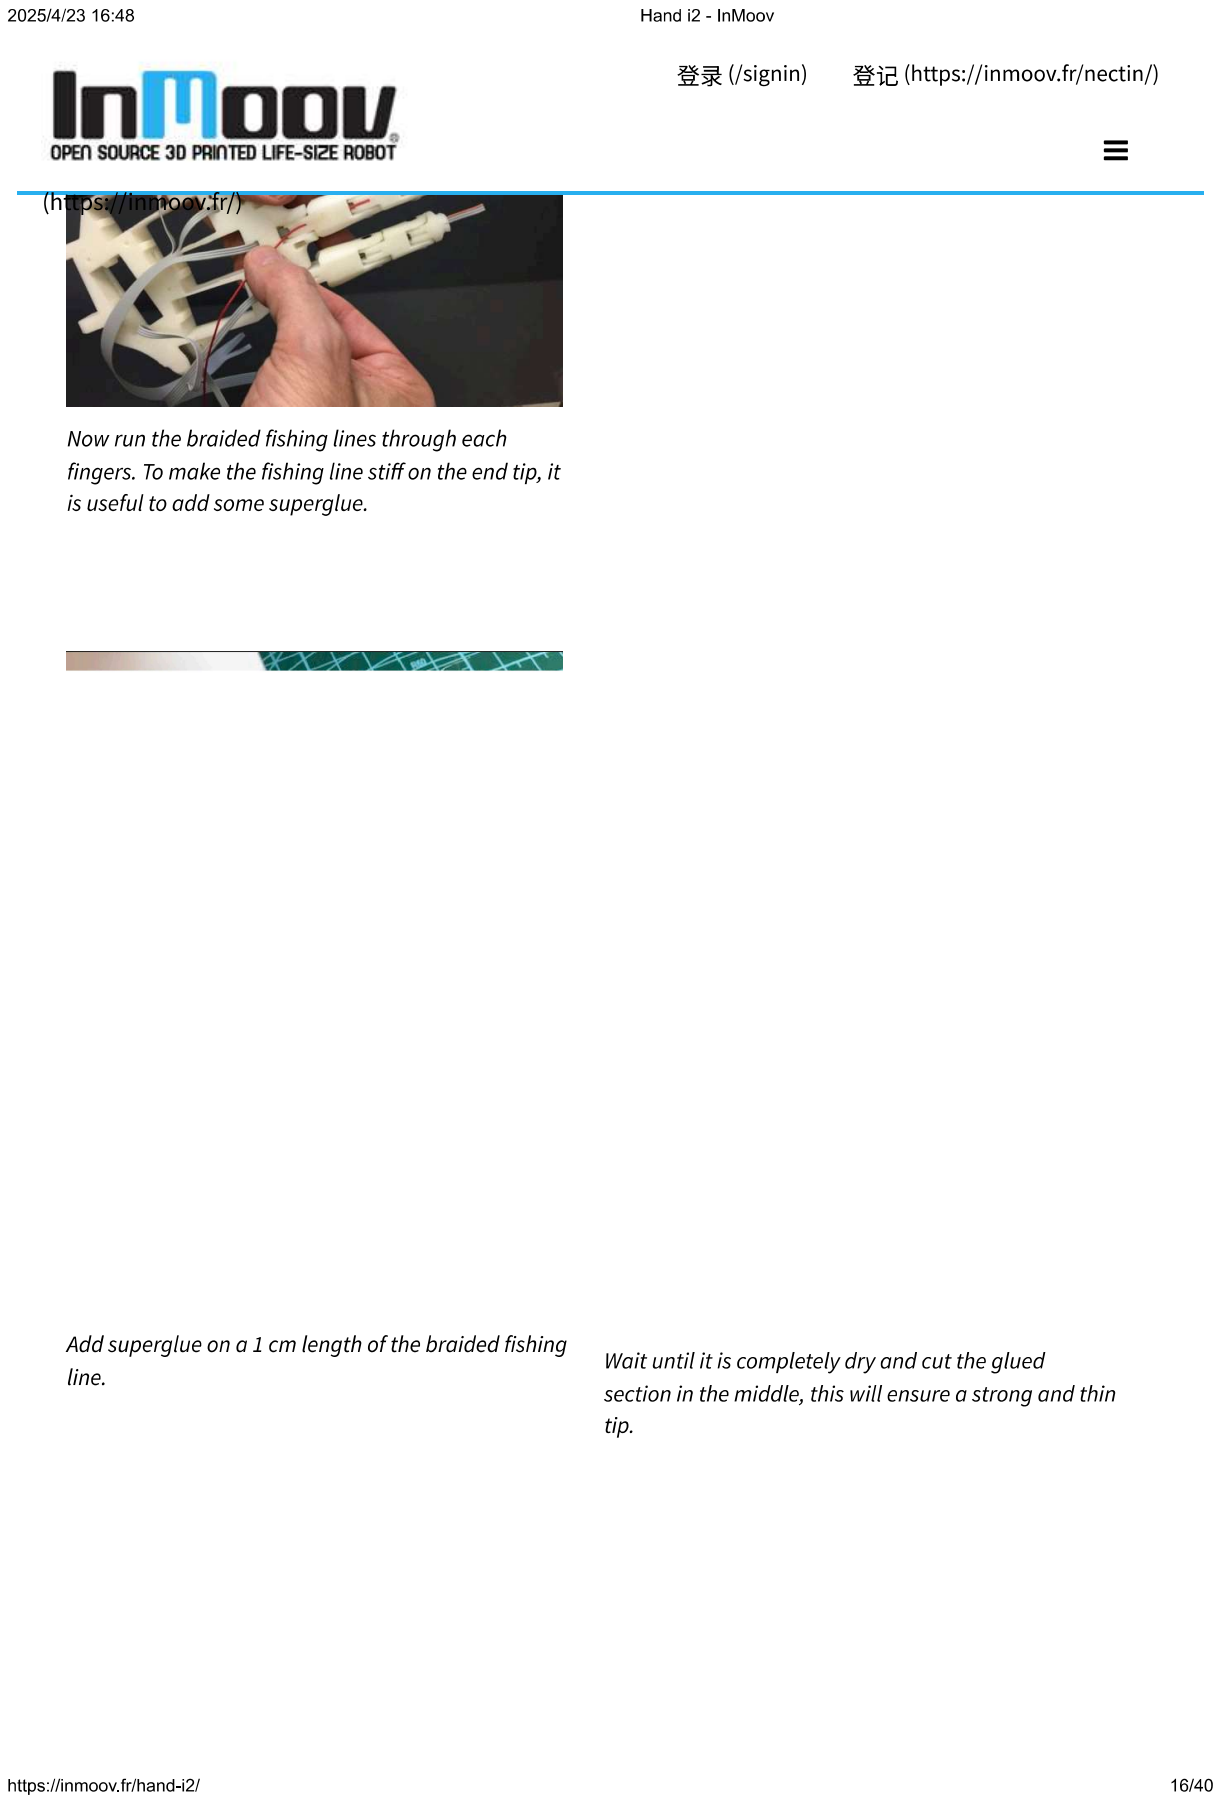
[picture p353: page 16]
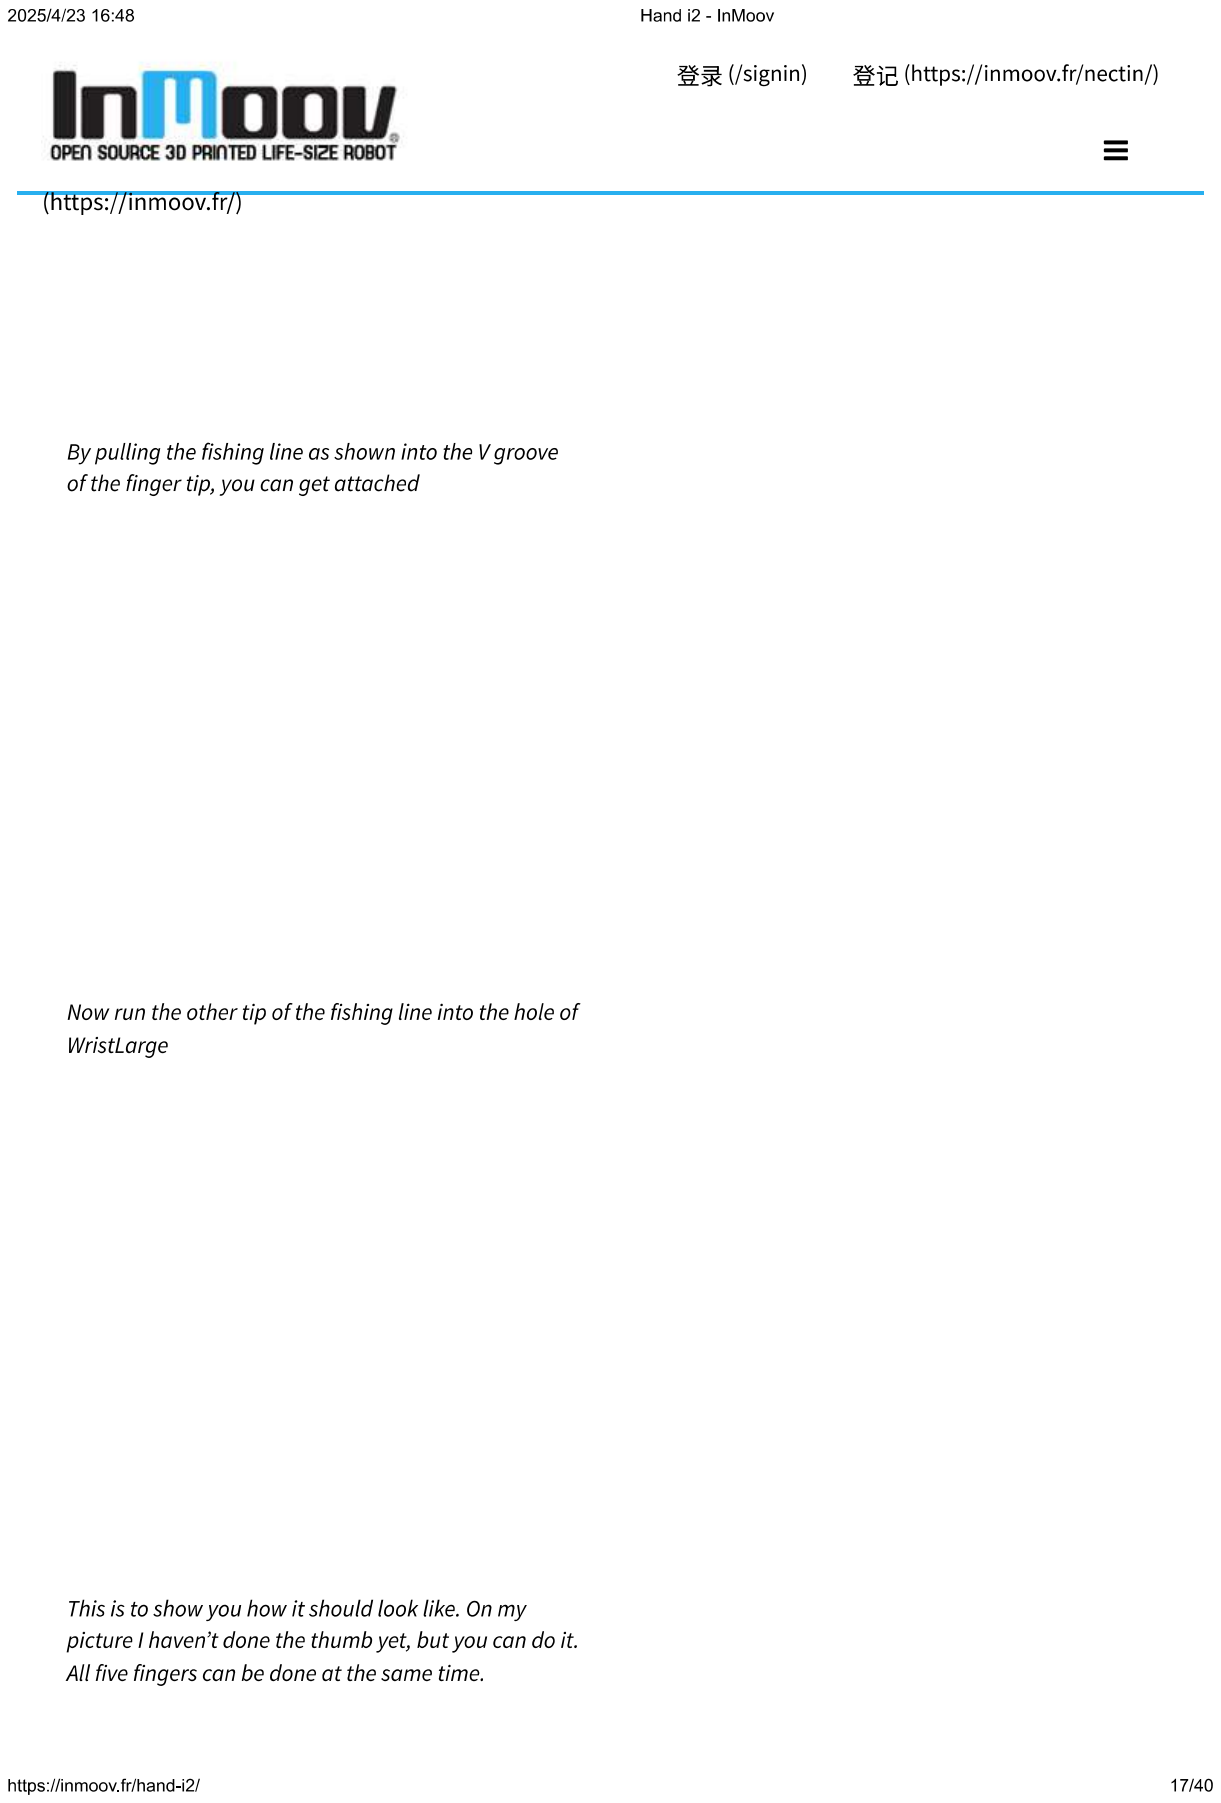
[picture p354: page 17]
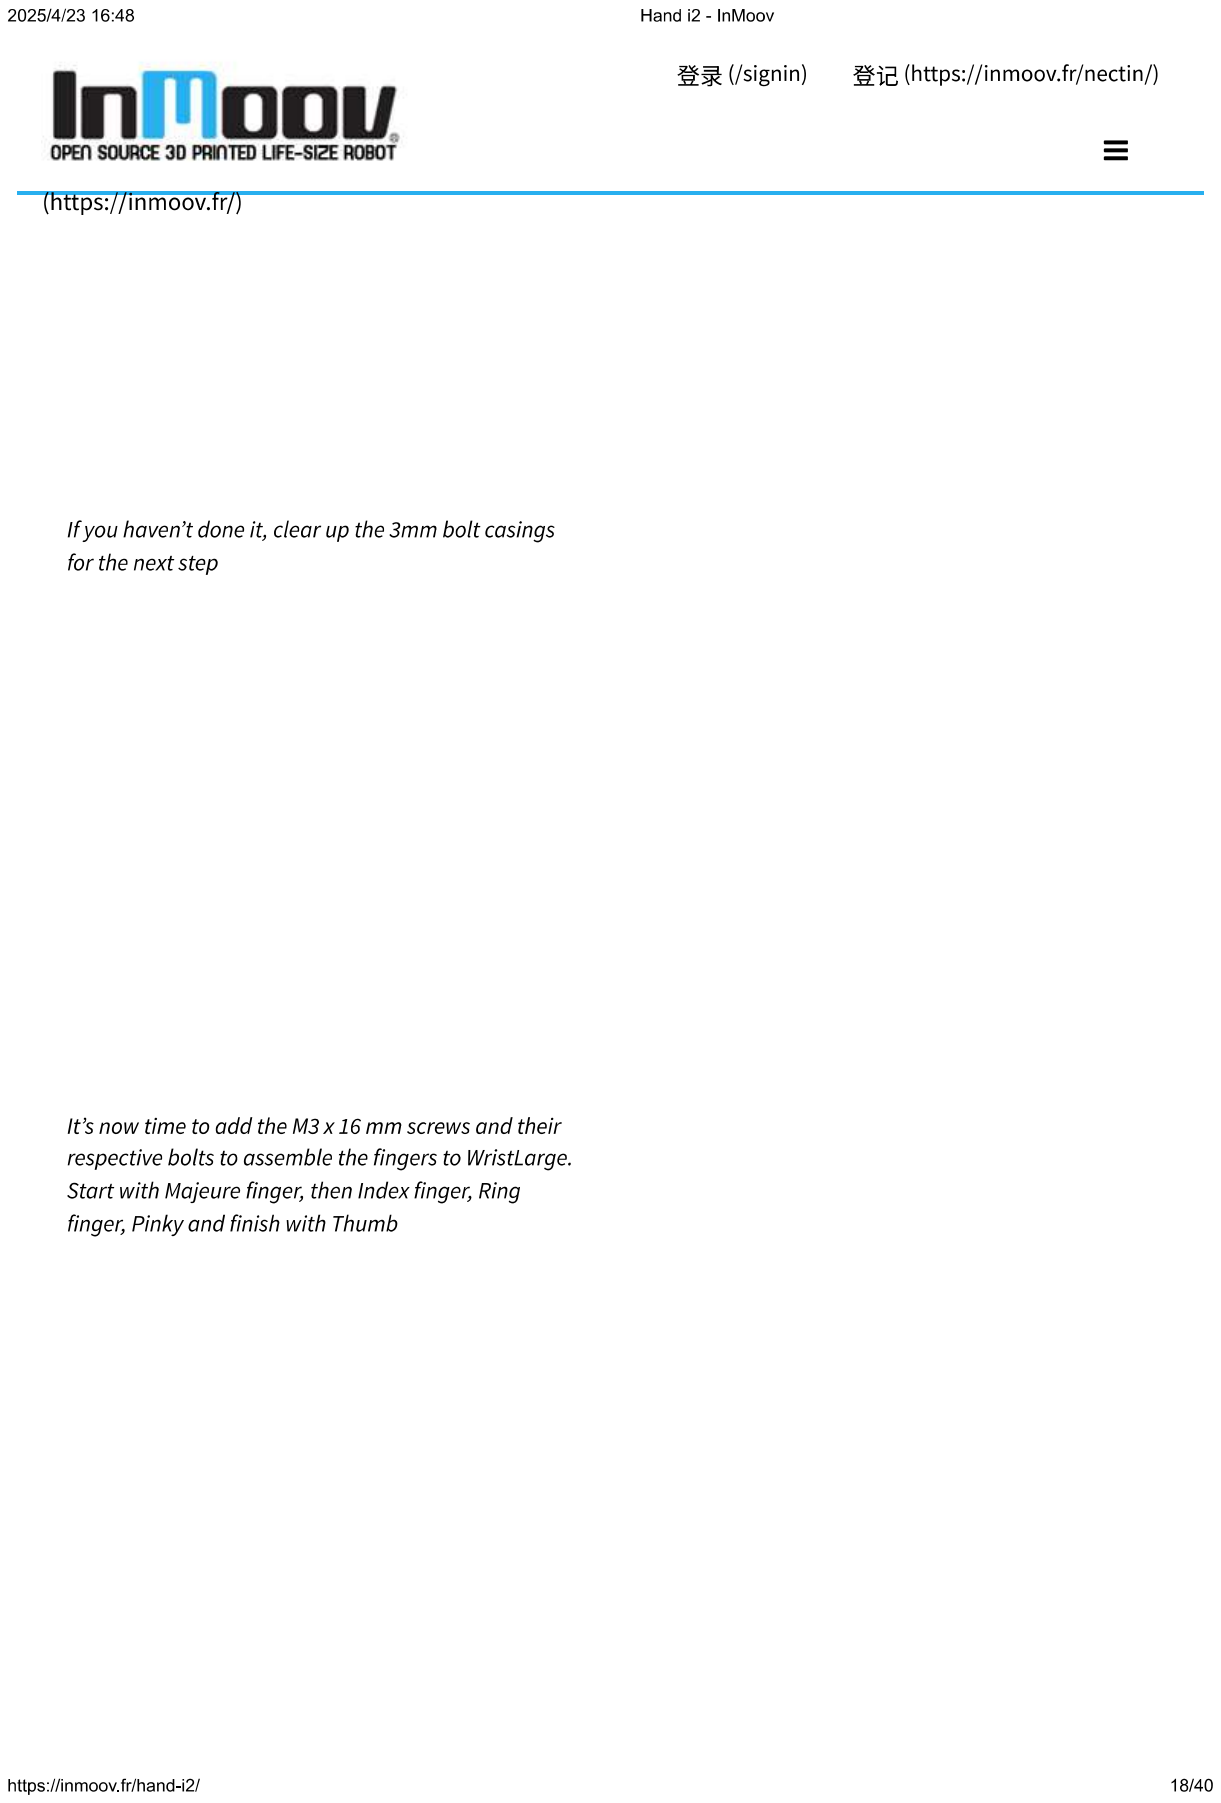
[picture p355: page 18]
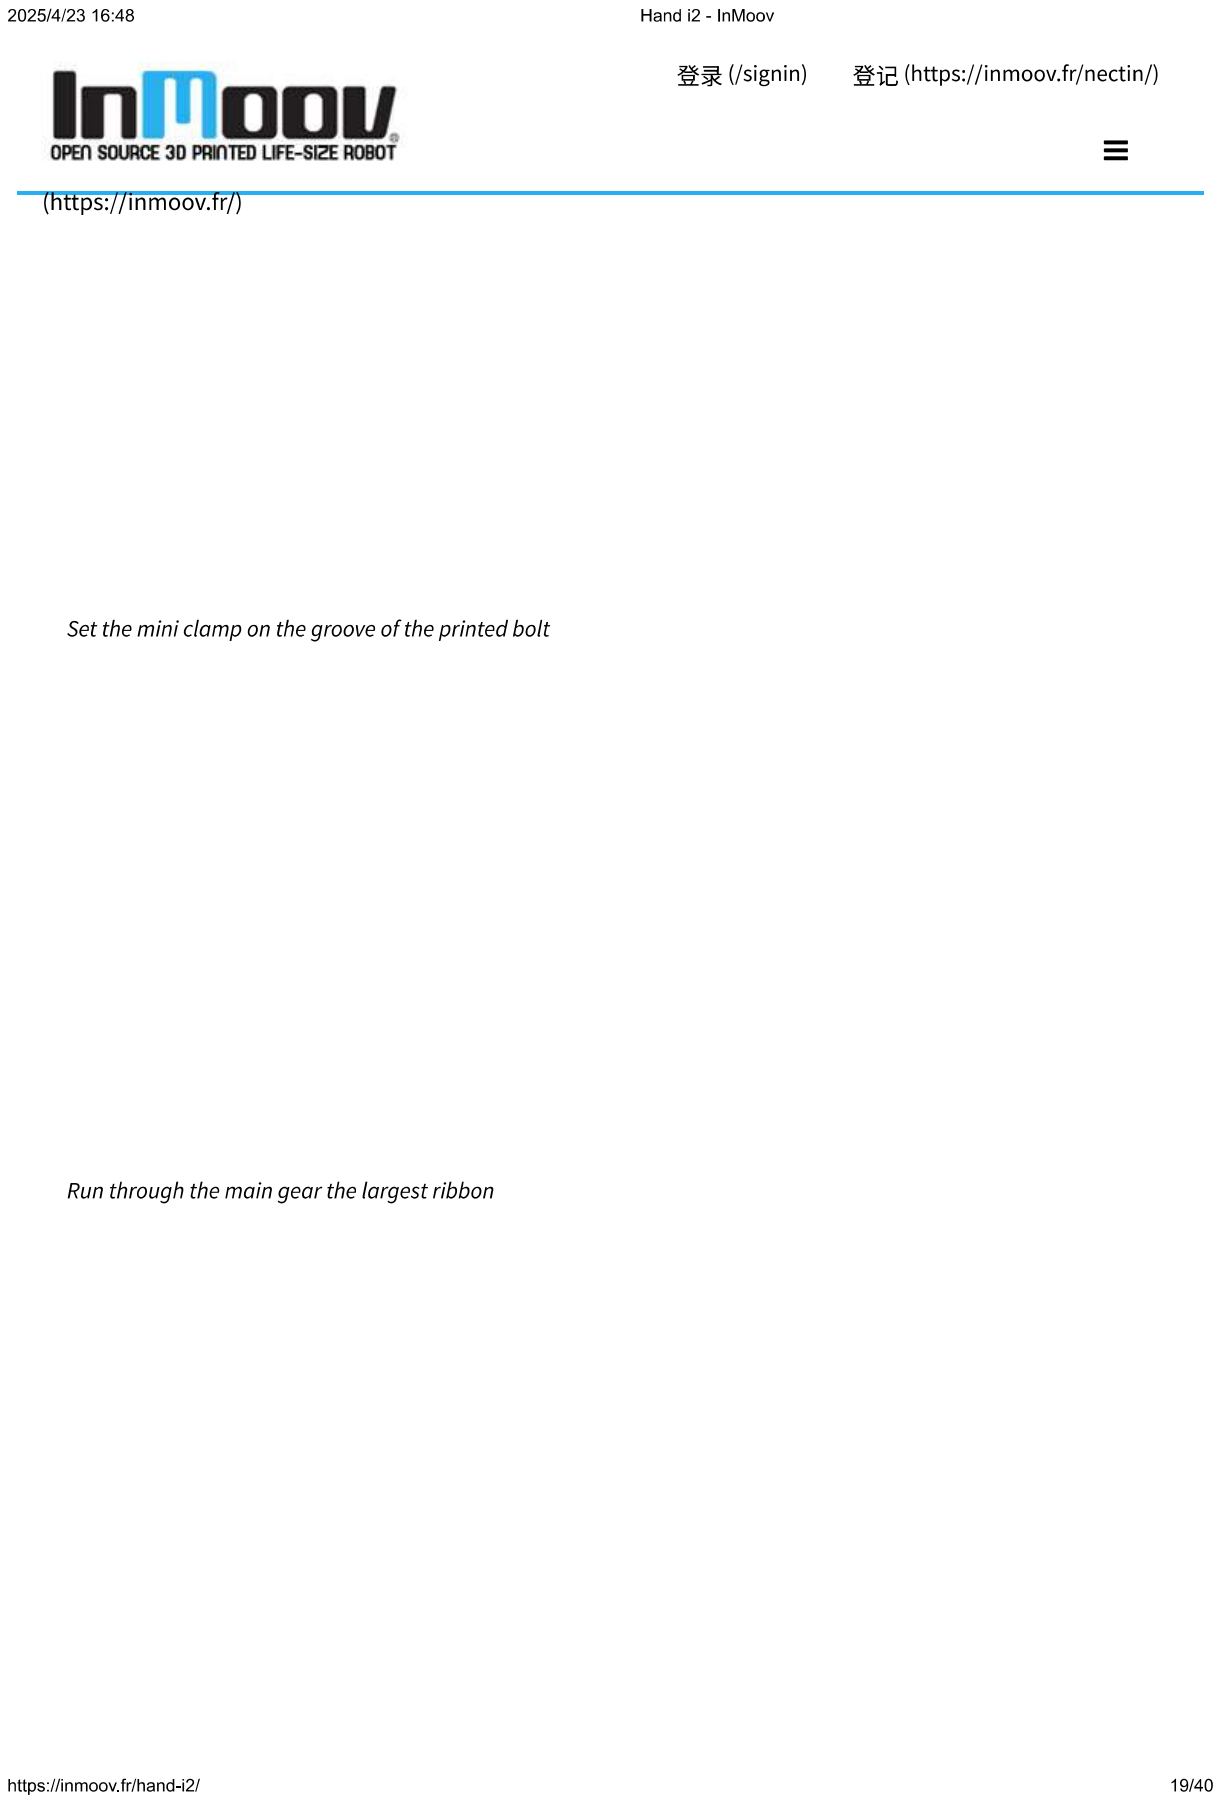
[picture p356: page 19]
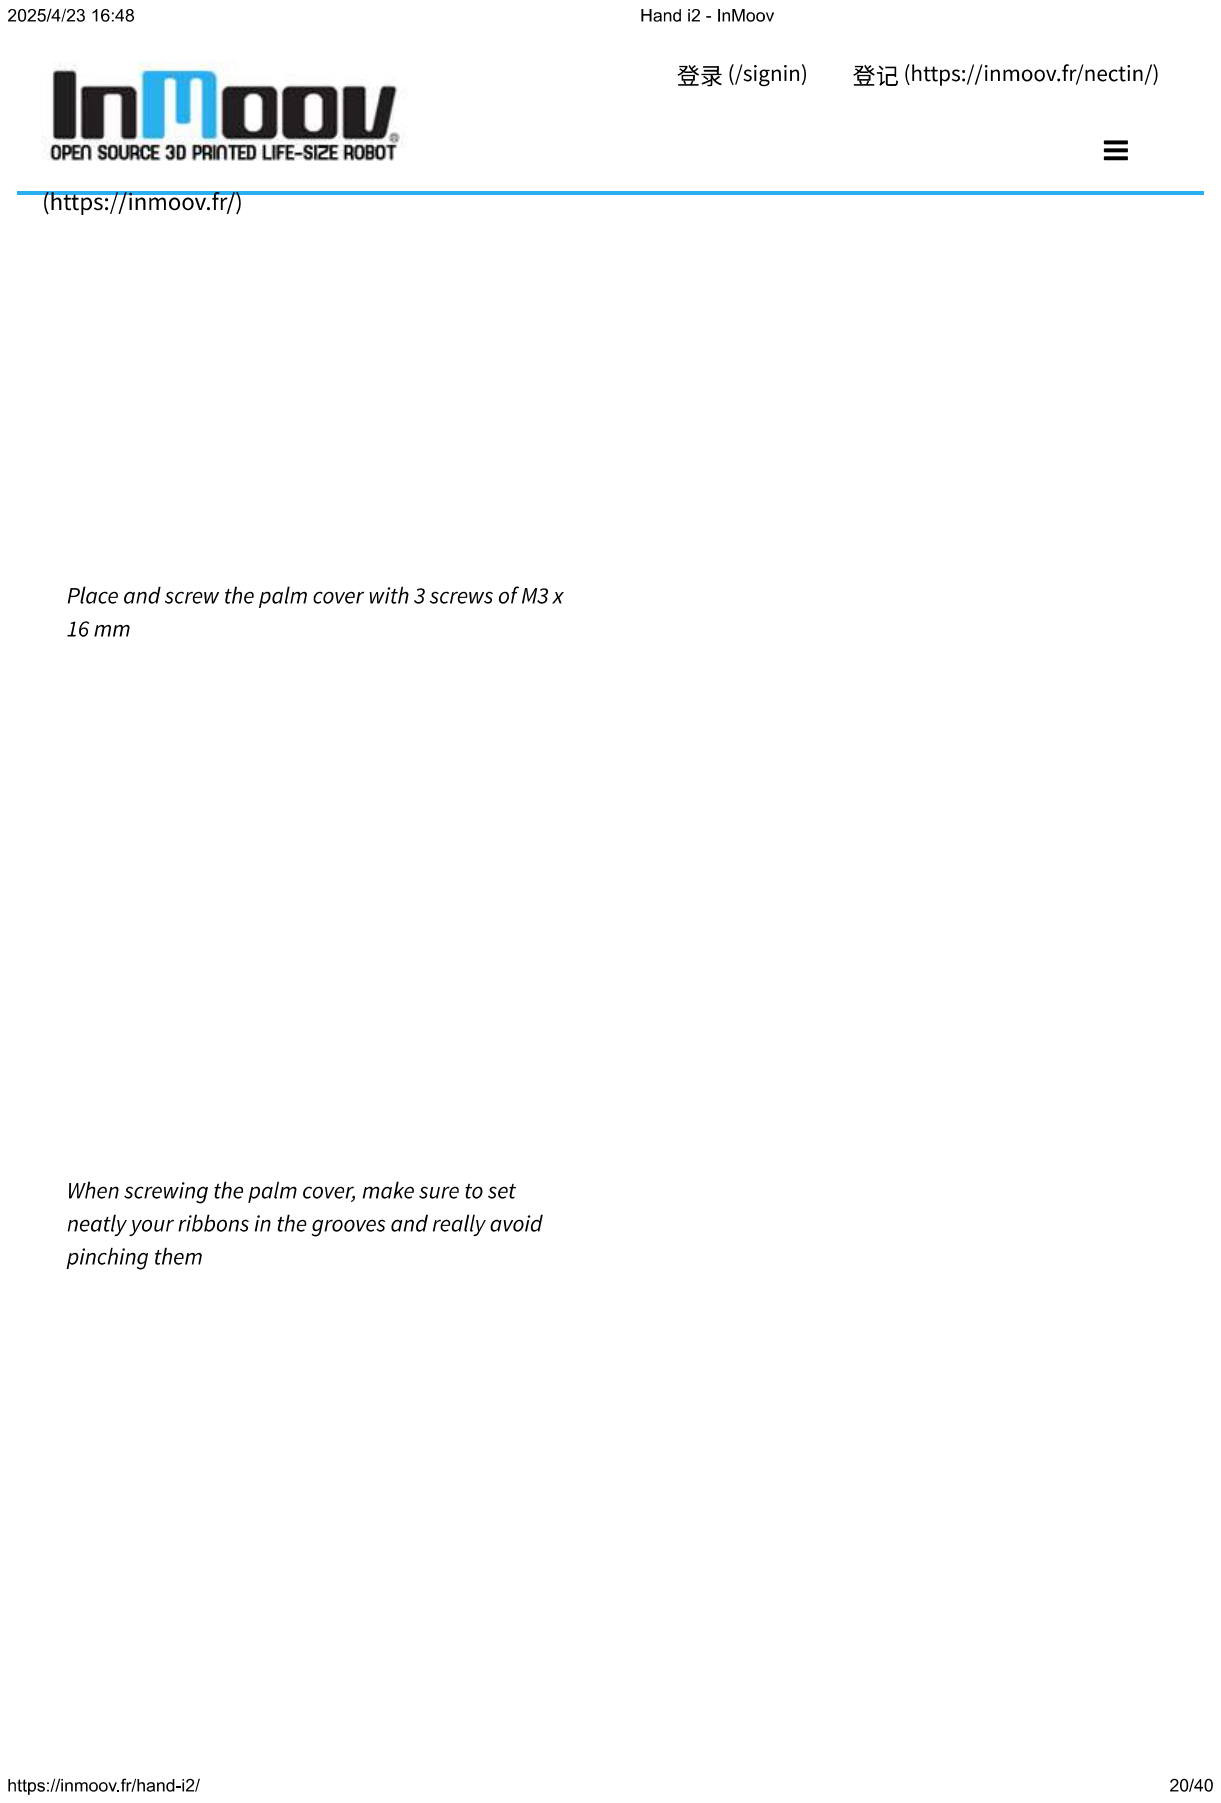
[picture p357: page 20]
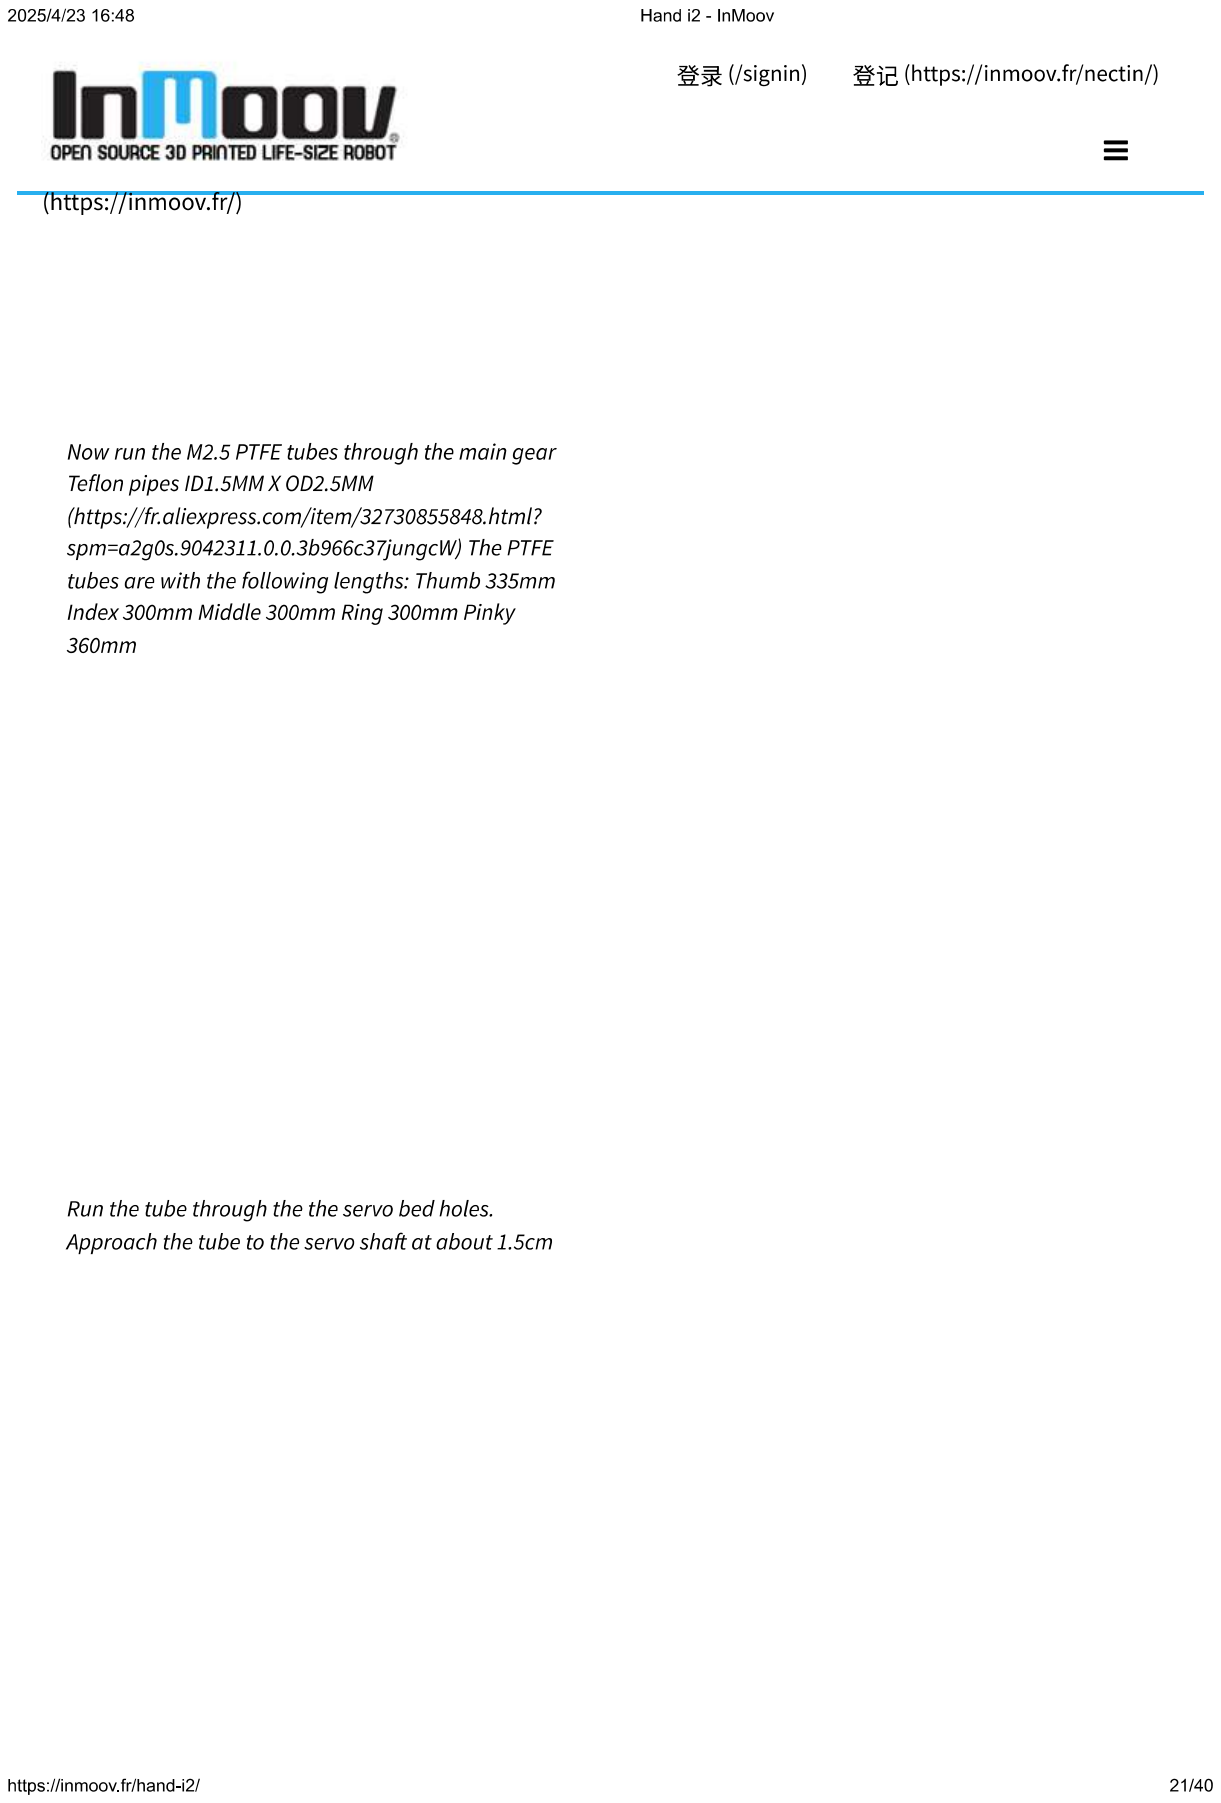
[picture p358: page 21]
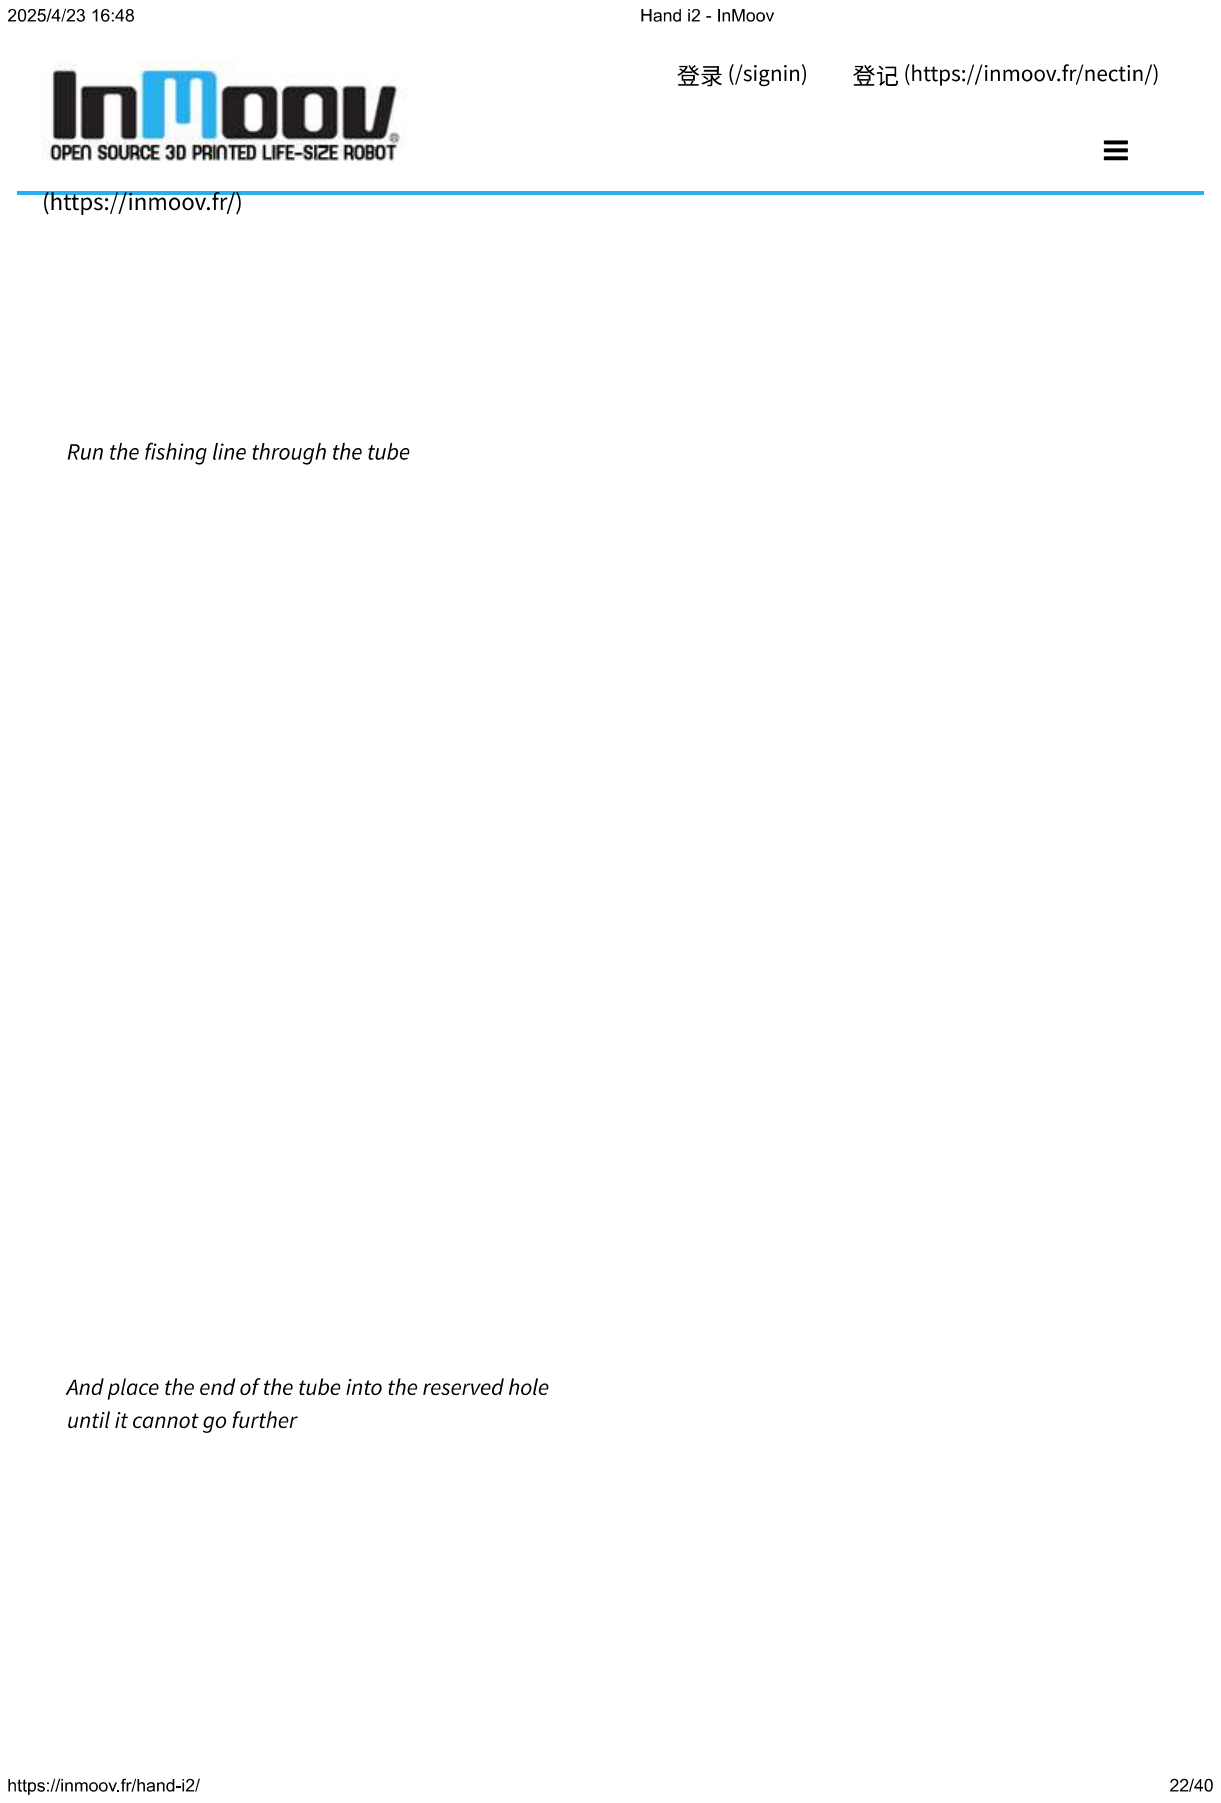
[picture p359: page 22]
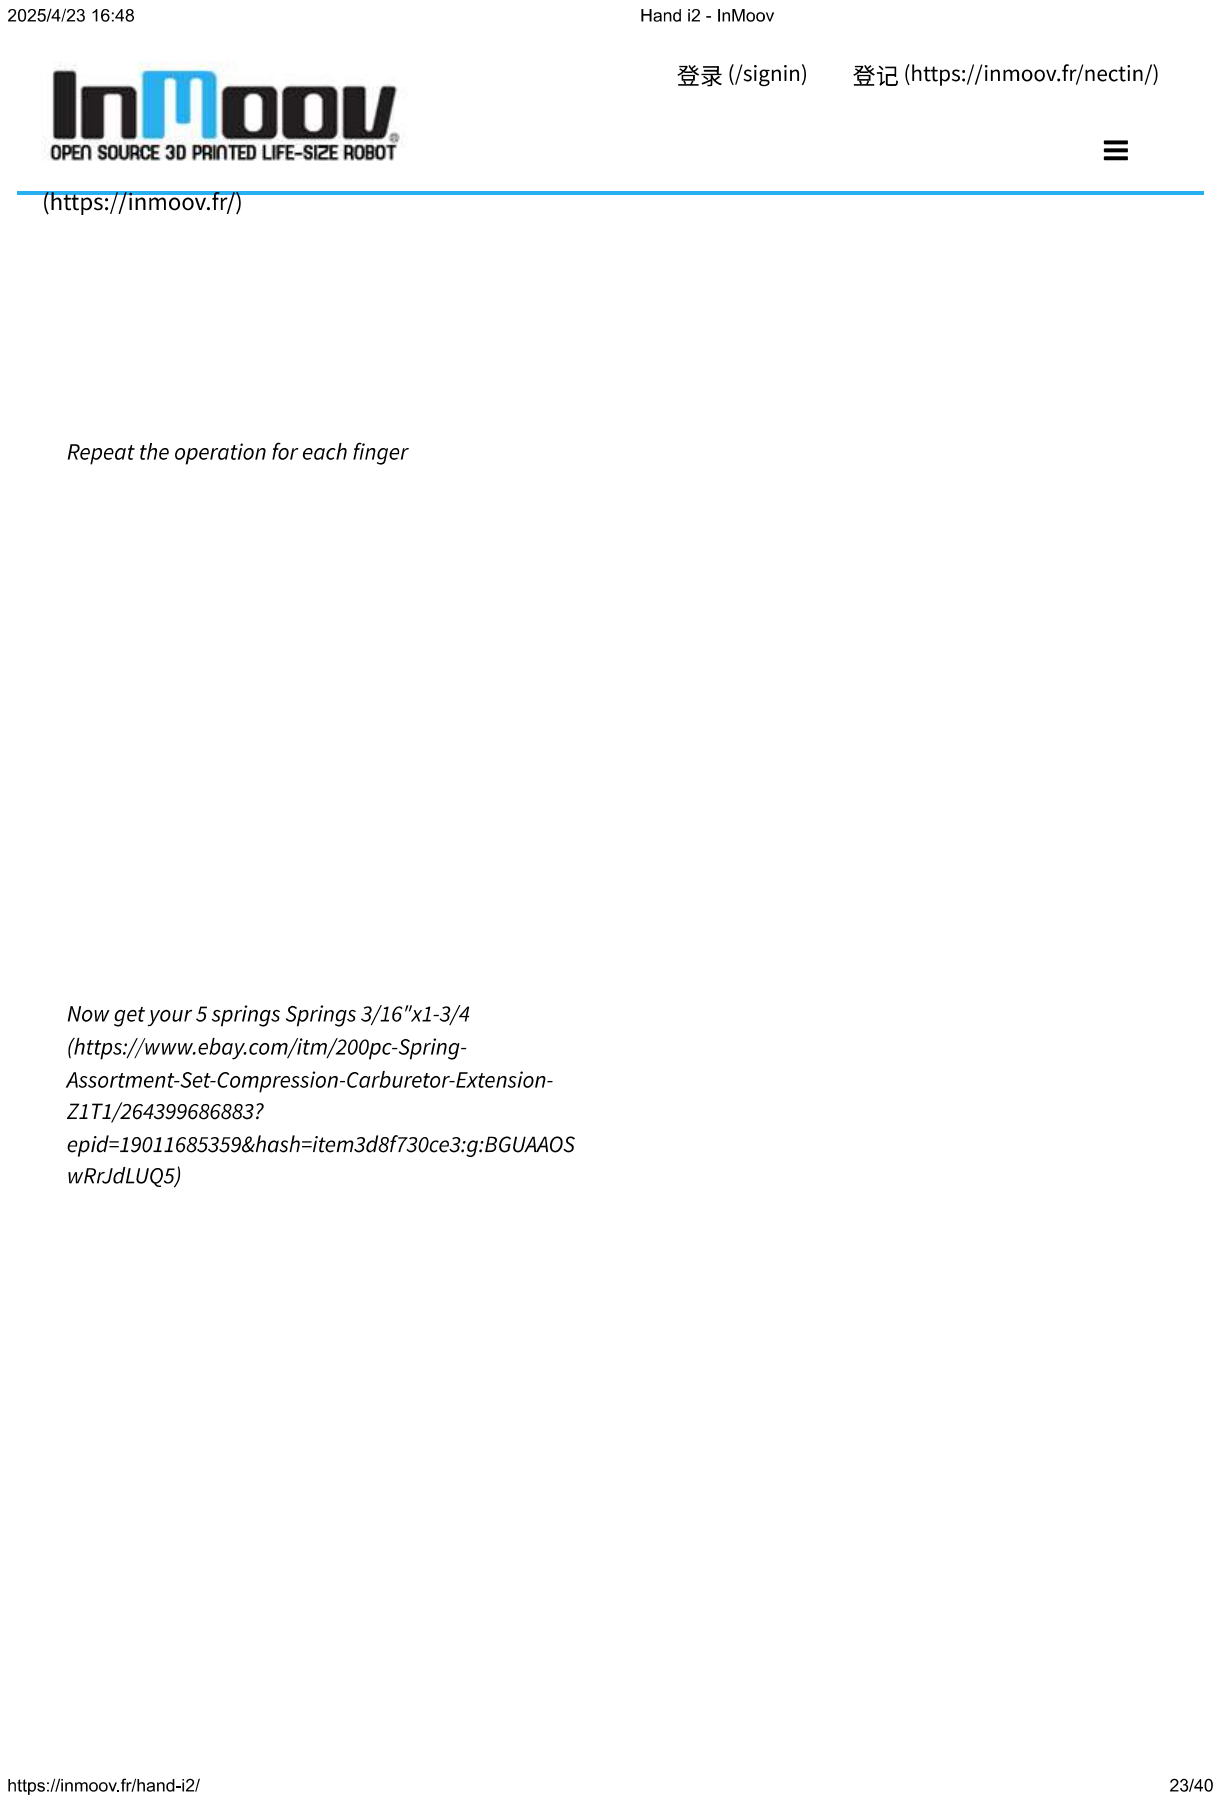
[picture p360: page 23]
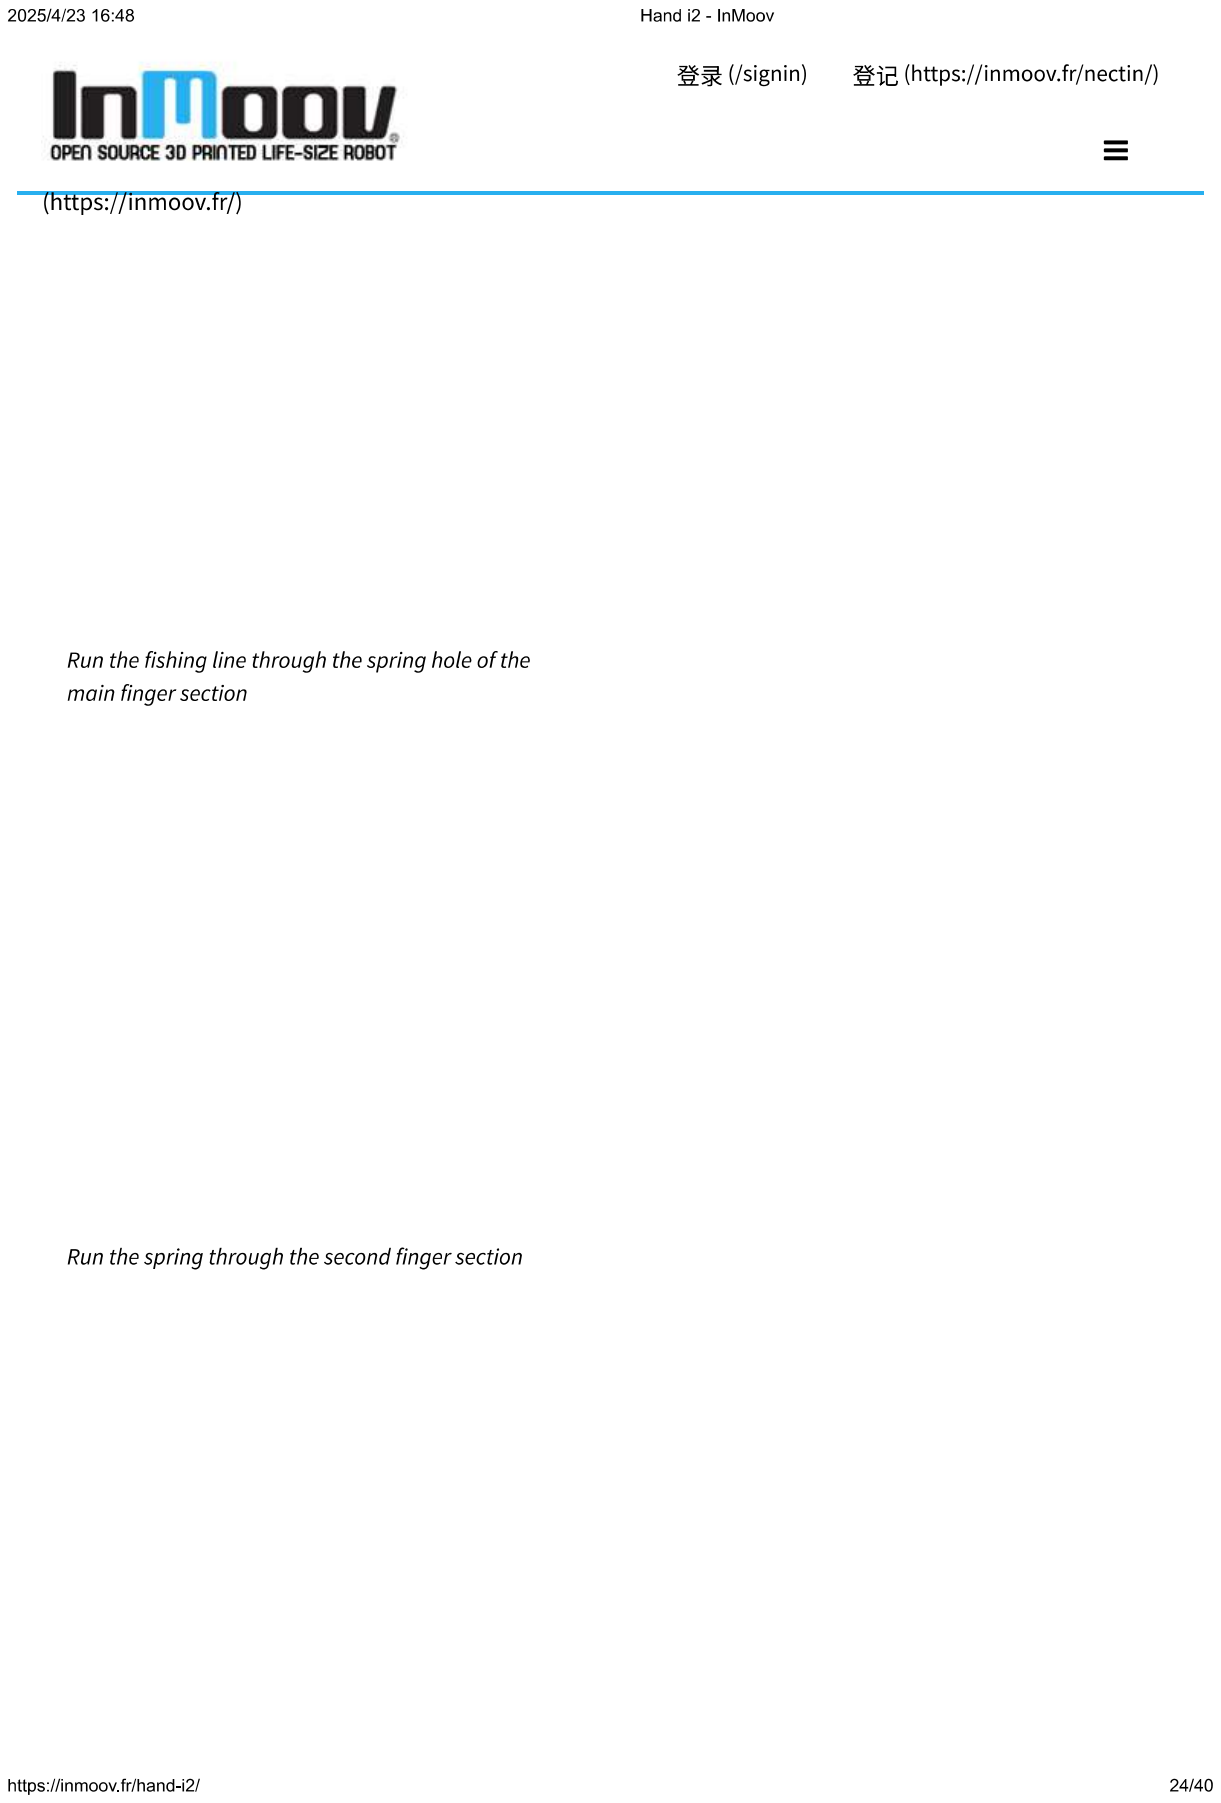
[picture p361: page 24]
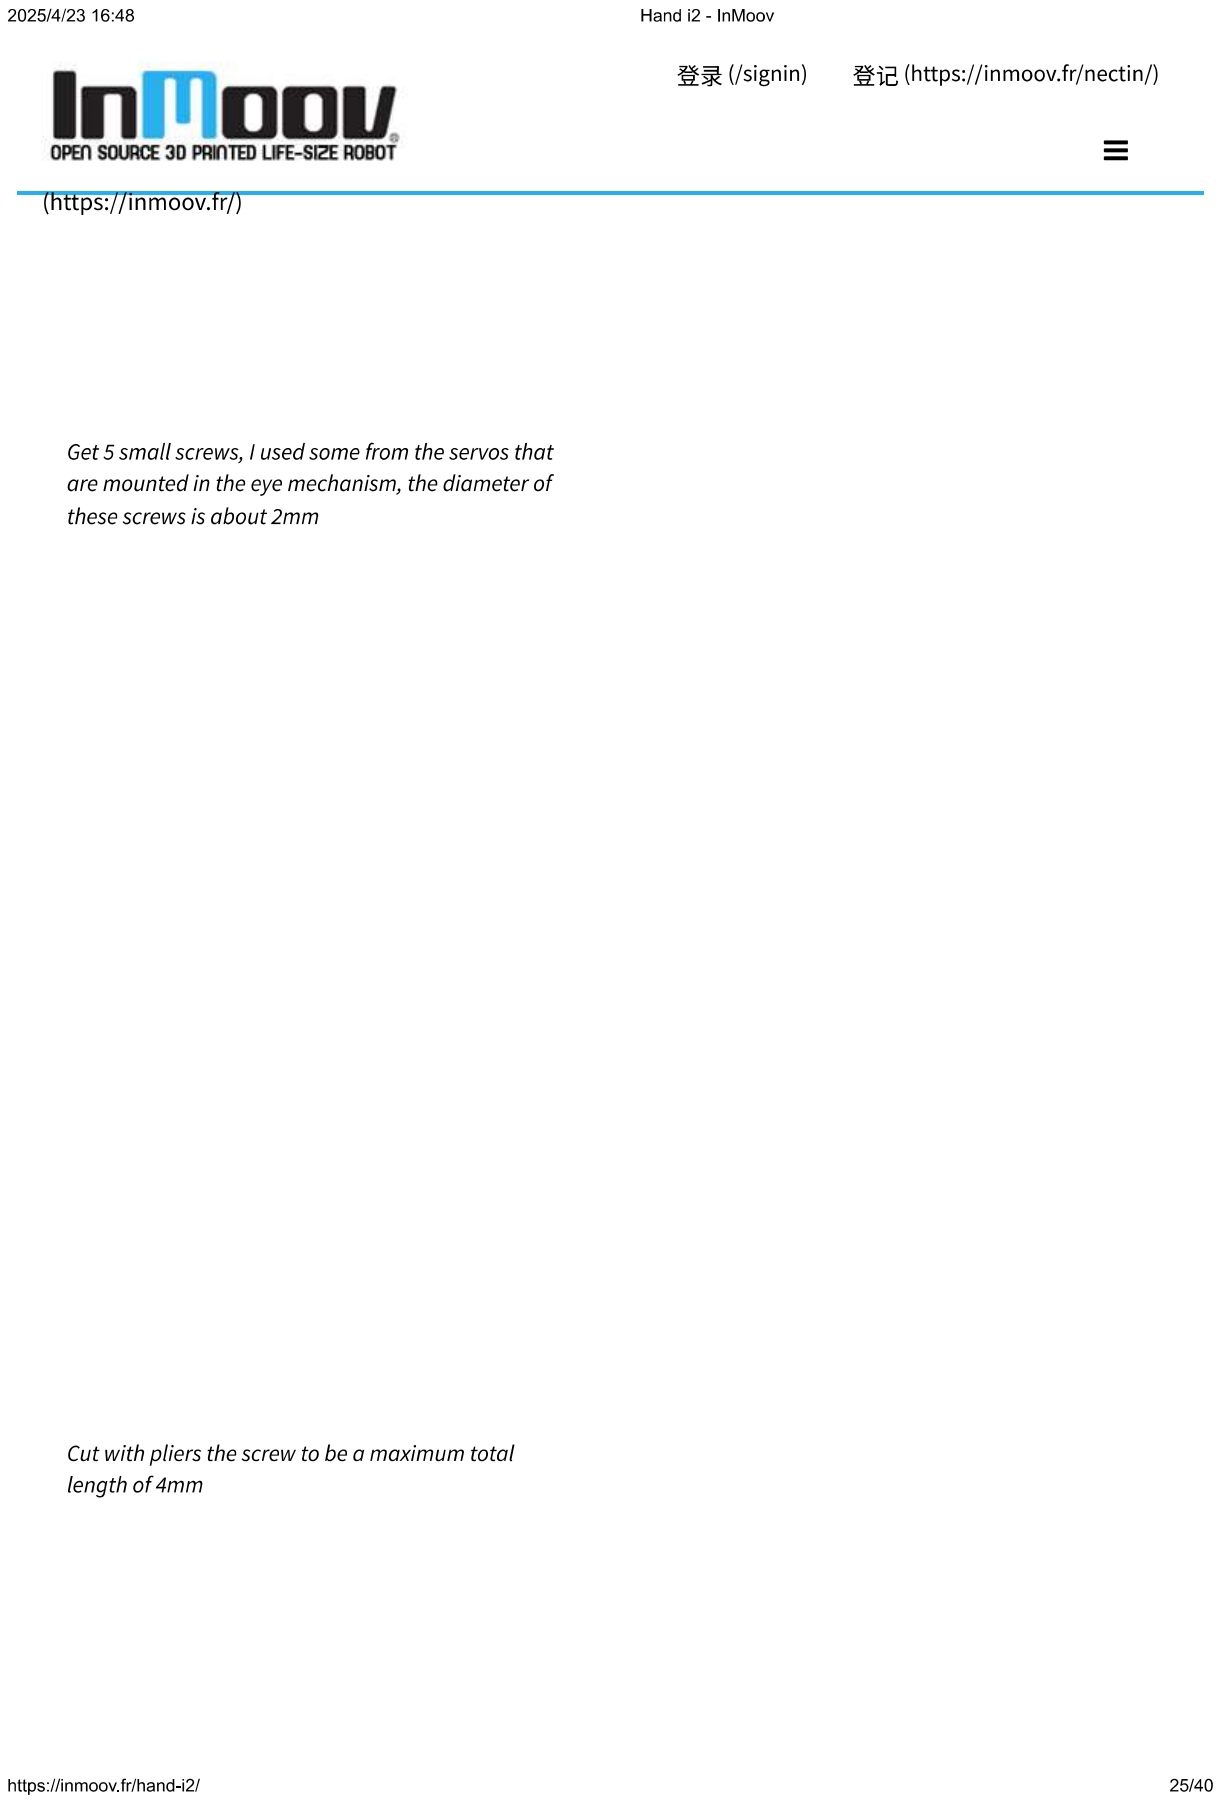
[picture p362: page 25]
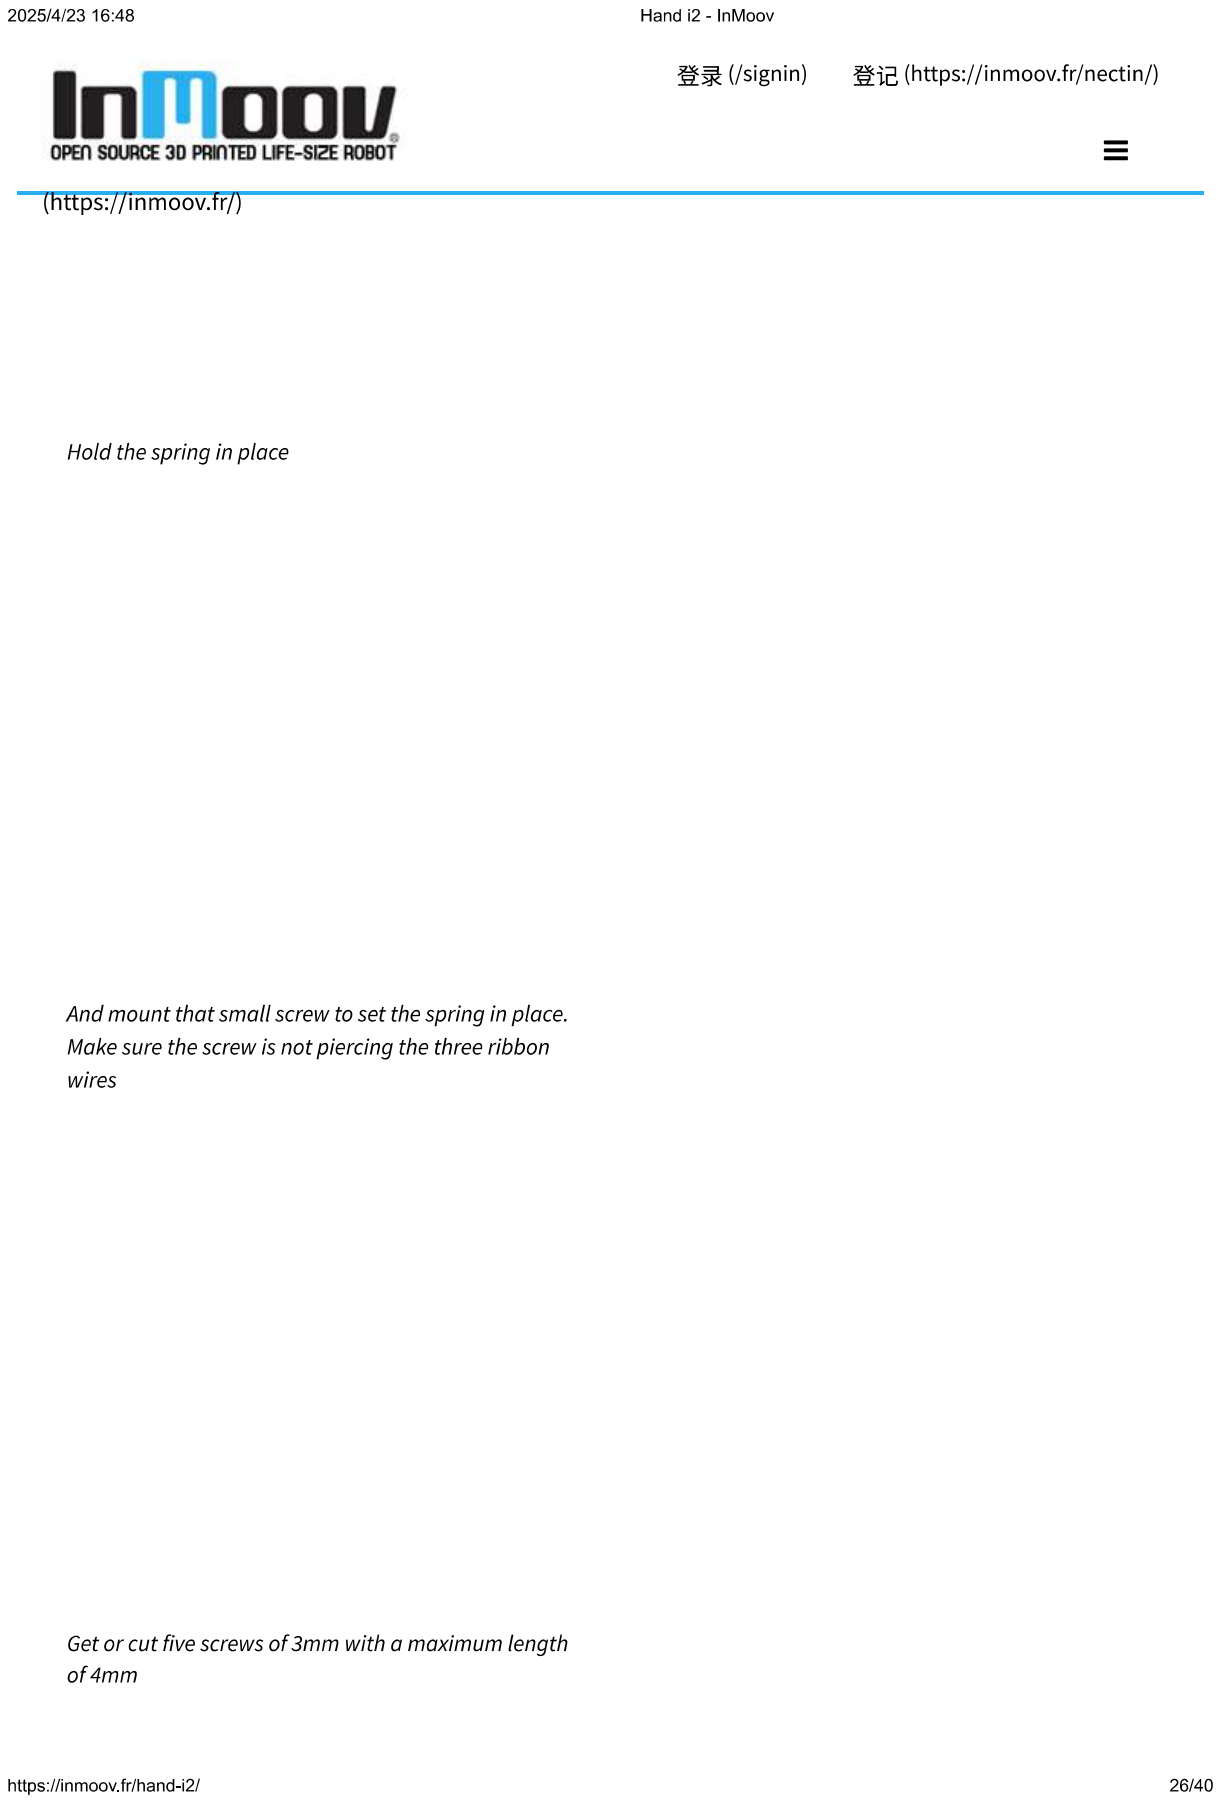
[picture p363: page 26]
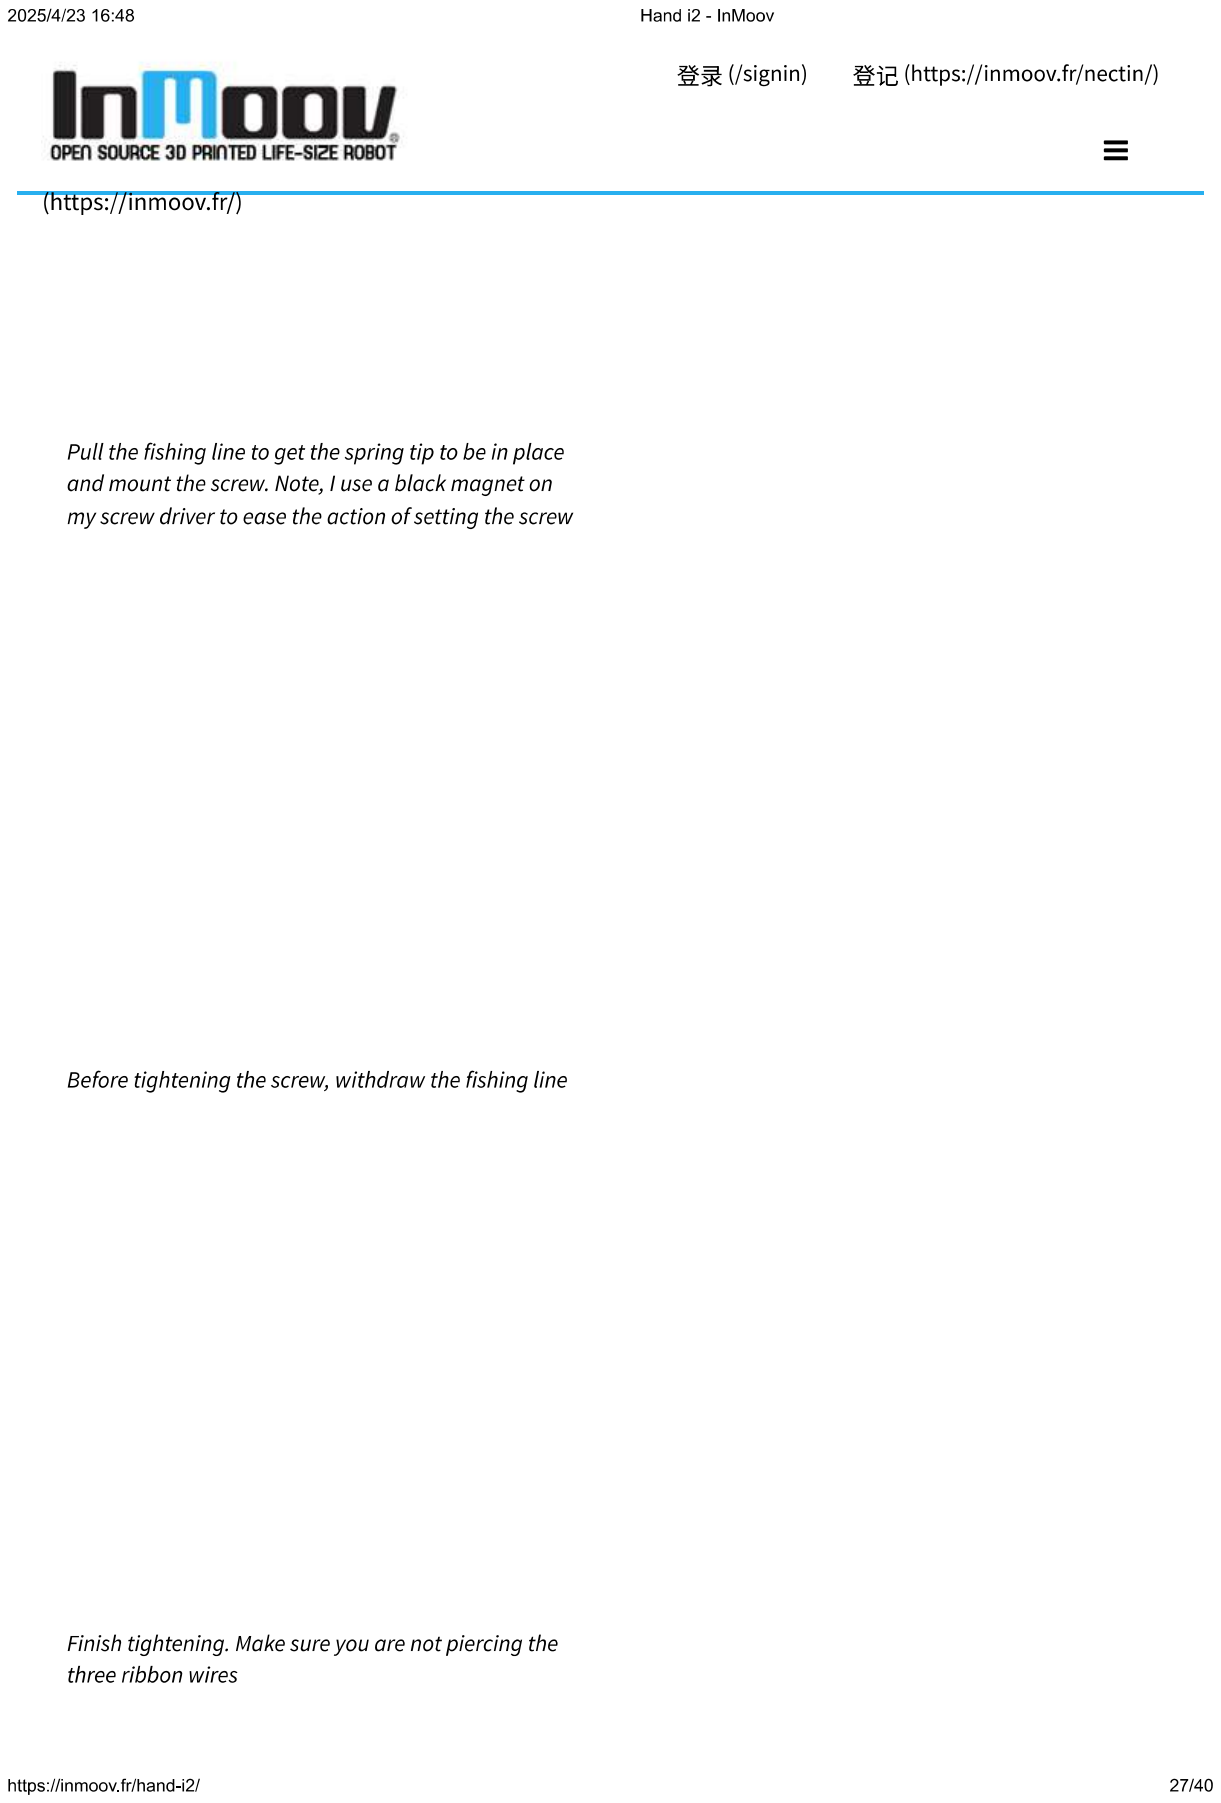
[picture p364: page 27]
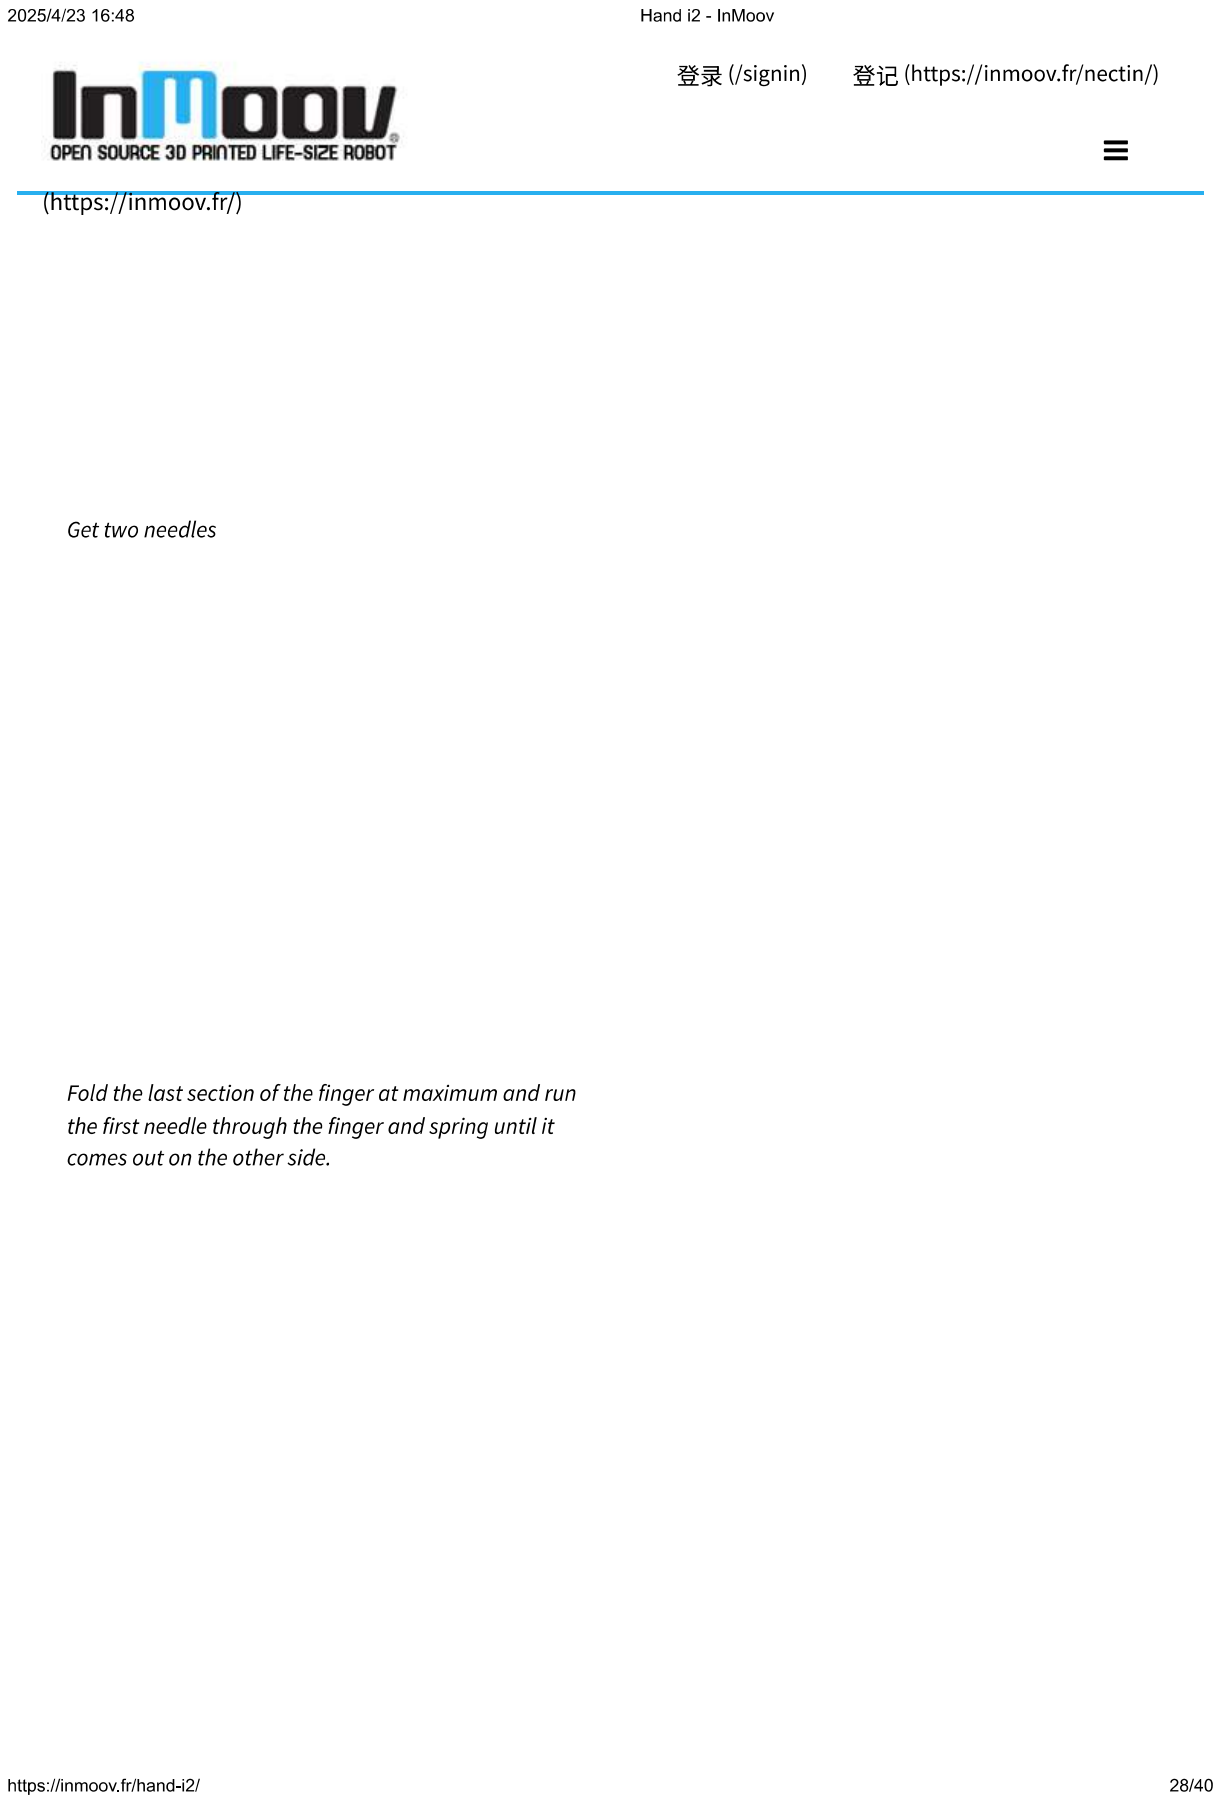
[picture p365: page 28]
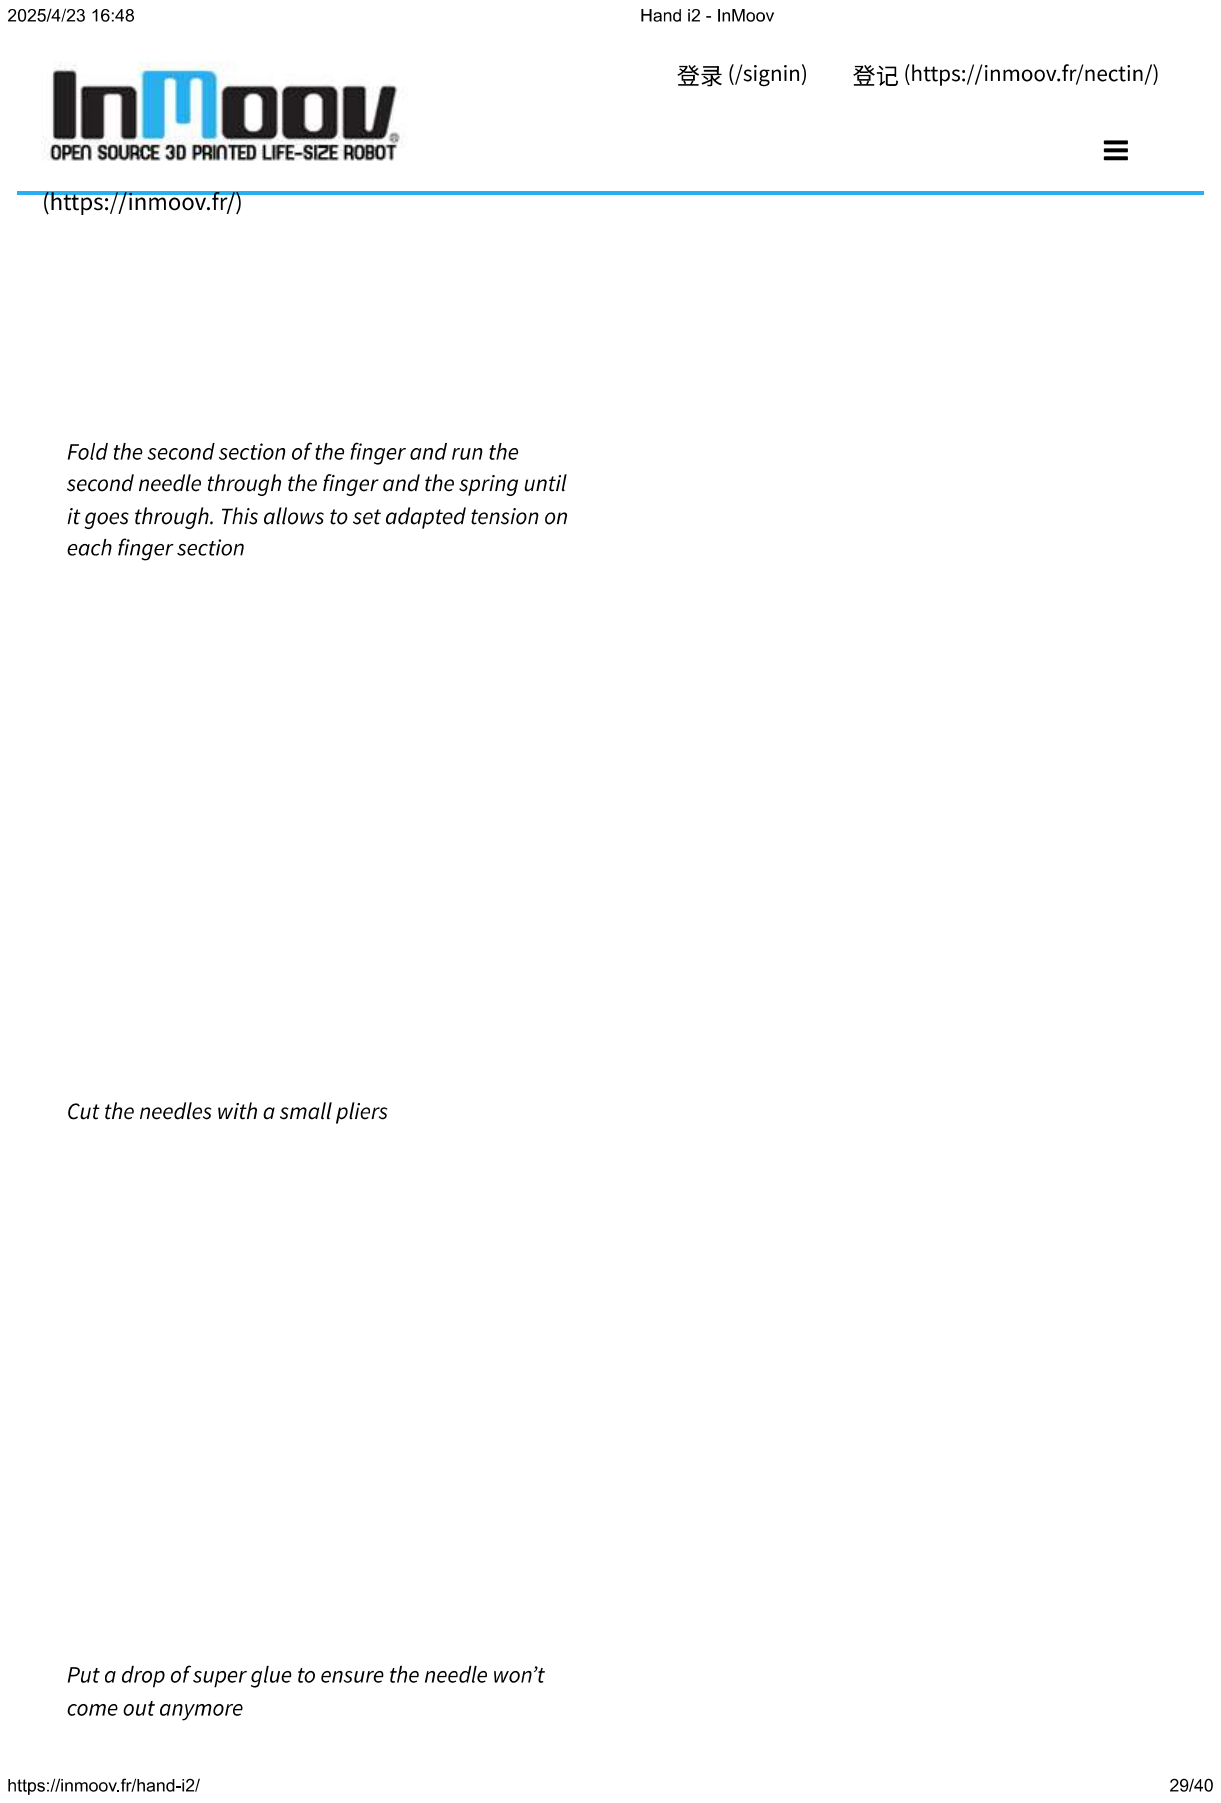
[picture p366: page 29]
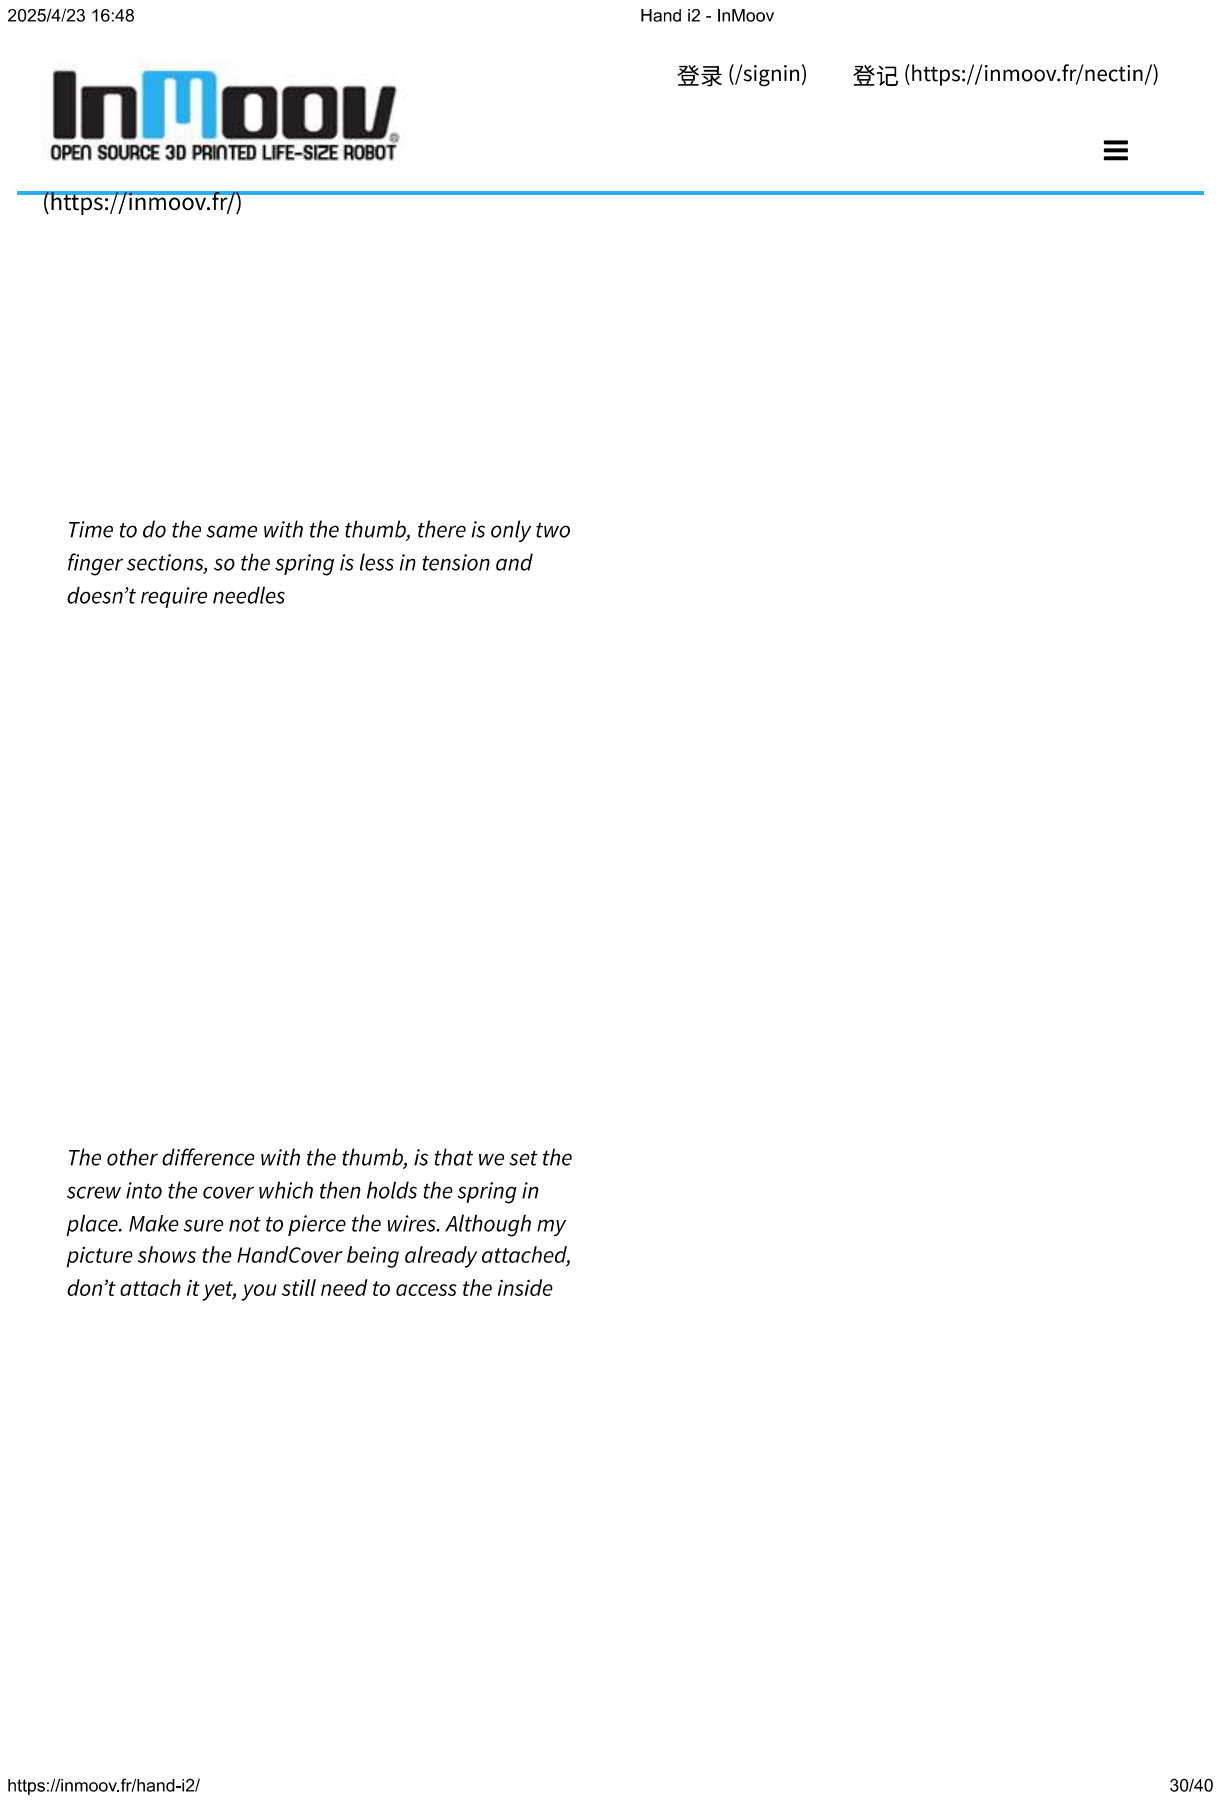
[picture p367: page 30]
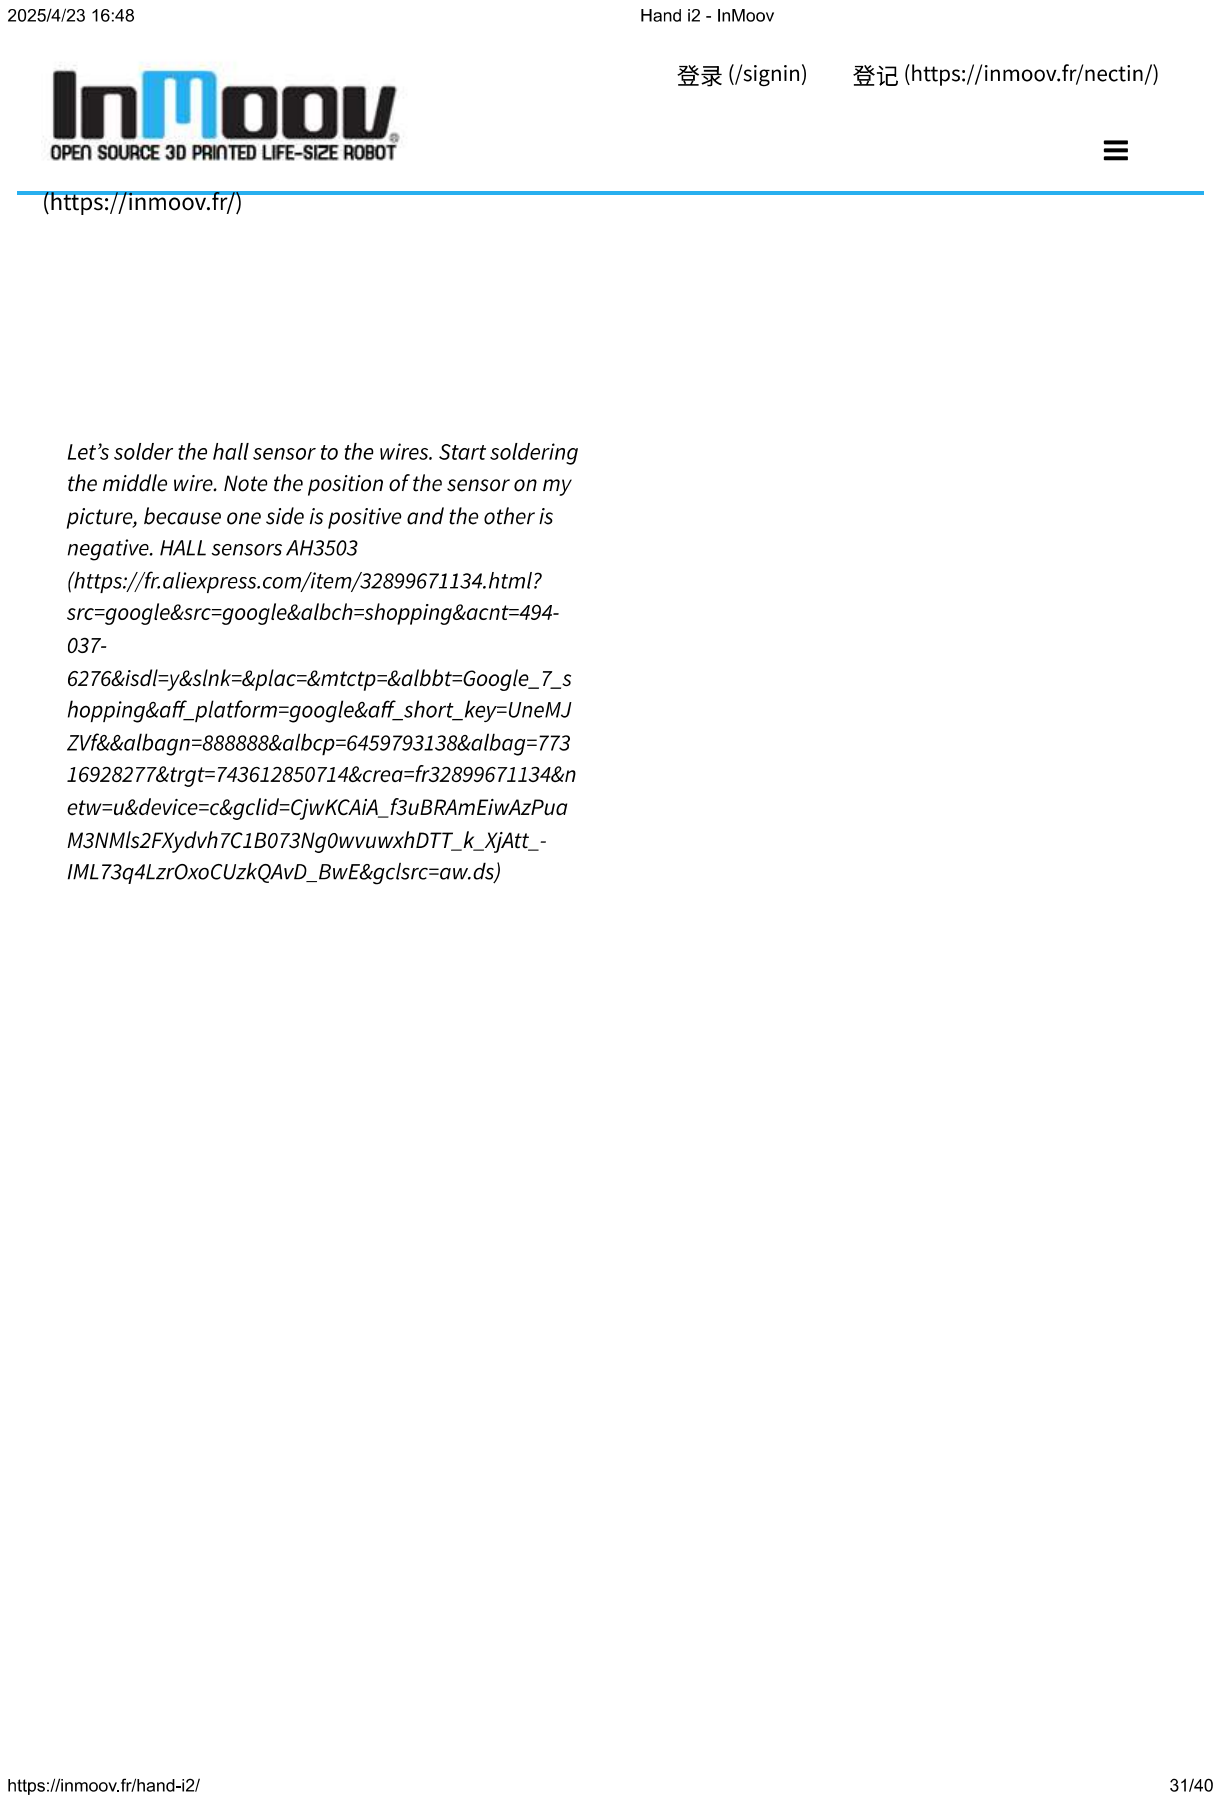
[picture p368: page 31]
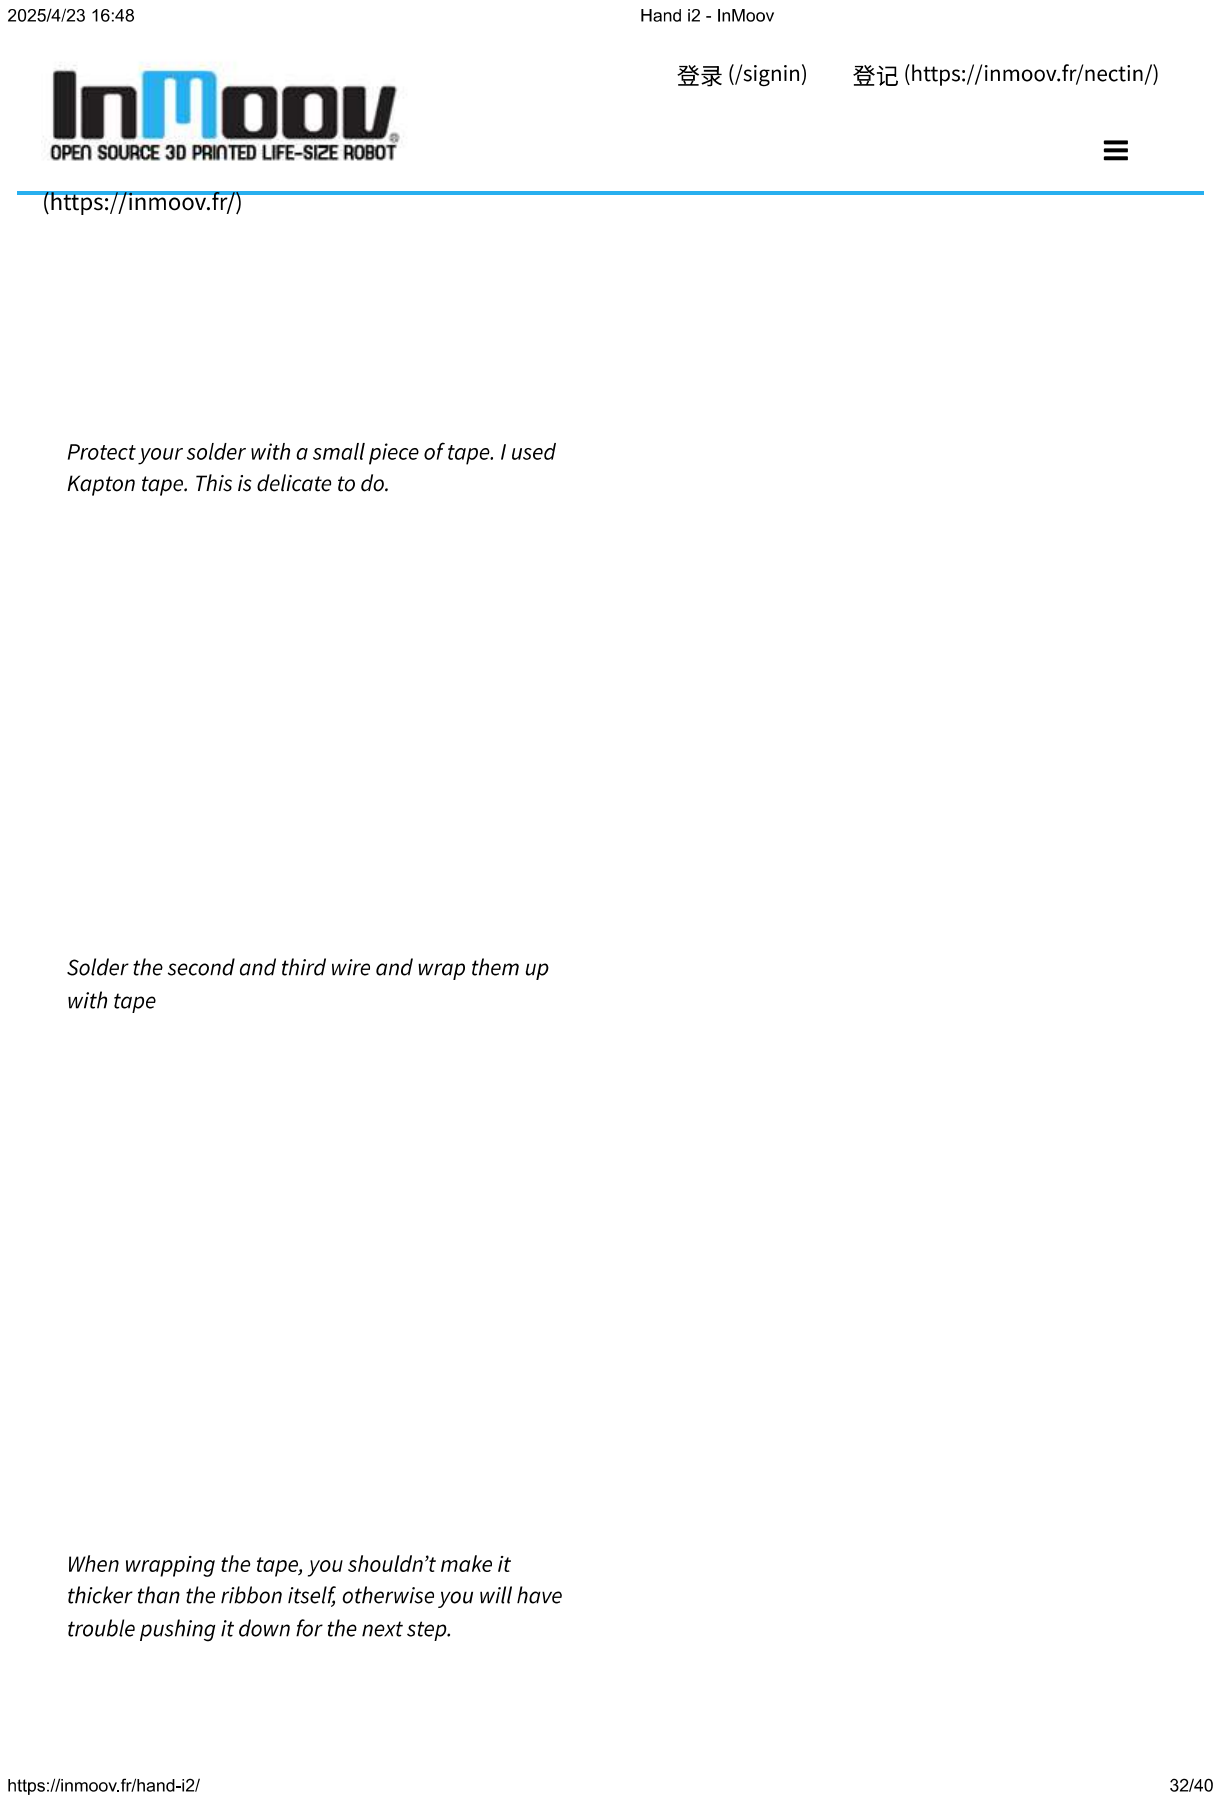
[picture p369: page 32]
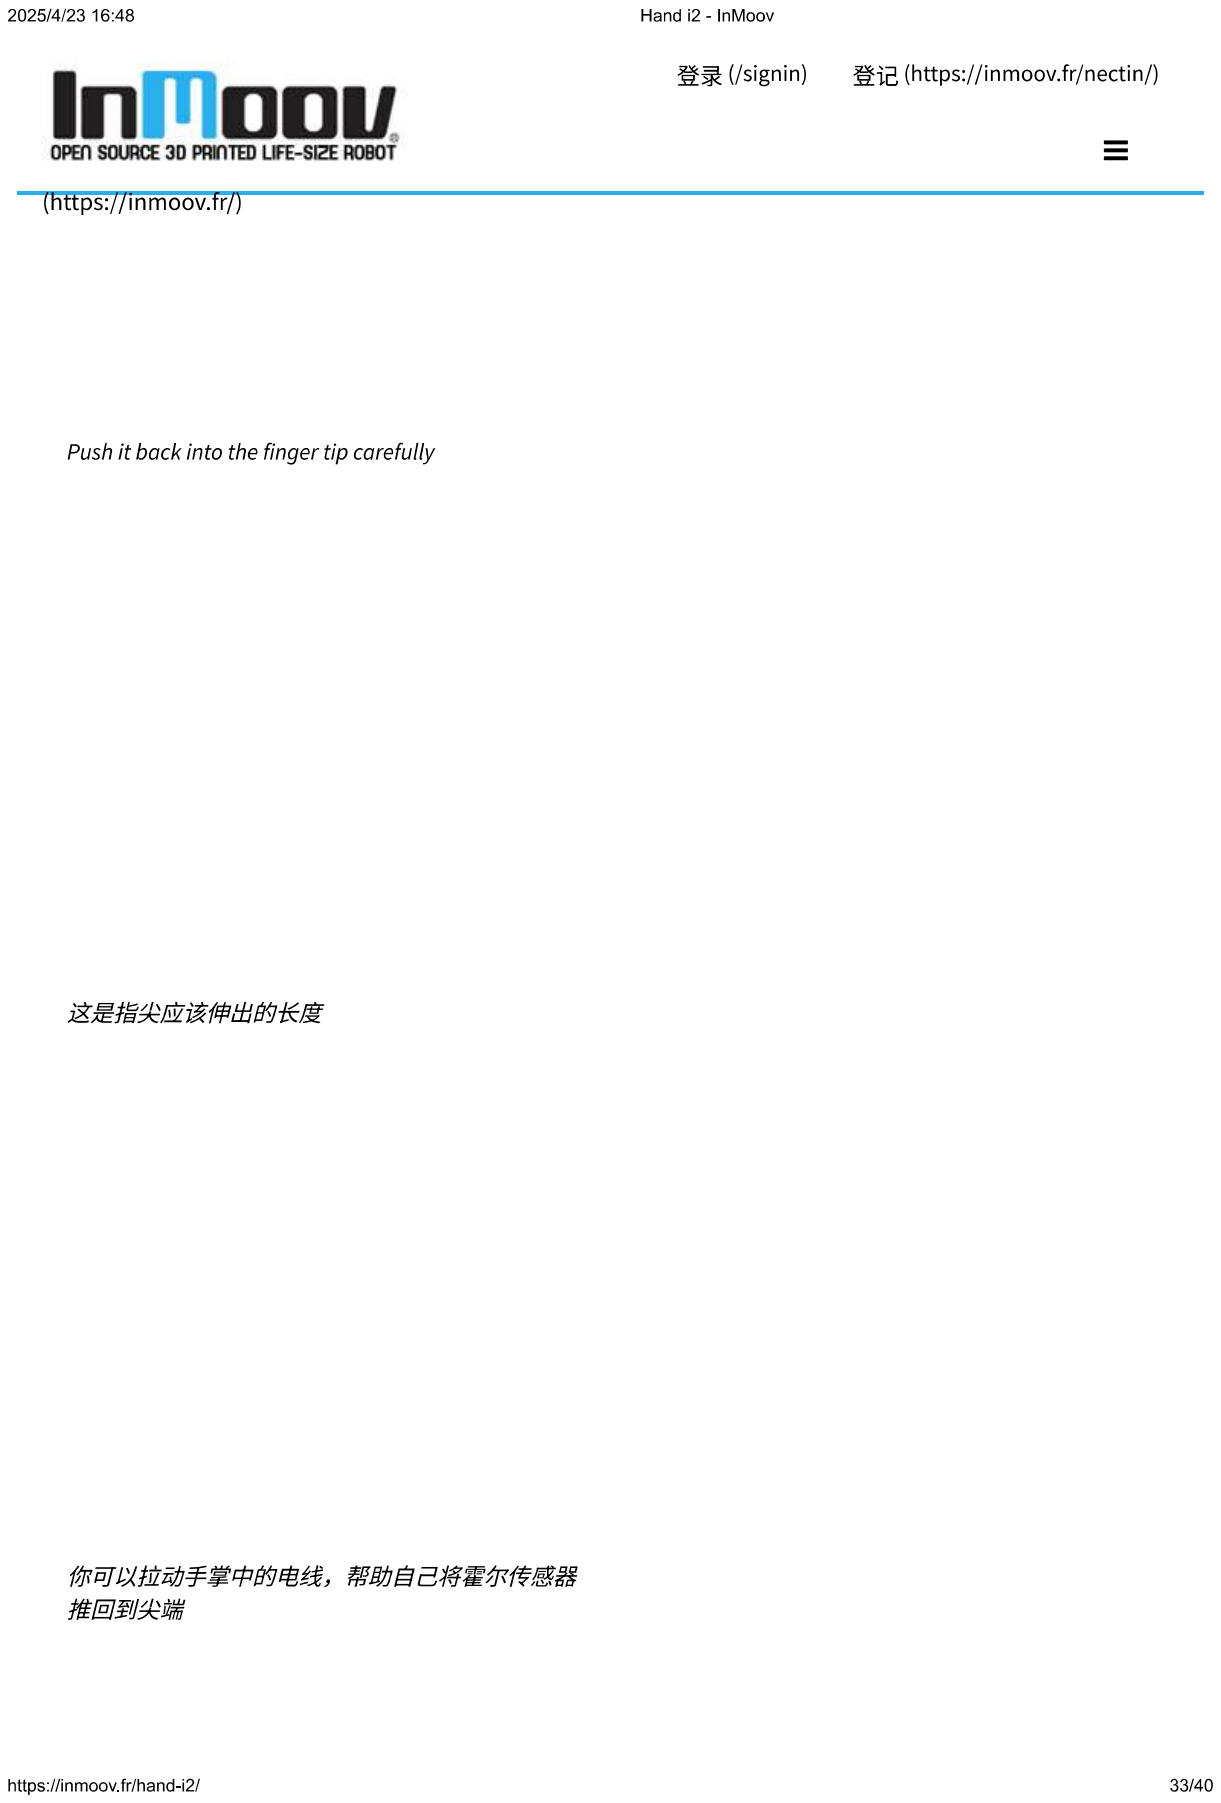
[picture p370: page 33]
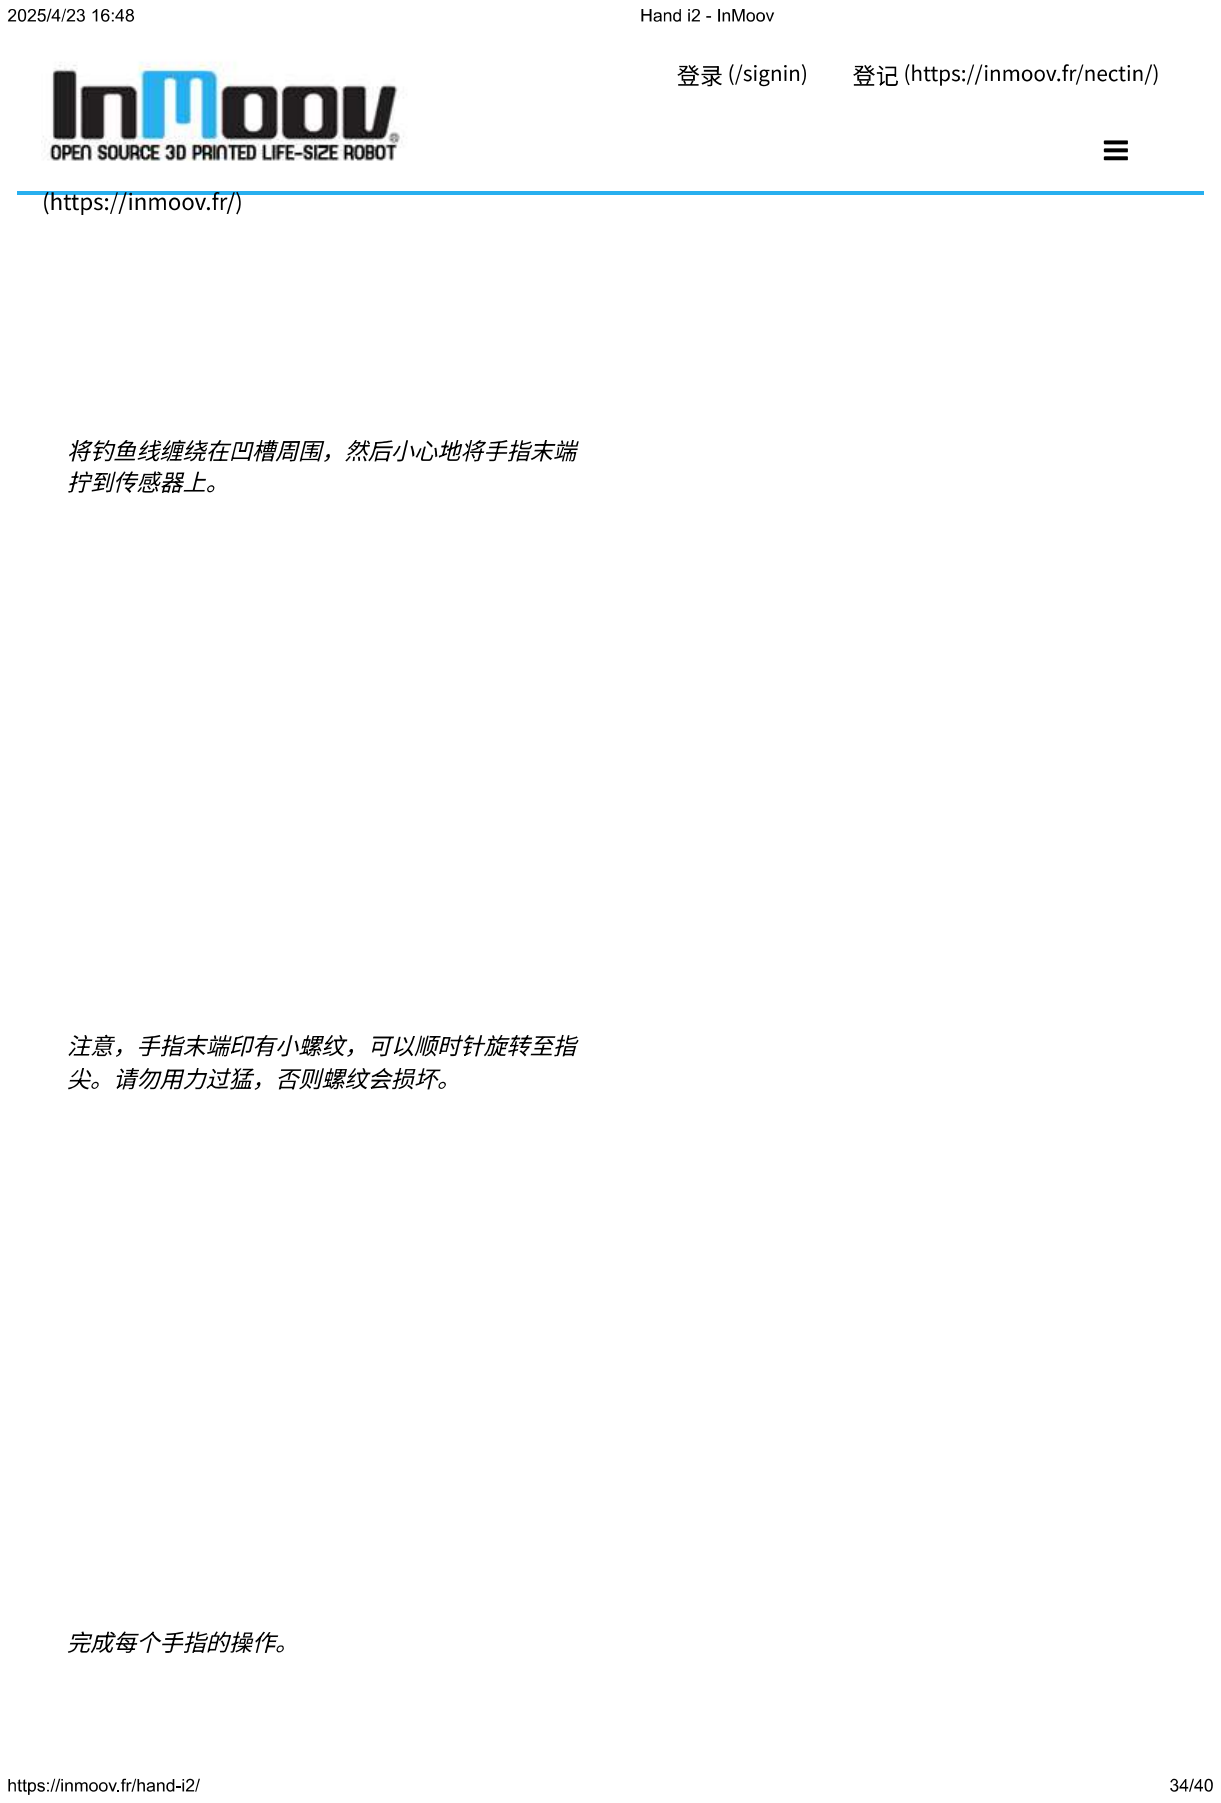
[picture p371: page 34]
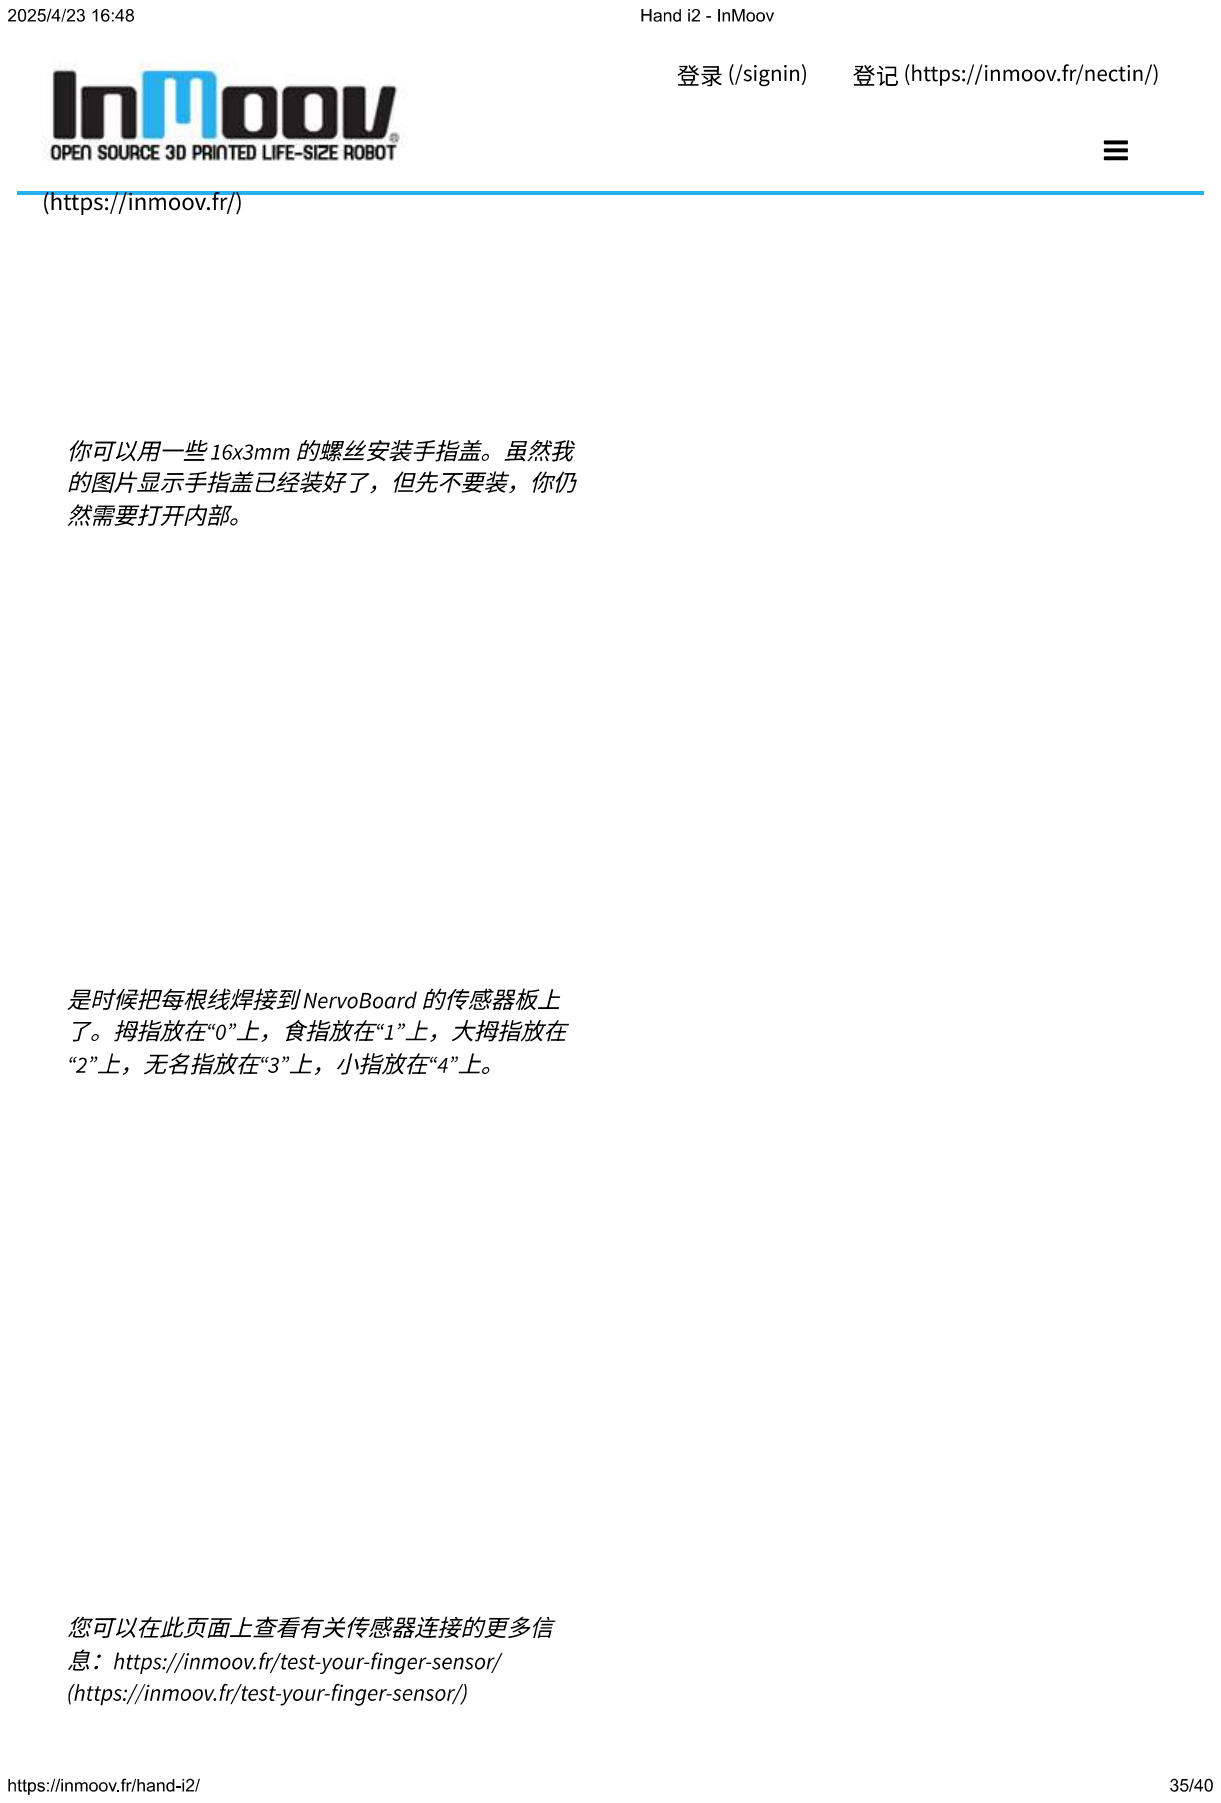
[picture p372: page 35]
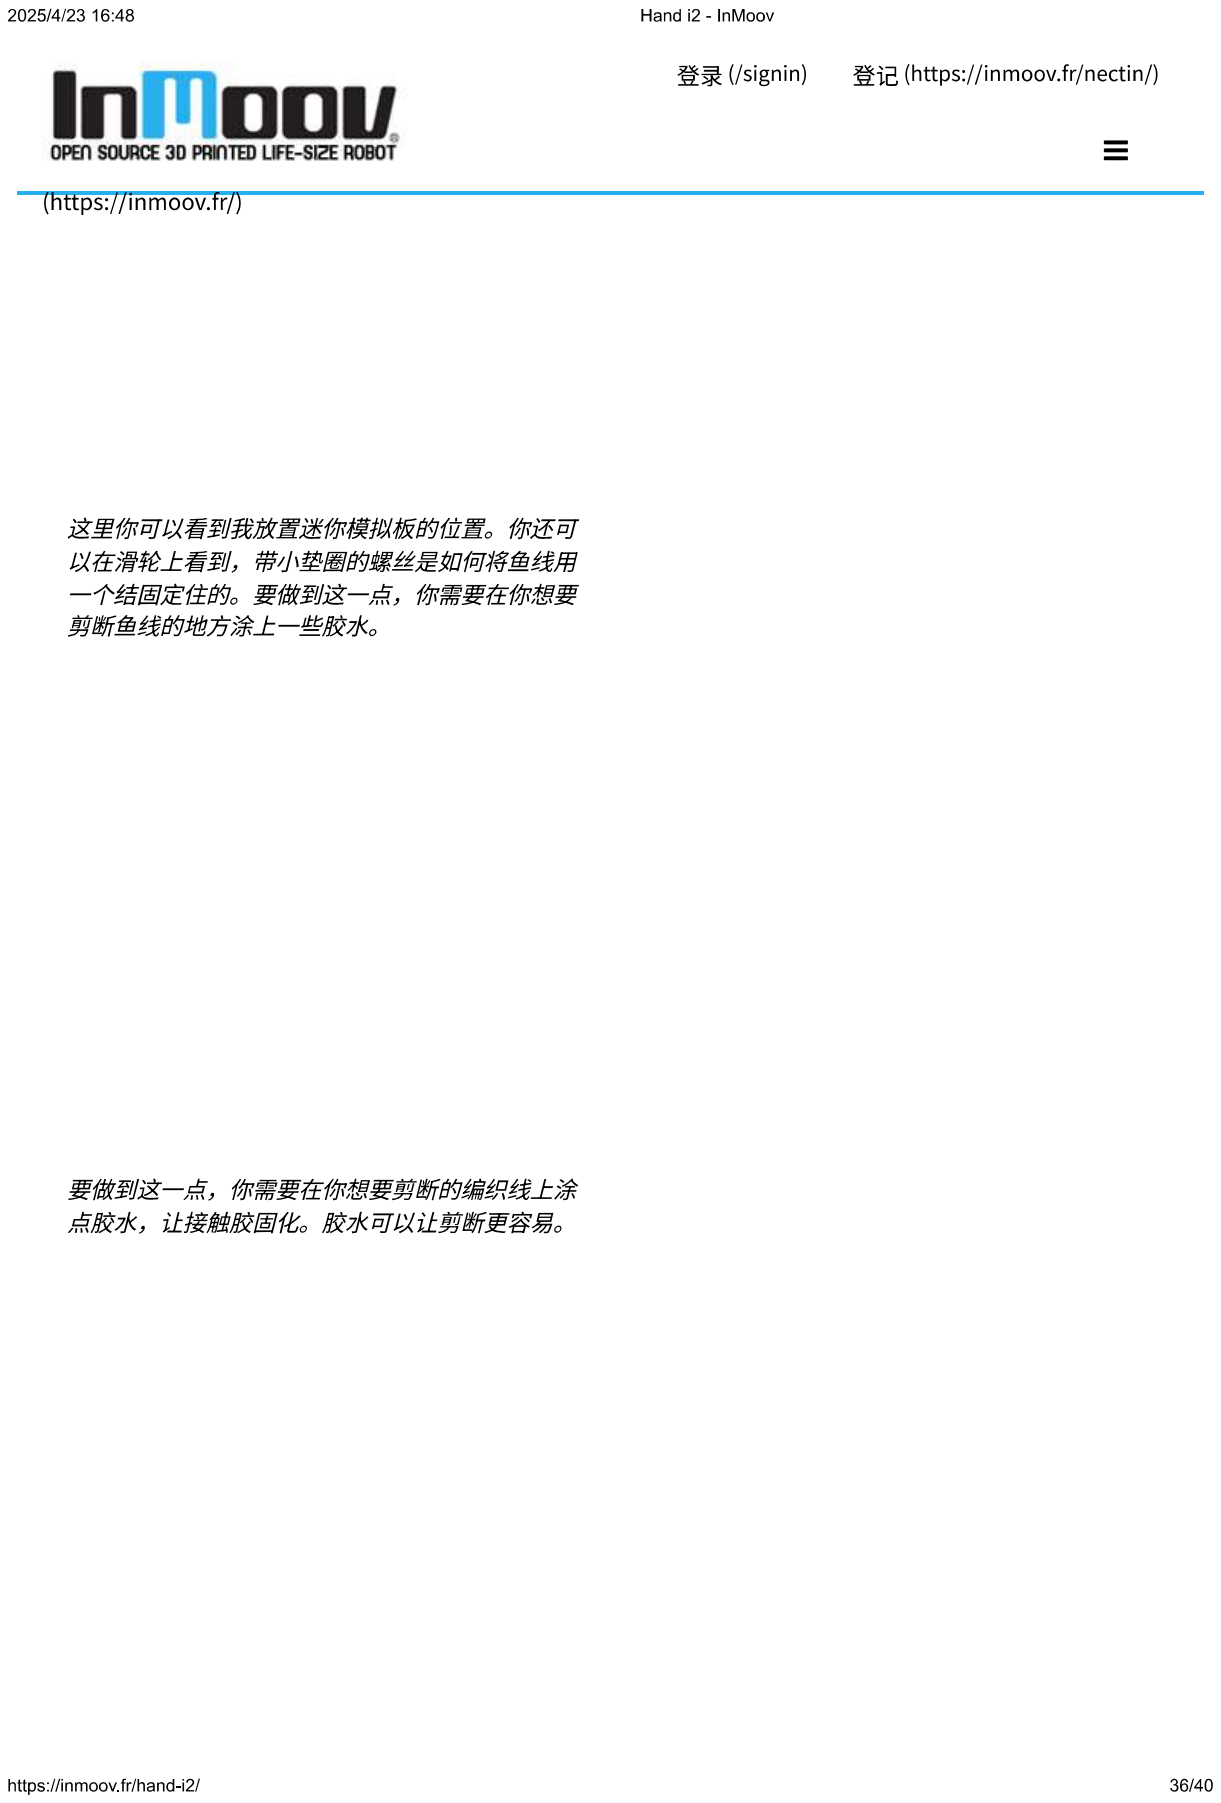
[picture p373: page 36]
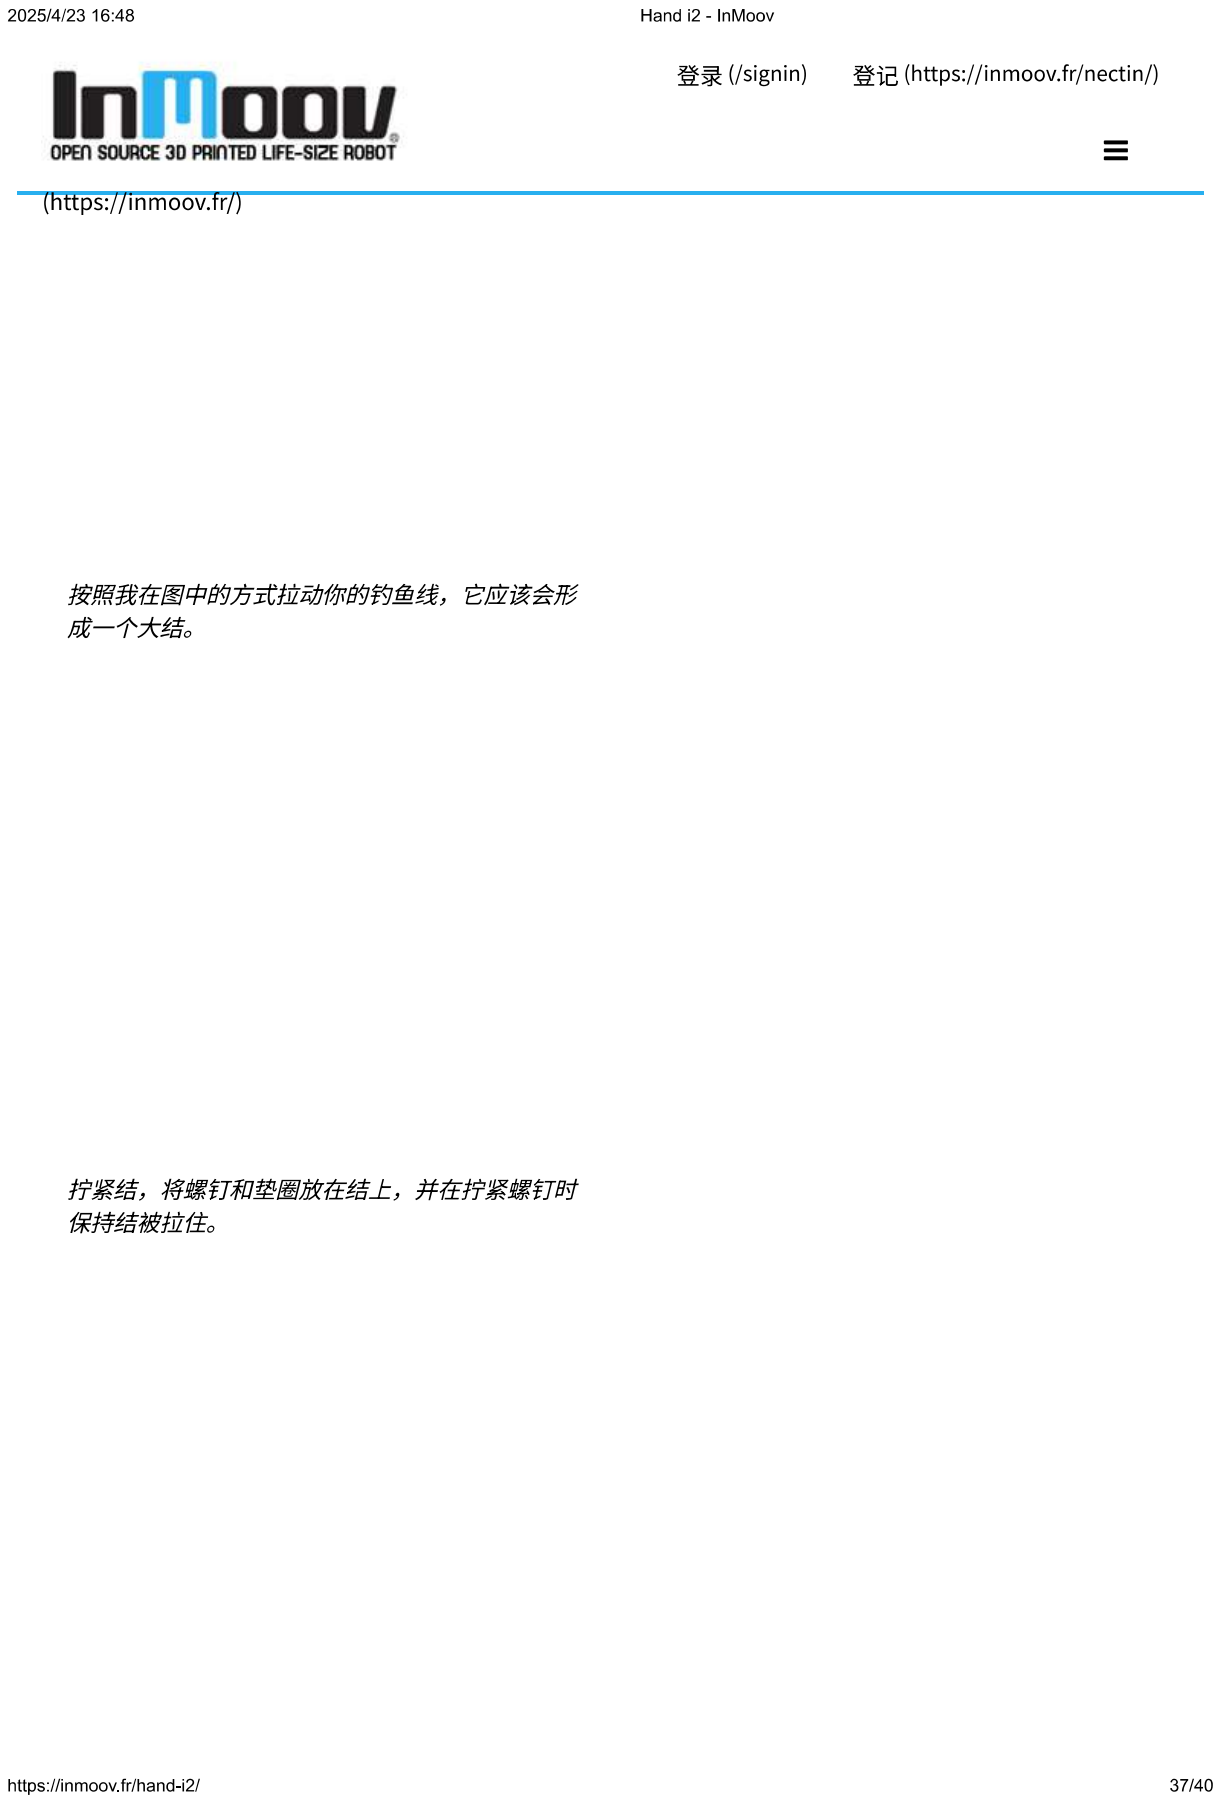
[picture p374: page 37]
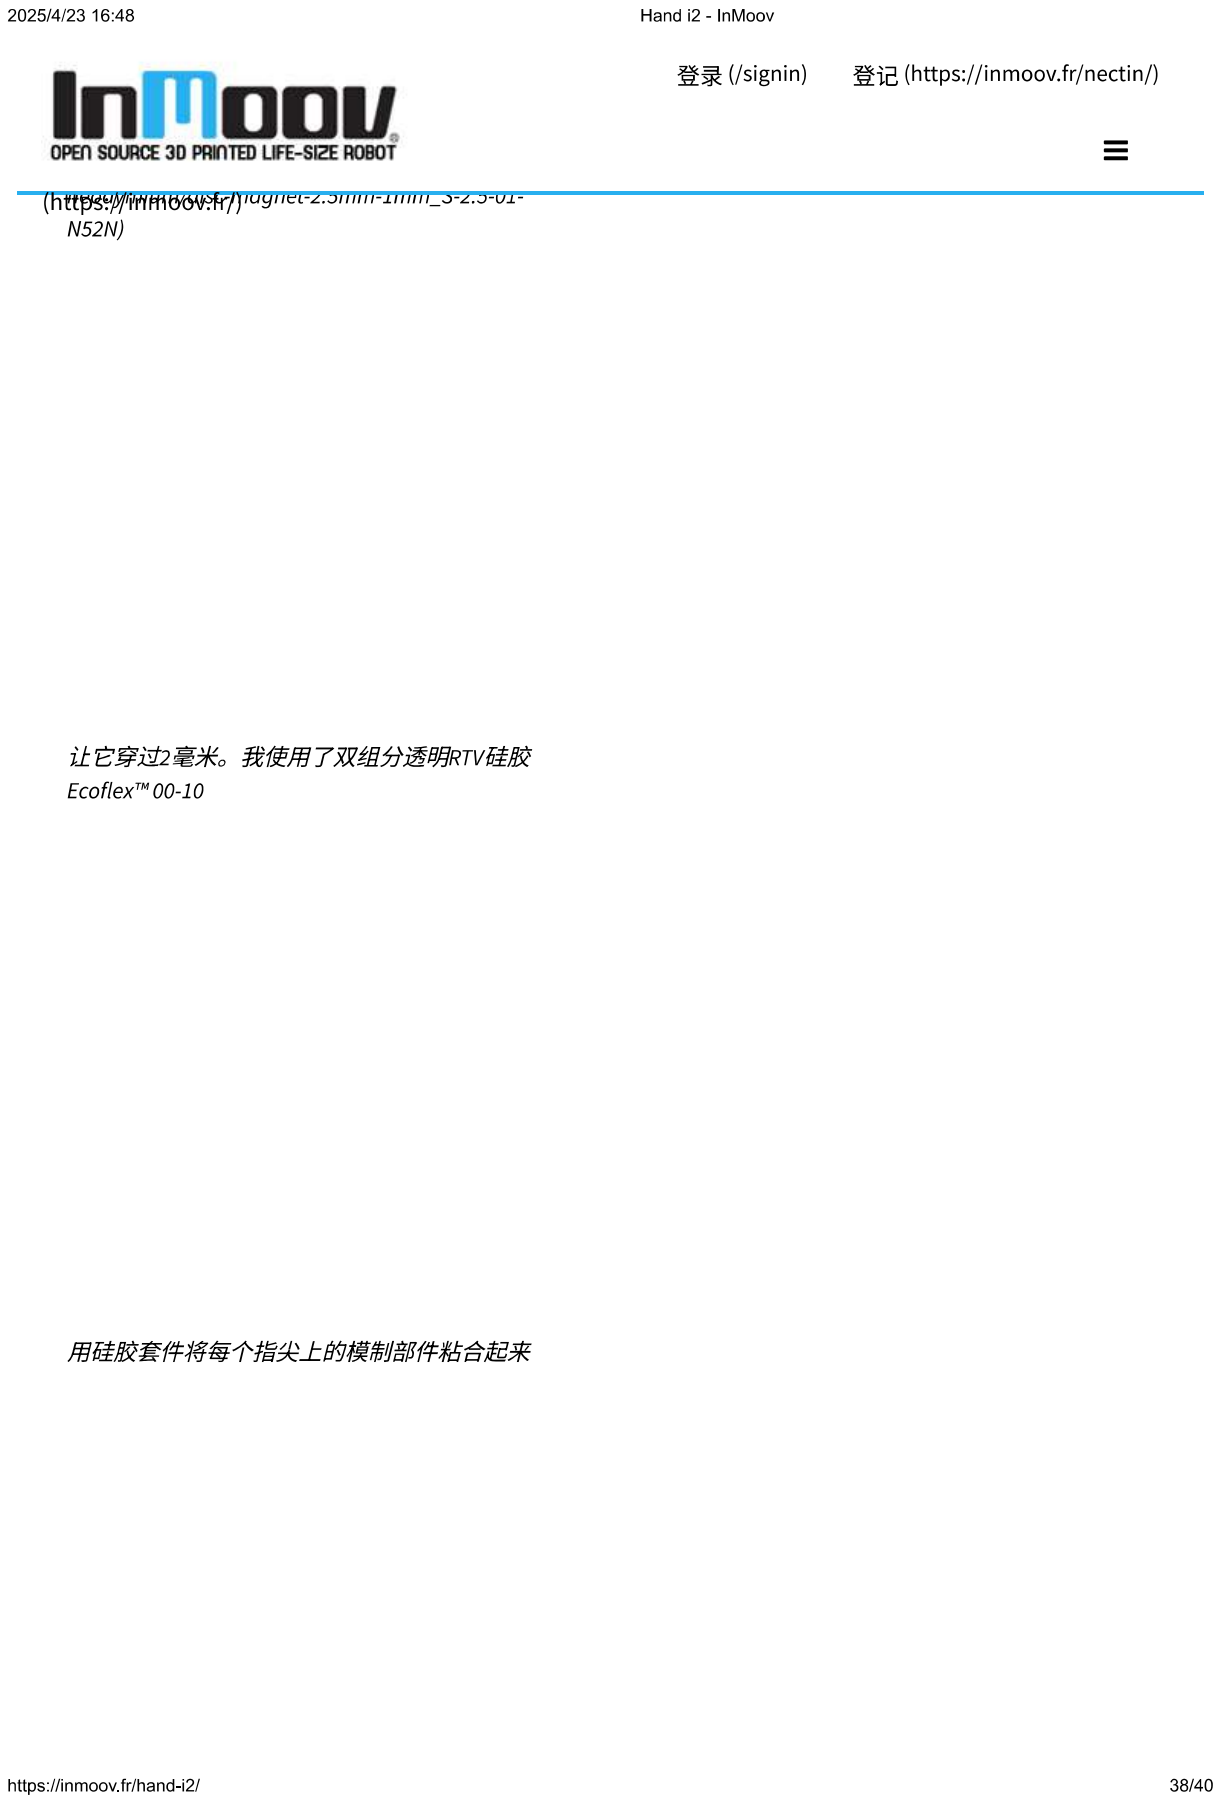
[picture p375: page 38]
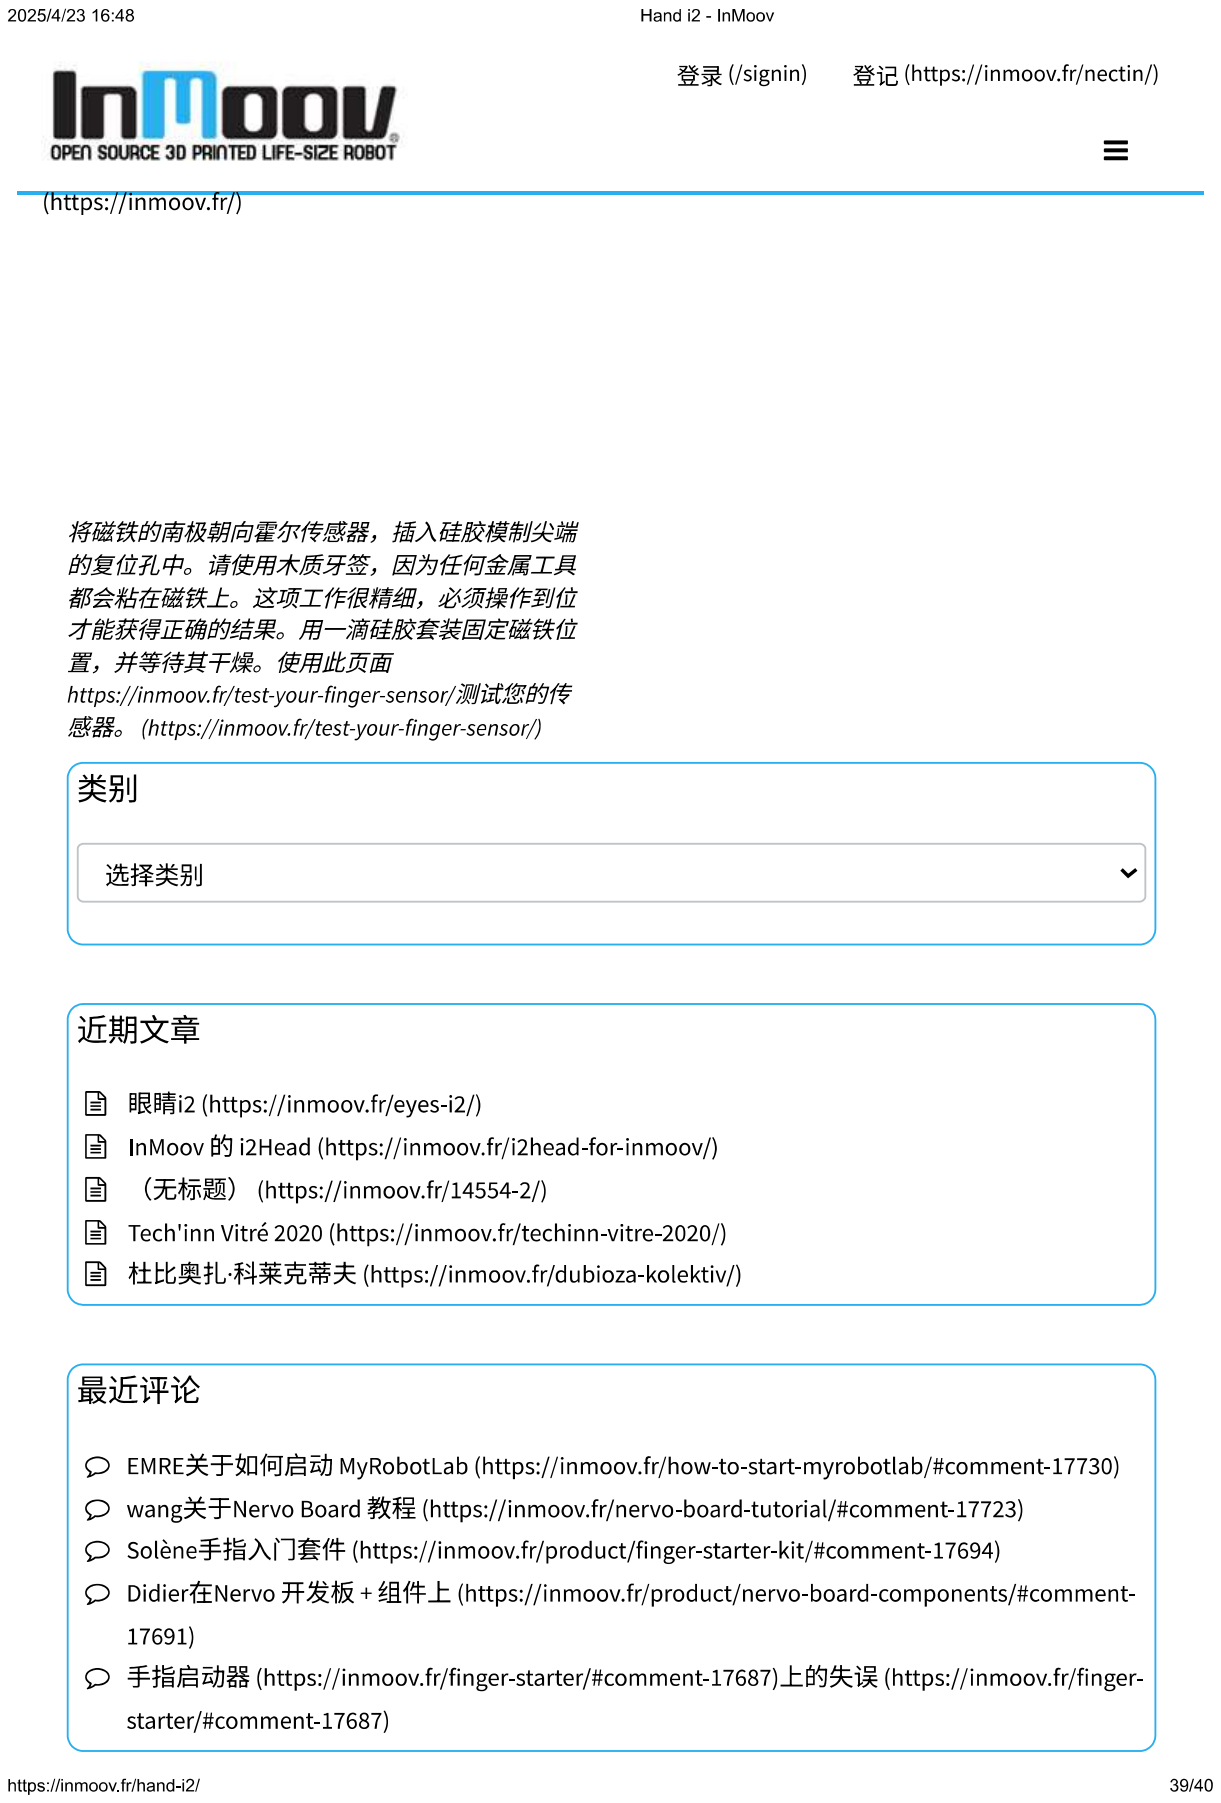
[picture p376: page 39]
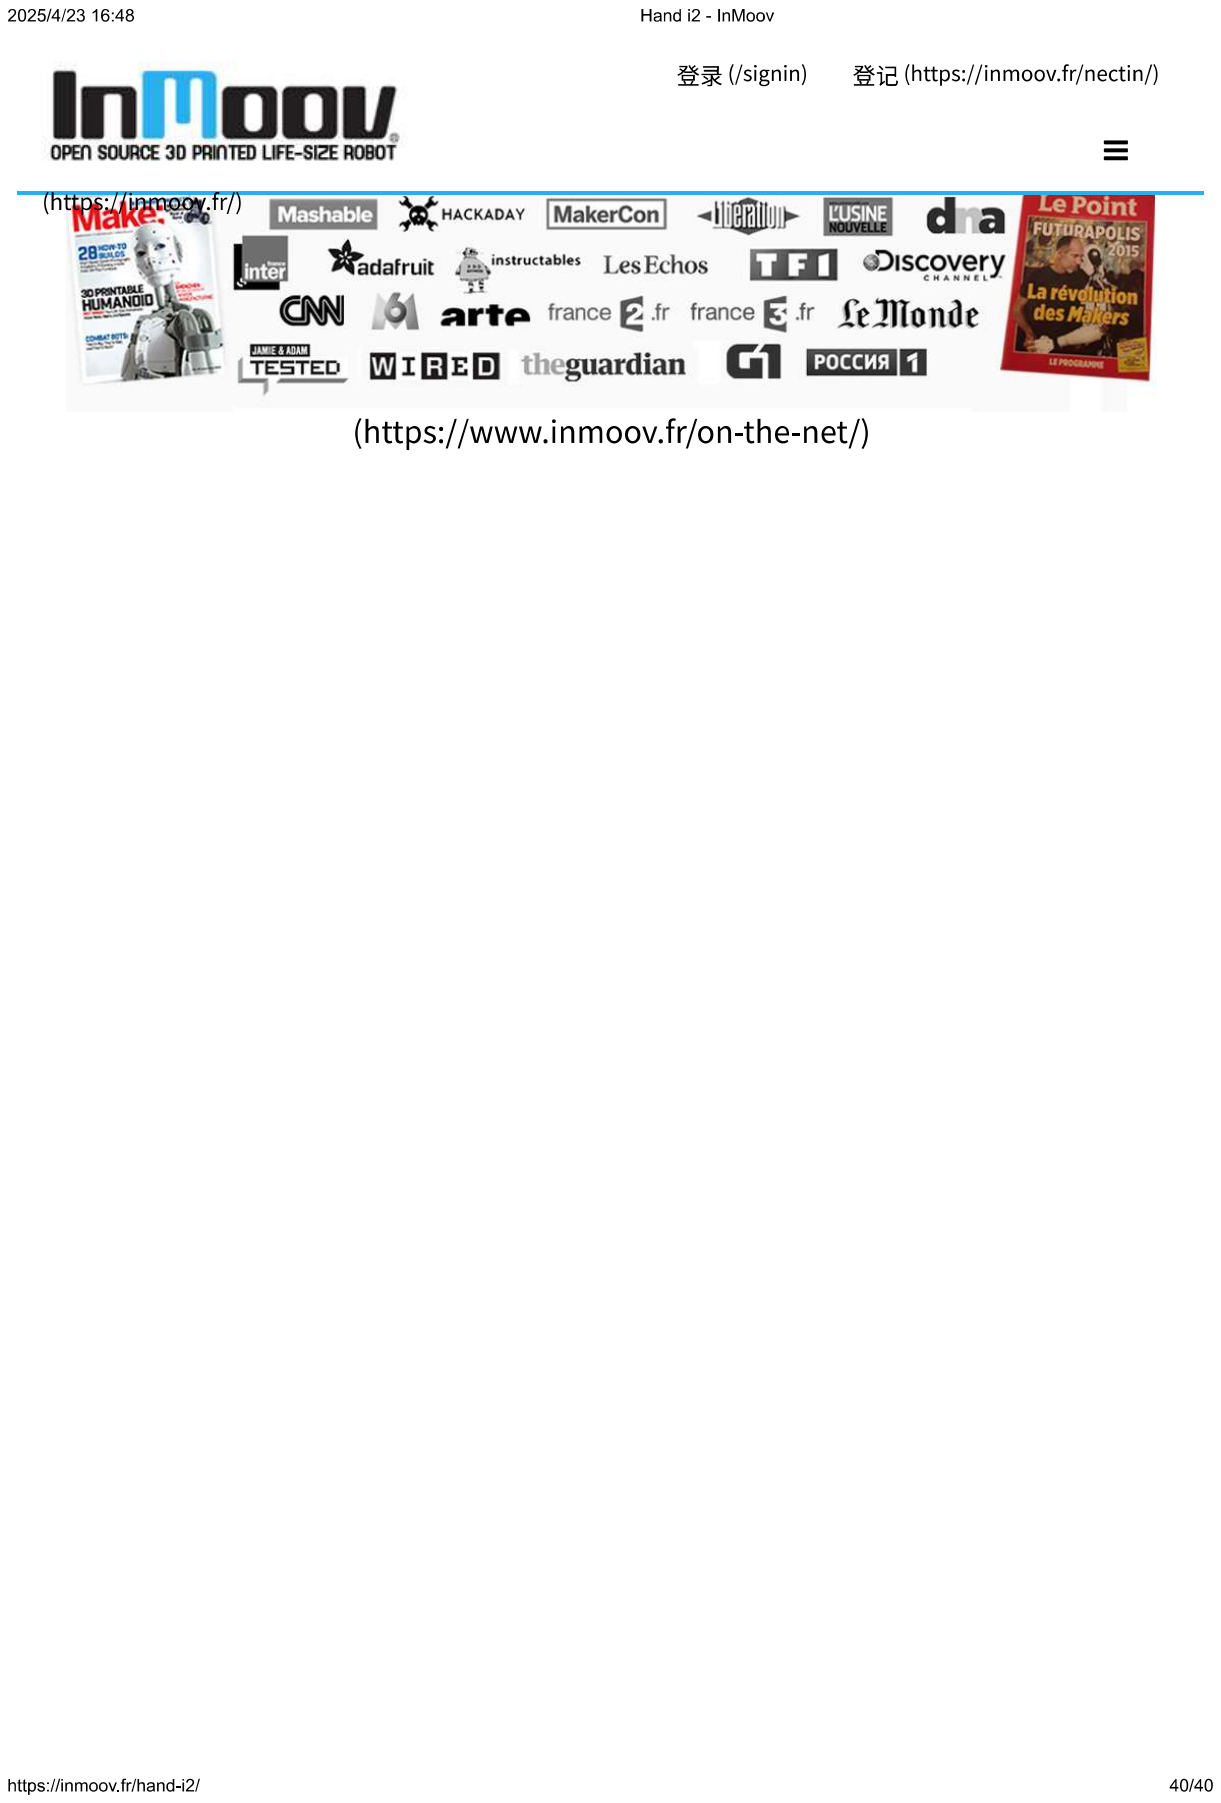
[picture p377: page 40]
