idolverse/Tulingjiuge_robot_1/零件组装教程+stl文件/Head_i2-main/Head-i2教程.pdf

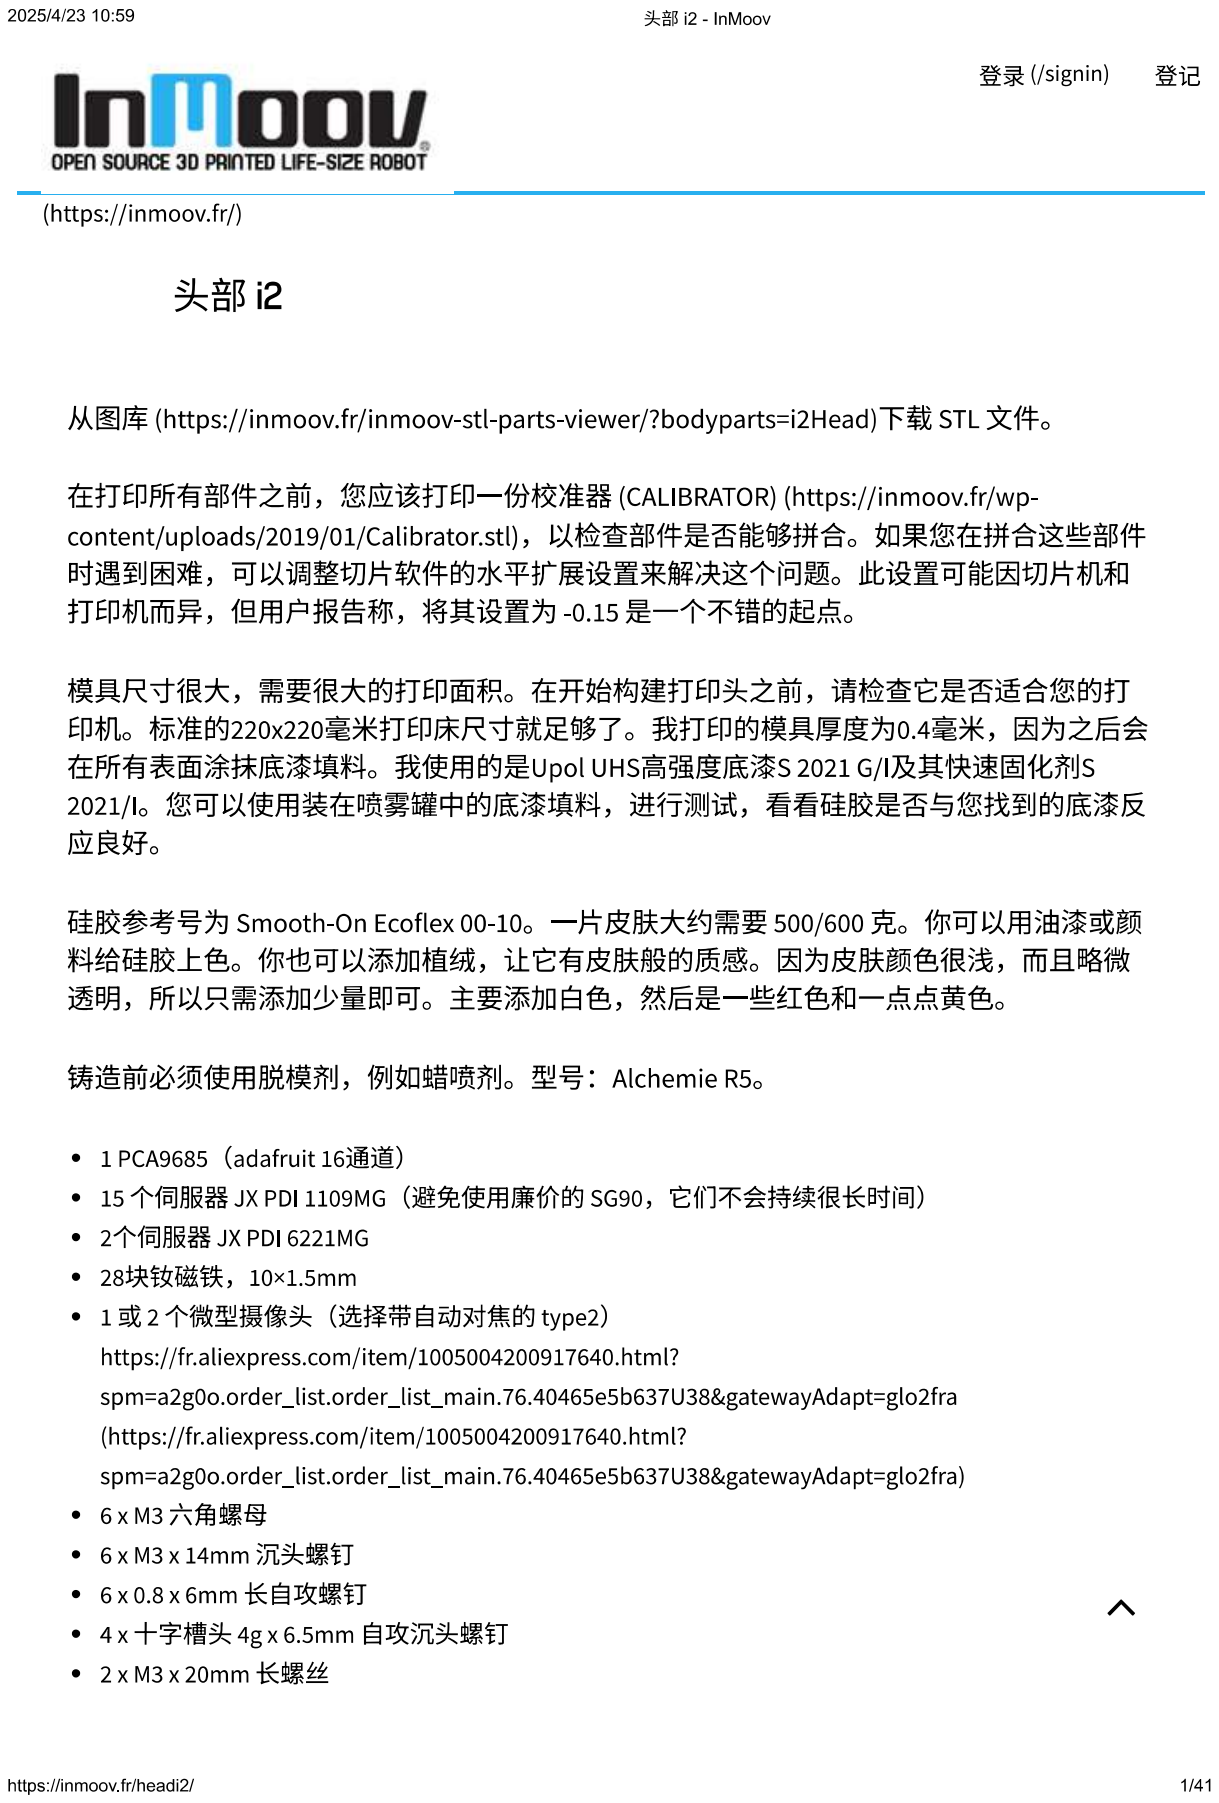
[picture p378: page 1]
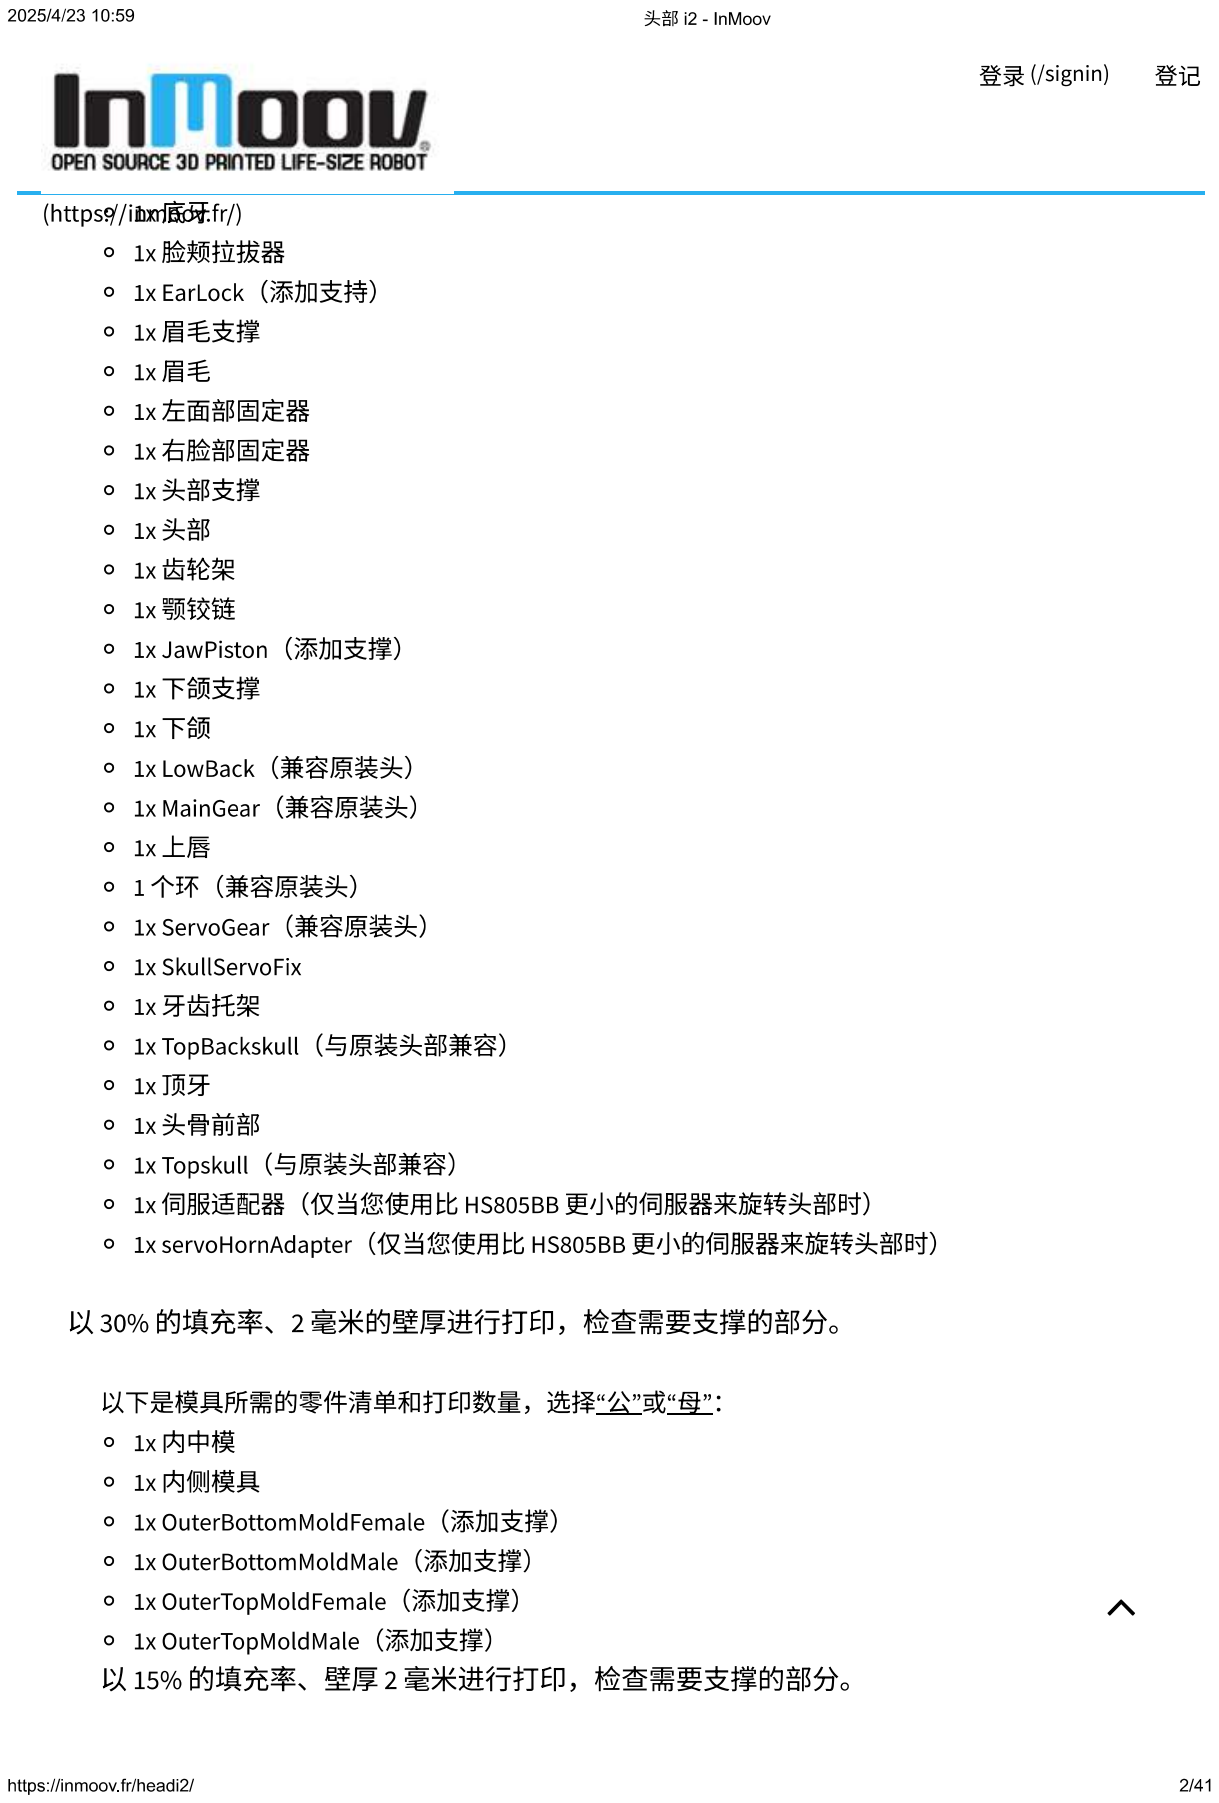
[picture p379: page 2]
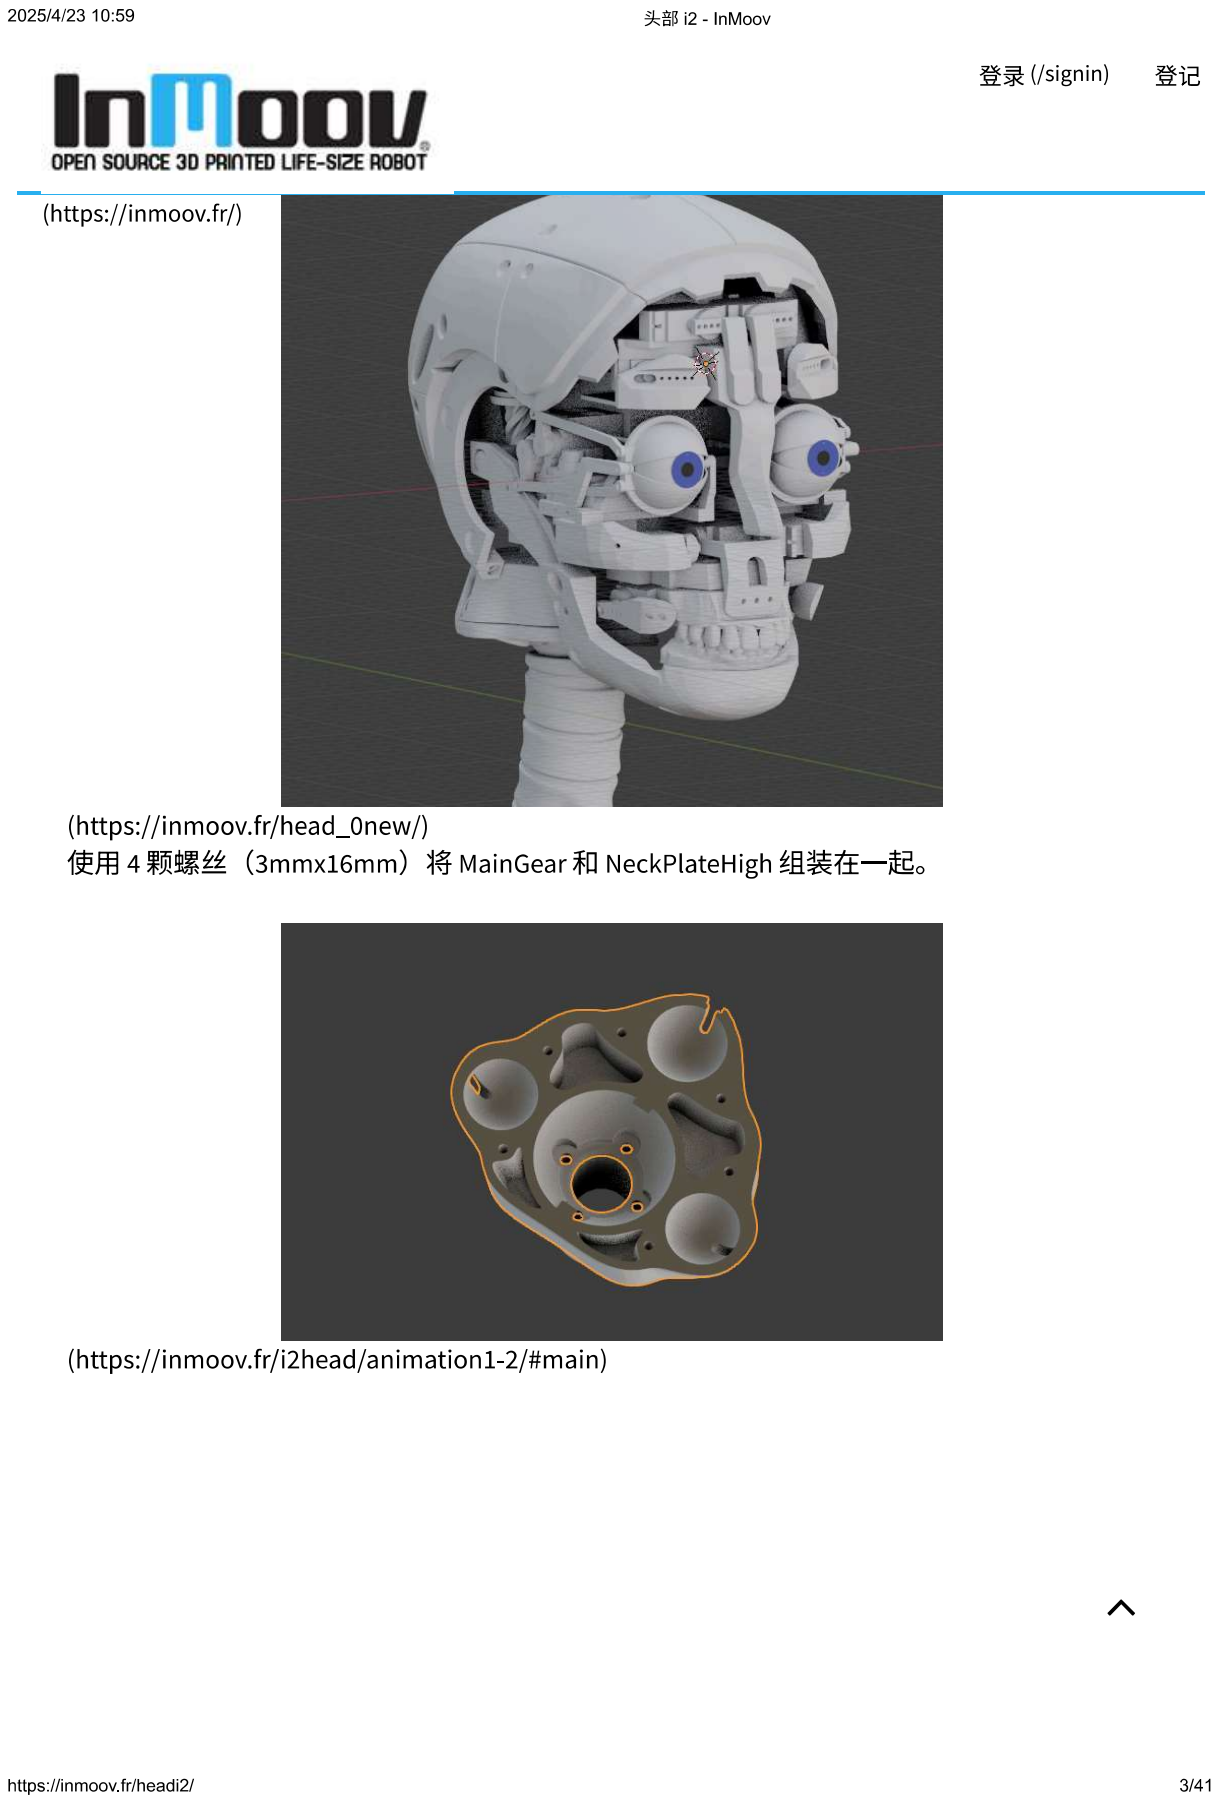
[picture p380: page 3]
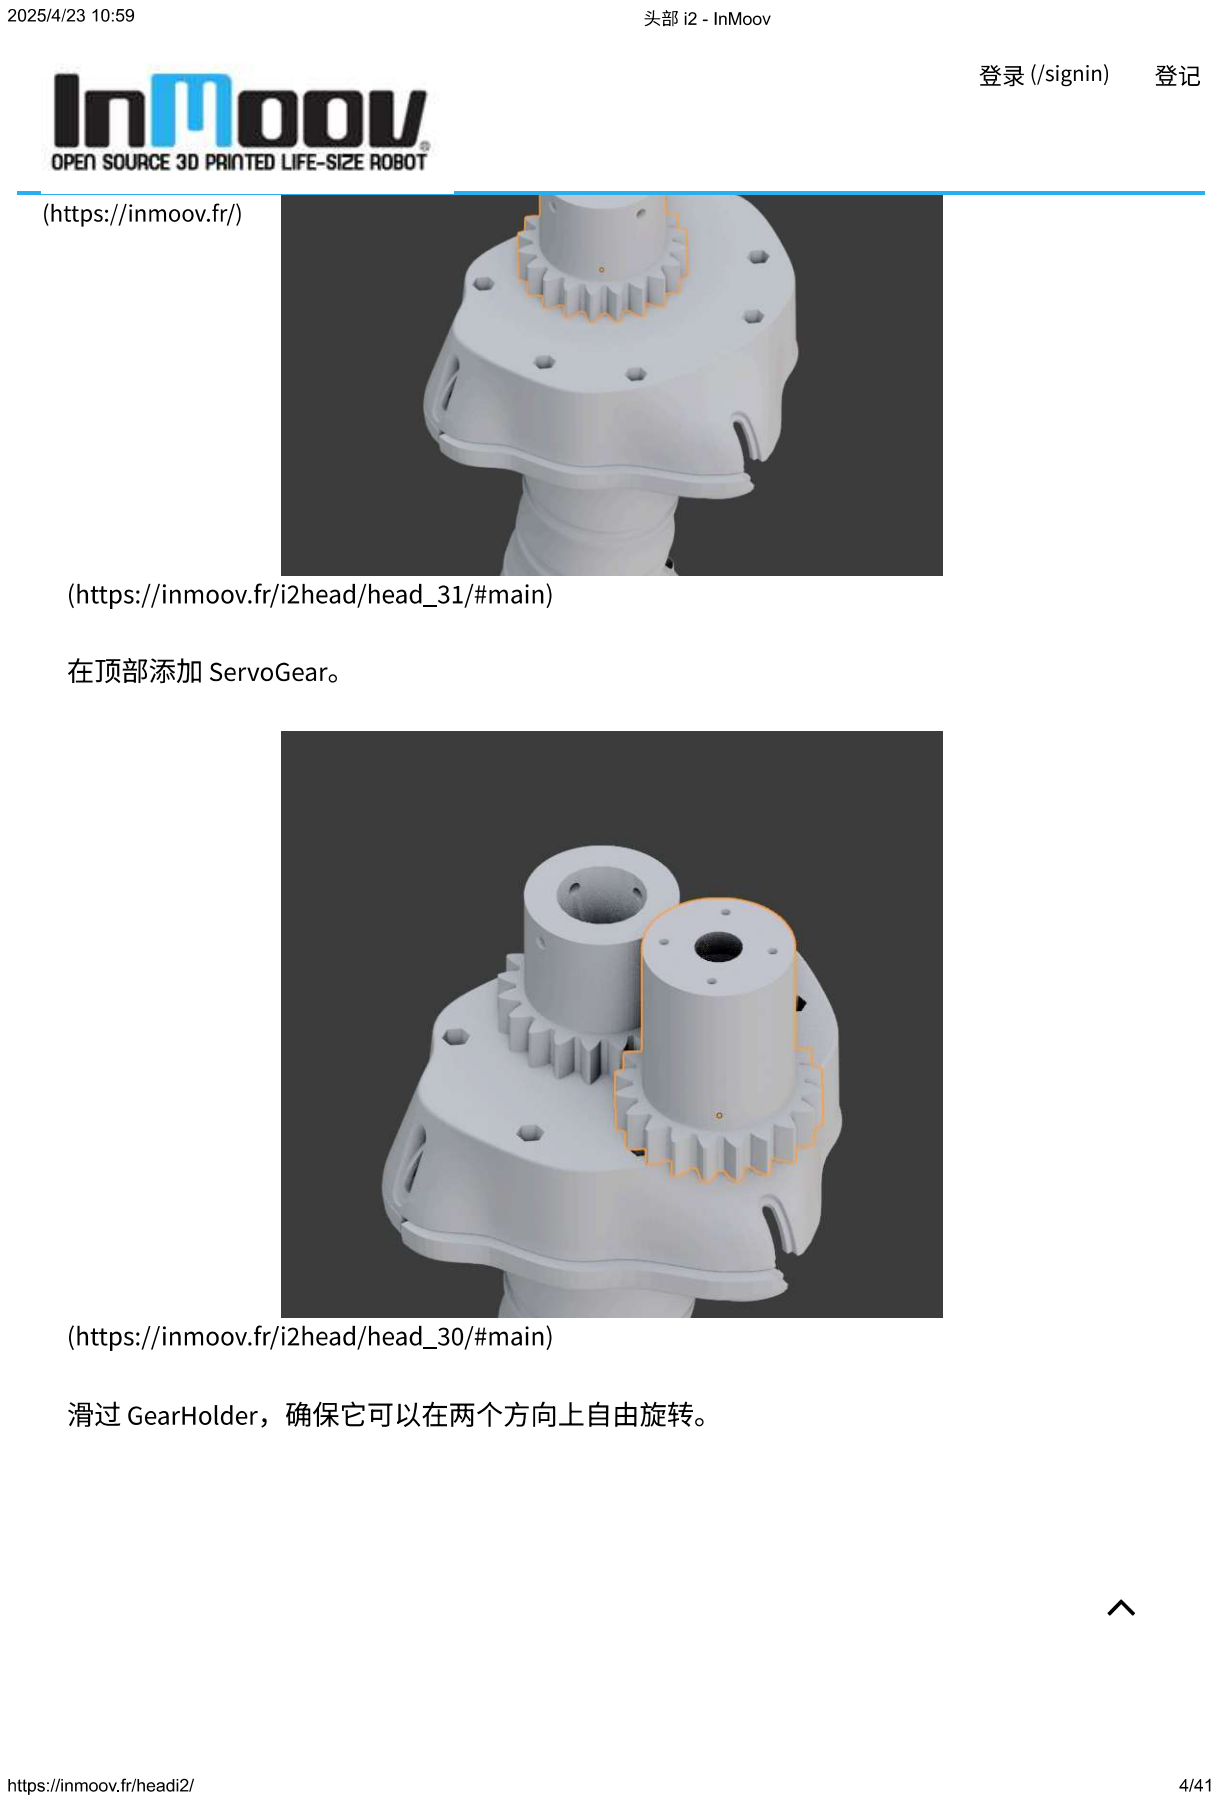
[picture p381: page 4]
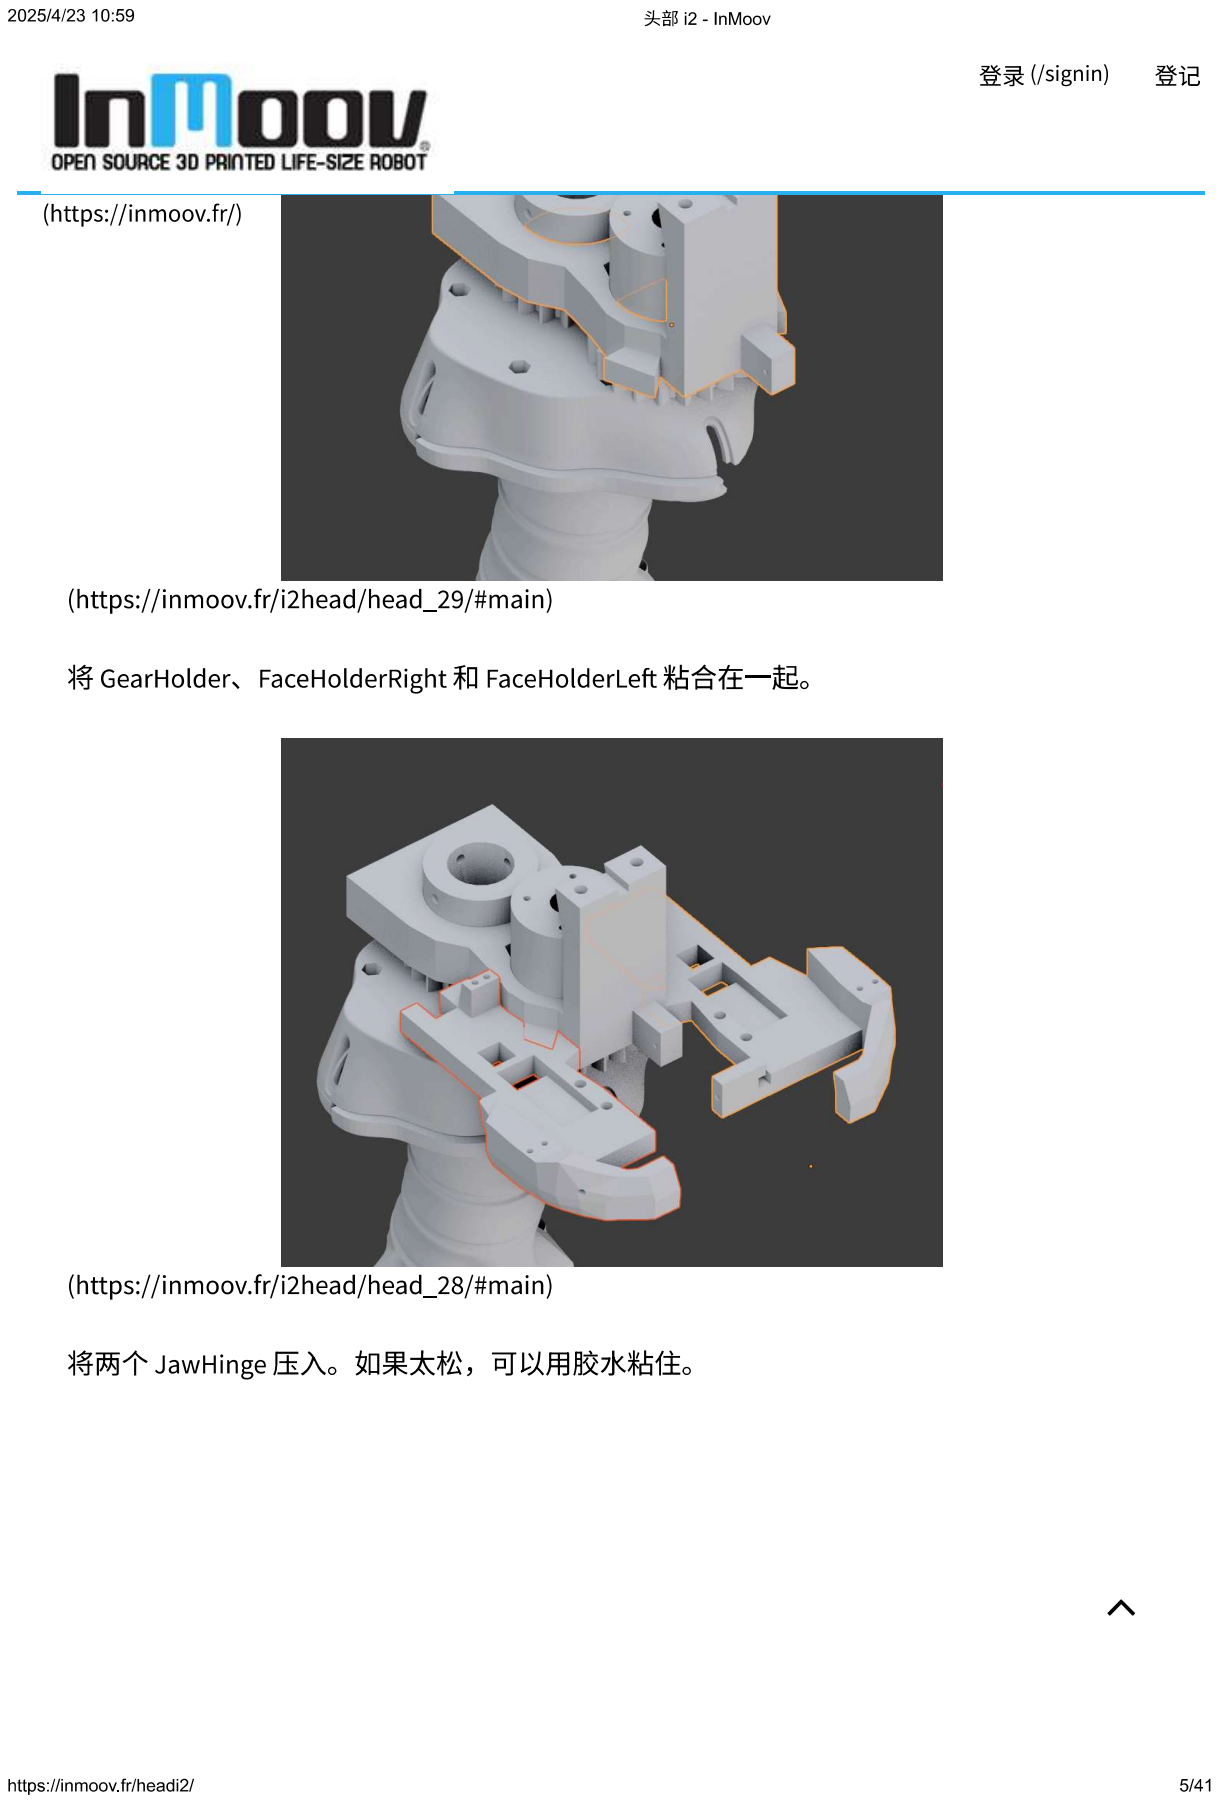
[picture p382: page 5]
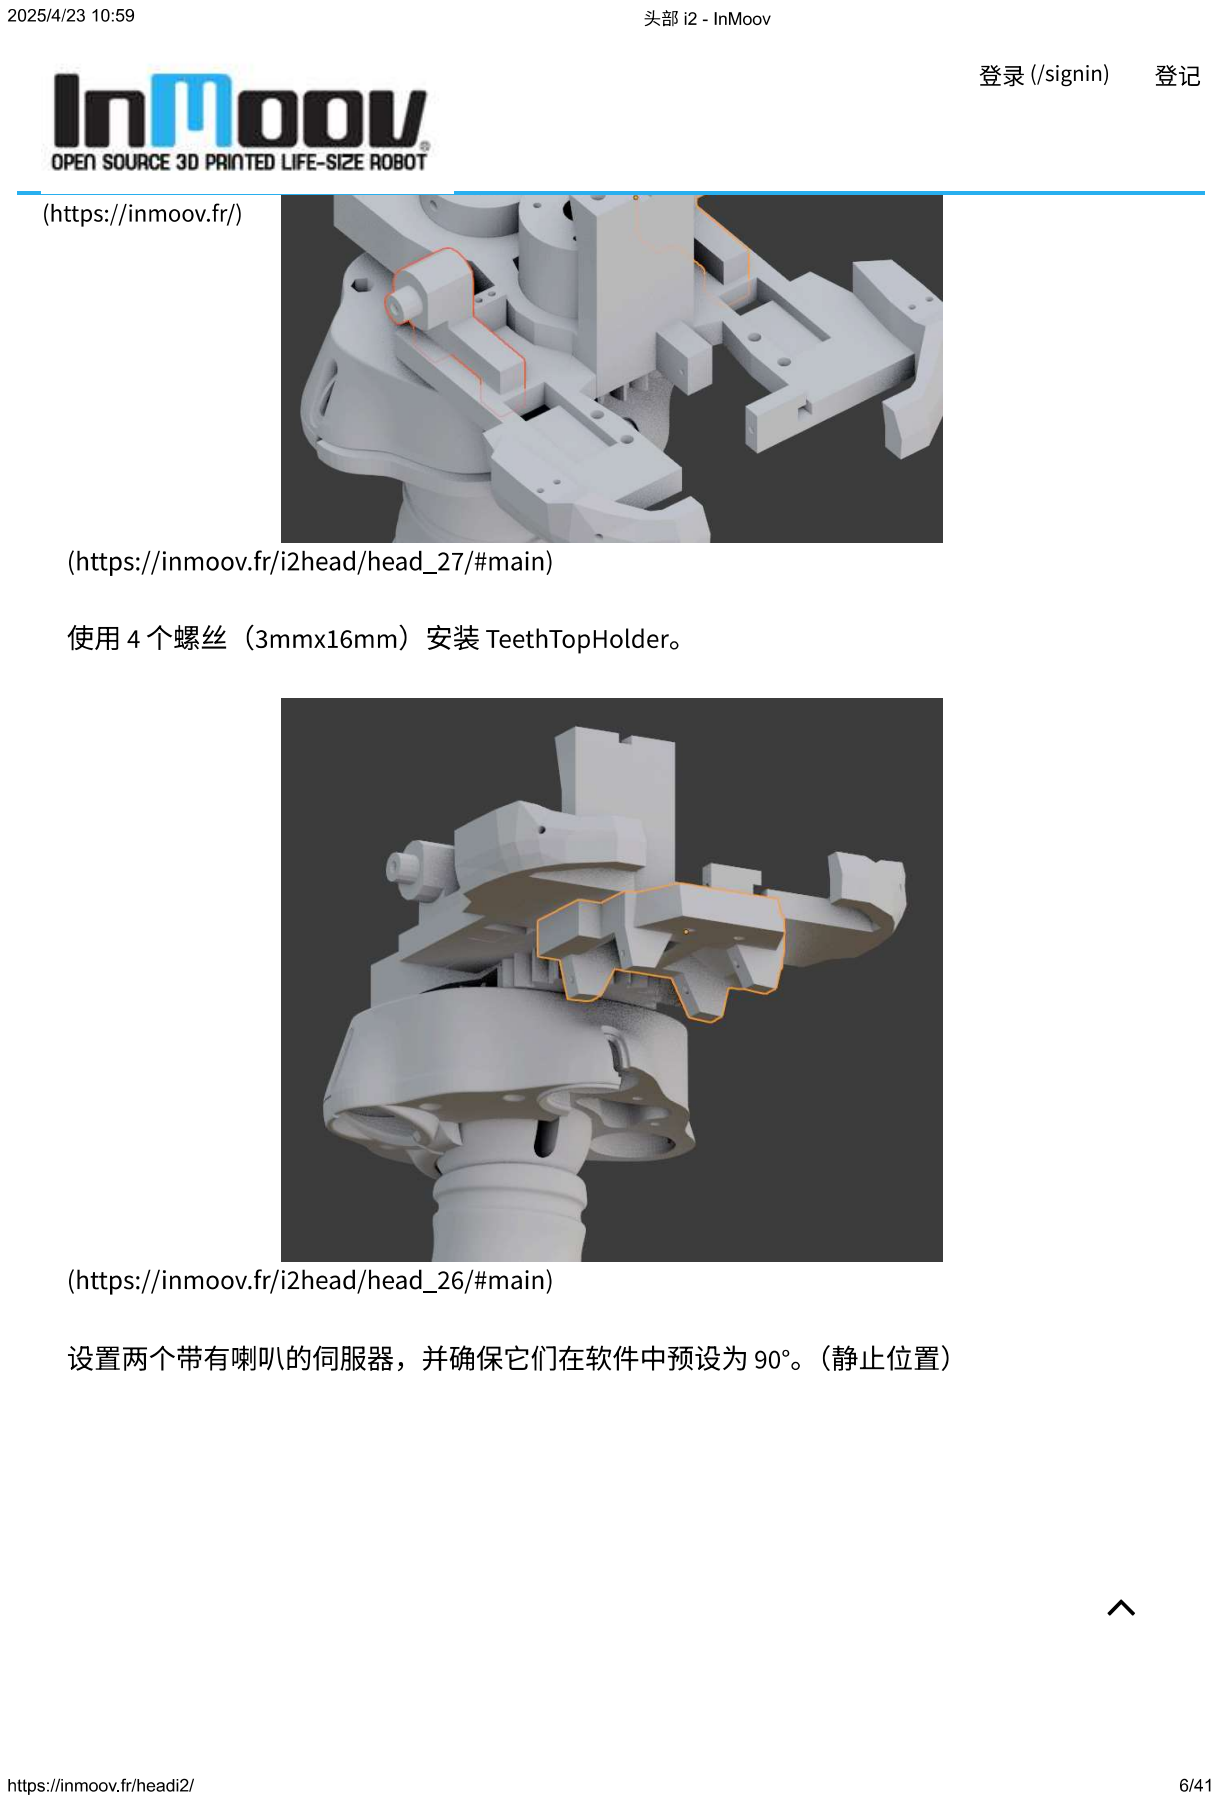
[picture p383: page 6]
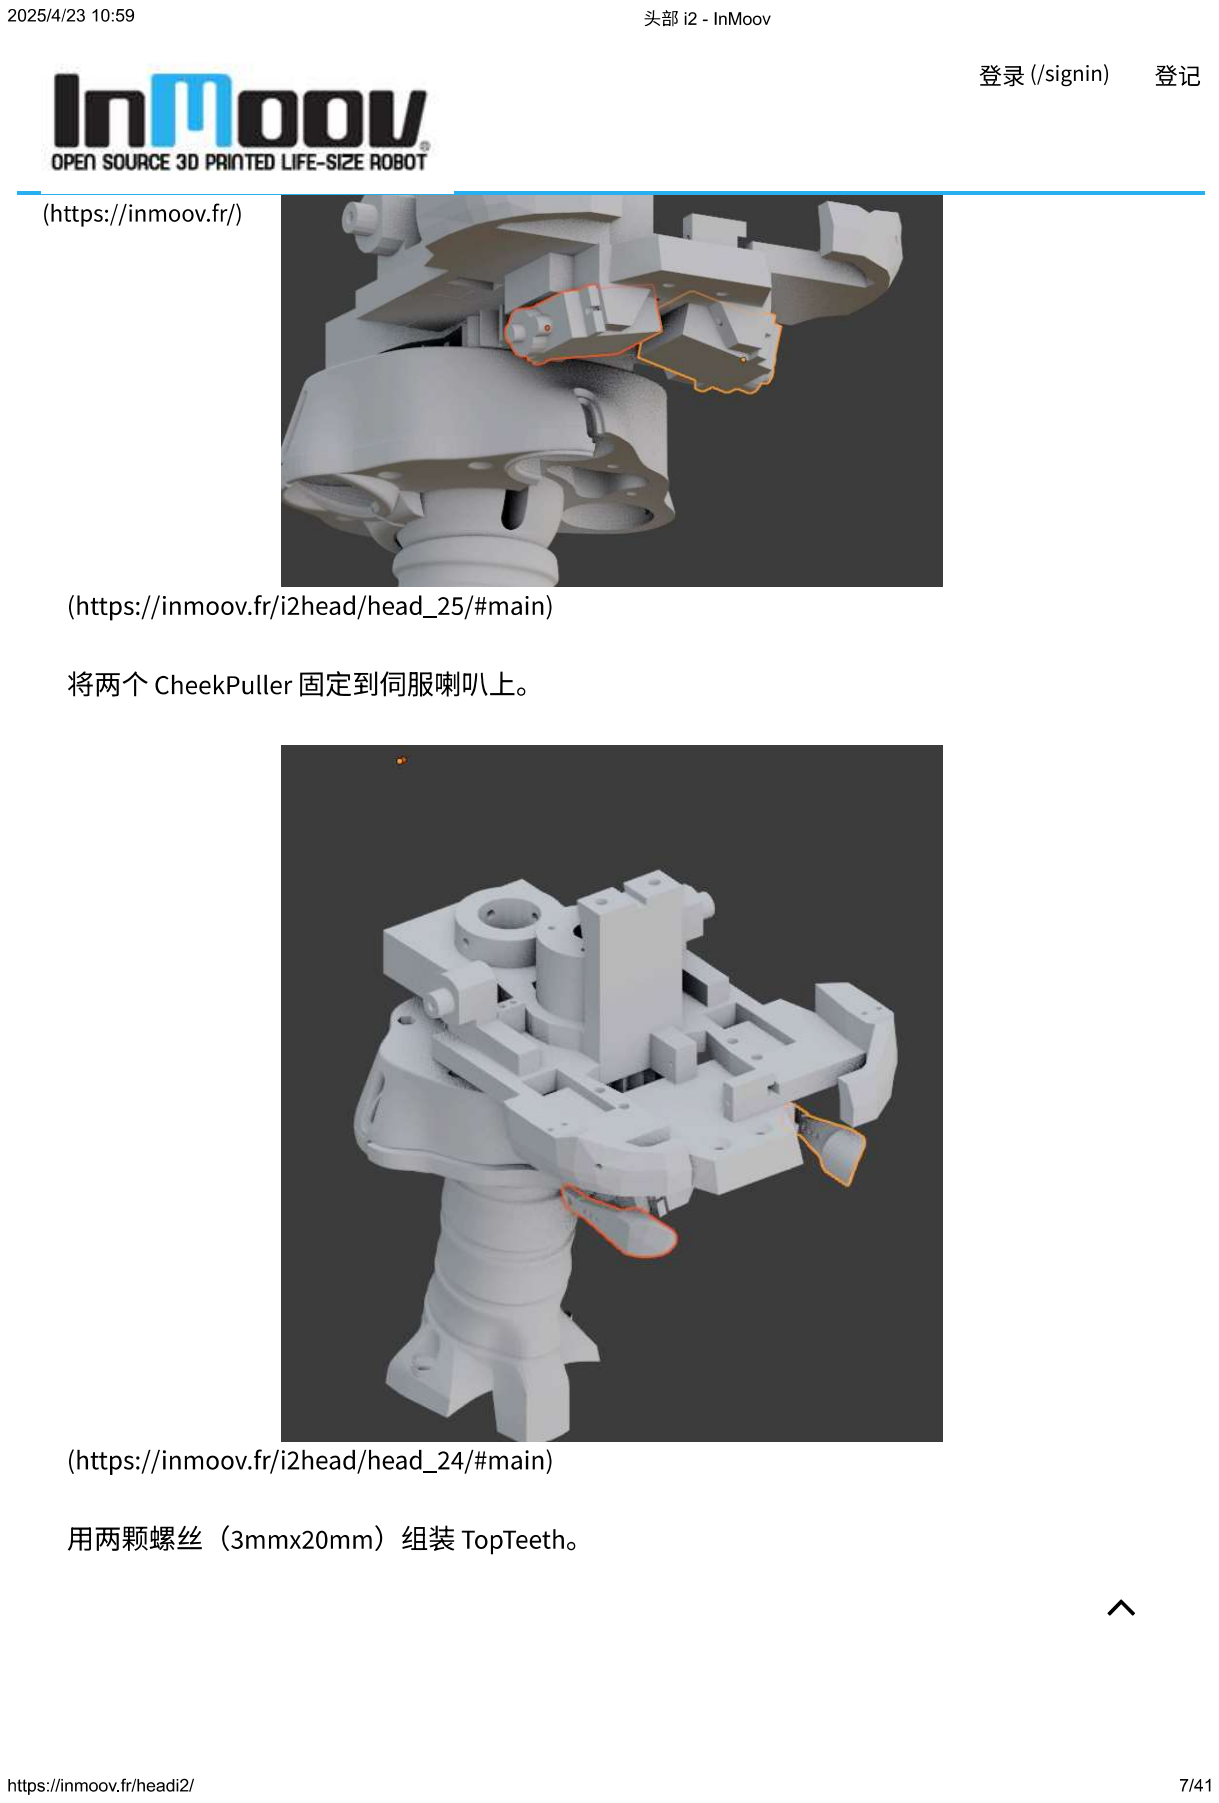
[picture p384: page 7]
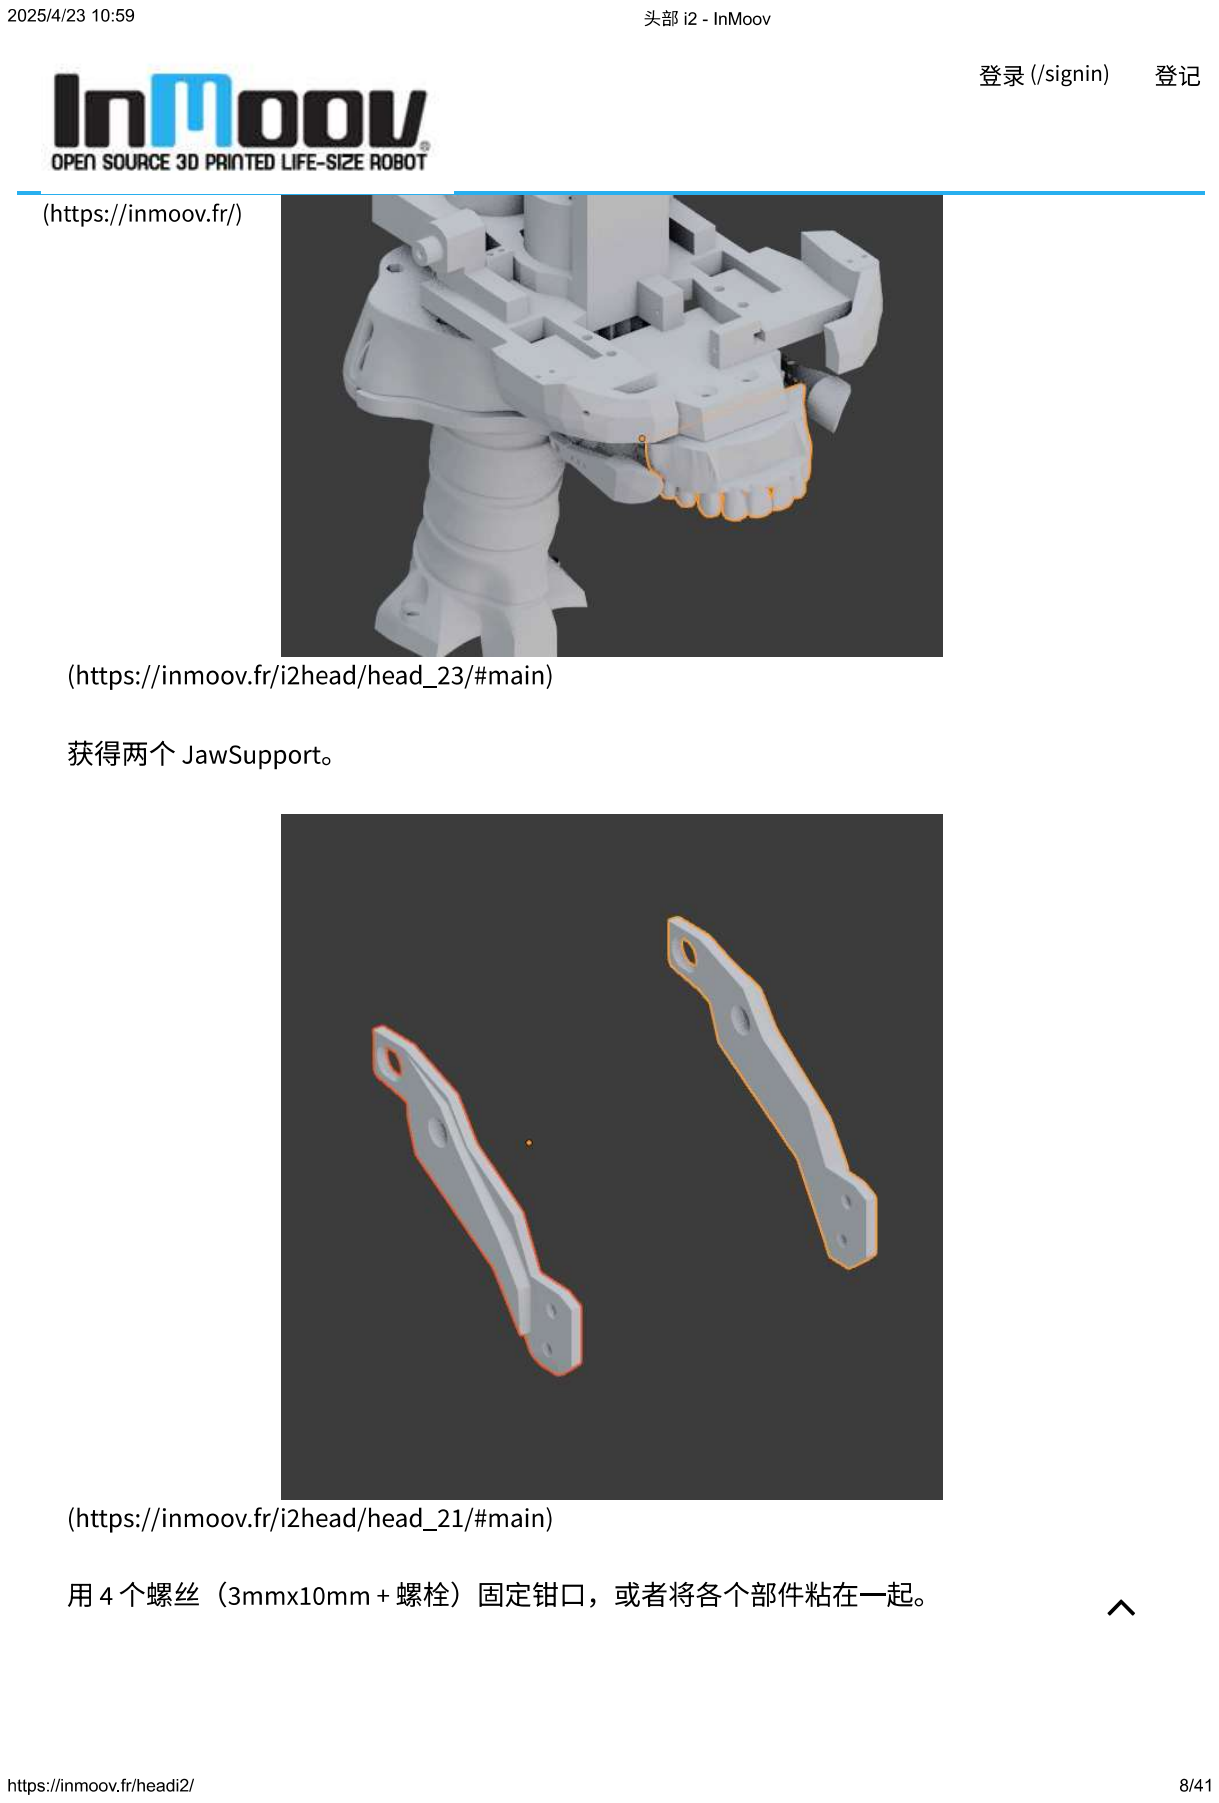
[picture p385: page 8]
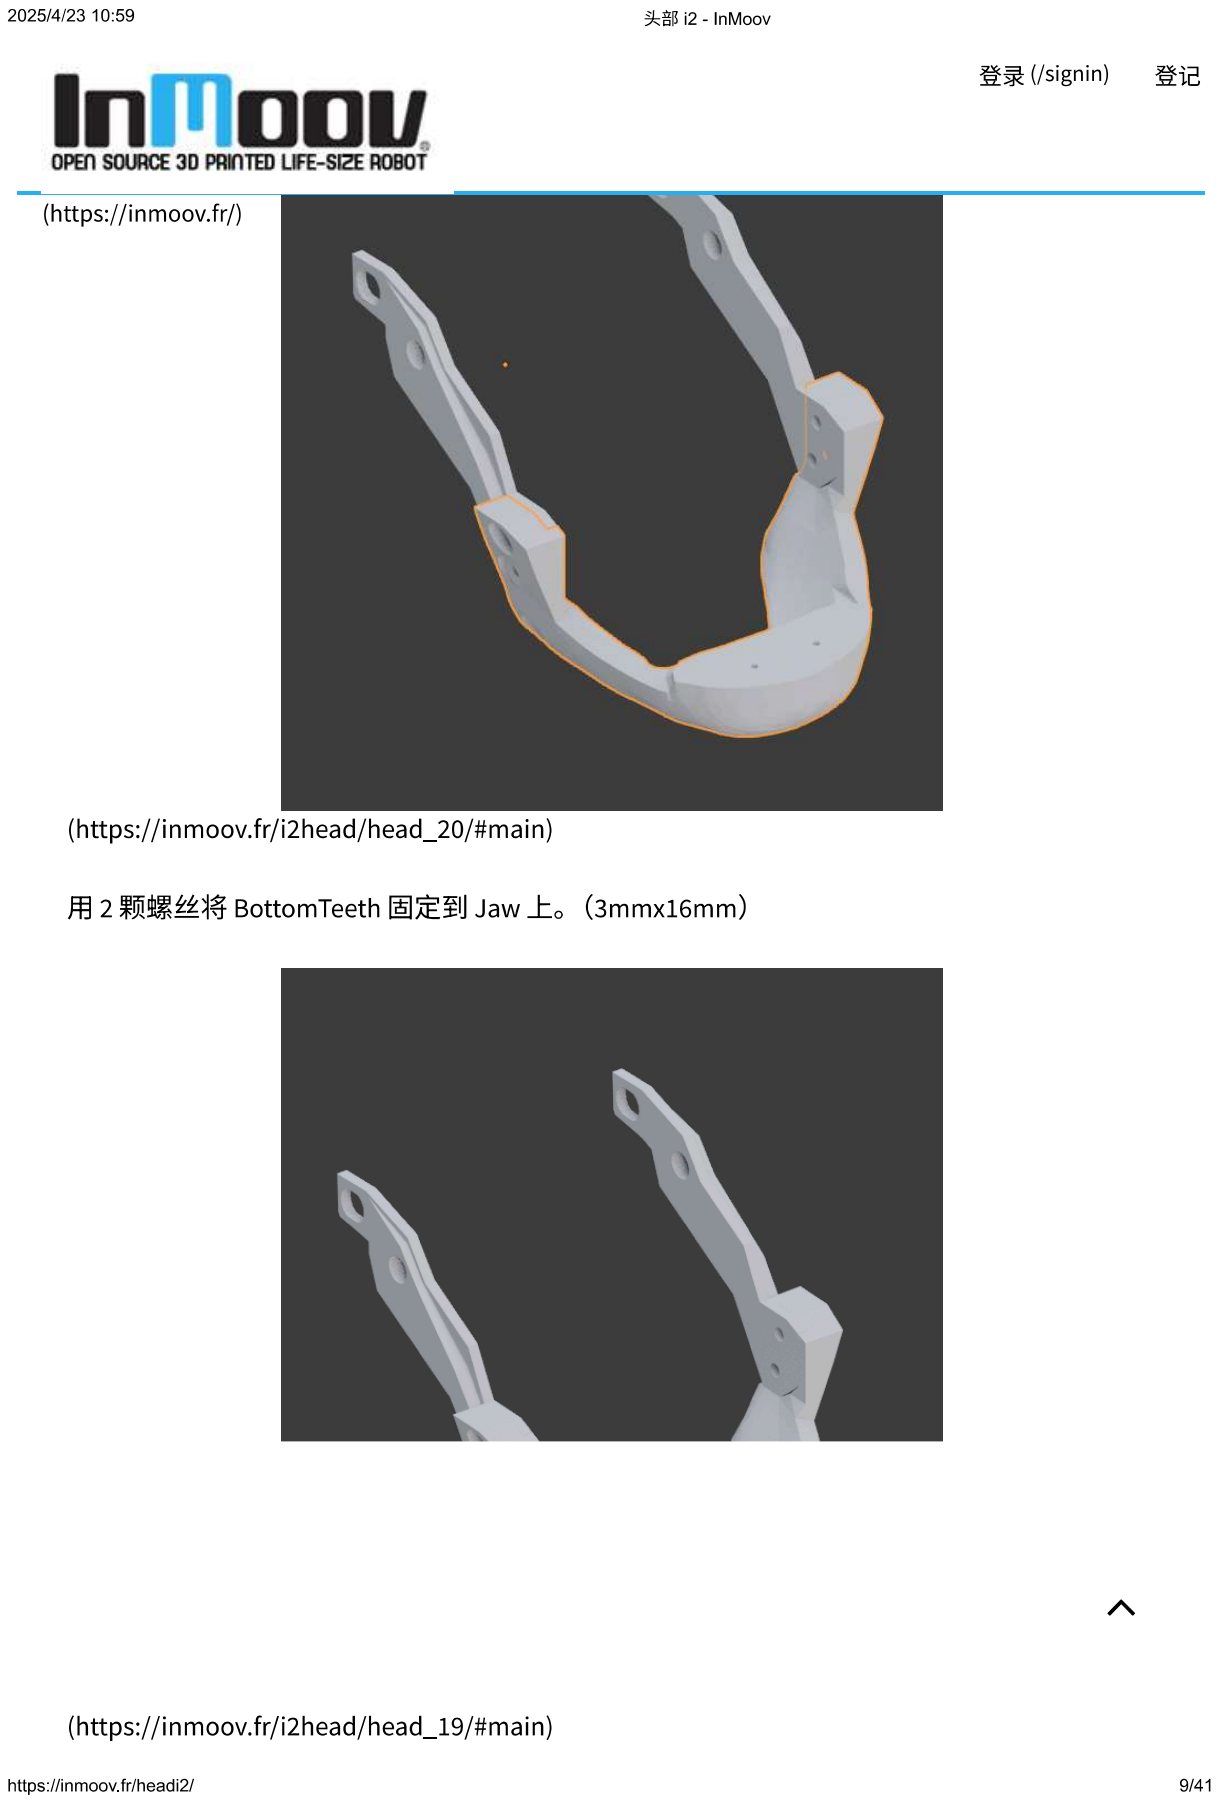
[picture p386: page 9]
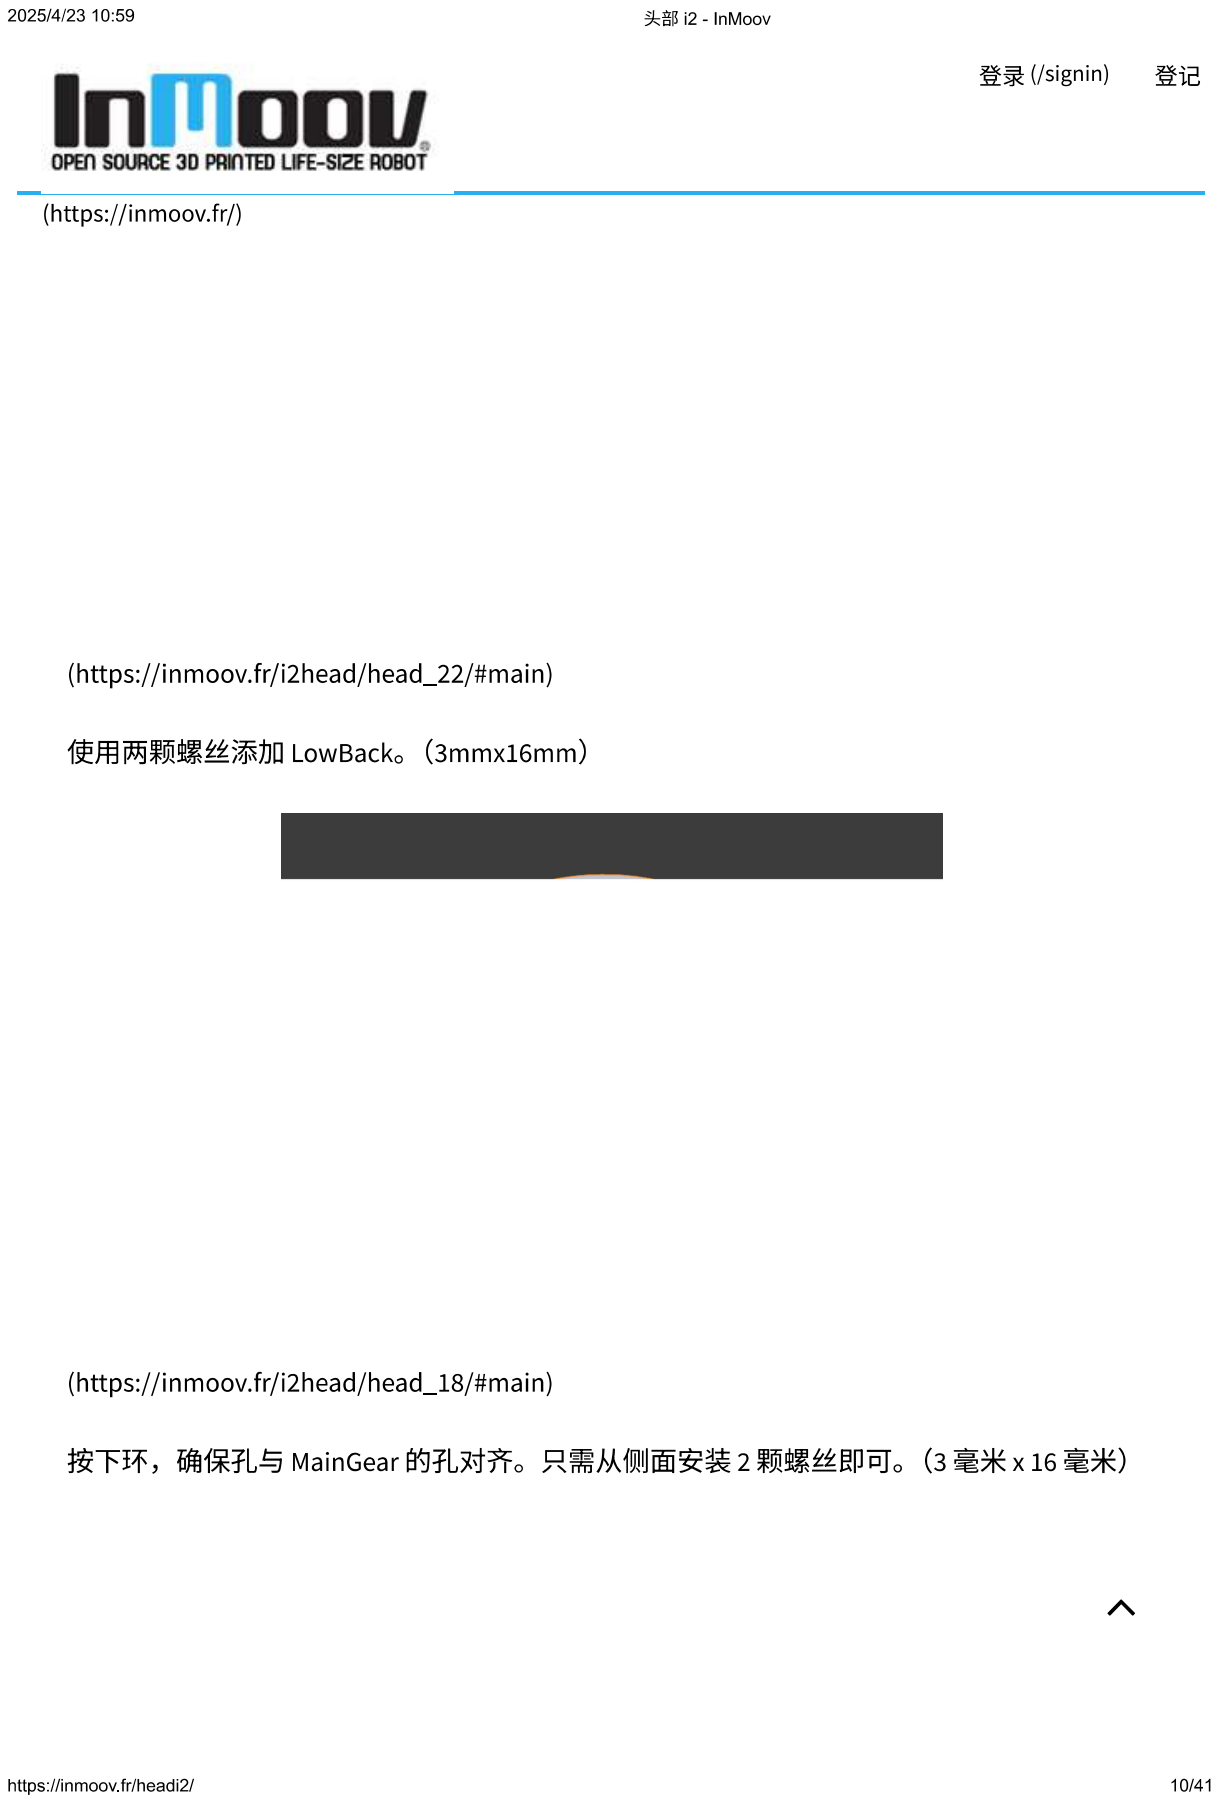
[picture p387: page 10]
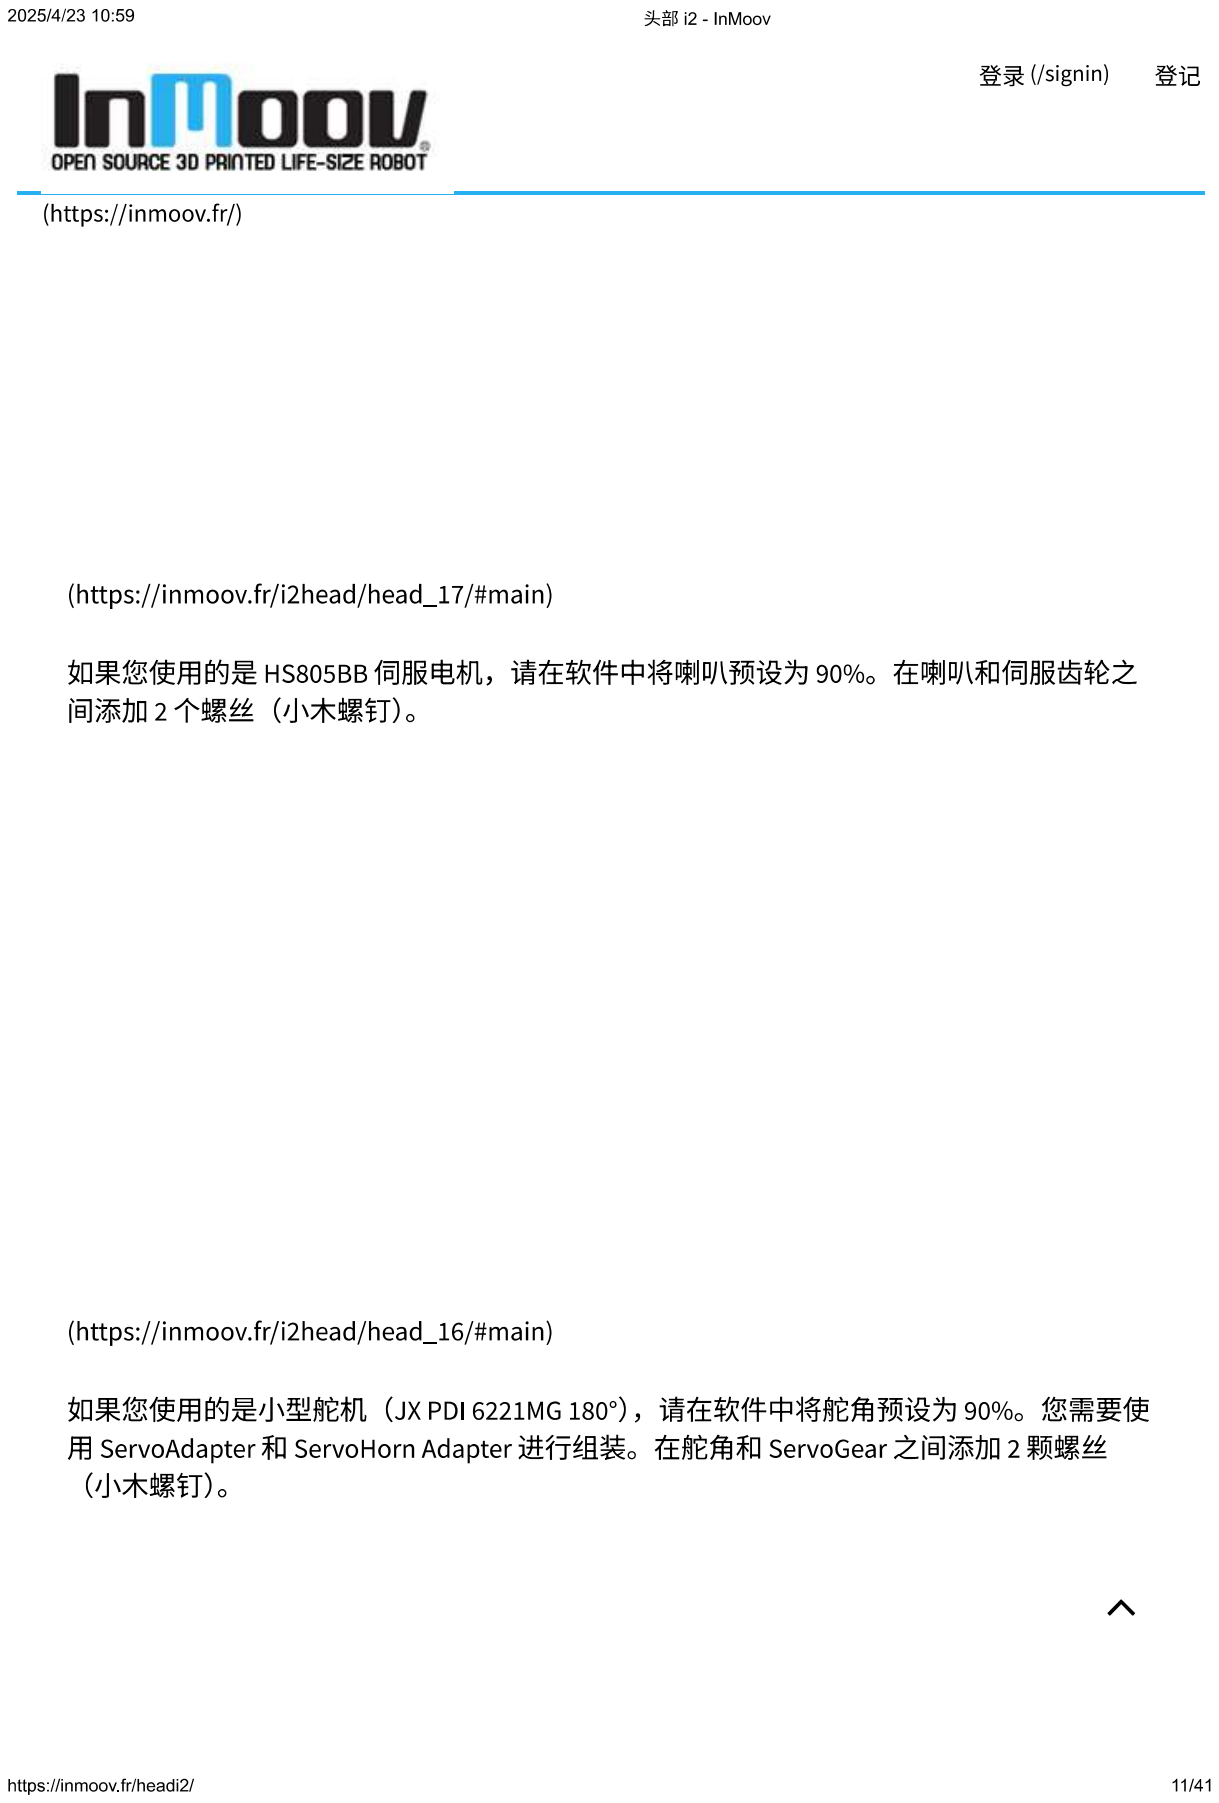
[picture p388: page 11]
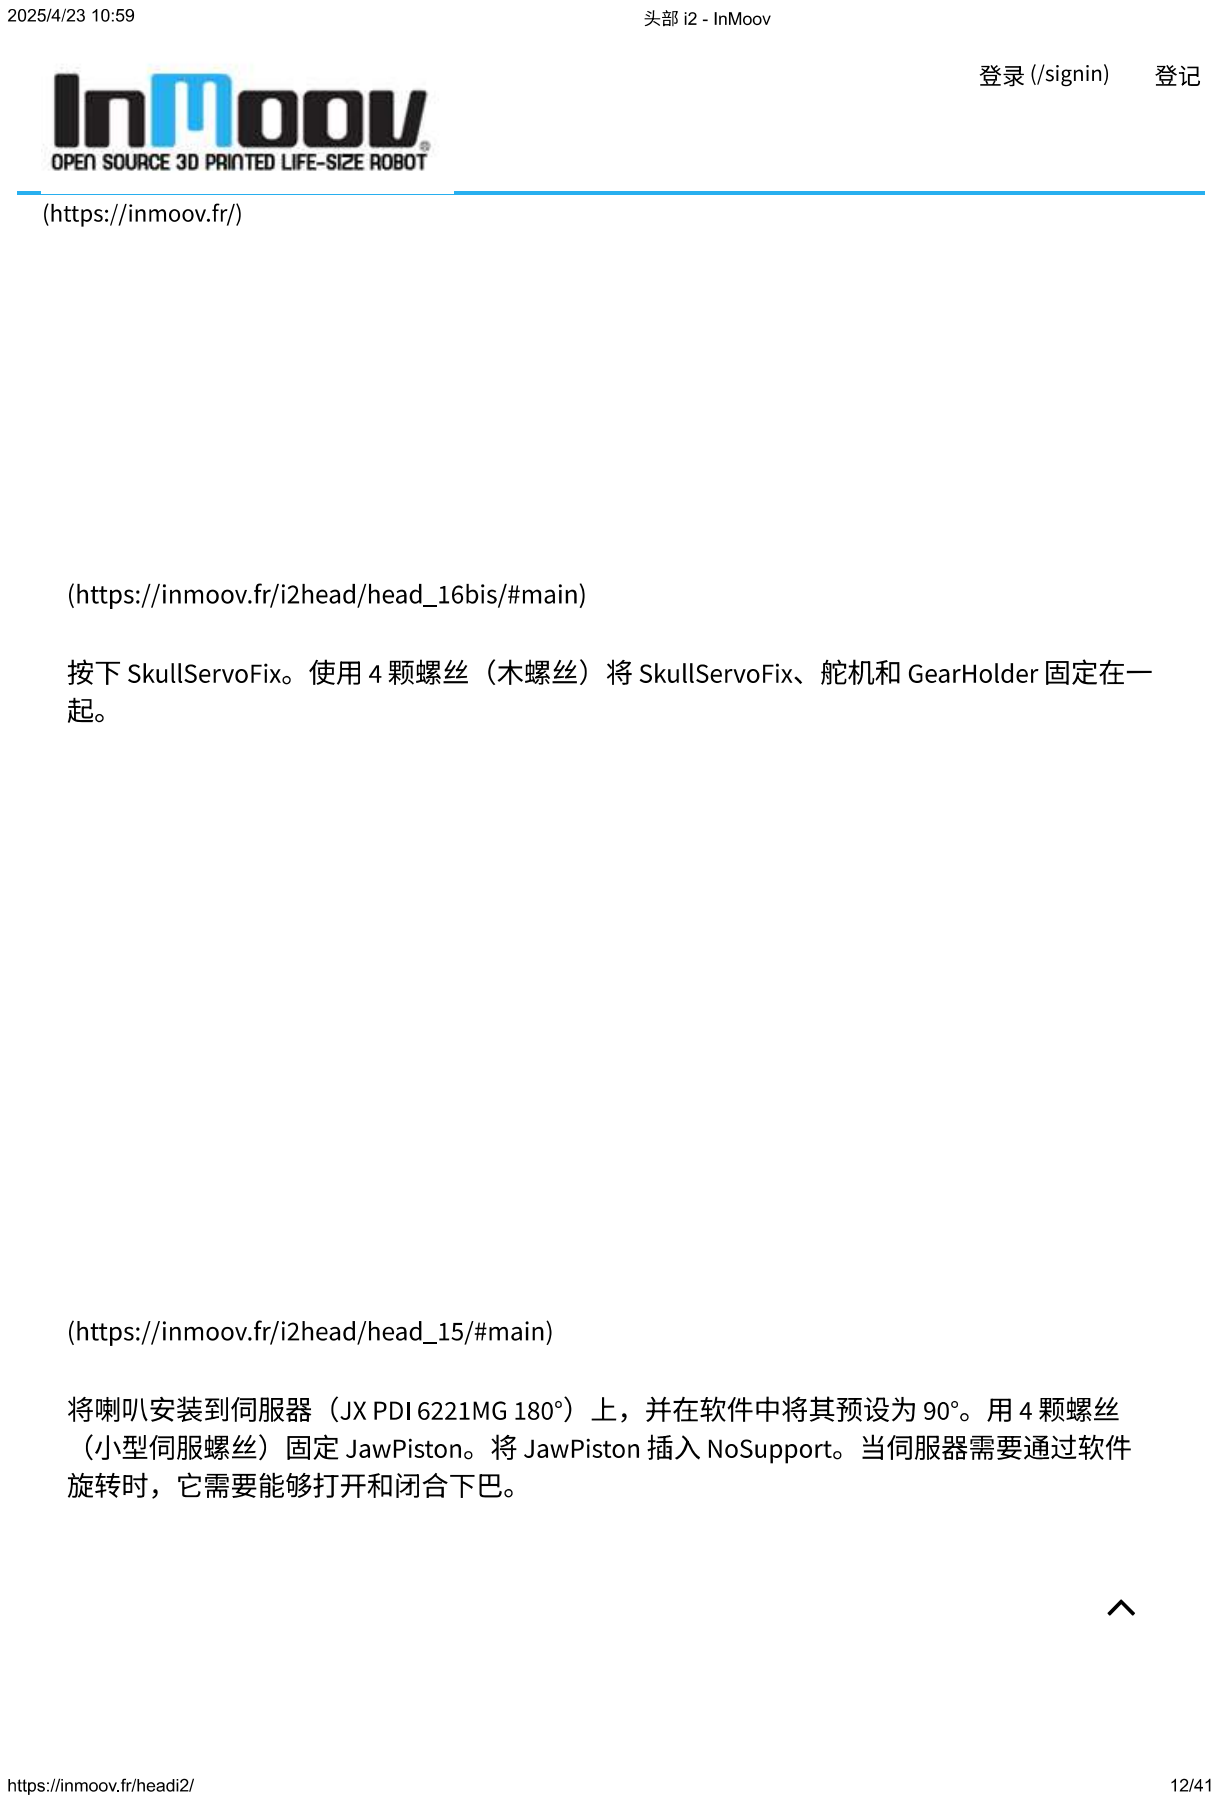
[picture p389: page 12]
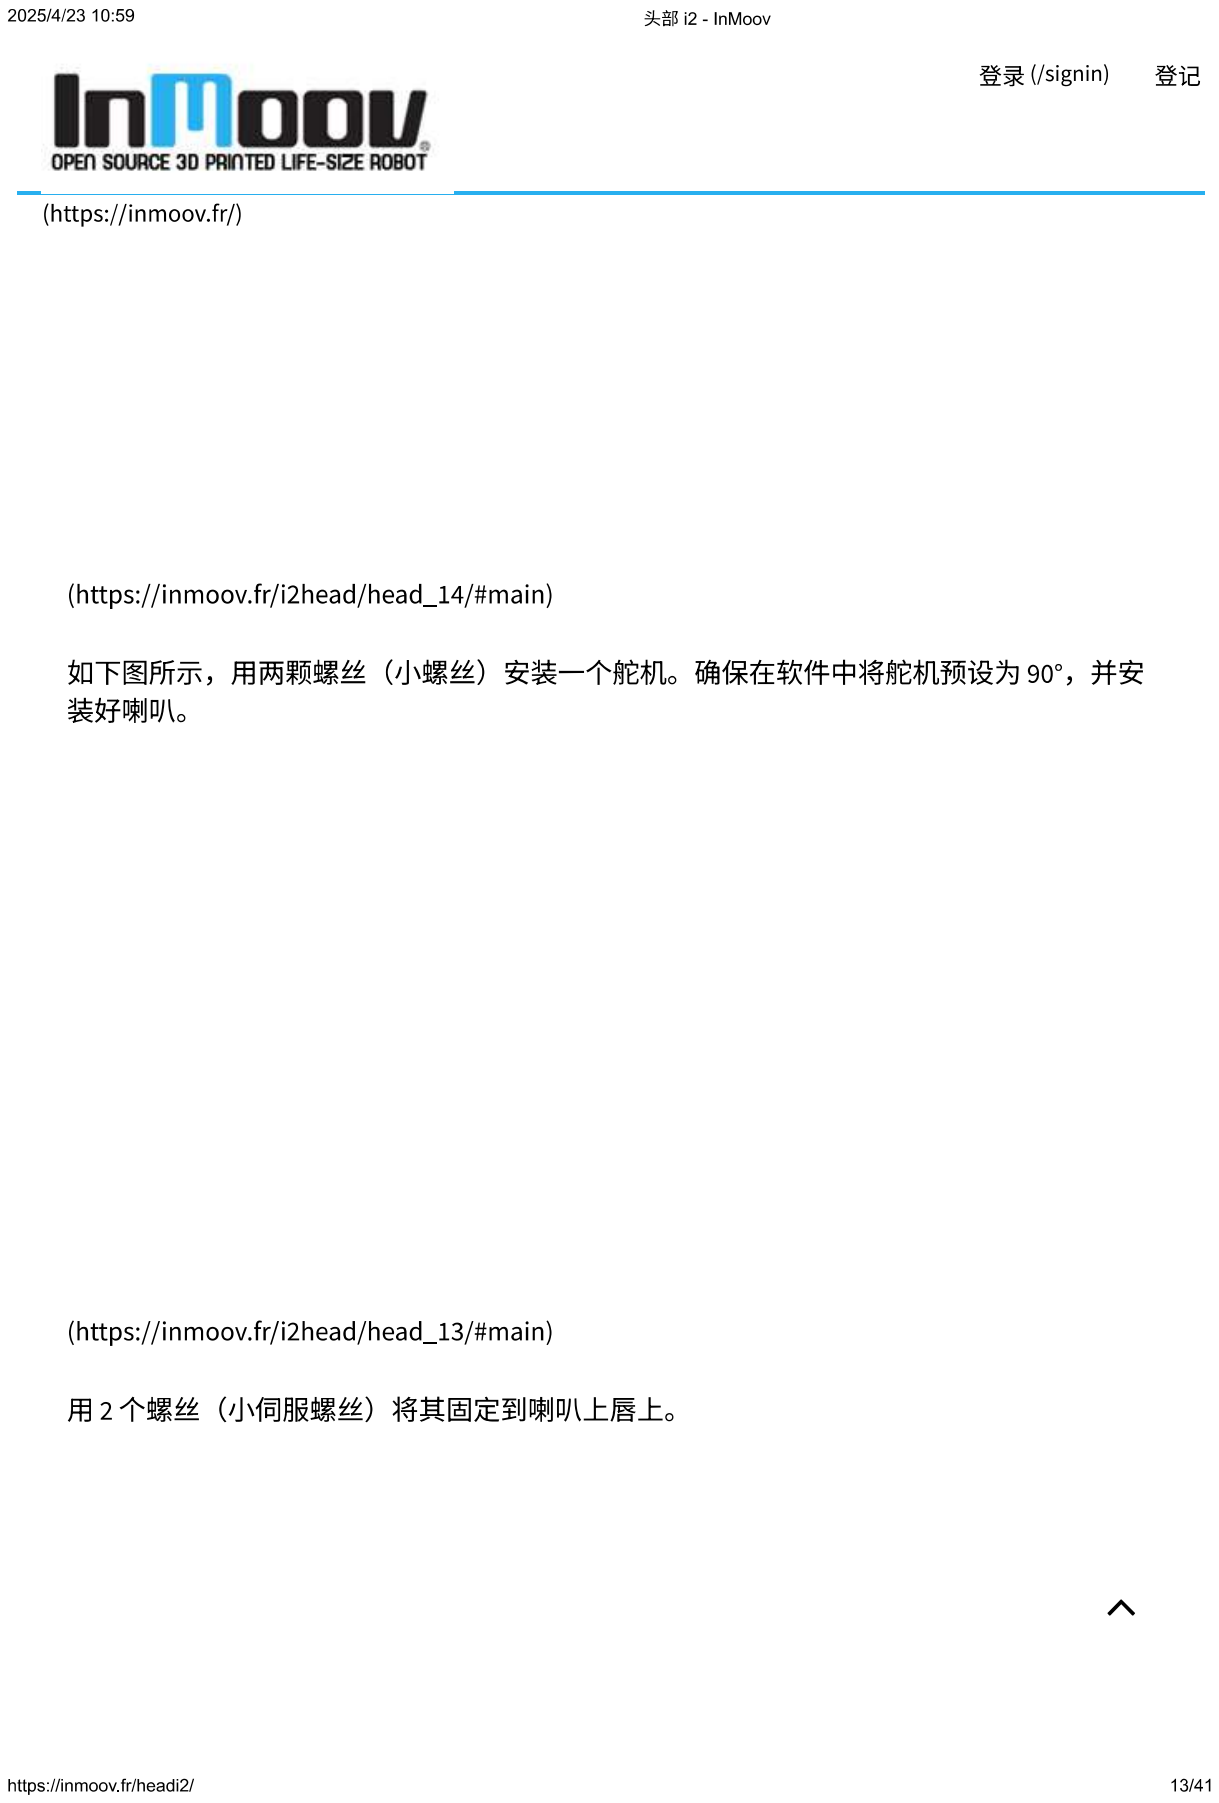
[picture p390: page 13]
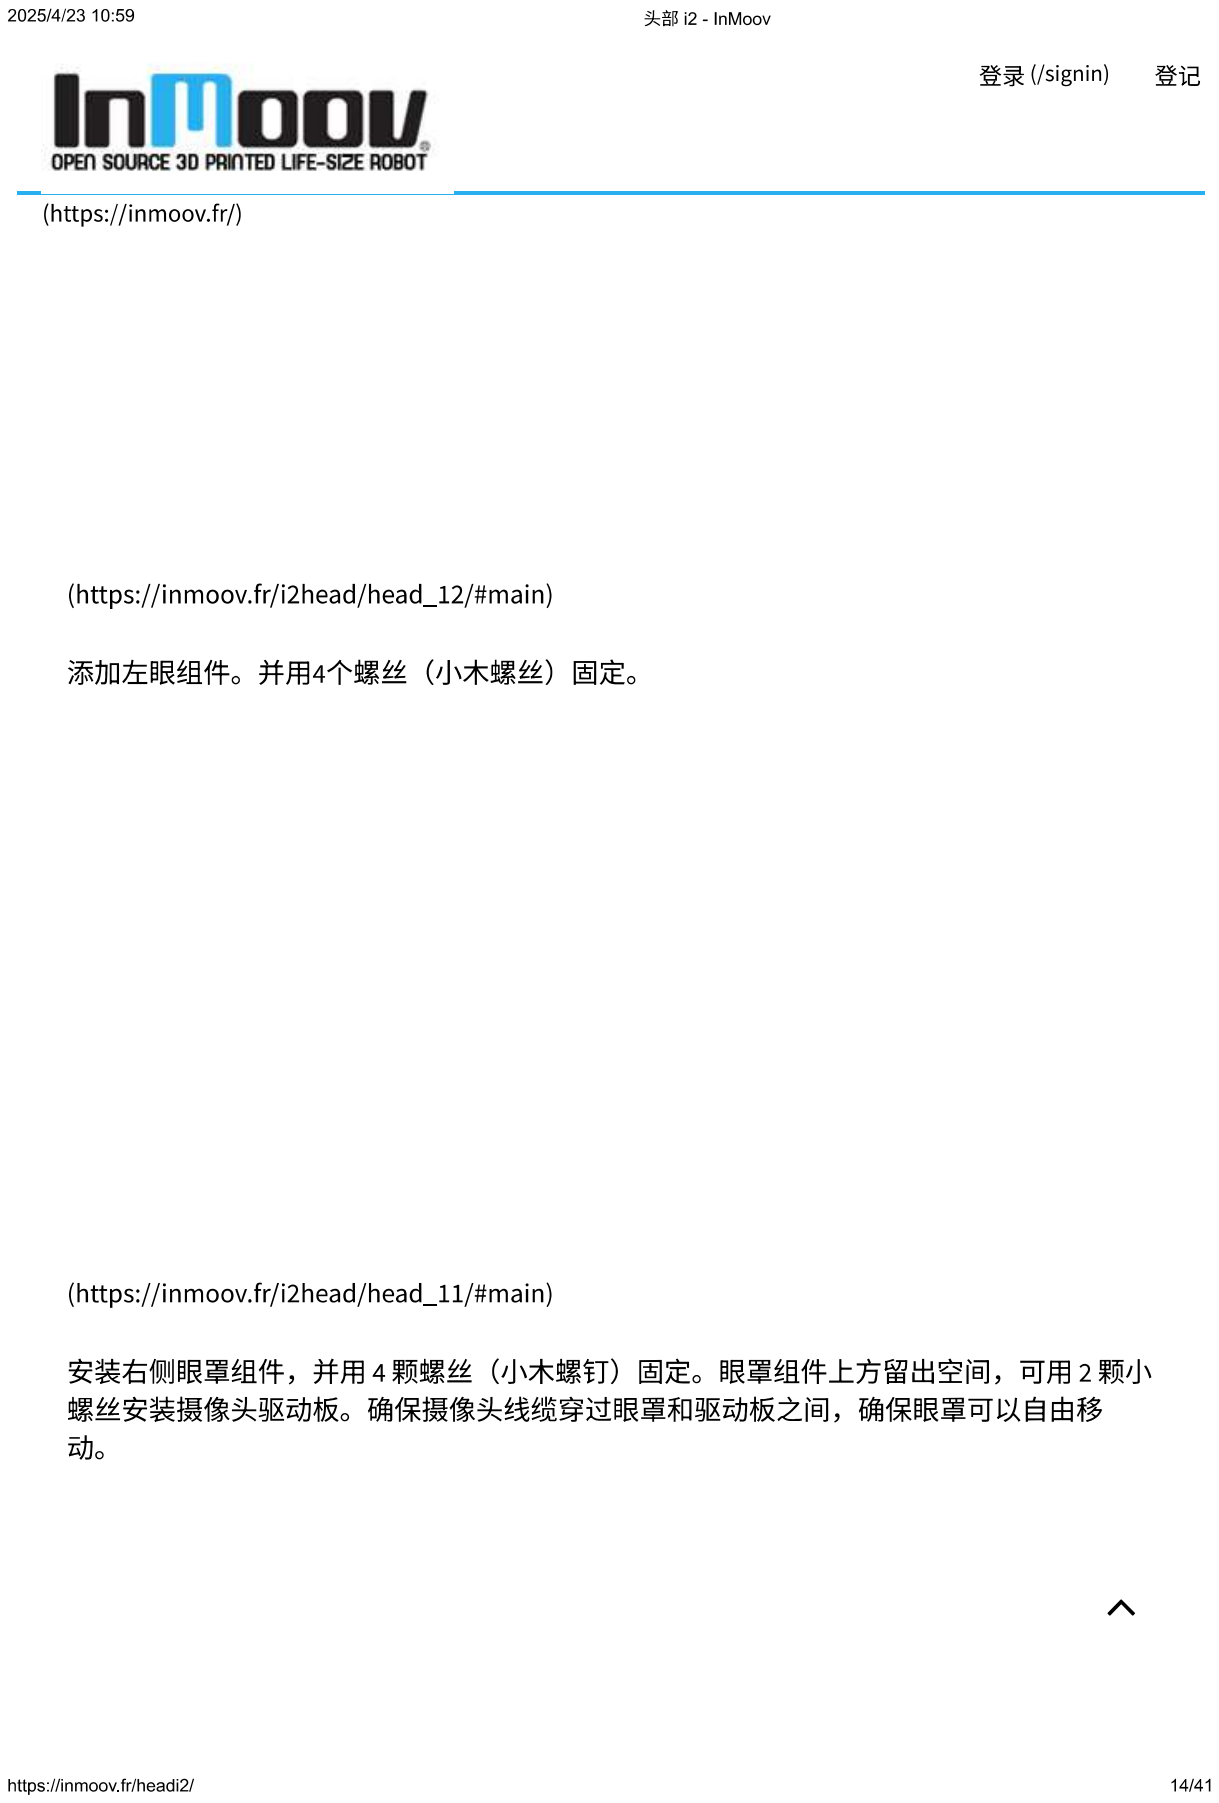
[picture p391: page 14]
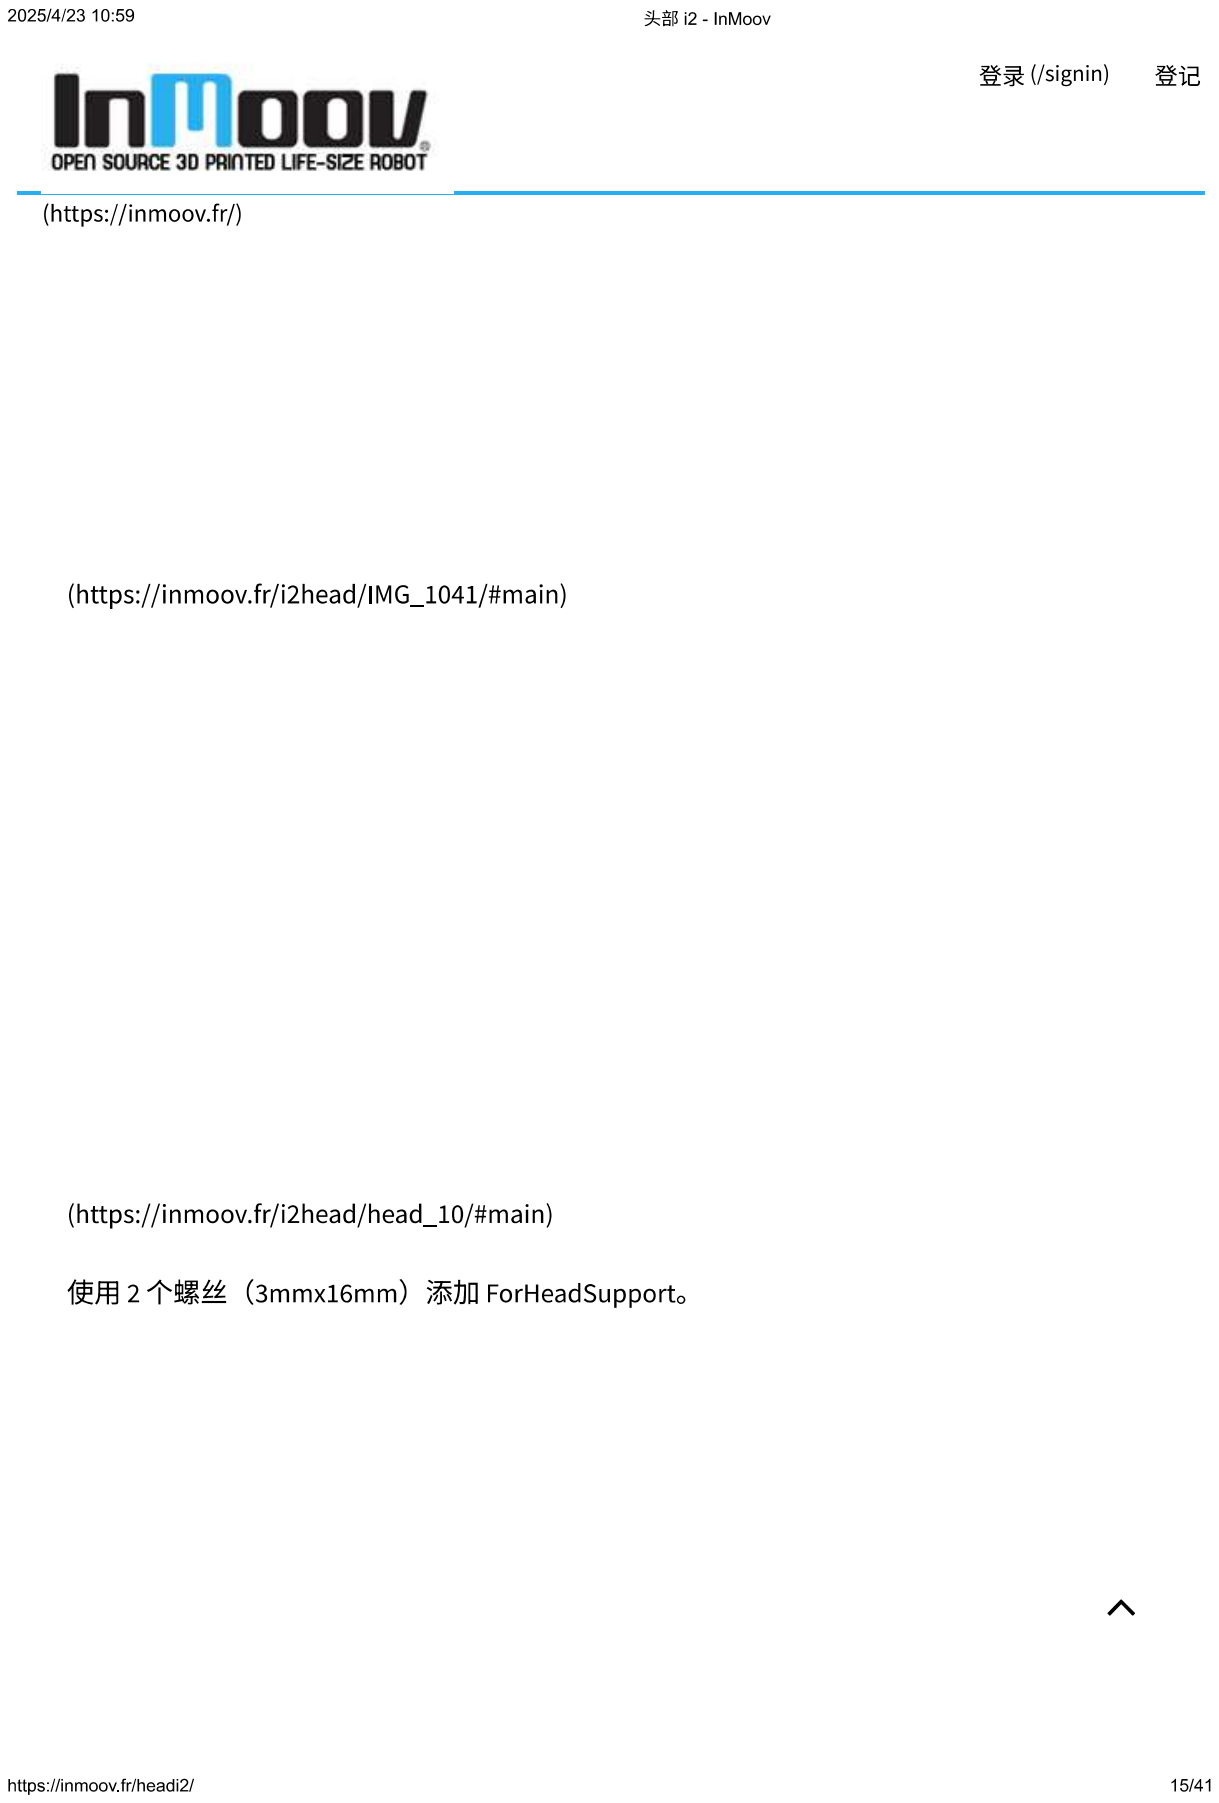
[picture p392: page 15]
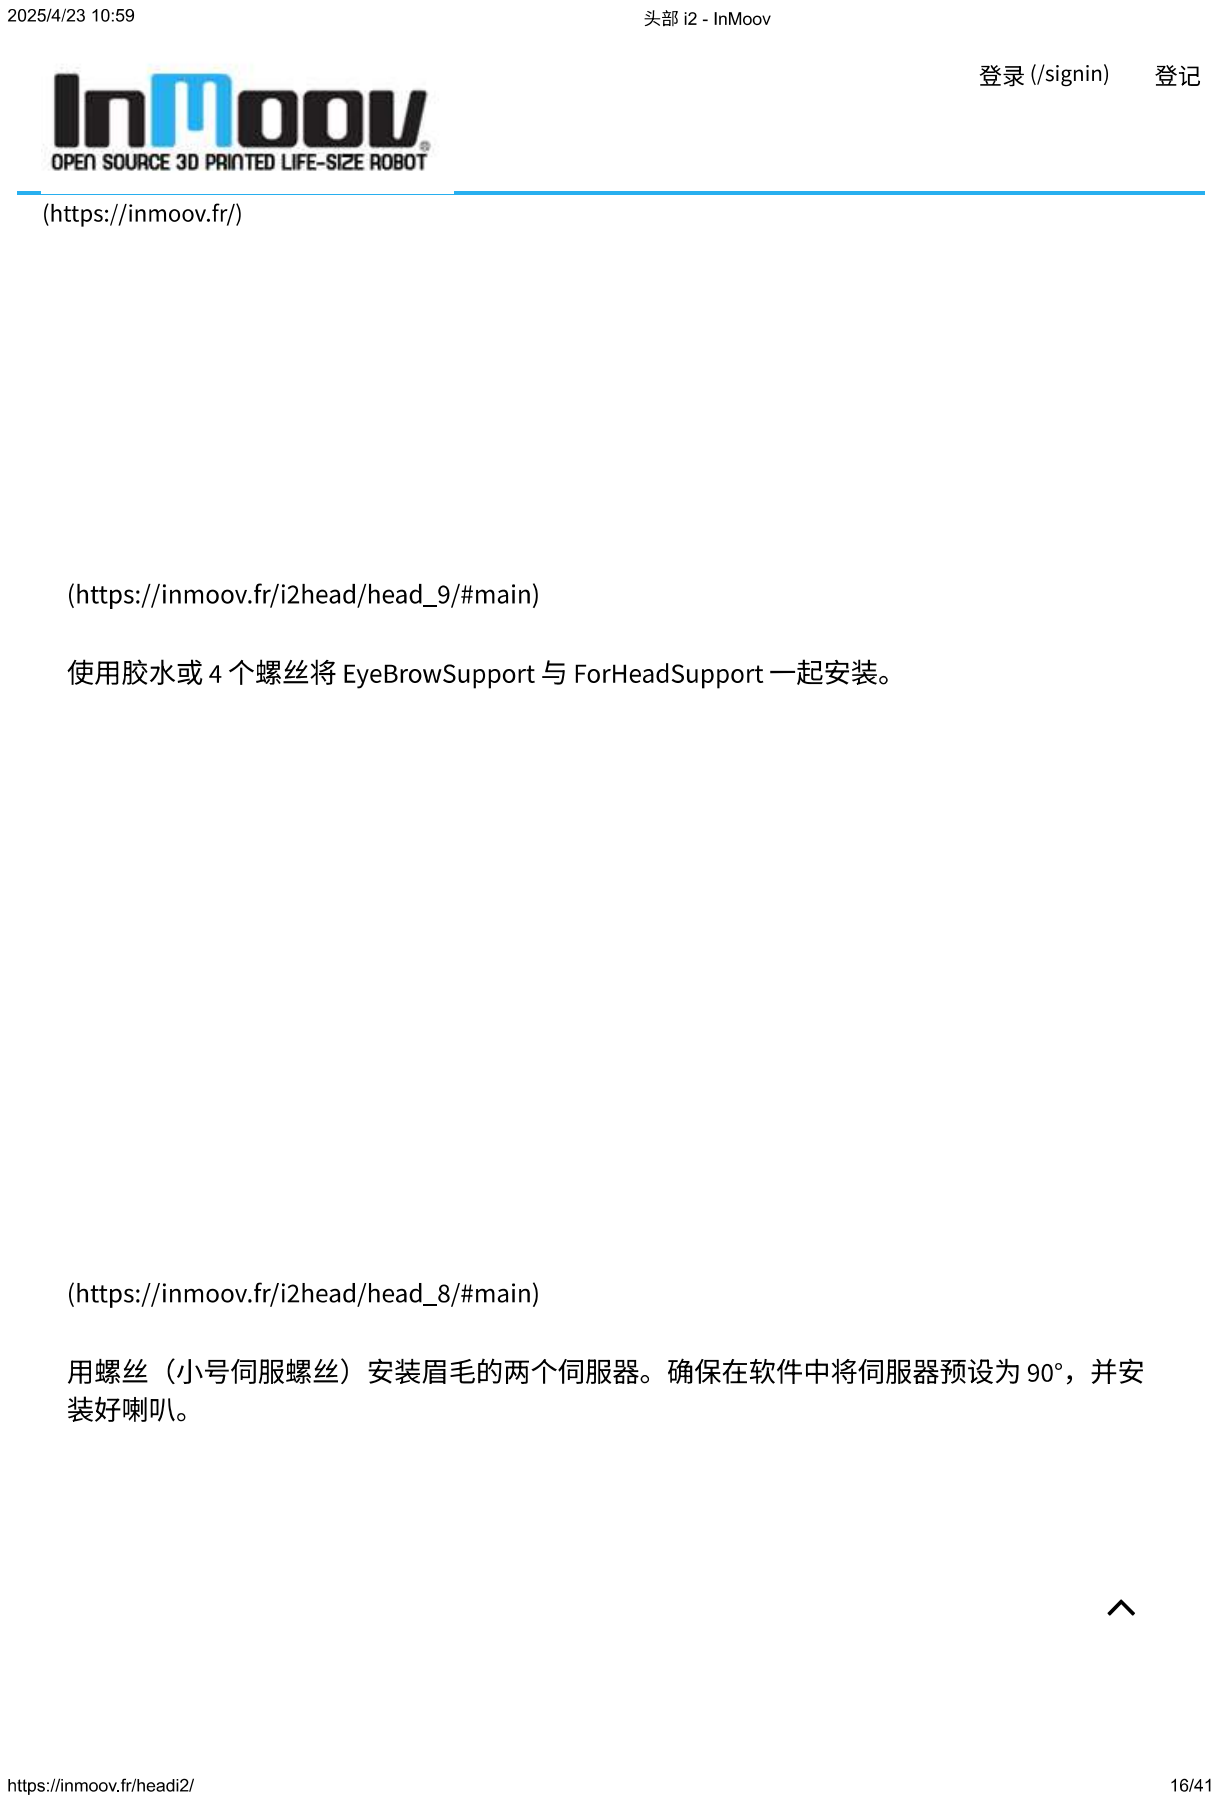
[picture p393: page 16]
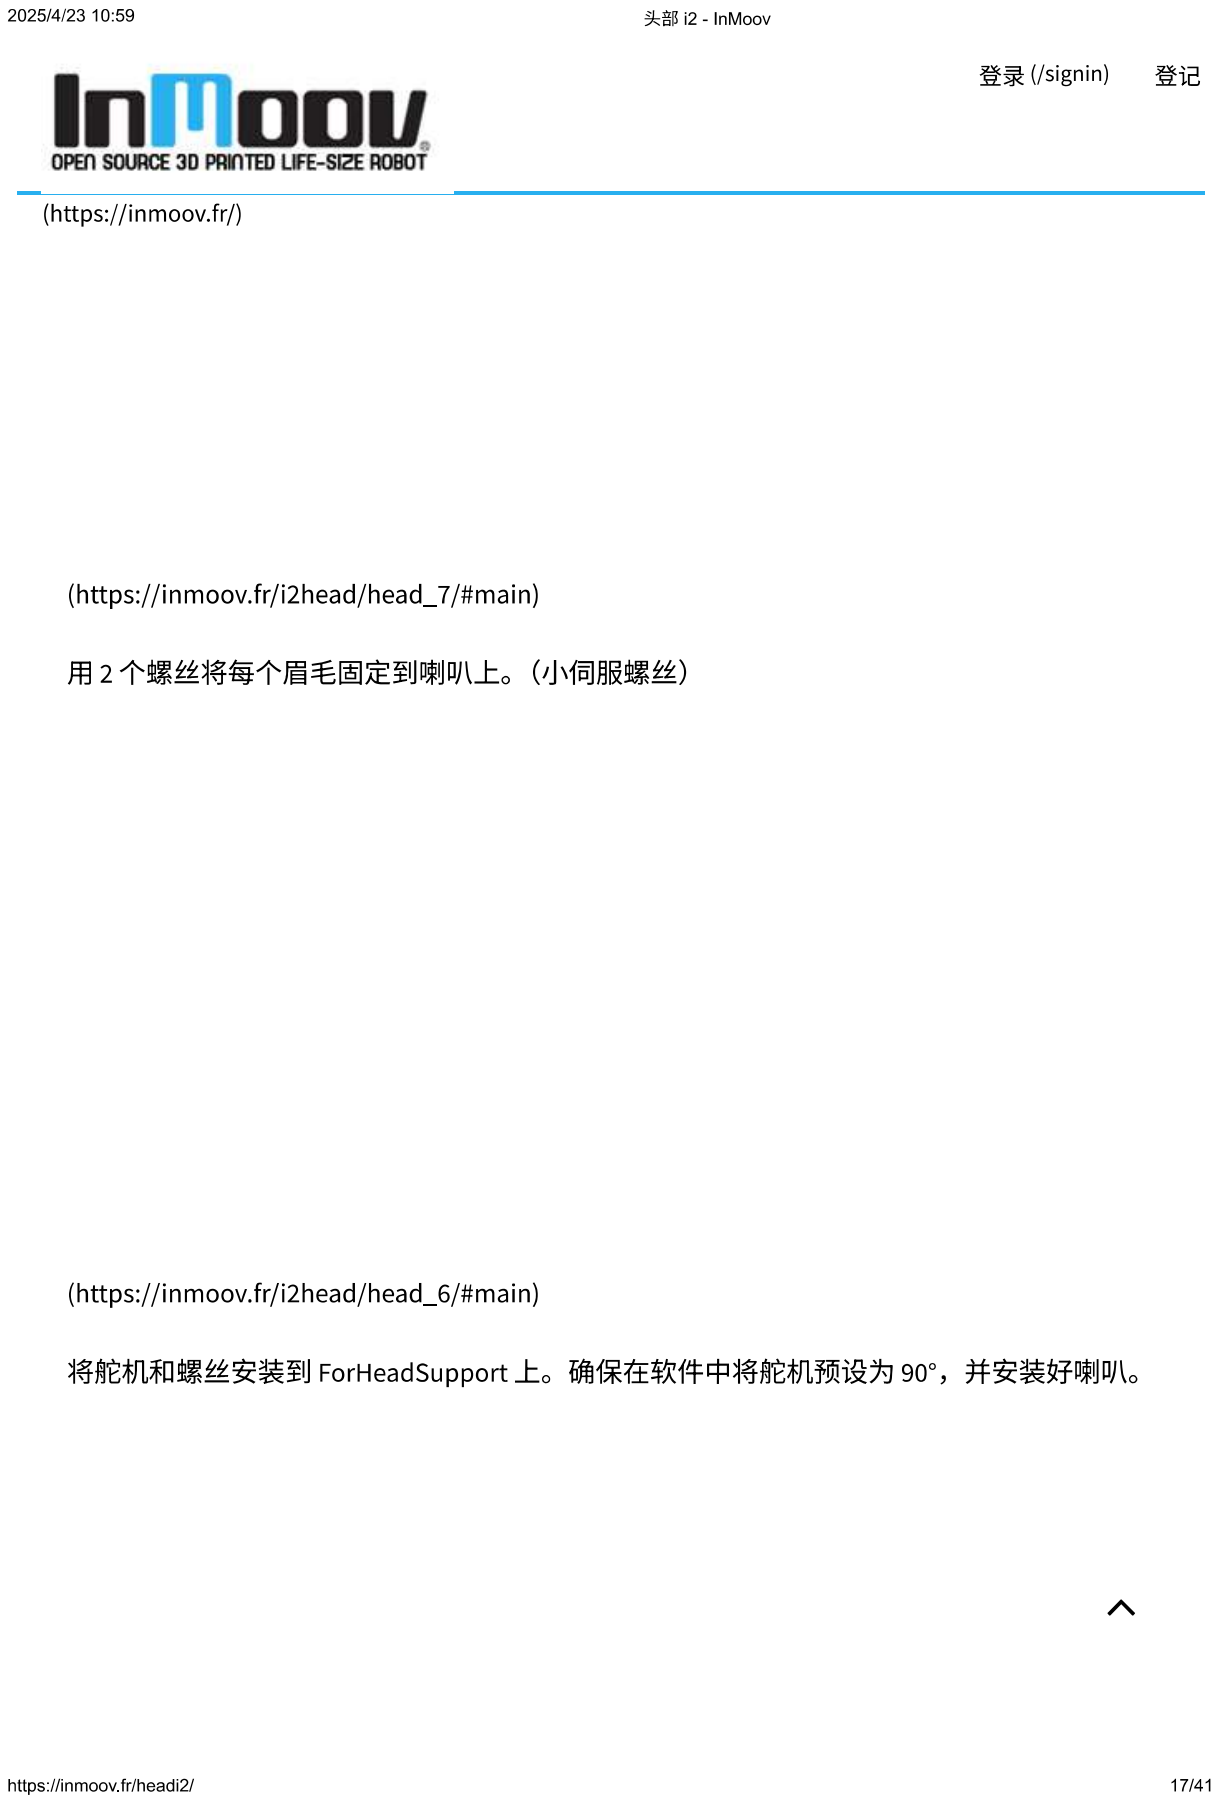
[picture p394: page 17]
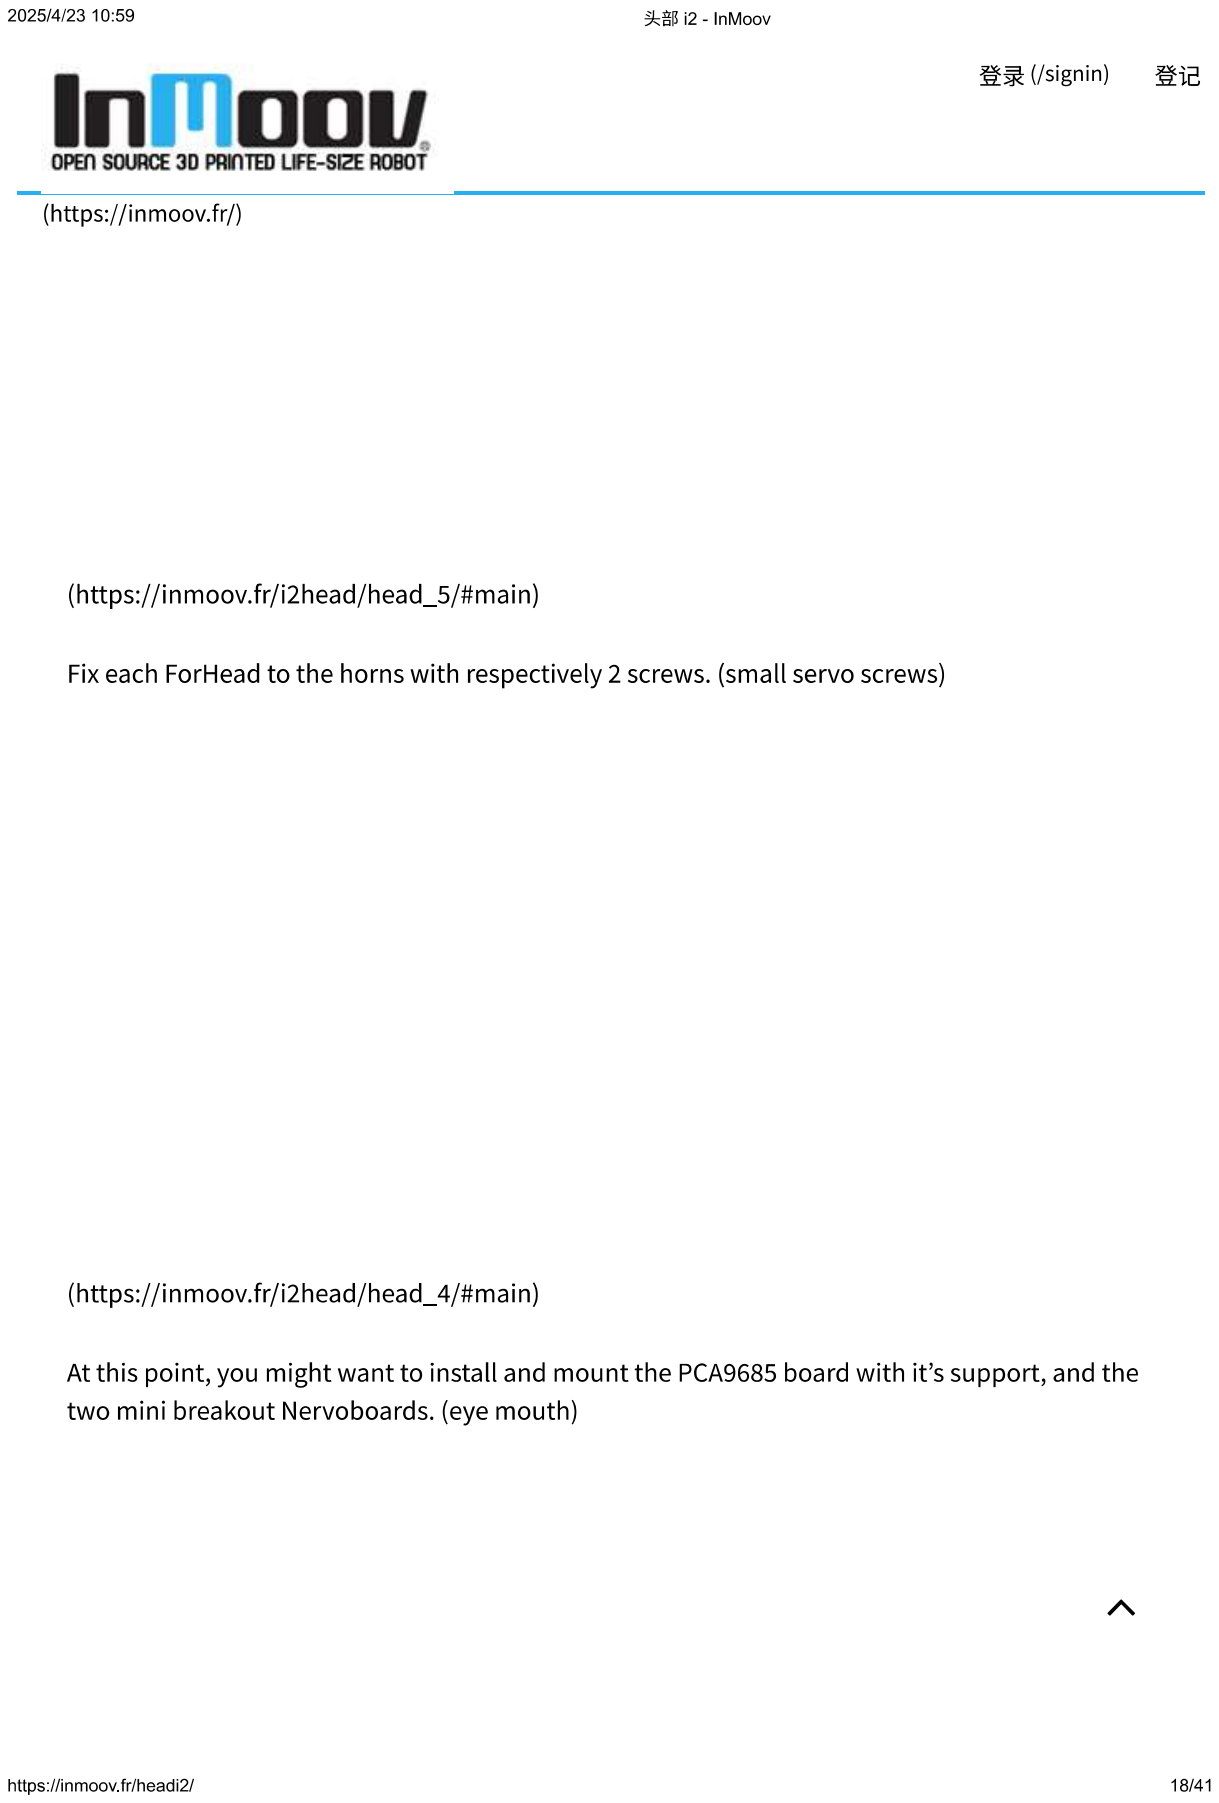
[picture p395: page 18]
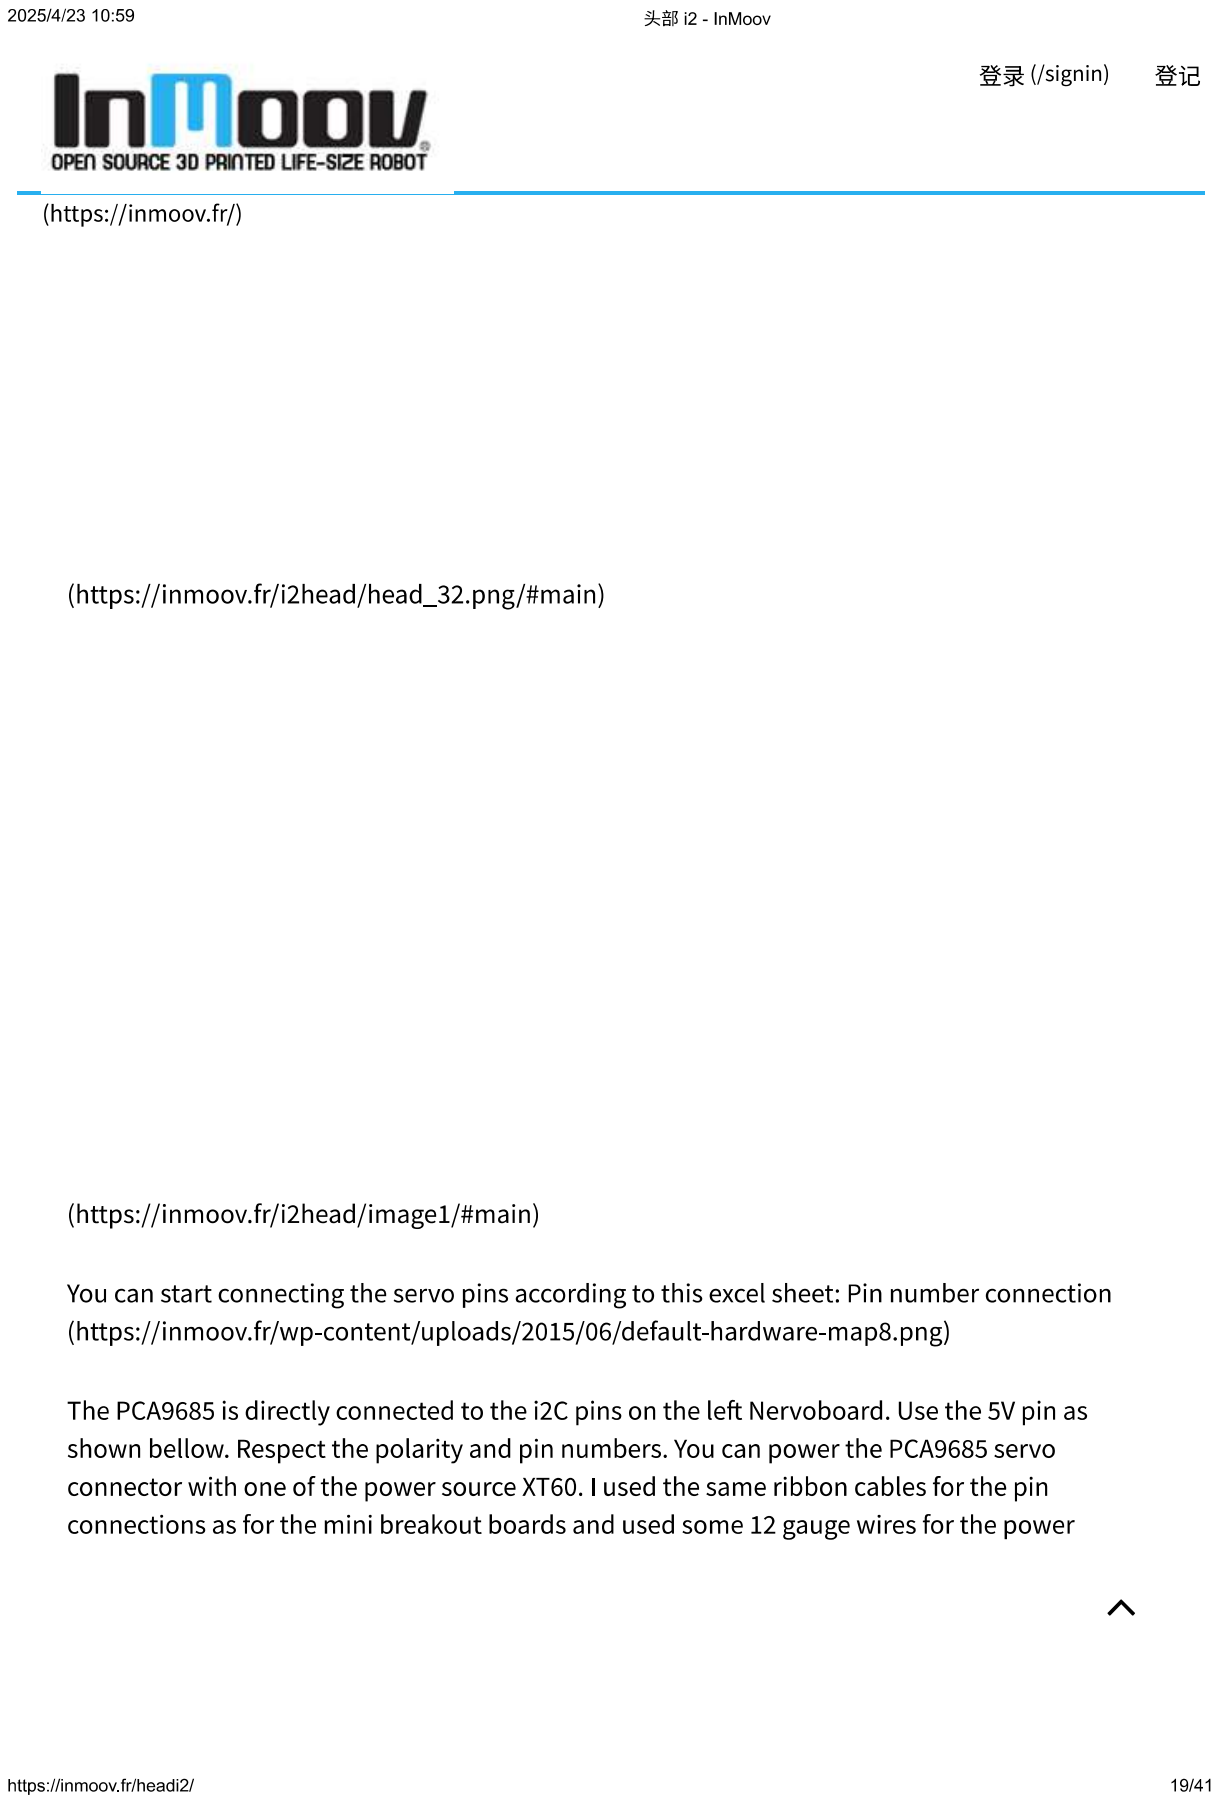
[picture p396: page 19]
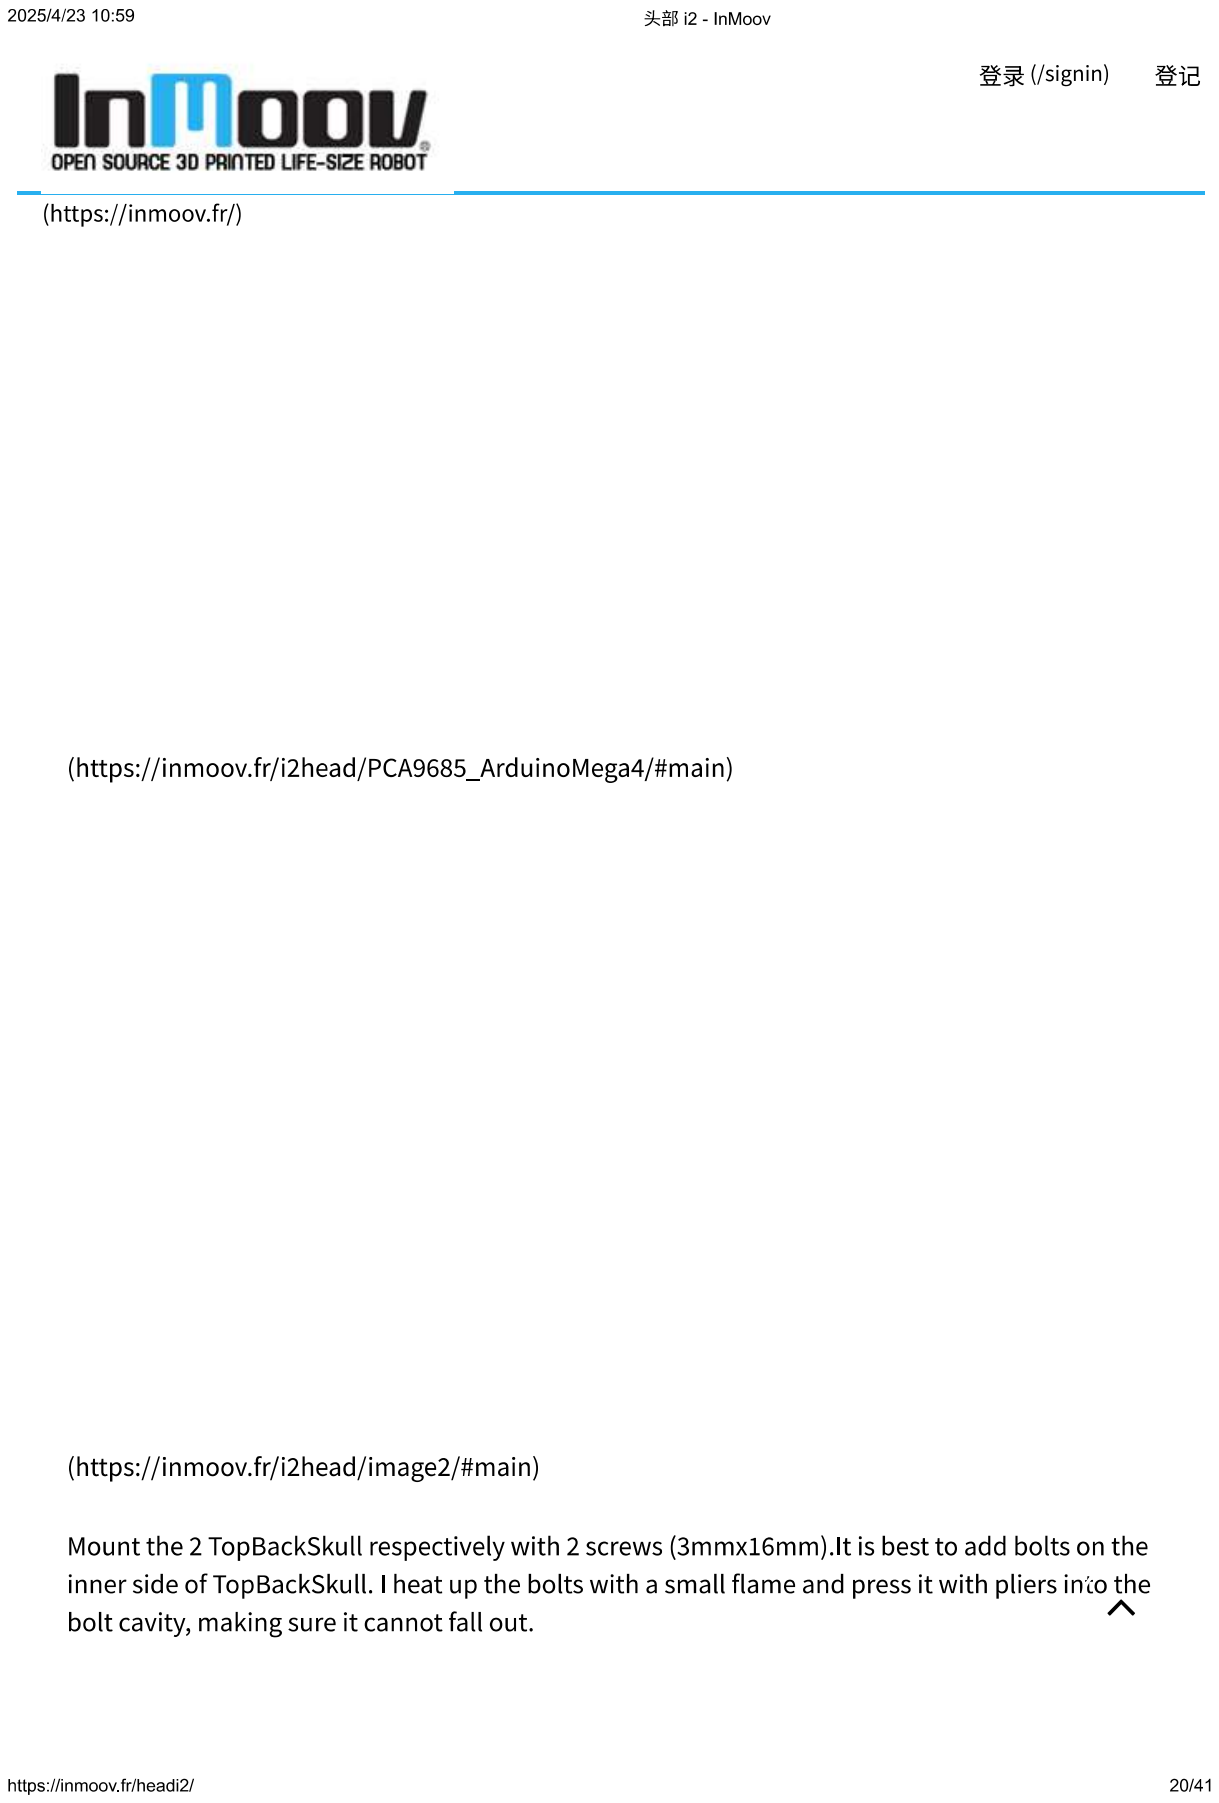
[picture p397: page 20]
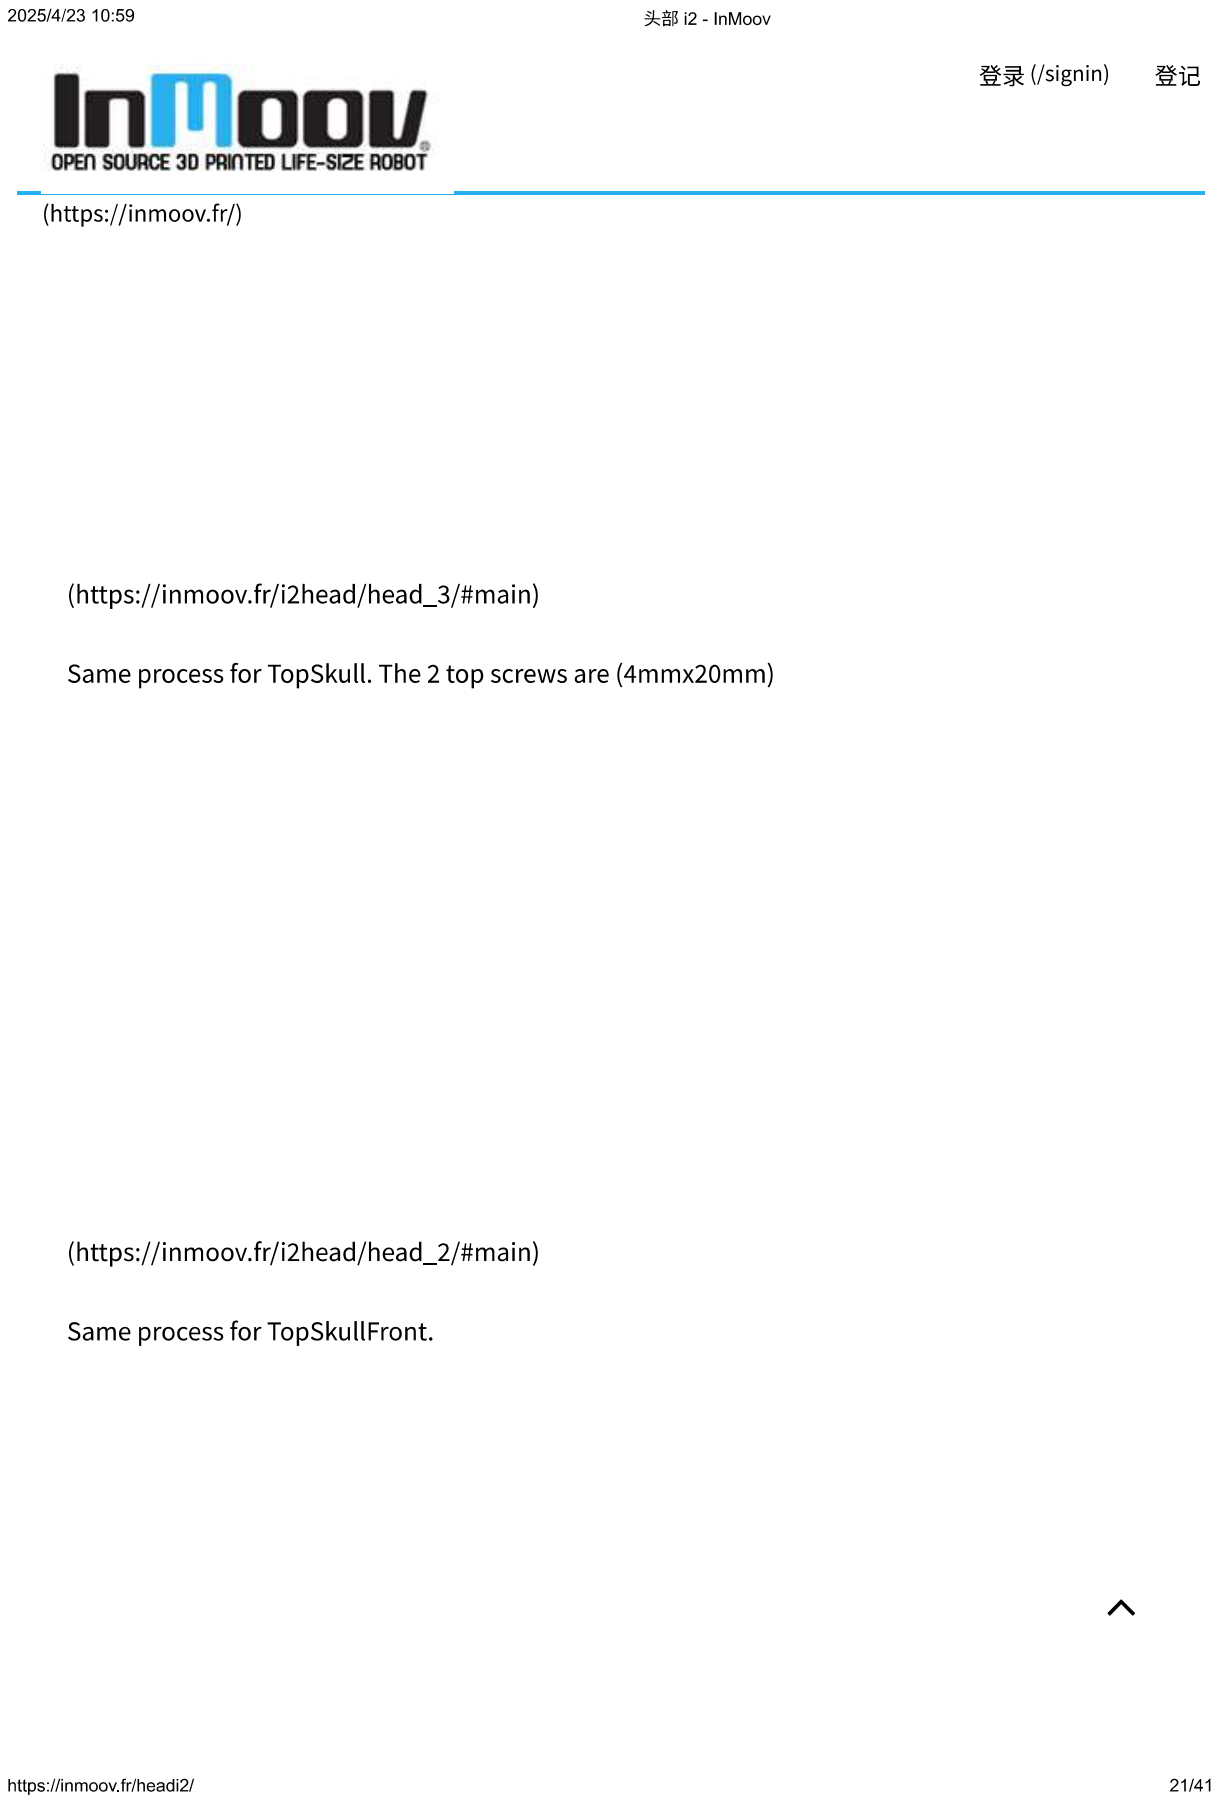
[picture p398: page 21]
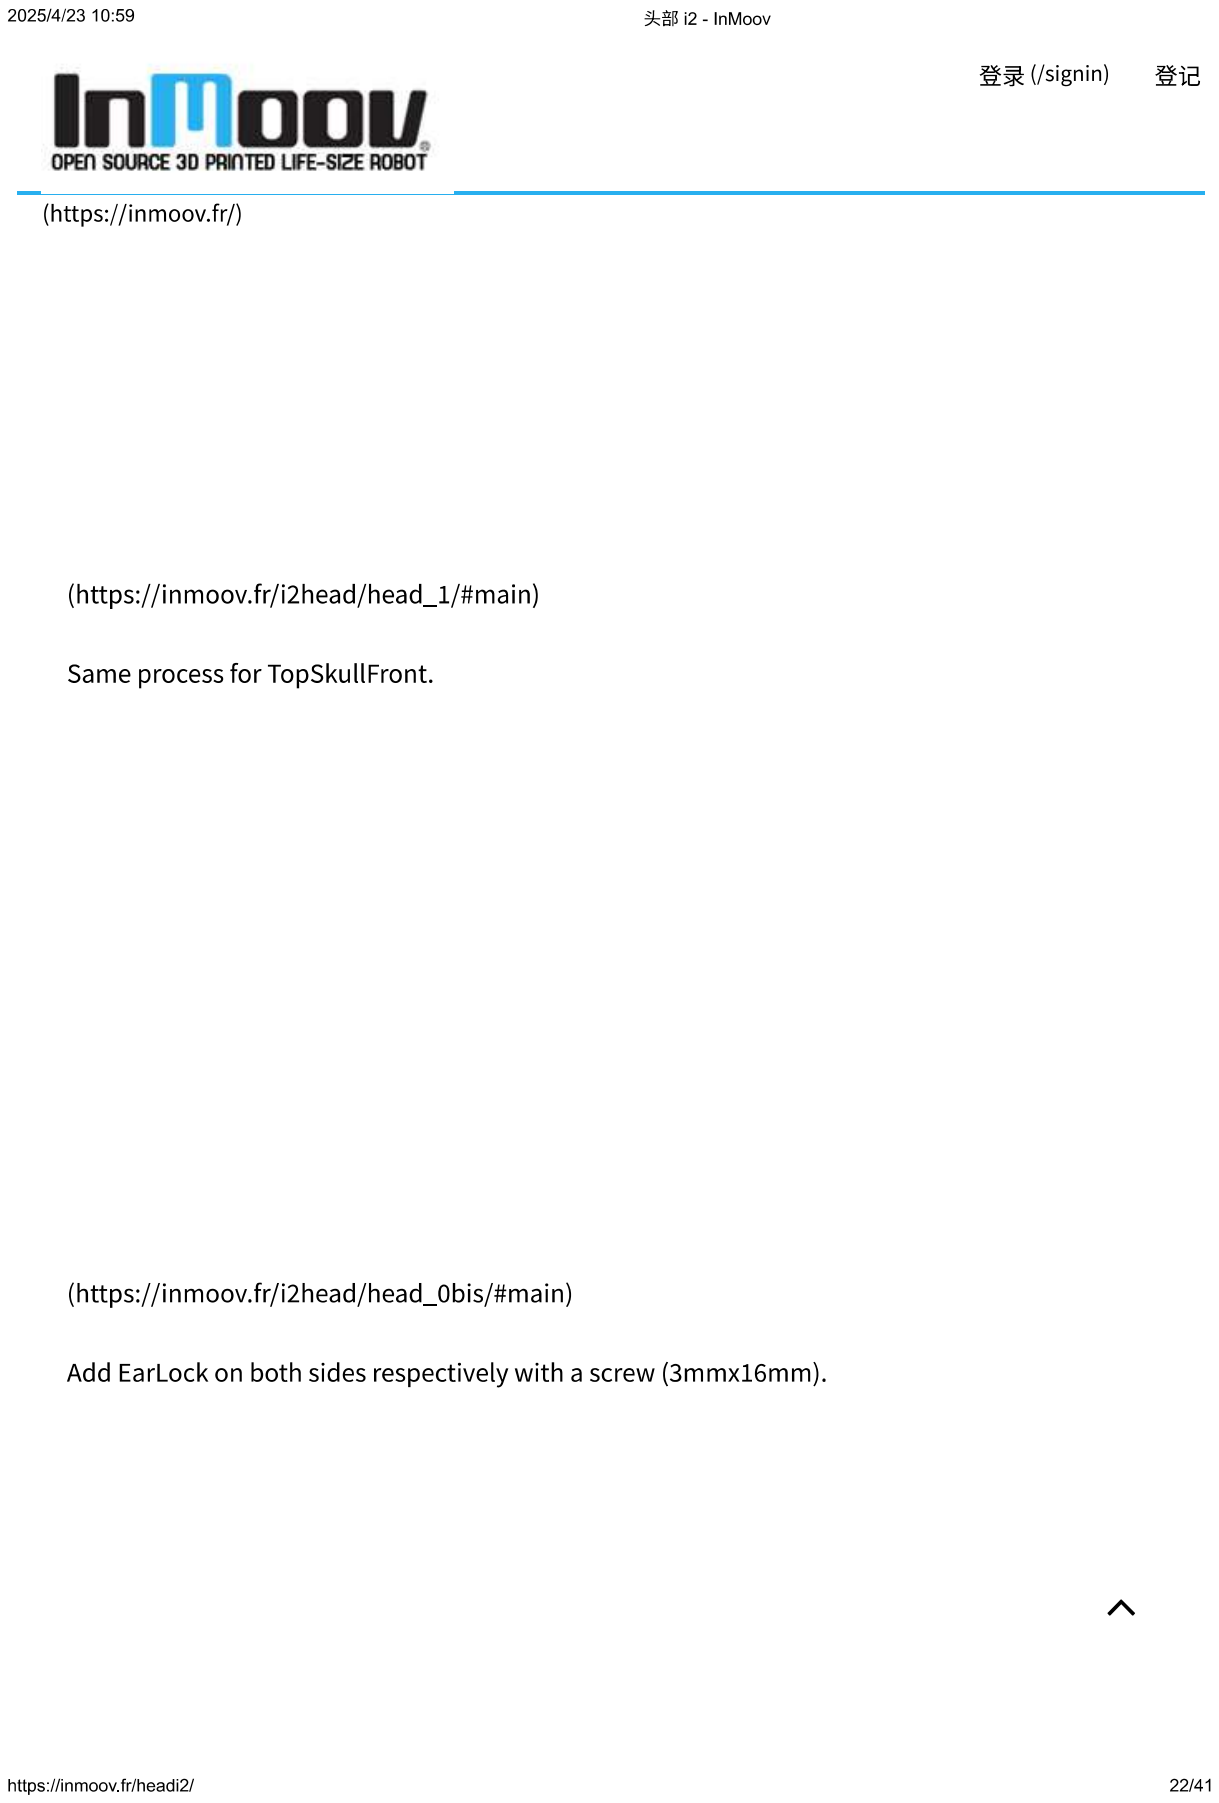
[picture p399: page 22]
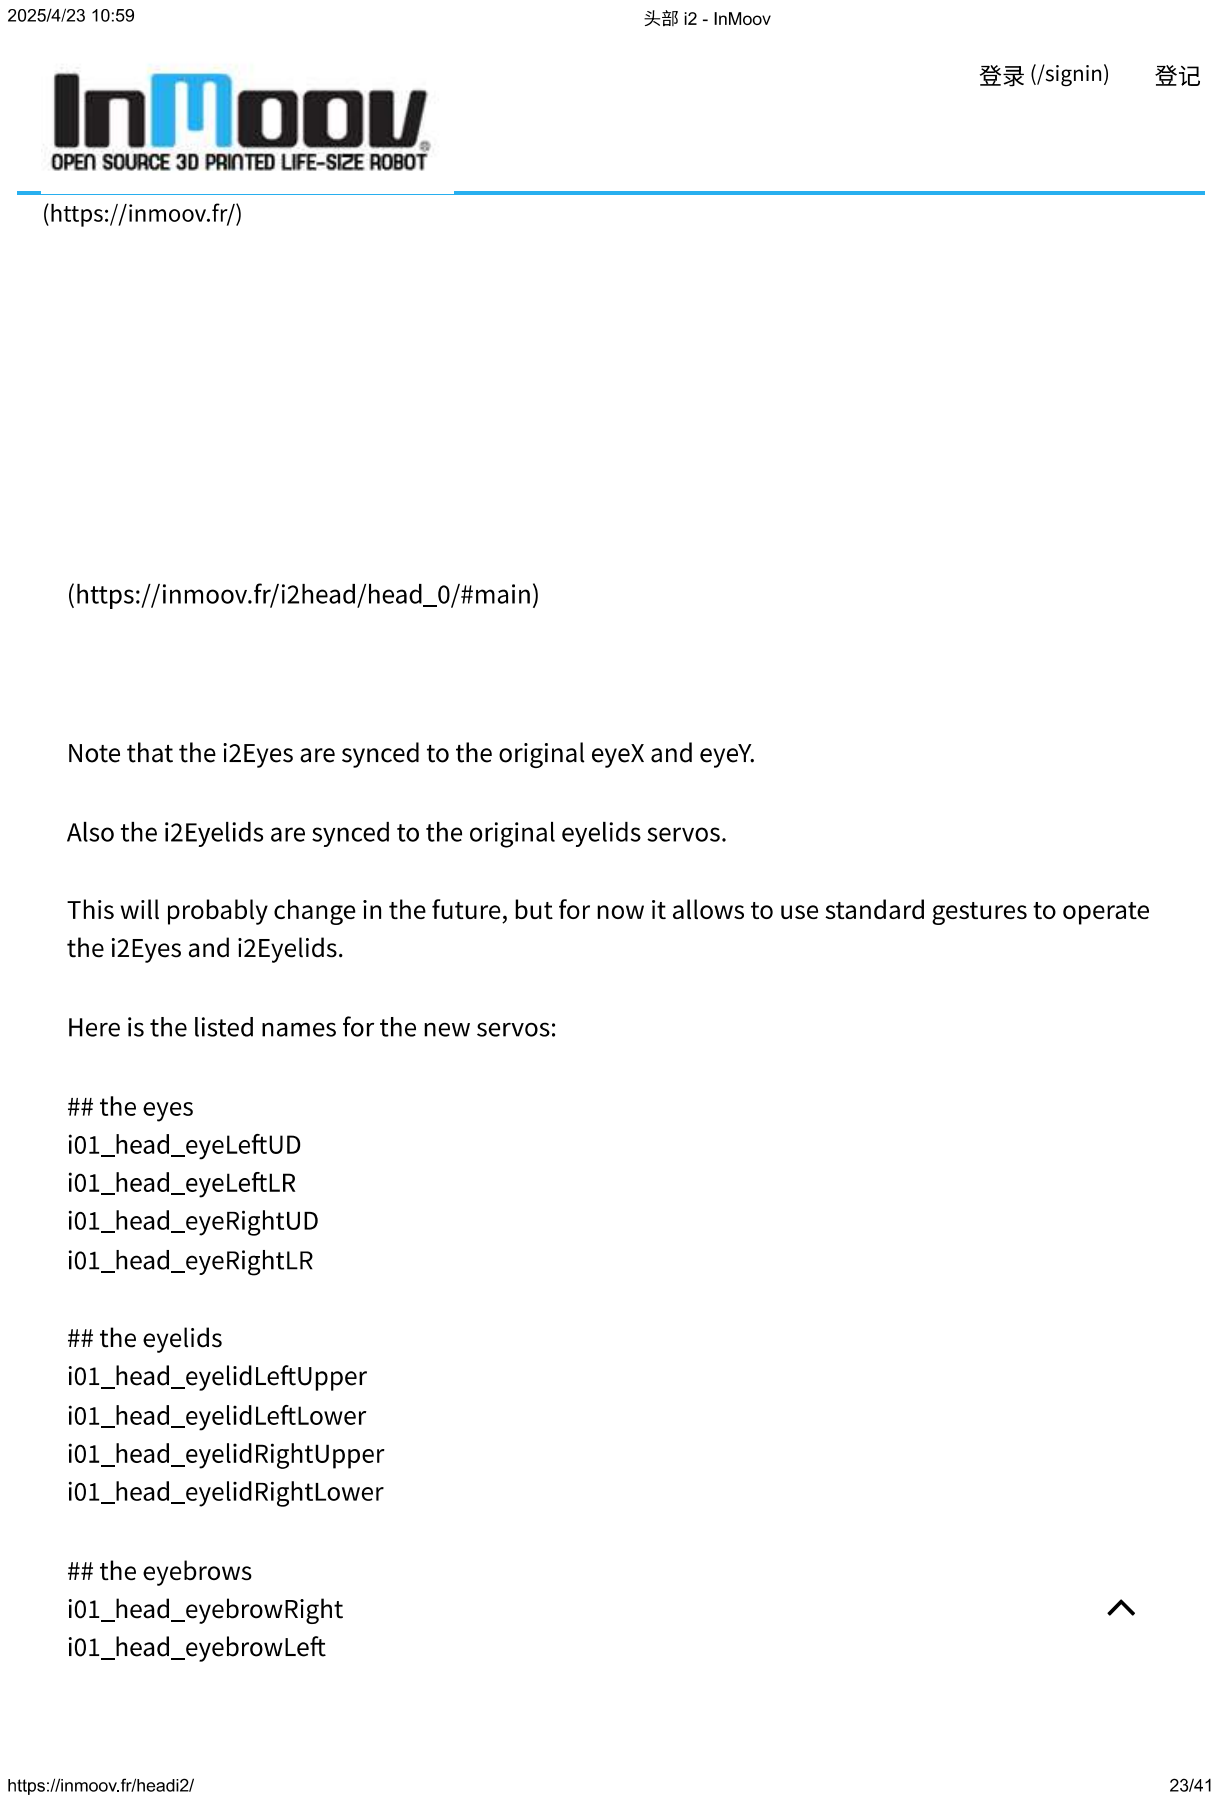
[picture p400: page 23]
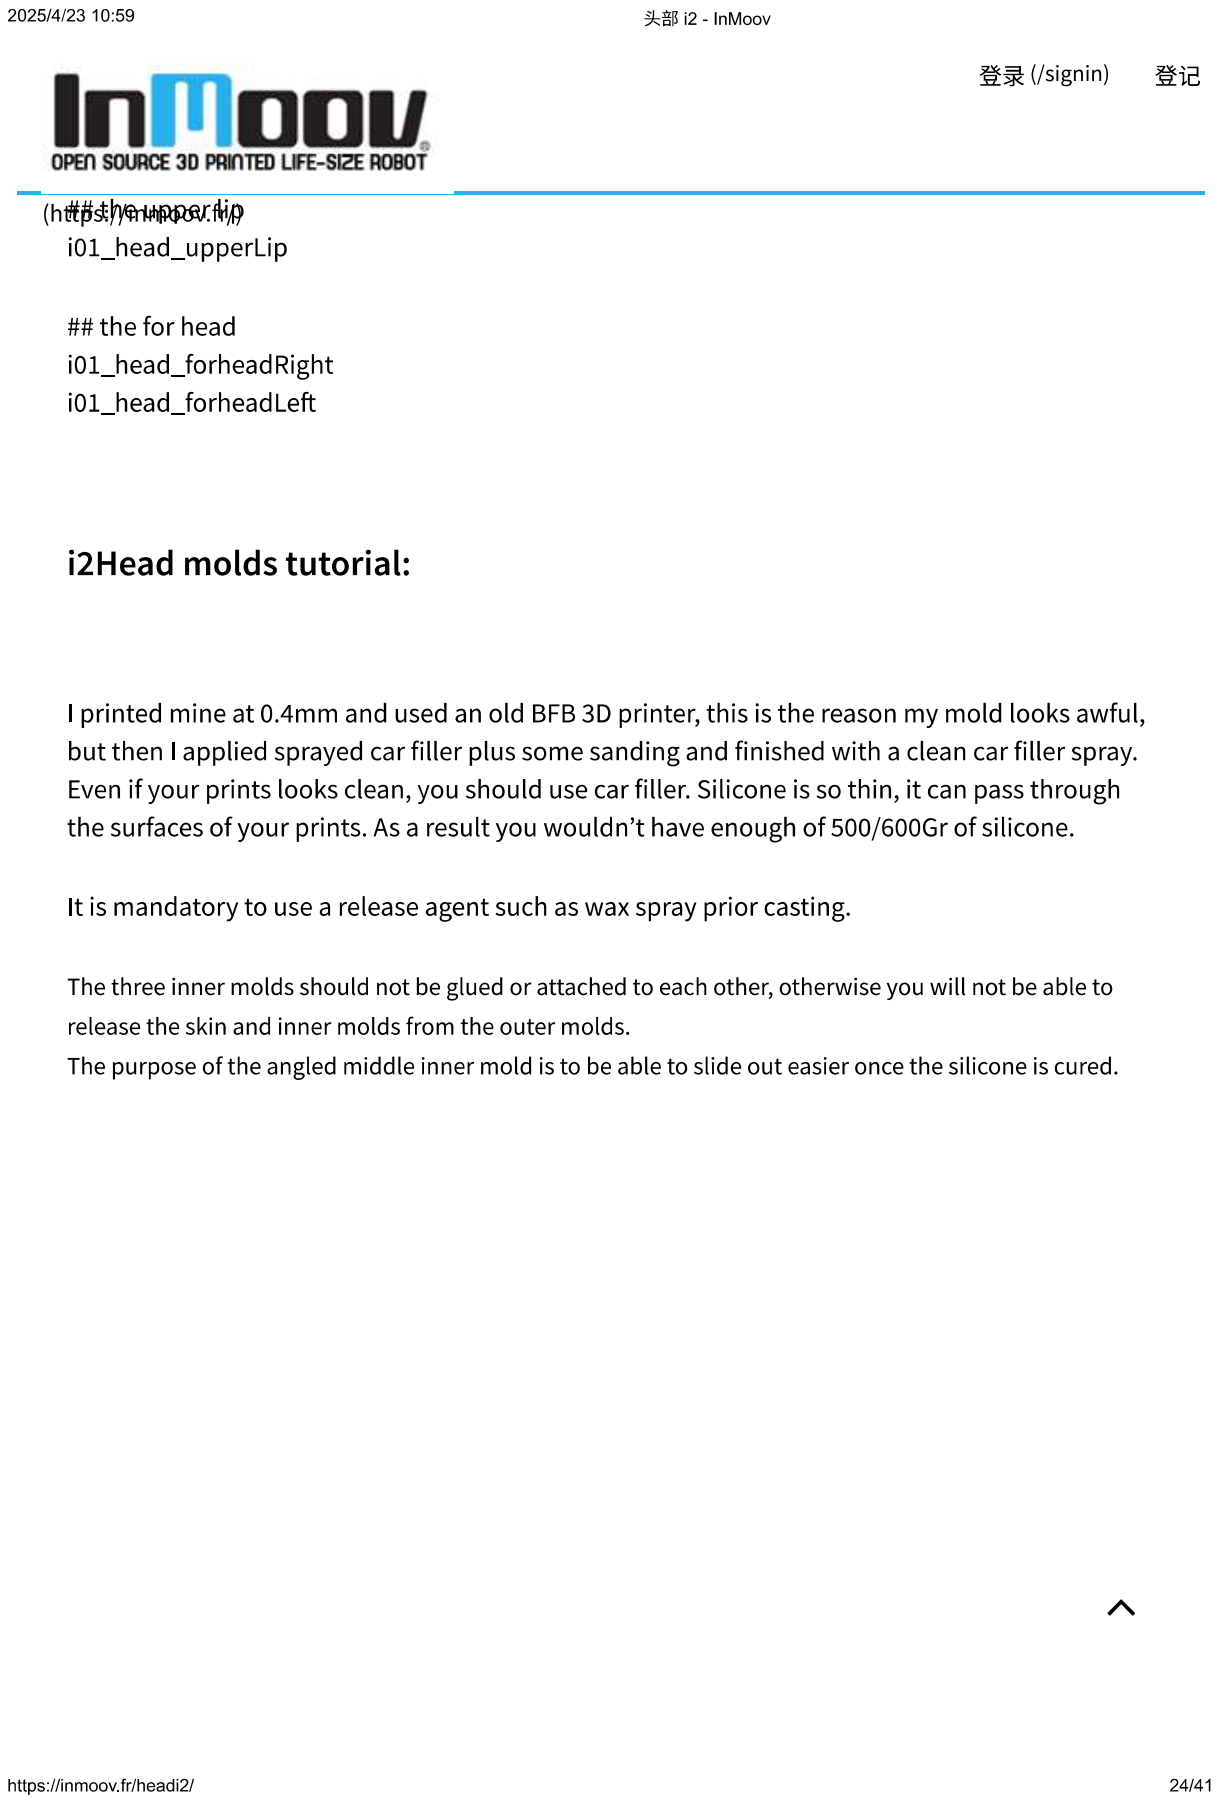
[picture p401: page 24]
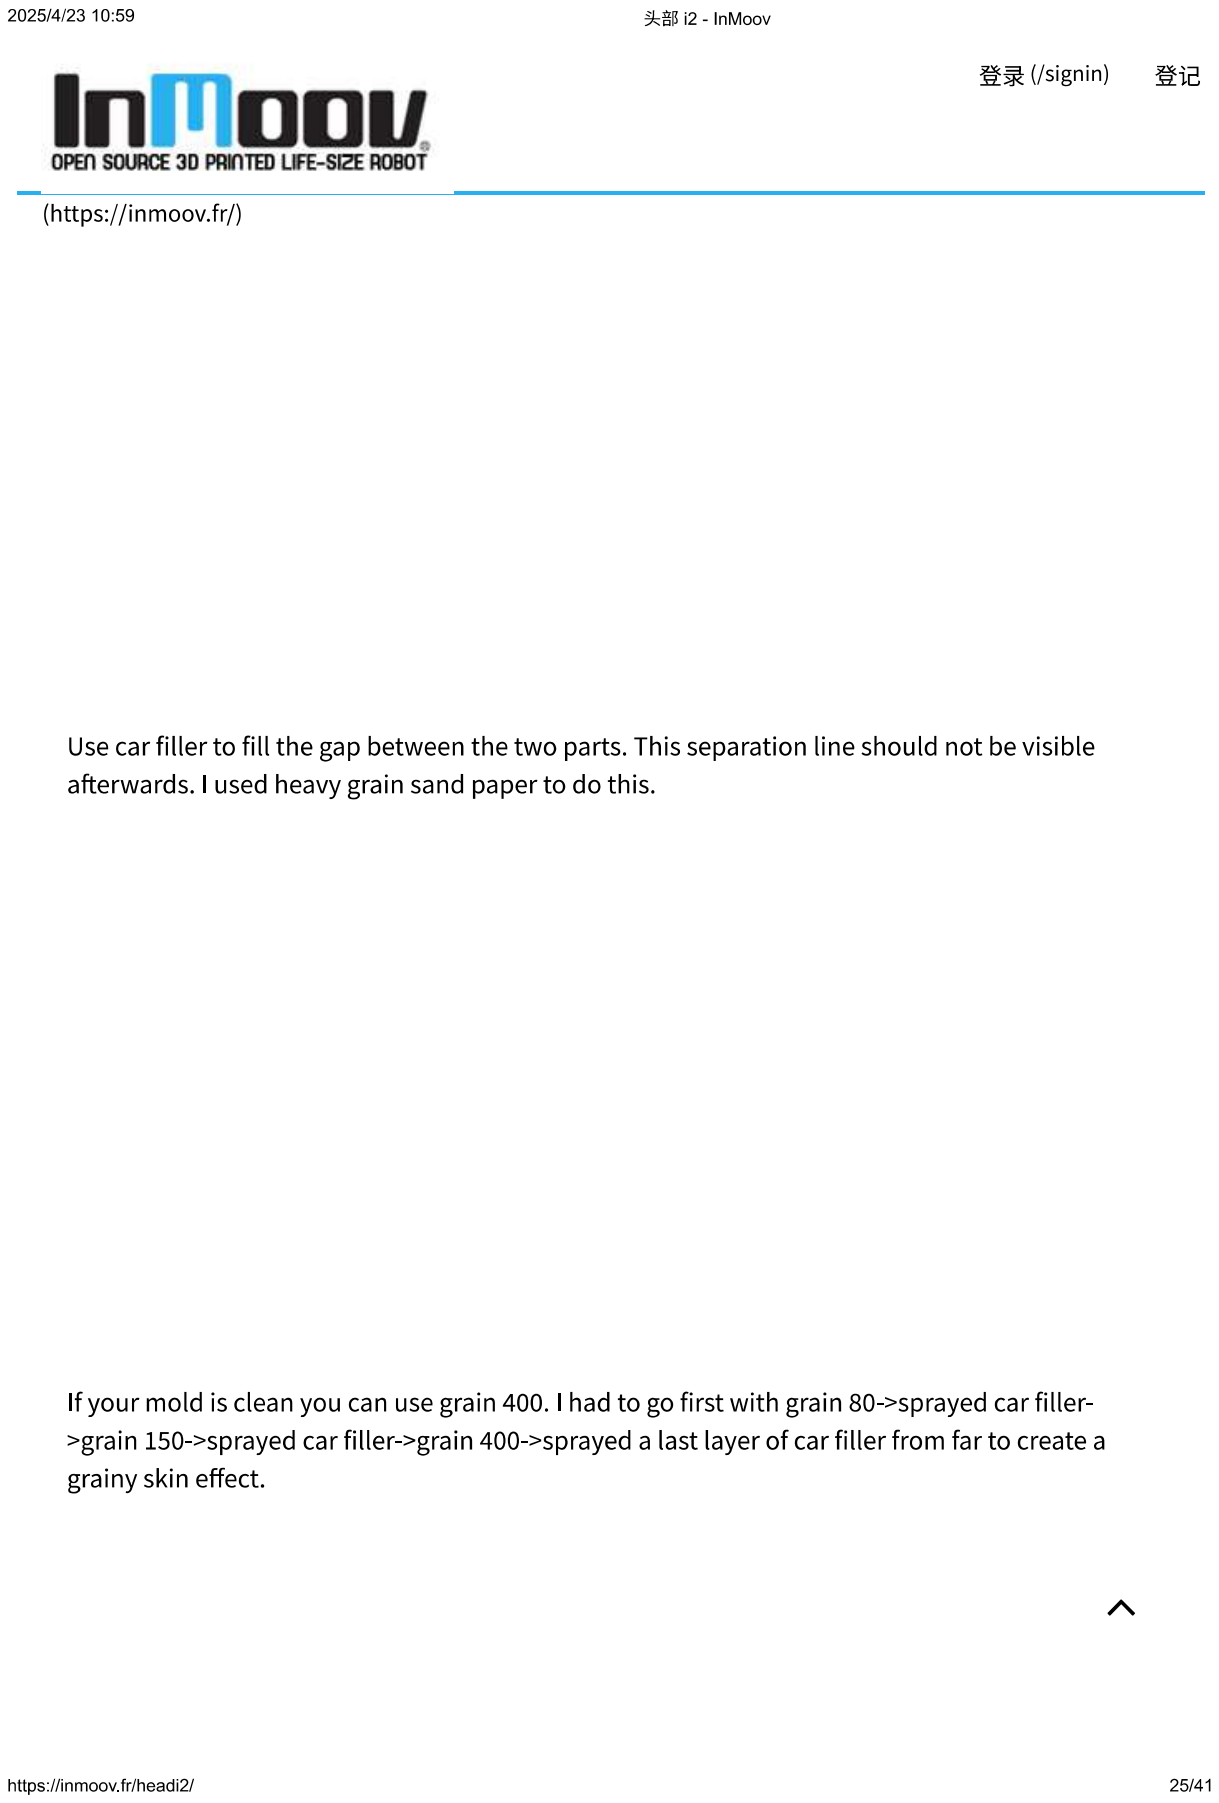
[picture p402: page 25]
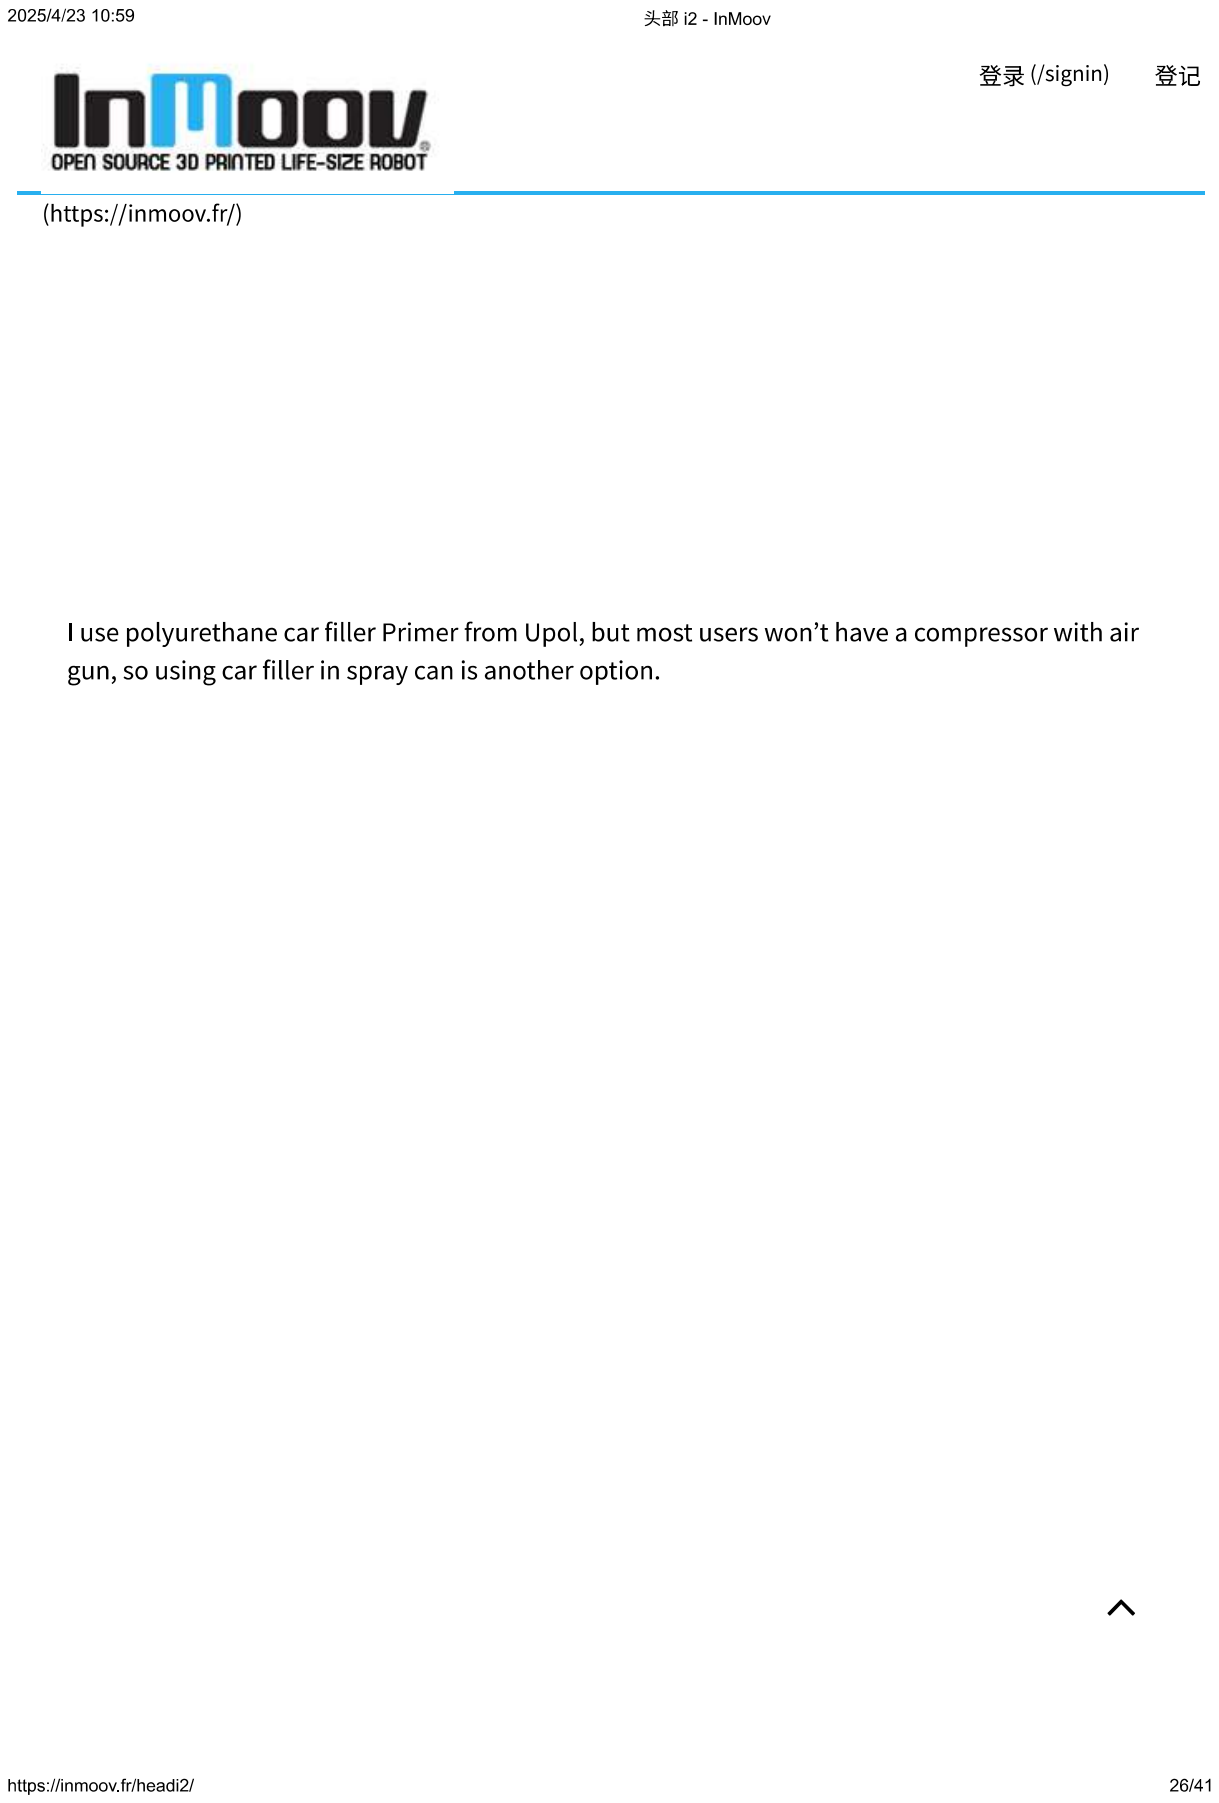
[picture p403: page 26]
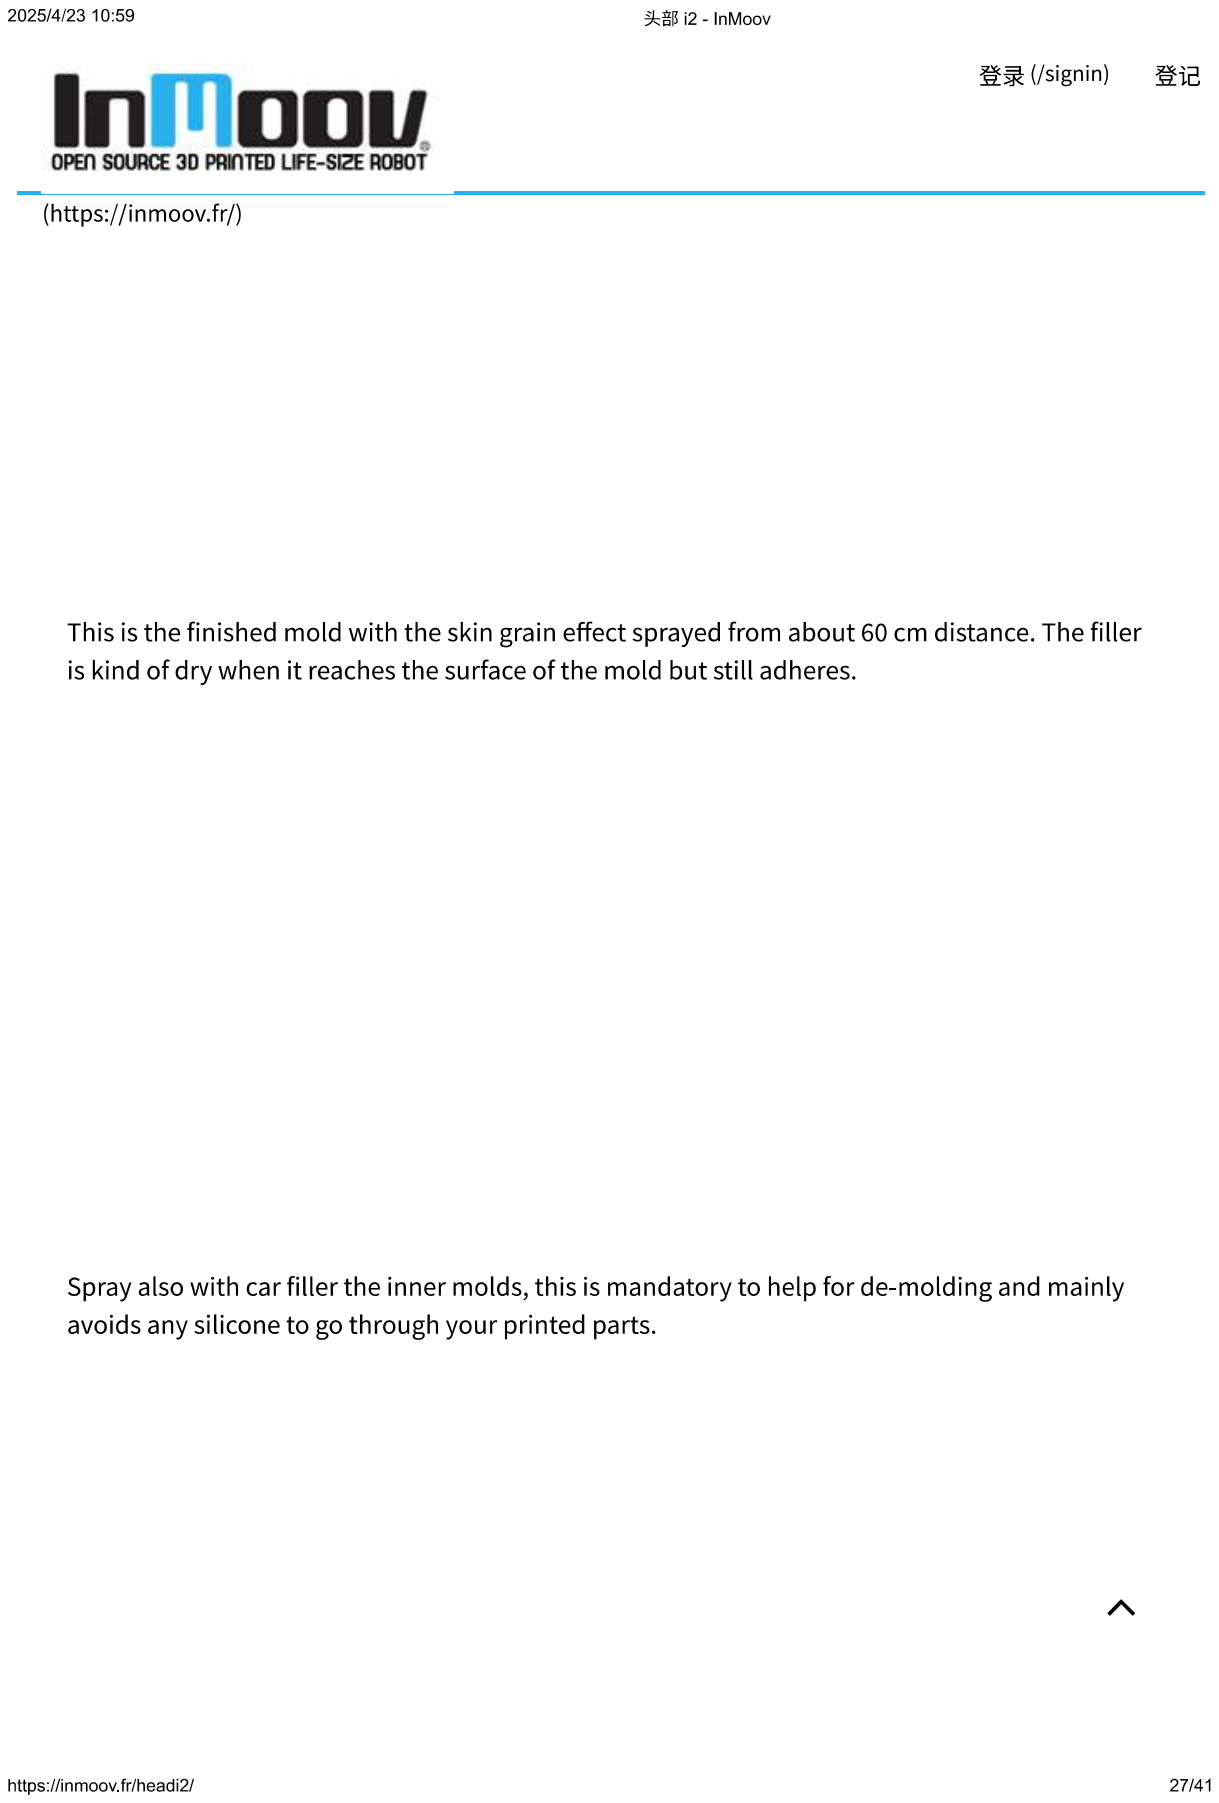
[picture p404: page 27]
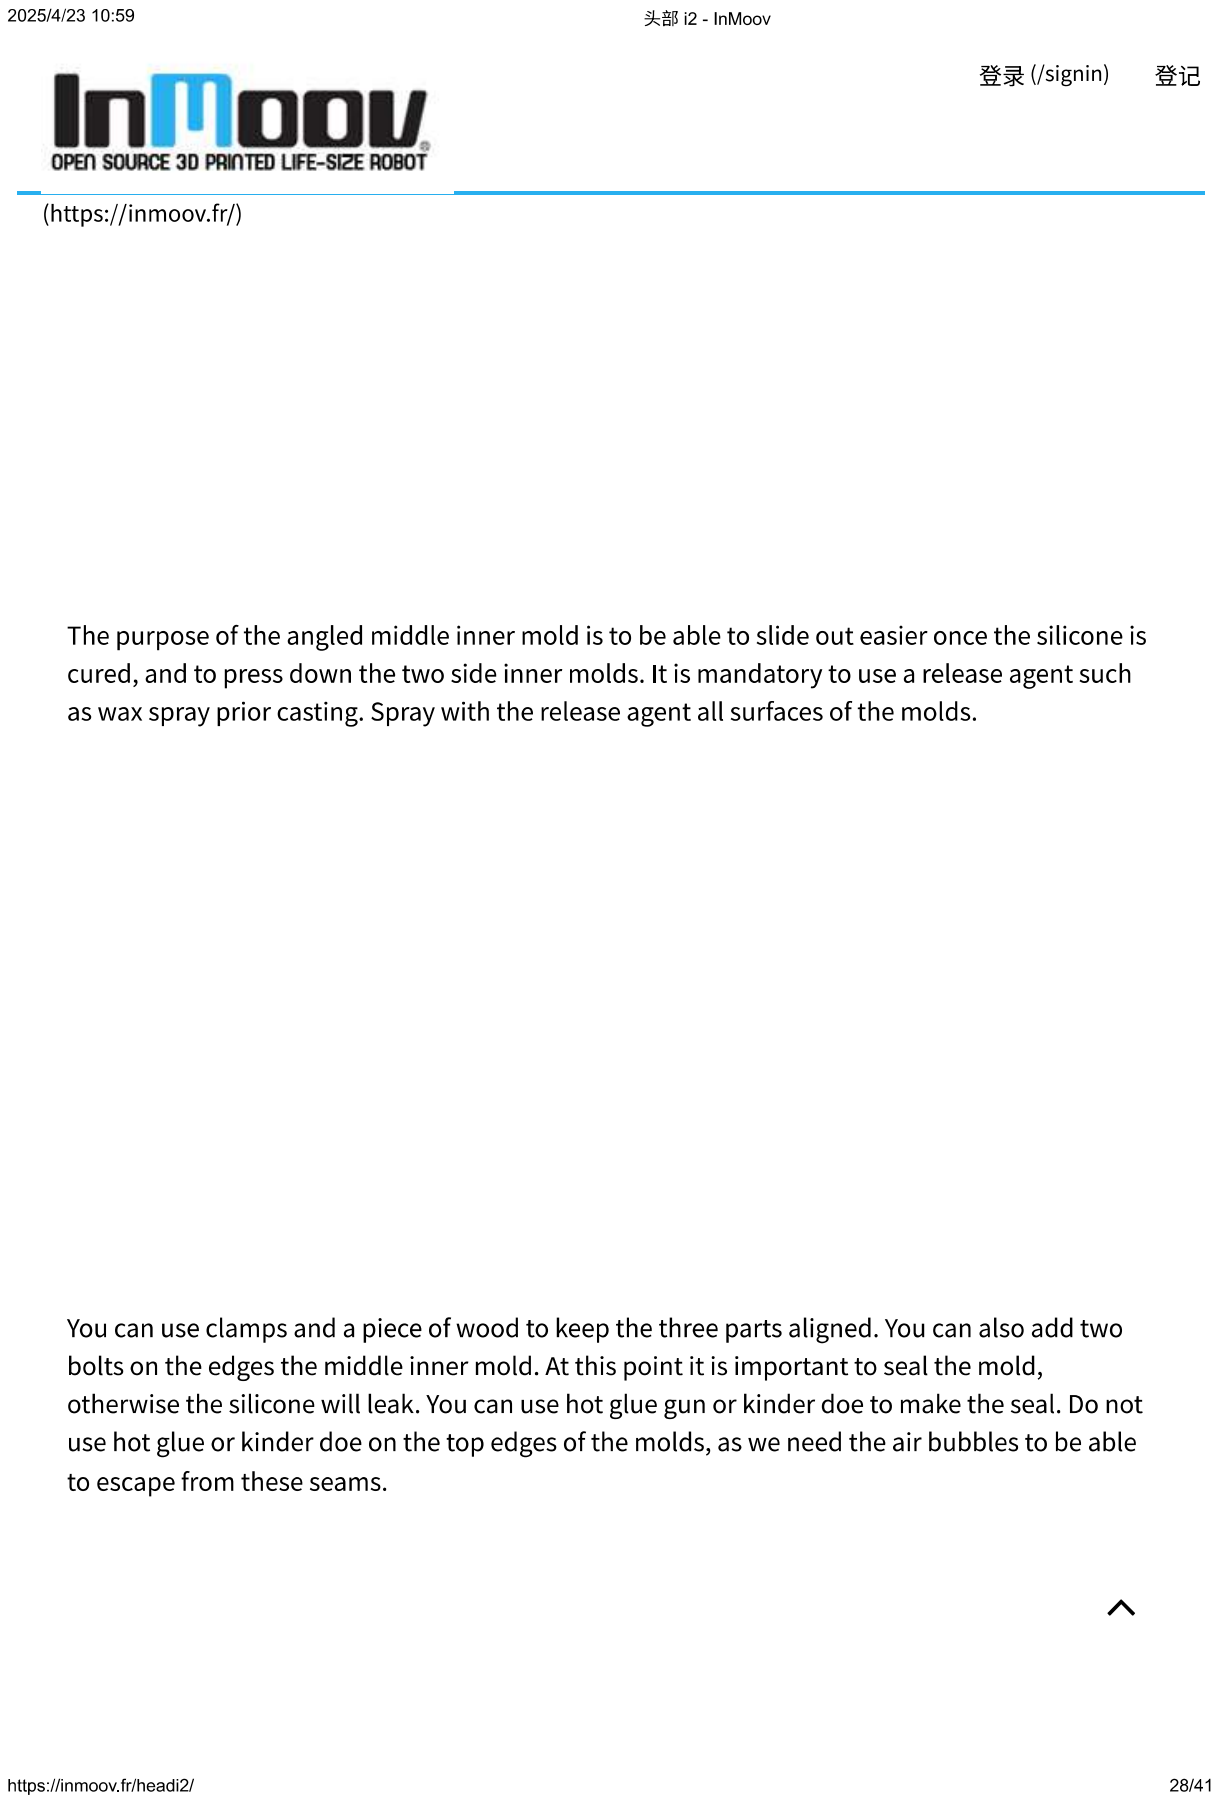
[picture p405: page 28]
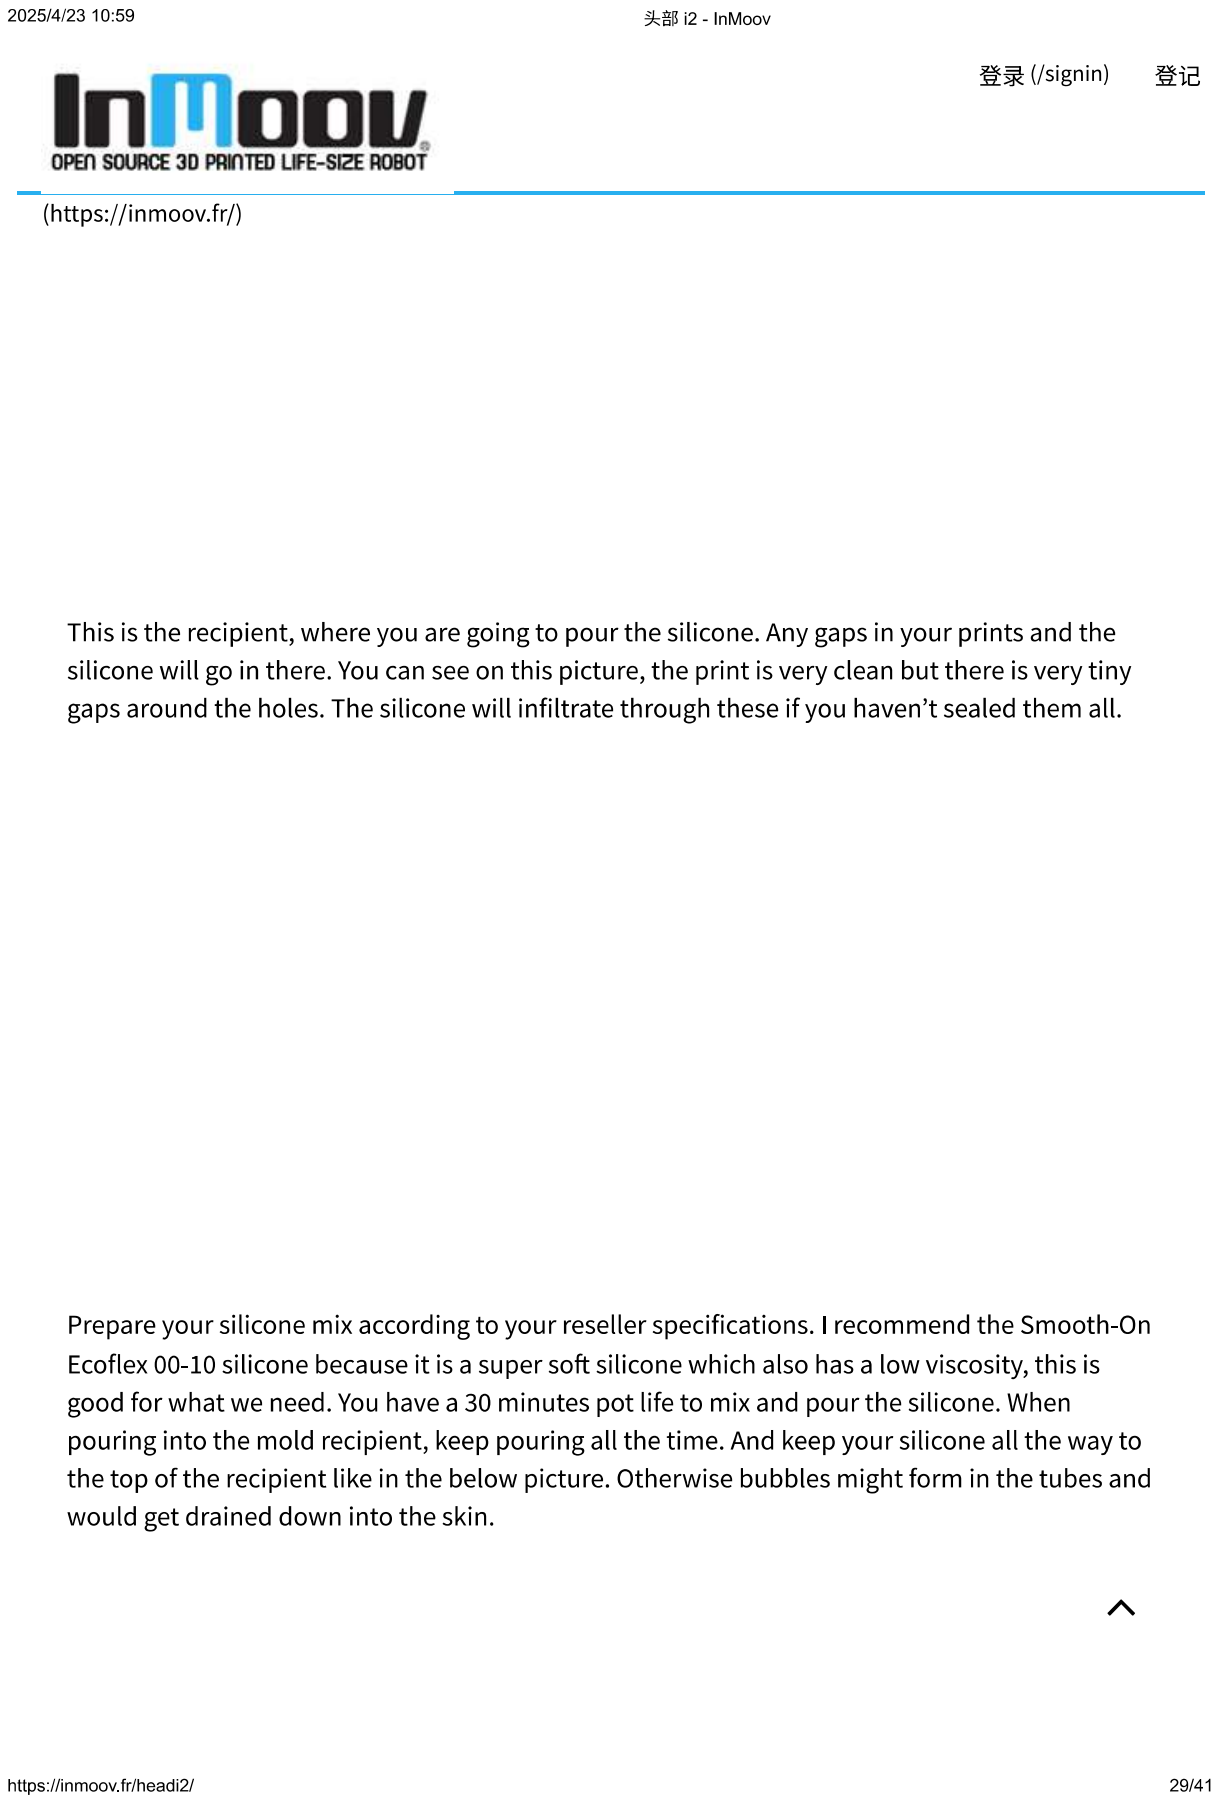
[picture p406: page 29]
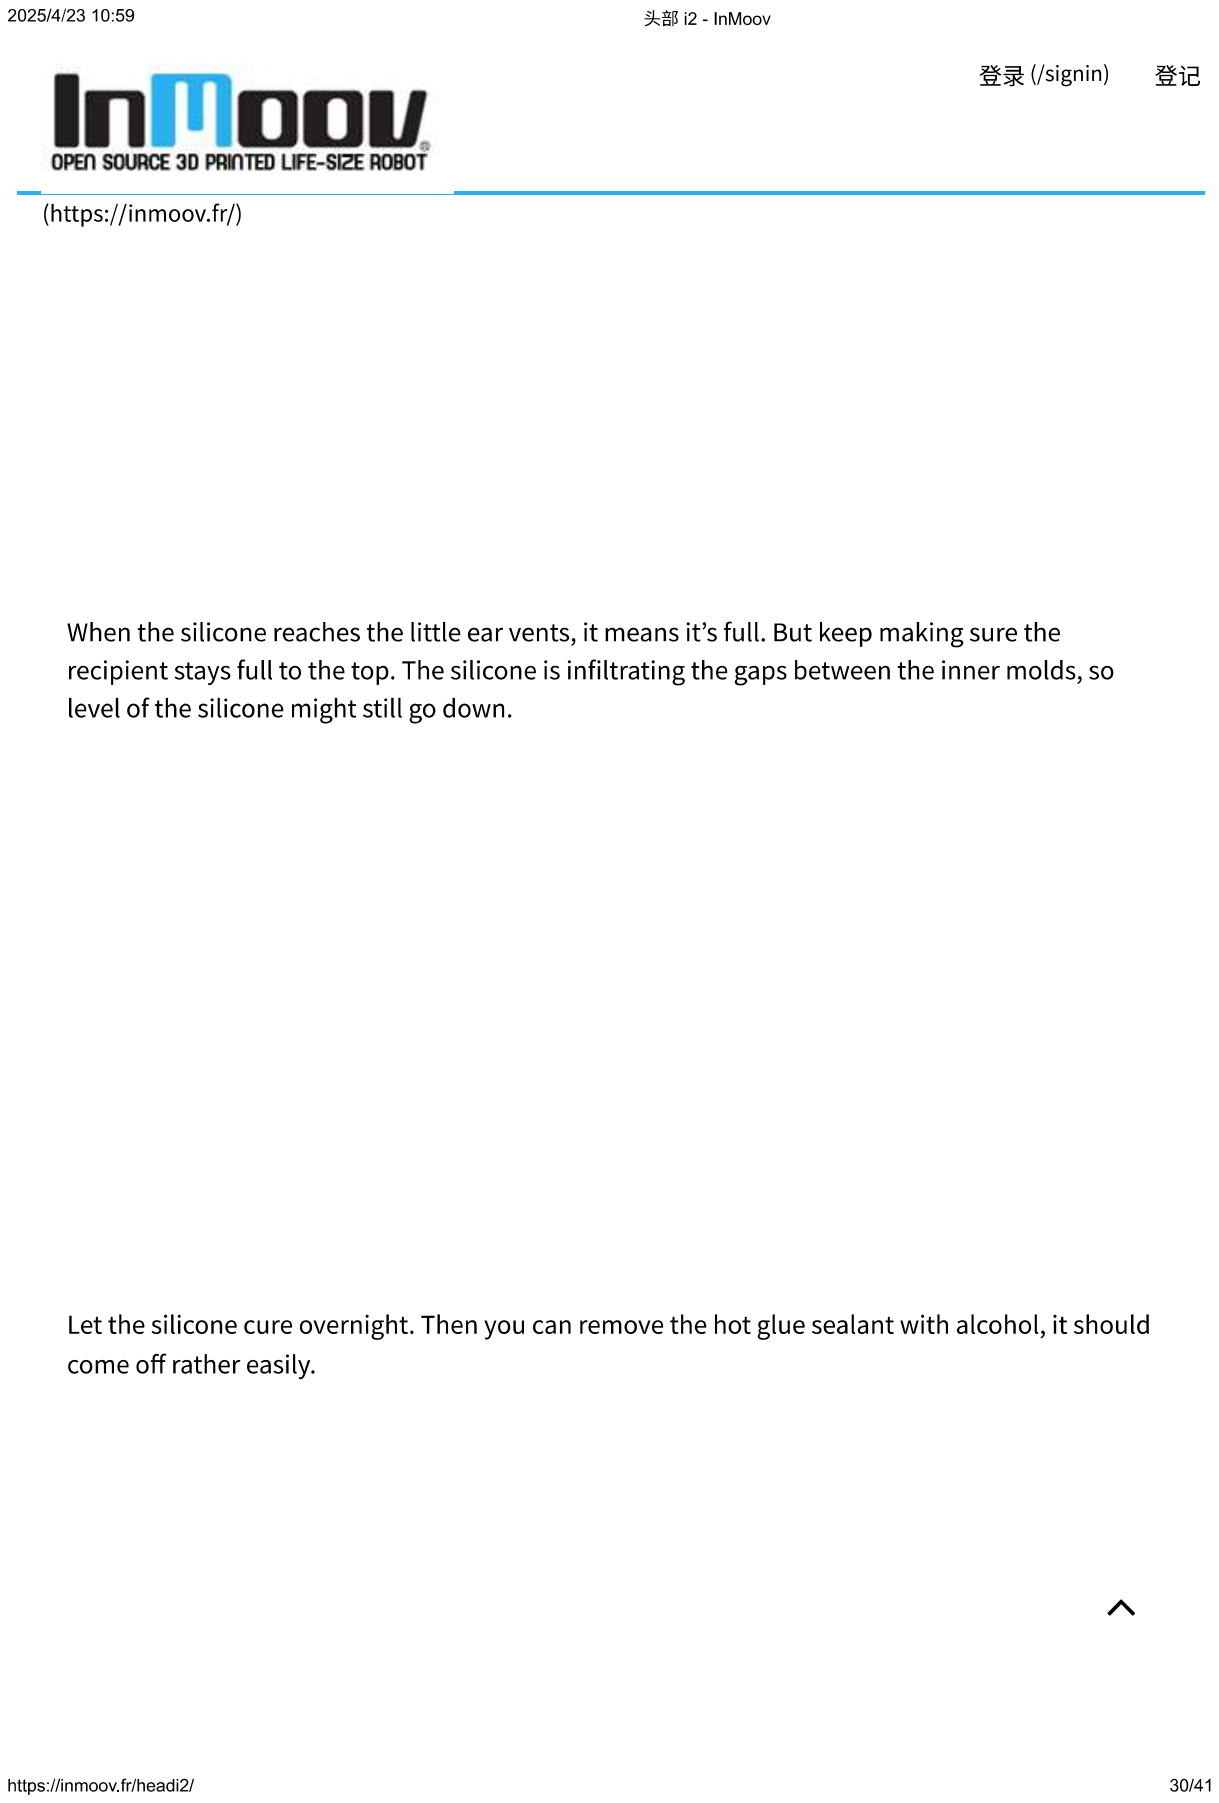
[picture p407: page 30]
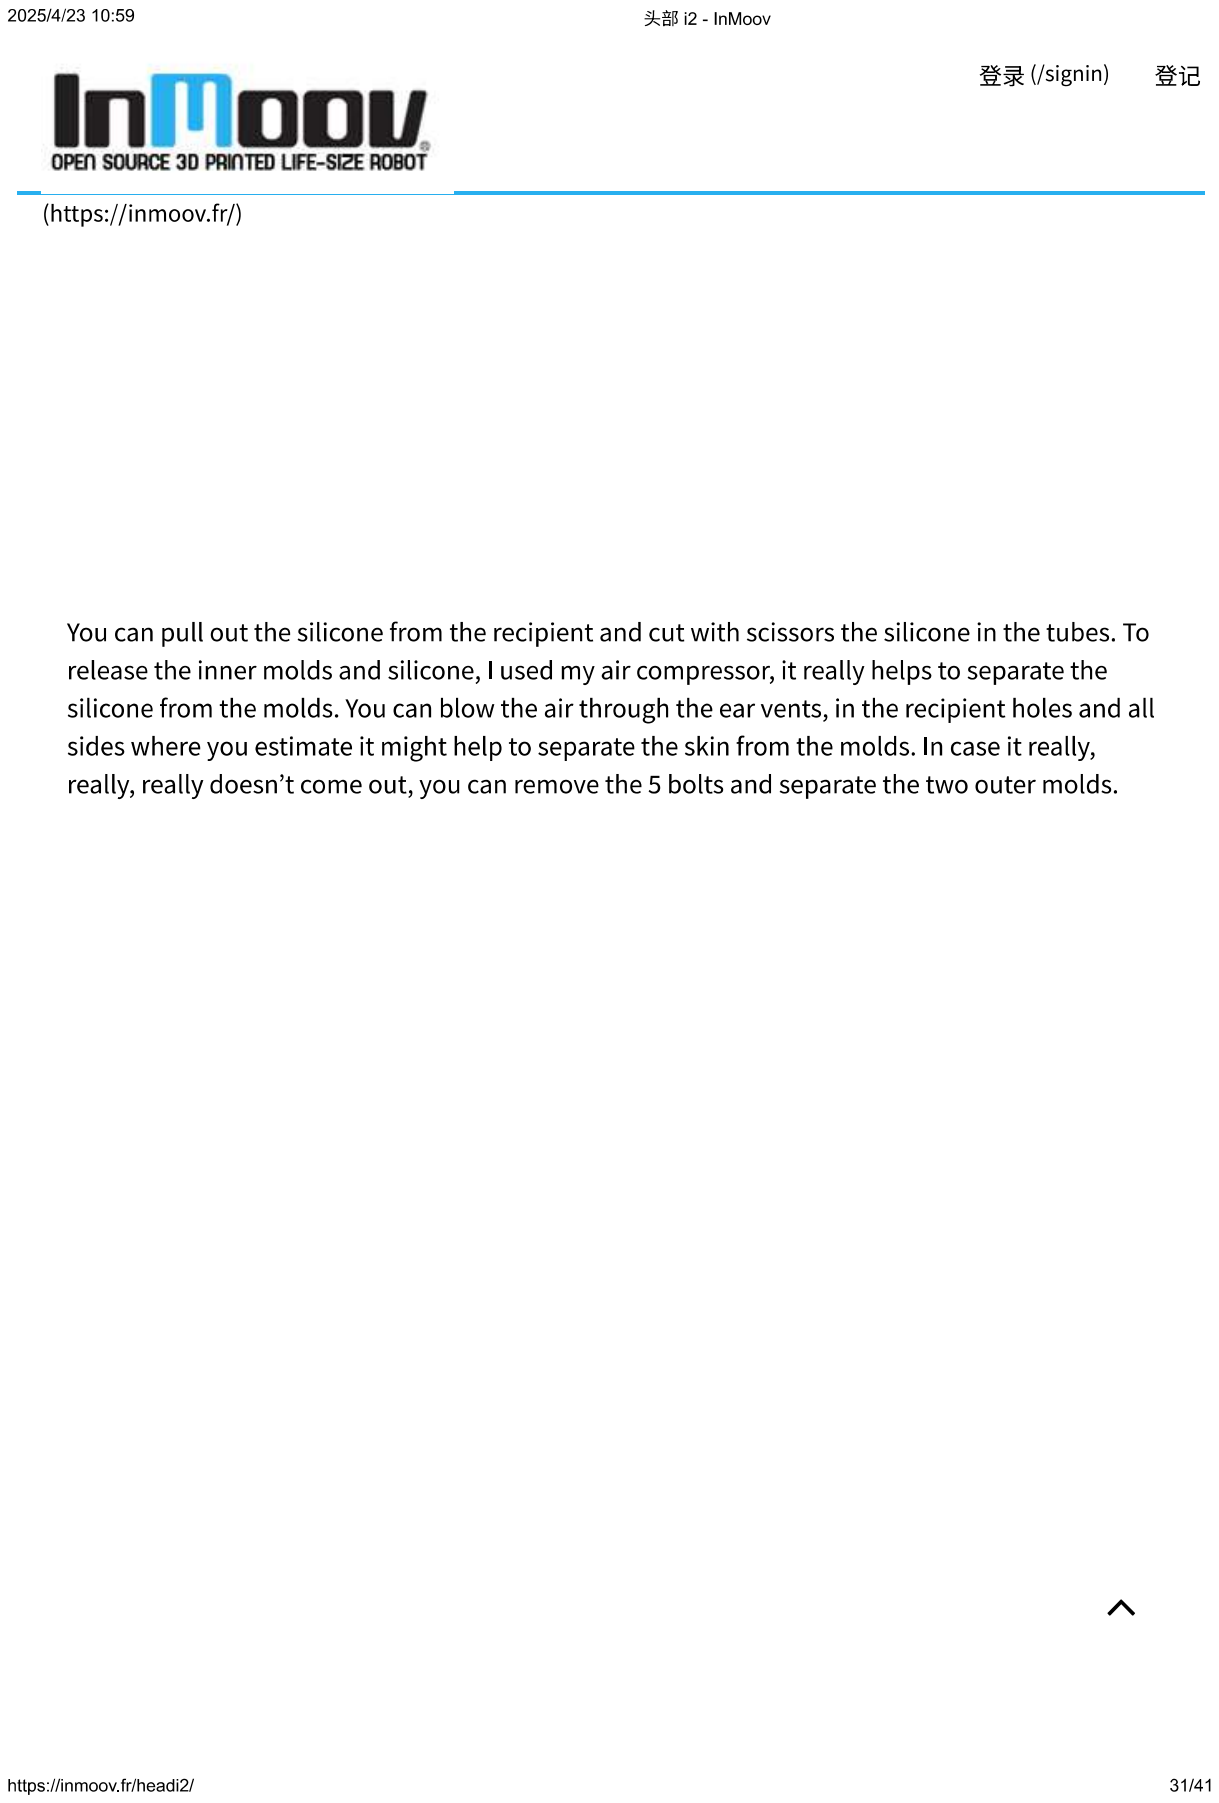
[picture p408: page 31]
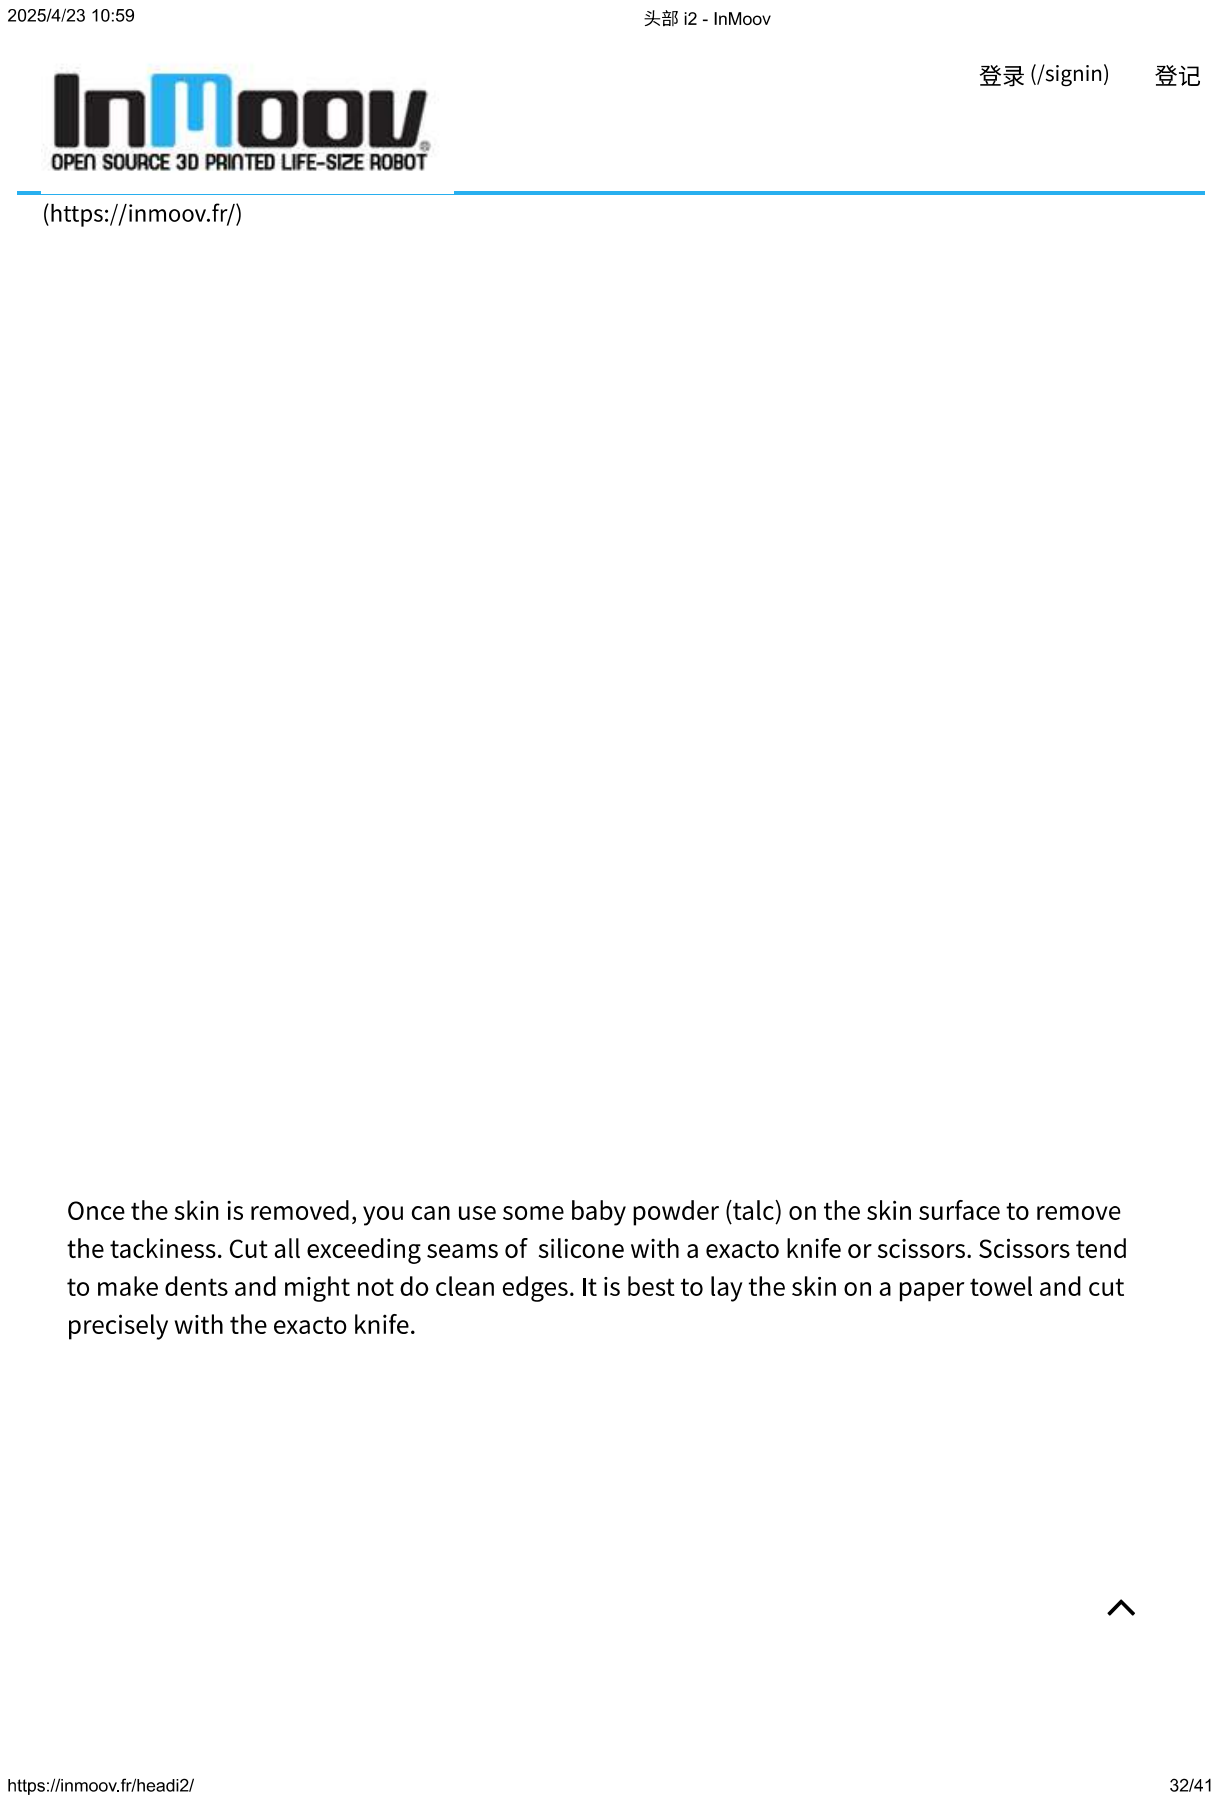
[picture p409: page 32]
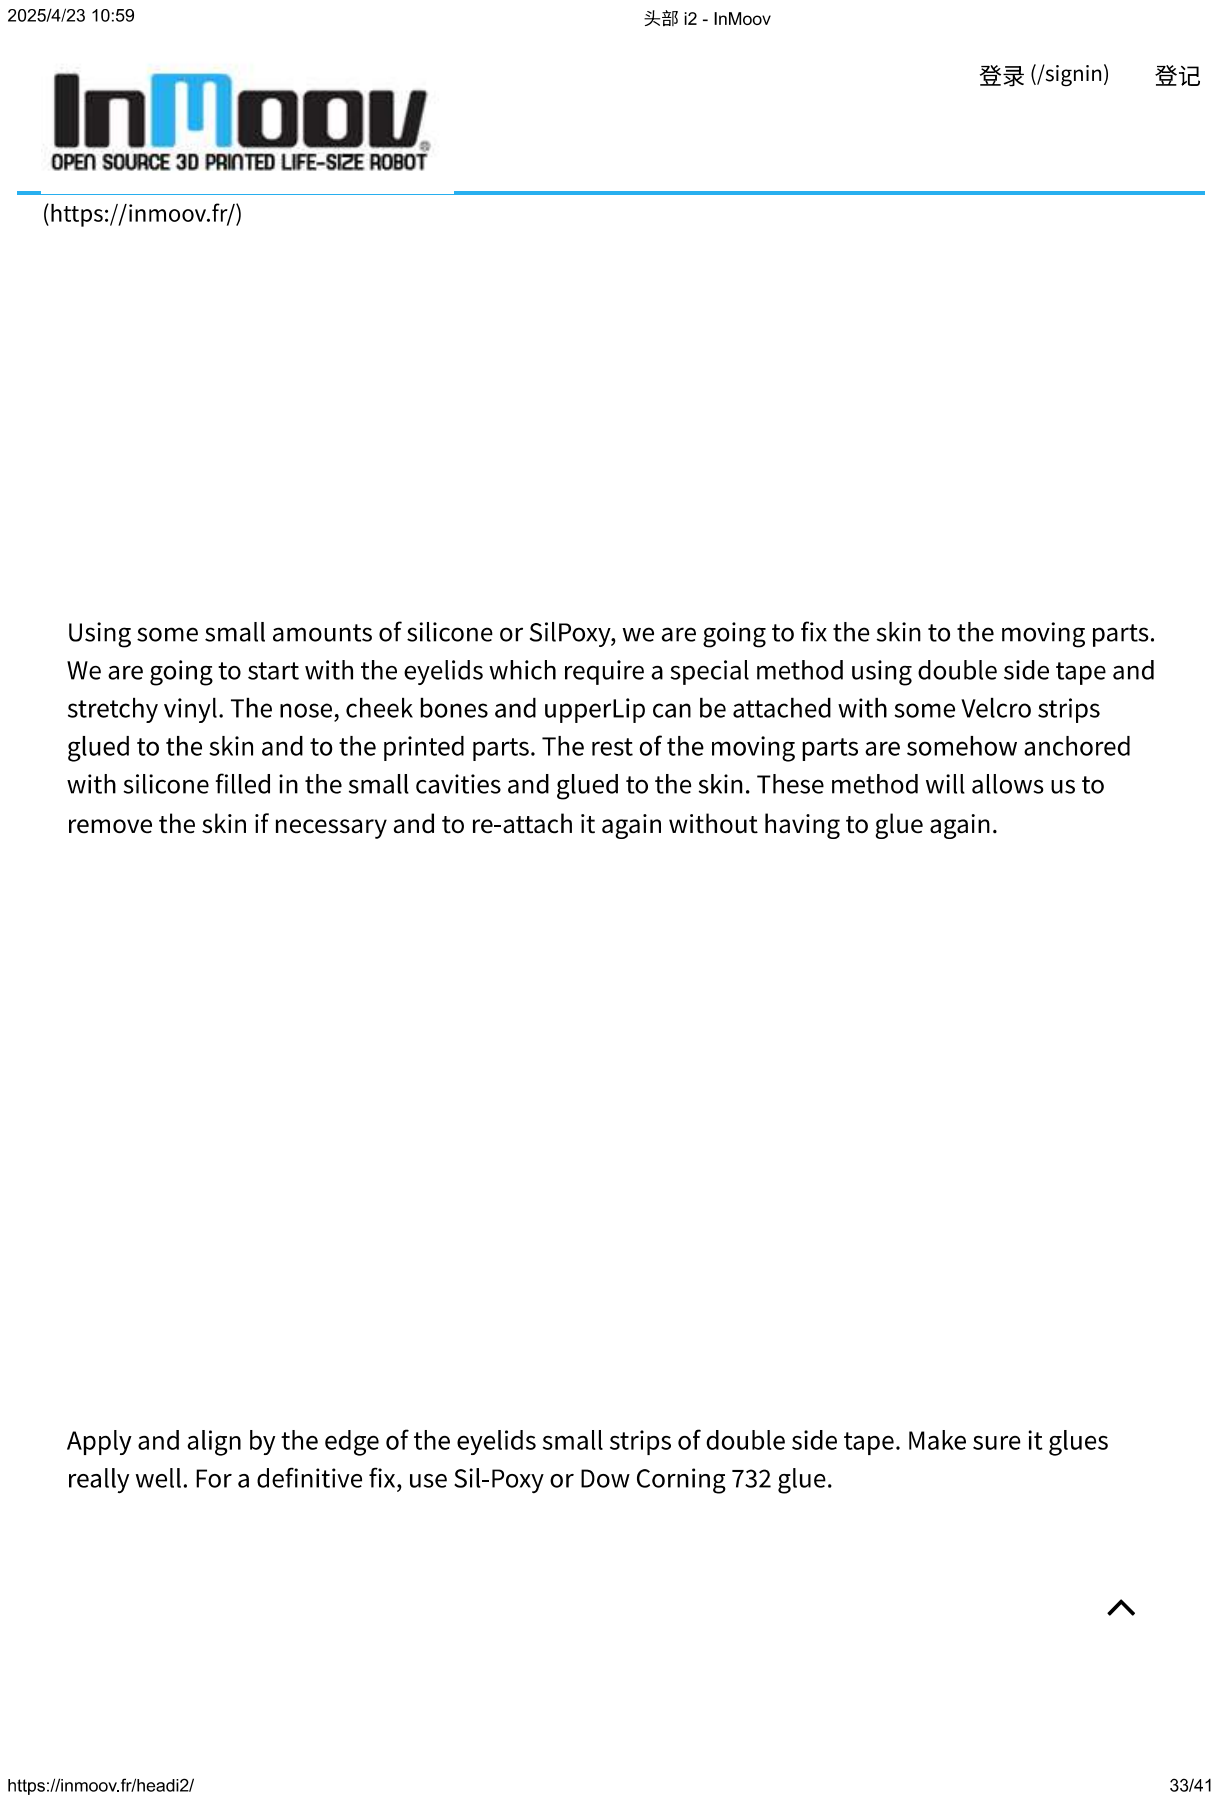
[picture p410: page 33]
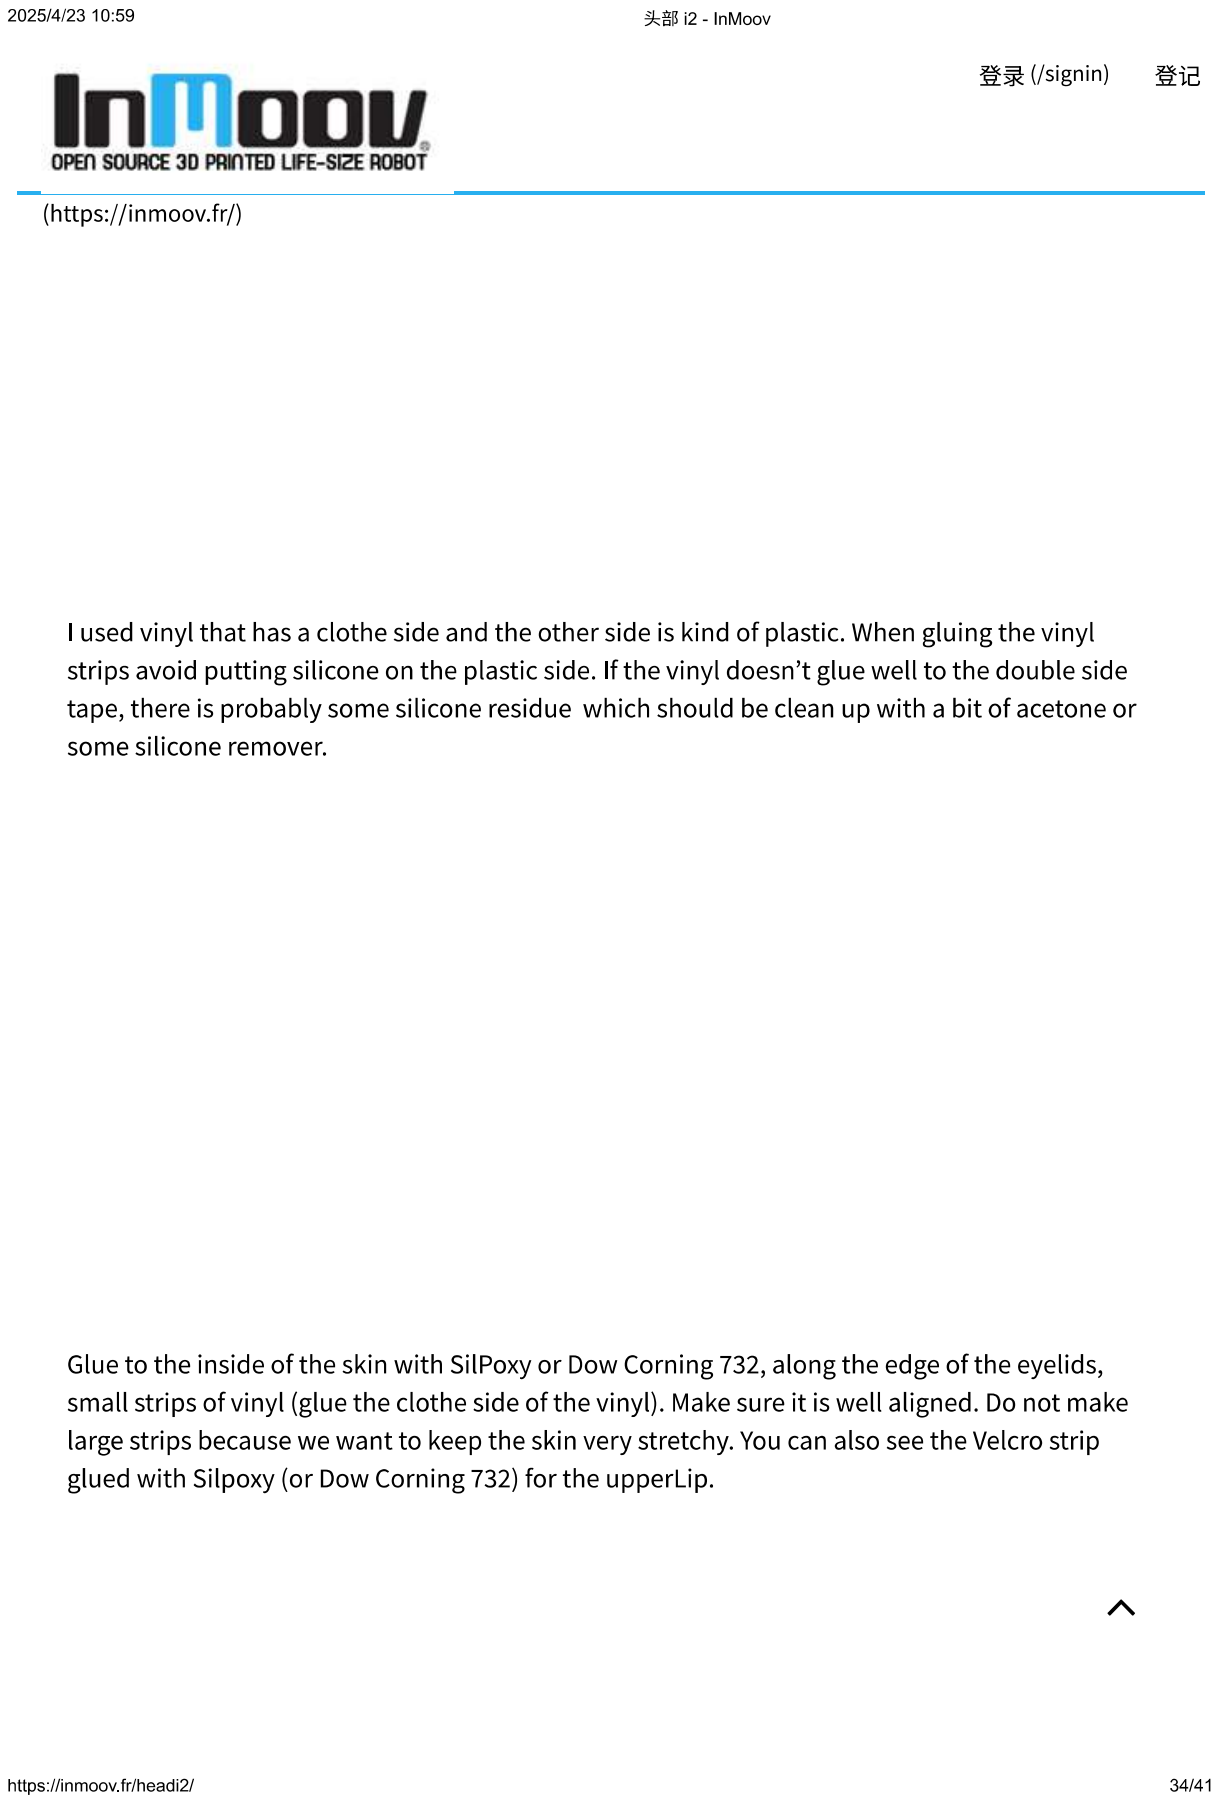
[picture p411: page 34]
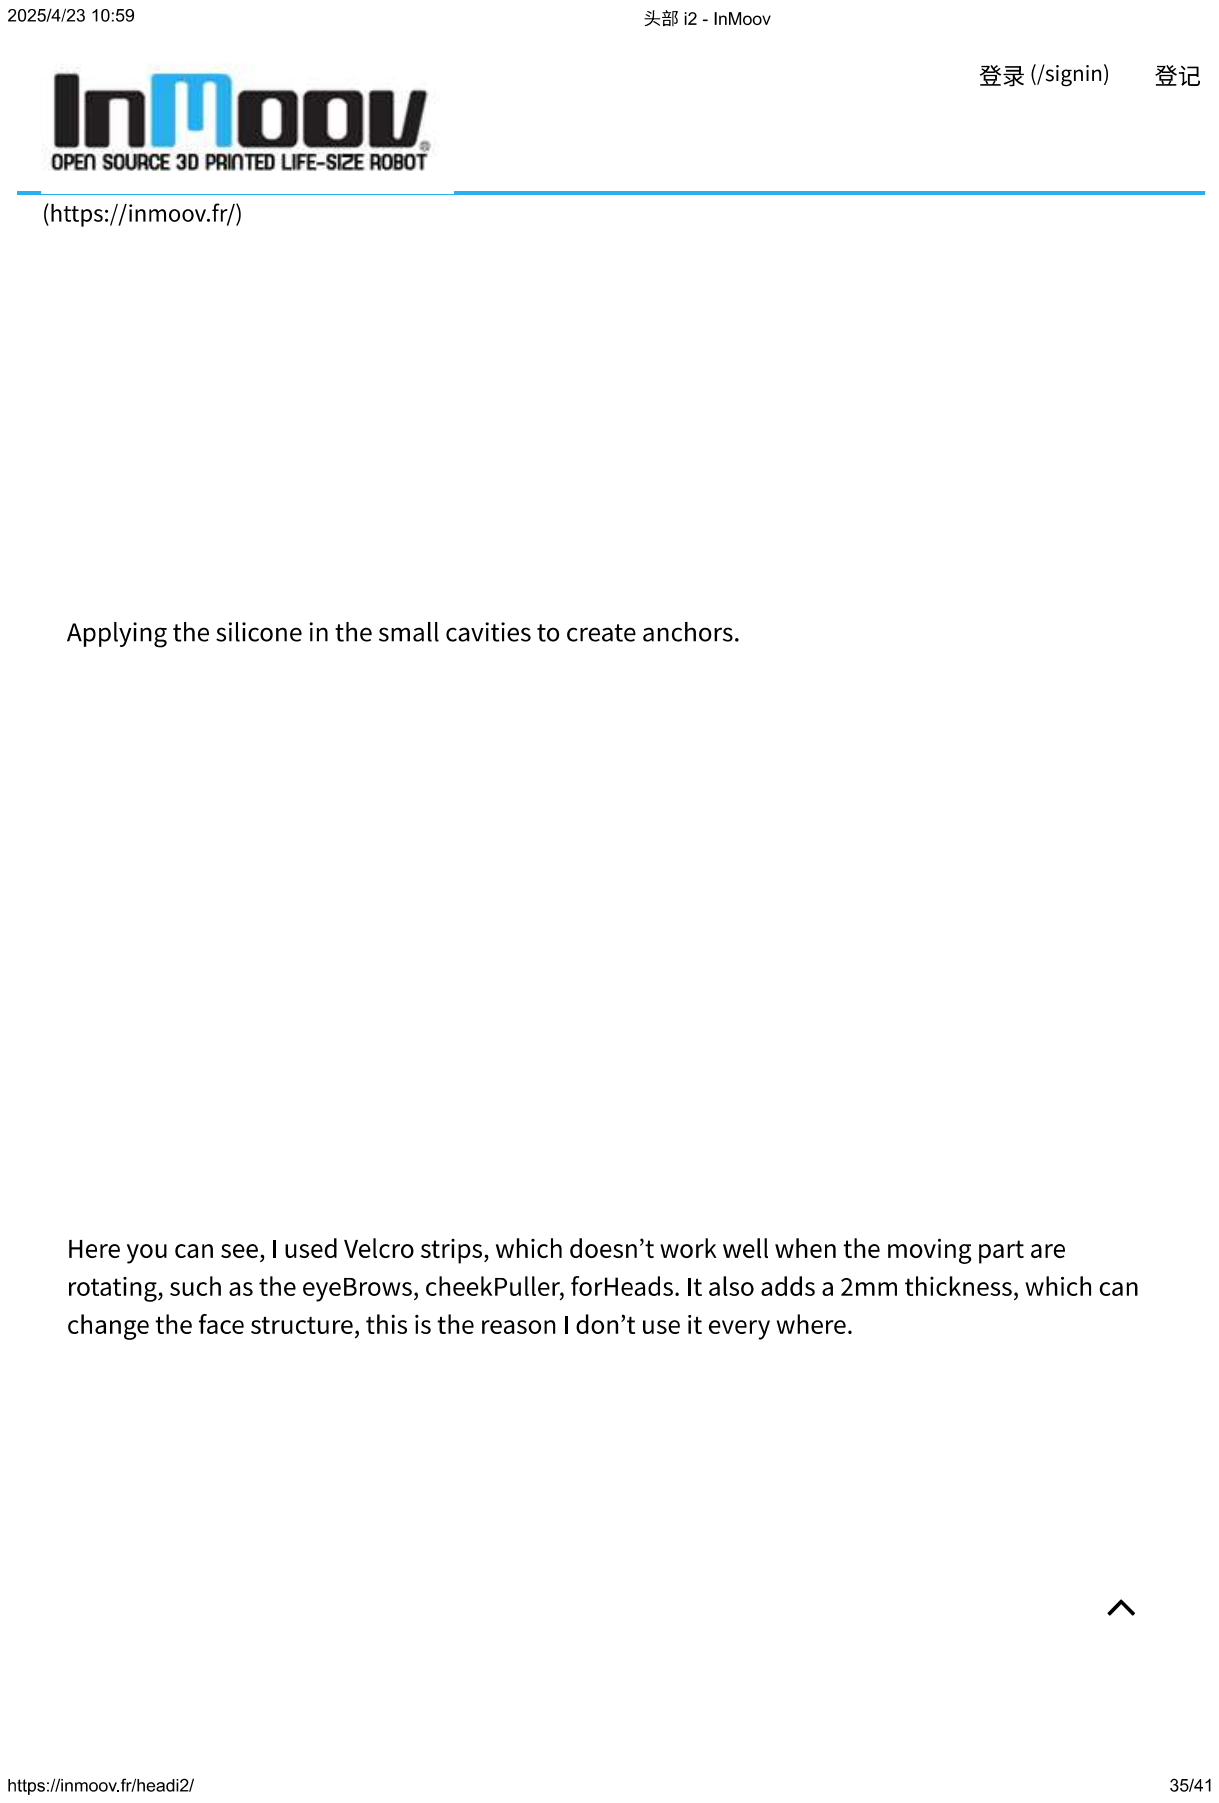
[picture p412: page 35]
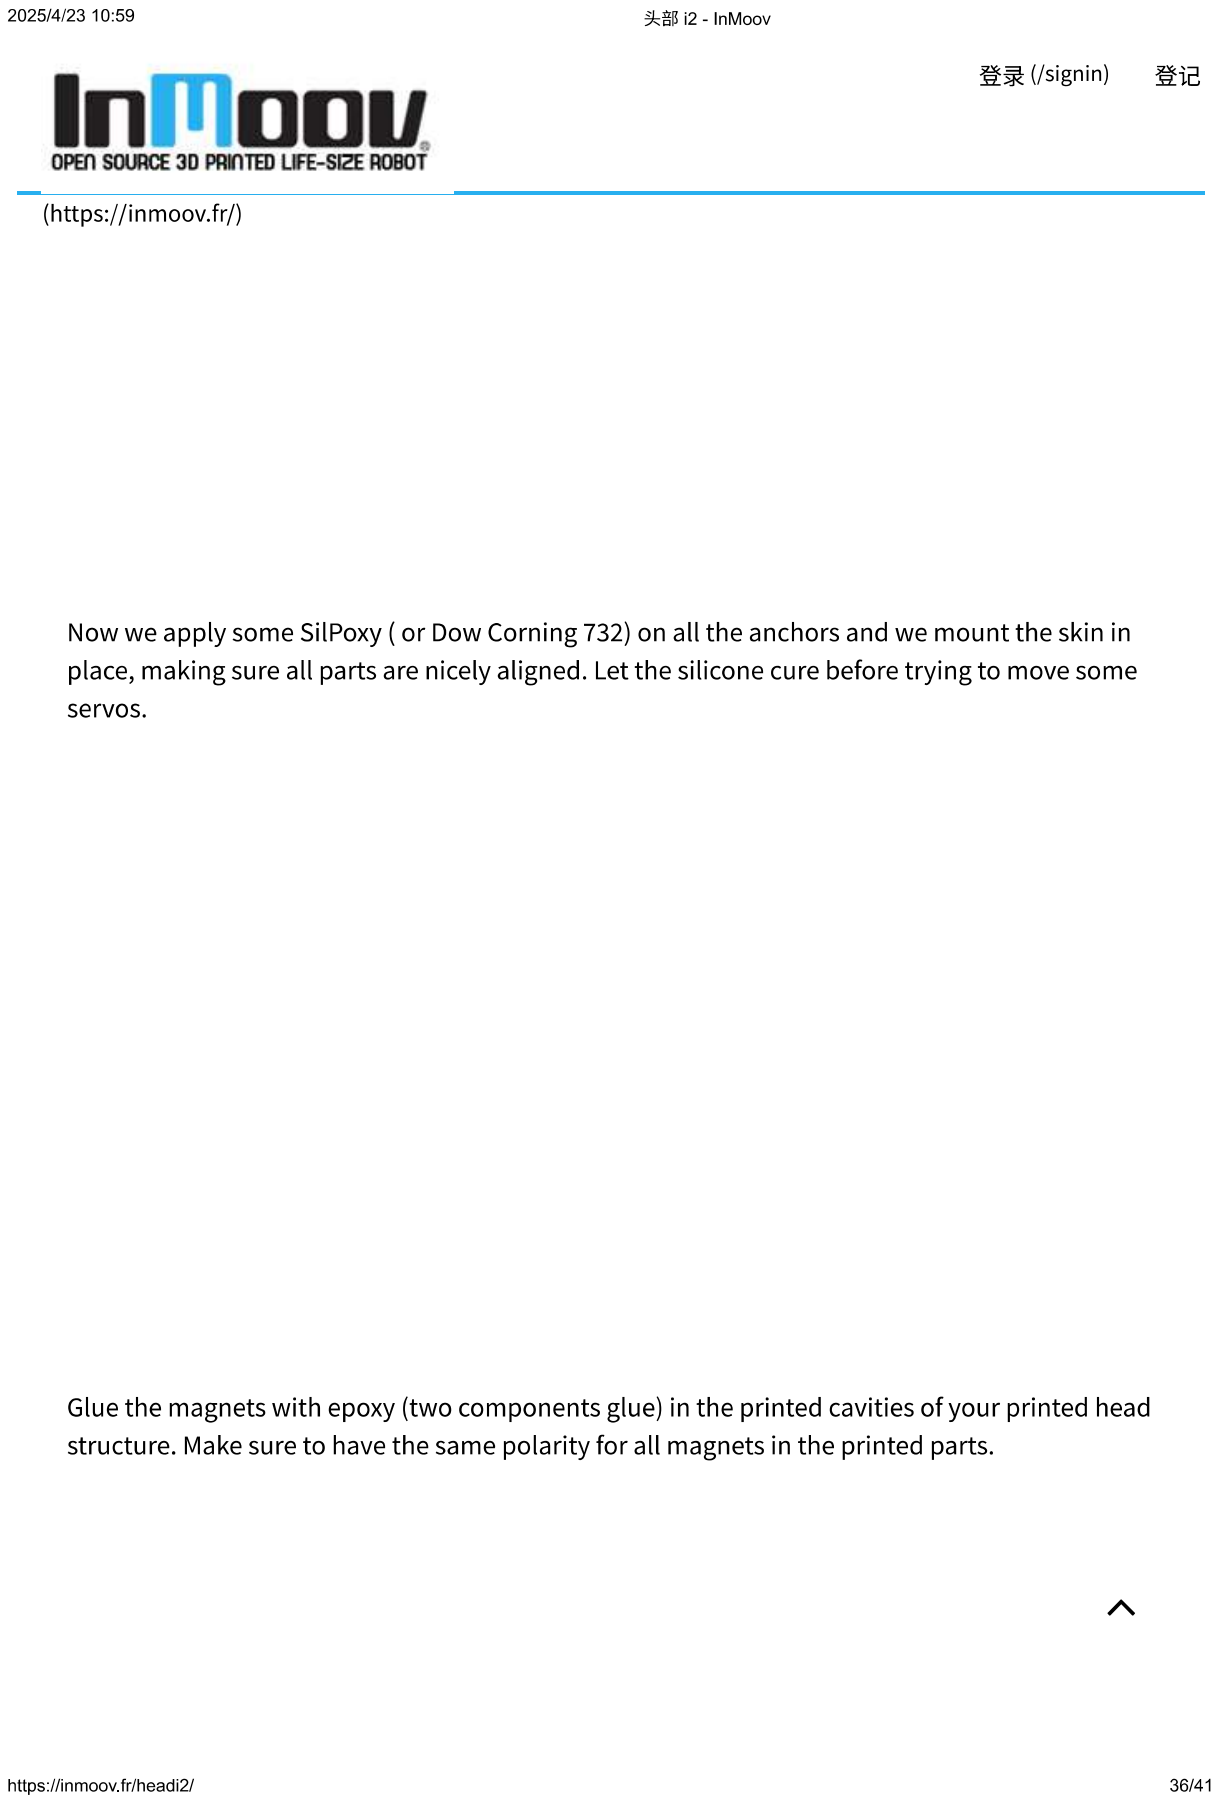
[picture p413: page 36]
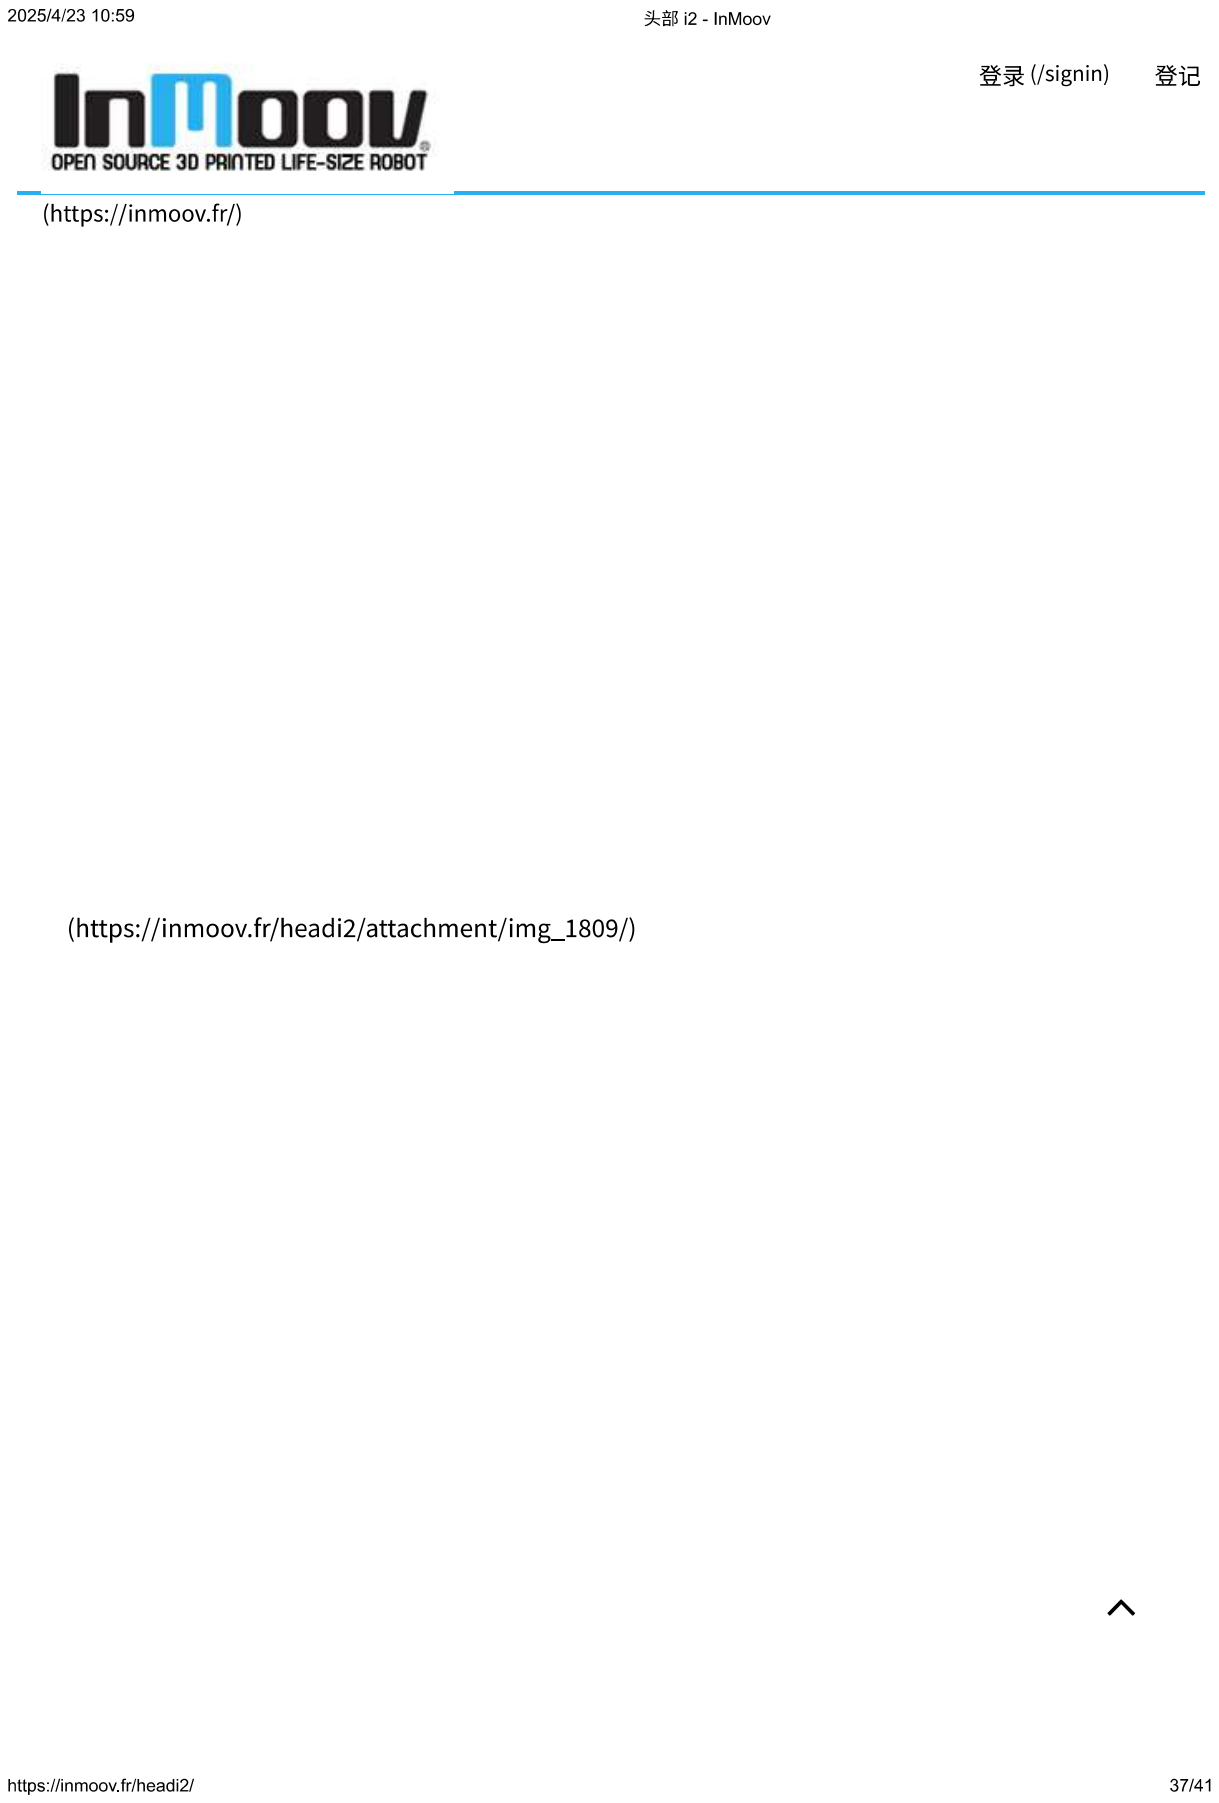
[picture p414: page 37]
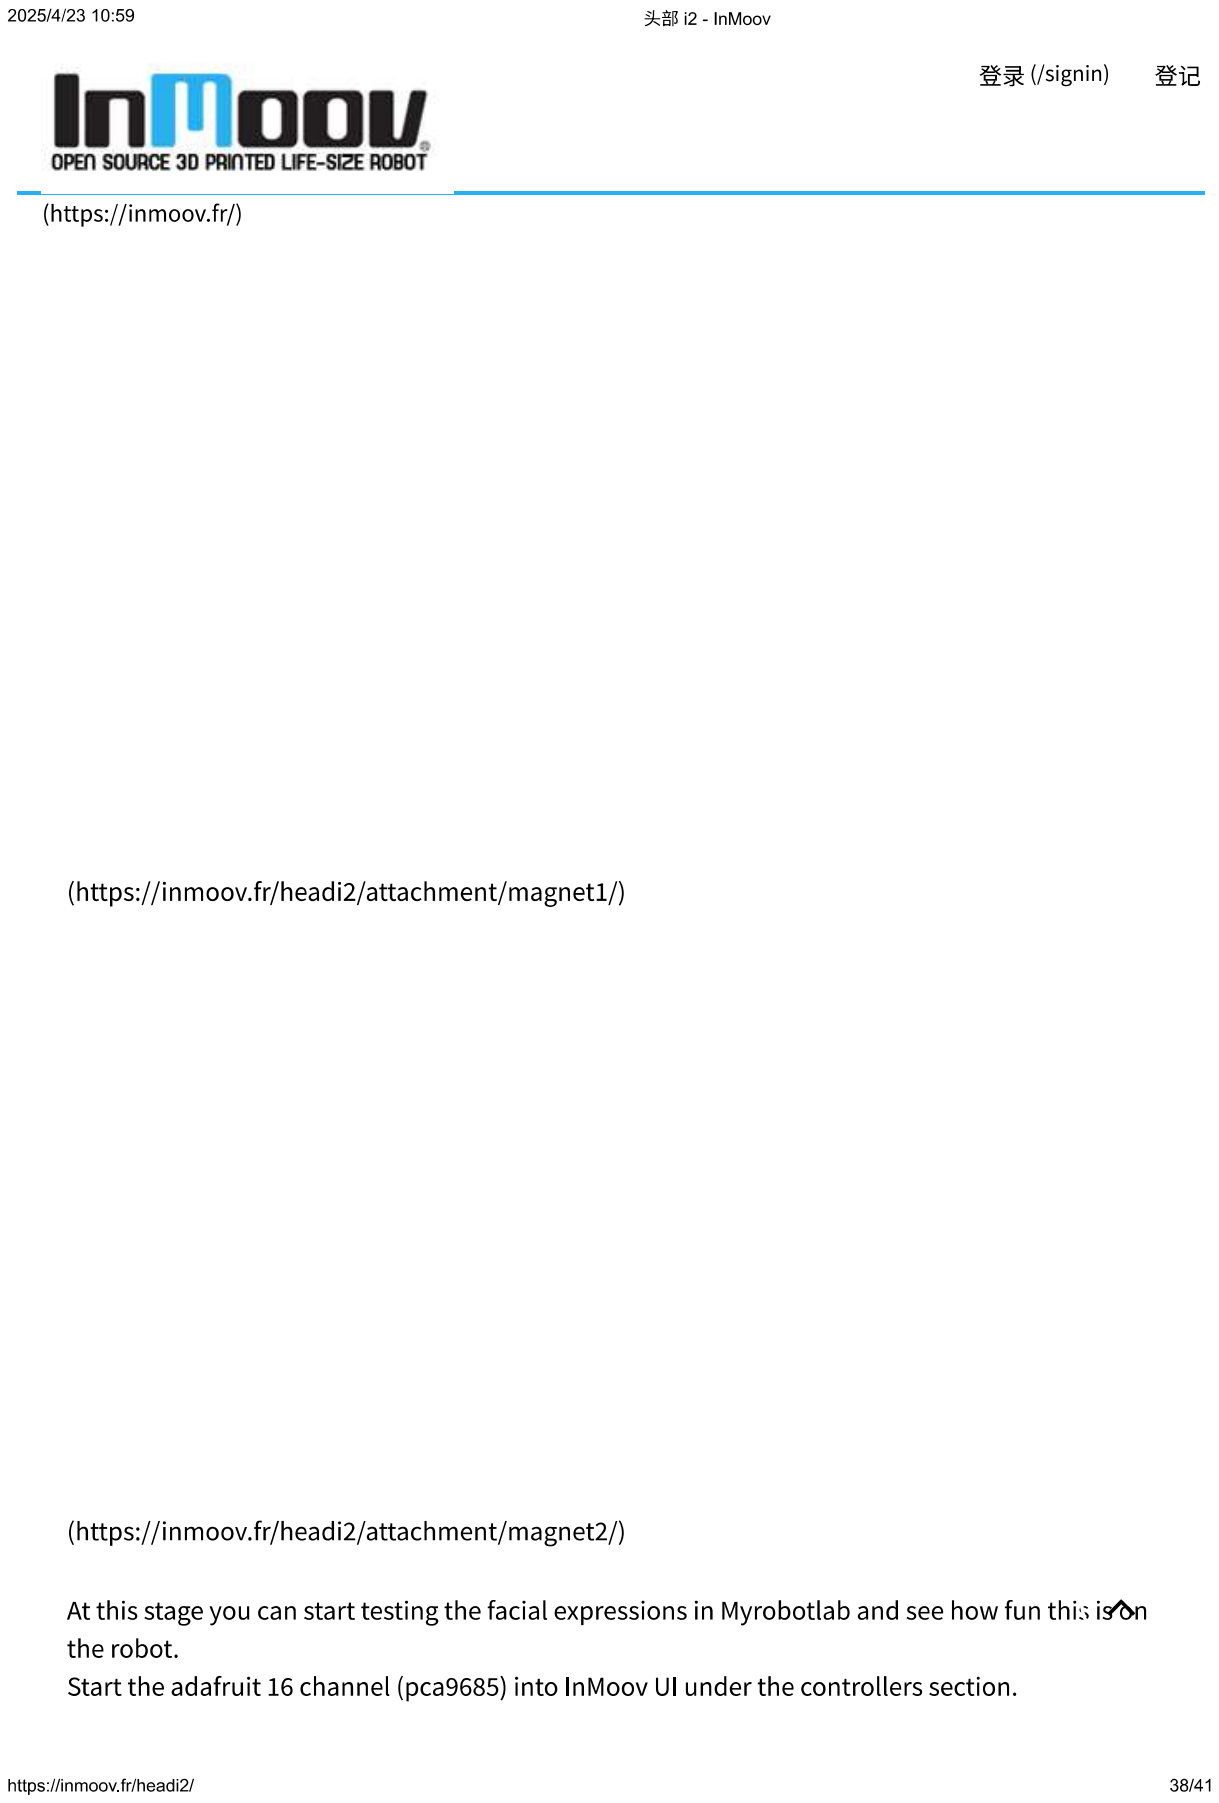
[picture p415: page 38]
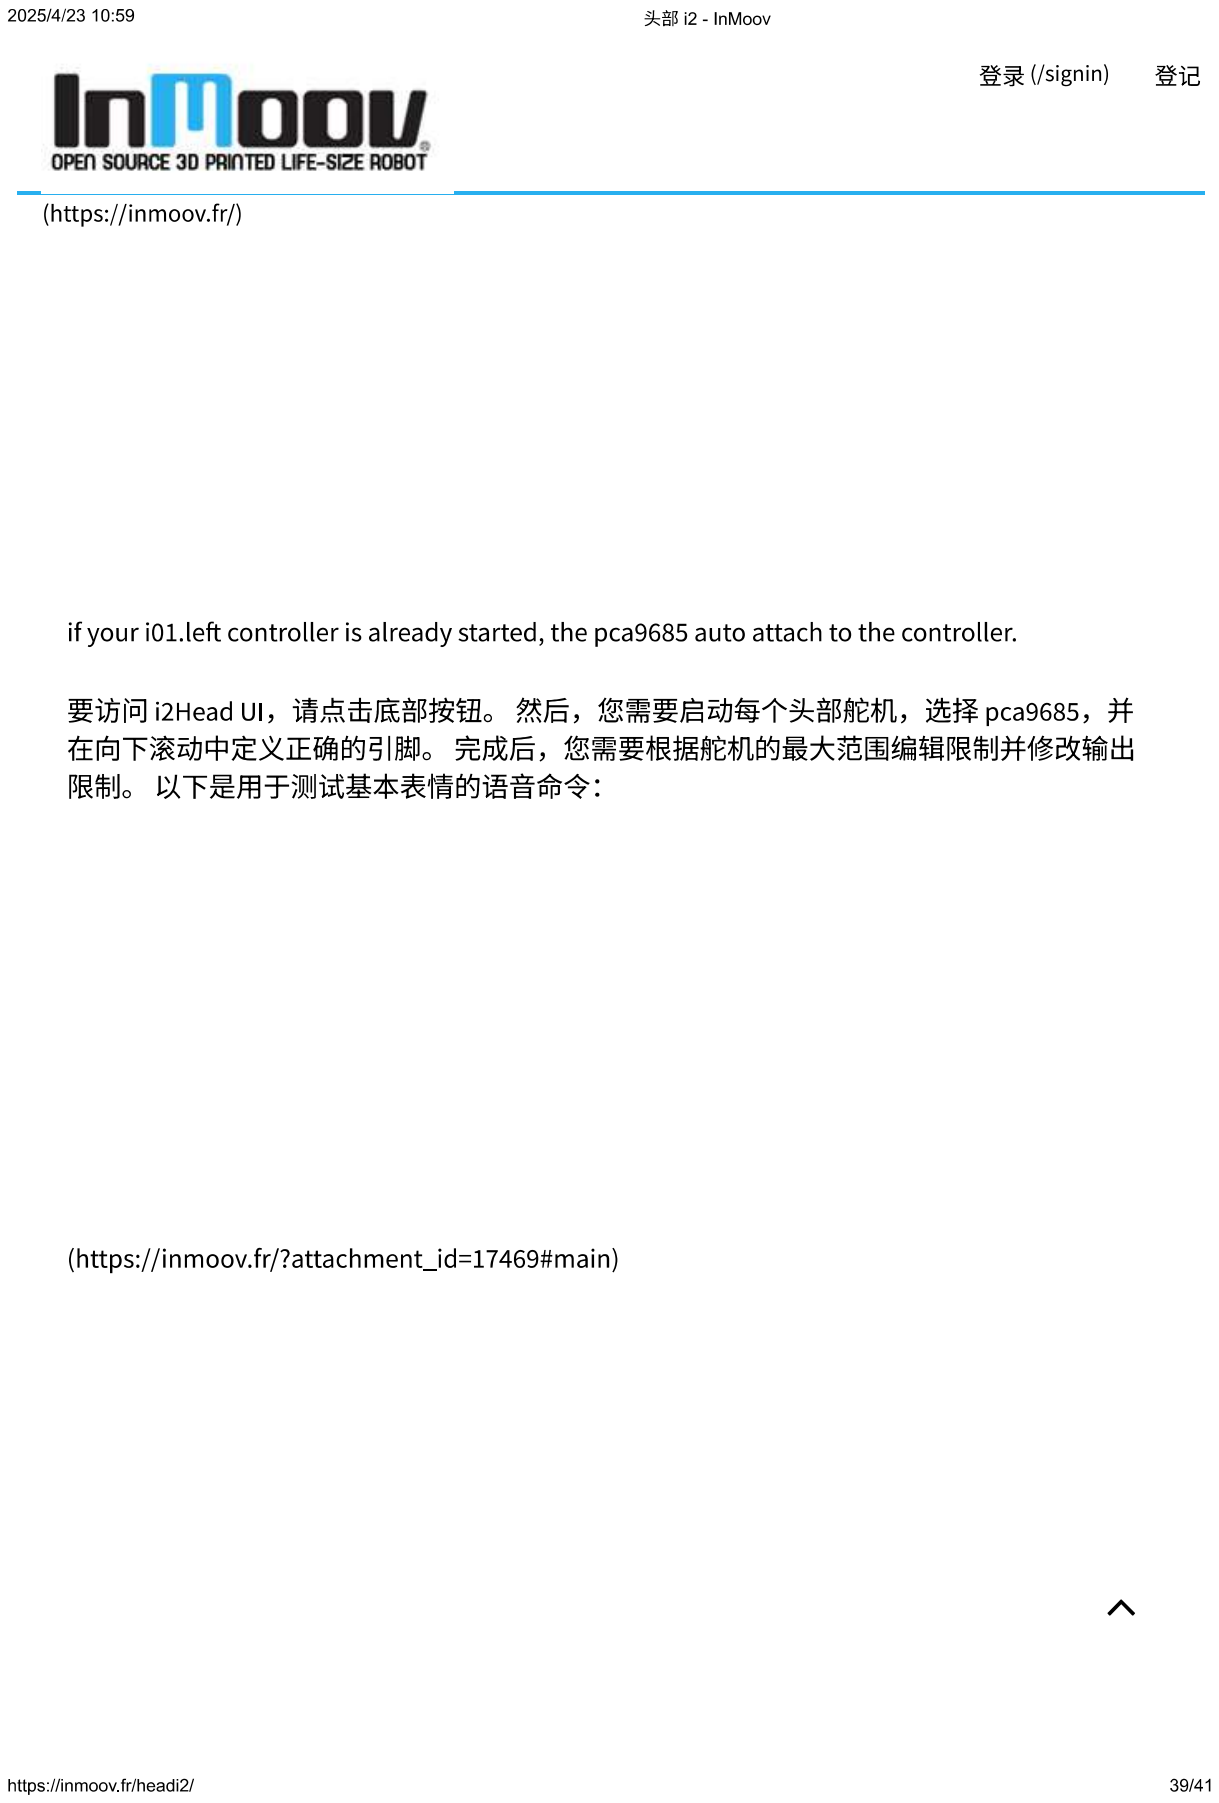
[picture p416: page 39]
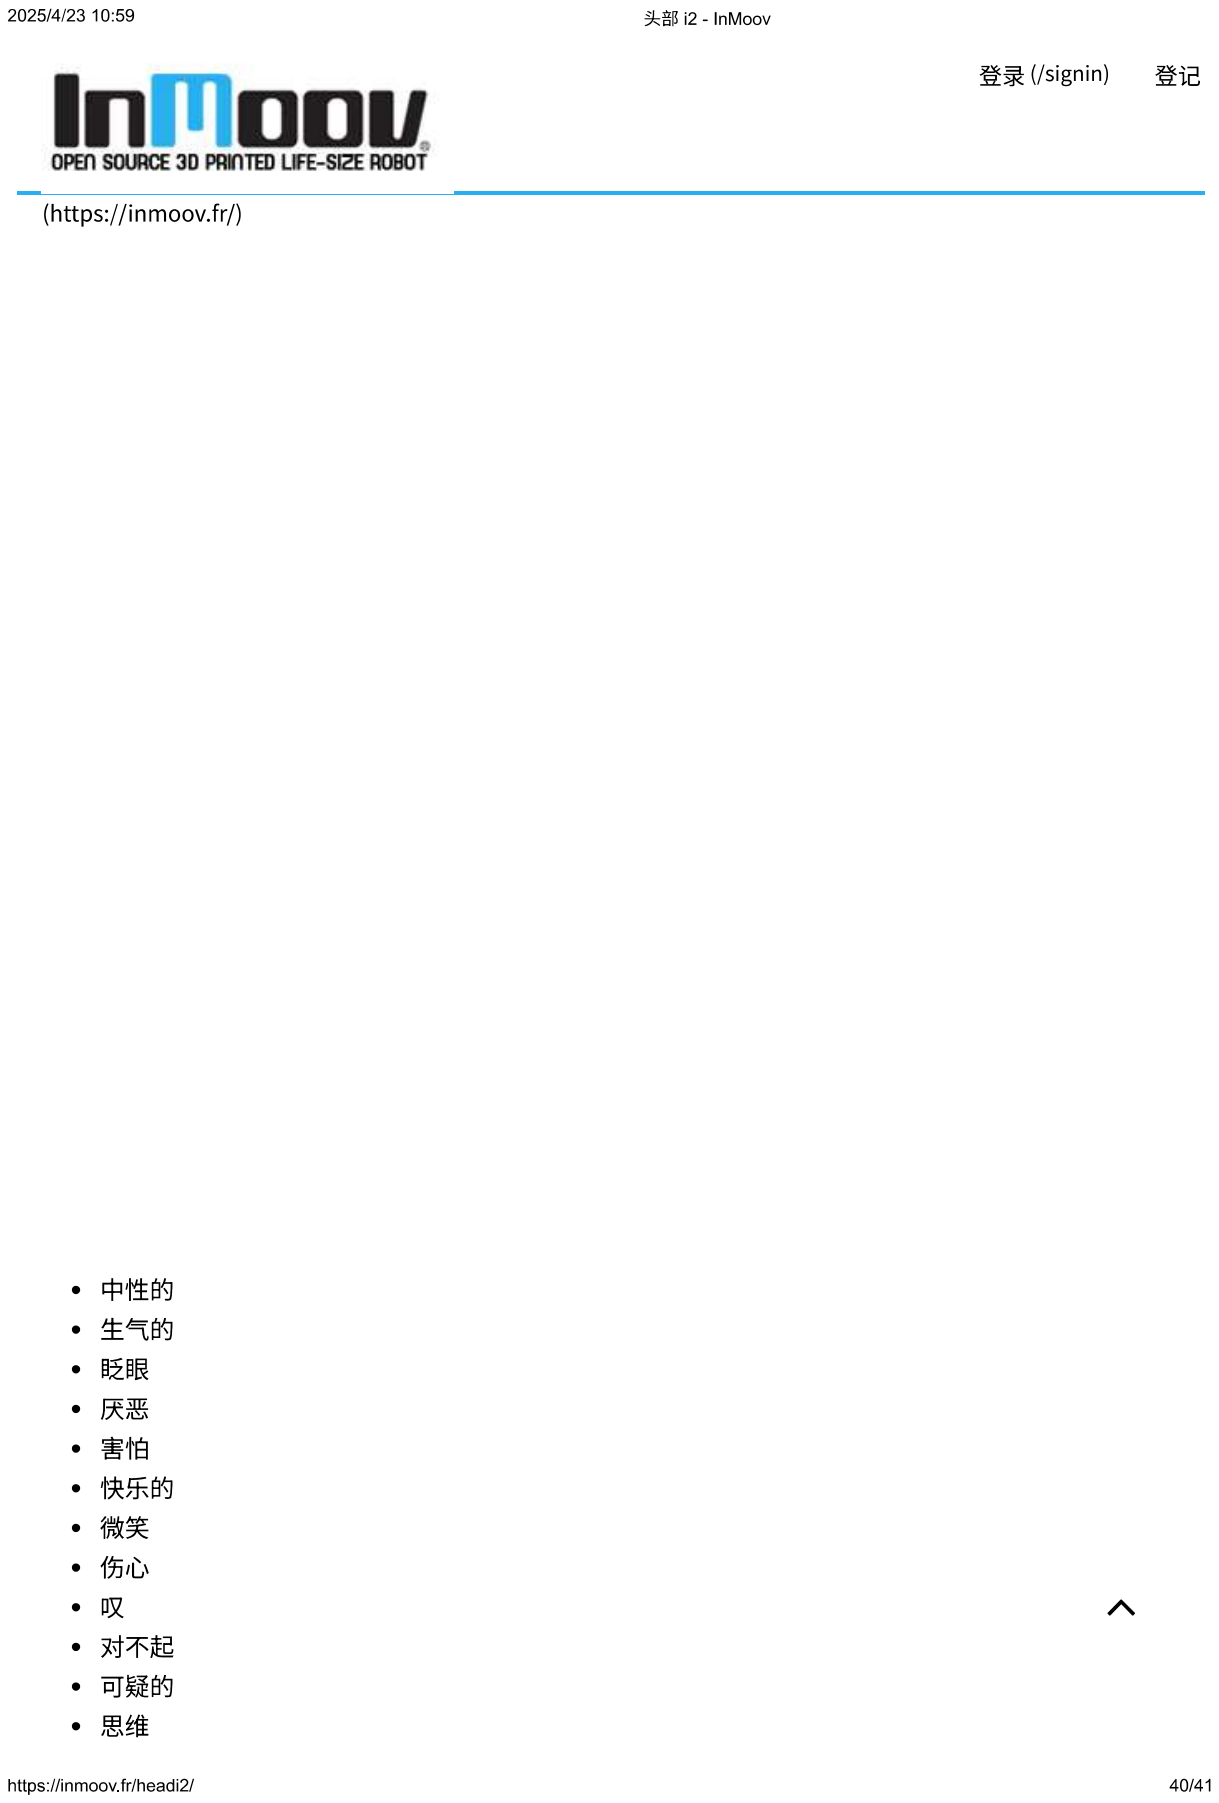
[picture p417: page 40]
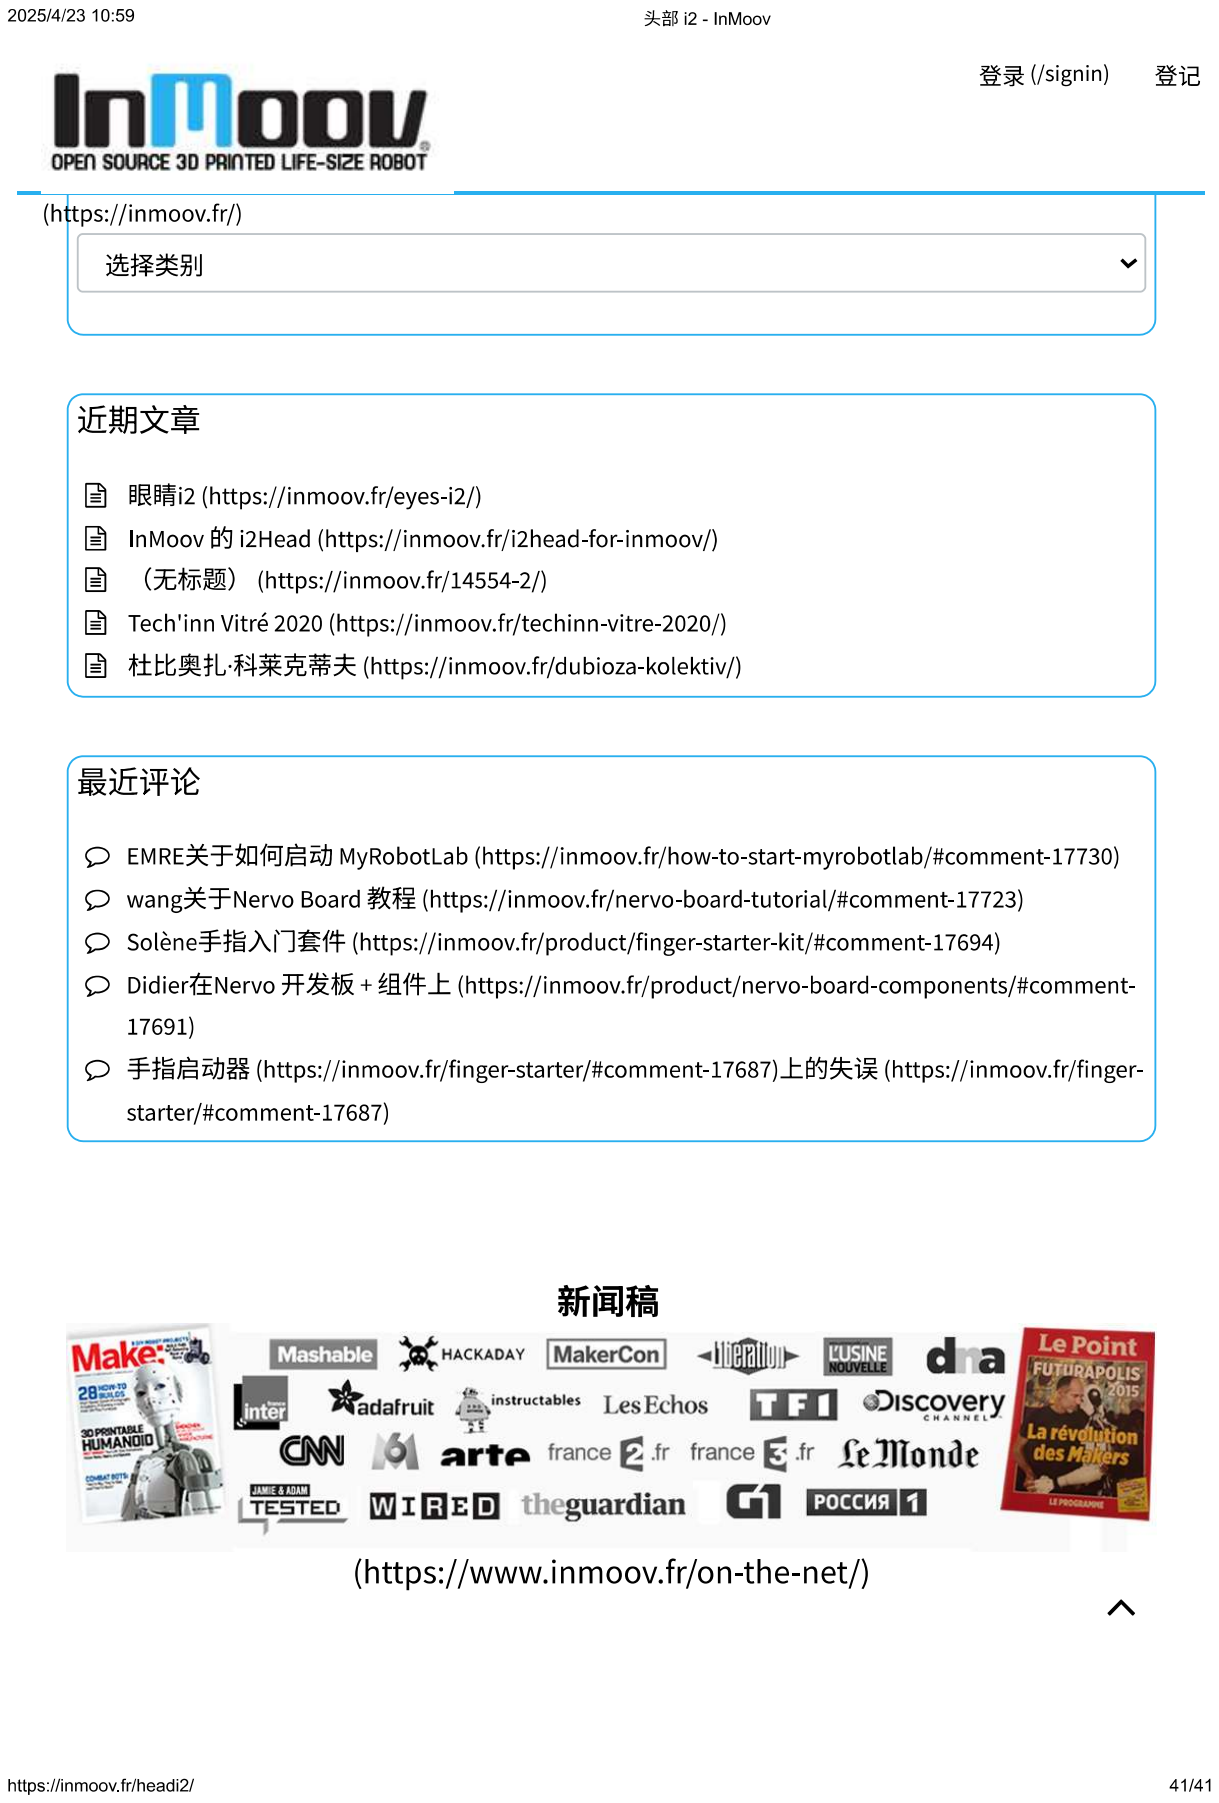
[picture p418: page 41]
