idolverse/Tulingjiuge_robot_1/零件组装教程+stl文件/Back-main/后背3D打印草图/后背3D打印草图.pdf

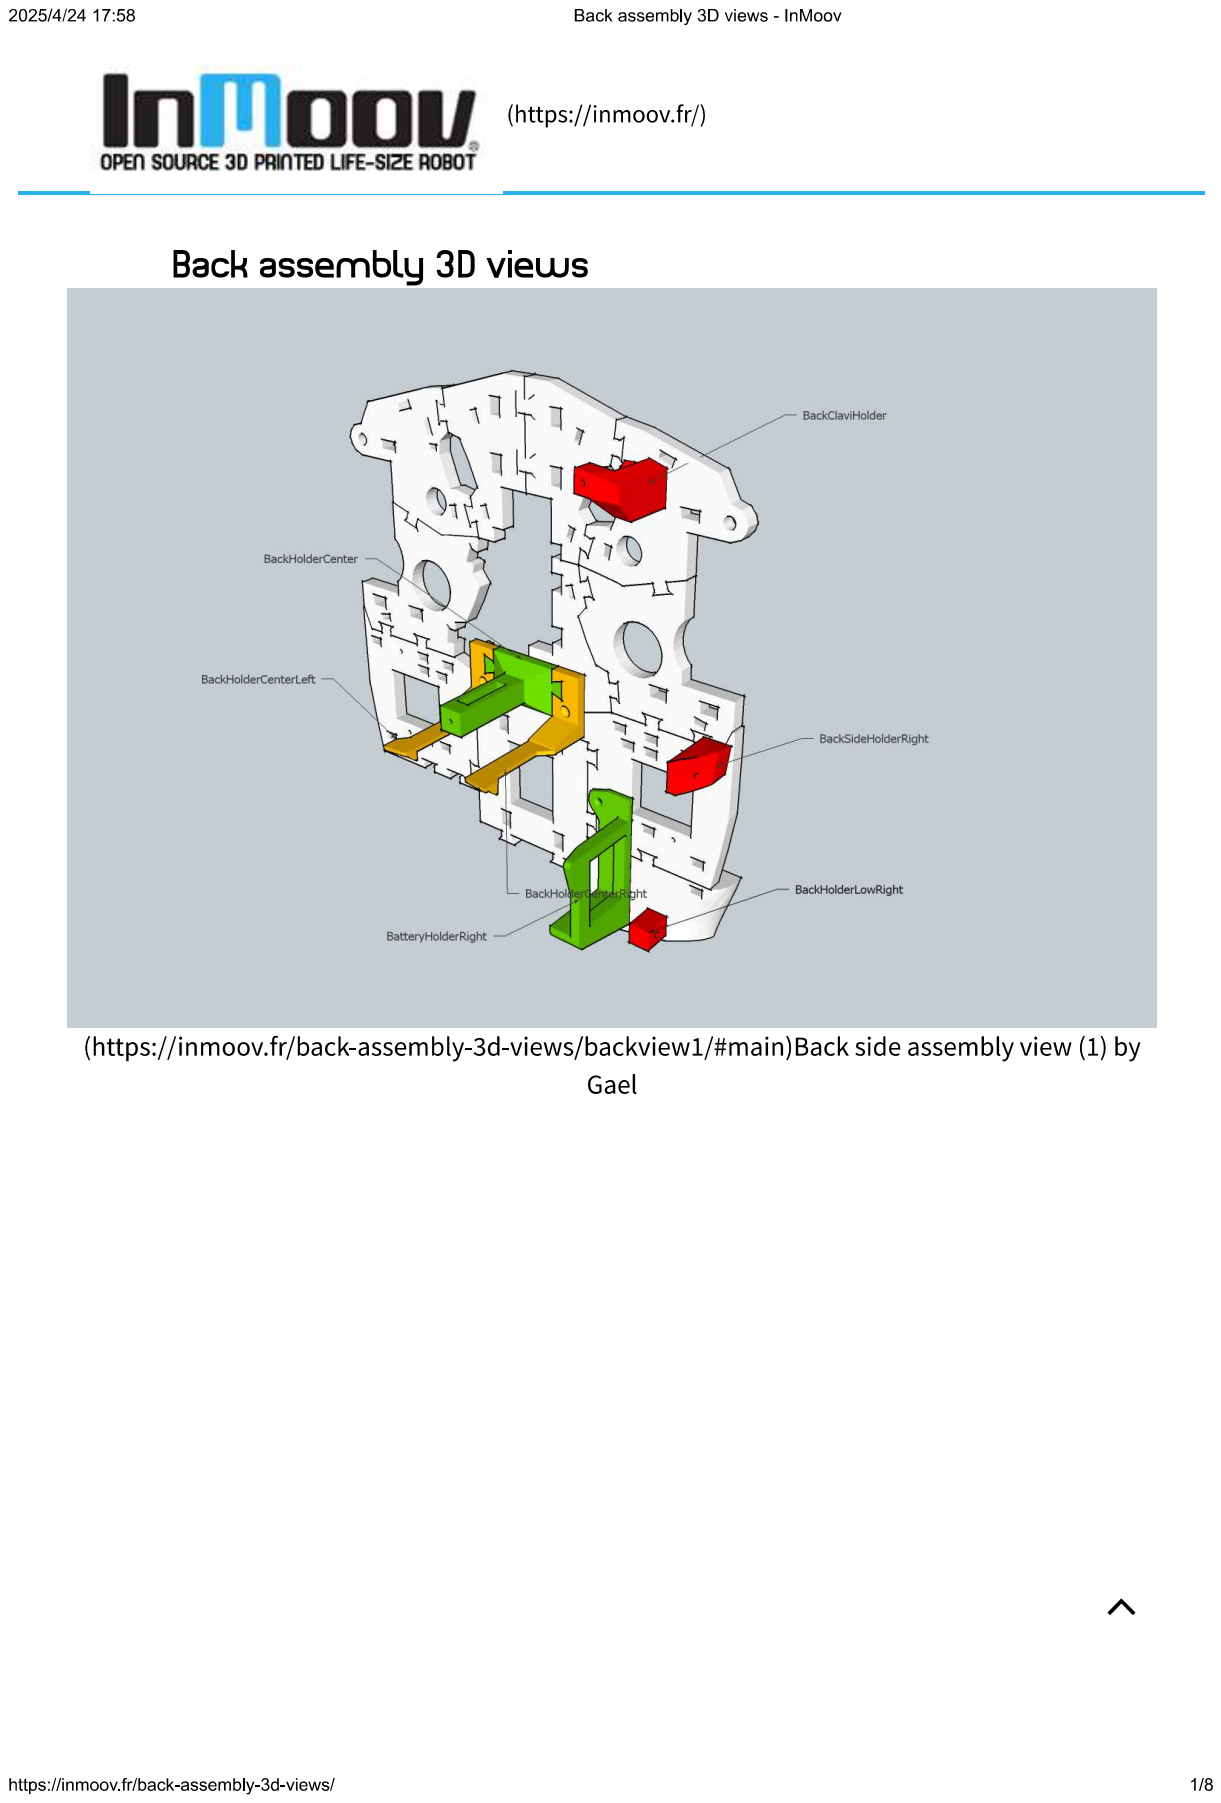
[picture p419: page 1]
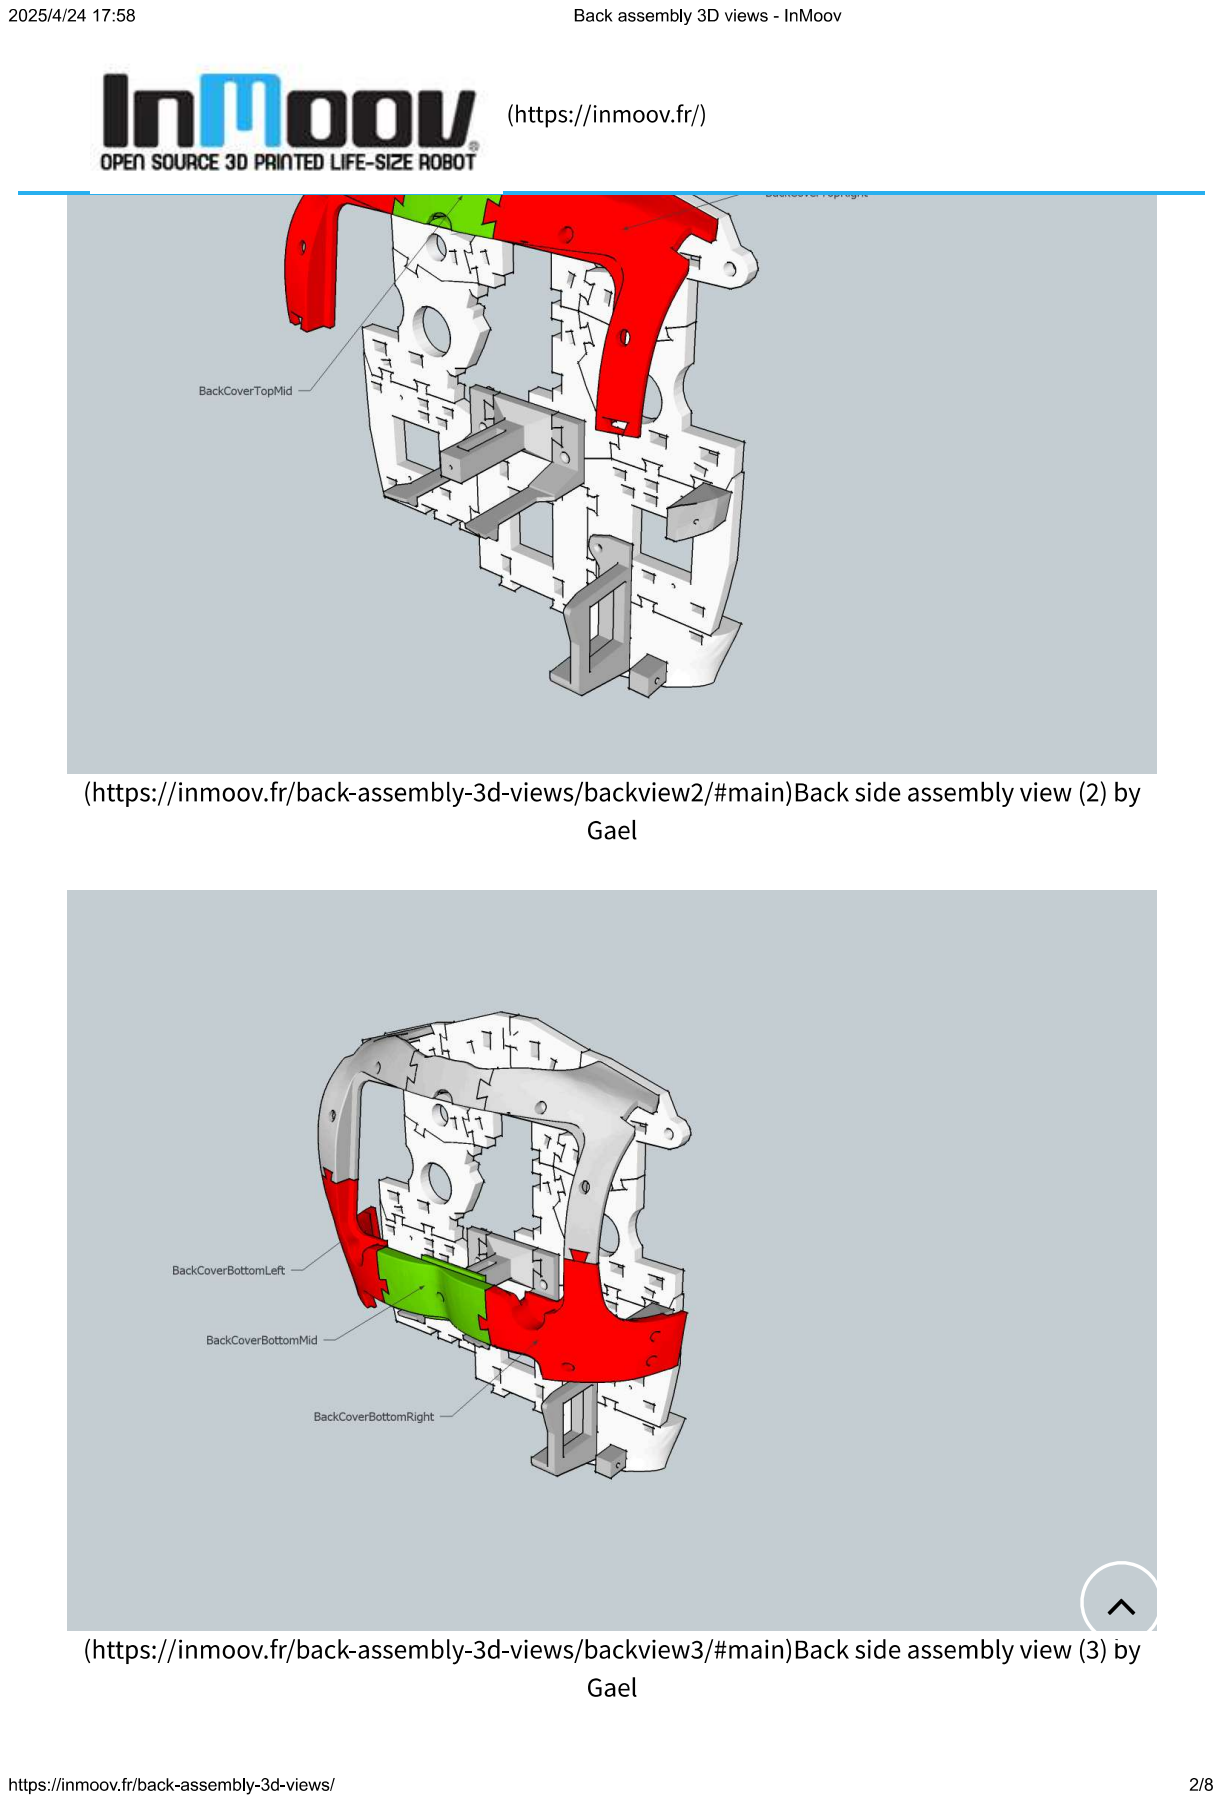
[picture p420: page 2]
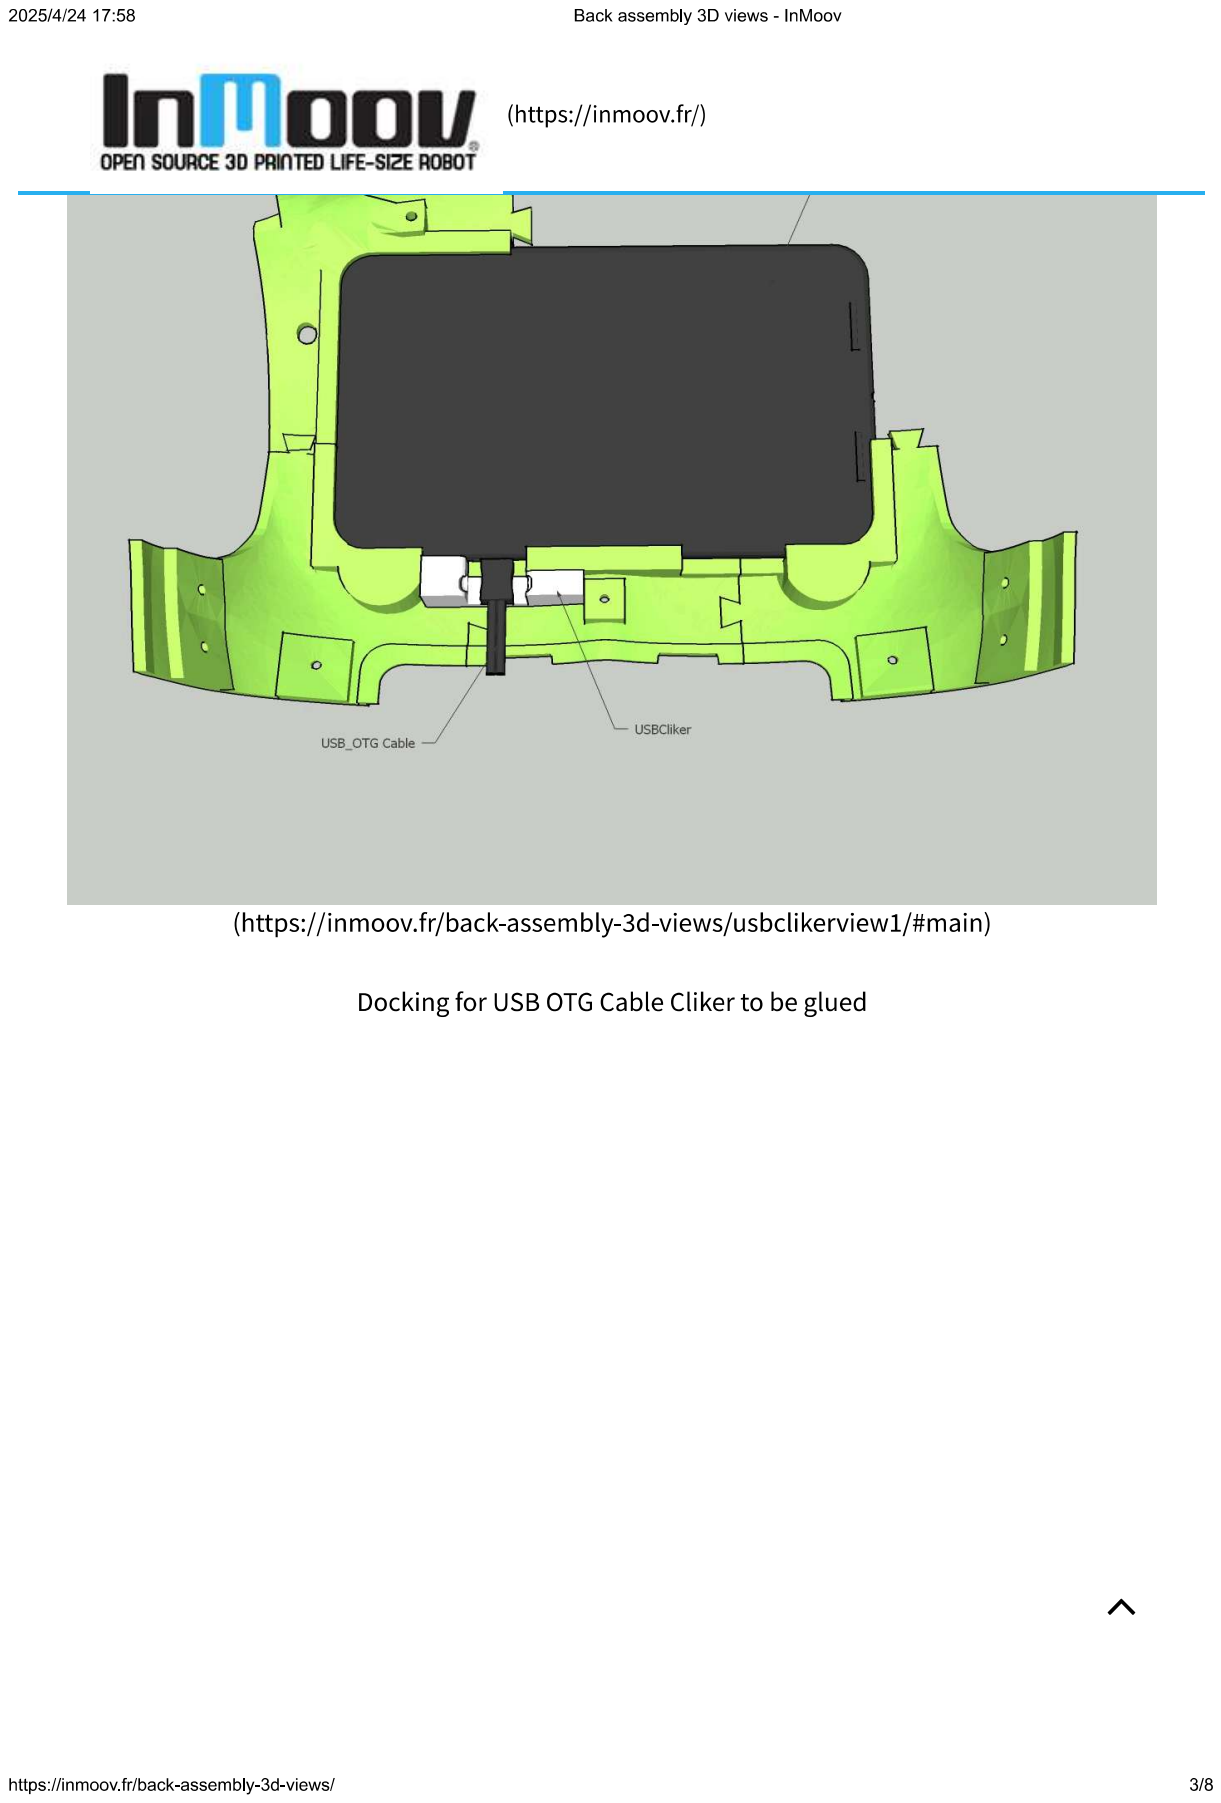
[picture p421: page 3]
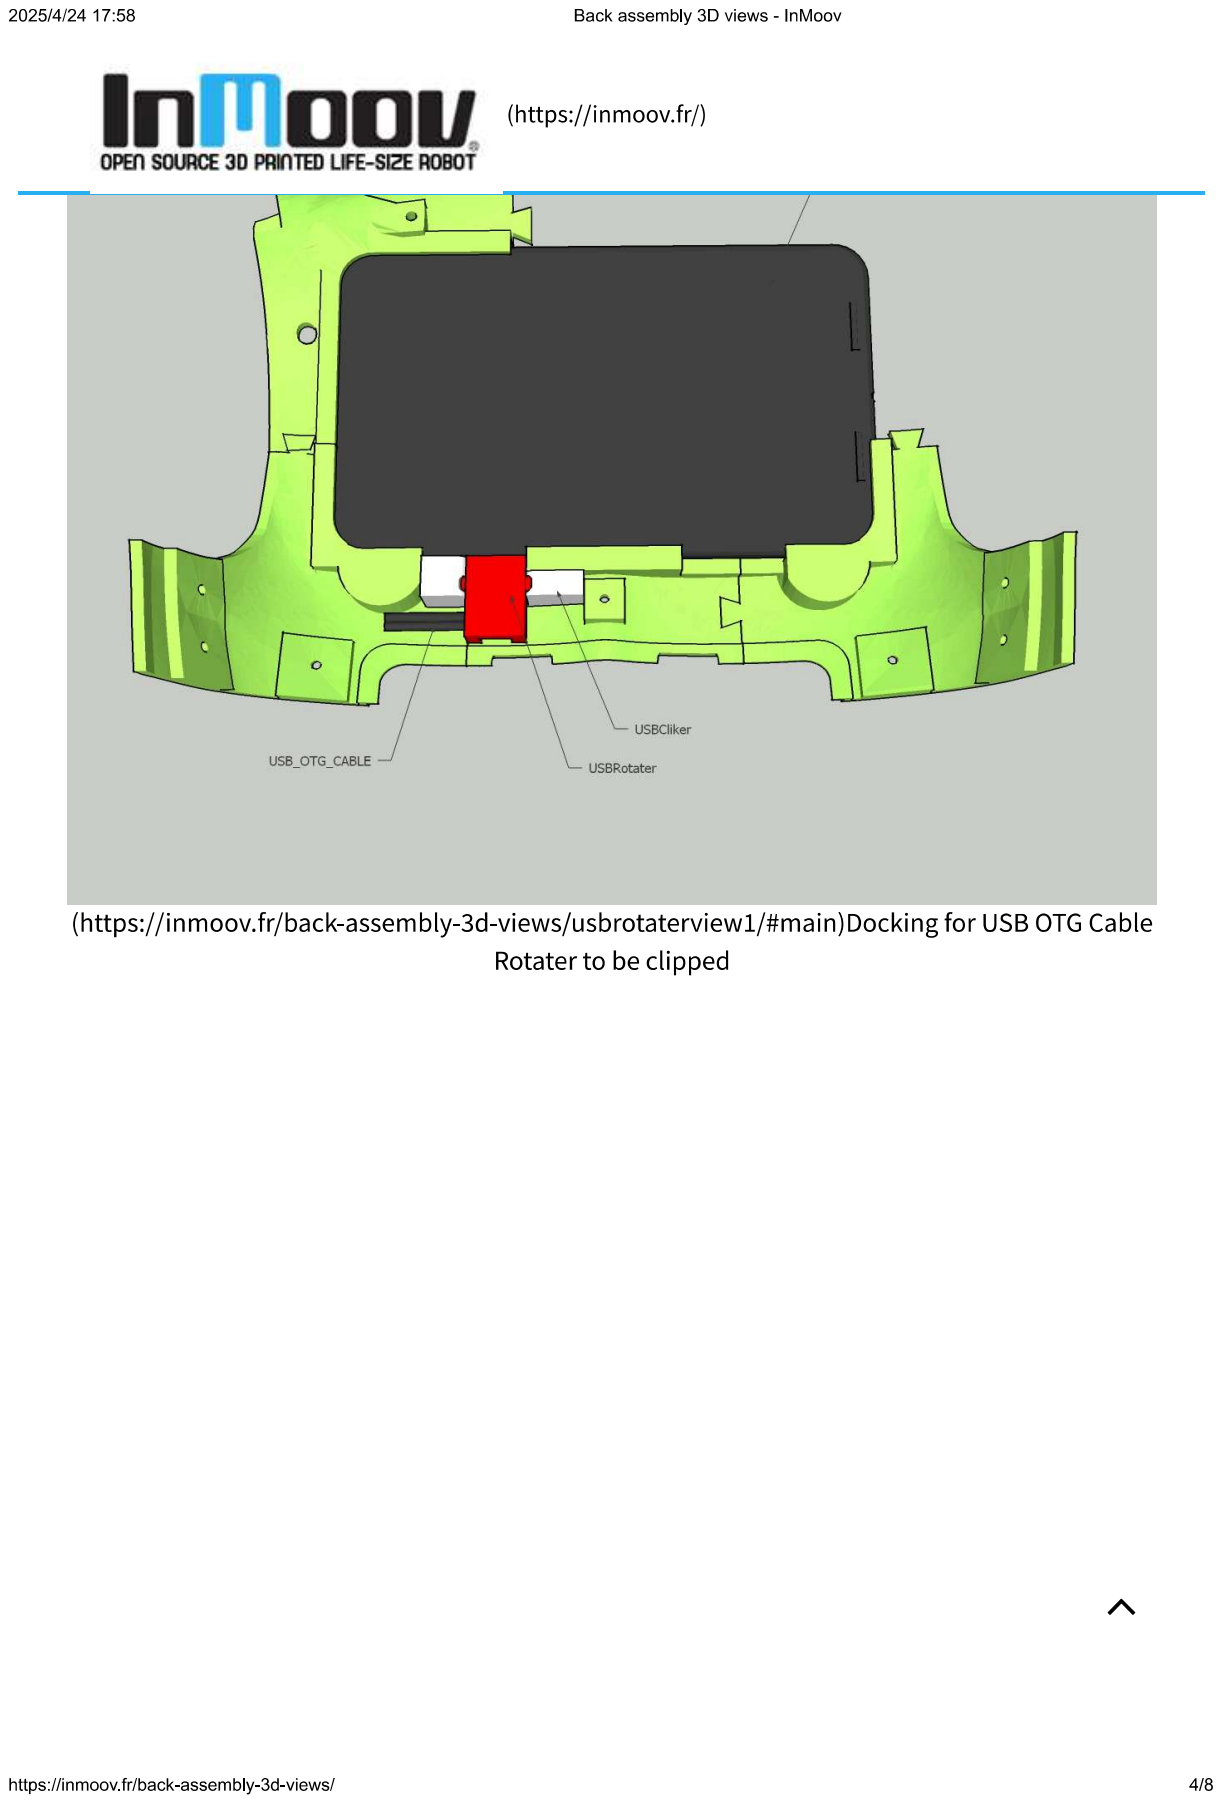
[picture p422: page 4]
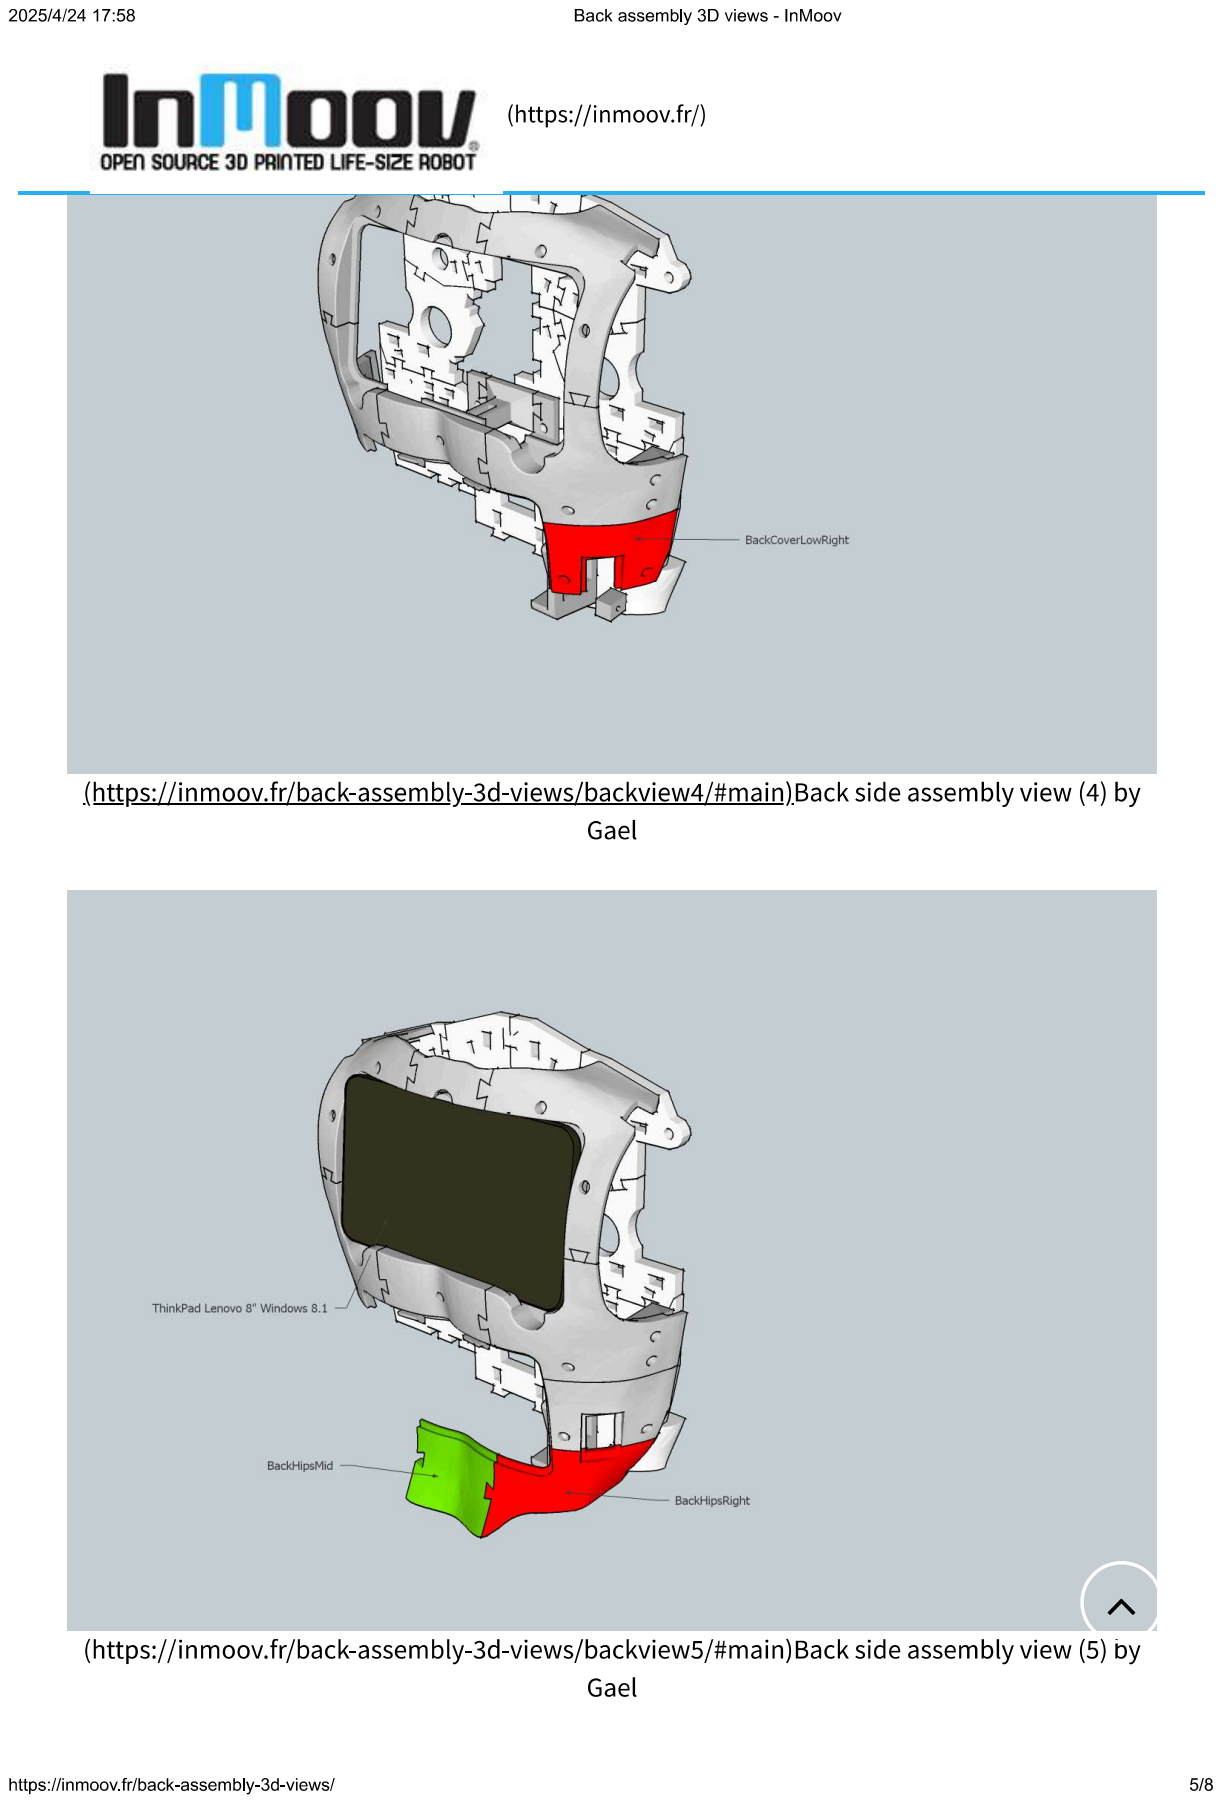
[picture p423: page 5]
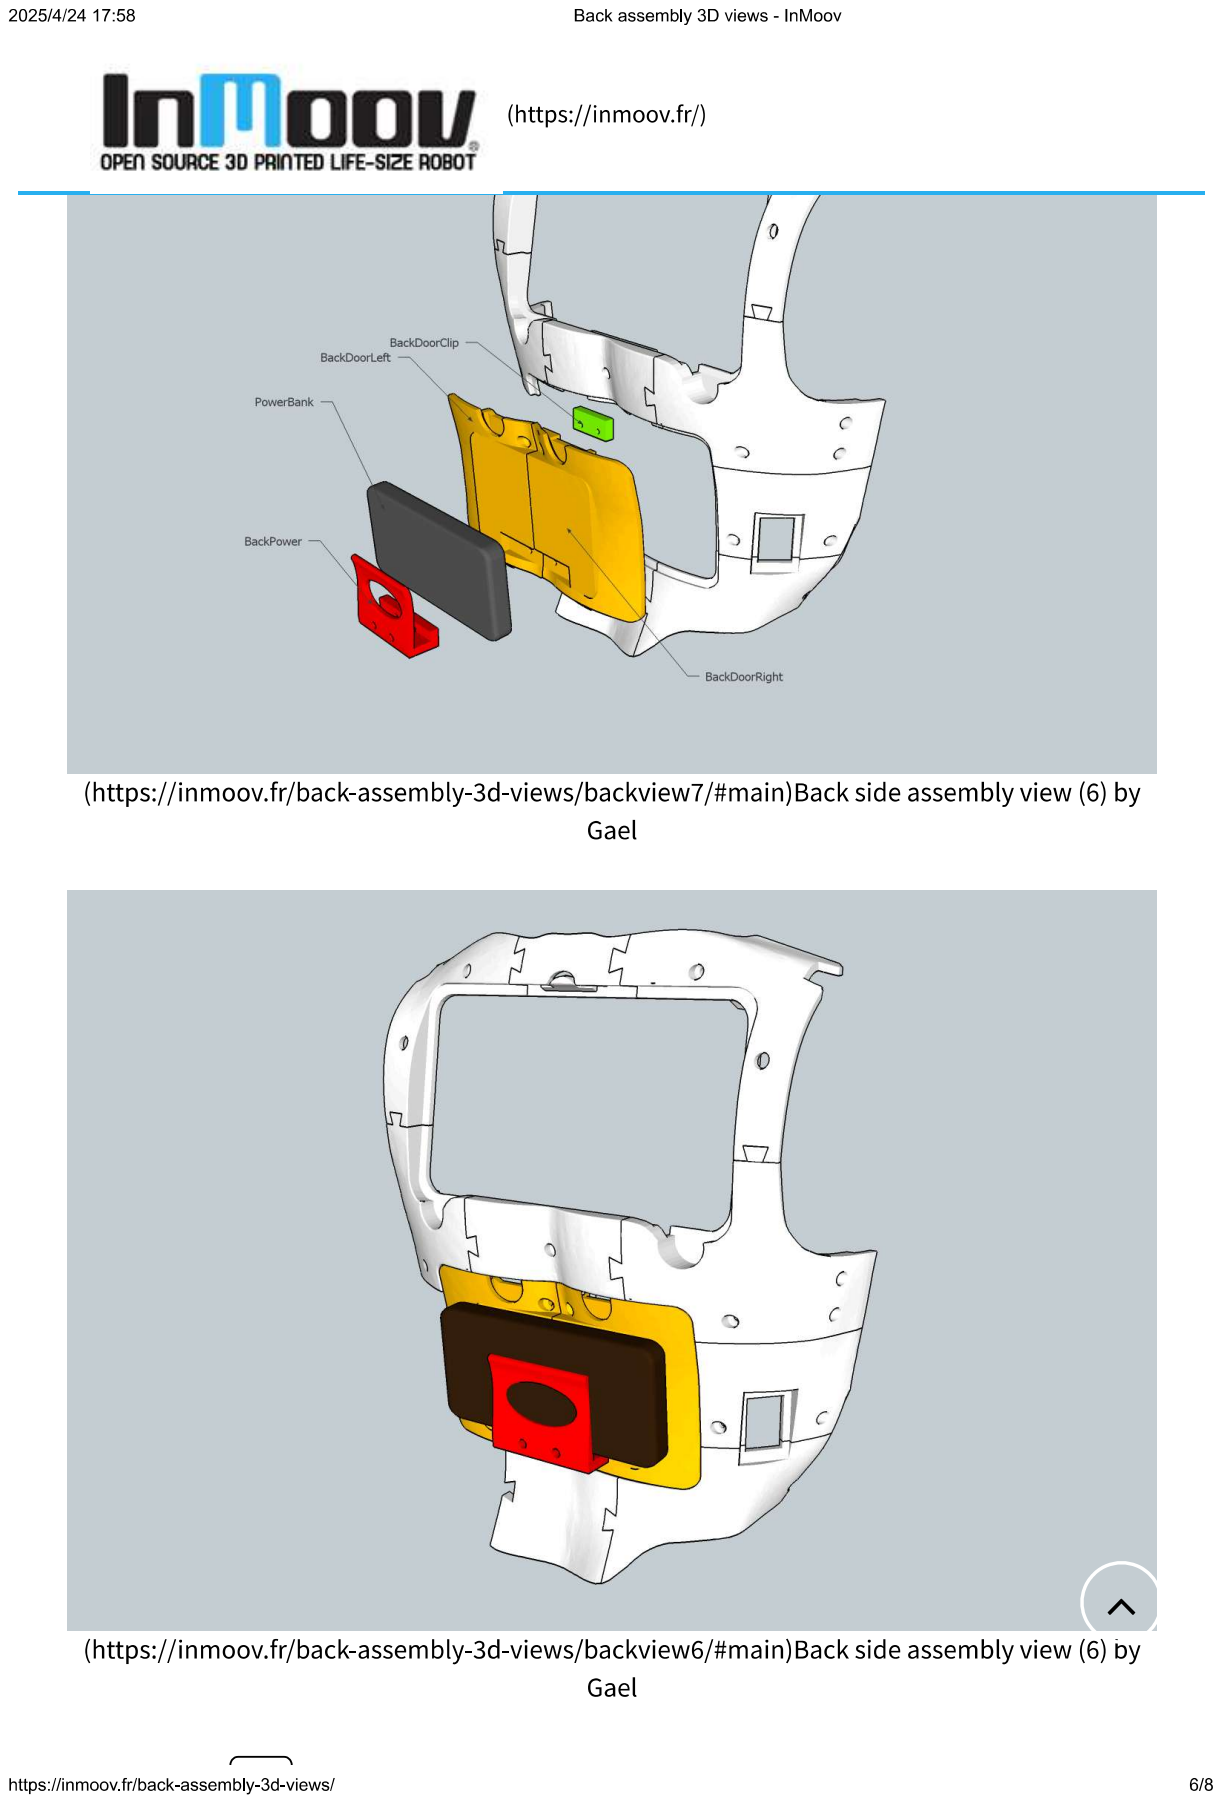
[picture p424: page 6]
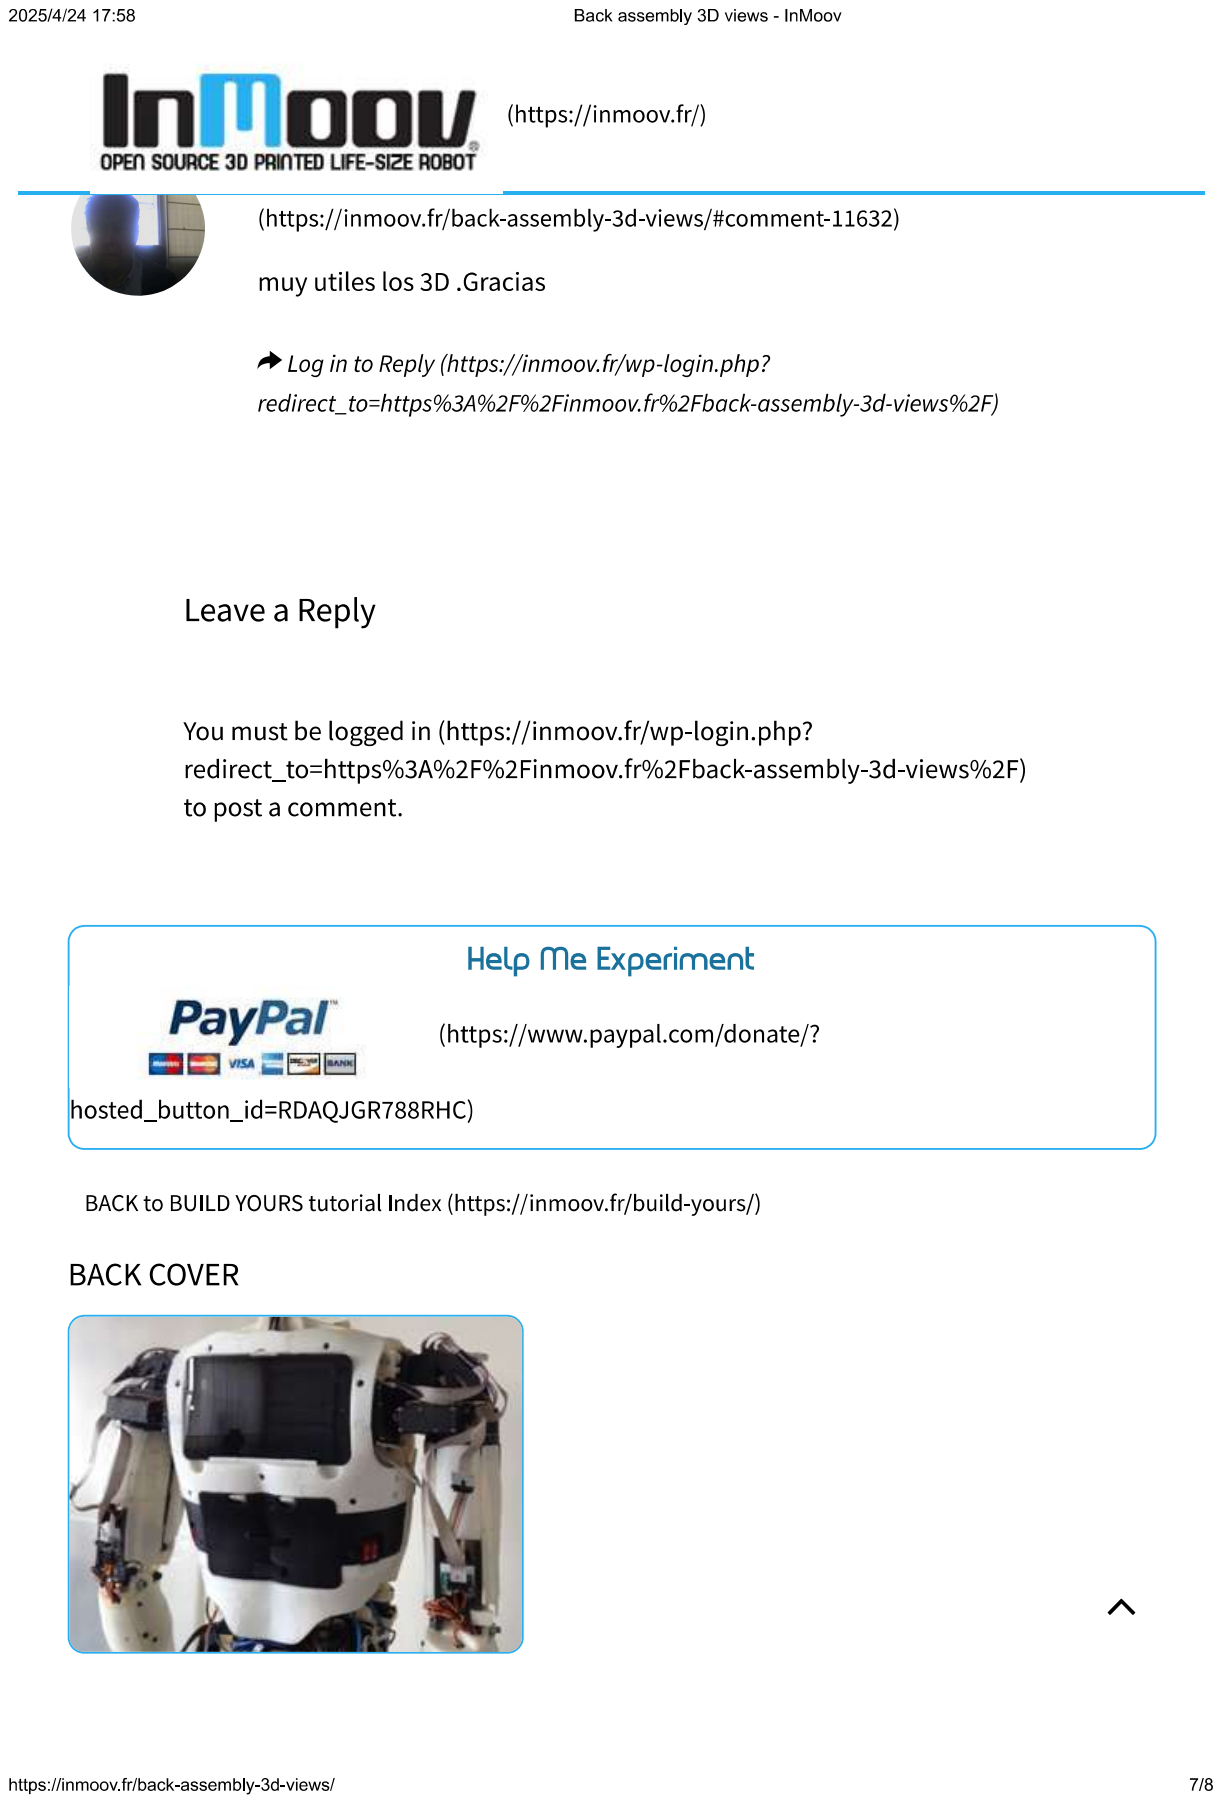
[picture p425: page 7]
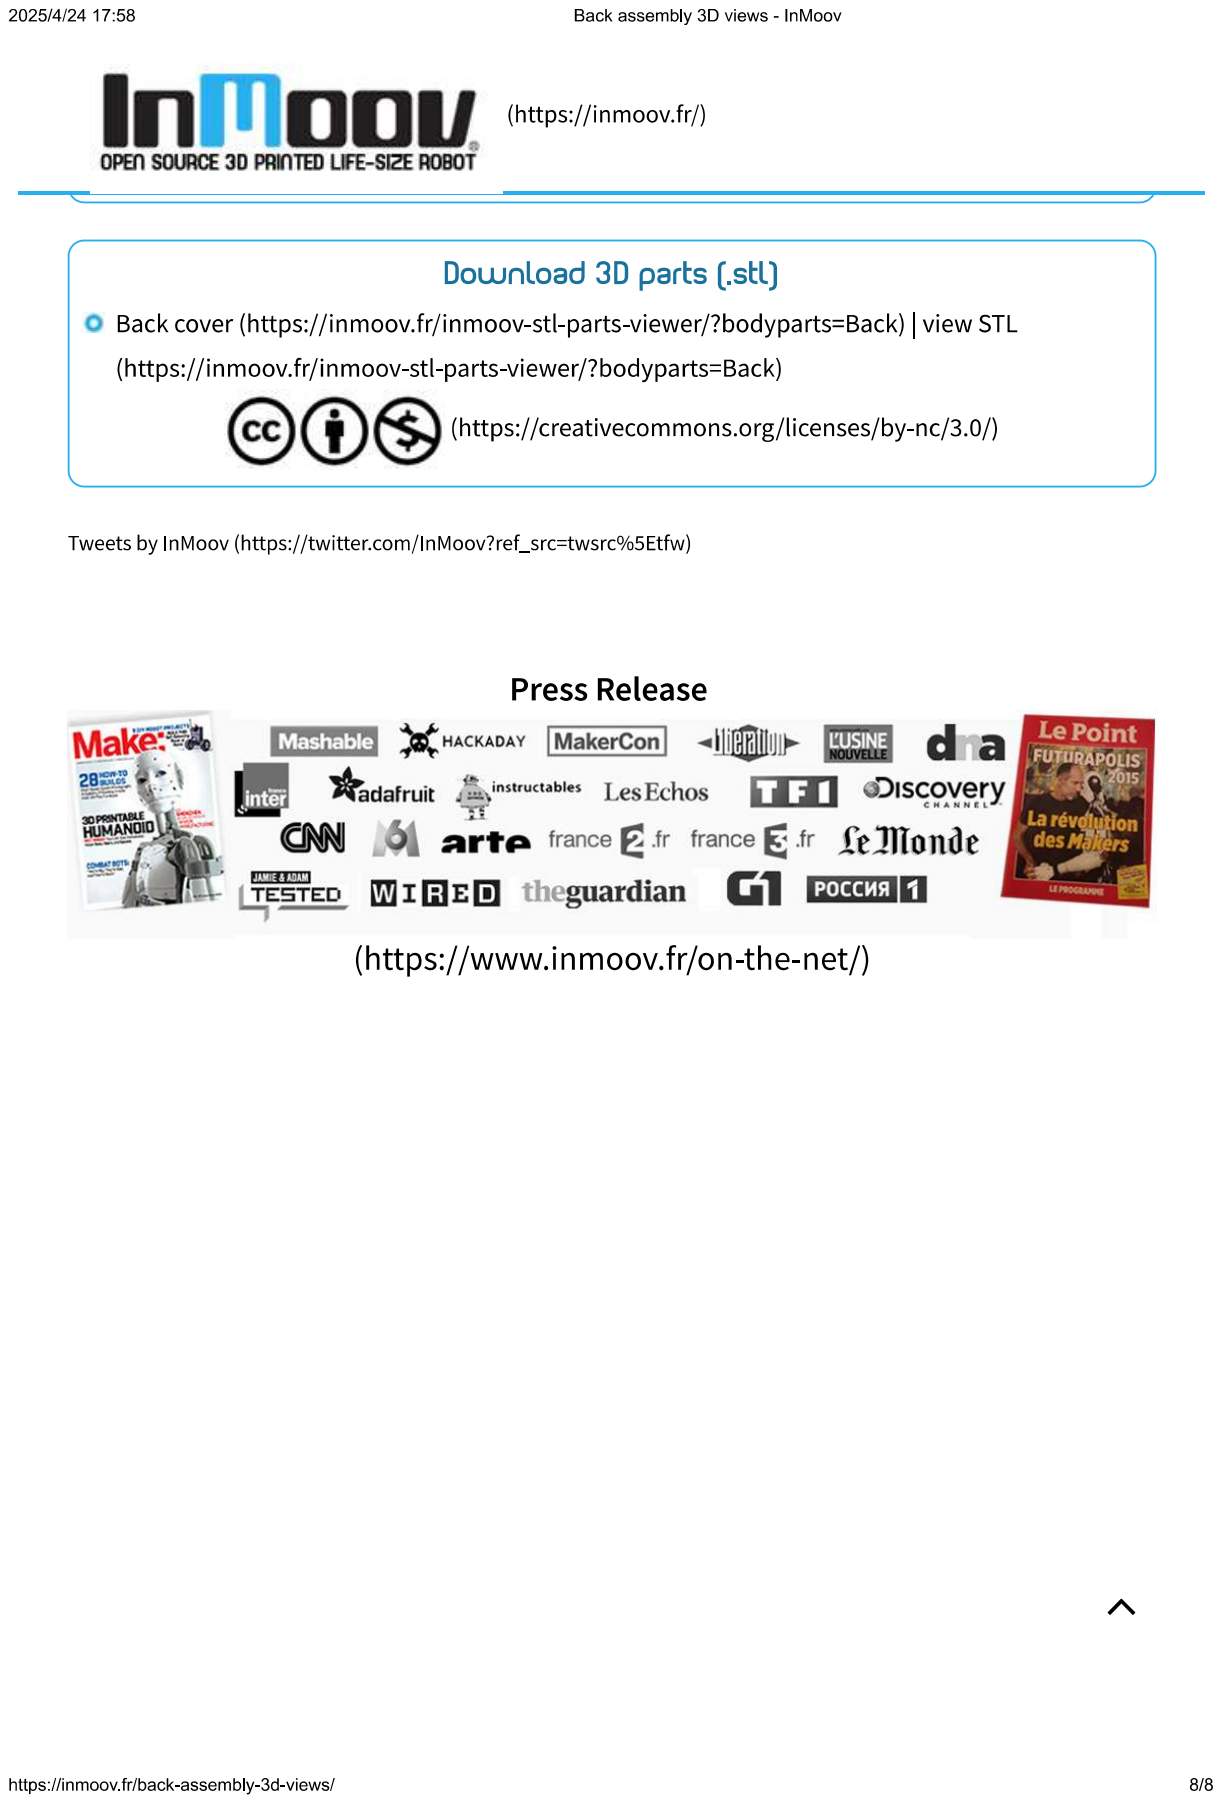
[picture p426: page 8]
