idolverse/Tulingjiuge_robot_1/myrobotlab/src/main/resources/resource/OpenCV/transparent-test.png

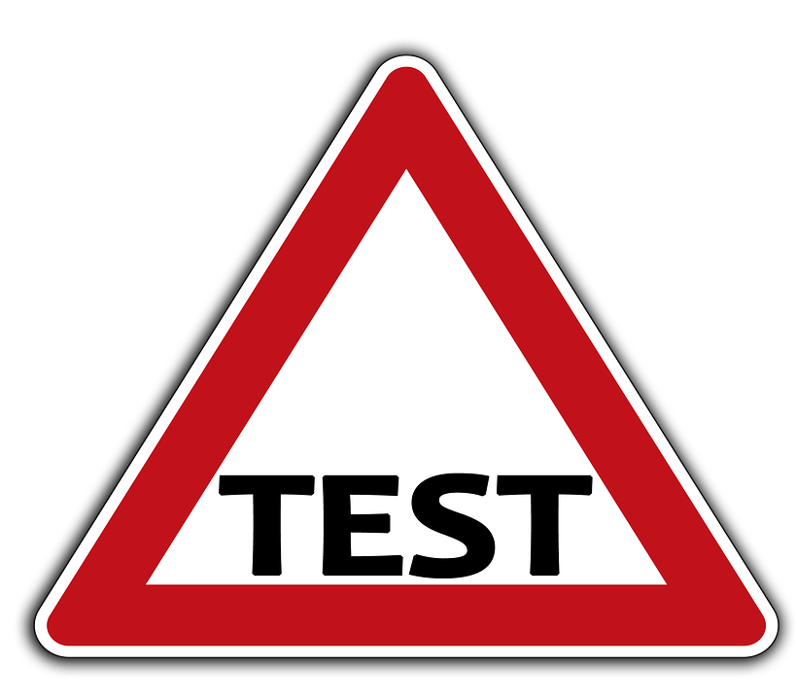
myrobotlab/src/main/resources/resource/OpenCV/transparent-test.png
