idolverse/Tulingjiuge_robot_1/myrobotlab/src/test/resources/OpenCV/FaceRecognizer/Natasha Romanoff/67702002_361346804538030_2657413600246759424_o.jpg

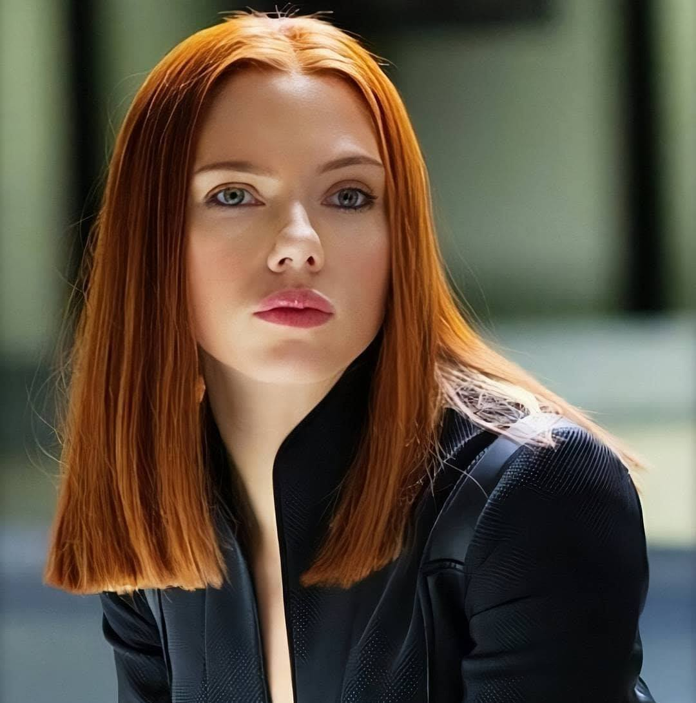
myrobotlab/src/test/resources/OpenCV/FaceRecognizer/Natasha Romanoff/67702002_361346804538030_2657413600246759424_o.jpg
