idolverse/Tulingjiuge_robot_1/myrobotlab/src/test/resources/OpenCV/FaceRecognizer/Natasha Romanoff/black_widow_marvel.0.jpeg

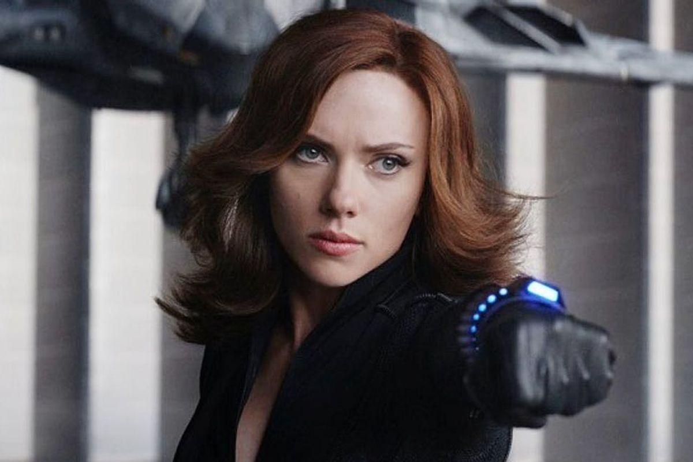
myrobotlab/src/test/resources/OpenCV/FaceRecognizer/Natasha Romanoff/black_widow_marvel.0.jpeg
