idolverse/Tulingjiuge_robot_1/myrobotlab/src/test/resources/OpenCV/FaceRecognizer/Natasha Romanoff/MCDAVEN_EC036.jpg

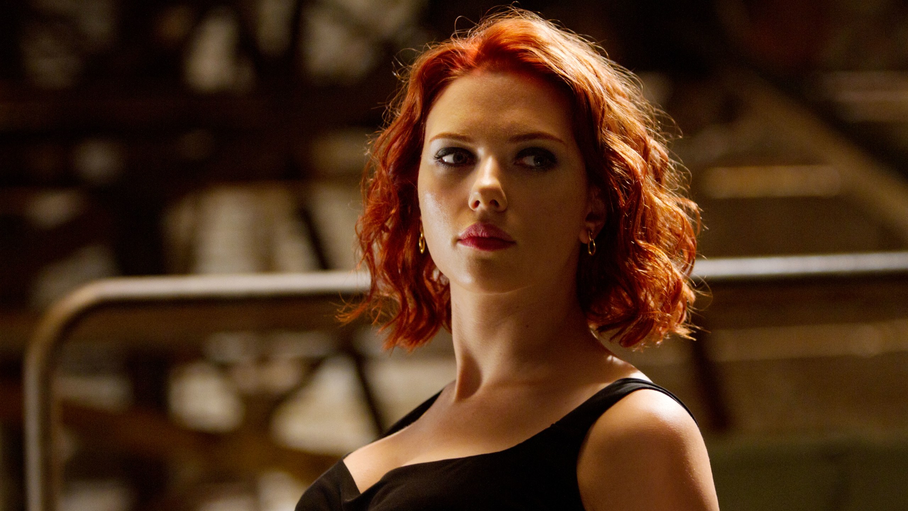
myrobotlab/src/test/resources/OpenCV/FaceRecognizer/Natasha Romanoff/MCDAVEN_EC036.jpg
