idolverse/Tulingjiuge_robot_1/myrobotlab/src/test/resources/OpenCV/FaceRecognizer/Natasha Romanoff/scarlett-johansson-black-widow-1561650986.jpg

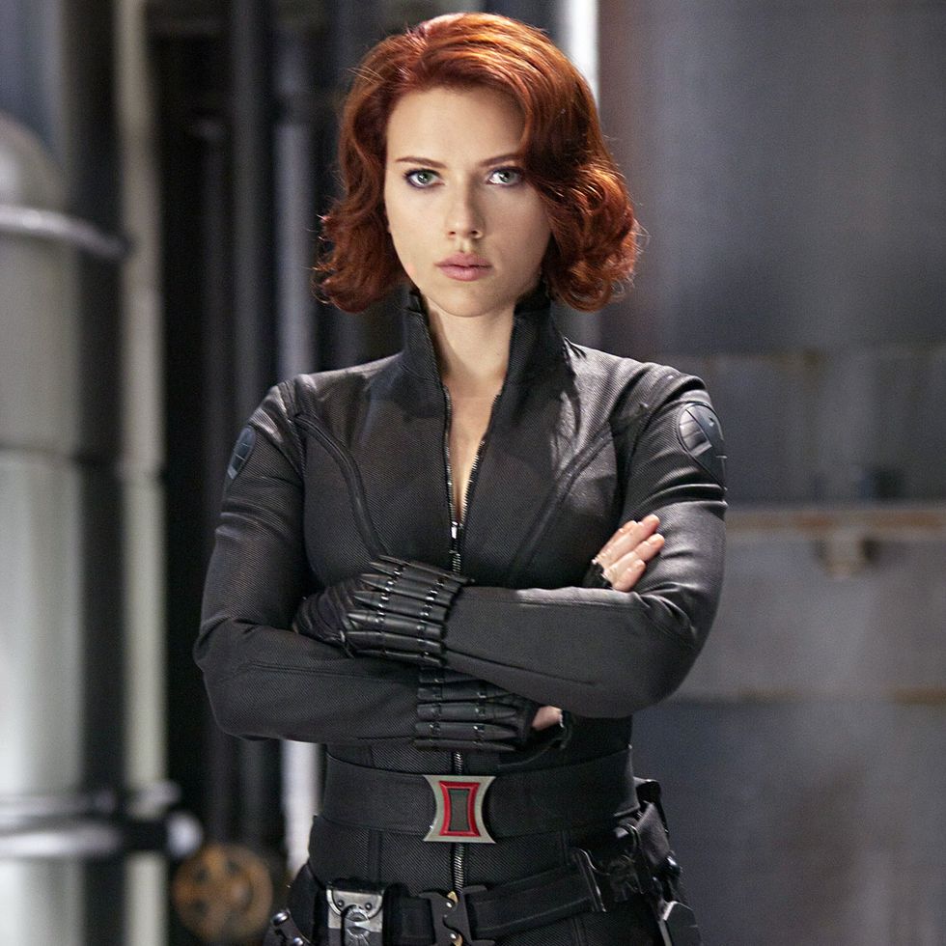
myrobotlab/src/test/resources/OpenCV/FaceRecognizer/Natasha Romanoff/scarlett-johansson-black-widow-1561650986.jpg
