idolverse/Tulingjiuge_robot_1/myrobotlab/src/test/resources/OpenCV/FaceRecognizer/Steve Rogers/1430497999-the-avengers-climax-captain-america-the-avengers-34726299-1920-1080.jpg

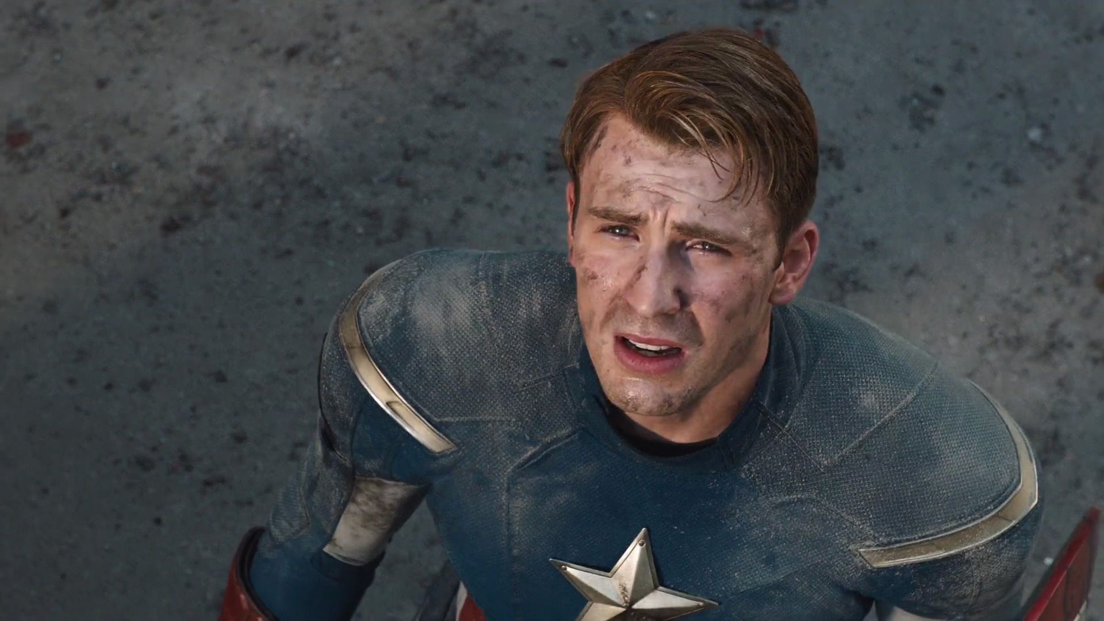
myrobotlab/src/test/resources/OpenCV/FaceRecognizer/Steve Rogers/1430497999-the-avengers-climax-captain-america-the-avengers-34726299-1920-1080.jpg
