idolverse/Tulingjiuge_robot_1/myrobotlab/src/test/resources/OpenCV/FaceRecognizer/Steve Rogers/Captain-America-The-Winter-Soldier-Photo-Chris-Evans-Argues-With-Nick-Fury.jpg

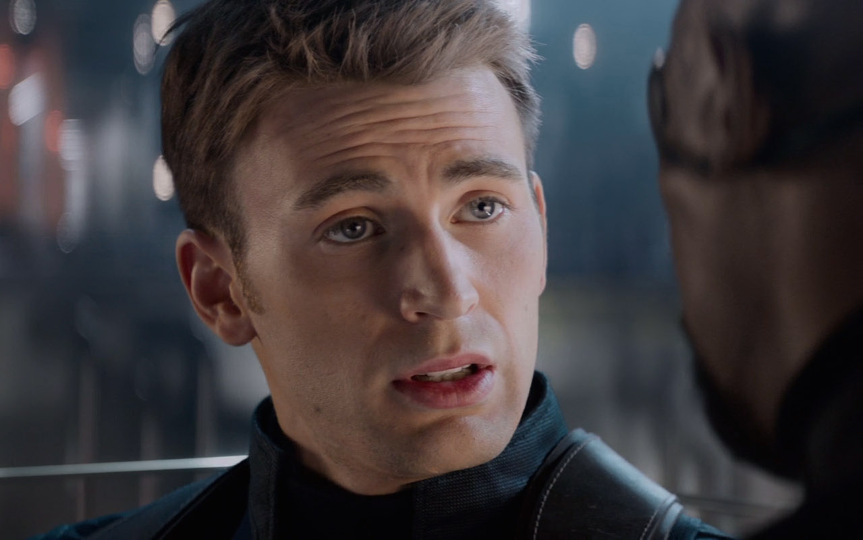
myrobotlab/src/test/resources/OpenCV/FaceRecognizer/Steve Rogers/Captain-America-The-Winter-Soldier-Photo-Chris-Evans-Argues-With-Nick-Fury.jpg
