idolverse/Tulingjiuge_robot_1/myrobotlab/src/test/resources/OpenCV/FaceRecognizer/Steve Rogers/captain-america-the-winter-soldier-trailer-0.jpg

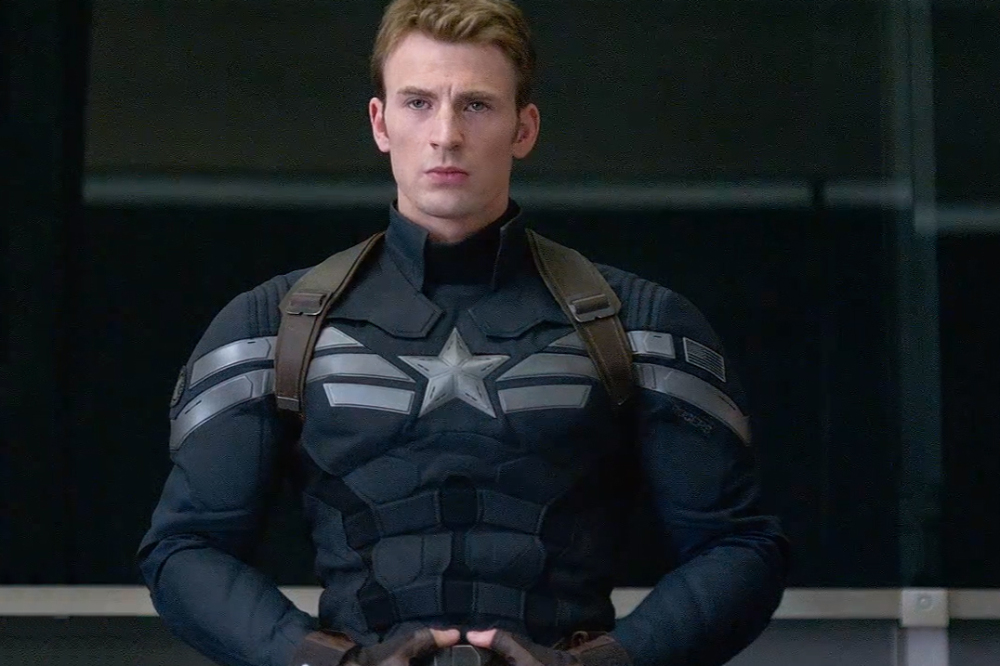
myrobotlab/src/test/resources/OpenCV/FaceRecognizer/Steve Rogers/captain-america-the-winter-soldier-trailer-0.jpg
