idolverse/Tulingjiuge_robot_1/myrobotlab/src/test/resources/OpenCV/FaceRecognizer/Test/1.jpg

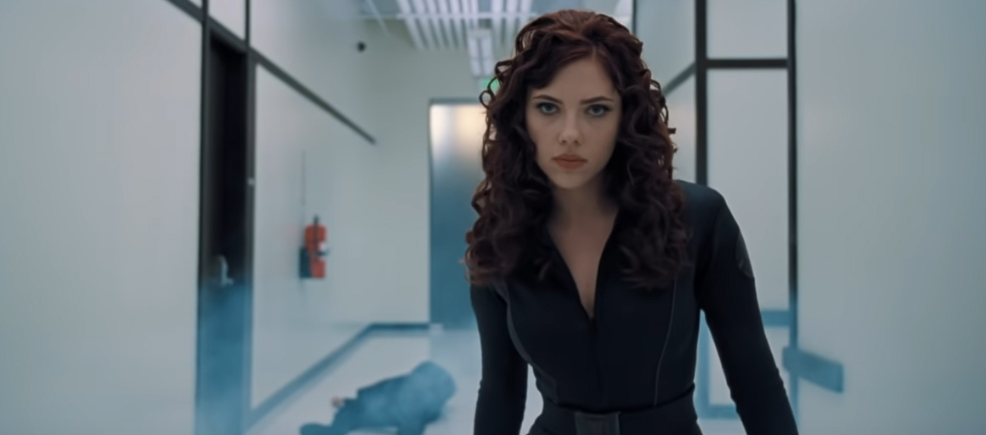
myrobotlab/src/test/resources/OpenCV/FaceRecognizer/Test/1.jpg
