idolverse/Tulingjiuge_robot_1/myrobotlab/src/test/resources/OpenCV/FaceRecognizer/Tony Stark/2c9fa5c0.jpg

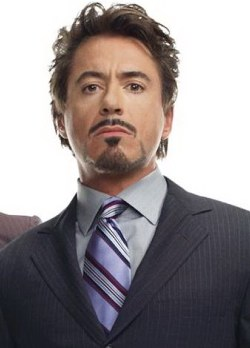
myrobotlab/src/test/resources/OpenCV/FaceRecognizer/Tony Stark/2c9fa5c0.jpg
