idolverse/Tulingjiuge_robot_1/myrobotlab/src/test/resources/OpenCV/FaceRecognizer/Tony Stark/220px-Robert_Downey_Jr._as_Iron_Man_in_Avengers_Infinity_War.jpg

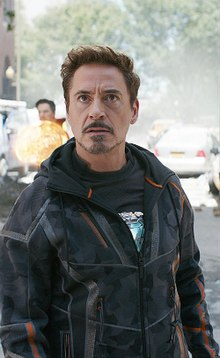
myrobotlab/src/test/resources/OpenCV/FaceRecognizer/Tony Stark/220px-Robert_Downey_Jr._as_Iron_Man_in_Avengers_Infinity_War.jpg
