idolverse/Tulingjiuge_robot_1/myrobotlab/src/test/resources/OpenCV/FaceRecognizer/Tony Stark/648d7fe10d446a34b0b6b60fcea708e3.jpg

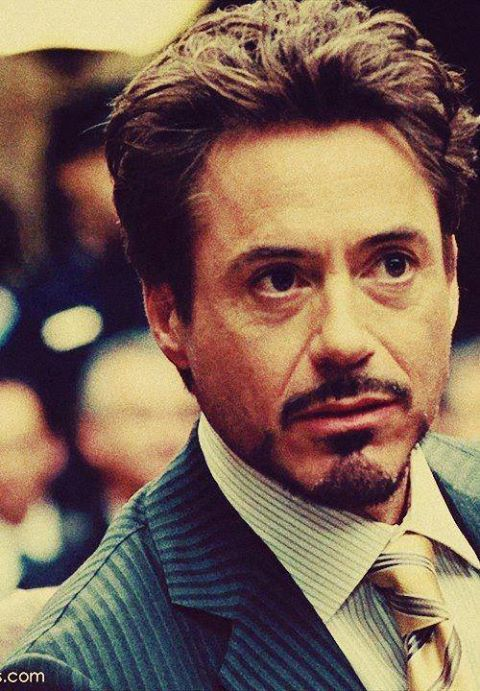
myrobotlab/src/test/resources/OpenCV/FaceRecognizer/Tony Stark/648d7fe10d446a34b0b6b60fcea708e3.jpg
