idolverse/Tulingjiuge_robot_1/myrobotlab/src/test/resources/OpenCV/FaceRecognizer/Tony Stark/avengers-tony-stark-drinky.jpg

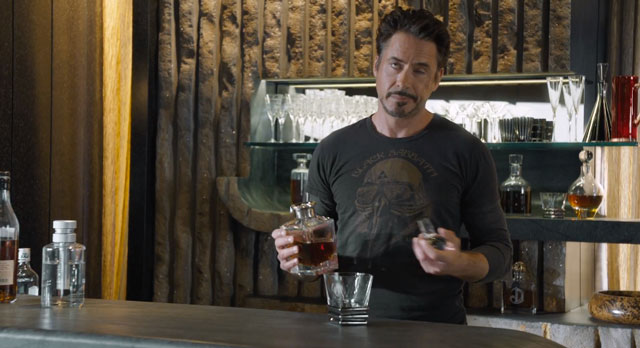
myrobotlab/src/test/resources/OpenCV/FaceRecognizer/Tony Stark/avengers-tony-stark-drinky.jpg
