idolverse/Tulingjiuge_robot_1/myrobotlab/src/test/resources/OpenCV/FaceRecognizer/Tony Stark/d95ac9d6f0acd56e12b9452301c763cd1aeffe51.jpg

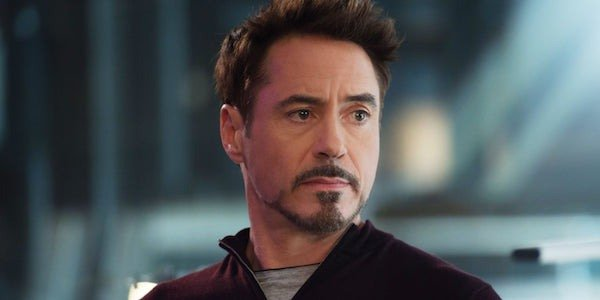
myrobotlab/src/test/resources/OpenCV/FaceRecognizer/Tony Stark/d95ac9d6f0acd56e12b9452301c763cd1aeffe51.jpg
