idolverse/Tulingjiuge_robot_1/myrobotlab/src/test/resources/OpenCV/FaceRecognizer/Tony Stark/how-thanos-knew-who-tony-stark-was-in-avengers-infinity-war-m963x491.jpg

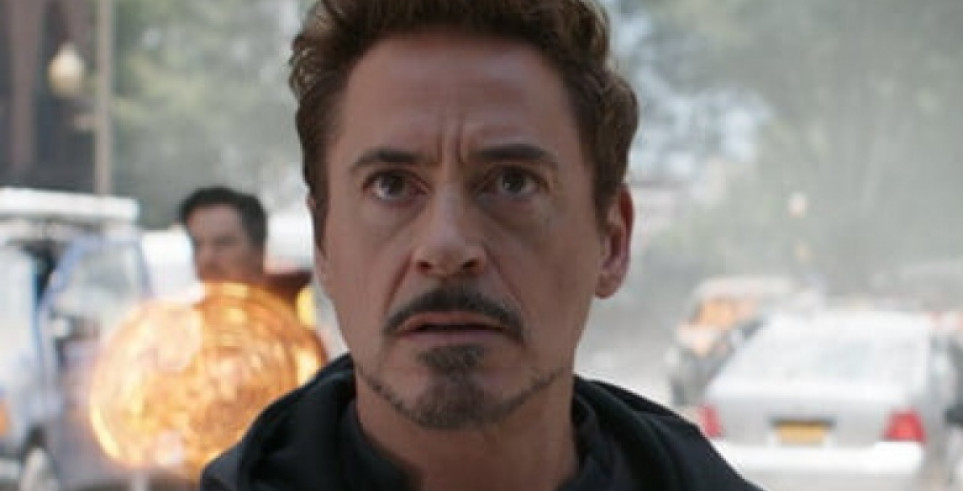
myrobotlab/src/test/resources/OpenCV/FaceRecognizer/Tony Stark/how-thanos-knew-who-tony-stark-was-in-avengers-infinity-war-m963x491.jpg
