idolverse/Tulingjiuge_robot_1/myrobotlab/src/test/resources/OpenCV/FaceRecognizer/Tony Stark/https___blogs-images.forbes.com_robcain_files_2017_07_Tony-Stark-Spiderman.jpg

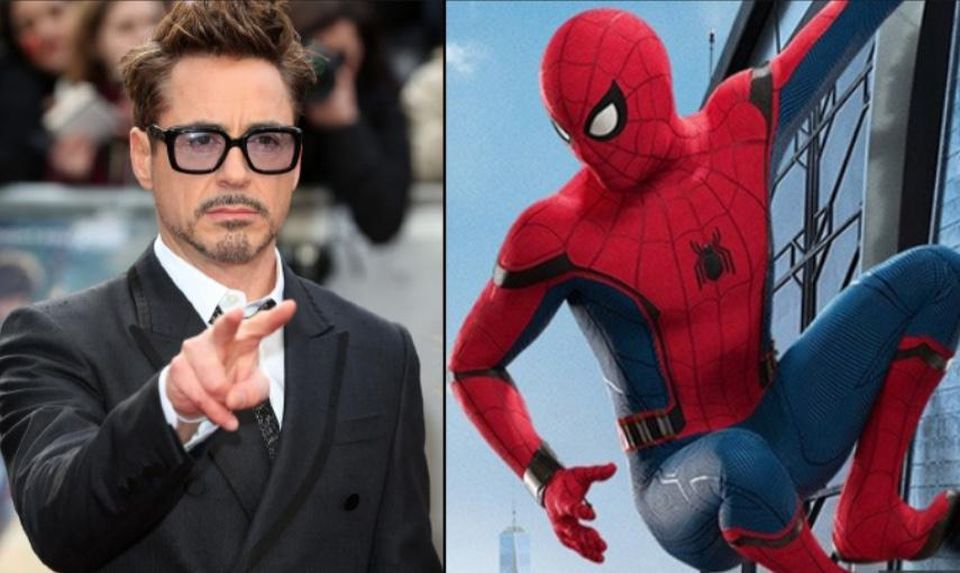
myrobotlab/src/test/resources/OpenCV/FaceRecognizer/Tony Stark/https___blogs-images.forbes.com_robcain_files_2017_07_Tony-Stark-Spiderman.jpg
