idolverse/Tulingjiuge_robot_1/myrobotlab/src/test/resources/OpenCV/FaceRecognizer/Tony Stark/maxresdefault.jpg

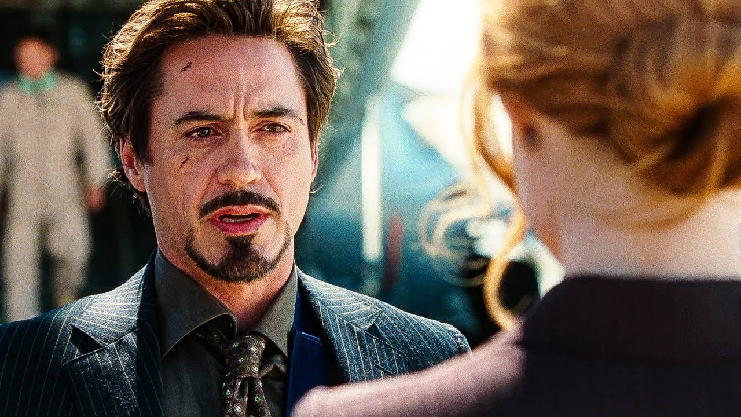
myrobotlab/src/test/resources/OpenCV/FaceRecognizer/Tony Stark/maxresdefault.jpg
