idolverse/Tulingjiuge_robot_1/myrobotlab/src/test/resources/OpenCV/FaceRecognizer/Tony Stark/Robert-Downey-Jr.-1-1-640x433.jpg

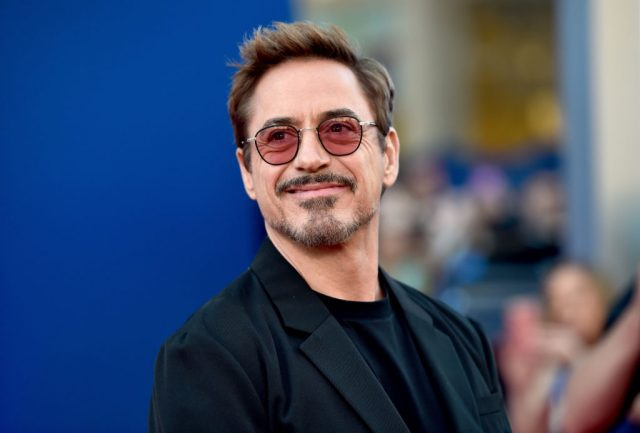
myrobotlab/src/test/resources/OpenCV/FaceRecognizer/Tony Stark/Robert-Downey-Jr.-1-1-640x433.jpg
