idolverse/Tulingjiuge_robot_1/myrobotlab/src/test/resources/OpenCV/FaceRecognizer/Tony Stark/Tony-Stark (1).jpg

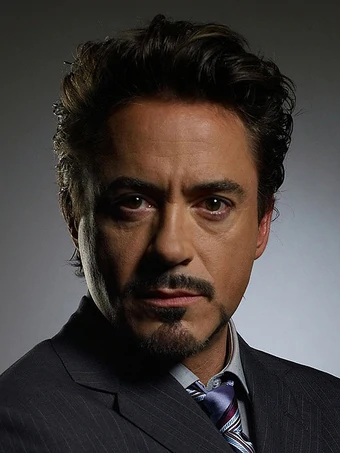
myrobotlab/src/test/resources/OpenCV/FaceRecognizer/Tony Stark/Tony-Stark (1).jpg
