idolverse/Tulingjiuge_robot_1/myrobotlab/src/test/resources/OpenCV/FaceRecognizer/Tony Stark/tony-stark.jpg

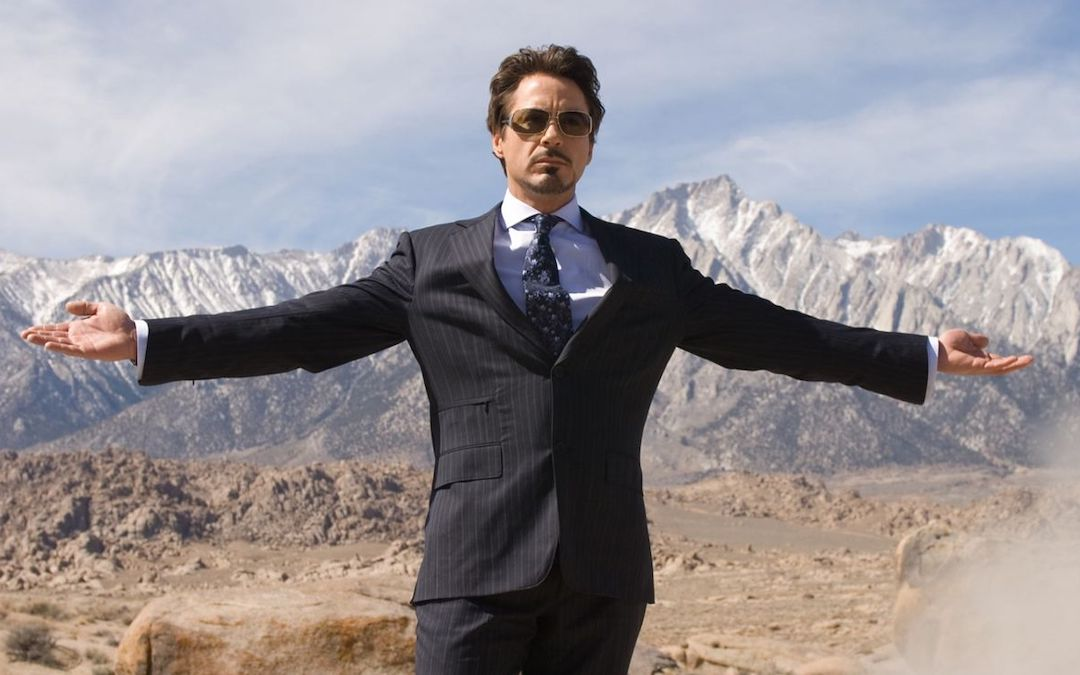
myrobotlab/src/test/resources/OpenCV/FaceRecognizer/Tony Stark/tony-stark.jpg
