idolverse/Tulingjiuge_robot_1/myrobotlab/src/test/resources/OpenCV/hf512.jpg

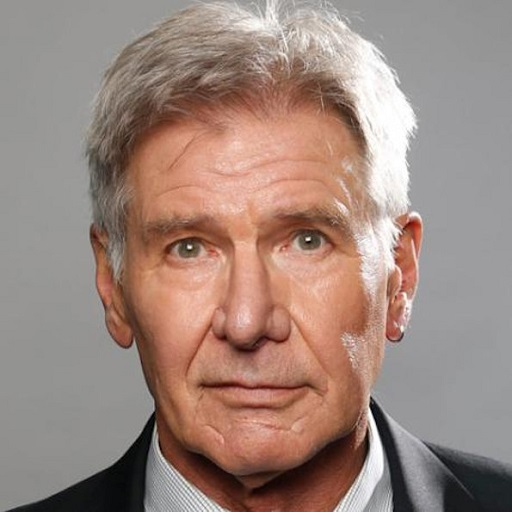
myrobotlab/src/test/resources/OpenCV/hf512.jpg
