idolverse/Tulingjiuge_robot_1/myrobotlab/src/test/resources/OpenCV/hiring_humans.jpg

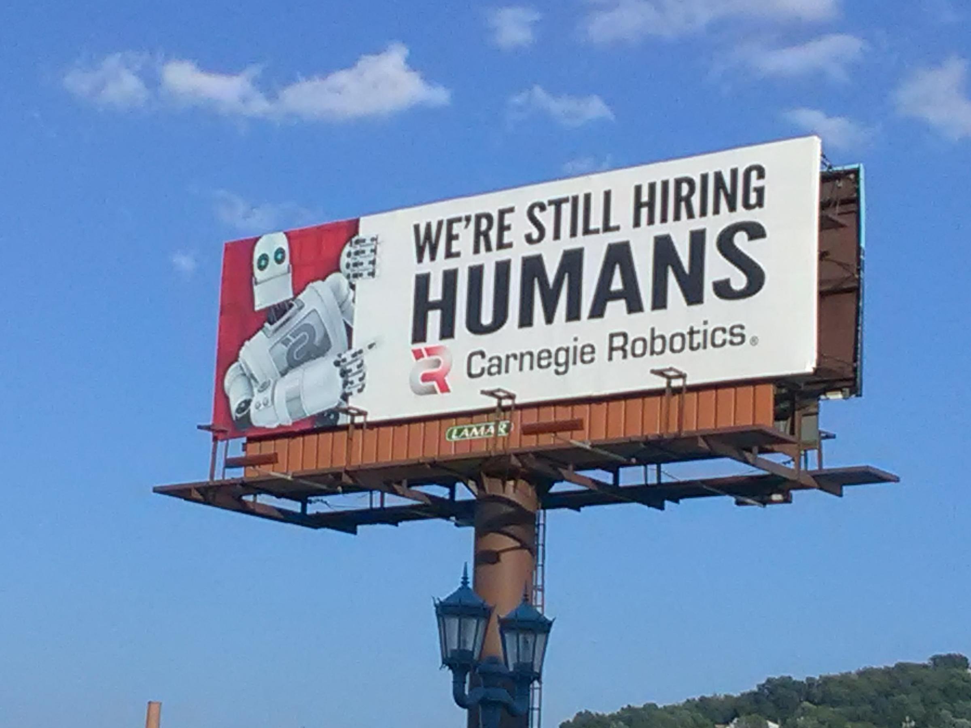
myrobotlab/src/test/resources/OpenCV/hiring_humans.jpg
