idolverse/Tulingjiuge_robot_1/myrobotlab/src/test/resources/OpenCV/i_am_a_droid.jpg

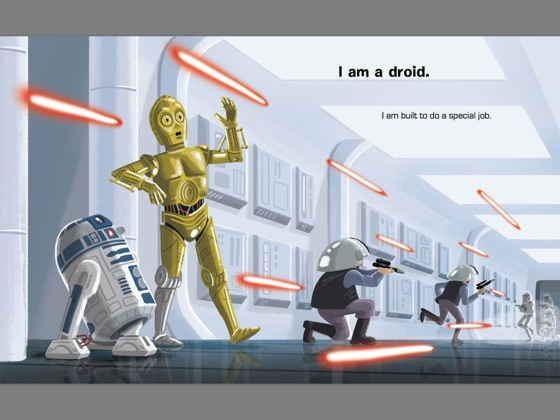
myrobotlab/src/test/resources/OpenCV/i_am_a_droid.jpg
