idolverse/Tulingjiuge_robot_1/myrobotlab/src/test/resources/OpenCV/kinect-data/00000000.png

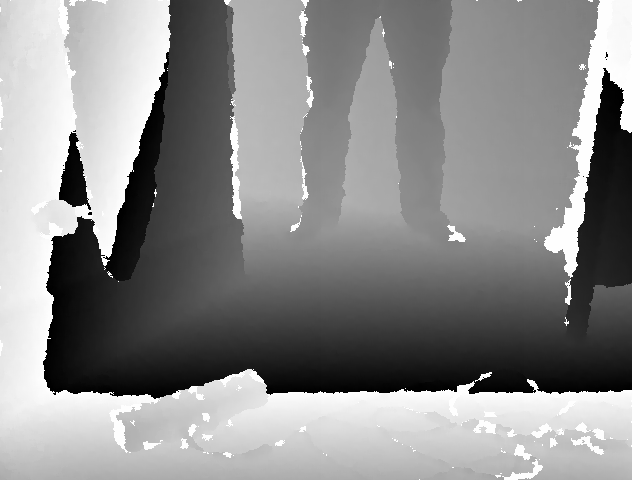
myrobotlab/src/test/resources/OpenCV/kinect-data/00000000.png
