idolverse/Tulingjiuge_robot_1/myrobotlab/src/test/resources/OpenCV/kinect-test-1chn-16bit.png

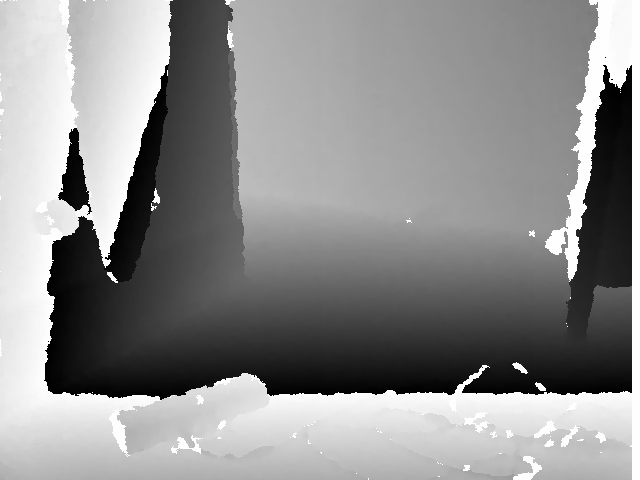
myrobotlab/src/test/resources/OpenCV/kinect-test-1chn-16bit.png
