idolverse/Tulingjiuge_robot_1/myrobotlab/src/test/resources/OpenCV/mask.png

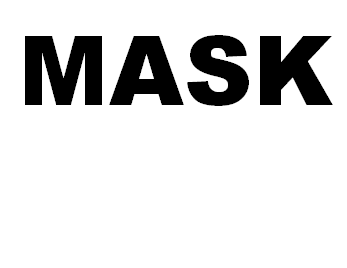
myrobotlab/src/test/resources/OpenCV/mask.png
