idolverse/Tulingjiuge_robot_1/myrobotlab/src/test/resources/OpenCV/ok-test1.jpg

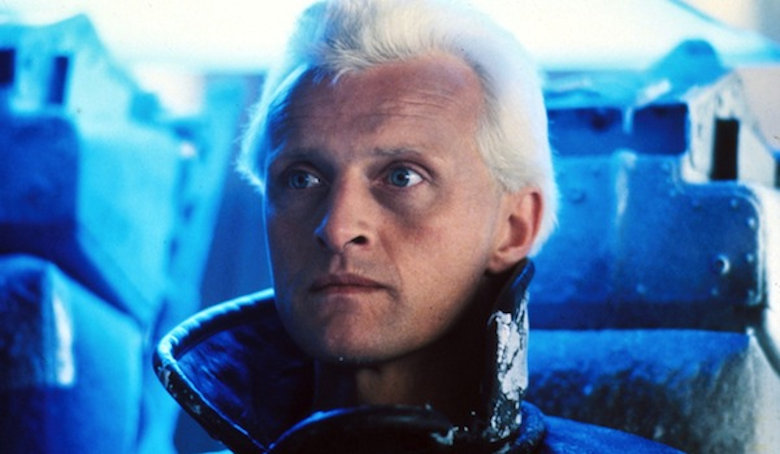
myrobotlab/src/test/resources/OpenCV/ok-test1.jpg
