idolverse/Tulingjiuge_robot_1/myrobotlab/src/test/resources/OpenCV/rachel.jpg

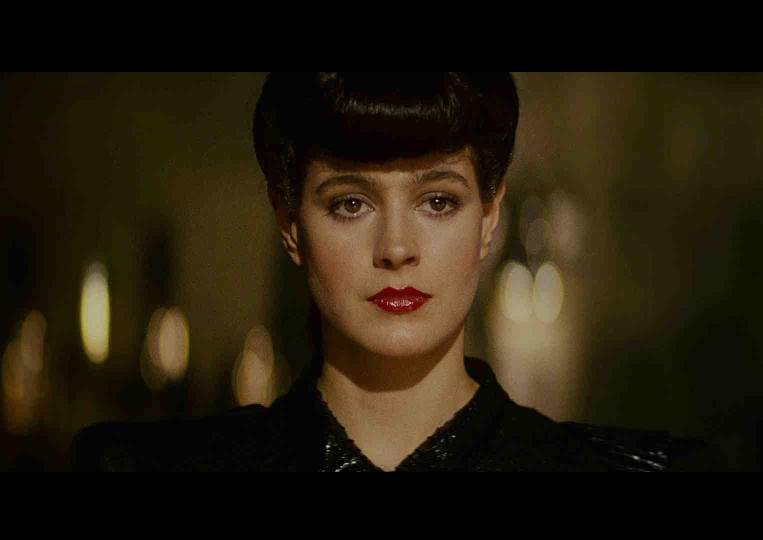
myrobotlab/src/test/resources/OpenCV/rachel.jpg
