idolverse/Tulingjiuge_robot_1/myrobotlab/src/test/resources/OpenCV/rachel_face.png

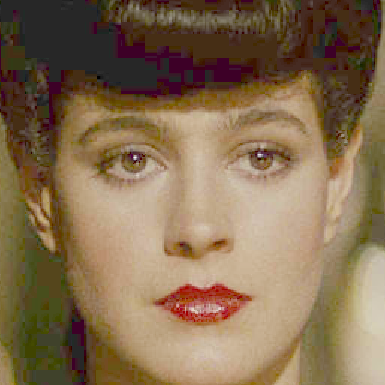
myrobotlab/src/test/resources/OpenCV/rachel_face.png
