idolverse/Tulingjiuge_robot_1/myrobotlab/src/test/resources/OpenCV/ryan.jpg

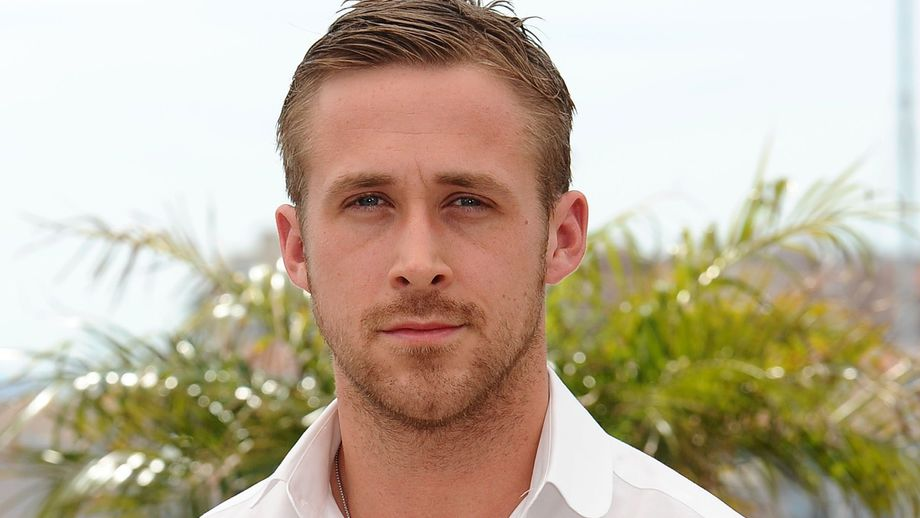
myrobotlab/src/test/resources/OpenCV/ryan.jpg
