idolverse/Tulingjiuge_robot_1/myrobotlab/src/test/resources/OpenCV/shapes.png

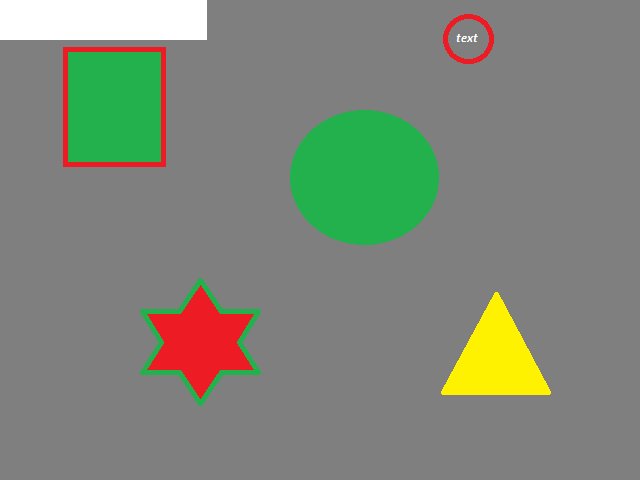
myrobotlab/src/test/resources/OpenCV/shapes.png
