idolverse/Tulingjiuge_robot_1/myrobotlab/src/test/resources/OpenCV/white-black-center-640x480.png

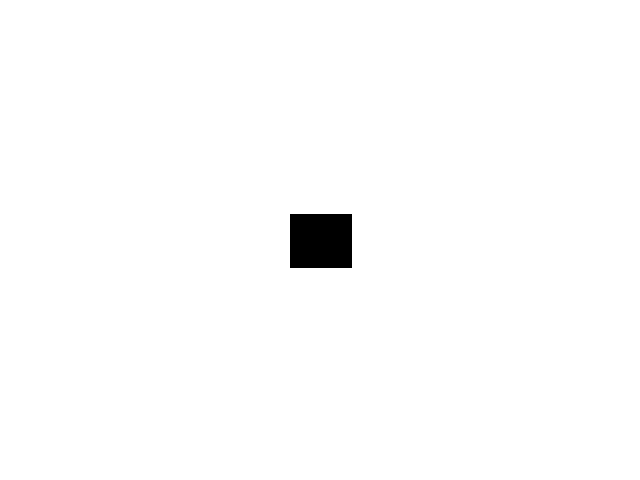
myrobotlab/src/test/resources/OpenCV/white-black-center-640x480.png
